chungddong/NUBI/hardware/vehicle/models/vehicle/v24_camera_mouth/README.md

# v24_camera_mouth — 앞 카메라 내림 (입)

- 날짜: 2026-10-05
- 이전 버전: [v23_upper_eyebrow](../v23_upper_eyebrow/README.md)

## 무엇을 왜 바꿨나

사용자 (2026-10-05): "입처럼 보이게 정면 뎁스 카메라를 전조등 아래로 내리자." 이유 · 검사는 [`../DECISIONS.md`](../DECISIONS.md) **D-14**.

- 앞 카메라 렌즈 중심 z **250 → 172**. 앞판 창 · 브래킷 M3 구멍도 같이 내렸다. 뒤 카메라는 250 그대로 (밑에 포트 칸).
- 얼굴: 눈썹 (와이파이 안테나) · 눈 (전조등) · 입 (뎁스 카메라).
- 시야: 바닥이 보이기 시작하는 거리 392 → **270 mm** (세로 65°). 범퍼 · 전조등 테두리는 시야 밖.
- 검사: 창 위끝 184.8 ~ 전조등 테두리 아래끝 193 (8.2), 카메라 · 브래킷 아래끝 ~ 바닥판 18.2, 카메라 · 브래킷 ↔ 앞 보드 · 바닥판 · 볼트 겹침 0.
- BOM 변화 없음 (2,183,236 원).

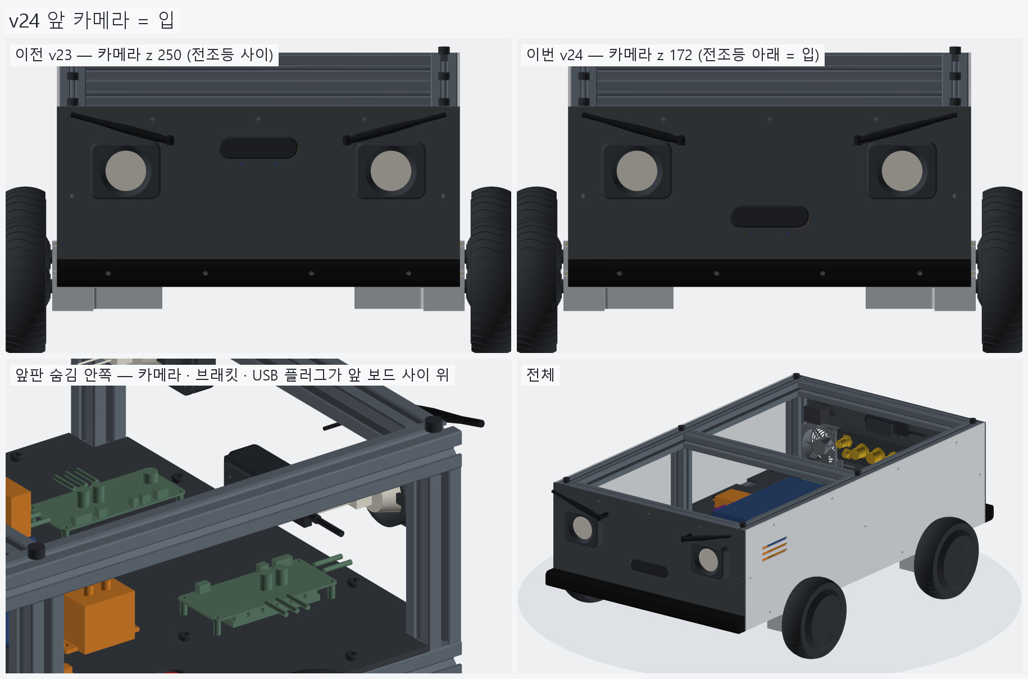
[picture p132: hardware/vehicle/models/vehicle/v24_camera_mouth/images/camera_mouth.png]
앞 카메라 = 입


## 남은 일 / 다음 버전 후보

- 앞뒤 카메라 높이가 달라졌다 — ROS TF 에 앞 172 · 뒤 250 을 따로.
- 비게 된 이마 자리 (눈썹 사이 z 약 250) — 상태 표시등 후보.
- 상부판 (라이다 · GPS · 표시등 자리).

<!-- record:begin — record.py 가 덮어쓴다. 이 사이는 손으로 고치지 않는다 -->
## 기록 (자동 · record.py · 2026-10-05 14:42)

**요약** — 앞 뎁스 카메라 z 250 → 172 (전조등 아래 = 입), 뒤는 그대로

### 전체 모습

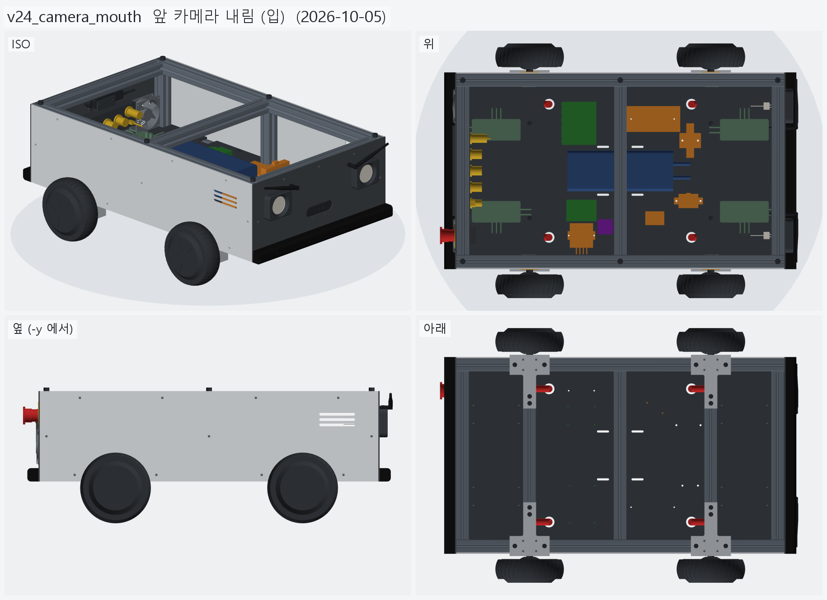
[picture p133: hardware/vehicle/models/vehicle/v24_camera_mouth/images/overall.png]
전체 모습


### 이전 버전(v23_upper_eyebrow) 대비 변화

| # | 그룹 | 변화 | 부품 |
|---|---|---|---|
| 1 | 외관_UV_PC3t_앞뒤판_불투명 | 형상 변경 1 | 앞판_PC3t 형상 변경 (외곽 · 부피 같음 — 안쪽 구멍 · 창 자리가 바뀜) |
| 2 | 외관_ASA_루버_차양_포트칸 | 이동 1 | 카메라브래킷_앞_ASA 이동 Δ(+0.0, +0.0, -78.0) |
| 3 | 뎁스카메라_Gemini336_2 | 이동 1 | 뎁스카메라_앞_Gemini336 이동 Δ(+0.0, +0.0, -78.0) |

**변화 1 — 외관_UV_PC3t_앞뒤판_불투명**

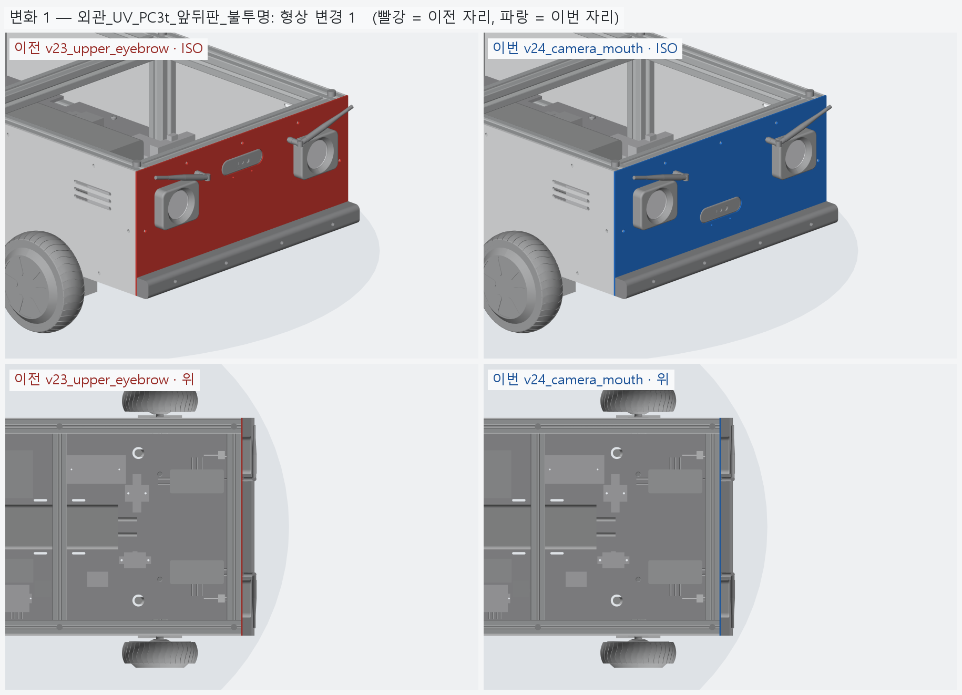
[picture p134: hardware/vehicle/models/vehicle/v24_camera_mouth/images/change_01_shell_pc.png]
변화 1


**변화 2 — 외관_ASA_루버_차양_포트칸**

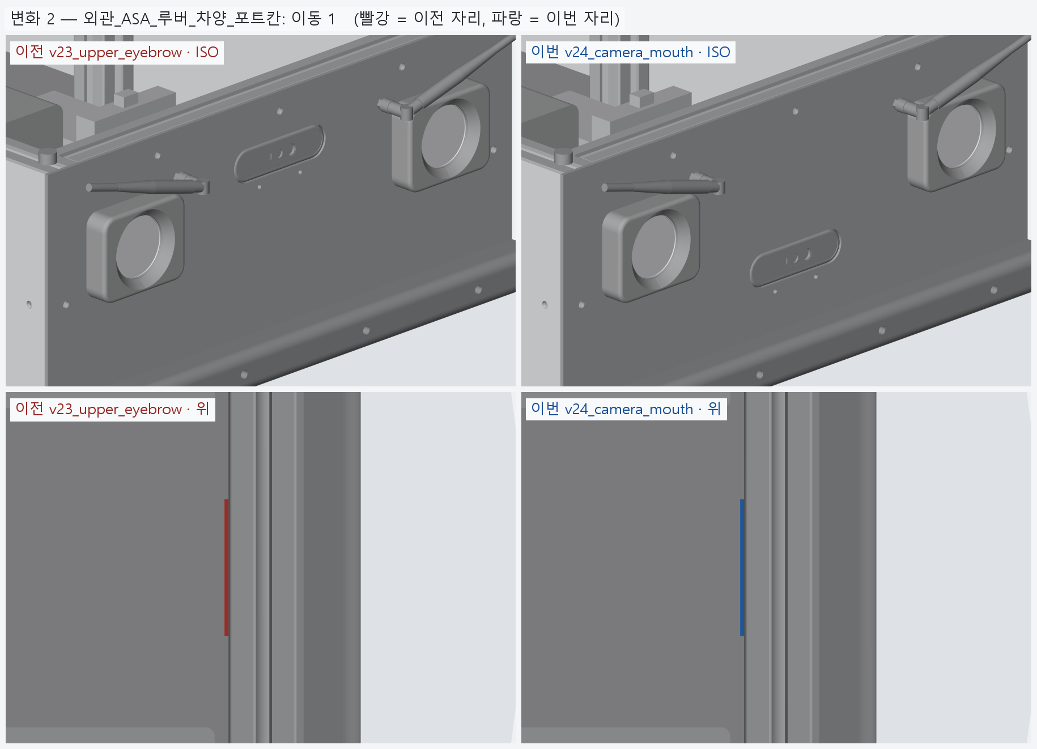
[picture p135: hardware/vehicle/models/vehicle/v24_camera_mouth/images/change_02_shell_asa.png]
변화 2


**변화 3 — 뎁스카메라_Gemini336_2**

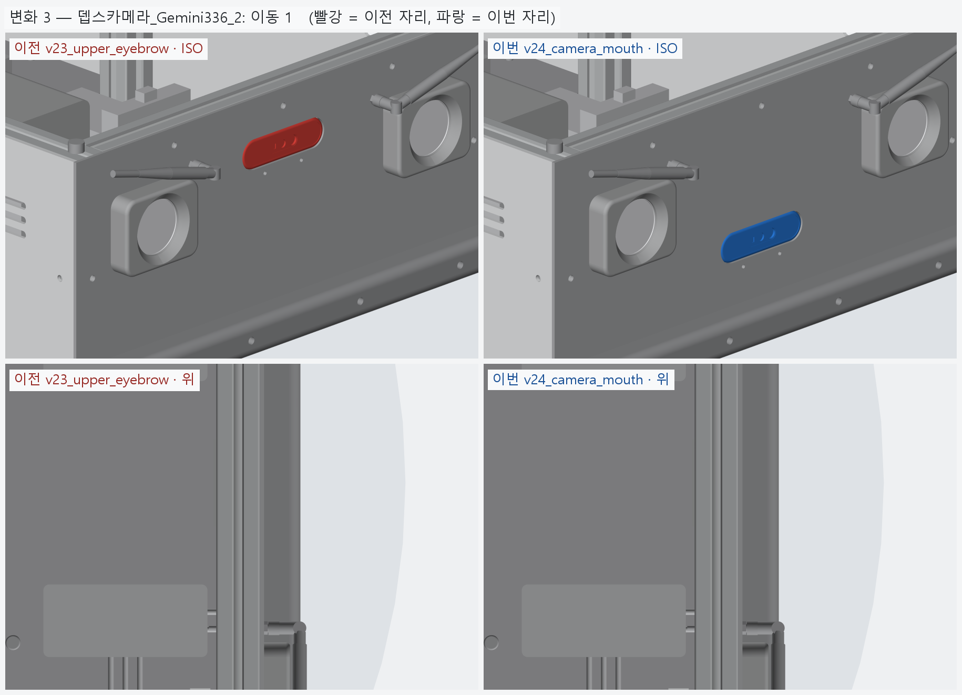
[picture p136: hardware/vehicle/models/vehicle/v24_camera_mouth/images/change_03_camera.png]
변화 3


### 수치

| 항목 | 값 |
|---|---|
| 프레임 외곽 (x × y) | 760 × 450 mm |
| 휠베이스 (앞뒤 축 간격) | 420 mm |
| 트레드 (좌우 바퀴 중심 간격) | 527.4 mm |
| 레일 윗면 높이 | 123.8 mm |
| 축크로스 x | ±210 mm |
| 기둥 | 6 본, x=-365 · +0 · +365 × y=±210, 높이 143 (윗면 z=266.9) |
| 3030 절단 | 760 × 4 + 390 × 8 + 143 × 6 |
| 3030 합계 | 실길이 7.02 m / 과금 7.60 m (72,200원) |
| 체결볼트 M6x15 | 16 개 |
| 바닥판 재료 | 폴리카보네이트 (PC) 불투명 흑색 5t — 불투명 (흑색 · 회색) — 충격에 강하고 안이 안 보인다 / 레이저는 그을린다 → CNC 재단 |
| 바닥판 크기 · 무게 | 760 × 450 × 5, 약 1.97 kg |
| 바닥판 구멍 | M6 고정 18 · 케이블 그로밋 Ø25 4 · M5 격자 0 · 기둥 노치 10 (x=-365 · -210 · +0 · +210 · +365, 기둥 6 · 10 본 겸용) |
| 판볼트 | M6x15 + 와셔 (필요 15.0 ~ 최대 15.8) |
| 받침 없는 구간 (크로스 안쪽면 사이) | 125 · 180 · 180 · 125 mm |
| 부품 | 13 개 (실측 치수 모델, 출처 parts.py) |
| 부품 무게 (알려진 것) | 3.44 kg — 무게 미상: 모터드라이버_앞왼_분리형_마스터, 모터드라이버_앞오른_분리형_슬레이브, 모터드라이버_뒤왼_분리형_마스터, 모터드라이버_뒤오른_분리형_슬레이브, ESP32_보드, DCDC_36V-12V_젯슨_RSD-60L, DCDC_36V-5V_DKP-55, MOSFET모듈_전조등_DFR0457, IMU_iAHRS_RB-SDA |
| 부품 무게중심 | x=+24.9 · y=+5.1 · z=164.9 mm (휠베이스 가운데 x=0 기준) |
| 가장 높은 부품 윗면 | z=215.3 — 기둥 윗면 z=266.9 까지 51.5 mm 남음 |
| 전체 크기 (x × y × z) | 830.1 × 590.2 × 304.9 mm |
| 최저 지상고 (바퀴 제외, 지면 z=0) | 54.9 mm |

### 부품 구성

| 그룹 | 개수 |
|---|---|
| 프레임_3030_18본 | 18 |
| T클램프_혀선반_4개 | 4 |
| 기존_상부클램프_4개 | 4 |
| 휠모터_4개 | 4 |
| 체결볼트_M6x15_16개 | 16 |
| 기둥볼트_M8_6개 | 6 |
| 바닥판_폴리카보네이트5t_불투명 | 1 |
| 판볼트_M6x15_18개 | 18 |
| 케이블_경로_참고 | 8 |
| 배터리 | 1 |
| 모터드라이버 | 4 |
| 컴퓨터_젯슨_ESP32 | 2 |
| 전원_차단기_컨택터_DCDC | 5 |
| 센서_IMU | 1 |
| 외관_ACM3t_옆판2 | 2 |
| 외관_UV_PC3t_앞뒤판_불투명 | 2 |
| 외관_ASA_루버_차양_포트칸 | 8 |
| 고무범퍼띠_앞뒤 | 2 |
| 뎁스카메라_Gemini336_2 | 2 |
| 비상정지_Autonics_SF2ER | 1 |
| 비상정지명판_노랑 | 1 |
| 비상정지본체_패널뒤 | 1 |
| 배기팬_2_가드 | 4 |
| 포트칸_부품_7 | 7 |
| 전조등_MR16_2 | 2 |
| 눈썹안테나_와이파이_2 | 4 |

### 검증

```
  간섭 프레임-T클램프: 0.00 mm3
  간섭 프레임-상부클램프: 0.00 mm3
  간섭 프레임-휠모터: 0.00 mm3
  간섭 T클램프-휠모터: 0.00 mm3
  간섭 T클램프-상부클램프: 0.00 mm3
  간섭 볼트-프레임: 0.00 mm3
  간섭 볼트-T클램프: 8.38 mm3 (두께 0.010)
  간섭 볼트-휠모터: 0.00 mm3
  대조군 클램프 +1mm 올림 → 레일 겹침 4006 mm3
  대조군 클램프 +1mm 올림 → 축크로스 겹침 6509 mm3
  대조군 기둥 -1mm 내림 → 레일 겹침 1893 mm3
  대조군 상부 레일 -1mm 내림 → 기둥 겹침 1893 mm3
  간섭 상부 레일-상부 크로스: 0.00 mm3
  간섭 상부 프레임-기둥 · 하부: 0.00 mm3
  기둥 ~ 휠모터 최소 간격 74.0 mm (메시 점 기준)
  간섭 바닥판-프레임 (기둥 포함): 0.00 mm3
  간섭 바닥판-T클램프: 0.00 mm3
  간섭 바닥판-휠모터: 0.00 mm3
  간섭 판볼트-프레임: 0.00 mm3
  간섭 판볼트-바닥판: 0.00 mm3
  간섭 케이블-프레임: 0.00 mm3
  간섭 케이블-T클램프: 0.00 mm3
  간섭 케이블-상부클램프: 0.00 mm3
  간섭 케이블-휠모터: 0.00 mm3
  간섭 케이블-바닥판: 0.00 mm3
  대조군 바닥판 -0.5mm → 프레임 겹침 31909 mm3
  10 본 겸용: 축 자리 가상 기둥 4 본 ~ 바닥판 간섭 0.00 mm3
  대조군 노치 없는 판 ~ 가상 기둥 겹침 7682 mm3
  판볼트 길이: 필요 15.0 ~ 최대 15.8 → M6x15
  간섭 부품끼리: 0.00 mm3
  간섭 부품-프레임 (기둥): 0.00 mm3
  간섭 부품-판볼트 머리: 0.00 mm3
  간섭 부품-바닥판: 0.00 mm3
  간섭 부품-케이블 구멍 위 (반경 15): 0.00 mm3
  대조군 부품 -1mm → 바닥판 겹침 35561 mm3
  부품 고정 구멍 38 — 빔 위 0 · 서로/다른 구멍과 2 mm 안 0
  대조군 x=0 구멍 → 빔 위 판정 True
  간섭 외관판-프레임: 0.00 mm3
  간섭 외관판-T클램프: 0.00 mm3
  간섭 외관판-휠모터: 0.00 mm3
  간섭 외관판-부품: 0.00 mm3
  간섭 외관판-바닥판: 0.00 mm3
  간섭 출력물-프레임: 0.00 mm3
  간섭 출력물-휠모터: 0.00 mm3
  간섭 출력물-T클램프: 0.00 mm3
  간섭 출력물-외관판: 0.00 mm3
  옆판 ~ 타이어 최소 간격 7.1 mm (메시 점 기준)
  벽 위끝 z=296.85 (상부 프레임 윗면 가정 z=296.85)
  부품 윗면 z=215.3 ~ 상부 프레임 밑면 z=266.9: 51.5 mm
  간섭 추가물-프레임: 0.00 mm3
  간섭 추가물-부품: 0.00 mm3
  간섭 추가물-외관판: 0.00 mm3
  간섭 추가물-ASA: 0.00 mm3
  간섭 추가물끼리: 0.00 mm3
  간섭 포트-팬 · 비상정지: 0.00 mm3
  간섭 비상정지-팬: 0.00 mm3
  간섭 명판-팬: 0.00 mm3
  간섭 추가물-휠모터: 0.00 mm3
  대조군 전조등 +0.5 mm 앞으로 → 테두리 겹침 295.6 mm3
  간섭 전조등-카메라: 0.00 mm3
  전조등 윗끝 z=257.0 ~ 상부 프레임 밑면 266.9
  간섭 안테나-전조등 · 카메라: 0.00 mm3
  안테나 윗끝 z=292.8 (판 위끝 296.85) · 옆 끝 |y|=212.8 (판 끝 228.0)
  간섭 앞 카메라 · 브래킷-부품 · 바닥판: 0.00 mm3
  앞 카메라 z=172: 창 위끝 184.8 ~ 전조등 테두리 아래끝 193.0 (8.2), 카메라 · 브래킷 아래끝 ~ 바닥판 18.2, 카메라 아래끝 159.5 ~ 보드 윗면 155.4
  바닥이 보이기 시작하는 거리: 앞 270 mm · 뒤 392 mm
  간섭 포트 부품끼리 (7 개): 0.00 mm3
  포트 칸 z 162.0~222.0 — 뒤 드라이버 윗면 155.4, 상부 프레임 밑면 266.9
  명판 Ø60 ~ 팬 구멍 Ø76 간격 2.0 mm
  비상정지 윗끝 z=261.99 ~ 상부 프레임 밑면 266.85: 4.86 mm
  카메라 윗면 z=262.50 ~ 상부 프레임 밑면 266.85: 4.35 mm
  카메라 렌즈면 = 판 바깥면 x=±383.0
  간섭 카메라브래킷-포트칸: 0.00 mm3
  판 M3 볼트 머리 아래끝 z=228.25 ~ 포트 칸 바깥 테두리 윗끝 227.00: 1.25 mm
  브래킷 플랜지 아래끝 z=225.00 ~ 포트 칸 윗면 222.00
verify: OK
```

### 기록 소요

불러오기 0.2s · 짓기 36.2s · 검증 22.6s · STEP 4.1s · 내보내기 5.3s · 뷰어 전송 3.5s · 메시 (73 형상 → 128 부품) 13.0s · 전체 모습 이미지 5 장 2.7s · 변화 이미지 3 장 4.4s

<!-- record:end -->
