chungddong/NUBI/hardware/vehicle/models/vehicle/v25_top_cover/README.md

# v25_top_cover — 상부 덮개

- 날짜: 2026-10-05
- 이전 버전: [v24_camera_mouth](../v24_camera_mouth/README.md)

## 무엇을 왜 바꿨나

사용자 (2026-10-05): "상부 덮개도 한번 올려 보자." 이유 · 버린 대안은 [`../DECISIONS.md`](../DECISIONS.md) **D-15**.

- **ACM 3t 상부 덮개** 766 × 456 (외관판 바깥면까지), 모서리 R6 — 상부 프레임 · 벽 윗면 위. 재단 DXF `output/shell_lid.dxf`.
- **M5 손나사 10** (상부 레일 x ±105 · ±290, 끝 크로스 y 0 — 윗슬롯 T 너트) — 공구 없이 연다.
- **기둥 볼트 머리 구멍 Ø16 ×6** — 덮개를 열어도 레일 ↔ 기둥 이음은 그대로.
- 검사: 덮개를 1 mm 내리면 프레임과 55,665 mm³ 겹친다 (= 얹혀 있다), 덮개 ↔ 나머지 전부 겹침 0. 덮개 위로 나온 것은 손나사 · 볼트 머리 (윗끝 z 305.9).
- 라이다 · GPS · 상태 표시등 구멍은 아직 — 부품을 정한 뒤 이 판에.

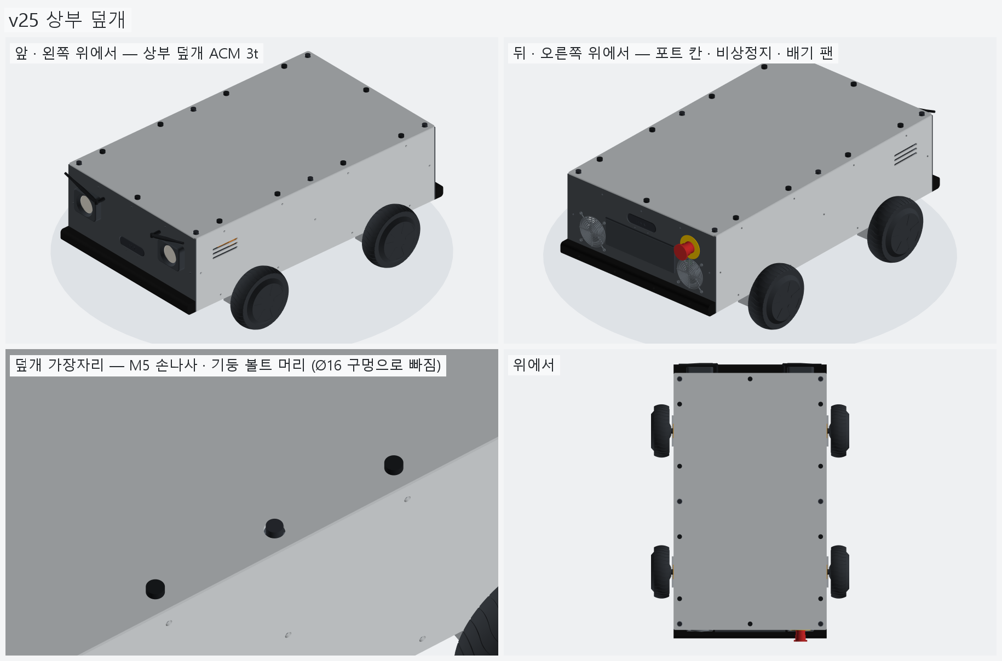
[picture p137: hardware/vehicle/models/vehicle/v25_top_cover/images/top_cover.png]
상부 덮개


## 남은 일 / 다음 버전 후보

- 덮개 위: 라이다 · GPS 안테나 · 상태 표시등 (이마 자리도 후보).
- 무선 비상정지 · 바깥 전원 스위치 · 전류 센서.
- 배선 모델.

<!-- record:begin — record.py 가 덮어쓴다. 이 사이는 손으로 고치지 않는다 -->
## 기록 (자동 · record.py · 2026-10-05 14:47)

**요약** — 상부 덮개 ACM 3t 766 × 456 R6, M5 손나사 10, 기둥 볼트 머리 구멍

### 전체 모습

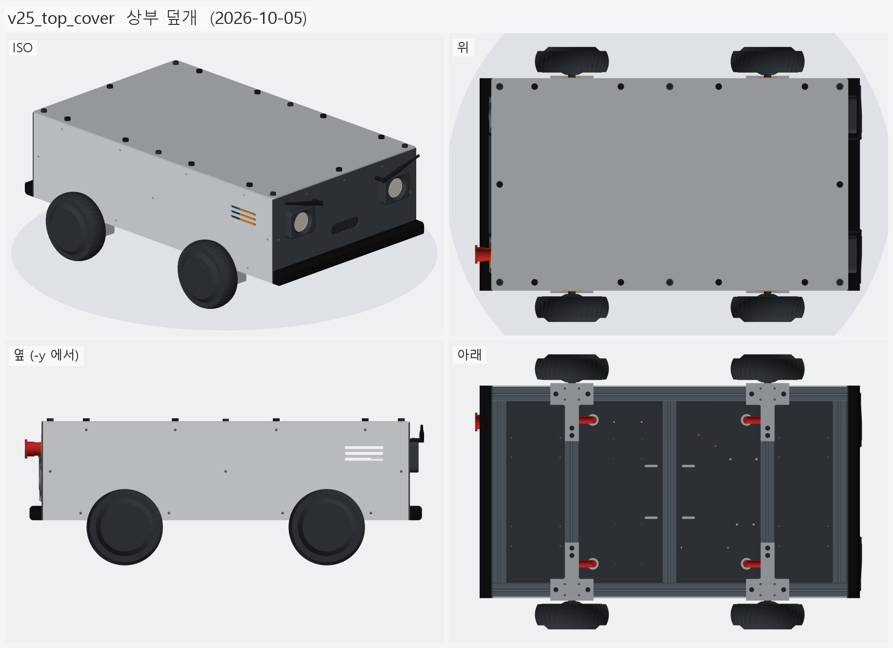
[picture p138: hardware/vehicle/models/vehicle/v25_top_cover/images/overall.png]
전체 모습


### 이전 버전(v24_camera_mouth) 대비 변화

| # | 그룹 | 변화 | 부품 |
|---|---|---|---|
| 1 | 상부덮개_ACM3t | 추가 1 | 상부덮개_ACM3t 추가 |
| 2 | 덮개손나사_M5_10 | 추가 10 | 덮개손나사_M ×10 추가 |

**변화 1 — 상부덮개_ACM3t**

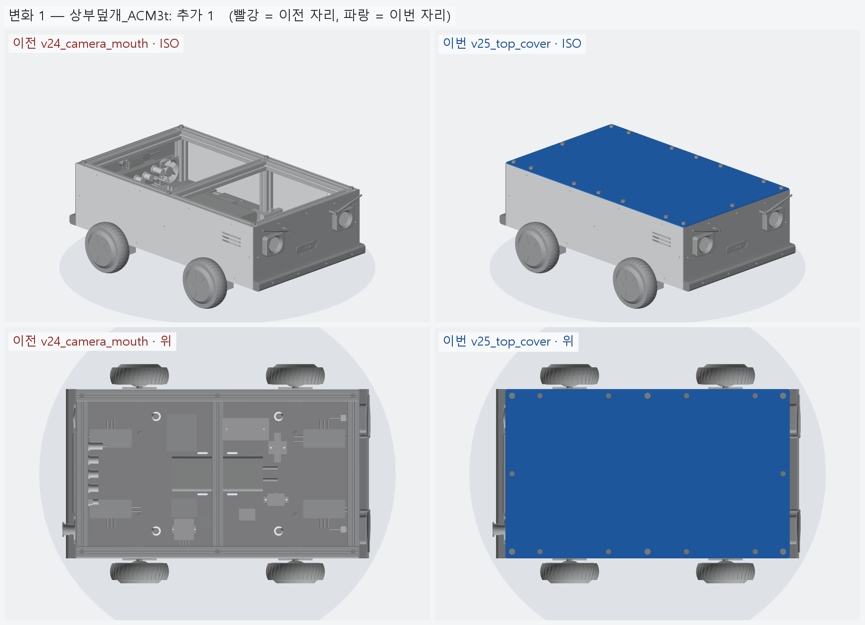
[picture p139: hardware/vehicle/models/vehicle/v25_top_cover/images/change_01_shell_lid.png]
변화 1


**변화 2 — 덮개손나사_M5_10**

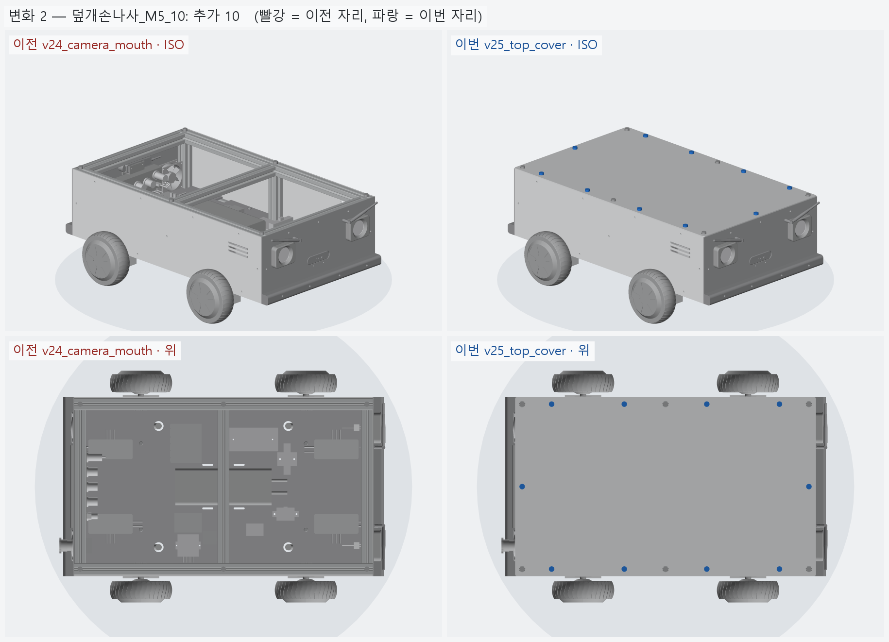
[picture p140: hardware/vehicle/models/vehicle/v25_top_cover/images/change_02_lid_knob.png]
변화 2


### 수치

| 항목 | 값 |
|---|---|
| 프레임 외곽 (x × y) | 760 × 450 mm |
| 휠베이스 (앞뒤 축 간격) | 420 mm |
| 트레드 (좌우 바퀴 중심 간격) | 527.4 mm |
| 레일 윗면 높이 | 123.8 mm |
| 축크로스 x | ±210 mm |
| 기둥 | 6 본, x=-365 · +0 · +365 × y=±210, 높이 143 (윗면 z=266.9) |
| 3030 절단 | 760 × 4 + 390 × 8 + 143 × 6 |
| 3030 합계 | 실길이 7.02 m / 과금 7.60 m (72,200원) |
| 체결볼트 M6x15 | 16 개 |
| 바닥판 재료 | 폴리카보네이트 (PC) 불투명 흑색 5t — 불투명 (흑색 · 회색) — 충격에 강하고 안이 안 보인다 / 레이저는 그을린다 → CNC 재단 |
| 바닥판 크기 · 무게 | 760 × 450 × 5, 약 1.97 kg |
| 바닥판 구멍 | M6 고정 18 · 케이블 그로밋 Ø25 4 · M5 격자 0 · 기둥 노치 10 (x=-365 · -210 · +0 · +210 · +365, 기둥 6 · 10 본 겸용) |
| 판볼트 | M6x15 + 와셔 (필요 15.0 ~ 최대 15.8) |
| 받침 없는 구간 (크로스 안쪽면 사이) | 125 · 180 · 180 · 125 mm |
| 부품 | 13 개 (실측 치수 모델, 출처 parts.py) |
| 부품 무게 (알려진 것) | 3.44 kg — 무게 미상: 모터드라이버_앞왼_분리형_마스터, 모터드라이버_앞오른_분리형_슬레이브, 모터드라이버_뒤왼_분리형_마스터, 모터드라이버_뒤오른_분리형_슬레이브, ESP32_보드, DCDC_36V-12V_젯슨_RSD-60L, DCDC_36V-5V_DKP-55, MOSFET모듈_전조등_DFR0457, IMU_iAHRS_RB-SDA |
| 부품 무게중심 | x=+24.9 · y=+5.1 · z=164.9 mm (휠베이스 가운데 x=0 기준) |
| 가장 높은 부품 윗면 | z=215.3 — 기둥 윗면 z=266.9 까지 51.5 mm 남음 |
| 전체 크기 (x × y × z) | 830.1 × 590.2 × 305.9 mm |
| 최저 지상고 (바퀴 제외, 지면 z=0) | 54.9 mm |

### 부품 구성

| 그룹 | 개수 |
|---|---|
| 프레임_3030_18본 | 18 |
| T클램프_혀선반_4개 | 4 |
| 기존_상부클램프_4개 | 4 |
| 휠모터_4개 | 4 |
| 체결볼트_M6x15_16개 | 16 |
| 기둥볼트_M8_6개 | 6 |
| 바닥판_폴리카보네이트5t_불투명 | 1 |
| 판볼트_M6x15_18개 | 18 |
| 케이블_경로_참고 | 8 |
| 배터리 | 1 |
| 모터드라이버 | 4 |
| 컴퓨터_젯슨_ESP32 | 2 |
| 전원_차단기_컨택터_DCDC | 5 |
| 센서_IMU | 1 |
| 외관_ACM3t_옆판2 | 2 |
| 외관_UV_PC3t_앞뒤판_불투명 | 2 |
| 외관_ASA_루버_차양_포트칸 | 8 |
| 고무범퍼띠_앞뒤 | 2 |
| 뎁스카메라_Gemini336_2 | 2 |
| 비상정지_Autonics_SF2ER | 1 |
| 비상정지명판_노랑 | 1 |
| 비상정지본체_패널뒤 | 1 |
| 배기팬_2_가드 | 4 |
| 포트칸_부품_7 | 7 |
| 전조등_MR16_2 | 2 |
| 눈썹안테나_와이파이_2 | 4 |
| 상부덮개_ACM3t | 1 |
| 덮개손나사_M5_10 | 10 |

### 검증

```
  간섭 프레임-T클램프: 0.00 mm3
  간섭 프레임-상부클램프: 0.00 mm3
  간섭 프레임-휠모터: 0.00 mm3
  간섭 T클램프-휠모터: 0.00 mm3
  간섭 T클램프-상부클램프: 0.00 mm3
  간섭 볼트-프레임: 0.00 mm3
  간섭 볼트-T클램프: 8.38 mm3 (두께 0.010)
  간섭 볼트-휠모터: 0.00 mm3
  대조군 클램프 +1mm 올림 → 레일 겹침 4006 mm3
  대조군 클램프 +1mm 올림 → 축크로스 겹침 6509 mm3
  대조군 기둥 -1mm 내림 → 레일 겹침 1893 mm3
  대조군 상부 레일 -1mm 내림 → 기둥 겹침 1893 mm3
  간섭 상부 레일-상부 크로스: 0.00 mm3
  간섭 상부 프레임-기둥 · 하부: 0.00 mm3
  기둥 ~ 휠모터 최소 간격 74.0 mm (메시 점 기준)
  간섭 바닥판-프레임 (기둥 포함): 0.00 mm3
  간섭 바닥판-T클램프: 0.00 mm3
  간섭 바닥판-휠모터: 0.00 mm3
  간섭 판볼트-프레임: 0.00 mm3
  간섭 판볼트-바닥판: 0.00 mm3
  간섭 케이블-프레임: 0.00 mm3
  간섭 케이블-T클램프: 0.00 mm3
  간섭 케이블-상부클램프: 0.00 mm3
  간섭 케이블-휠모터: 0.00 mm3
  간섭 케이블-바닥판: 0.00 mm3
  대조군 바닥판 -0.5mm → 프레임 겹침 31909 mm3
  10 본 겸용: 축 자리 가상 기둥 4 본 ~ 바닥판 간섭 0.00 mm3
  대조군 노치 없는 판 ~ 가상 기둥 겹침 7682 mm3
  판볼트 길이: 필요 15.0 ~ 최대 15.8 → M6x15
  간섭 부품끼리: 0.00 mm3
  간섭 부품-프레임 (기둥): 0.00 mm3
  간섭 부품-판볼트 머리: 0.00 mm3
  간섭 부품-바닥판: 0.00 mm3
  간섭 부품-케이블 구멍 위 (반경 15): 0.00 mm3
  대조군 부품 -1mm → 바닥판 겹침 35561 mm3
  부품 고정 구멍 38 — 빔 위 0 · 서로/다른 구멍과 2 mm 안 0
  대조군 x=0 구멍 → 빔 위 판정 True
  간섭 외관판-프레임: 0.00 mm3
  간섭 외관판-T클램프: 0.00 mm3
  간섭 외관판-휠모터: 0.00 mm3
  간섭 외관판-부품: 0.00 mm3
  간섭 외관판-바닥판: 0.00 mm3
  간섭 출력물-프레임: 0.00 mm3
  간섭 출력물-휠모터: 0.00 mm3
  간섭 출력물-T클램프: 0.00 mm3
  간섭 출력물-외관판: 0.00 mm3
  옆판 ~ 타이어 최소 간격 7.1 mm (메시 점 기준)
  벽 위끝 z=296.85 (상부 프레임 윗면 가정 z=296.85)
  부품 윗면 z=215.3 ~ 상부 프레임 밑면 z=266.9: 51.5 mm
  간섭 추가물-프레임: 0.00 mm3
  간섭 추가물-부품: 0.00 mm3
  간섭 추가물-외관판: 0.00 mm3
  간섭 추가물-ASA: 0.00 mm3
  간섭 추가물끼리: 0.00 mm3
  간섭 포트-팬 · 비상정지: 0.00 mm3
  간섭 비상정지-팬: 0.00 mm3
  간섭 명판-팬: 0.00 mm3
  간섭 추가물-휠모터: 0.00 mm3
  대조군 전조등 +0.5 mm 앞으로 → 테두리 겹침 295.6 mm3
  간섭 전조등-카메라: 0.00 mm3
  전조등 윗끝 z=257.0 ~ 상부 프레임 밑면 266.9
  간섭 안테나-전조등 · 카메라: 0.00 mm3
  안테나 윗끝 z=292.8 (판 위끝 296.85) · 옆 끝 |y|=212.8 (판 끝 228.0)
  간섭 앞 카메라 · 브래킷-부품 · 바닥판: 0.00 mm3
  앞 카메라 z=172: 창 위끝 184.8 ~ 전조등 테두리 아래끝 193.0 (8.2), 카메라 · 브래킷 아래끝 ~ 바닥판 18.2, 카메라 아래끝 159.5 ~ 보드 윗면 155.4
  바닥이 보이기 시작하는 거리: 앞 270 mm · 뒤 392 mm
  대조군 덮개 -1mm 내림 → 프레임 겹침 55665 mm3
  간섭 덮개-나머지 전부 (기둥 볼트 머리 포함): 0.00 mm3
  덮개 위로 나온 것: 손나사 · 기둥 볼트 머리 윗끝 z=305.9 (덮개 윗면 299.85)
  간섭 포트 부품끼리 (7 개): 0.00 mm3
  포트 칸 z 162.0~222.0 — 뒤 드라이버 윗면 155.4, 상부 프레임 밑면 266.9
  명판 Ø60 ~ 팬 구멍 Ø76 간격 2.0 mm
  비상정지 윗끝 z=261.99 ~ 상부 프레임 밑면 266.85: 4.86 mm
  카메라 윗면 z=262.50 ~ 상부 프레임 밑면 266.85: 4.35 mm
  카메라 렌즈면 = 판 바깥면 x=±383.0
  간섭 카메라브래킷-포트칸: 0.00 mm3
  판 M3 볼트 머리 아래끝 z=228.25 ~ 포트 칸 바깥 테두리 윗끝 227.00: 1.25 mm
  브래킷 플랜지 아래끝 z=225.00 ~ 포트 칸 윗면 222.00
verify: OK
```

### 기록 소요

불러오기 0.2s · 짓기 31.4s · 검증 23.3s · STEP 4.3s · 내보내기 5.1s · 뷰어 전송 3.9s · 메시 (84 형상 → 139 부품) 13.2s · 전체 모습 이미지 5 장 2.8s · 변화 이미지 2 장 3.7s

<!-- record:end -->
