chungddong/NUBI/hardware/vehicle/models/vehicle/v27_sensor_module/README.md

# v27_sensor_module — 센서 모듈 (라이다 · GPS · 표시등)

- 날짜: 2026-10-05
- 이전 버전: [v26_module_rails](../v26_module_rails/README.md)

## 무엇을 왜 바꿨나

사용자 (2026-10-05): 모듈 레일 위 첫 모듈 (라이다 · GPS · 상태 표시등) — "그래 한번 올려봐". 이유 · 버린 대안은 [`../DECISIONS.md`](../DECISIONS.md) **D-17**,
조사 원자료 [research/2026-10-05_sensor_module.md](../research/2026-10-05_sensor_module.md). 모듈 코드는 `sensor_module.py`.

- **밑판** AL5052 4t 200 × 460 — 레일 3 본에 M5 T 너트 6 (x −60~+140, 덮개 그로밋 x −100 을 피함).
- **라이다 LDROBOT STL-19P** (172,700) — 2020 기둥 2 본 (175, 간격 100) + 코너 브래킷 4 + AL 3t 윗판 위. **스캔 평면 z 526**.
- **GNSS 아센코리아 GPS630** (USB, 75,394) — 밑판 뒤 왼쪽. **상태 표시등 큐라이트 ST45ML-BZ-3-12-RAG** (65,670) — 밑판 뒤 오른쪽.
- 검사: 밑판 −1 mm → 레일 겹침 8,022 mm³ (얹혀 있다), 모듈 ↔ 나머지 겹침 0,
  **라이다 스캔 평면 위에 아무것도 없다** — 그 밖의 가장 높은 것은 표시등 꼭대기 z 509.8 (여유 16.3).
- BOM: +332,234 → 단가 확인된 합 **2,515,470 원** (모듈 레일 2020 단가도 이번에 넣음).
- 시뮬레이터 (`../sim/`, D-18) 에 이 버전을 넣으면 라이다가 같이 돈다 — 52 cm 아래 장애물은 라이다에 안 잡히고 카메라가 본다.

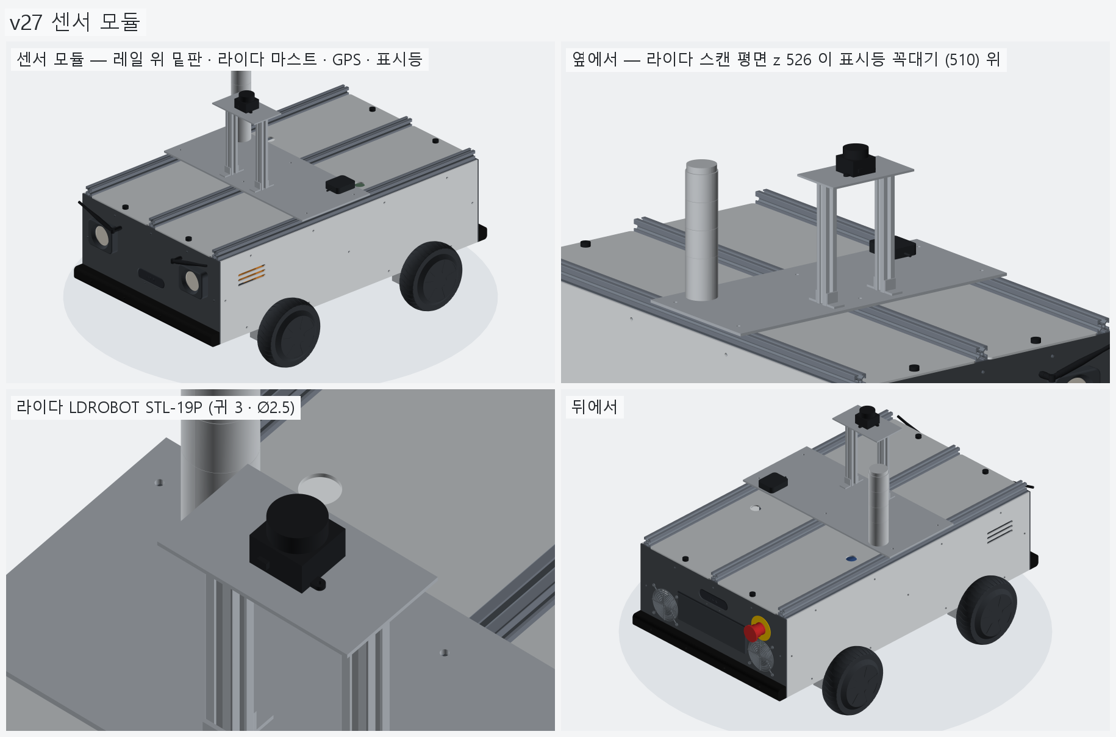
[picture p148: hardware/vehicle/models/vehicle/v27_sensor_module/images/sensor_module.png]
센서 모듈


## 남은 일 / 다음 버전 후보

- STL-19P 구멍 · 커넥터 면, 표시등 스터드 (M4 추정), 레일 슬롯 규격 (DF2020 이면 반달 너트) 실물 확인.
- 12 V 계통 (젯슨 + 컨택터 + 전조등 + 표시등) 이 5 A 에 빠듯 — 변환기 한 단계 키우기 검토.
- 무선 비상정지 · 바깥 전원 스위치 · 전류 센서, 배선.

<!-- record:begin — record.py 가 덮어쓴다. 이 사이는 손으로 고치지 않는다 -->
## 기록 (자동 · record.py · 2026-10-05 16:03)

**요약** — 센서 모듈 — 라이다 STL-19P (스캔 z 526) · GPS630 · 큐라이트 표시등 3 단, AL 밑판이 레일 3 본에 T 너트

### 전체 모습

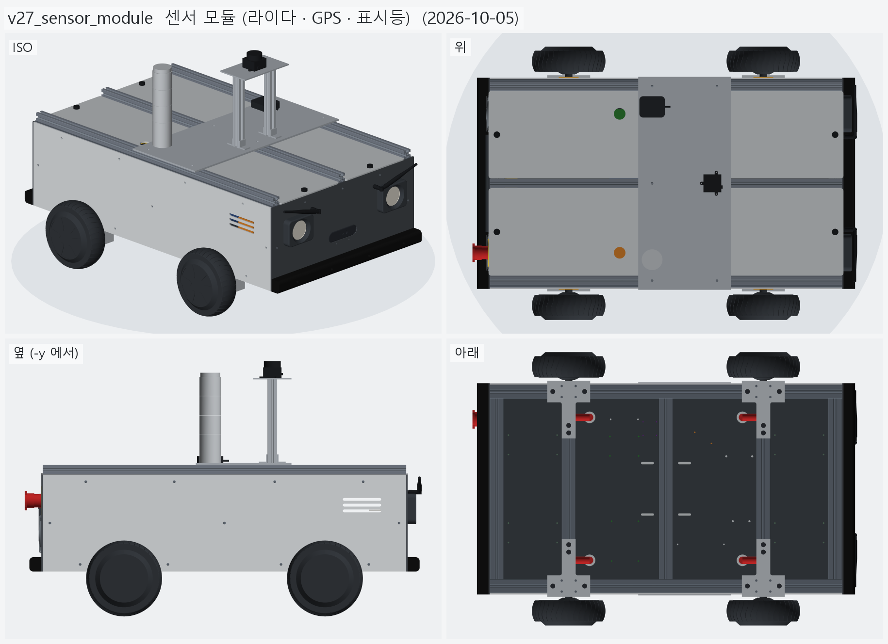
[picture p149: hardware/vehicle/models/vehicle/v27_sensor_module/images/overall.png]
전체 모습


### 이전 버전(v26_module_rails) 대비 변화

| # | 그룹 | 변화 | 부품 |
|---|---|---|---|
| 1 | 센서모듈_밑판_기둥 | 추가 8 | 센서모듈_밑판_AL4t 추가<br>센서모듈_라이다판_AL3t 추가<br>센서모듈_기둥 ×2 추가<br>센서모듈_브래킷 ×4 추가 |
| 2 | 라이다_STL-19P | 추가 1 | 라이다_LDROBOT_STL-19P 추가 |
| 3 | GNSS_GPS630 | 추가 1 | GNSS_아센코리아_GPS630 추가 |
| 4 | 상태표시등_ST45ML_3단 | 추가 5 | 상태표시등_베이스_ST45ML 추가<br>상태표시등_초록_ST45ML 추가<br>상태표시등_노랑_ST45ML 추가<br>상태표시등_빨강_ST45ML 추가<br>상태표시등_캡_ST45ML 추가 |

**변화 1 — 센서모듈_밑판_기둥**

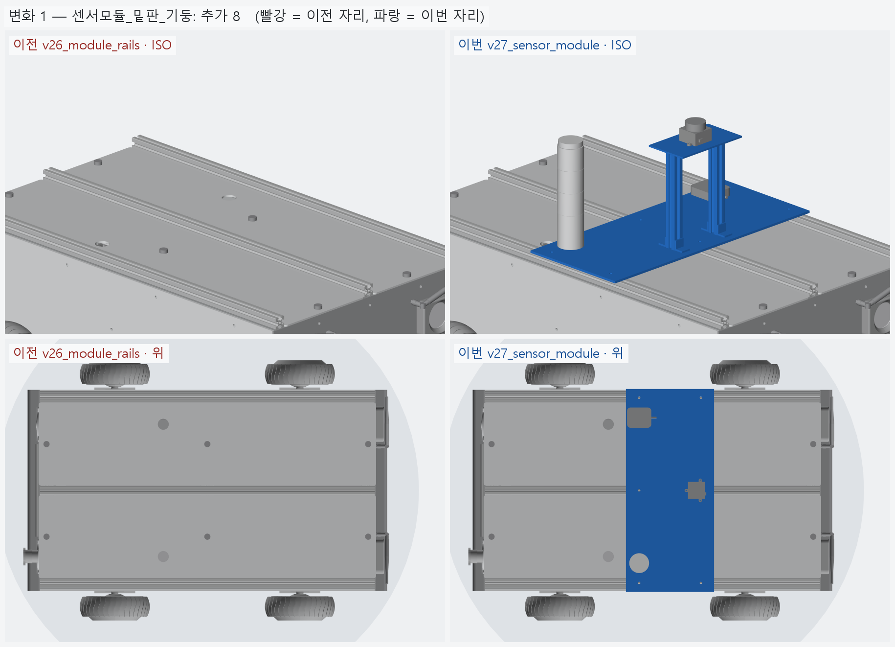
[picture p150: hardware/vehicle/models/vehicle/v27_sensor_module/images/change_01_module_plate.png]
변화 1


**변화 2 — 라이다_STL-19P**

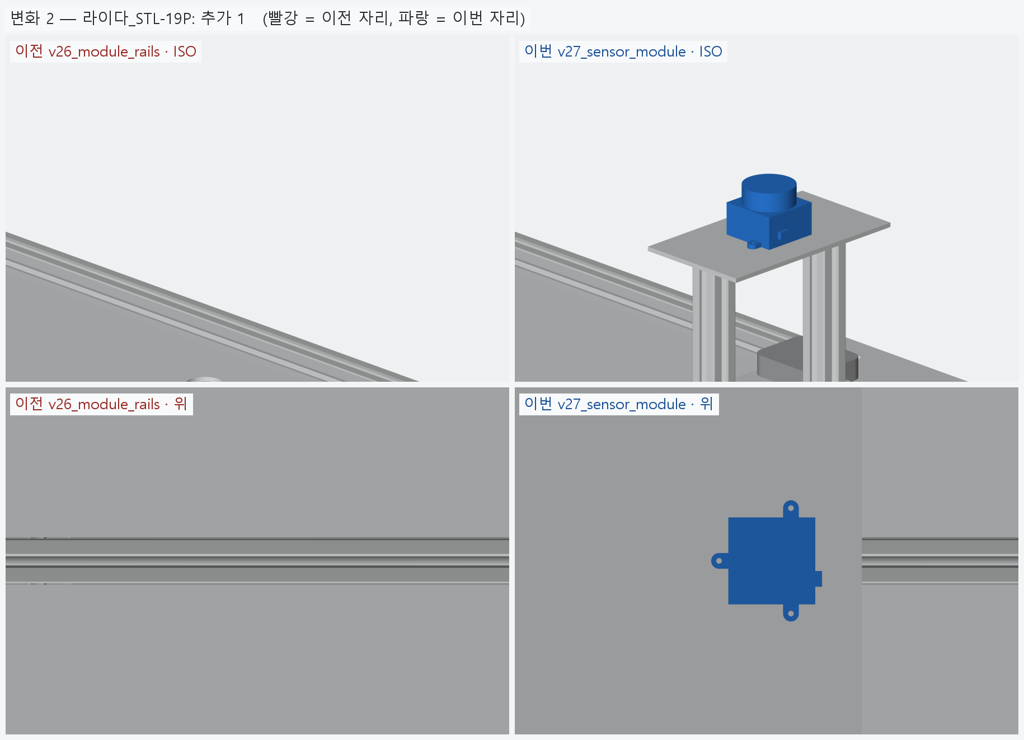
[picture p151: hardware/vehicle/models/vehicle/v27_sensor_module/images/change_02_lidar.png]
변화 2


**변화 3 — GNSS_GPS630**

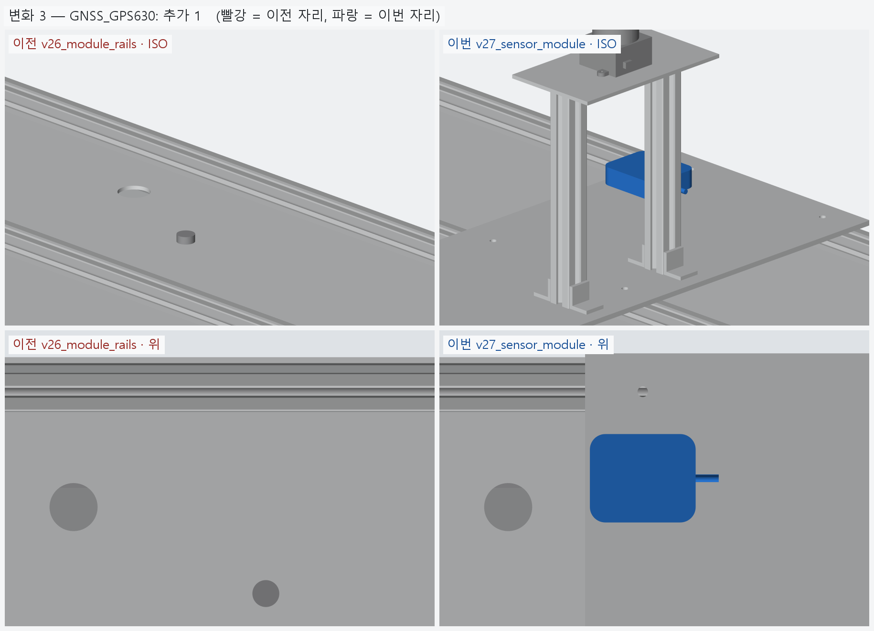
[picture p152: hardware/vehicle/models/vehicle/v27_sensor_module/images/change_03_gnss.png]
변화 3


**변화 4 — 상태표시등_ST45ML_3단**

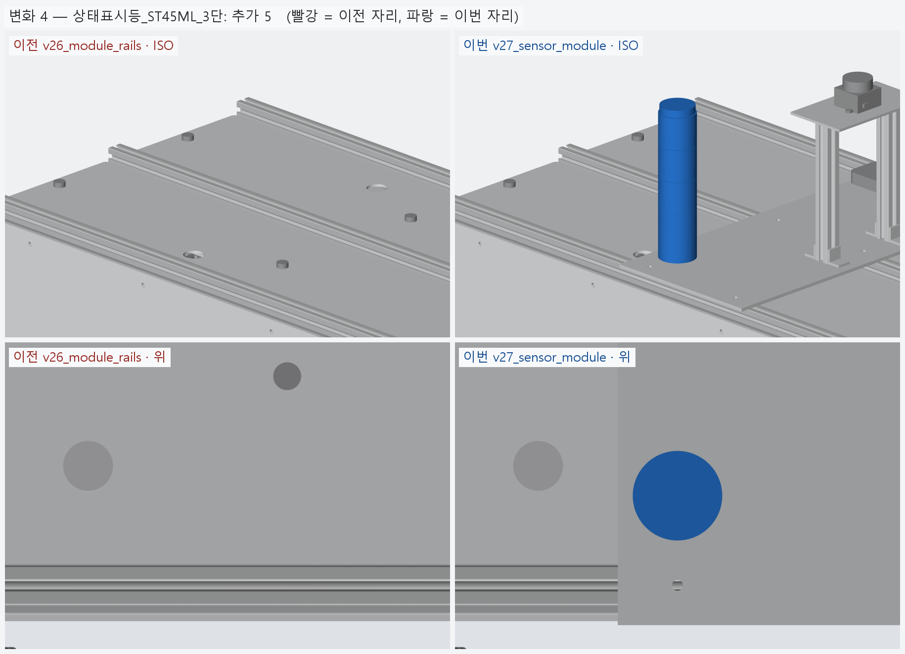
[picture p153: hardware/vehicle/models/vehicle/v27_sensor_module/images/change_04_status_light.png]
변화 4


### 수치

| 항목 | 값 |
|---|---|
| 프레임 외곽 (x × y) | 760 × 450 mm |
| 휠베이스 (앞뒤 축 간격) | 420 mm |
| 트레드 (좌우 바퀴 중심 간격) | 527.4 mm |
| 레일 윗면 높이 | 123.8 mm |
| 축크로스 x | ±210 mm |
| 기둥 | 6 본, x=-365 · +0 · +365 × y=±210, 높이 143 (윗면 z=266.9) |
| 3030 절단 | 760 × 4 + 390 × 8 + 143 × 6 |
| 3030 합계 | 실길이 7.02 m / 과금 7.60 m (72,200원) |
| 체결볼트 M6x15 | 16 개 |
| 바닥판 재료 | 폴리카보네이트 (PC) 불투명 흑색 5t — 불투명 (흑색 · 회색) — 충격에 강하고 안이 안 보인다 / 레이저는 그을린다 → CNC 재단 |
| 바닥판 크기 · 무게 | 760 × 450 × 5, 약 1.97 kg |
| 바닥판 구멍 | M6 고정 18 · 케이블 그로밋 Ø25 4 · M5 격자 0 · 기둥 노치 10 (x=-365 · -210 · +0 · +210 · +365, 기둥 6 · 10 본 겸용) |
| 판볼트 | M6x15 + 와셔 (필요 15.0 ~ 최대 15.8) |
| 받침 없는 구간 (크로스 안쪽면 사이) | 125 · 180 · 180 · 125 mm |
| 부품 | 13 개 (실측 치수 모델, 출처 parts.py) |
| 부품 무게 (알려진 것) | 3.44 kg — 무게 미상: 모터드라이버_앞왼_분리형_마스터, 모터드라이버_앞오른_분리형_슬레이브, 모터드라이버_뒤왼_분리형_마스터, 모터드라이버_뒤오른_분리형_슬레이브, ESP32_보드, DCDC_36V-12V_젯슨_RSD-60L, DCDC_36V-5V_DKP-55, MOSFET모듈_전조등_DFR0457, IMU_iAHRS_RB-SDA |
| 부품 무게중심 | x=+24.9 · y=+5.1 · z=164.9 mm (휠베이스 가운데 x=0 기준) |
| 가장 높은 부품 윗면 | z=215.3 — 기둥 윗면 z=266.9 까지 51.5 mm 남음 |
| 전체 크기 (x × y × z) | 830.1 × 590.2 × 533.9 mm |
| 최저 지상고 (바퀴 제외, 지면 z=0) | 54.9 mm |

### 부품 구성

| 그룹 | 개수 |
|---|---|
| 프레임_3030_18본 | 18 |
| T클램프_혀선반_4개 | 4 |
| 기존_상부클램프_4개 | 4 |
| 휠모터_4개 | 4 |
| 체결볼트_M6x15_16개 | 16 |
| 코너브래킷_3030_8 | 8 |
| 모듈레일_2020_3본 | 3 |
| 센서모듈_밑판_기둥 | 8 |
| 라이다_STL-19P | 1 |
| GNSS_GPS630 | 1 |
| 상태표시등_ST45ML_3단 | 5 |
| 바닥판_폴리카보네이트5t_불투명 | 1 |
| 판볼트_M6x15_18개 | 18 |
| 케이블_경로_참고 | 8 |
| 배터리 | 1 |
| 모터드라이버 | 4 |
| 컴퓨터_젯슨_ESP32 | 2 |
| 전원_차단기_컨택터_DCDC | 5 |
| 센서_IMU | 1 |
| 외관_ACM3t_옆판2 | 2 |
| 외관_UV_PC3t_앞뒤판_불투명 | 2 |
| 외관_ASA_루버_차양_포트칸 | 8 |
| 고무범퍼띠_앞뒤 | 2 |
| 뎁스카메라_Gemini336_2 | 2 |
| 비상정지_Autonics_SF2ER | 1 |
| 비상정지명판_노랑 | 1 |
| 비상정지본체_패널뒤 | 1 |
| 배기팬_2_가드 | 4 |
| 포트칸_부품_7 | 7 |
| 전조등_MR16_2 | 2 |
| 눈썹안테나_와이파이_2 | 4 |
| 상부덮개_ACM3t | 2 |
| 덮개손나사_M5_6 | 6 |

### 검증

```
  간섭 프레임-T클램프: 0.00 mm3
  간섭 프레임-상부클램프: 0.00 mm3
  간섭 프레임-휠모터: 0.00 mm3
  간섭 T클램프-휠모터: 0.00 mm3
  간섭 T클램프-상부클램프: 0.00 mm3
  간섭 볼트-프레임: 0.00 mm3
  간섭 볼트-T클램프: 8.38 mm3 (두께 0.010)
  간섭 볼트-휠모터: 0.00 mm3
  대조군 클램프 +1mm 올림 → 레일 겹침 4006 mm3
  대조군 클램프 +1mm 올림 → 축크로스 겹침 6509 mm3
  대조군 기둥 -1mm 내림 → 레일 겹침 1893 mm3
  대조군 상부 레일 -1mm 내림 → 기둥 겹침 1893 mm3
  간섭 상부 레일-상부 크로스: 0.00 mm3
  간섭 상부 프레임-기둥 · 하부: 0.00 mm3
  기둥 ~ 휠모터 최소 간격 74.0 mm (메시 점 기준)
  간섭 바닥판-프레임 (기둥 포함): 0.00 mm3
  간섭 바닥판-T클램프: 0.00 mm3
  간섭 바닥판-휠모터: 0.00 mm3
  간섭 판볼트-프레임: 0.00 mm3
  간섭 판볼트-바닥판: 0.00 mm3
  간섭 케이블-프레임: 0.00 mm3
  간섭 케이블-T클램프: 0.00 mm3
  간섭 케이블-상부클램프: 0.00 mm3
  간섭 케이블-휠모터: 0.00 mm3
  간섭 케이블-바닥판: 0.00 mm3
  대조군 바닥판 -0.5mm → 프레임 겹침 31909 mm3
  10 본 겸용: 축 자리 가상 기둥 4 본 ~ 바닥판 간섭 0.00 mm3
  대조군 노치 없는 판 ~ 가상 기둥 겹침 7682 mm3
  판볼트 길이: 필요 15.0 ~ 최대 15.8 → M6x15
  간섭 부품끼리: 0.00 mm3
  간섭 부품-프레임 (기둥): 0.00 mm3
  간섭 부품-판볼트 머리: 0.00 mm3
  간섭 부품-바닥판: 0.00 mm3
  간섭 부품-케이블 구멍 위 (반경 15): 0.00 mm3
  대조군 부품 -1mm → 바닥판 겹침 35561 mm3
  부품 고정 구멍 38 — 빔 위 0 · 서로/다른 구멍과 2 mm 안 0
  대조군 x=0 구멍 → 빔 위 판정 True
  간섭 외관판-프레임: 0.00 mm3
  간섭 외관판-T클램프: 0.00 mm3
  간섭 외관판-휠모터: 0.00 mm3
  간섭 외관판-부품: 0.00 mm3
  간섭 외관판-바닥판: 0.00 mm3
  간섭 출력물-프레임: 0.00 mm3
  간섭 출력물-휠모터: 0.00 mm3
  간섭 출력물-T클램프: 0.00 mm3
  간섭 출력물-외관판: 0.00 mm3
  옆판 ~ 타이어 최소 간격 7.1 mm (메시 점 기준)
  벽 위끝 z=296.85 (상부 프레임 윗면 가정 z=296.85)
  부품 윗면 z=215.3 ~ 상부 프레임 밑면 z=266.9: 51.5 mm
  간섭 추가물-프레임: 0.00 mm3
  간섭 추가물-부품: 0.00 mm3
  간섭 추가물-외관판: 0.00 mm3
  간섭 추가물-ASA: 0.00 mm3
  간섭 추가물끼리: 0.00 mm3
  간섭 포트-팬 · 비상정지: 0.00 mm3
  간섭 비상정지-팬: 0.00 mm3
  간섭 명판-팬: 0.00 mm3
  간섭 추가물-휠모터: 0.00 mm3
  대조군 전조등 +0.5 mm 앞으로 → 테두리 겹침 295.6 mm3
  간섭 전조등-카메라: 0.00 mm3
  전조등 윗끝 z=257.0 ~ 상부 프레임 밑면 266.9
  간섭 안테나-전조등 · 카메라: 0.00 mm3
  안테나 윗끝 z=292.8 (판 위끝 296.85) · 옆 끝 |y|=212.8 (판 끝 228.0)
  간섭 앞 카메라 · 브래킷-부품 · 바닥판: 0.00 mm3
  앞 카메라 z=172: 창 위끝 184.8 ~ 전조등 테두리 아래끝 193.0 (8.2), 카메라 · 브래킷 아래끝 ~ 바닥판 18.2, 카메라 아래끝 159.5 ~ 보드 윗면 155.4
  바닥이 보이기 시작하는 거리: 앞 270 mm · 뒤 392 mm
  대조군 덮개 -1mm 내림 → 프레임 겹침 29217 mm3
  간섭 덮개-나머지 전부 (기둥 볼트 머리 포함): 0.00 mm3
  덮개 손나사 윗끝 z=305.9 (덮개 윗면 299.85, 레일 윗면 316.85)
  대조군 모듈 레일 -1mm 내림 -> 프레임 겹침 18120 mm3
  간섭 모듈 레일-나머지 전부 (덮개 포함): 0.00 mm3
  간섭 코너 브래킷-나머지 전부: 0.00 mm3
  대조군 브래킷 +0.5mm 올림 -> 상부 레일 겹침 2211 mm3
  대조군 센서 모듈 밑판 -1mm 내림 -> 레일 겹침 8022 mm3
  간섭 센서 모듈-나머지 전부: 0.00 mm3
  라이다 스캔 평면 z=526.1 — 그 밖의 가장 높은 것 z=509.8 (표시등 꼭대기 509.8), 여유 16.3
  간섭 포트 부품끼리 (7 개): 0.00 mm3
  포트 칸 z 162.0~222.0 — 뒤 드라이버 윗면 155.4, 상부 프레임 밑면 266.9
  명판 Ø60 ~ 팬 구멍 Ø76 간격 2.0 mm
  비상정지 윗끝 z=261.99 ~ 상부 프레임 밑면 266.85: 4.86 mm
  카메라 윗면 z=262.50 ~ 상부 프레임 밑면 266.85: 4.35 mm
  카메라 렌즈면 = 판 바깥면 x=±383.0
  간섭 카메라브래킷-포트칸: 0.00 mm3
  판 M3 볼트 머리 아래끝 z=228.25 ~ 포트 칸 바깥 테두리 윗끝 227.00: 1.25 mm
  브래킷 플랜지 아래끝 z=225.00 ~ 포트 칸 윗면 222.00
verify: OK
```

### 기록 소요

불러오기 0.1s · 짓기 35.9s · 검증 34.7s · STEP 6.0s · 내보내기 5.5s · 뷰어 전송 5.1s · 메시 (98 형상 → 156 부품) 17.1s · 전체 모습 이미지 5 장 3.3s · 변화 이미지 4 장 9.1s

<!-- record:end -->
