chungddong/NUBI/docs/worklog/topics/wheel-controller-portfolio.md

# 바퀴 제어기 — 포트폴리오 포인트

> 영역: 바퀴 제어 · 기간: 2026-08 ~ 10-13 · 원본: `firmware/wheel-controller/WORKLOG.md` 부록 (2026-10-13 옮김)

- **계층 구조가 분명한 시스템**: GD32 메인보드(모터 제어) ← LOLIN D32(안전장치·믹싱·Wi-Fi) ← 상위
  컴퓨터(RDK 장애물 가드 / Jetson 초파리 뇌). 계층마다 책임과 인터페이스(시리얼 콘솔 명령, 9/22바이트
  프레임)가 문서화돼 있어서 다른 머신에서 하루 만에 붙였다(09-17 RDK, 09-18 Jetson).
- **원인을 추측하지 않고 업스트림 소스로 증명**: 룩업 테이블을 그대로 계산해 "안쪽 바퀴 최대 12 %"라는
  수치를 냈다. 그 수치가 사용자의 관측("200 미만은 안 움직임")과 Jetson 실측(1.11 → 0.24 km/h)에 맞물렸다(09-17, 09-18).
- **하드웨어 제약을 소프트웨어로 우회하는 결정**: 메인보드를 구울 수 없는 상황에서 ESP32 쪽 믹싱으로
  문제를 옮겼고, 나중에 한 줄짜리 메인보드 패치(`SLAVE_SAME_SIDE`)로 마무리하는 경로를 설계했다(09-17, 09-22).
- **안전장치를 깨지 않는 확장, 그리고 깨진 사례**: 클램프는 여전히 와이어로 나가는 값을 제한하고, 램프는
  명령 공간에 남겼고, 탱크 모드는 두 링크를 요구한다. 반면 데드밴드는 "잡음 1바이트 = 20 % 듀티"라는
  새 위험을 만들었고, 현장(09-17 RDK)에서 같은 날 드러났다. 기능 추가가 기존 가정("작은 명령은
  무해하다")을 깨는 전형적인 사례다.
- **검증의 층위**: 시뮬레이션(로직) → 실기 시리얼(설정 유지) → 브라우저(UI 호출) → 회귀 테스트 →
  독립 반박 검증을 거친 리뷰 → 다른 머신에서 현장 사용
- **물리 직관을 설명하는 능력**: "슬레이브는 거울 복사"라는 한 문장과 시계 비유로 부호 문제를 이해시켰다(09-22).
- **측정이 판단을 뒤집은 기록([링크 디버깅 기록](wheel-link-debugging.md))**: 잘못된 도구가 낸 결론 두 개가 유효한 측정을 덮었던 과정과,
  거기서 뽑은 9가지 규칙
- **기록 관리의 교훈**: 3주간 미커밋, 임시 폴더 산출물 소실(10-13). 이 일지와 ISSUES.md를 분리한 이유다.
