chungddong/NUBI/hardware/vehicle/docs/floor_plate_cut_min.md

# 베이 바닥판 재단 규격 (아크릴)

- 재질: 투명/불투명 아크릴 **5t** (PC 5t 도 가능 — 볼트 구멍 균열에 더 강하다)
- 외곽: **760 x 450**, 코너 R3
- 수량: 1
- 파일: `models/hoverboard_mount/output/dxf/floor_plate.dxf` (1:1 mm, 외곽 + 구멍 전부)

## 노치 (기둥 자리, 판 가장자리에서 파냄)

| 위치 | 크기 (x × y) | 설명 |
|---|---|---|
| x=-365, y=-210 | 32 × 32 | 모서리 기둥 3030 + 여유 1mm |
| x=-365, y=+210 | 32 × 32 | 모서리 기둥 3030 + 여유 1mm |
| x=+0, y=-210 | 32 × 32 | 긴 변 가운데 기둥 3030 + 여유 1mm |
| x=+0, y=+210 | 32 × 32 | 긴 변 가운데 기둥 3030 + 여유 1mm |
| x=+365, y=-210 | 32 × 32 | 모서리 기둥 3030 + 여유 1mm |
| x=+365, y=+210 | 32 × 32 | 모서리 기둥 3030 + 여유 1mm |

## 구멍

| 종류 | Ø | 수량 | 위치 (x, y) | 용도 |
|---|---:|---:|---|---|
| 고정 볼트 | 6.5 | 14 | (-365,-110), (-365,+110), (-265,-110), (-265,+110), (+0,-110), (+0,+110), (+265,-110), (+265,+110), (+365,-110), (+365,+110), (-210,-110), (-210,+110), (+210,-110), (+210,+110) | M6 둥근머리 + 스프링너트, 크로스 윗면 슬롯 |
| 케이블 그로밋 | 25 | 4 | (-165,-154), (-165,+154), (+165,-154), (+165,+154) | 허브모터 케이블 Ø10 — 혀 출구(x=±195, y=±154, z=79) 에서 안쪽으로 30 간 자리 |
| 장비 격자 | 5.5 | 0 | 50mm 격자 (볼트·그로밋·노치 근처 제외) | M5 장비 고정 (없어도 됨) |

## 절단 길이 (견적 근거)

- 외곽 + 노치 약 2.80 m, 구멍 18개 약 0.60 m → **합계 약 3.4 m**

## 얹히는 곳 / 검증

- 판 밑면 z=123.85 (레일 윗면). 레일 2 + 크로스 5 + H 크로스 2 윗면에 얹힌다 (0.5mm 내린 검사에서 겹침 41833 mm³).
- 프레임 빔·기둥·H 크로스·클램프와 간섭 0. 케이블 경로(출구 → 그로밋) 간섭 0.

## 주의

- 아크릴은 볼트를 세게 조이면 구멍에서 갈라진다 — **와셔 필수, 손으로 꽉 정도.**
- 레이저 커프 0.2mm 는 업체가 보정한다. 구멍 지름은 도면값 그대로 주문.
- 3t 로 하면 크로스 사이 235 스팬에 배터리(12kg) 가 올라갈 때 약 18mm 처진다. 5t 는 2.7mm.
  배터리 브라켓은 크로스(x=-265) 위에 오게 두는 게 좋다 (지금 모델은 x=-140).
