chungddong/NUBI/hardware/vehicle/models/hoverboard_mount/CLAUDE_HANDOFF.md

# 호버보드 휠 클램프·차량 프레임 인수인계

최종 갱신: 2026-08-21 (실물 출력·조립 시험 반영)

이 문서는 Claude 또는 다음 작업자가 현재 상태를 다시 탐색하지 않고 모델 생성,
뷰어 전송, 출력 파일 생성과 구조해석을 이어서 수행하기 위한 실무 인수인계다.
프로젝트 전체 규칙은 저장소 루트의 `CLAUDE.md`, 구조해석 상세 구현은 `FEA.md`를
먼저 읽는다.

## 1. 현재 채택 설계

- 설계명: **Design-D**
- 구조: 새 하부 클램프 + 기존 호버보드 상부 클램프 + 3030 프로파일
- 휠 축: 실제 호버보드 6.5인치 휠모터 STEP의 D컷 축 기준
- 하부 클램프가 축의 원형 하부를 반원 시트로 받치고, 기존 상부 클램프가 D컷
  평면을 누른다.
- 하부 클램프는 3030 프로파일의 **바닥 볼트 2개**로만 연결한다.
- 프로파일 체결 볼트는 **M6 둥근머리 렌치볼트 15 mm** [실측]. 카운터보어 깊이를
  이 길이에서 역산한다 (`LOW_BOLT_LEN`) — 숫자를 박아 두면 볼트가 바뀔 때 안 닿는다.
- 하부 형상은 불필요한 필렛을 제거한 CNC 가공용 각진 형상이다.
- 사람이 탑승하는 최종품의 예정 재료는 AL6061-T6다. PLA/PETG 출력품은 치수,
  조립과 저속 무부하 시험용으로 취급한다.

### 실물 시험으로 바뀐 것 (2026-08-21)

출력해서 실제로 달아 봤다.

| 확인한 것 | 결과 | 조치 |
|---|---|---|
| 치수·조립 | 잘 맞음 | — |
| 누르는 하중 | 문제 없음. 다리 윗면이 레일 밑면에 지압으로 받고 힘은 축 → 반원 시트 → 기존 클램프로 흐른다 | 유지 |
| **레일 옆면 플랜지** | **툭 치니 부러짐.** 얇고, 인필도 낮게 출력했다 | **제거** (`LOW_SIDE = False`) |
| **M6 볼트 길이** | 가진 게 20 이 아니라 **15 mm**. 밑에서 끼워도 스프링너트에 안 닿았다 | 카운터보어 27.3 → **32.3** 로 깊게, 볼트 길이에서 역산 |

플랜지를 빼면서 잃는 것과 얻는 것:

```
잃음  기울임 모멘트가 옆면 전단(716 N, 9%)이 아니라
      밑면 볼트 인발(1432 N)로 간다 = M6 스프링너트 보수 하한 1500 N 의 96%
얻음  부러질 얇은 부위가 없어진다. 부품 높이 63.9 → 38.9mm, 137.0 → 117.2 cm3
      볼트 6개 → 2개, 조립 시 레일을 끝에서 밀어 끼우지 않아도 된다
```

인발 96% 는 **보수 하한 기준**이다. 실제 M6 스프링너트 인발은 보통 2500~4000 N 이라
그 경우 36~57% 다. 이 값이 이 프로젝트에서 유일하게 안 잰 설계 변수이므로,
사람 탑승 전에 반드시 실측한다. 되살리려면 `parameters.LOW_SIDE = True`.

프레임을 위로 들어 올리는 경우는 밑면 볼트 2개가 바퀴+클램프 무게(약 30 N)를
인장으로 받는다 — 인발 한계의 1% 라 문제되지 않는다.

중요 파일:

```text
parameters.py                 치수 원본
low_clamp.py                  Design-D 하부 및 OEM 상부 참조 형상
motor_reference.py            실제 휠모터 STEP 배치
vehicle_integration.py        프레임+휠+클램프+프로파일 볼트만 뷰어 전송
vehicle_shell_integration.py  최종 외부 셸까지 포함한 차량
vehicle_cargo_integration.py  적재함 모듈 포함 차량
assembly_animation.py         조립 순서 애니메이션
load_analysis_viewer.py       하중 경로 설명용 장면(FEA 아님)
```

## 2. 확정 파일과 재생성

### 제작/CAD

```text
output/step/low_clamp_design_d.step
```

재생성:

```powershell
python models\hoverboard_mount\export_low_clamp_step.py
```

### 3D 프린터

```text
output/stl/design_d_lower_clamp_print.stl
output/stl/oem_upper_clamp_reference_print.stl
```

- 하부 STL 크기: 92.72 × 46.60 × **38.90** mm, 한 개의 유효 솔리드 (117.2 cm³, 316 g)
- 차량 4륜이면 하부 STL을 4개 출력한다.
- OEM 상부 클램프 실물이 4개 있으면 상부 참조 STL은 출력하지 않는다.
- 두 STL 모두 최저면이 Z=0에 오도록 저장되어 있다.

재생성 및 바이너리 STL 구조 검증:

```powershell
python models\hoverboard_mount\export_clamp_stl.py
```

`.venv\Scripts\python.exe` 는 **정상 동작한다** (2026-08-21 확인: Python 3.12.10 /
build123d 0.11.1). 아래 우회는 실제로 깨졌을 때만 쓴다 — 멀쩡한데 먼저 타지 마라.

```powershell
$env:PYTHONPATH='D:\build123d\.venv\Lib\site-packages'
& "$env:USERPROFILE\.cache\codex-runtimes\codex-primary-runtime\dependencies\python\python.exe" `
  models\hoverboard_mount\export_clamp_stl.py
```

## 3. 차량 프레임 최종 상태

- 3030 프레임 외곽: 길이 760 mm, 폭 450 mm
- 상부와 하부 프레임 폭을 모두 450 mm로 맞췄다. 높이는 낮추지 않았다.
- 상·하부 가로 프로파일 절단 길이: `450 - 30 - 30 = 390 mm`
- 휠 축 위치: X=±210 mm
- 네 휠 중심 Y: 약 ±263.7 mm

현재 프레임의 390 mm 프로파일:

| 용도 | 수량 |
|---|---:|
| 하부 크로스 | 3 |
| 상부 크로스 | 3 |
| 축 하중 보강 크로스 | 2 |
| 합계 | 8 |

기존 상부 500 mm 3개는 390 mm로 절단해 재사용할 수 있다. 새로 구매한다면 상부
변경분은 3개다. 실차에 축 보강 크로스 2개가 없다면 총 5개를 구매한다. 카메라
받침 크로스까지 설치할 때만 390 mm 한 개를 추가한다.

## 4. OCP 뷰어 실행과 전송

정상 가상환경:

```powershell
.venv\Scripts\python.exe -m ocp_vscode
```

브라우저: `http://127.0.0.1:3939/viewer`

현재 머신의 가상환경 실행 파일이 깨졌다면 위의 `PYTHONPATH`와 Codex 번들 Python
조합으로 `-m ocp_vscode`를 실행한다. 서버가 뜬 뒤 원하는 장면 스크립트를 실행한다.

```powershell
# 프레임, 휠, 상·하부 클램프, M6 프로파일 볼트만
python models\hoverboard_mount\vehicle_integration.py

# 최종 외부 셸 포함
python models\hoverboard_mount\vehicle_shell_integration.py

# 적재함 포함
python models\hoverboard_mount\vehicle_cargo_integration.py

# 조립 애니메이션
python models\hoverboard_mount\assembly_animation.py
```

`vehicle_integration.py`가 현재 발주 확인용 기준 장면이다. 그룹은 다음 다섯 개다.

```text
변경차량_3030프레임_상하폭450
DesignD_하부클램프_4개
기존_상부클램프_4개
실제_휠모터_STEP_4개
M6x15_프로파일체결볼트_8개
```

주의: 이 장면의 8개 볼트는 프로파일 연결용(바닥 2, 휠당 2)이다. 그룹 이름과
개수는 `parameters.LOW_BOLT_LEN` / `LOW_SIDE` 에서 유도되므로 손으로 고치지 않는다.
상부 클램프와 하부를 조이는 네 구멍은 형상에 있지만 체결 볼트 참조 형상은 현재
차량 장면에서 별도 그룹으로 표시하지 않는다.

## 5. 조립 순서

1. 하부 클램프를 준비한다.
2. 휠모터 축을 옆에서 하부 반원 시트에 얹는다.
3. 기존 상부 클램프를 축보다 높은 위치에서 내려 덮는다.
4. 상·하부 클램프를 먼저 체결한다.
5. 3030 프로파일을 위에서 얹는다 (옆 플랜지가 없어 끝에서 밀어 넣지 않아도 된다).
6. 슬롯에 스프링너트를 넣고 바닥 볼트 2개(M6x15)를 카운터보어로 올려 체결한다.

상부 클램프를 먼저 닫아 놓은 뒤 축을 통과시키거나, 프로파일을 먼저 장착한 상태에서
위쪽 클램프 볼트에 접근하는 조립 순서는 사용하지 않는다.

## 5.0 액슬 타이 (젖힘 보강)

바퀴가 축 그립보다 53.7mm 바깥이라 800 N 에서 **43 N·m 의 젖힘 모멘트**가 생기고,
3030 은 면당 슬롯이 1줄이라 그게 밑면 볼트 인발로 몰린다 (1432 N = 보수 한계의 95%).

**좌우 클램프는 아래쪽이 서로 반대로 벌어진다.** 둘을 이으면 그 부재는 **순수 인장**만
받는다 — 굽힘 접합이 필요 없어서 나사봉으로 충분하다.

```
M8 전산볼트 x2, Ø8 x 397.4mm  (간격 373.4 + 물림 12x2)
클램프 안쪽면 M8 탭 2개  x=±24.3, z=-18.0, 깊이 12
```

x=24.3 은 **상부클램프 탭(±15.1)과 레일볼트공(±34.4) 사이 창의 한가운데**다.
M8 이면 양쪽 벽이 3.3mm 남는다 (M10 은 2.5mm 라 아슬하다).

| | 레일 볼트 인발 | 한계 대비 |
|---|---:|---:|
| 타이 없음 | 1432 N | 95% |
| **M8 x2 (보수)** | **759 N** | **51%** |
| M8 x2 (실제 추정) | 264 N | 18% |

보수값은 FEA(볼트구멍 강체 고정)로 구한 조인트 강성 기준이다. 실제 T너트·슬롯은
더 물러서 타이가 더 많이 가져간다. `low_clamp.tie_force()` 가 계산한다.

### 검토했다가 접은 것

| 안 | 왜 |
|---|---|
| 평철 20x6 | 성능은 제일 좋다(64%). 구매가 어려워서 보류 |
| 3030 여분 390 x2 | ① 간격 373.4 보다 16.6mm 길다 ② 클램프 안쪽면에 30x30 끝면이 얹힐 자리가 없다(블록 높이 24 < 30). 쓰려면 블록을 30 으로 키워야 하고 지상고 −6mm |
| 기존 축 크로스 활용 | 좌우 **레일**을 잇는 부재라 클램프-레일 조인트의 43 N·m 는 그대로다 |
| 바퀴를 안쪽으로 | 기하학적 하한 50.8mm, 지금 53.7 → 6% 밖에 못 준다 |

## 5.1 설명 자료

왜 바퀴가 항상 바깥으로 밀리는지(젖힘 모멘트)를 설명하는 자료다. 설계 이유를
다시 설명해야 할 때 쓴다.

```text
docs/interactive/lever.html          슬라이더로 팔 길이를 바꿔 보는 페이지 (그냥 열면 된다)
docs/images/63_why_tipping_moment.png  3단 설명 그림
docs/images/64_tipping_animation.gif   젖혀지는 움직임
tools/figures/tipping_moment.py        위 두 이미지 생성기
tools/fea/structural_stress.py         특이점 뺀 구조응력 추출
```

`lever.html` 의 숫자는 손으로 박아 넣은 값이라 형상을 바꾸면 같이 고쳐야 한다.
출처는 `docs/interactive/README.md` 에 표로 있다.

## 6. 구조해석 파이프라인

OCP 뷰어의 화살표 장면은 설명용이다. 실제 FEA는 다음 흐름이다.

```text
STEP → Gmsh C3D10 2차 사면체 → CalculiX 선형 정적해석
     → ccx2paraview VTU → VTK 응력/변형 PNG
```

실행기는 저장소 루트에서 호출한다.

```powershell
powershell -ExecutionPolicy Bypass -File tools\fea\run_clamp_fea.ps1 `
  -Model design_d -Material al6061 -Load 800 -MeshSize 3 `
  -Eccentricity 55 -LoadDirection upward
```

주요 옵션:

- `Model`: `design_d`, `legacy_u`, `legacy_u_nogusset`
- `Material`: `al6061`, `petg`
- `Load`: 한 바퀴/클램프에 적용하는 힘[N]
- `MeshSize`: 빠른 확인 4 mm, 기준 결과 3 mm
- `Eccentricity 55`: 타이어 접지 하중선의 바깥쪽 편심 55 mm
- `LoadDirection upward`: 프레임을 고정했을 때 노면이 바퀴를 위로 미는 방향

출력은 `output/fea/<조건명>/`에 생성된다. 반드시 `summary.txt`, `.dat`, `.vtu`,
`stress_deformed_*.png`를 함께 확인한다.

## 7. 현재 비교 결과

**2026-08-21 재실행.** 플랜지 제거 형상(38.9 mm, 바닥 볼트 2개 고정)으로 다시 돌렸다.

조건: 한쪽 클램프 800 N 위 방향 / 하중선 편심 55 mm / 등가 굽힘모멘트 44 N·m /
볼트 구멍 벽 강체 고정. 반력 합은 세 케이스 모두 입력 800 N 과 1e-3 N 이내로 일치.

| 조건 | 최대(특이점) | **구조응력** | 최대변위 |
|---|---:|---:|---:|
| AL6061-T6, 4 mm | 132.2 MPa | 45.1 MPa | 0.0577 mm |
| **AL6061-T6, 3 mm** | 150.1 MPa | **45.3 MPa** | **0.0582 mm** |
| PETG 근사, 3 mm | 144.4 MPa | 45.6 MPa | 1.9067 mm |

**최대응력을 인용하지 마라.** 최대점은 셋 다 바닥 볼트 구멍 벽 위 모서리(z=+14.50,
구멍 축에서 반경 3.30 mm)이고, 강체 구속 모서리라 메쉬를 조일수록 계속 오른다
(4 mm 132.2 → 3 mm 150.1, +13.5%). 구멍에서 3 mm 만 벗어나면 45.1 → 45.3 으로
0.4% 수렴한다. 뽑는 법: `.venv\Scripts\python.exe tools\fea\structural_stress.py`

안전율(구조응력 45.3 기준): **AL6061-T6 6.1** / PETG 근사 **1.1**.
출력품은 800 N 에서 재료 한계이고 변위도 1.91 mm 다 — 사람을 태우지 않는다.

플랜지가 있던 형상(구멍 6개 고정)은 같은 조건에서 17.677 MPa / 0.007293 mm 였다.
플랜지를 빼면서 **변위가 8.0배** 커졌다. 그 값이 필요하면 `LOW_SIDE = True` 로
되돌려 다시 돌린다 (결과 폴더는 이번 실행으로 덮어써졌다).

### 손계산과의 차이 — FEA 를 따른다

`low_clamp.report()` 의 다리 굽힘 2.5 MPa / 블록 굽힘 4.8 MPa 는 **단면을 통짜 보로
본 값**이라 구멍 주변 국부 응력을 못 본다. 실제로는 하중이 Ø6.6 구멍 두 개로
빨려 들어가서 45 MPa 가 나온다 — 약 10배 차이다. report() 는 볼트 인발·지압처럼
**경로별 사용률을 빠르게 보는 용도**이고, 국부 응력은 FEA 값을 쓴다.

### 구형 브라켓 실물 변형 재현

- 상단 ㄷ자의 열린 면이 차량 내부를 향하는 실제 설치 방향
- 위·아래 볼트 4개 체결
- 삼각 거싯 제거
- 최대응력은 아래 볼트열 부근
- 상부는 거의 유지되고 아래로 내려갈수록 바퀴 바깥쪽 변위가 증가
- 최대 바깥방향 변위 2.819 mm

이는 사용자가 관찰한 “아래 볼트 부근부터 시작해 바퀴 쪽으로 갈수록 바깥으로
휘어짐”과 일치한다. 상세 수치는 `output/fea/legacy_failure_reproduction.md`에 있다.

### 600 N과 차량 하중 해석

- 600 N = 약 61.2 kgf이지만 **한 바퀴에 걸리는 힘**이지 차량 총질량이 아니다.
- 차량 약 40 kg + 사람 70 kg이면 총 정적 중량은 약 1,079 N이다.
- 사람이 한 축 가까이에 앉고 좌우 편중·프레임 비틀림·탑승 충격이 있으면 한쪽
  클램프에 400~650 N, 순간적으로 800 N 이상이 걸릴 수 있다.

## 8. 결과 이미지 읽는 법

- 흰색 와이어프레임: 하중 전 원래 형상
- 색칠된 메쉬: 계산된 변형 형상
- 화면의 `Deformation display: Nx`: 변형 표시 확대율
- 숫자로 표시된 최대변위만 실제 변위이며, 화면 간격은 확대되어 있다.
- 파랑 → 청록 → 초록 → 노랑 → 빨강: von Mises 응력이 증가하는 순서
- 따뜻한 색은 변위가 큰 곳이 아니라 응력이 높은 곳이다.
- `S_Mises`는 응력[MPa], `U`는 변위[mm]다. `E_Mises`를 응력으로 읽지 않는다.

## 9. FEA 검증 절차

1. 형상 변경 후 STEP을 다시 내보낸다.
2. 4 mm 메쉬로 먼저 실행해 노드 분류와 솔버 오류를 확인한다.
3. 3 mm로 다시 실행해 수렴성을 비교한다.
4. `.dat` 또는 `summary.txt`의 고정점 반력 합이 입력 하중과 일치하는지 확인한다.
5. PNG에서 고정 면, 하중 면, 휘는 방향이 실제 설치와 맞는지 확인한다.
6. 비교할 모델에는 같은 하중 방향, 편심, 재료와 메쉬 규칙을 사용한다.
7. 최대응력 한 점뿐 아니라 넓은 응력 분포와 전체 변형 형태를 함께 본다.

## 10. 현재 해석의 한계와 다음 작업

현재 모델에 없는 항목:

- 축·상부 클램프·하부 클램프 사이 접촉과 마찰
- M6 볼트 프리로드와 구멍 압궤
- T너트 및 3030 프로파일의 변형과 인발
- 제동/가속 토크, 횡하중, 노면 충격과 피로
- FDM 적층 방향, 벽 수, 인필 및 PLA/PETG 크리프
- 네 바퀴 하중 편중과 전체 차량 프레임 유연성

다음 해석 우선순위:

1. FreeCAD FEM 또는 PrePoMax에서 하부+축+상부 접촉 모델 구성
2. 볼트 connector/beam 및 프리로드 추가
3. 3030 프로파일 일부와 T너트 접촉 추가
4. 수직, 제동토크, 횡하중을 별도 load step으로 비교
5. 1.5~2.5배 충격 계수 및 한 바퀴 편중 조건 평가
6. 실물 정적 proof test와 변위 측정으로 해석 상관검증

PLA는 PETG보다 초기 강성이 높을 수 있지만 더 취성이고 적층 방향에 민감하다.
현재 솔버에는 PLA 재료 카드가 없으며 PETG 등방성 모델을 PLA의 정확한 결과로
해석하면 안 된다. PLA를 추가할 때는 실제 필라멘트 TDS, 출력 방향과 층간 강도를
반영한다.

## 11. 안전 판단 원칙

- FEA의 800 N은 시험으로 확정된 허용하중이 아니라 비교용 코너 하중이다.
- 정적 선형해석 결과만으로 사람 탑승 허용중량이나 안전 인증을 선언하지 않는다.
- 3D 출력품은 먼저 무부하 조립, 지그 고정 정적시험, 무인 저속시험 순서로 검증한다.
- 사람이 탑승하는 최종 클램프는 AL6061-T6 제작품을 기준으로 한다.
- 실제 허용하중은 클램프뿐 아니라 휠/축/베어링/프로파일/T너트/볼트/프레임과
  제동 성능 중 가장 낮은 한계가 결정한다.
