chungddong/NUBI/hardware/vehicle/models/hoverboard_mount/FEA.md

# Design-D 하부 클램프 구조해석 가이드

이 문서는 다음 작업자가 현재 구조해석을 그대로 재현하고 확장하기 위한 인수인계다.
OCP CAD Viewer에 표시되는 `load_analysis_viewer.py`는 하중 경로를 설명하는 그림이며
FEA 결과가 아니다. 실제 계산은 `run_clamp_fea.py`가 수행한다.
차량 프레임, STL/STEP, 뷰어 전송과 최종 발주 상태까지 포함한 전체 작업 인수인계는
[`CLAUDE_HANDOFF.md`](CLAUDE_HANDOFF.md)를 함께 읽는다.

## 1. 현재 해석 파이프라인

```text
output/step/low_clamp_design_d.step
  → Gmsh 4.15.2: STEP 가져오기, 2차 사면체 C3D10 메쉬
  → CalculiX 2.23: AL6061-T6 선형 정적해석
  → ccx2paraview 3.2.0: FRD를 ParaView용 VTU로 변환
  → VTK: von Mises 응력 및 변형 PNG 생성
```

도구 위치:

```text
tools/fea/gmsh_pyenv/Lib/site-packages   gmsh.py 및 DLL
tools/fea/python                         meshio, ccx2paraview, numpy
tools/fea/calculix/calculix_2.23_4win    ccx_static.exe, cgx
```

메인 파일:

- `run_clamp_fea.py`: Design-D와 구형 긴 ㄷ자 마운트의 메쉬, 경계조건, 솔버 입력,
  실행, 변환, 반력 분배, 요약, PNG 생성
- `low_clamp.py`: 해석 대상 Design-D 형상의 치수 원본
- `output/step/low_clamp_design_d.step`: 솔버가 읽는 STEP

## 2. 실행법

저장소 루트 `D:\build123d`에서 실행한다.

```powershell
powershell -ExecutionPolicy Bypass -File tools\fea\run_clamp_fea.ps1 -Model design_d -Load 800 -MeshSize 3
powershell -ExecutionPolicy Bypass -File tools\fea\run_clamp_fea.ps1 -Model legacy_u -Load 800 -MeshSize 3
```

- `Load`: 축 시트에 아래 방향으로 가하는 총하중[N]
- `MeshSize`: 목표 요소 크기[mm]. 빠른 확인은 4, 기준 비교는 3
- `Model`: `design_d`는 현재 하부 클램프, `legacy_u`는 상단 ㄷ자와 긴 기둥이 있는
  `exports/cnc/휠마운트_cnc_M6.step`
- 실행 스크립트는 `.venv`가 정상인지 먼저 확인하고, 현재 Codex 번들 Python을
  예비 경로로 사용한다.

출력 예:

```text
models/hoverboard_mount/output/fea/clamp_800N_h3mm/
├─ clamp_mesh.msh                  Gmsh 메쉬
├─ design_d_lower_clamp.inp        CalculiX 입력 덱
├─ design_d_lower_clamp.frd        CalculiX 원본 결과
├─ design_d_lower_clamp.dat        반력/변위 텍스트 결과
├─ design_d_lower_clamp.vtu        ParaView에서 여는 결과
├─ stress_deformed_800N.png        자동 응력 이미지
├─ solver_stdout.log
└─ summary.txt
```

ParaView에서는 VTU를 열고 `S_Mises`를 색상 필드로 선택한다. `U`는 변위 벡터다.
`E_Mises`는 등가변형률이므로 응력으로 읽으면 안 된다.

## 3. 현재 경계조건과 재료

- 재료: AL6061-T6, 탄성계수 68,900 MPa, 포아송비 0.33
- 참고 항복강도: 276 MPa. 실제 구매 소재의 성적서가 우선한다.
- 하중: 휠 축이 닿는 반원 시트의 표면 노드에 `-Z` 방향으로 균등 분배
- 고정: 프로파일과 연결되는 바닥 구멍 2개와 측면 구멍 4개의 원통 벽 노드를
  XYZ 모두 고정
- 해석: 작은 변형 선형 정적해석, quadratic tetrahedron(C3D10)
- 화면 변형: 케이스별 실제 변위를 알아볼 수 있도록 자동 확대한다. PNG 상단의
  `Deformation display: Nx`가 표시 배율이며 숫자로 적힌 최대변위는 확대하지 않는다.

이 고정조건은 클램프 몸체의 응력 집중 위치와 상대 강성을 빠르게 비교하기 위한
강체 지지 근사다. 실제 볼트와 프로파일보다 뻣뻣할 수 있다.

## 4. 검증된 기준 결과

**2026-08-21 갱신.** 옆 플랜지를 제거한 현재 형상(92.72 x 46.60 x 38.90 mm,
117.2 cm³)으로 다시 돌린 값이다. 고정은 **바닥 볼트 구멍 2개 벽**뿐이다
(이전 값은 플랜지 있는 63.9 mm 형상 + 구멍 6개 고정이라 그대로 비교하면 안 된다).

| 조건 | 최대(특이점) | **구조응력** | 최대변위 |
|---|---:|---:|---:|
| AL6061-T6, 4 mm, 18,581 요소 | 132.2 MPa | 45.1 MPa | 0.0577 mm |
| **AL6061-T6, 3 mm, 35,739 요소** | 150.1 MPa | **45.3 MPa** | **0.0582 mm** |
| PETG 근사, 3 mm | 144.4 MPa | 45.6 MPa | 1.9067 mm |

### 최대응력을 그대로 쓰면 안 되는 이유

최대점은 세 케이스 모두 **바닥 볼트 구멍 벽의 위쪽 모서리**(z=+14.50, 구멍 축에서
정확히 반경 3.30 mm)다. 강체로 고정한 면의 모서리는 탄성해에서 응력이 발산하는
자리라, 메쉬를 조일수록 값이 계속 올라간다.

```
             4 mm      3 mm      차이
최대응력    132.2  →  150.1    +13.5%   ← 수렴 안 함 (특이점)
구조응력     45.1  →   45.3     +0.4%   ← 수렴
최대변위   0.0577  → 0.0582     +0.9%   ← 수렴
```

`stress_deformed_800N.png` 를 보면 부품 전체가 파랑이고 볼트 구멍 두 곳만
빨갛다. 그 두 점 말고는 20 MPa 미만이다.

**구조응력**(구멍 벽에서 3 mm 밖의 최댓값)을 설계값으로 쓴다. 뽑는 법:

```powershell
.venv\Scripts\python.exe tools\fea\structural_stress.py
```

### 안전율

| 재료 | 참고 항복 | 구조응력 45.3 대비 |
|---|---:|---:|
| AL6061-T6 | 276 MPa | **6.1** |
| PETG 등방성 근사 | 약 50 MPa | **1.1** |

- 알루미늄은 여유가 있다.
- **출력품은 800 N 에서 재료 한계다.** 변위도 1.91 mm로 크다. 적층 방향·인필을
  반영하면 더 낮아지므로, 출력품에 사람을 태우지 않는다.
- 이 값도 볼트 프리로드·접촉·마찰이 없는 비교 모델이다. 실제 볼트 접촉을 넣으면
  구멍 주변 국부값은 달라진다.

### 플랜지 제거로 잃은 것

옆 플랜지가 있던 형상(구멍 6개 고정)은 같은 조건에서 17.677 MPa / 0.007293 mm
였다. 지금은 **변위가 8.0배** 크다 — 기울임을 받던 측면 구속이 사라진 값이다.
(그 결과 폴더는 이번 실행으로 덮어써졌다. 되살리려면 `parameters.LOW_SIDE = True`
로 두고 다시 돌린다.)

### 4.1 편심 0 / 하향 — 옛 형상(플랜지 있음) 기록

2026-08-18에 동일 STEP과 800 N 하중으로 실행한 결과다.

| 목표 메쉬 | C3D10 요소 | 최대 von Mises | 최대변위 |
|---:|---:|---:|---:|
| 4 mm | 24,128 | 3.613 MPa | 0.001390 mm |
| 3 mm | 46,928 | 4.036 MPa | 0.001400 mm |

- 변위 차이 약 0.7%: 전체 강성은 비교적 안정
- 최대응력 차이 약 11.7%: 구멍 근처 국부 응력은 추가 세분화 여지가 있음
- `design_d_lower_clamp.dat`의 고정점 반력 합: `Fz = +800 N`
- 편심 55 상향 조건 반력 합 (2026-08-21 재확인): `[0.000014, -0.000036, -800.000116]` — 입력 800 N 과 1.2e-4 N 오차
- 이 값은 허용 차량중량 또는 인증하중이 아니다.

### 구형 긴 ㄷ자와 동일조건 비교

`legacy_u`는 70 × 40 × 176.35 mm, 202.8 cm³ 형상이다. 현재 Design-D STEP은
92.72 × 46.6 × 63.9 mm, 137.0 cm³다. 둘 다 AL6061-T6, 800 N, 강체 볼트벽
고정으로 비교했다. 상세 보고서는
[`output/fea/comparison_800N.md`](output/fea/comparison_800N.md)에 있다.

| 형상 | 3 mm 요소 | 최대응력 | 최대변위 | 현재형 대비 |
|---|---:|---:|---:|---:|
| Design-D | 46,928 | 4.036 MPa | 0.001400 mm | 1.00× |
| 구형 긴 ㄷ자 | 58,158 | 15.816 MPa | 0.009374 mm | 응력 3.92×, 변위 6.70× |

구형은 부피가 1.48배인데도 축과 레일 사이의 긴 기둥 때문에 훨씬 유연하다. 수직
반력의 약 82%가 ㄷ자 아래팔 볼트 두 개에, 18%가 위팔 볼트 두 개에 걸렸다. 현재형은
바닥 볼트 2개가 약 53%, 측면 볼트 4개가 약 47%를 나눴다. 최대응력은 두 모델 모두
강체 고정한 볼트 구멍 가장자리이므로 실제 볼트 접촉 모델에서 절대값은 달라질 수
있지만, 변위와 넓은 영역의 응력 분포도 같은 경향을 보인다.

> 중요: 이 `legacy_u` 기준 결과는 **축 시트 중심에 직접 800 N을 넣은 축중심 하중**
> 이다. 실제 타이어 접지점은 체결 중심에서 바깥쪽으로 약 55 mm 떨어져 있으므로
> 같은 800 N에서 약 44 N·m의 바깥쪽 굽힘 모멘트가 추가된다. 사진에서 관찰된
> 캠버/벌어짐이나 과거 파손을 재현하려면 remote load 또는 등가 힘-모멘트로 이
> 편심을 반드시 포함해야 한다. 현재 구형 STEP은 파손 뒤 거싯이 추가된 형상이며,
> 위 표는 AL6061 해석이다. 거싯 없는 실제 PETG 출력품의 파손 검증 결과로 사용하지
> 않는다.

### 실제 구형 출력품 휨 재현

사용자 설명에 맞춰 파손 후 거싯을 제거하고, 상단 ㄷ자의 열린 면이 차량 내부를
향하도록 웹을 바깥쪽에 배치한 별도 STEP을 만들었다.

```powershell
powershell -ExecutionPolicy Bypass -File tools\fea\run_clamp_fea.ps1 `
  -Model legacy_u_nogusset -Material petg -Load 800 `
  -LoadDirection upward -Eccentricity 55 -MeshSize 3
```

`upward`는 프레임을 고정했을 때 노면이 바퀴에 주는 반력 방향이다. `downward`로
계산하면 선형응력 크기는 같지만 휘는 방향이 사진과 반대로 나온다.

| 메쉬 | 최대응력 | 최대 전체변위 | 최대 바깥방향 변위 |
|---:|---:|---:|---:|
| 4 mm | 45.917 MPa | 2.967 mm | 약 2.81 mm |
| 3 mm | 44.373 MPa | 2.979 mm | 2.819 mm |

3 mm 모델에서 최대응력은 아래 볼트열 부근 `z=170.3 mm`에 생긴다. 긴 다리의
바깥방향 변위 중앙값은 상단에서 거의 0이고 아래로 내려가며 다음처럼 증가했다.

| Z 구간 | 바깥방향 변위 중앙값 |
|---:|---:|
| 180~212 mm | 약 0.005 mm |
| 160~180 mm | 약 0.03 mm |
| 140~160 mm | 0.241 mm |
| 120~140 mm | 0.645 mm |
| 100~120 mm | 1.123 mm |
| 80~100 mm | 1.693 mm |
| 60~80 mm | 2.389 mm |

축 하단 최대 바깥방향 변위는 2.819 mm다. 즉 상부는 붙어 있고 아래 볼트열부터
곡률이 생겨 바퀴 쪽으로 갈수록 벌어졌다는 실물 관찰과 일치한다. PETG의 등방성
45 MPa 가정에 대해 최대응력 사용률은 약 99%다. 실제 FDM 층간강도, 인필, 온도,
볼트 구멍 압궤 및 사람이 올라설 때의 동적 하중을 고려하면 영구변형/균열이 충분히
가능하다. 상세 보고서는
[`output/fea/legacy_failure_reproduction.md`](output/fea/legacy_failure_reproduction.md)에
있다.

재실행 결과가 크게 다르면 STEP 변경, 노드 분류 범위 또는 경계조건 변경을 먼저
확인한다. 설계 비교에는 같은 하중과 같은 메쉬 규칙을 사용한다.

## 5. 코드에서 중요한 구현 사항

1. Gmsh에는 3D physical group `VOLUME_ONLY`를 만들고 `Mesh.SaveAll=0`을 유지한다.
   제거하면 Abaqus INP에 1D/2D 경계 요소도 들어가 CalculiX가 두께 0 오류로 멈춘다.
2. `setOrder(2)` 뒤 `HighOrderElastic`과 `HighOrder` 최적화를 유지한다. 처음 생성한
   곡면 2차 요소 중 음의 Jacobian이 생길 수 있기 때문이다.
3. ccx2paraview의 일반 고유값 계산은 작은 복소수 반올림 오차를 만들 수 있다.
   `convert_and_summarize()`가 대칭행렬용 `eigvalsh`를 임시 적용하는 이유다.
4. 최대 응력은 반드시 `S_Mises`에서 읽는다. `E_Mises`를 선택하면 변형률을 MPa로
   잘못 보고하게 된다.
5. `*CLOAD`는 노드 세트의 각 노드에 같은 힘을 적용한다. 그래서 코드는 총하중을
   로드 노드 수로 나눈 값을 기록한다.

## 6. 설계를 바꾼 뒤 확인할 것

1. `export.py` 또는 해당 형상 스크립트로 Design-D STEP을 다시 생성한다.
2. 4 mm로 먼저 실행하여 메쉬/노드 세트/솔버 오류를 확인한다.
3. 3 mm로 다시 실행한다.
4. 두 결과의 최대응력, 최대변위, 응력 집중 위치를 비교한다.
5. `.dat`에서 반력 합이 입력하중과 같은지 확인한다.
6. PNG를 눈으로 보고 하중 면과 고정 면이 의도한 위치인지 확인한다.
7. 기준보다 결과가 좋아졌더라도 아래 미포함 항목을 이유로 곧바로 “안전” 판정을
   내리지 않는다.

## 7. 현재 모델에 없는 것과 다음 확장 순서

현재 빠진 항목:

- 기존 상부 클램프와 휠모터 D컷 축
- M6 볼트 몸체, 나사산, 프리로드
- 접촉, 마찰, 틈새 및 클램핑 압력
- 3030 프로파일과 스프링/T너트의 변형·인발
- 제동/가속 토크, 횡하중, 노면 충격, 피로
- 네 바퀴 하중 편중과 전체 차량 프레임 유연성

권장 확장 순서:

1. 하부 클램프 + 축 + 상부 클램프 접촉 모델
2. M6 볼트를 beam/connector 또는 단순 솔리드로 추가하고 프리로드 적용
3. 3030 프로파일 일부와 T너트 접촉/인발 추가
4. 수직하중, 제동토크, 횡하중을 별도 load step으로 구성
5. 한 바퀴가 평균보다 30~50% 더 받는 편중 조건과 1.5~2.5배 충격 조건 비교
6. 최종적으로 실물 코너 하중 측정 및 정적 proof test와 상관검증

볼트 체결 조립체의 접촉/프리로드를 GUI로 작성해야 한다면 FreeCAD FEM 또는
PrePoMax를 전처리기로 쓰고 CalculiX를 계속 솔버로 사용하는 것이 편하다. 최종
결과는 ParaView VTU로 보관하면 버전 간 비교가 쉽다.

## 8. 해석 결과를 차량 허용중량으로 바꾸는 법

한 바퀴의 허용 설계하중을 `F_corner`, 동적배율을 `K_dynamic`, 최대 코너 편중을
`K_imbalance`라 하면 잠정 총중량은 다음과 같다.

```text
gross_mass_kg = 4 × F_corner /
                (9.81 × K_dynamic × K_imbalance)
```

800 N을 단지 “해석을 수행한 코너 하중”으로 넣으면 `K_dynamic=2.0`,
`K_imbalance=1.3`에서 약 125 kg이다. 하지만 800 N은 시험으로 확정한 허용하중이
아니므로 이 환산값도 잠정 설계 목표일 뿐이다. 실제 차량 적재량은 여기서 차량
자체중량을 빼고, 바퀴/베어링/프로파일/T너트/배터리/제동 성능 중 가장 낮은 한계를
적용한다.
