chungddong/NUBI/hardware/vehicle/models/vehicle/DECISIONS.md

# 차량 설계 결정 기록

무엇을 왜 골랐는지 결정 하나에 한 칸씩 남긴다. 버전 README 는 "무엇이 바뀌었나",
이 문서는 "왜 그렇게 정했나" 를 적는다. 근거 조사는 [`research/`](research/) 에 있다.

- **상태**: 확정 / 잠정 (실물 확인 전) / 폐기
- 값의 출처 표기: [판매처] [도면] [사례] [계산] [가정]

---

## D-01 방수 · 방진 등급은 기준에서 뺀다 — 확정 (v18, 2026-10-04)

- **결정**: 부품 선정 · 외관 설계에서 IP 등급 · 밀폐 (글랜드, 개스킷, 빗물막이) 를 기본으로 넣지 않는다.
- **이유**: 사용자 — "실외지만 극한 환경에서 굴릴 프로젝트가 아니다". IP 기준으로 고른 카메라 (336L) · 비상정지 (Schneider IP69K) 가 비싸고 구하기 어려웠다.
- **결과**: 비상정지 Autonics SF2ER-E2RB, 케이블 구멍은 고무 그로밋, 루버 덮개 뺌.

## D-02 뎁스 카메라 Orbbec Gemini 336 ×2 — 확정 (v19, 2026-10-04)

- **결정**: Gemini 336L → **Gemini 336** (아이씨뱅큐 462,000 ×2).
- **이유**: 햇빛 아래 깊이 성능 (IR-pass 필터, Orbbec 이 강한 실외광 대상 명시) 은 336L 과 같고 두 대 308,000 원 싸다. 깊이 계산이 카메라 안 ASIC 이라 젯슨 부담 없음. Orin Nano · ROS2 Humble 공식 지원.
- **버린 대안**: Nuwa HP60C (구조광, 공식 실내용), Gemini 2 (Semi-Outdoor), OAK-D Lite (국내 정식 유통 없음), D435i · ZED Mini (더 비쌈).
- **대가**: 기준선 50 mm → 이상 범위 0.3–3 m (336L 0.25–6 m).

## D-03 모터 드라이버 = 호버보드 원래 2 세대 분리형 보드 4 장 + RoboDurden Gen2.x 펌웨어 — 잠정 (v21, 2026-10-05 개정)

- **결정**: 호버보드 2 대에서 꺼낸 **원래 보드 4 장 (직사각형, 바퀴마다 1 장)** 을 그대로 쓴다.
  펌웨어는 **RoboDurden Hoverboard-Firmware-Hack-Gen2.x** (MM32 보드면 AILIFE 판). 제어는 **원래 짝 (마스터 + 슬레이브) 을
  앞축 · 뒤축에 하나씩** 두고, **ESP32 하드웨어 UART 2 개가 각 짝의 마스터** REMOTE 헤더 (PB6/PB7) 에 붙는다 (19200 baud).
  두 짝에 같은 (속도, 조향) 을 보내면 스키드 스티어. ZLAC8015D 는 뺀다.
- **개정 이력**: v20 에서 1 세대 일체형 보드 2 장 + EFeru FOC 로 정했으나, 사용자 보드는 **직사각형 4 장 = 2 세대 분리형**이었다
  (2026-10-05 사용자 확인). EFeru 는 2 세대를 지원하지 않는다.
- **이유**
  - 일반 호버보드 모터 (홀센서만) 가 ZLAC8015D · MD400T 에서 도는지 확인해 준 출처가 없었다 [사례]. 원래 보드는 그 모터와 짝이다.
  - 보드는 이미 있다 — 드라이버 값이 안 든다.
  - 짝을 축 단위로 두면 마스터 안의 좌우 믹싱 · 반전이 그대로 맞는다. 같은 쪽 앞/뒤로 묶으면 꼬인다 [조사].
    UART 버스에 4 장을 ID 로 다는 방식 (SINGLE + UARTBUS) 은 바퀴별 독립 제어가 되지만 보드 TX 마다 쇼트키 다이오드가 필요하다 → 나중 선택지.
- **지켜야 할 것**
  - **보드 칩 확인**: GD32F130C8 (Gen2.1.x, 가장 흔함 — TT-SD2.2) · GD32E230 · MM32SPIN05/06 · GD32F103 등은 지원. **AT32F415 는 목록에 없음**.
    기판 실크 이름 · 게이트 드라이버 칩 수를 RoboDurden 위키 식별기와 대조.
  - 굽기: ST-Link V2 (MM32 는 DAPLink). 처음 전체 지우기로 잠금 해제 — **원래 펌웨어는 영구히 사라진다**. 미리 만든 바이너리는 낡았다 → 직접 컴파일 (온라인 컴파일러 pionierland.de/hoverhack).
  - **레이아웃 핀이 틀리면 배터리 단락 → MOSFET 소손.** 첫 시험은 1~2 A 정전류 전원 (또는 42 V 1.5 A 충전기) 으로 REMOTE_DUMMY 부터.
  - **마스터-슬레이브 헤더 + 핀은 12~15 V** — ESP32 에 물리면 망가진다. PB6/PB7 은 5 V 허용, ESP32 3.3 V 직결 가능. GND 만 공통.
  - 전원: `DISABLE_BUTTON` 을 켜고 ESP32 GPIO 를 버튼 커넥터의 **저전압 쪽 핀**에 → High = 켜짐 (릴레이 불필요). 8 분 무동작 꺼짐 설정 확인.
  - 명령이 2 s 끊기면 PWM 끔 (`TIMEOUT_MS`). ESP32 도 젯슨 명령이 끊기면 정지.
  - 보드마다 배터리 직결 + 보드별 퓨즈. 전류 제한 `DC_CUR_LIMIT` 은 **보드당 7 A** 로 낮춰 4 장 합 28 A + 전자 2 A = 30 A 안 (D-04).
    DC 링크 전류 제한이라 느린 회전의 토크 (상전류) 는 거의 안 깎인다.
  - 방열: MOSFET 이 PCB **밑** 알루미늄 바에 붙는 형식 — PC 바닥판은 단열재라 **M3 스탠드오프 12 mm 로 띄워** 바람이 지나게 했다.
    바를 금속에 붙이려면 먼저 바와 GND · B+ · 상선 사이 절연을 멀티미터로 확인.
- **치수는 사진 비례 (±10~15 %)** — 실측 (PCB · 구멍 간격 · 바 · 높이 · 커넥터 방향) 을 받으면 parts.py `SB_PCB` · `SB_HOLE` 을 고친다.
- 근거: [research/2026-10-05_split_boards.md](research/2026-10-05_split_boards.md), [research/2026-10-05_similar_vehicles.md](research/2026-10-05_similar_vehicles.md)

## D-04 배터리 = 36 V 10S 20 Ah, BMS 30 A 급 + 펌웨어 속도 제한 — 잠정 (v20)

- **결정**: 알엠파워 **ZENION 삼성 21700 36V 20Ah 10S4P 직사형, XT-90** (553,000, 95 × 245 × 75, 3 kg, 최대 방전 30 A, 최대 충전 10 A, KC) [판매처].
  펌웨어에서 최고 속도를 **1.5 m/s 로 제한**해 최악 전류를 30 A 아래로 묶는다.
- **이유 — 전력 예산** [계산, 가정 포함]

  | 부하 | 최악 | 평소 |
  |---|---|---|
  | 바퀴 4 개 | 바퀴당 약 6 A × 4 = **약 24 A** (1.5 m/s 에서 최대 토크로 동시에 밀 때) | 평지 주행 1~4 A (사례 6WD 평지 약 40 W + 보드 대기 보드당 약 10 W) |
  | 젯슨 Orin Nano + 카메라 2 + iAHRS (12 V) | 약 40 W | 15~25 W |
  | 5 V 계통 (ESP32 · 팬 2 · LED [가정 10 W]) | 약 13 W | 5~10 W |
  | 컨택터 코일 (12 V) | 3.5 W | 3.5 W |
  | 전자 합 (변환 효율 88 %) | 약 64 W → **약 2 A** | 약 1 A |
  | **합** | **약 26 A** | 약 3~6 A |

  - 바퀴 전류 어림: 호버보드 모터 토크상수 약 0.52 N·m/A (ODrive 호버보드 가이드 KV 16), 상전류 15 A 기준 최대 약 7.8 N·m.
    v21: 보드 펌웨어 `DC_CUR_LIMIT` 보드당 7 A 로 **배터리 쪽 전류를 하드 상한** (4 × 7 + 2 = 30 A) 으로도 묶는다.
    1.5 m/s = 바퀴 약 18 rad/s → 기계 출력 약 140 W + 구리 손실 → 배터리 쪽 약 6 A.
    **배터리 전류는 토크 × 속도 (출력) 에 비례**하므로 속도를 묶으면 최악 전류가 묶인다. 느린 제자리 회전은 상전류는 크지만 배터리 전류는 작다.
  - 주행 시간 어림: 712 Wh × 0.8 ÷ 평균 150 W ≈ 3.8 h.
- **버린 대안**
  - 볼턴 · 바나나배터리 36V 20Ah (15 A) — 원래 호버보드 1 대분 (바퀴 2 개용) 수준. 최악 26 A 를 못 버틴다.
  - 파워크래프트 36V 18Ah **50 A BMS** — 여유는 가장 크지만 가격 · 크기 · KC 미확인 (주문제작, 반품 불가). **실측이 25 A 를 넘으면 이것으로 바꾼다** (견적 항목: 10S 20 Ah 안팎, 연속 40 A 이상, XT90, 300 × 130 × 100 안, KC, 충전 허용 전류).
  - 금강에너지솔루션 같은 팩 457,000 — 사양표가 같지만 충전기 · 배송 표기 없음.
- **확인할 것**: "최대 30 A" 가 연속인지 차단값인지 (판매처 문의), 만든 뒤 제자리 회전 · 경사 · 가속에서 배터리 전류 실측.

## D-05 비상정지 = DC 컨택터로 바퀴 쪽 전원만 끊는다 — 확정 (v20)

- **결정**: **LS일렉트릭 GPR-M040 DC12V** (40 A, 1000 VDC, 코일 12 V 3.5 W, 67 × 35.3 × 47) [판매처 · 카탈로그]. SSR 은 뺀다.
- **회로**: 배터리 → 메인 차단기 40 A →
  ① 컨택터 → 바퀴 보드 2 장 / ② (컨택터 앞단) 12 V 변환기 → 젯슨 · 컨택터 코일, 5 V 변환기 → ESP32 · 팬 · LED.
  코일 회로 = 12 V → 키 스위치 → 비상정지 (1NC) → 코일. 코일에는 제너 + 다이오드 (또는 TVS) — 일반 다이오드만 달면 접점이 늦게 떨어진다 [카탈로그].
  ESP32 는 컨택터 출력 전압을 재서 상태를 알고, 끊기면 속도 0 · 래치. 다시 켤 때는 버튼을 돌려 풀고 ESP32 가 보드 전원 핀 (DISABLE_BUTTON, D-03) 을 올린다.
- **이유**
  - 상용 플랫폼 (Husky A300 · Nova Carter) 공통 — **모터 전원만 끊고 컴퓨터는 유지** [사례].
  - SSR 은 고장 나면 붙은 채로 남을 수 있고, Fotek SSR 은 위조품 문제가 있으며 국내 정품 확인이 안 됐다 [조사].
  - 컨택터 코일 3.5 W 는 비상정지 접점 (24 VDC 10 A) 정격 안.
- **알려진 한계**: 허브모터는 전원이 끊기면 자유 회전 — **경사에서 굴러갈 수 있다** (Nova Carter 문서 경고). 공원 경사로를 다니면 "ESP32 가 먼저 속도 0 (보드가 정지 유지) → 지연 후 차단" 을 나중에 더한다.
- **주의**: 주접점 극성 있음 — + 단자를 배터리 쪽. 주문품 4~6 주 (급하면 파워크래프트 TE EV200AAANA 170,500, 크고 비쌈).

## D-06 방향 센서 = iAHRS RB-SDA-v1 — 확정 (v20)

- **결정**: ROBOR (㈜로버) **iAHRS RB-SDA-v1** — 35 × 35 × 10, Ø2 구멍 29 × 29, USB (젯슨에 직결) [도면 · 판매처]. 엘레파츠 198,000 (VAT 포함).
- **이유**: BNO085 는 국내 재고 품절 (나머지는 해외 입고). iAHRS 는 국산 · 국내 재고이고 국내 로봇 사례 2 건에서 썼다 [사례]. 커뮤니티 ROS2 드라이버가 이 모델용.
- **설정**: 지자기 보정 끔 (`mv` = 0, 기본값) — 허브모터 자석이 가깝다 (Clearpath 도 섀시 자력계 비권장) [사례].

## D-07 전원 변환 · 보호 — 확정 (v20)

- **젯슨**: MEAN WELL **RSD-60L-12** (입력 18~72 V → 12 V 5 A). Orin Nano 개발킷 DC 잭은 9~20 V [NVIDIA 포럼]. 19 V 국내품 (DKP-53) 은 입력 하한 35 V 라 배터리가 처지면 꺼질 수 있어 뺐다.
- **5 V**: 디오시스템 **DKP-55** (8~60 V → 5 V 10 A).
- **메인 차단기**: DC 차단기 1P 250 VDC 40 A (DIN 레일). MIDI · ANL 58 V 퓨즈는 국내 재고가 없었다. 패턴: 배터리 가까이 주 차단기 + 분기 퓨즈 [사례].
- **통신**: 젯슨 ↔ ESP32 USB, ESP32 ↔ 보드 UART 3.3 V. 젯슨을 드라이버에 USB 로 바로 묶었다가 접지 루프로 손상된 사례가 있다 [사례].

## D-08 부품은 국내 구매만 — 확정 (2026-10-04)

- **결정**: 해외직구 · 구매대행을 쓰지 않는다. 디바이스마트는 이 PC 에서 접속이 안 돼 다른 곳 우선.
- **근거 표**: [research/2026-10-04_domestic_sourcing.md](research/2026-10-04_domestic_sourcing.md)

## D-09 배기 팬 = EVERCOOL EC8025H05B + EFG-S80 가드 — 확정 (v21)

- **결정**: 뒤판 배기 팬 2 개 **EVERCOOL EC8025H05B 2P** (5 V 0.28 A 1.4 W, 3000 rpm, 36.48 CFM, 2 볼, 8,740) [제조사 사양표],
  바깥 **EFG-S80 핑거 가드** (380). M4×20 + 나일론 너트로 가드 · 판 · 팬을 같이 문다.
- **이유**: 국내 재고 5 V 80 mm 중 **전류가 제조사 자료로 확인**되고 공차 도면이 있다. 2 개 0.56 A — 5 V 10 A 계통에 부담 없음.
  2 볼 베어링이라 차량 진동 · 장착 방향에 강하다. 메카솔루션 FNM (1,540) 은 1800 rpm 으로 풍량이 약 60 %.
- **설치**: 라벨면 (배기면) 이 판 안쪽면에 닿게. 케이블은 차량 가운데 쪽으로 (옆 기둥에 닿지 않게 — v21 검사에서 걸렸다).
  PC 에 록타이트 금지 (응력균열). 먼지 필터 EFM-S80 은 구멍 간격 71.2 로 0.3 다르고 배기 쪽이라 효용이 작아 뺐다.
- 조용한 대안: EC8025M05CA (0.18 A, 2400 rpm, < 28 dBA, 같은 프레임).
- 근거: [research/2026-10-05_ports_fans.md](research/2026-10-05_ports_fans.md)

## D-10 포트 칸 = 국내 실물 7 개, 두 줄 배치 — 잠정 (v21, 일부 구멍 치수 실물 확인 전)

- **결정** (칸 안 195 × 55, 바깥에서 볼 때)

  | 자리 | 부품 | 구멍 |
  |---|---|---|
  | 왼 위 | 전압계 VaneAims 원형 DC 4~100 V (2 선, 6,160) | Ø22 [추정] |
  | 왼 아래 | ESP32 USB-C MAXTEK MT723 판넬 연장 30 cm (3,200) | 사각 + 귀 나사 간격 17 [컷아웃 추정] |
  | 가운데 | USB 3.0 Coms HA079 ×2 (7,000) · RJ45 Coms HA084 (6,000) 원형 벌크헤드 | Ø22 [사진 비례] |
  | 오른 위 | 키 스위치 HAS1911 19 mm (4 A 28 VDC, 6,600) | Ø19 + D 컷 16.5 |
  | 오른 아래 | 충전 GX16 3P (알엠파워, 1,500) | Ø16 + D 컷 14.6 |

- **이유**: 한 줄로는 앞면 폭 합 약 204 mm 라 195 에 안 들어간다. 사각 전압계 (48 × 28.8, 3 선) 대신 원형 (Ø29.5, 2 선 자체 전원) 으로 폭을 줄였다.
  원형 벌크헤드 3 개를 같은 계열로 맞춰 구멍 하나 크기로 통일.
- **배선 결정**: 전압계는 **컨택터 뒤**에 물린다 — 주행 중에만 켜져 세워 둘 때 배터리를 안 먹는다 (0.5 W). 키 스위치는 컨택터 코일 회로 (D-05).
  키는 ON · OFF 둘 다에서 빠진다 — 주행 중엔 키를 빼 두고 덮개를 닫는다 (꽂은 키는 칸 깊이 거의 끝까지 나온다).
- **확인할 것**: 알엠파워 충전기 '항공단자' 옵션이 **GX16 인지 GX12 인지, 충전기 쪽 성별** (이 세트는 패널 쪽이 수 핀 — 배터리 쪽에 쓰면 42 V 핀 노출).
  원형 벌크헤드 · 전압계 구멍 지름과 MT723 컷아웃은 실물을 재거나 시험 출력으로 맞춘다.
  값싼 ESP32 보드는 USB-C CC 저항이 없어 C-C 로 안 잡힐 수 있다 — A-C 케이블로.
- 근거: [research/2026-10-05_ports_fans.md](research/2026-10-05_ports_fans.md)

## D-11 전조등 = MR16 12 V 5 W LED ×2 + ASA 테두리 · 고정 링, ESP32 PWM — 잠정 (v22, 2026-10-05)

- **결정**: 앞판 카메라 양옆 아래 (y = ±150, z = 225) 에 **건식 LED MR16 12 V 5 W 집중형 주광 6500 K** ×2
  (0.41 A · 410 lm · 빔 50°, Ø50 × 49, 1,720) [판매처] + GU5.3 사기 소켓 (1,000).
  앞판 Ø51 구멍, 바깥 **ASA 테두리** (둥근 사각 80 × 64, 깊이 18 — 램프가 8 mm 들어가 전조등처럼 보인다) 의 립 (Ø46) 이 램프 앞 테두리를 잡고,
  안쪽 **ASA 고정 링**의 손가락 3 개가 램프 뒤 원뿔을 앞으로 민다. M3 ×4 (안에서, 테두리에 열압입 인서트) 로 판을 사이에 두고 조인다.
  켜고 끄기 · 밝기는 바닥판의 **DFRobot DFR0457 MOSFET 모듈** (로직 3.3 V, PWM ≤ 1 kHz, 6,270) 하나에 두 램프를 병렬로.
- **이유**
  - 후보 중 **전기 사양 (A · lm · 빔각) 이 전부 적힌** 것은 이것뿐이고, 표준 규격 (MR16 · GU5.3) 이라 교체품을 어디서든 구한다. 가장 싸다.
  - 패널 구멍 하나로 매립 — 앞판 안쪽 깊이 약 85 (리드 포함) 로 안쪽 부품 (보드 z ≤ 155) 과 높이가 갈린다.
  - 12 V 예산: 젯슨 최대 약 3.5 A + 컨택터 코일 0.29 A + 전조등 0.82 A = 약 4.6 A < RSD-60L-12 5 A (빠듯함 — 젯슨을 최대 모드로 돌리며 전조등을 켜면 여유 0.4 A).
- **버린 대안**: 전동부품몰 6 W 라이트 + 경적 (밖으로 돌출, lm 미기재), 55 mm 프로젝터 10 W (2 개 1.7 A — 12 V 예산 초과), 미니 U7 (전원 껐다 켜면 모드 전환 — PWM 불가, 깊이 90),
  3 W 파워 LED 돌출형 (작아서 전조등 느낌 약함).
- **확인할 것**: MR16 내장 드라이버라 **PWM 밝기 조절이 되는지 미확인** (켜고 끄기는 됨) — 200~1000 Hz 로 시험. 소켓 포함 실제 깊이 · 렌즈 유효 지름은 실물 측정.
  DFR0457 고정 구멍 [가정]. 12 V 가 모자라면 전조등을 5 V 계통으로 옮기는 대신 12 V 변환기를 한 단계 큰 것으로.
- 근거: [research/2026-10-05_headlight.md](research/2026-10-05_headlight.md)

## D-12 눈썹 안테나 = 젯슨 와이파이 2 개를 앞판 밖으로 — 잠정 (v23, 2026-10-05)

- **결정**: 젯슨 기본 와이파이 카드 (AW-CB375NF, **MHF4** ×2) 의 안테나 2 개를 **에즈윈 AX200 Wi-Fi 6 키트** (컴퓨존 29,000) 의
  MHF4 ↔ 벌크헤드 케이블 300 ×2 와 안테나 135 ×2 로 앞판 밖으로 뺀다. 벌크헤드는 **전조등 테두리 안쪽 위 모서리** (y ±100, z 260),
  안테나는 힌지로 꺾어 전조등 위를 지나 **바깥쪽 끝이 15° 올라가게** 눕힌다 → 눈썹.
- **이유**
  - 사용자 요청 (전조등 위 눈썹 느낌). 기능상으로도 밖이 낫다 — 옆판 ACM 은 알루미늄이라 전파를 막고, 젯슨은 차체 안 깊이 있다.
  - MHF4 피그테일 단품은 국내 재고가 없었다 — 키트가 국내 재고 · 짝 맞는 케이블 + 안테나를 한 번에 준다 (카드는 예비).
  - 자리: 벌크헤드 안쪽 너트 윗끝 z 264.6 < 상부 끝 크로스 밑면 266.85, 바깥 너트는 테두리 (z ≤ 257) 위, 안쪽은 카메라 USB 케이블 (z ≤ 252.5) 위.
    바깥쪽 끝 (|y| 약 213, z 약 293) 은 앞판 안 (|y| 228, z 296.85).
- **확인할 것**: 키트 커넥터가 SMA 인지 RP-SMA 인지 (키트끼리는 맞음), 안테나 이득 (≤ 5 dBi 권장), 벌크헤드 나사 · 판 구멍 실측.
  수평 편파라 수직으로 세운 것보다 수신이 조금 약할 수 있다 — 힌지라 실물에서 세울 수도 있다.
- 근거: [research/2026-10-05_antenna.md](research/2026-10-05_antenna.md)

## D-13 상부 프레임 = 하부와 같은 3030 사각 + 가운데 크로스 — 확정 (v23)

- **결정**: 옆 레일 760 ×2 (y ±210) + 크로스 390 ×3 (x −365 · 0 · +365), 기둥 6 위 (z 266.85~296.85 — 외관판 위끝과 같다).
  기둥 ↔ 레일: **M8 × 60 렌치볼트**를 레일 위에서 관통 (Ø8.5) 해 기둥 끝 탭 (3030 가운데 구멍 Ø6.8 → M8) 에. 크로스 ↔ 레일: M8 엔드탭.
- **이유**: 하부와 같은 단면 · 같은 크로스 자리라 외관판 위쪽 구멍 (옆 x ±105 · ±290, 앞뒤 y 0 · ±120, z 281.85) 이 그대로 레일 · 크로스 슬롯에 맞는다.
  가운데 크로스는 상부판 받침 · 가운데 기둥 고정. 코너 브래킷은 전조등 고정 링 · 카메라 브래킷 자리와 겹쳐 쓰지 않았다.
  기둥 볼트 머리 자리는 나중 상부판에 머리 구멍 (또는 같은 볼트로 상부판까지 조인다).
- 검사: 상부 레일을 1 mm 내리면 기둥과 겹친다 (= 얹혀 있다), 상부 프레임 ↔ 모든 부품 · 외관 겹침 0.

## D-14 앞 뎁스 카메라를 전조등 아래로 (입) — 확정 (v24, 2026-10-05)

- **결정**: 앞 카메라 렌즈 중심 z 250 → **172** (창 위끝 184.8 — 전조등 테두리 아래끝 193 보다 8.2 아래). 뒤 카메라는 250 그대로 (밑에 포트 칸).
- **이유**
  - 사용자 — 눈썹 (안테나) · 눈 (전조등) 아래 입처럼 보이게.
  - 기능으로도 낫다: 세로 시야 65° 라 바닥이 보이기 시작하는 거리가 392 → **270 mm** — 턱 · 연석 같은 낮은 장애물에 유리.
    위쪽도 1 m 앞에서 약 80 cm 높이까지 보여 차 높이 (약 30 cm) 위 장애물을 보기에 충분하다.
  - 범퍼 (25 돌출) · 전조등 테두리 (18 돌출) 모두 시야 밖.
- **자리 검사**: 카메라 · 브래킷 ↔ 앞 보드 · 바닥판 · 볼트 겹침 0, 브래킷 아래끝이 바닥판 위 18.2, USB 플러그는 좌우 보드 사이 (|y| < 70).
- **대가**: 앞뒤 카메라 높이가 달라 소프트웨어 TF (카메라 위치) 를 따로 넣는다. 지면에 가까워 먼지 · 물 튐을 조금 더 맞는다.
- 비게 된 이마 자리 (z 약 250, 눈썹 사이) 는 상태 표시등 후보.

## D-15 상부 덮개 = ACM 3t, 손나사 M5 10, 기둥 볼트 머리 구멍 — 잠정 (v25, 2026-10-05)

- **결정**: ACM 3t 766 × 456 (앞뒤 · 옆판 바깥면까지), 모서리 R6. 상부 프레임과 벽 윗면 위 (z 296.85~299.85).
  고정은 **M5 로렛 손나사 10** — 상부 레일 윗슬롯 (x ±105 · ±290) 8 + 끝 크로스 윗슬롯 (y 0) 2, T 너트.
  기둥 볼트 M8 머리 (Ø13) 자리는 **Ø16 구멍** — 머리가 덮개 위로 6 나온다.
- **이유**
  - 재료: 옆판과 같은 ACM — 밝은 색이라 햇볕 열을 덜 받고 (PC 흑색은 흡수), 알루미늄 겉판이라 PC 3t 보다 단단하다 (받침 없는 칸 약 335 × 390).
    전파는 막지만 와이파이는 이미 앞판 밖 (D-12), GPS 안테나는 덮개 **위**에 올린다.
  - 손나사: 안 부품 정비가 위로만 가능 — 공구 없이 연다.
  - 기둥 볼트를 덮개 고정에 같이 쓰지 않은 이유: 덮개를 열 때마다 레일 ↔ 기둥 이음이 풀린다. 구멍으로 빼서 프레임은 그대로.
- **버린 대안**: PC 3t 흑색 (햇볕 열 흡수 · 덜 단단함), 기둥 볼트로 같이 조이기 (위 이유), 경첩 (덮개 위에 라이다 · GPS 가 올라가면 케이블 때문에 결국 떼어내야 함).
- **나중에**: 라이다 · GPS · 상태 표시등 구멍은 부품을 정한 뒤 이 판에 더한다. 기둥 볼트 머리가 거슬리면 저두 볼트로.

## D-16 모듈 레일 = 2020 ×3 을 상부 프레임 위에, 덮개는 레일 사이 두 장 — 확정 (v26, 2026-10-05)

- **결정**
  - **2020 T 슬롯 3 본** (x −380~+380, **y −210 · 0 · +210**) 을 덮개가 아니라 **상부 프레임 위에 바로** 얹는다.
    양옆은 상부 사이드 레일 위 (M5 × 35 4 개씩, x ±105 · ±290), 가운데는 크로스 3 곳 (x −365 · 0 · +365). 2020 윗면에 Ø9 접근 구멍.
  - **덮개 = 레일 사이 두 장** (ACM 3t 766 × 189 R6, y ±10.5~±199.5 — 레일과 틈 0.5). 손나사 3 개씩 (크로스 위 x −365 · 0 · +365, y ±105).
    **모듈 케이블 그로밋 Ø25** 한 장에 하나 (x −100, y ±150).
  - 기둥 ↔ 상부 사이드 레일 이음: M8 기둥 볼트 (머리가 레일 윗면) → **3030 코너 브래킷 8** (기둥 x 면, 레일 밑 — 끝 기둥은 안쪽 한 면, 가운데 기둥은 양면).
    **D-13 개정** — 레일 윗면을 모듈 레일에 내줬다.
- **이유**
  - 처음 의도 ([설계 이야기](../../../../docs/worklog/topics/vehicle-build-story.md#8막-데크를-모듈식으로) 8 막, docs/payload-interface.md): "위에 적재함이든 로봇팔이든 꽂을 수 있게" — 데크 위 2020 3 본,
    T 슬롯이라 모듈을 아무 위치에나 T 너트로 문다. 덮개를 다시 뚫지 않는다.
  - 레일을 덮개에 달면 덮개를 열 때 레일 · 모듈을 다 떼야 한다 → 프레임에 달고 덮개는 사이에 끼웠다.
    양옆 레일은 3030 바로 위라 하중이 프레임으로 곧장 간다.
  - 간격 210 (처음 규격 200): 양옆 레일을 3030 중심 (y ±210) 에 맞춰 볼트가 3030 윗슬롯에 바로 물리게.
  - 코너 브래킷은 기둥 x 면만 — y 안쪽 면은 앞쪽 전조등 고정 링 (y ≤ 190) 자리와 겹친다.
- **모듈 인터페이스 (이 차)**: 레일 윗면 z **316.85**, 옆 슬롯 중심 z 306.85, 레일 끝 x ±380, 레일 중심 y −210 · 0 · +210 (간격 210),
  모듈 케이블 구멍 (x −100, y ±150) Ø25. 덮개 윗면 z 299.85 (레일 윗면보다 17 아래 — 손나사 머리 윗끝 305.9 도 그 아래).
- 검사: 레일 −1 mm → 프레임 겹침 18,120 mm³ (얹혀 있다), 브래킷 +0.5 mm → 상부 레일 겹침 2,211 mm³ (붙어 있다),
  레일 · 브래킷 · 덮개 ↔ 나머지 전부 겹침 0.

## D-17 첫 모듈 = 센서 모듈 (라이다 STL-19P · GPS630 · 큐라이트 표시등) — 잠정 (v27, 2026-10-05)

- **결정**
  - 2D 라이다 **LDROBOT STL-19P** (D500 키트, 엘레파츠 172,700) — 2020 기둥 2 본 (175) + AL 3t 윗판 위, **스캔 평면 z 526**.
  - GNSS **아센코리아 GPS630** (USB, u-blox M8, 안테나 일체, 75,394) — 처음엔 일반급. RTK 로 올리면 Holybro H-RTK ZED-F9P Rover (684,200).
  - 상태 표시등 **큐라이트 ST45ML-BZ-3-12-RAG** (Ø45 3 단 + 부저, 12 V 최대 160 mA, 65,670) — 대기 노랑 · 주행 초록 · 비상정지 빨강 깜빡 + 부저.
  - 밑판 AL5052 4t 200 × 460 이 레일 3 본에 M5 T 너트 6 (x −60~+140 — 덮개 그로밋 x −100 을 피함).
- **이유**
  - 라이다: 국내 재고 후보 중 **주변광 내성 최고 (60 klux, C1 은 40 klux)**, 흑색 8 m. 45 g · 높이 35 라 마스트가 가볍다. ROS2 는 LD19 드라이버로.
  - 스캔 평면을 표시등 꼭대기 (509.8) 보다 위로 — 아래에 두면 표시등 기둥이 라이다 시야를 약 15° 가린다.
    대가: 52 cm 보다 낮은 장애물은 라이다가 못 본다 → **낮은 것은 뎁스 카메라 몫** (시뮬레이터에서 0.5 m 울타리 · 12 cm 상자는 라이다에 안 잡힌다).
  - 마스트는 기둥 2 본 + 브래킷 — 처음 설계 때 외팔 마스트는 주행 진동으로 포인트클라우드가 흐려졌다 ([설계 이야기](../../../../docs/worklog/topics/vehicle-build-story.md) 19 막).
  - GPS 는 일반급부터 (약 2.5 m CEP) — 보도 단위 경로 추종보다 전역 기준점. RTK 는 52~61 만 원 더.
  - 표시등은 국산 (큐라이트), 12 V 최대 160 mA. **12 V 계통이 빠듯하다** (D-11 약 4.6 / 5 A + 0.16) → 젯슨 최대 모드 + 전조등 + 표시등이 겹치면 변환기를 키운다.
- **확인할 것**: STL-19P 구멍 위치 · 커넥터 면 (도면 해석 불확실), 표시등 스터드 규격 (M4 추정), 모듈 레일 슬롯 규격 (국산 DF2020 이면 반달 너트 M5).
- 근거: [research/2026-10-05_sensor_module.md](research/2026-10-05_sensor_module.md)

## D-18 차량 웹 시뮬레이터 — 확정 (2026-10-05)

- **결정**: `models/vehicle/sim/` — 버전 메시 캐시를 웹으로 옮겨 (web_export.py) three.js 로 운전 · 센서 · 전원을 본다. 포트 8748 (launch.json `vehicle-sim`).
- **이유**: 사용자 — "manuel 1.0 처럼 시뮬레이터 웹". 버전마다 메시 캐시 (scene.npz) 가 이미 있어서 다시 지을 필요가 없다.
- **보이는 것**: 스키드 스티어 주행 (바퀴 회전), 시험 코스 (상자 · 기둥 · 0.8 m 통로 · 턱 20 / 40 mm · 경사 10° / 15°), 뎁스 카메라 시야 · 깊이 점 · 앞 카메라 화면,
  라이다 스캔, 전조등 (밤), 상태 표시등, 비상정지 (경사에서 굴러감 — D-05 한계), 전원 추정 (D-04 식).
- **처음 결과 (추정)**: 직진 1.3 m/s 약 2.8 A, 제자리 회전 상전류 약 5.8 A · 배터리 약 3.9 A, 15° 오르막 약 3.8 A —
  **D-04 의 최악 26 A 는 넉넉히 잡은 값**이었다. 실측으로 확인할 것.

## D-19 시뮬레이터로 본 것 — 사각지대 · 전복 · 비상정지 방식 · 자율주행 (2026-10-05, 결정 대기)

시뮬레이터 (`sim/`, D-18) 의 추정값이다. **아직 설계를 바꾸지 않았다** — 아래 '제안' 은 사용자 결정 대기.

### ① 센서 사각지대 (coverage.js)
- **52 cm 보다 낮은 장애물은 차 양옆이 통째로 사각** — 높이 10 · 30 cm 장애물: 차 둘레 1 m 띠 안 사각 약 **4.1 m²**,
  왼 · 오른 · 대각 방향은 3 m 안에서 아예 못 본다. 앞 · 뒤는 범퍼에서 10~20 cm 부터 보인다 (카메라).
- 60 cm 이상 (어린이 · 의자 · 사람) 은 라이다가 360° 다 본다 — 1 m 안 사각 0.
- 스키드 스티어는 제자리 회전을 하니 옆 사각이 실제로 위험하다 (돌다가 옆의 낮은 것을 친다).
- **제안**: 옆 낮은 곳을 보는 센서 추가 (좌우 ToF · 초음파 2~4 개 또는 범퍼 스위치), 또는 지도 기억에 기대기 (다가오면서 본 것은 지도에 남는다 — nav.js 는 그렇게 한다).

### ② 전복 · 무게중심 (stability.js)
- 지금 (33.6 kg, 무게중심 z 152 mm): 전복각 옆 **60°** · 앞 54° · 뒤 54° — **미끄러짐 (μ 0.6 → 31°) 이 먼저**. 옆 경사 20° 에서 여유 40°.
- 추가 모듈을 올리면 앞뒤가 먼저 줄어든다 (휠베이스/2 = 210 < 윤거/2). 15 kg 을 레일 위 60 cm 에 두면 앞 전복각 **28°** — 미끄러짐보다 먼저 넘어진다.
- **모듈 규칙 (전복각 ≥ 미끄러짐 31° 유지)**: 모듈 무게중심 높이 (레일 위) — 10 kg ≤ 약 70 cm · 15 kg ≤ 약 48 cm · 20 kg ≤ 약 37 cm.

### ③ 비상정지 방식 비교 (10° 경사, 0.8 m/s 에서 누름, 4 s)

| 방식 | 오르막: 더 간 · 뒤로 굴러감 | 내리막: 4 s 동안 간 거리 |
|---|---|---|
| A. 즉시 차단 (지금 D-05) | 16 cm · **428 cm** | 360 cm |
| B. 정지 후 차단 (0.5 s) | 12 cm · **406 cm** | 359 cm |
| C. 정지 유지 (전원 유지, 보드가 0 을 잡음) | 12 cm · **0** | 12 cm |
| D. 차단 + 상선 단락 제동 | 2 cm · 34 cm (약 0.09 m/s 로 기어감) | 38 cm |

- B 는 한 번 서도 0.5 s 뒤 전원이 끊기면 다시 굴러간다 — A 와 거의 같다.
- **제안**: 버튼 → ESP32 가 보드에 '정지 유지' (C) 를 걸고, 컨택터 차단은 뒤로 (워치독 실패 · 두 번째 누름 · 보드 고장일 때), 끊을 때는 상선 단락 릴레이 (D) 로 천천히만 내려가게 — C + D 조합.
  D 의 제동 세기는 Kt 0.52 · 선간 저항 0.3 Ω 가정 (실측 필요).

### ④ 자율주행 (nav.js)
- 점유 격자 (라이다 층 + 깊이 층) → A* (0.1 m, 차 반폭 + 5 cm 부풀림) → 순수 추종 + 0.8 s 미리 보기 (간이 DWA).
- 열린 목표 (6.5, −1.2) 9.5 s · 통로 쪽 (−8.6, 0) 13.5 s 에 도착. 상자 · 기둥 · 낮은 상자 사이 좁은 목표 (3.6, 0.3) 는 못 감.
- 만들면서 잡은 것: 앞 카메라 시야 전체로 멈추면 비스듬한 옆 상자에도 선다 → '지나갈 띠' 안만 본다. 라이다가 깊이 층까지 지우면 52 cm 아래 상자가 지도에서 사라진다 → 두 겹.

### D-19 덧붙임 — 복도에서 달려 보기 (2026-10-05)
- 사용자 — "D:\Develop\ClaudeGame\hallway-3d 복도 3D 모델을 가져와서 운행". 원본 형상 코드를 그대로 써서 시뮬레이터 환경으로 (sim/import_hallway.py, hallway_env.js).
- 복도 입구 → 라운지 앞 27 m 를 자율주행으로 **60 s 에 도착** (그중 27 s 는 사람 2 명이 길을 막아 기다림). 사람과 한 번 살짝 닿음.
- 복도 폭 2.69 m 에 사람 둘이 나란히 오면 차 (바퀴 포함 폭 약 0.58 + 여유) 가 지나갈 틈이 없다 — 실제로도 '기다리기' 가 맞는 행동.

## D-20 내부 배선 — 분기 레일 · 음극 한 점 · WAGO 분배 · USB 허브 — 잠정 (v28, 2026-10-05)

사용자 — "내부 부품 배치된 거 볼 수 있게 상단 프레임 등 다시 떼 보고, 그 안에 실제 필요한 거 맞게 배선까지". 코드는 `v28_wiring/wiring.py`,
속 보기는 `v28_wiring/inside.py`. 구매처 원자료 [research/2026-10-05_wiring.md](research/2026-10-05_wiring.md).

- **36 V 경로**: 배터리 XT-90 → **XT90 암** → 메인 차단기 40 A → 컨택터 + 단자 (상시) → 컨택터 출력 (스위치) →
  **분기 레일** (앞 칸, DIN 35 · 136 mm): 바퀴 보드 4 장은 **DC 차단기 20 A ×4** (입력끼리 14 AWG 점퍼), 12 V · 5 V 변환기는
  **DC 퓨즈 홀더 10×38 + 15 A** (컨택터 + 단자에서 상시로), 충전 단자도 **15 A 퓨즈** (XT90 땜납 컵에서 — 메인 차단기 앞이라 꺼 둔 채 충전).
  - 왜 20 A · 15 A: 국내에 10 A 이하 DC 차단기 · gPV 퓨즈가 없었다 (메가에너텍 20/40/63 A, PV 퓨즈 15 A 부터). 분기 보호는 **전선 (14 AWG) 보호**가 목적이고
    보드는 펌웨어 `DC_CUR_LIMIT` 7 A 로 묶인다 (D-03). 32 V 자동차 블레이드 퓨즈는 42 V 에 정격 밖이라 안 쓴다 (D-07).
  - 1P 핀 부스바도 국내에 없어서 **점퍼선** (F4 → F3 → F1, F4 → F2, F5 → F6).
- **0 V 는 한 점**: 모든 음극 (배터리 · 보드 4 · 변환기 입력 · 충전 · 전압계 · 코일 · 12 V 기준선) 을 **음극 N 단자대** 하나에 모은다.
  절연형 RSD 의 출력 − 은 입력 − 와 WAGO 에서 묶고 기준선 1 가닥으로 N 바에. M6 버스바는 국내 재고가 없어 전기자재 N 단자대 (구매처 확인).
- **12 V · 5 V 분배**: WAGO 221-415 ×4 (12V ± 는 RSD 옆, 5V ± 는 DKP 옆). 12 V → 젯슨 DC (5.5 × 2.5) · 키 스위치 · 전조등 DFR0457 · 표시등 공통,
  5 V → ESP32 · 팬 2 · **USB 허브**.
- **비상정지 루프**: 12V+ → 키 (포트 칸) → 비상정지 1NC → 컨택터 코일 + (오른쪽 간선) → 코일 − → N 바. ESP32 는 컨택터 출력을 분압해 감지.
- **신호**: ESP32 UART ×2 + 전원 핀 (DISABLE_BUTTON) → 앞 · 뒤 마스터 (5 심), 마스터 ↔ 슬레이브는 원래 4 핀 (12~15 V — ESP32 에 안 물림),
  PWM → DFR0457 (전조등), GPIO 4 → **MOSFET 1 채널 모듈 ×4** (표시등 초록 · 노랑 · 빨강 · 부저, 로우사이드).
- **USB**: 카메라 2 는 젯슨 USB 3 에 직접 (대역), 나머지 (라이다 어댑터 · GNSS · iAHRS · ESP32 · 패널 USB-A 2) 는 **유전원 허브 PL-UH307P** (7 포트, 5 V 는 DKP).
  패널 USB-A 1 · RJ45 는 젯슨에. **패널 USB-C 는 ESP32 대신 젯슨 USB-C (복구 · 콘솔)** — ESP32 의 USB 는 젯슨 쪽 (허브) 에 물려 있어 둘 다 못 쓴다.
- **경로**: 긴 구간은 하네스 간선 2 (헬리컬 밴드) — 왼쪽 바닥 (레일 → 뒤왼 보드 · 전압계), 오른쪽 z 170 (뒤오른 보드 · DKP · 충전 · 비상정지 · 팬 · 허브 5 V,
  DKP 위를 넘어감). 신호 · USB 는 상부 프레임 밑 (z 256~258) 과 배터리 위 (z 211~230, 방향별로 높이를 나눔).
  레일 출력은 북쪽으로 가는 것 (F1 · F3) 을 북쪽에, 남쪽 것은 남쪽에 두고 높이를 차례로 — 출력선끼리 안 엇갈린다.
- **GNSS 를 180° 돌림** — 케이블이 덮개 그로밋 (−100, 150) 쪽으로.
- **검사 (v28 verify)**: 전선 · 간선 · 새 부품 ↔ 모든 부품 겹침 0 (끝 단자 부품만 봐줌), 전선끼리 0 (양 끝 20 mm 뺌), 끝점 180 / 180 이 단자 부품에 닿음,
  대조군 (배터리 위 전선 30 mm 내림 → 배터리와 겹침 · GNSS 케이블을 덮개 구멍 밖으로 → 덮개와 겹침).
  - 만들면서 잡은 함정: 겹친 원기둥 · 구 묶음 (Compound) 을 통째로 불리언에 넣으면 OCC 가 **빈 결과**를 낼 때가 있다 → 조각 하나씩 잰다 (`wiring.collide`).
- **찾은 것 · 확인할 것**
  - **안테나 동축이 짧다**: 젯슨 M.2 카드는 뒤, 안테나는 앞 — 경로 왼 약 0.5 · 오른 0.72 m. 키트의 300 mm 는 못 쓴다 → 0.8 m MHF4 ↔ RP-SMA (구매처 확인).
  - 앞 카메라 USB 경로 0.90 m — Coms IK045 1 m 로 겨우 (여유 작음).
  - **컨택터 투입 돌입 전류**: 보드 4 장 콘덴서를 한 번에 채운다 — 20 A 분기 차단기가 떨어지거나 접점이 상하면 프리차지 (100 Ω 10 W 를 컨택터 양단에 + 지연)
    를 넣는다. 다만 프리차지가 늘 붙어 있으면 비상정지 중에도 보드 로직이 살 수 있어 **릴레이로 잠깐만** 걸어야 한다 — 실측 후 결정.
  - 단자 자리 (RSD 단자 순서 · DKP 선 색 · DFR0457 단자대 · 보드 REMOTE 헤더 자리) 는 [가정] — 실물 보고 wiring.py 좌표를 고친다.
  - 표시등 공통이 +12 V (PNP 공통) 인지 실물 확인 — 아니면 하이사이드로 바꾼다.
- BOM: 배선 · 배전 줄을 형상 길이로 넣음 (전선 = 경로 + 간선, 여유 15 %) → 단가 확인된 합 **2,636,743 원** (+121,273), 미확인 38 줄.

## D-21 배선을 바닥판 위 직각 경로로 — 진행 중 (v29, 2026-10-05 ~)

사용자 — "최대한 바닥판에 잘 정리해봐 — 선 길이는 얼마든지 늘려도 되니 ㄱ · ㄴ 자로 휘어도 깔끔하게만". 코드는 `v29_floor_wiring/router.py` · `wiring.py`.

- **결정**: 연결 (D-20 의 90 가닥) 은 그대로, 경로만 바꾼다 — 단자에서 짧게 빠져 수직으로 바닥까지, 바닥에서는 x · y 로만.
  배터리 위 · 공중 · 대각선 경로는 없앤다 (상부 프레임 밑 높은 경로도 바닥으로).
- **방법**: 손으로 꺾은점을 찍는 대신 격자 라우터 (2 mm, A*). 끝점 기둥 자리를 먼저 다 잡고 (단자 앞을 나중 선이 막지 않게) 바닥 경로를 깐다.
  짧은 선부터 (긴 선은 돌아가도 된다), 꺾임 벌점, 부품 · 다른 선 옆에 붙기 (다발), 다른 선은 직각으로만 넘어감 · 나란하면 얹기.
- **바꾼 자리**: XT90 바닥, 분기 레일 90°, N 바 컨택터 남쪽, XT60 4 개 y 방향, 12 V WAGO 나란히, 표시등 MOSFET 남쪽, USB 허브 y −5 (v29 README).
- **만들면서 잡은 것**
  - A* 비용을 float32 에 담으면 꺼낼 때 '이미 더 싸게 왔다' 로 잘못 버려 경로가 하나도 안 나왔다 → float64.
  - 끝점 기둥이 막힌 주머니 (컨택터 ↔ N 바 사이 등) 에 떨어지면 못 나온다 → 가장 큰 바닥 영역에서만 고른다.
  - WAGO 입구 간격 3.6 mm 에 2 심 케이블 (Ø4.4) 을 나란히 꽂으면 서로 막는다 → 짝 · 홀 번째 길이를 엇갈리고, 2 심은 끝 자리에.
  - 팬 케이블 토막처럼 부품에 붙은 선은 바닥 지도에 장애물로 칠해진다 → 그 둘레만 지나가게 허용.
- **상태**: 경로 79 / 79. **검증 실패** — 판에 닿음 2 (팬 오른 · ESP32 → 앞왼 마스터), 전선끼리 69 (격자 어림 ↔ 실제 굵기).
  다음: 실제 지름으로 간격 · 넘어가는 높이를 다시 재고, 겹침 0 이면 v29 를 기록한다.
