chungddong/NUBI/hardware/vehicle/models/vehicle/v05_floor/floor_plate_cut.md

# 바닥판 재단 규격 (v05_floor)

- 재질: **아크릴 (PMMA) 5t** — 레이저 깔끔 · 투명 · 싸다 / 충격 · 볼트 조임에 갈라진다
- 외곽: **760 x 450**, 코너 R3 · 수량 1 · 무게 약 1.98 kg
- 파일: `output/floor_plate.dxf` (1:1 mm, 외곽 + 구멍 전부, 레이어 CUT)

## 노치 (기둥 자리, 판 가장자리에서 파냄)

| 위치 | 크기 | 설명 |
|---|---|---|
| x=-365, y=-210 | 32 × 32 | 모서리 기둥 3030 + 여유 1 |
| x=-365, y=+210 | 32 × 32 | 모서리 기둥 3030 + 여유 1 |
| x=+0, y=-210 | 32 × 32 | 긴 변 가운데 기둥 3030 + 여유 1 |
| x=+0, y=+210 | 32 × 32 | 긴 변 가운데 기둥 3030 + 여유 1 |
| x=+365, y=-210 | 32 × 32 | 모서리 기둥 3030 + 여유 1 |
| x=+365, y=+210 | 32 × 32 | 모서리 기둥 3030 + 여유 1 |

## 구멍

| 종류 | Ø | 수량 | 위치 (x, y) | 용도 |
|---|---:|---:|---|---|
| 고정 볼트 | 6.5 | 18 | (-365,-110), (-365,+110), (-210,-110), (-210,+110), (+0,-110), (+0,+110), (+210,-110), (+210,+110), (+365,-110), (+365,+110), (-105,-210), (-105,+210), (+105,-210), (+105,+210), (-290,-210), (-290,+210), (+290,-210), (+290,+210) | M6x15 둥근머리 + 와셔 + 스프링너트 (크로스 5 본 · 사이드 레일 윗면 슬롯) |
| 케이블 그로밋 | 25 | 4 | (-165,-154), (-165,+154), (+165,-154), (+165,+154) | 휠모터 케이블 — T 클램프 혀 출구에서 안쪽으로 30 간 자리 |
| 장비 격자 | 5.5 | 66 | 50 mm 격자 (볼트 · 그로밋 · 노치 근처 제외) | M5 장비 고정 |

## 절단 길이 (견적 근거)

- 외곽 + 노치 약 2.80 m, 구멍 88 개 약 1.82 m → **합계 약 4.6 m**

## 볼트

- 필요 길이 15.0 (판 5 + 와셔 1.6 + 립 2.4 + 물림 6) ~ 최대 15.8 (끝이 프로파일 중심 보스에 닿기 전) → **M6x15**

## 주의

- 아크릴 · PC 는 볼트를 세게 조이면 구멍에서 갈라진다 — **와셔 필수, 손으로 꽉 정도.**
- 사이드 레일 볼트 구멍은 판 가장자리에서 11.8 mm 다 (구멍 중심 → 가장자리 15). 아크릴이면 특히 살살 조인다.
- 레이저 커프 0.2 mm 는 업체가 보정한다. 구멍 지름은 도면값 그대로 주문.
- 받침 없는 구간 (크로스 안쪽면 사이): 125, 180, 180, 125 mm.
