chungddong/NUBI/hardware/vehicle/models/vehicle/v09_floor_pc/floor_plate_cut.md

# 바닥판 재단 규격 (v09_floor_pc)

- 재질: **폴리카보네이트 (PC) 5t** — 충격에 아크릴의 수십 배 / 레이저는 그을린다 → CNC 재단
- 외곽: **760 x 450**, 코너 R3 · 수량 1 · 무게 약 1.97 kg
- 파일: `output/floor_plate.dxf` (1:1 mm, 외곽 + 구멍 전부, 레이어 CUT)

## 노치 (기둥 자리, 판 가장자리에서 파냄)

| 위치 | 크기 | 설명 |
|---|---|---|
| x=-365, y=-210 | 32 × 32 | 모서리 기둥 3030 + 여유 1 |
| x=-365, y=+210 | 32 × 32 | 모서리 기둥 3030 + 여유 1 |
| x=-210, y=-210 | 32 × 32 | 긴 변 기둥 3030 + 여유 1 (지금은 기둥 없음 — 10 본 겸용) |
| x=-210, y=+210 | 32 × 32 | 긴 변 기둥 3030 + 여유 1 (지금은 기둥 없음 — 10 본 겸용) |
| x=+0, y=-210 | 32 × 32 | 긴 변 기둥 3030 + 여유 1 |
| x=+0, y=+210 | 32 × 32 | 긴 변 기둥 3030 + 여유 1 |
| x=+210, y=-210 | 32 × 32 | 긴 변 기둥 3030 + 여유 1 (지금은 기둥 없음 — 10 본 겸용) |
| x=+210, y=+210 | 32 × 32 | 긴 변 기둥 3030 + 여유 1 (지금은 기둥 없음 — 10 본 겸용) |
| x=+365, y=-210 | 32 × 32 | 모서리 기둥 3030 + 여유 1 |
| x=+365, y=+210 | 32 × 32 | 모서리 기둥 3030 + 여유 1 |

## 구멍

| 종류 | Ø | 수량 | 위치 (x, y) | 용도 |
|---|---:|---:|---|---|
| 고정 볼트 | 6.5 | 18 | (-365,-110), (-365,+110), (-210,-110), (-210,+110), (+0,-110), (+0,+110), (+210,-110), (+210,+110), (+365,-110), (+365,+110), (-105,-210), (-105,+210), (+105,-210), (+105,+210), (-290,-210), (-290,+210), (+290,-210), (+290,+210) | M6x15 둥근머리 + 와셔 + 스프링너트 (크로스 5 본 · 사이드 레일 윗면 슬롯) |
| 케이블 글랜드 M20 | 20.5 | 4 | (-165,-154), (-165,+154), (+165,-154), (+165,+154) | 휠모터 케이블 — T 클램프 혀 출구에서 안쪽으로 30 간 자리 |
| 장비 격자 | 5.5 | 0 | 50 mm 격자 | M5 장비 고정 (실외판은 0) |
| 부품 고정 | 4.5 | 1 | (+320.2,-70.8) | M4 — 모터드라이버_앞_ZLAC8015D |
| 부품 고정 | 4.5 | 1 | (+254.8,-70.8) | M4 — 모터드라이버_앞_ZLAC8015D |
| 부품 고정 | 4.5 | 1 | (+320.2,+70.8) | M4 — 모터드라이버_앞_ZLAC8015D |
| 부품 고정 | 4.5 | 1 | (+254.8,+70.8) | M4 — 모터드라이버_앞_ZLAC8015D |
| 부품 고정 | 4.5 | 1 | (-254.8,-70.8) | M4 — 모터드라이버_뒤_ZLAC8015D |
| 부품 고정 | 4.5 | 1 | (-320.2,-70.8) | M4 — 모터드라이버_뒤_ZLAC8015D |
| 부품 고정 | 4.5 | 1 | (-254.8,+70.8) | M4 — 모터드라이버_뒤_ZLAC8015D |
| 부품 고정 | 4.5 | 1 | (-320.2,+70.8) | M4 — 모터드라이버_뒤_ZLAC8015D |
| 부품 고정 | 3.4 | 1 | (-117.5,+156.0) | M3 스탠드오프 — 젯슨_오린나노_개발킷 |
| 부품 고정 | 3.4 | 1 | (-117.5,+70.0) | M3 스탠드오프 — 젯슨_오린나노_개발킷 |
| 부품 고정 | 3.4 | 1 | (-59.5,+156.0) | M3 스탠드오프 — 젯슨_오린나노_개발킷 |
| 부품 고정 | 3.4 | 1 | (-59.5,+70.0) | M3 스탠드오프 — 젯슨_오린나노_개발킷 |
| 부품 고정 | 3.4 | 1 | (-121.0,-113.0) | M3 스탠드오프 — ESP32_보드 |
| 부품 고정 | 3.4 | 1 | (-121.0,-71.0) | M3 스탠드오프 — ESP32_보드 |
| 부품 고정 | 3.4 | 1 | (-59.0,-113.0) | M3 스탠드오프 — ESP32_보드 |
| 부품 고정 | 3.4 | 1 | (-59.0,-71.0) | M3 스탠드오프 — ESP32_보드 |
| 부품 고정 | 5.5 | 1 | (+170.5,-32.4) | M5 — 메인퓨즈_MIDI40A_58V |
| 부품 고정 | 5.5 | 1 | (+129.5,-47.6) | M5 — 메인퓨즈_MIDI40A_58V |
| 부품 고정 | 4.5 | 1 | (+126.0,+45.0) | M4 — SSR_모터전원차단_40A |
| 부품 고정 | 4.5 | 1 | (+174.0,+45.0) | M4 — SSR_모터전원차단_40A |
| 부품 고정 | 5.5 | 1 | (+100.0,+78.0) | M5 [가정] — DCDC_36V-19V_젯슨 |
| 부품 고정 | 5.5 | 1 | (+100.0,+162.0) | M5 [가정] — DCDC_36V-19V_젯슨 |
| 부품 고정 | 3.5 | 1 | (-120.0,-150.0) | M3 [가정] — DCDC_36V-5V |
| 부품 고정 | 3.5 | 1 | (-60.0,-150.0) | M3 [가정] — DCDC_36V-5V |
| 부품 고정 | 2.7 | 1 | (-50.2,-88.9) | M2.5 스탠드오프 — IMU_BNO085 |
| 부품 고정 | 2.7 | 1 | (-29.8,-88.9) | M2.5 스탠드오프 — IMU_BNO085 |
| 부품 고정 | 2.7 | 1 | (-50.2,-71.1) | M2.5 스탠드오프 — IMU_BNO085 |
| 부품 고정 | 2.7 | 1 | (-29.8,-71.1) | M2.5 스탠드오프 — IMU_BNO085 |
| 배터리 밴드 슬롯 | 28×5 | 1 | (-40,-60) | 폭 25 밴드 |
| 배터리 밴드 슬롯 | 28×5 | 1 | (-40,+60) | 폭 25 밴드 |
| 배터리 밴드 슬롯 | 28×5 | 1 | (+40,-60) | 폭 25 밴드 |
| 배터리 밴드 슬롯 | 28×5 | 1 | (+40,+60) | 폭 25 밴드 |

## 절단 길이 (견적 근거)

- 외곽 + 노치 약 3.06 m, 구멍 22 개 약 0.63 m → **합계 약 3.7 m**

## 볼트

- 필요 길이 15.0 (판 5 + 와셔 1.6 + 립 2.4 + 물림 6) ~ 최대 15.8 (끝이 프로파일 중심 보스에 닿기 전) → **M6x15**

## 주의

- 아크릴 · PC 는 볼트를 세게 조이면 구멍에서 갈라진다 — **와셔 필수, 손으로 꽉 정도.**
- 실외: 관통 볼트마다 **고무 (EPDM) 와셔** 로 물을 막는다. 글랜드는 O 링 + 로크너트. 기둥 노치 틈은 실리콘.
- PC 는 레이저로 자르면 그을린다 — **CNC 라우터 재단**으로 주문.
- 사이드 레일 볼트 구멍은 판 가장자리에서 11.8 mm 다 (구멍 중심 → 가장자리 15). 아크릴이면 특히 살살 조인다.
- 레이저 커프 0.2 mm 는 업체가 보정한다. 구멍 지름은 도면값 그대로 주문.
- 받침 없는 구간 (크로스 안쪽면 사이): 125, 180, 180, 125 mm.
