chungddong/NUBI/hardware/vehicle/models/hoverboard_mount/output/fea/comparison_800N.md

# Design-D 대 구형 긴 ㄷ자 마운트 — 800 N 비교

비교일: 2026-08-18

## 대상

| 항목 | Design-D 현재형 | 구형 긴 ㄷ자 |
|---|---|---|
| STEP | `output/step/low_clamp_design_d.step` | `exports/cnc/휠마운트_cnc_M6.step` |
| 외형 | 92.72 × 46.6 × 63.9 mm | 70 × 40 × 176.35 mm |
| 부피 | 137.0 cm³ | 202.8 cm³ |
| 레일 체결 | 바닥 2 + 양 측면 4 | ㄷ자 아래팔 2 + 위팔 2 |
| 축-레일 하중경로 | 짧은 블록/다리 | 긴 기둥을 지나 상단 ㄷ자까지 전달 |

둘 다 AL6061-T6(E=68,900 MPa, ν=0.33), 축 시트 아래 방향 800 N, 3 mm 목표
C3D10 메쉬로 해석했다. 볼트 구멍 원통 벽을 XYZ 강체 고정한 형상 비교 모델이다.

> 범위 경고: 아래 결과는 하중 작용선을 축 시트 중심에 둔 **축중심 하중 비교**다.
> 실제 타이어 접지점은 체결 중심보다 약 55 mm 바깥에 있어 800 N에서 44 N·m의
> 추가 굽힘 모멘트를 만든다. 따라서 아래 구형 응력·변위는 사진에서 관찰된 바깥쪽
> 벌어짐을 검증하는 결과가 아니며 실제 현상을 과소평가한다. 또한 분석 STEP은 파손
> 후 거싯이 추가된 CNC 형상이고 재료도 AL6061이다. 과거 거싯 없는 PETG 출력품과
> 동일한 모델이 아니다.

## 결과

| 항목 | Design-D | 구형 긴 ㄷ자 | 구형/현재형 |
|---|---:|---:|---:|
| 요소 수 | 46,928 | 58,158 | 1.24× |
| 최대 von Mises | 4.036 MPa | 15.816 MPa | 3.92× |
| 응력 99백분위 | 2.327 MPa | 6.852 MPa | 2.94× |
| 최대변위 | 0.001400 mm | 0.009374 mm | 6.70× |
| 등가 수직강성 `800/δ` | 571.6 kN/mm | 85.3 kN/mm | 현재형이 6.70× 강함 |

4 mm에서 3 mm로 바꿨을 때 구형 최대응력은 14.546 → 15.816 MPa(+8.7%),
변위는 0.009218 → 0.009374 mm(+1.7%)였다. 전체 강성 비교는 안정적이고 볼트 구멍
국부 최대응력은 메쉬 영향을 일부 받는다.

## 고정점 반력 분배

반력 합은 두 경우 모두 `[Fx,Fy,Fz] ≈ [0,0,800] N`으로 평형을 만족했다.

### Design-D

| 위치 | 반력 벡터 [N] | 합력 |
|---|---:|---:|
| 바닥 왼쪽 | [-198.1, -0.1, 214.1] | 291.7 N |
| 바닥 오른쪽 | [198.4, 0.0, 213.2] | 291.2 N |
| 측면 4곳 | 각각 수직 92~94, 수평 38~39 | 각각 약 100~102 N |

수직하중 분배는 바닥 2개 427.3 N(53.4%), 측면 4개 372.7 N(46.6%)다.

### 구형 긴 ㄷ자

| 위치 | 반력 벡터 [N] | 합력 |
|---|---:|---:|
| 아래팔 왼쪽 | [-18.0, -21.2, 327.4] | 328.6 N |
| 아래팔 오른쪽 | [17.9, -21.4, 326.5] | 327.6 N |
| 위팔 왼쪽 | [2.3, 21.2, 73.0] | 76.1 N |
| 위팔 오른쪽 | [-2.2, 21.4, 73.1] | 76.2 N |

수직하중의 81.7%가 아래팔 볼트 2개에, 18.3%가 위팔 볼트 2개에 걸린다. 위·아래
팔의 반대 방향 Y 반력은 ㄷ자가 레일을 감싸며 만드는 커플이다.

## 해석

구형은 재료가 48% 더 많지만 높이가 2.76배이고, 축 하중이 긴 기둥을 지나 상단
ㄷ자 뿌리와 아래팔 볼트로 전달된다. 따라서 전체 굽힘 변형이 커지고 아래팔 볼트
구멍 가장자리에서 최대응력이 발생한다. Design-D는 레일과 축 사이 거리를 줄이고
바닥·양 측면의 6개 체결점으로 반력을 분산해 더 가볍고 훨씬 단단하다.

이 결과는 형상 비교에는 유효하지만 실제 허용하중 판정은 아니다. 실제 비교에는
볼트 프리로드, 볼트-구멍 접촉, 프로파일/T너트 변형, 상부 클램프와 축 접촉, 제동
토크 및 피로를 추가하고 실물 proof test로 상관검증해야 한다.
