chungddong/NUBI/hardware/vehicle/models/vehicle/research/2026-10-05_antenna.md

# 눈썹 안테나 (와이파이) 조사 (2026-10-05)

결정은 [`../DECISIONS.md`](../DECISIONS.md) D-12.

## 젯슨 기본 와이파이

- Jetson Orin Nano Developer Kit (Super 포함) 기본 모듈 **AzureWave AW-CB375NF** (RTL8822CE, 2×2 Wi-Fi 5 + BT 5.0, M.2 2230 Key E).
- 안테나 커넥터 **I-PEX MHF4 ×2** (u.FL 아님) — ANT1 Wi-Fi + BT, ANT2 Wi-Fi. 기본 안테나는 받침 안 PCB 안테나 2 (NVIDIA 단품 판매 안 함).
- NVIDIA 포럼: 모듈 인증 최대 **5 dBi** — 외장 안테나는 5 dBi 이하.
- 근거: [Hackaday 분해](https://hackaday.com/2023/03/21/hands-on-nvidia-jetson-orin-nano-developer-kit/) · [AW-CB375NF 데이터시트](https://files.waveshare.com/wiki/Wireless-AW-CB375NF/Wireless-AW-CB375NF-Datasheet.pdf) · [NVIDIA 포럼 5 dBi](https://forums.developer.nvidia.com/t/jetson-orin-nano-dev-kit-antenna-datasheet/332084)

## 국내 재고 (MHF4 피그테일 단품은 국내 재고 없음 → 키트)

| 상품 | 판매처 | 가격 | 구성 · 치수 |
|---|---|---|---|
| ★ [에즈윈 AX200 Wi-Fi 6 Kit](https://www.compuzone.co.kr/product/product_detail.htm?ProductNo=1272311) | 컴퓨존 (직접 배송) | 29,000 | 케이블 300 ×2 (벌크헤드 너트 · 톱니 와셔), 안테나 135 ×2 (검정), AX200 카드 |
| [마이크로박스 외장 3 dBi 110 mm 세트](https://www.compuzone.co.kr/product/product_detail.htm?ProductNo=1226083) | 컴퓨존 (업체 직배송) | 10,000 | 케이블 30 cm ×2 + 안테나 2 — "AX210 호환" (MHF4 추정) |
| [대흥정보기술 PM-5DI02D](https://rftown.com/product/pm-5di02d/8119/category/51/display/1/) | RF타운 | 5,500 | 2.4/5 GHz 3/2 dBi, RP-SMA, 국내 제조 (안테나만) |

- 에즈윈 안테나 모양 (135 = 739 px 비례, ±0.5~1): 로렛 너트 Ø9.9 × 7.5 · 힌지 베이스 Ø9.1 13 · 꺾임 마디 커넥터 끝에서 약 21.5 · 목 Ø8.3 9 · 굵은 몸통 Ø9.8 41 · 테이퍼 35 (Ø9.7→6) · 끝 Ø5.8 28.
- **SMA / RP-SMA 표기가 어디에도 없다** — 키트 안끼리는 짝이 맞지만, 다른 안테나로 바꿀 땐 실물 확인.
- 벌크헤드 일반값: 1/4"-36 UNS, 너트 맞변 약 8, 판 구멍 Ø6.5~6.6 (페이지 표기 없음 — 실물 확인).
