chungddong/NUBI/hardware/vehicle/docs/interactive/lever.html

호버보드 휠 마운트 · 1:1 축척 단면

# 바퀴는 왜 항상 바깥으로 밀리나

차체가 누르는 힘과 노면이 미는 힘이 같은 선 위에 없다. 어긋난 거리만큼 브라켓을 젖히는 회전력이 생긴다. 슬라이더로 그 거리를 바꿔 보면 왜 이 차량에서는 그 값을 줄일 수 없는지가 보인다.

팔 길이 — 하중선에서 지지선까지

0실제 53.790 mm

팔 길이 53.7 mm

젖히는 힘 43 N·m

볼트 1개 인발 1432 N

너트 한계 대비 95 %

## 줄일 수 없는 이유

팔 길이는 브라켓 설계로 정하는 값이 아니라 바퀴 자체의 폭이 정한다. 타이어 중심에서 바깥으로 나가려면 최소한 타이어 반폭 27.5 mm 를 지나야 하고, 거기에 클램프 반두께 23.3 mm 가 더 붙는다. 합이 50.8 mm — 지금 값 53.7 mm 는 기하학적 하한보다 2.9 mm 위에 있을 뿐이다. 클램프를 모터 하우징에 닿기 직전까지 밀어도 50.3 mm 이고, 젖히는 힘은 43 → 40 N·m 로 6% 줄어든다. 이 축으로는 더 짜낼 게 없다.

## 그래서 바꿀 수 있는 건 이것

방법 | 무엇이 달라지나 | 볼트 1개 부담
지금 — 3030 밑면 볼트 2개 | 인발로 받는다 | 1432 N
더 좋은 T너트로 교체 | 힘은 그대로, 한계가 올라간다 | 1432 N
레일 옆면까지 물기 | 인발 → 전단으로 바뀐다 | 716 N
휠 마운트 구간만 3060 | 슬롯 2줄이 지레를 만든다 | 430 N

네 경우 모두 젖히는 힘 43 N·m 자체는 그대로다. 바뀌는 건 그 힘을 어느 경로로 흘려보내느냐뿐이다. 없앨 수는 없고, 잘 받아낼 수만 있다.

## 실제로 얼마나 밀리나

형상 · 재료 | 바깥 밀림 | 구조응력 | 판정
부러진 구형 · PETG 출력 | 2.16 mm | 44.4 MPa | 파단
지금 것 · PETG 출력 | 0.67 mm | 45.6 MPa | 한계
지금 것 · AL6061-T6 | 0.02 mm | 45.3 MPa | 여유 6.1배

세 경우 모두 팔 길이가 같으니 젖히는 힘도 같고, 응력도 거의 같다. 갈리는 건 얼마나 안 휘느냐와 재료가 그 응력을 견디느냐다. 구형이 부러진 건 응력이 한계였던 것에 더해 2.16 mm 나 휘어서 조립부가 계속 벌어졌기 때문이고, 알루미늄이 답인 이유는 같은 응력을 6배 여유로 받기 때문이다.

CalculiX 선형 정적해석 · 800 N · 편심 55 mm · 3 mm C3D10 메쉬 · 반력 합 오차 1e-3 N
구조응력 = 강체 고정한 볼트 구멍 벽에서 3 mm 밖의 최댓값 (특이점 제외) · 볼트 프리로드와 접촉은 미포함
