chungddong/NUBI/hardware/vehicle/models/vehicle/v10_shell/shell_cut.md

# 외관판 재단 규격 (v10_shell)

| 판 | 재료 | 크기 (u × v) | 구멍 | 파일 |
|---|---|---|---|---|
| side_l | ACM 3t | 760 × 173.0 | Ø5.5 ×7, 루버 3 | `output/shell_side_l.dxf` |
| side_r | ACM 3t | 760 × 173.0 | Ø5.5 ×7, 루버 3 | `output/shell_side_r.dxf` |
| front | UV PC 3t | 456 × 173.0 | Ø5.5 ×5 | `output/shell_front.dxf` |
| rear | UV PC 3t | 456 × 173.0 | Ø5.5 ×5, 기타 5 | `output/shell_rear.dxf` |
| lid | ACM 3t | 766 × 456.0 | Ø5.5 ×0, 기타 9 | `output/shell_lid.dxf` |

- 고정: 프로파일 바깥 슬롯 M5 T 너트. 윗판은 기둥 중심 구멍 (Ø6.8) 에 M8 탭.
- 이음새: EPDM 개스킷 테이프. 쓰지 않는 T 슬롯은 커버로 막는다 (물길).
- PC 는 UV 코팅품, CNC 재단. ACM 은 실외용 (PE 코어면 충분).
- 펜더 4 · 범퍼 2 · 루버 덮개 2 는 ASA 출력 (PETG · PLA 는 햇볕에 변형).
