chungddong/NUBI/hardware/vehicle/models/vehicle/v11_shell_h/shell_cut.md

# 외관판 재단 규격 (v11_shell_h)

| 판 | 재료 | 크기 (u × v) | 구멍 | 파일 |
|---|---|---|---|---|
| side_l | ACM 3t | 760 × 203.0 | Ø5.5 ×11, 루버 3 | `output/shell_side_l.dxf` |
| side_r | ACM 3t | 760 × 203.0 | Ø5.5 ×11, 루버 3 | `output/shell_side_r.dxf` |
| front | UV PC 3t | 456 × 203.0 | Ø5.5 ×8 | `output/shell_front.dxf` |
| rear | UV PC 3t | 456 × 203.0 | Ø5.5 ×8, 기타 5 | `output/shell_rear.dxf` |

- 고정: 프로파일 바깥 슬롯 M5 T 너트. 위쪽 구멍 (z=281.85) 은 상부 프레임을 올린 뒤 쓴다.
- 윗판 없음 — 상부 프레임 위 상부판으로 (비상정지 · 안테나 구멍도 그쪽).
- 이음새: EPDM 개스킷 테이프. 쓰지 않는 T 슬롯은 커버로 막는다 (물길).
- PC 는 UV 코팅품, CNC 재단. ACM 은 실외용 (PE 코어면 충분).
- 펜더 4 · 범퍼 2 · 루버 덮개 2 는 ASA 출력 (PETG · PLA 는 햇볕에 변형).
