chungddong/NUBI/hardware/vehicle/models/vehicle/v25_top_cover/shell_cut.md

# 외관판 재단 규격 (v25_top_cover)

| 판 | 재료 | 크기 (u × v) | 구멍 | 파일 |
|---|---|---|---|---|
| side_l | ACM 3t | 760 × 203.0 | Ø5.5 ×11, 루버 3 | `output/shell_side_l.dxf` |
| side_r | ACM 3t | 760 × 203.0 | Ø5.5 ×11, 루버 3 | `output/shell_side_r.dxf` |
| front | UV PC 3t 불투명 | 456 × 203.0 | Ø5.5 ×5, 루버 1 | `output/shell_front.dxf` |
| rear | UV PC 3t 불투명 | 456 × 203.0 | Ø5.5 ×5, 기타 17, 루버 1, 사각 구멍 2 (카메라 창 · 포트 칸) | `output/shell_rear.dxf` |
| lid | ACM 3t (상부 덮개) | 766 × 456.0 | Ø5.5 ×10, 기타 6 | `output/shell_lid.dxf` |

- 고정: 프로파일 바깥 슬롯 M5 T 너트. 위쪽 구멍 (z=281.85) 은 상부 프레임을 올린 뒤 쓴다.
- 상부 덮개 (v25) — ACM 3t 766 × 456 R6, 손나사 M5 10 · 기둥 볼트 머리 구멍 Ø16 6. 라이다 · GPS 구멍은 부품을 정한 뒤.
- 방수 · 방진 등급은 기준에서 뺐다 (v18) — 개스킷 · 빗물막이 없음.
- PC 는 UV 코팅 **불투명** (흑색 · 회색), CNC 재단. ACM 은 실외용 (PE 코어면 충분). 반투명 · 투명은 쓰지 않는다.
- 범퍼 2 · 루버 덮개 2 는 ASA 출력 (PETG · PLA 는 햇볕에 변형). 펜더는 v12 에서 뺐다.
