chungddong/NUBI/hardware/vehicle/docs/images/67_frame_h_cross.png

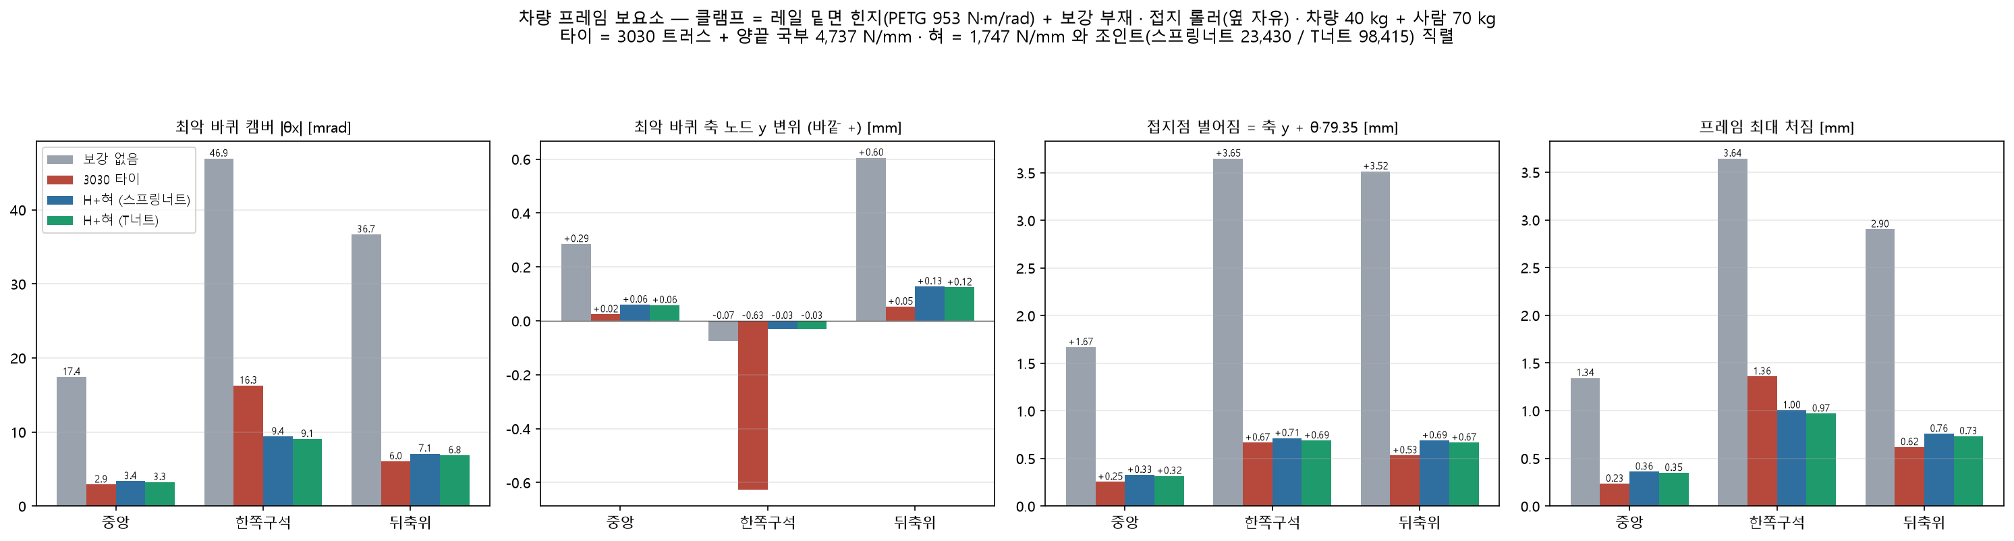
hardware/vehicle/docs/images/67_frame_h_cross.png
