chungddong/NUBI/hardware/vehicle/models/vehicle/v13_opaque/images/louver_hood.png

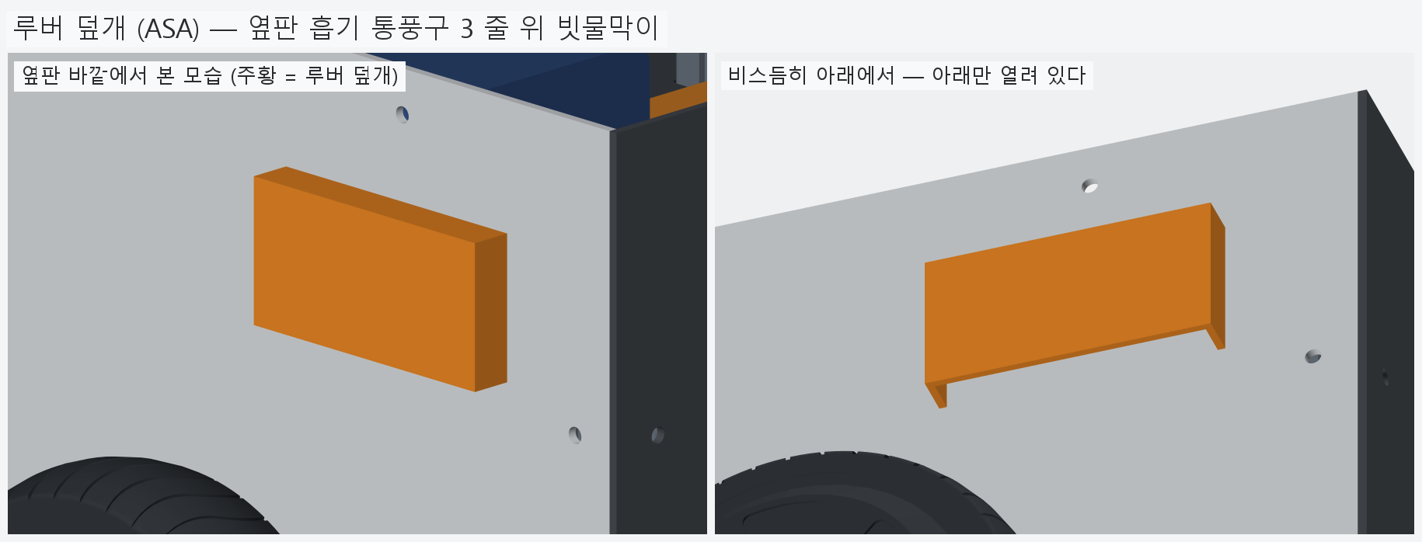
hardware/vehicle/models/vehicle/v13_opaque/images/louver_hood.png
