chungddong/NUBI/hardware/vehicle/models/vehicle/v14_rear_io/images/rear_panel.png

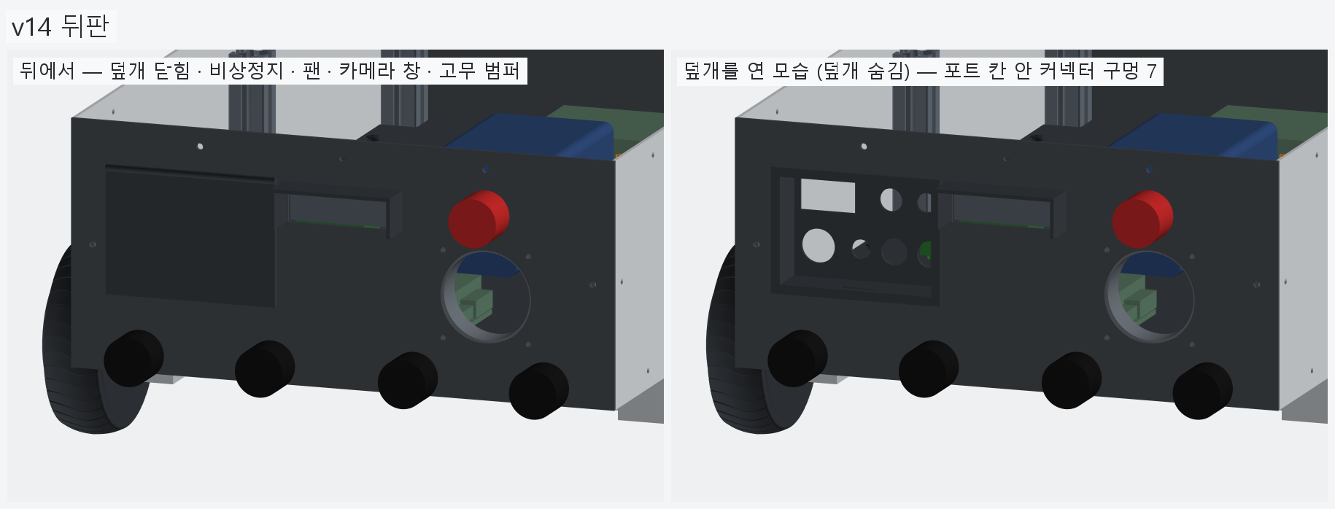
hardware/vehicle/models/vehicle/v14_rear_io/images/rear_panel.png
