chungddong/NUBI/hardware/vehicle/models/vehicle/v15_rear2/images/rear_panel.png

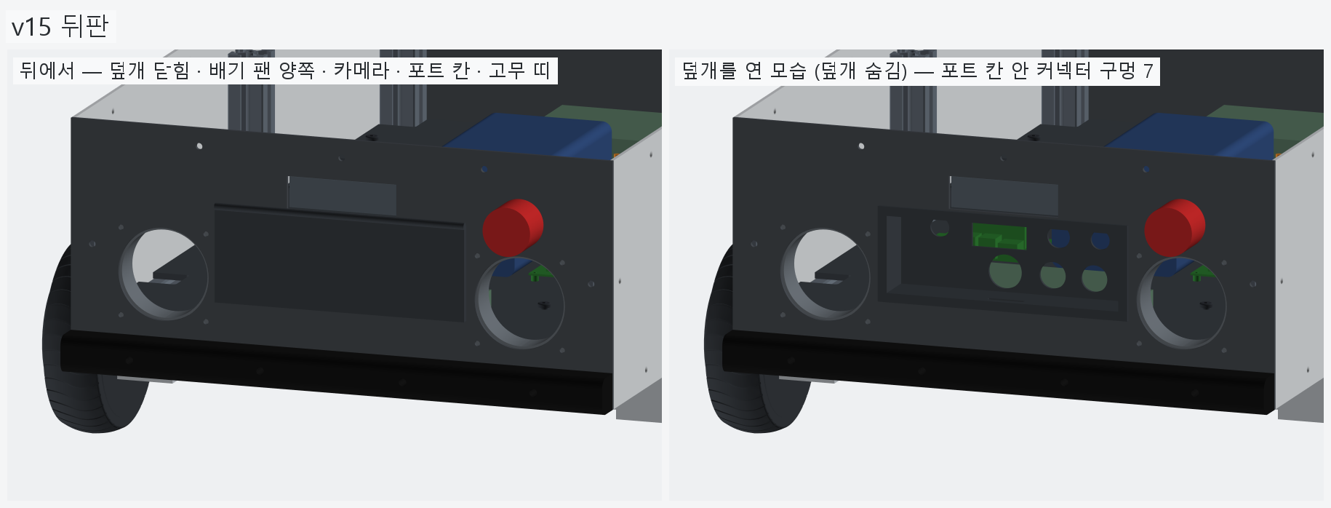
hardware/vehicle/models/vehicle/v15_rear2/images/rear_panel.png
