chungddong/NUBI/hardware/vehicle/models/vehicle/v16_camera/images/camera_mount.png

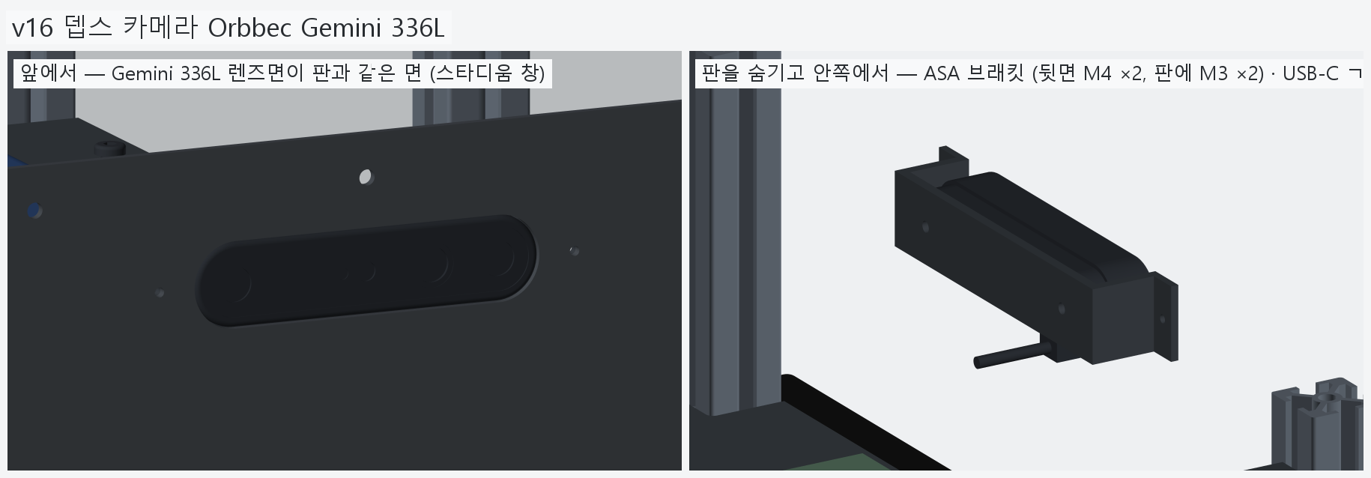
hardware/vehicle/models/vehicle/v16_camera/images/camera_mount.png
