chungddong/NUBI/hardware/vehicle/models/vehicle/v17_estop/images/estop_closeup.png

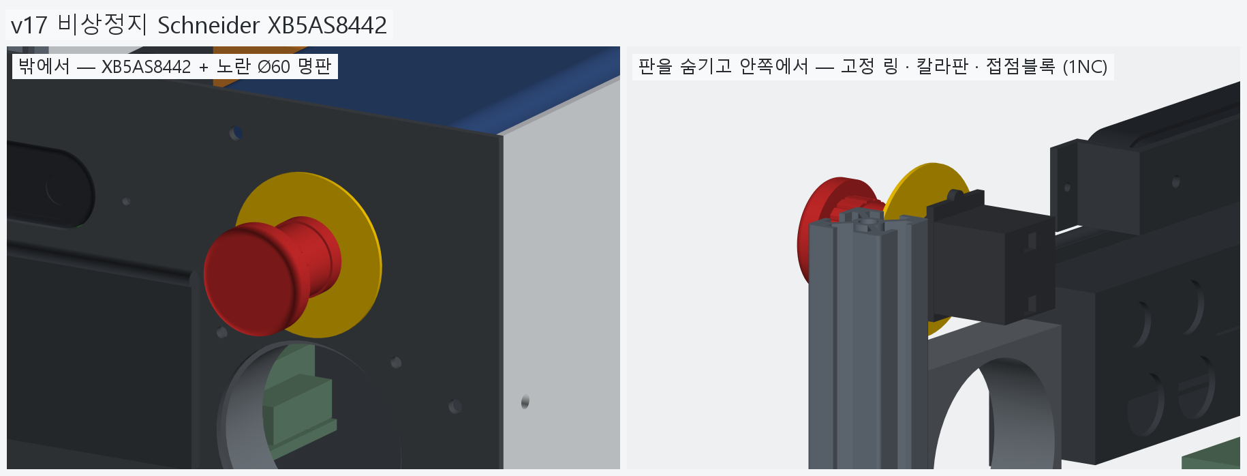
hardware/vehicle/models/vehicle/v17_estop/images/estop_closeup.png
