chungddong/NUBI/hardware/vehicle/models/vehicle/v18_simplify/images/estop_closeup.png

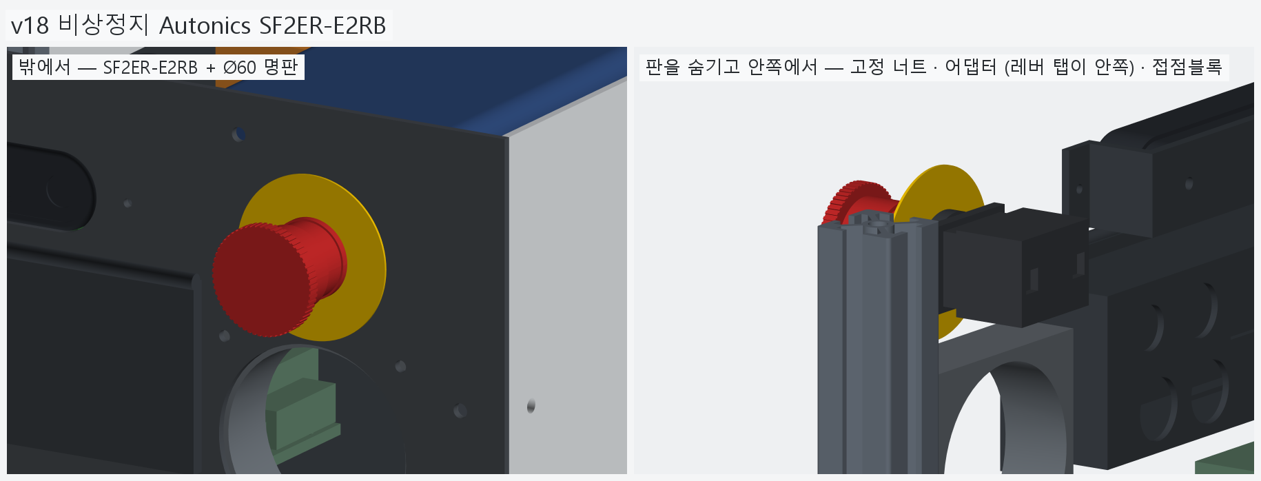
hardware/vehicle/models/vehicle/v18_simplify/images/estop_closeup.png
