chungddong/NUBI/hardware/vehicle/models/vehicle/v27_sensor_module/output/floor_plate.png

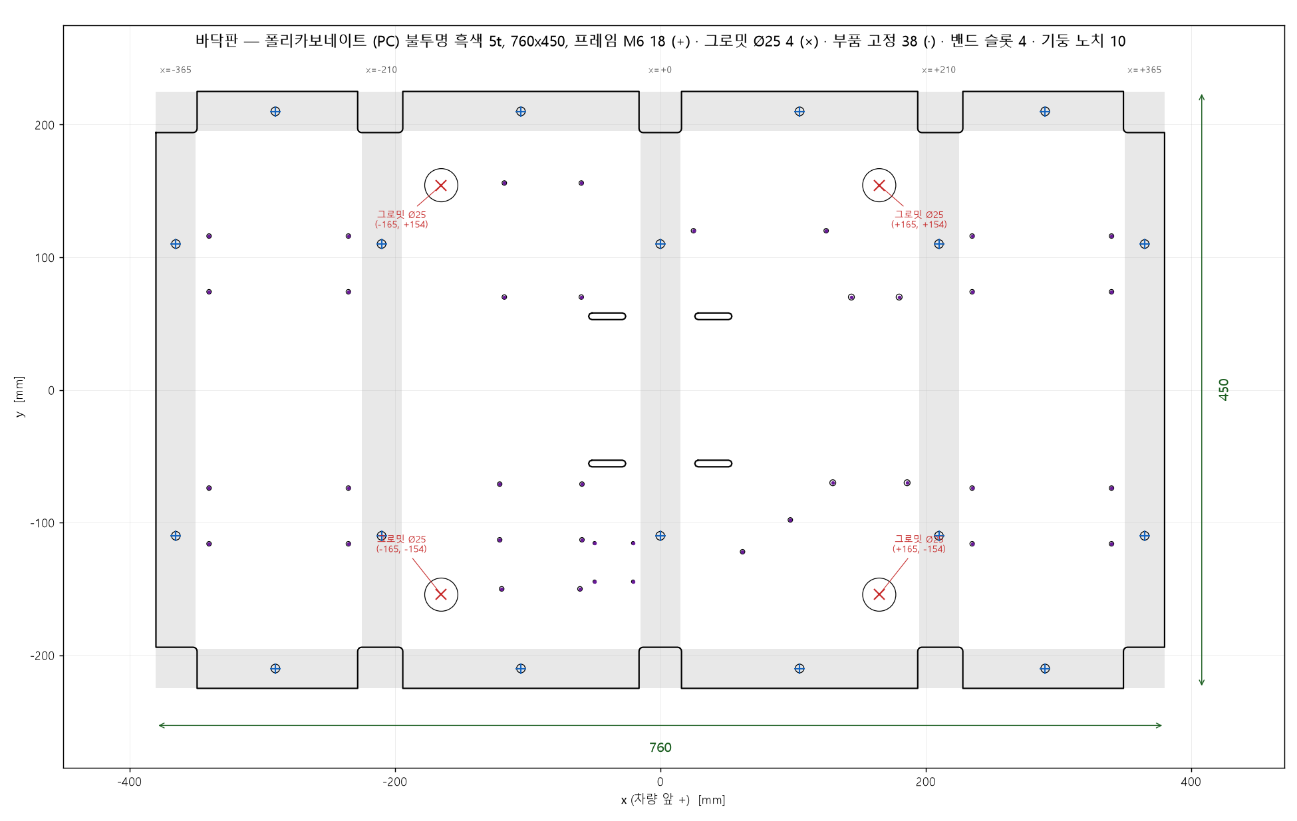
hardware/vehicle/models/vehicle/v27_sensor_module/output/floor_plate.png
