chungddong/NUBI/hardware/vehicle/docs/bom.md

# 차량 전체 버전 — BOM / 예상 견적

`tools/bom/bom.py` 가 **모델 형상에서 직접** 뽑는다. 형상을 고치고 다시 돌리면
수량·부피·질량이 따라온다. 손으로 고칠 곳은 스크립트 맨 위 `PRICE` 표뿐이다.

- 구성: `PAYLOAD=cargo` 전체 버전 (프레임 + Design-D 휠마운트 + 외장셸 + 적재함)
- 전장 873 x 전폭 612 x 전고 606 mm
- 뷰어: `.venv/Scripts/python.exe models/hoverboard_mount/vehicle_cargo_integration.py`

## 요약

| 구분 | 금액 |
|---|---:|
| 보유 | 471,840원 |
| 출력 | 563,256원 |
| 구매 | 941,382원 |
| **전부 신품으로 살 때 합계** | **1,976,478원** |
| **지금 추가로 드는 돈 (출력+구매)** | **1,504,638원** |

출력물 총 14,600 cm³ · 예상 출력 시간 약 **406 시간**
(0.4 노즐 / 0.2 층 / 유효 토출 10 mm³/s 기준). 프린터 1대로 붙어 있으면
2주가 넘는다 — **돈보다 이게 병목이다.**

출력 시간이 큰 것부터:

| 부품 | 부피 | 출력 시간 |
|---|---:|---:|
| 적재함 셸 | 5,179 cm³ | 144 h |
| 외장셸 | 2,178 cm³ | 60 h |
| 장비베이 지붕 | 2,157 cm³ | 60 h |
| 뚜껑 | 1,594 cm³ | 44 h |
| 바구니크래들 | 758 cm³ | 21 h |

| 카테고리 | 금액 |
|---|---:|
| 1. 프레임 | 99,280원 |
| 2. 판재 | 51,342원 |
| 3. 구동부 | 242,760원 |
| 4. 외장·차체 | 171,105원 |
| 5. 전자·제어 | 495,000원 |
| 6. 센서·표시 | 382,000원 |
| 7. 적재함 | 534,991원 |

## 베드에 안 들어가는 부품 — Ender-3 V3 SE (220x220x250)

돈보다 먼저 걸리는 제약이다. 이 부품들은 **쪼개서 뽑고 붙여야** 한다
(또는 판재 절곡·진공성형으로 공법을 바꾼다).

| 부품 | 치수 | 최소 분할 |
|---|---|---:|
| 외장셸 x2 | 510x404x254 | 12조각 |
| 배터리브라켓 | 266x162x94 | 2조각 |
| 범퍼 x2 | 360x38x29 | 2조각 |
| 적재함 셸 | 810x510x269 | 24조각 |
| 장비베이 지붕 | 810x510x40 | 12조각 |
| 뚜껑 | 529x349x58 | 6조각 |
| 슬라이드채널 x3 | 300x32x19 | 2조각 |
| 장비마운트 | 480x217x3 | 2조각 |
| 장비마운트 | 496x269x3 | 4조각 |
| 바구니크래들 | 432x332x48 | 4조각 |

## 대안 — 큰 셸을 판재로 바꾸면

셸 4가지가 출력 시간의 대부분을 먹고, 그러면서 베드에 하나도 안 들어간다.
같은 부피를 벽 두께로 나눠 전개 면적을 내고 3mm 판재로 환산했다.
(굽힘·용접·리벳 공수와 치공구는 안 넣었다 — 면적 값만이다.)

| 부품 | 벽 | 전개 면적 | 출력 | 판재 | 출력 시간 |
|---|---:|---:|---:|---:|---:|
| 외장셸 | 3mm | 0.73 m² | 82,963원 | 34,840원 | 60 h |
| 적재함 셸 | 5mm | 1.04 m² | 197,316원 | 49,717원 | 144 h |
| 장비베이 지붕 | 5mm | 0.43 m² | 82,199원 | 20,712원 | 60 h |
| 뚜껑 | 3mm | 0.53 m² | 60,715원 | 25,497원 | 44 h |
| **합계** | | | **423,193원** | **130,766원** | **309 h** |

판재로 가면 부품값 292,427원과 출력 309시간이
빠진다 (전체 출력 시간의 76%). 추가 지출은
1,504,638 → 1,212,211원.
**대신 굽힘·재단 공수와 이음 철물이 붙는다.** 판재 값만 비교한 수치다.

## 상세

| 카테고리 | 품목 | 규격 | 수량 | 조달 | 단가 | 금액 | 근거 |
|---|---|---|---:|:-:|---:|---:|---|
| 1. 프레임 | 알루미늄 프로파일 | 30x30 L760 | 4본 | 보유 | 7,600 | 30,400 | 32단위(100mm 올림) · 버림 160mm · 상부사이드, 하부사이드 [확인] |
| 1. 프레임 | 알루미늄 프로파일 | 30x30 L390 | 8본 | 보유 | 3,800 | 30,400 | 32단위(100mm 올림) · 버림 80mm · 상부크로스, 축크로스, 하부크로스 [확인] |
| 1. 프레임 | 알루미늄 프로파일 | 30x30 L143 | 6본 | 보유 | 1,900 | 11,400 | 12단위(100mm 올림) · 버림 342mm · 기둥 [확인] |
| 1. 프레임 | 다이캐스팅 코너브라켓 | 3025 | 28개 | 보유 | 360 | 10,080 | joints() 자동 검출 28곳 [확인] |
| 1. 프레임 | 둥근머리 렌치볼트 | M6x15 | 68개 | 보유 | 70 | 4,760 | 브라켓 56 + 셸 플랜지 12 [확인] |
| 1. 프레임 | 스프링너트 | 306 (M6) | 68개 | 보유 | 180 | 12,240 | 슬롯에 들어가는 수량 = 볼트와 1:1 [확인] |
| 2. 판재 | 판재 | PC/ABS 3t, 0.67 m² | 2장 | 구매 | 16,157 | 32,314 | 형상 2020 cm³ / 3mm = 0.67 m² [추정] |
| 2. 판재 | 적재함판재 | PC/ABS 3t, 0.40 m² | 1장 | 구매 | 19,028 | 19,028 | 형상 1189 cm³ / 3mm = 0.40 m² [추정] |
| 3. 구동부 | 호버보드 인휠 허브모터 | 6.5" Ø159 | 4개 | 보유 | 55,000 | 220,000 | 스키드 4륜 [추정] |
| 3. 구동부 | 기존 호버보드 상부 클램프 | 42.72x39.22x12.57 실측 | 4개 | 보유 | 0 | 0 | 모터에 달려 나온 것을 재사용한다 |
| 3. 구동부 | Design-D 하부 클램프 | PLA 출력 116 cm³ (100% 인필) | 4개 | 출력 | 3,604 | 14,416 | 116.3 cm³ → 144 g → 출력 3.2 h/개 [추정] |
| 3. 구동부 | 하부 클램프 레일 체결볼트 | M6x15 | 8개 | 보유 | 70 | 560 | 코너당 2개(밑면) x 4 [실측 길이] [확인] |
| 3. 구동부 | 하부 클램프 슬롯너트 | 스프링너트 306 (M6) | 8개 | 보유 | 180 | 1,440 | 볼트와 1:1 [확인] |
| 3. 구동부 | 액슬 타이 프로파일 | 3030 L360 | 2본 | 보유 | 0 | 0 | 남는 390mm 재활용 (390 → 360 절단) |
| 3. 구동부 | 타이 코너 브래킷 | PLA 출력 6.2 cm³, L자 6t | 8개 | 출력 | 193 | 1,544 | 축당 4개 x 2축 · 8 g/개 [추정] |
| 3. 구동부 | 타이 브래킷 볼트 (클램프 탭) | M6x20 | 16개 | 구매 | 90 | 1,440 | 브래킷 8 x 탭 2단 [추정] |
| 3. 구동부 | 타이 브래킷 볼트 (슬롯) | M6x15 | 8개 | 보유 | 70 | 560 | 브래킷당 1 [확인] |
| 3. 구동부 | 타이 브래킷 슬롯너트 | 드롭인 T너트 (M6) | 8개 | 구매 | 350 | 2,800 | 인발 2271 N 급 — 스프링너트(933 N)보다 여유 [추정] |
| 4. 외장·차체 | 외장셸 | PETG 출력 3t 벽 | 2개 | 출력 | 41,481 | 82,962 | 형상 2178 cm³ → 2765 g → 출력 60.5 h [추정] |
| 4. 외장·차체 | 카메라브라켓 | PETG 출력, 172 cm³ | 1개 | 출력 | 6,565 | 6,565 | 형상 172 cm³ → 219 g → 출력 4.8 h [추정] |
| 4. 외장·차체 | 배터리브라켓 | PETG 출력, 174 cm³ | 1개 | 출력 | 6,624 | 6,624 | 형상 174 cm³ → 221 g → 출력 4.8 h [추정] |
| 4. 외장·차체 | 범퍼 | TPU 출력 360x38 | 2개 | 출력 | 17,730 | 35,460 | 형상 651 cm³ → 788 g → 출력 18.1 h [추정] |
| 4. 외장·차체 | 핸들 | PETG 출력 (베이스판 + 팔) | 2개 | 출력 | 5,347 | 10,694 | 형상 281 cm³ → 356 g → 출력 7.8 h [추정] |
| 4. 외장·차체 | 핸들 그립봉 | Ø18 알루미늄 봉 | 2개 | 구매 | 6,000 | 12,000 | 봉만 사서 낀다 [추정] |
| 4. 외장·차체 | 데크 모듈 레일 | 20x20 L785 | 3본 | 구매 | 5,600 | 16,800 | 24단위(100mm 올림) · 버림 45mm · 데크레일 [추정] |
| 5. 전자·제어 | 라즈베리파이 5 | 8GB | 1개 | 구매 | 130,000 | 130,000 | 메인 컴퓨터 [추정] |
| 5. 전자·제어 | 인휠 BLDC 드라이버 | 홀센서 2채널 | 2개 | 구매 | 45,000 | 90,000 | 모터 4개를 2ch x 2 로 [추정] |
| 5. 전자·제어 | 배터리 | 36V 200x150x90 리튬팩 | 1개 | 보유 | 150,000 | 150,000 | 호버보드 팩 재사용 [추정] |
| 5. 전자·제어 | 주회로 차단기 | DC 63A | 1개 | 구매 | 18,000 | 18,000 | power_box() [추정] |
| 5. 전자·제어 | 퓨즈 · 프리차지 보드 | - | 1개 | 구매 | 35,000 | 35,000 | power_box() [추정] |
| 5. 전자·제어 | 비상정지 스위치 | Ø22 푸시록 | 1개 | 구매 | 12,000 | 12,000 | 뒷면 z=246 [추정] |
| 5. 전자·제어 | 배선 · 커넥터 일체 | 전원 + 모터 + 신호 | 1식 | 구매 | 60,000 | 60,000 | 포트베이 커넥터 7종 포함 [추정] |
| 6. 센서·표시 | RGBD 카메라 | Xtion 급 180x42 | 1개 | 구매 | 180,000 | 180,000 | 전면 z=231 [추정] |
| 6. 센서·표시 | 소형 카메라 | USB 광각 | 6개 | 구매 | 15,000 | 90,000 | 후방1, 후방2, 전방1, 전방2, 좌측, 우측 [추정] |
| 6. 센서·표시 | 전면 LED바 | 384mm | 1개 | 구매 | 25,000 | 25,000 | 주행등 [추정] |
| 6. 센서·표시 | 후미등 | 100x14 | 2개 | 구매 | 12,000 | 24,000 | 뒷면 z=276 [추정] |
| 6. 센서·표시 | 범퍼 리미트 스위치 | - | 4개 | 구매 | 3,000 | 12,000 | 앞뒤 각 2 [추정] |
| 6. 센서·표시 | 배기팬 | 60mm DC | 2개 | 구매 | 8,000 | 16,000 | cooling_cuts() [추정] |
| 6. 센서·표시 | 부저 | Ø30 | 1개 | 구매 | 5,000 | 5,000 | 후진음 [추정] |
| 6. 센서·표시 | 안테나 | WiFi/LTE 휩 | 2개 | 구매 | 15,000 | 30,000 | 뒷면 상부 코너 [추정] |
| 7. 적재함 | 적재함 셸 | PETG 출력 5t 벽 | 1개 | 출력 | 197,316 | 197,316 | 형상 5179 cm³ → 6577 g → 출력 143.9 h [추정] |
| 7. 적재함 | 장비베이 지붕 | PETG 출력, 2157 cm³ | 1개 | 출력 | 82,199 | 82,199 | 형상 2157 cm³ → 2740 g → 출력 59.9 h [추정] |
| 7. 적재함 | 뚜껑 | PETG 출력, 1594 cm³ | 1개 | 출력 | 60,715 | 60,715 | 형상 1594 cm³ → 2024 g → 출력 44.3 h [추정] |
| 7. 적재함 | 슬라이드채널 | PETG 출력, 195 cm³ | 3개 | 출력 | 2,476 | 7,428 | 형상 195 cm³ → 248 g → 출력 5.4 h [추정] |
| 7. 적재함 | 장비마운트 | PETG 출력, 708 cm³ | 2개 | 출력 | 13,495 | 26,990 | 형상 708 cm³ → 900 g → 출력 19.7 h [추정] |
| 7. 적재함 | 바구니크래들 | PETG 출력, 758 cm³ | 1개 | 출력 | 28,867 | 28,867 | 형상 758 cm³ → 962 g → 출력 21.0 h [추정] |
| 7. 적재함 | 리테이너 | PETG 출력, 23 cm³ | 3개 | 출력 | 292 | 876 | 형상 23 cm³ → 29 g → 출력 0.6 h [추정] |
| 7. 적재함 | 잠금 스트라이커 | PETG 출력 15.7 cm³ | 2개 | 출력 | 300 | 600 | 20 g [추정] |
| 7. 적재함 | 가스 스트럿 | 뚜껑 지지 | 2개 | 구매 | 18,000 | 36,000 | 뚜껑 자중 보상 [추정] |
| 7. 적재함 | 솔레노이드 잠금 | 12V | 2개 | 구매 | 22,000 | 44,000 | 원격 개폐 [추정] |
| 7. 적재함 | 힌지 | 내부 힌지 | 2개 | 구매 | 8,000 | 16,000 | 뚜껑 [추정] |
| 7. 적재함 | 타이다운 D링 | Ø30 | 4개 | 구매 | 4,000 | 16,000 | 바구니 결박 [추정] |
| 7. 적재함 | 유로 컨테이너 | KLT 400x300x220 (26 L) | 1개 | 구매 | 18,000 | 18,000 | 규격품 [추정] |

## 가정 — 여기가 틀리면 견적이 틀린다

1. **단가는 `확인` 태그만 실주문 값이다.** 3030 프로파일 950원/100mm,
   다이캐스팅 브라켓 3025 360원, M6x15 70원, 스프링너트 306 180원.
   나머지는 전부 시장가 눈대중이라 실제 견적과 배는 차이날 수 있다.
2. **보유 판정**은 지금까지의 실물 상태를 따랐다 — 프레임 프로파일·철물,
   허브모터 4개, 기존 상부 클램프 4개, M6x15 볼트, 스프링너트, 남는 390mm
   3030 프로파일, 배터리팩. 새로 만드는 거면 '전부 신품' 합계를 봐라.
3. **출력 부품 값은 필라멘트 값뿐이다.** 실패분·서포트·전기·프린터 감가는
   안 넣었다. 실무로는 여기에 30~50% 를 더 얹는다.
4. **판재 두께·재질은 가정이다** (PC/ABS 3mm). 면적은 형상에서 나왔지만
   실제로는 1220x2440 장으로 사서 자르니 남는 값을 더 내게 된다.
5. **외장셸·적재함을 출력으로 잡았다.** 합쳐 11 L 가 넘어서 여기가 전체
   출력 시간의 대부분이다. 진공성형이나 ABS 판재 절곡으로 가면 시간이
   급감하는 대신 금형·치공구가 붙는다.
6. **범퍼를 TPU 로 잡았다.** 고무 범퍼 스트립을 사서 붙이는 게 더 쌀 수 있다.
7. **베드 초과 부품은 분할 비용을 안 넣었다.** 조각을 붙일 다월·접착·보강판이
   추가로 들고, 이음선이 곧 약한 면이 된다.
8. **인건비·배송비·부가세 없음.** 부품값만이다.

## 다시 만드는 법

```
.venv/Scripts/python.exe tools/bom/bom.py
```
