chungddong/NUBI/hardware/vehicle/models/vehicle/v18_simplify/bom.md

# BOM — v18_simplify

수량 · 길이 · 판 크기 · 볼트 개수는 이 버전 형상에서 뽑았다. 가격은 조사로 확인한 것만 적었다.

- 확인된 금액 합: **1,786,103 원** (단가가 있는 줄만)
- 단가 미확인 31 줄 — 견적 · 확인 필요

| 구분 | 품목 | 규격 | 수량 | 단가 | 금액 | 구매처 | 비고 |
|---|---|---|---:|---:|---:|---|---|
| 프레임 | 알루미늄 프로파일 3030 | L760 | 2 | 7,600 | 15,200 |  | 100 mm 단위 올림 과금 (800) · 하부사이드 |
| 프레임 | 알루미늄 프로파일 3030 | L390 | 5 | 3,800 | 19,000 |  | 100 mm 단위 올림 과금 (400) · 축크로스, 하부크로스 |
| 프레임 | 알루미늄 프로파일 3030 | L143 | 6 | 1,900 | 11,400 |  | 100 mm 단위 올림 과금 (200) · 기둥 |
| 판재 | 바닥판 폴리카보네이트 (PC) 불투명 흑색 | 760 × 450 × 5t | 1 | 확인 필요 |  | [링크](https://www.acrylmall.com/src/products/products_list.php?product_category_id=5512) | CNC 재단 · 구멍 — output/floor_plate.dxf |
| 판재 | 외관판 side_l | ACM 3t 760 × 203 | 1 | 확인 필요 |  |  | output/shell_side_l.dxf |
| 판재 | 외관판 side_r | ACM 3t 760 × 203 | 1 | 확인 필요 |  |  | output/shell_side_r.dxf |
| 판재 | 외관판 front | UV PC 3t 불투명 456 × 203 | 1 | 확인 필요 |  |  | output/shell_front.dxf |
| 판재 | 외관판 rear | UV PC 3t 불투명 456 × 203 | 1 | 확인 필요 |  |  | output/shell_rear.dxf |
| 출력 | 포트칸_트레이_ASA | ASA 73 cm³ · 78 g · 약 2.0 h | 1 | 2,337 | 2,337 |  | 부피 꽉 채움 기준 상한 — 실제 인필이면 더 적다 |
| 출력 | 포트칸_덮개_ASA | ASA 48 cm³ · 52 g · 약 1.3 h | 1 | 1,548 | 1,548 |  | 부피 꽉 채움 기준 상한 — 실제 인필이면 더 적다 |
| 출력 | 카메라브래킷_뒤_ASA | ASA 24 cm³ · 25 g · 약 0.7 h | 1 | 759 | 759 |  | 부피 꽉 채움 기준 상한 — 실제 인필이면 더 적다 |
| 출력 | 카메라브래킷_앞_ASA | ASA 24 cm³ · 25 g · 약 0.7 h | 1 | 759 | 759 |  | 부피 꽉 채움 기준 상한 — 실제 인필이면 더 적다 |
| 체결 | 둥근머리 렌치볼트 | M6x15 | 16 | 확인 필요 |  |  | T 클램프 → 레일 · 축크로스 (스프링너트) |
| 체결 | 둥근머리 렌치볼트 + 와셔 | M6x15 | 18 | 확인 필요 |  |  | 바닥판 → 프레임 (스프링너트) |
| 체결 | 스프링너트 3030 | M6 | 42 | 확인 필요 |  |  |  |
| 체결 | 외관판 볼트 + T 너트 | M5 | 32 | 확인 필요 |  |  | 옆 · 앞 · 뒤판 → 프로파일 바깥 슬롯 (위쪽은 상부 프레임 뒤) |
| 체결 | 고무 범퍼 볼트 | M6 (길이는 고무 두께 + 판 + 슬롯) | 8 | 확인 필요 |  |  |  |
| 체결 | 부품 고정 볼트 · 너트 (+ 스탠드오프) | M2.5 | 4 | 확인 필요 |  |  | 바닥판 부품 고정 구멍에서 셈 |
| 체결 | 부품 고정 볼트 · 너트 (+ 스탠드오프) | M3 | 10 | 확인 필요 |  |  | 바닥판 부품 고정 구멍에서 셈 |
| 체결 | 부품 고정 볼트 · 너트 (+ 스탠드오프) | M4 | 10 | 확인 필요 |  |  | 바닥판 부품 고정 구멍에서 셈 |
| 체결 | 부품 고정 볼트 · 너트 (+ 스탠드오프) | M5 | 4 | 확인 필요 |  |  | 바닥판 부품 고정 구멍에서 셈 |
| 전원 | 배터리 | 볼트온 36V 20Ah (LG 셀, BMS, KC) | 1 | 480,000 | 480,000 | [링크](https://www.voltonbattery.com/pedelec_36v/?idx=88) | 가격은 검색 시점 판매가 — 주문 전 확인 |
| 전원 | 충전기 | 42V 2A 10S 리튬이온 | 1 | 확인 필요 |  | [링크](https://www.aliexpress.us/item/3256806176154920.html) | 배터리 판매처 전용 충전기 권장 |
| 구동 | 모터 드라이버 | ZLTECH ZLAC8015D (2 채널, 24–48V, RS485/CAN) | 2 | 확인 필요 |  | [링크](https://smotion.co.kr/product/zltech-zlac8015d-canopenrs-485-%EC%A0%9C%EC%96%B4%EC%9A%A9-2%EC%B6%95-wheel-in-motor%EC%9D%B8%ED%9C%A0%EB%AA%A8%ED%84%B0%EC%9A%A9-%EB%9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) | 국내 에스모션 (가격 문의). 해외 Alibaba 1–49 개 USD 95–115 |
| 전원 | 메인 퓨즈 + 홀더 | Victron MIDI 40A/58V + MIDI 홀더 CIP000050001 | 1 | 확인 필요 |  | [링크](https://www.amazon.com/Victron-Energy-MIDI-Fuse-Products/dp/B0DK7S19CX) | 58V 정격 — 자동차용 32V 퓨즈는 안 된다 |
| 전원 | 모터 전원 차단 SSR | Fotek SSR-40DD (출력 5–60VDC 40A) | 1 | 확인 필요 |  | [링크](https://www.fotek.com.tw/en-gb/product-category/144) | 비상정지 · 키 스위치가 끊는 자리 |
| 전원 | DC-DC 19V | 30–60V → 19V 5A 이상 (Fidida 등) | 1 | 확인 필요 |  | [링크](https://www.amazon.com/Fidida-Converter-30V-60V-Step-Down-Waterproof/dp/B0CDH538MG) | 입력 상한 42V 이상 확인 |
| 전원 | DC-DC 5V | 11–90V → 5V 6A (DROK 200656) | 1 | 확인 필요 |  | [링크](https://www.droking.com/) | 입력 60V 이상 |
| 제어 | 메인 컴퓨터 | NVIDIA Jetson Orin Nano (Super) 개발킷 | 1 | 확인 필요 |  | [링크](https://developer.nvidia.com/embedded/learn/get-started-jetson-orin-nano-devkit) | 가격 확인 필요 |
| 제어 | MCU | ESP32-DevKitC V4 + 만능기판 받침 | 1 | 확인 필요 |  | [링크](https://docs.espressif.com/projects/esp-dev-kits/en/latest/esp32/esp32-devkitc/user_guide.html) |  |
| 센서 | IMU | Adafruit BNO085 #4754 | 1 | 확인 필요 |  | [링크](https://www.adafruit.com/product/4754) | 국내 디바이스마트에도 있음 (접속 불가 상태) |
| 안전 | 비상정지 버튼 | Autonics SF2ER-E2RB (D40 짧은 헤드, 1NC, 누르면 잠김 · 시계방향 회전 해제) | 1 | 23,100 | 23,100 | [링크](https://www.eleparts.co.kr/goods/view?no=13038016) | 엘레파츠 VAT 포함 (VAT 별도 21,000), 국내 정품 · 재고 시 2~3 일 |
| 안전 | 비상정지 명판 | Autonics SF2ER-B3 (Ø60, 두께 1, STOP) | 1 | 확인 필요 |  |  | 가격 확인 필요 |
| 배선 | 고무 그로밋 | 구멍 Ø25 · 판 5 t · 케이블 Ø10 | 4 | 확인 필요 |  |  | 바닥판 케이블 구멍 |
| 배선 | 충전 · 전원 커넥터 | Amass XT60H 암수 | 2 | 확인 필요 |  | [링크](https://www.devicemart.co.kr/goods/view?no=1078005) |  |
| 외관 | 고무 범퍼 띠 | D 형 고무 범퍼 / 고무 몰딩, 높이 30 × 두께 25 | 0.91 | 확인 필요 |  |  | 앞 · 뒤 판 폭대로 잘라 쓴다 |
| 외관 | 배기 팬 | 80 mm DC 팬 (필터 · 빗물막이 포함 권장) | 2 | 확인 필요 |  |  |  |
| 센서 | 뎁스 카메라 | Orbbec Gemini 336L (IP65, USB-C, 기준선 95, 0.25–6 m 최적) | 2 | 616,000 | 1,232,000 | [링크](https://www.icbanq.com/P016230045) | 아이씨뱅큐 VAT 포함 (VAT 별도 560,000). 335L 은 605,000 — https://www.icbanq.com/P016230042 |
| 센서 | USB-C 케이블 ㄱ자 (M2 나사 잠금 권장) | USB 3 Type-C ↔ Type-A, 1 m 안팎 | 2 | 확인 필요 |  |  | 카메라 바닥 USB-C — ㄱ자로 안쪽으로 꺾어 포트 칸 위를 지난다. 젯슨 USB 3 포트 묶음을 나눠 꽂는다 |
| 체결 | 카메라 고정 볼트 | M4 × 8 (뒷면 최대 삽입 4, 0.4 N·m) | 4 | 확인 필요 |  |  | 브래킷 4 t 통과 |
| 체결 | 브래킷 → 판 볼트 + 열압입 인서트 | M3 | 4 | 확인 필요 |  |  | 판 M3 구멍 Ø3.4 |
