chungddong/NUBI/hardware/vehicle/models/vehicle/v20_power/bom.md

# BOM — v20_power

수량 · 길이 · 판 크기 · 볼트 개수는 이 버전 형상에서 뽑았다. 가격은 조사로 확인한 것만 적었다.

- 확인된 금액 합: **2,070,401 원** (단가가 있는 줄만)
- 단가 미확인 27 줄 — 견적 · 확인 필요

| 구분 | 품목 | 규격 | 수량 | 단가 | 금액 | 구매처 | 비고 |
|---|---|---|---:|---:|---:|---|---|
| 프레임 | 알루미늄 프로파일 3030 | L760 | 2 | 7,600 | 15,200 |  | 100 mm 단위 올림 과금 (800) · 하부사이드 |
| 프레임 | 알루미늄 프로파일 3030 | L390 | 5 | 3,800 | 19,000 |  | 100 mm 단위 올림 과금 (400) · 축크로스, 하부크로스 |
| 프레임 | 알루미늄 프로파일 3030 | L143 | 6 | 1,900 | 11,400 |  | 100 mm 단위 올림 과금 (200) · 기둥 |
| 판재 | 바닥판 폴리카보네이트 (PC) 불투명 흑색 | 760 × 450 × 5t | 1 | 확인 필요 |  | [링크](https://www.acrylmall.com/src/products/products_list.php?product_category_id=5512) | CNC 재단 · 구멍 — output/floor_plate.dxf |
| 판재 | 외관판 side_l | ACM 3t 760 × 203 | 1 | 확인 필요 |  |  | output/shell_side_l.dxf |
| 판재 | 외관판 side_r | ACM 3t 760 × 203 | 1 | 확인 필요 |  |  | output/shell_side_r.dxf |
| 판재 | 외관판 front | UV PC 3t 불투명 456 × 203 | 1 | 확인 필요 |  |  | output/shell_front.dxf |
| 판재 | 외관판 rear | UV PC 3t 불투명 456 × 203 | 1 | 확인 필요 |  |  | output/shell_rear.dxf |
| 출력 | 포트칸_트레이_ASA | ASA 73 cm³ · 78 g · 약 2.0 h | 1 | 2,337 | 2,337 |  | 부피 꽉 채움 기준 상한 — 실제 인필이면 더 적다 |
| 출력 | 포트칸_덮개_ASA | ASA 48 cm³ · 52 g · 약 1.3 h | 1 | 1,548 | 1,548 |  | 부피 꽉 채움 기준 상한 — 실제 인필이면 더 적다 |
| 출력 | 카메라브래킷_뒤_ASA | ASA 14 cm³ · 15 g · 약 0.4 h | 1 | 457 | 457 |  | 부피 꽉 채움 기준 상한 — 실제 인필이면 더 적다 |
| 출력 | 카메라브래킷_앞_ASA | ASA 14 cm³ · 15 g · 약 0.4 h | 1 | 457 | 457 |  | 부피 꽉 채움 기준 상한 — 실제 인필이면 더 적다 |
| 체결 | 둥근머리 렌치볼트 | M6x15 | 16 | 확인 필요 |  |  | T 클램프 → 레일 · 축크로스 (스프링너트) |
| 체결 | 둥근머리 렌치볼트 + 와셔 | M6x15 | 18 | 확인 필요 |  |  | 바닥판 → 프레임 (스프링너트) |
| 체결 | 스프링너트 3030 | M6 | 42 | 확인 필요 |  |  |  |
| 체결 | 외관판 볼트 + T 너트 | M5 | 32 | 확인 필요 |  |  | 옆 · 앞 · 뒤판 → 프로파일 바깥 슬롯 (위쪽은 상부 프레임 뒤) |
| 체결 | 고무 범퍼 볼트 | M6 (길이는 고무 두께 + 판 + 슬롯) | 8 | 확인 필요 |  |  |  |
| 체결 | 부품 고정 볼트 · 너트 (+ 스탠드오프) | M2 | 4 | 확인 필요 |  |  | 바닥판 부품 고정 구멍에서 셈 |
| 체결 | 부품 고정 볼트 · 너트 (+ 스탠드오프) | M3 | 12 | 확인 필요 |  |  | 바닥판 부품 고정 구멍에서 셈 |
| 체결 | 부품 고정 볼트 · 너트 (+ 스탠드오프) | M4 | 4 | 확인 필요 |  |  | 바닥판 부품 고정 구멍에서 셈 |
| 체결 | 부품 고정 볼트 · 너트 (+ 스탠드오프) | M5 | 8 | 확인 필요 |  |  | 바닥판 부품 고정 구멍에서 셈 |
| 구동 | 호버보드 (6.5" 허브모터 2 + 1 세대 메인보드 1) | 바퀴 모터 4 · 모터 드라이버 2 로 쓴다 | 2 | 보유 |  |  | 보유품. 메인보드 칩이 STM32F103RCT6 / GD32F103RCT6 인지 확인 (EFeru 펌웨어) |
| 구동 | 보드 방열판 | 알루미늄 3t 175 × 100, 네 귀 M5 · 보드 탭 M4 탭 | 2 | 확인 필요 |  |  | PC 바닥판은 단열재 — 보드 판이 B+ · B- · 상선과 절연인지 멀티미터로 확인 후 고정 |
| 구동 | 보드 전원 버튼 릴레이 (또는 포토커플러) | 3.3 V 구동 소형 릴레이 모듈 | 2 | 확인 필요 |  |  | ESP32 가 보드 전원 버튼을 누른다 (두 보드 켜기 · 끄기 동기) |
| 구동 | ST-Link V2 (펌웨어 굽기) | STM32 SWD 프로그래머 | 1 | 확인 필요 |  |  | EFeru 펌웨어 굽기 1 회 |
| 전원 | 배터리 | 알엠파워 ZENION 삼성 21700 36V 20Ah 10S4P 직사형 + XT-90 (최대 방전 30 A, 최대 충전 10 A, KC) | 1 | 553,000 | 553,000 | [링크](https://rmpower.co.kr/shop_view/?idx=514) | 548,000 + XT-90 옵션 5,000. 95 × 245 × 75, 3 kg. '최대 30 A' 가 연속인지 판매처 확인 (D-04) |
| 전원 | 충전기 | 알엠파워 10S 42V 2A (XT60 단자) | 1 | 46,000 | 46,000 | [링크](https://rmpower.co.kr/1102/?idx=104) | DC 단자형 36,000. 포트 칸 GX16 충전 단자로 배선 |
| 전원 | 메인 차단기 | DC 차단기 1P 250VDC 40A (BA49-63 DC, C40) + DIN 레일 100 | 1 | 7,350 | 7,350 | [링크](https://mega-tec.co.kr/product/detail.html?product_no=504&cate_no=169&display_group=1) | 7,000 + 레일 350. 극성 확인 (DC MCB 는 극성 지정형이 많다) |
| 전원 | 비상정지 컨택터 | LS일렉트릭 GPR-M040 DC12V (40 A · 1000 VDC, 코일 12 V 3.5 W) | 1 | 41,870 | 41,870 | [링크](https://e-punglim.co.kr/product/detail.html?product_no=16656) | 주문품 4~6 주. 주접점 극성 — + 단자를 배터리 쪽. 급하면 TE EV200AAANA 170,500 (파워크래프트) |
| 전원 | 컨택터 코일 커넥터 | GPR-40ST (Tyco 1379658-1 하우징) | 10 | 2,510 | 25,100 | [링크](https://e-punglim.co.kr/product/detail.html?product_no=20822) | 최소 10 개 단위 |
| 전원 | 코일 서지 보호 | TVS 또는 제너 + 다이오드 (12 V 코일) | 1 | 확인 필요 |  |  | 일반 다이오드만 달면 접점이 늦게 떨어진다 (LS 카탈로그) |
| 전원 | DC-DC 12V (젯슨 · 코일) | MEAN WELL RSD-60L-12 (입력 18~72 V → 12 V 5 A) | 1 | 74,800 | 74,800 | [링크](https://meanwell.co.kr/product/detail.html?product_no=799&cate_no=52&display_group=1) | 싸인라이트. 민웰몰 65,990. 젯슨 DC 잭 9~20 V (D-07) |
| 전원 | DC-DC 5V | 디오시스템 DKP-55 (입력 8~60 V → 5 V 10 A) | 1 | 82,000 | 82,000 | [링크](https://smpskorea.com/product/detail.html?product_no=741&cate_no=126&display_group=1) |  |
| 전원 | 분기 퓨즈 + 홀더 | DC 58 V 이상 정격 5 A (12 V · 5 V 변환기 입력) | 2 | 확인 필요 |  |  | 자동차용 32 V 블레이드 퓨즈는 안 된다 — 구매처 확인 필요 |
| 제어 | 메인 컴퓨터 | NVIDIA Jetson Orin Nano (Super) 개발킷 | 1 | 확인 필요 |  | [링크](https://developer.nvidia.com/embedded/learn/get-started-jetson-orin-nano-devkit) | 가격 확인 필요 |
| 제어 | MCU | ESP32-DevKitC V4 + 만능기판 받침 | 1 | 확인 필요 |  | [링크](https://docs.espressif.com/projects/esp-dev-kits/en/latest/esp32/esp32-devkitc/user_guide.html) | 하드웨어 UART 2 개로 두 보드 제어 (3.3 V) |
| 센서 | IMU | ROBOR iAHRS RB-SDA-v1 (35 × 35 × 10, USB) | 1 | 198,000 | 198,000 | [링크](https://www.eleparts.co.kr/goods/view?no=9907195) | 엘레파츠 VAT 포함 (VAT 별도 180,000). 지자기 보정 끔 (mv=0) |
| 안전 | 비상정지 버튼 | Autonics SF2ER-E2RB (D40 짧은 헤드, 1NC, 누르면 잠김 · 시계방향 회전 해제) | 1 | 23,100 | 23,100 | [링크](https://www.eleparts.co.kr/goods/view?no=13038016) | 엘레파츠 VAT 포함 (VAT 별도 21,000), 국내 정품 · 재고 시 2~3 일 |
| 안전 | 비상정지 명판 | Autonics SF2ER-B3 (Ø60, 두께 1, STOP) | 1 | 5,150 | 5,150 | [링크](https://e-punglim.co.kr/product/detail.html?product_no=37361) | 풍림오토테크 (VAT 표기 없음) |
| 배선 | 고무 그로밋 | 구멍 Ø25 · 판 5 t · 케이블 Ø10 | 4 | 확인 필요 |  |  | 바닥판 케이블 구멍 |
| 배선 | 보드 전원 커넥터 | AMASS XT60H 수 + 암 | 4 | 638 | 2,552 | [링크](https://www.eleparts.co.kr/goods/view?no=13428798) | 수 2 · 암 2 (엘레파츠 VAT 포함). 암 https://www.eleparts.co.kr/goods/view?no=13428797 |
| 배선 | 배터리 커넥터 | XT90 암 (배터리 XT-90 옵션과 짝) | 1 | 확인 필요 |  |  |  |
| 외관 | 고무 범퍼 띠 | D 형 고무 범퍼 / 고무 몰딩, 높이 30 × 두께 25 | 0.91 | 확인 필요 |  |  | 앞 · 뒤 판 폭대로 잘라 쓴다 |
| 외관 | 배기 팬 | EVERCOOL EC8025H05B (5 V, 80 × 80 × 25) | 2 | 8,740 | 17,480 | [링크](https://www.compuzone.co.kr/product/product_detail.htm?ProductNo=1047506) | 컴퓨존. 대안 메카솔루션 FNM-S-8025 5V 1,540 |
| 센서 | 뎁스 카메라 | Orbbec Gemini 336 (스테레오 + IR-pass 필터, 기준선 50, 0.3–3 m 최적 · 0.1–20 m 작동) | 2 | 462,000 | 924,000 | [링크](https://www.icbanq.com/P016230044) | 아이씨뱅큐 VAT 포함, 출고 1주 이내. 차점 Gemini 335 506,000 (당일출고, 같은 몸통 · 구멍) https://www.icbanq.com/P016230029 |
| 센서 | USB-C 케이블 일자 (양쪽 나사 잠금) | Coms IK045 USB 3.0 A ↔ C 1 m | 2 | 9,800 | 19,600 | [링크](https://www.eleparts.co.kr/goods/view?no=18547167) | 엘레파츠 VAT 포함. 카메라 포트 나사 규격 (M2 · 1 개/2 개) 실물 확인 — 단일 나사형 IK046 도 있음 |
| 체결 | 카메라 뒷면 볼트 | M3 × 6 (최대 삽입 3, 0.4 N·m) | 4 | 확인 필요 |  |  | 브래킷 4 t 통과 |
| 체결 | 카메라 바닥 볼트 | 1/4-20 UNC × 5/16" (최대 삽입 5, 4 N·m) | 2 | 확인 필요 |  |  | 브래킷 선반 4 t 통과 |
| 체결 | 브래킷 → 판 볼트 + 열압입 인서트 | M3 | 4 | 확인 필요 |  |  | 판 M3 구멍 Ø3.4 |
