chungddong/NUBI/hardware/vehicle/models/vehicle/v29_floor_wiring/bom.md

# BOM — v29_floor_wiring

수량 · 길이 · 판 크기 · 볼트 개수는 이 버전 형상에서 뽑았다. 가격은 조사로 확인한 것만 적었다.

- 확인된 금액 합: **2,644,480 원** (단가가 있는 줄만)
- 단가 미확인 39 줄 — 견적 · 확인 필요

| 구분 | 품목 | 규격 | 수량 | 단가 | 금액 | 구매처 | 비고 |
|---|---|---|---:|---:|---:|---|---|
| 프레임 | 알루미늄 프로파일 3030 | L760 | 4 | 7,600 | 30,400 |  | 100 mm 단위 올림 과금 (800) · 상부사이드, 하부사이드 |
| 프레임 | 알루미늄 프로파일 3030 | L390 | 8 | 3,800 | 30,400 |  | 100 mm 단위 올림 과금 (400) · 상부크로스, 축크로스, 하부크로스 |
| 프레임 | 알루미늄 프로파일 3030 | L143 | 6 | 1,900 | 11,400 |  | 100 mm 단위 올림 과금 (200) · 기둥 |
| 프레임 | 알루미늄 프로파일 2020 (모듈 레일) | L760 | 3 | 4,630 | 13,890 | [링크](http://www.profileok.com/shop/list.php?ca_id=10) | 100 mm 단위 올림 과금 (800) · 동진 DF2020 1 m 값 4,630 (VAT · 절단 포함) 으로 잡은 상한 — 760 mm 실제 값은 이보다 적다 · 상부 프레임 위 y -210 · 0 · +210 |
| 판재 | 바닥판 폴리카보네이트 (PC) 불투명 흑색 | 760 × 450 × 5t | 1 | 확인 필요 |  | [링크](https://www.acrylmall.com/src/products/products_list.php?product_category_id=5512) | CNC 재단 · 구멍 — output/floor_plate.dxf |
| 판재 | 외관판 side_l | ACM 3t 760 × 203 | 1 | 확인 필요 |  |  | output/shell_side_l.dxf |
| 판재 | 외관판 side_r | ACM 3t 760 × 203 | 1 | 확인 필요 |  |  | output/shell_side_r.dxf |
| 판재 | 외관판 front | UV PC 3t 불투명 456 × 203 | 1 | 확인 필요 |  |  | output/shell_front.dxf |
| 판재 | 외관판 rear | UV PC 3t 불투명 456 × 203 | 1 | 확인 필요 |  |  | output/shell_rear.dxf |
| 판재 | 외관판 lid_l | ACM 3t 덮개 왼 R6 766 × 189 | 1 | 확인 필요 |  |  | output/shell_lid_l.dxf |
| 판재 | 외관판 lid_r | ACM 3t 덮개 오른 R6 766 × 189 | 1 | 확인 필요 |  |  | output/shell_lid_r.dxf |
| 출력 | 포트칸_트레이_ASA | ASA 76 cm³ · 81 g · 약 2.1 h | 1 | 2,430 | 2,430 |  | 부피 꽉 채움 기준 상한 — 실제 인필이면 더 적다 |
| 출력 | 포트칸_덮개_ASA | ASA 48 cm³ · 52 g · 약 1.3 h | 1 | 1,548 | 1,548 |  | 부피 꽉 채움 기준 상한 — 실제 인필이면 더 적다 |
| 출력 | 카메라브래킷_뒤_ASA | ASA 14 cm³ · 15 g · 약 0.4 h | 1 | 457 | 457 |  | 부피 꽉 채움 기준 상한 — 실제 인필이면 더 적다 |
| 출력 | 카메라브래킷_앞_ASA | ASA 14 cm³ · 15 g · 약 0.4 h | 1 | 457 | 457 |  | 부피 꽉 채움 기준 상한 — 실제 인필이면 더 적다 |
| 출력 | 전조등테두리_왼_ASA | ASA 54 cm³ · 57 g · 약 1.5 h | 1 | 1,722 | 1,722 |  | 부피 꽉 채움 기준 상한 — 실제 인필이면 더 적다 |
| 출력 | 전조등고정링_왼_ASA | ASA 19 cm³ · 20 g · 약 0.5 h | 1 | 608 | 608 |  | 부피 꽉 채움 기준 상한 — 실제 인필이면 더 적다 |
| 출력 | 전조등테두리_오른_ASA | ASA 54 cm³ · 57 g · 약 1.5 h | 1 | 1,722 | 1,722 |  | 부피 꽉 채움 기준 상한 — 실제 인필이면 더 적다 |
| 출력 | 전조등고정링_오른_ASA | ASA 19 cm³ · 20 g · 약 0.5 h | 1 | 608 | 608 |  | 부피 꽉 채움 기준 상한 — 실제 인필이면 더 적다 |
| 체결 | 둥근머리 렌치볼트 | M6x15 | 16 | 확인 필요 |  |  | T 클램프 → 레일 · 축크로스 (스프링너트) |
| 체결 | 둥근머리 렌치볼트 + 와셔 | M6x15 | 18 | 확인 필요 |  |  | 바닥판 → 프레임 (스프링너트) |
| 체결 | 스프링너트 3030 | M6 | 44 | 확인 필요 |  |  |  |
| 체결 | 외관판 볼트 + T 너트 | M5 | 32 | 확인 필요 |  |  | 옆 · 앞 · 뒤판 → 프로파일 바깥 슬롯 (위쪽은 상부 프레임) |
| 체결 | 코너 브래킷 3030 + M6 T 볼트 2 | 다이캐스트 28 × 28 × 28 | 8 | 확인 필요 |  |  | 기둥 ↔ 상부 사이드 레일 (v26 — 기둥 볼트 대신, 레일 윗면은 모듈 레일 자리) |
| 체결 | 모듈 레일 고정 볼트 + T 너트 | M5 × 35 + 3030 M5 T 너트 (2020 윗면에 Ø9 접근 구멍) | 11 | 확인 필요 |  |  | 양옆 레일 4 씩 (x ±105 · ±290), 가운데 3 (크로스 위) |
| 배선 | 모듈 케이블 그로밋 | 구멍 Ø25 · 판 3 t | 2 | 확인 필요 |  |  | 덮개 (x -100, y ±150) — 모듈 전원 · 통신 |
| 체결 | 덮개 손나사 + T 너트 | M5 × 12 로렛 손나사 (머리 Ø14 안팎) + 3030 M5 T 너트 | 6 | 확인 필요 |  |  | 공구 없이 덮개를 연다 (v25) |
| 체결 | 상부 크로스 엔드탭 | M8 × 25 + 크로스 끝 M8 탭 + 레일 접근 구멍 Ø8 | 6 | 확인 필요 |  |  | 상부 크로스 3 × 양끝 (v23) |
| 체결 | 고무 범퍼 볼트 | M6 (길이는 고무 두께 + 판 + 슬롯) | 10 | 확인 필요 |  |  |  |
| 체결 | 부품 고정 볼트 · 너트 (+ 스탠드오프) | M2 | 4 | 확인 필요 |  |  | 바닥판 부품 고정 구멍에서 셈 |
| 체결 | 부품 고정 볼트 · 너트 (+ 스탠드오프) | M3 | 30 | 확인 필요 |  |  | 바닥판 부품 고정 구멍에서 셈 |
| 체결 | 부품 고정 볼트 · 너트 (+ 스탠드오프) | M4 | 4 | 확인 필요 |  |  | 바닥판 부품 고정 구멍에서 셈 |
| 구동 | 호버보드 2 세대 (6.5" 허브모터 2 + 분리형 보드 2) | 바퀴 모터 4 · 모터 드라이버 4 로 쓴다 | 2 | 보유 |  |  | 보유품. 보드 칩 (GD32F130 / MM32SPIN / GD32E230 …) 과 기판 실크 이름 확인 → 펌웨어 (DECISIONS D-03) |
| 구동 | ST-Link V2 (GD32) 또는 DAPLink (MM32) | SWD 프로그래머 | 1 | 확인 필요 |  |  | RoboDurden Gen2.x 펌웨어 굽기 (원래 펌웨어는 지워진다) |
| 전원 | 배터리 | 알엠파워 ZENION 삼성 21700 36V 20Ah 10S4P 직사형 + XT-90 (최대 방전 30 A, 최대 충전 10 A, KC) | 1 | 553,000 | 553,000 | [링크](https://rmpower.co.kr/shop_view/?idx=514) | 548,000 + XT-90 옵션 5,000. 95 × 245 × 75, 3 kg. '최대 30 A' 가 연속인지 판매처 확인 (D-04) |
| 전원 | 충전기 | 알엠파워 10S 42V 2A (XT60 단자) | 1 | 46,000 | 46,000 | [링크](https://rmpower.co.kr/1102/?idx=104) | DC 단자형 36,000. 포트 칸 GX16 충전 단자로 배선 |
| 전원 | 메인 차단기 | DC 차단기 1P 250VDC 40A (BA49-63 DC, C40) + DIN 레일 100 | 1 | 7,350 | 7,350 | [링크](https://mega-tec.co.kr/product/detail.html?product_no=504&cate_no=169&display_group=1) | 7,000 + 레일 350. 극성 확인 (DC MCB 는 극성 지정형이 많다) |
| 전원 | 비상정지 컨택터 | LS일렉트릭 GPR-M040 DC12V (40 A · 1000 VDC, 코일 12 V 3.5 W) | 1 | 41,870 | 41,870 | [링크](https://e-punglim.co.kr/product/detail.html?product_no=16656) | 주문품 4~6 주. 주접점 극성 — + 단자를 배터리 쪽. 급하면 TE EV200AAANA 170,500 (파워크래프트) |
| 전원 | 컨택터 코일 커넥터 | GPR-40ST (Tyco 1379658-1 하우징) | 10 | 2,510 | 25,100 | [링크](https://e-punglim.co.kr/product/detail.html?product_no=20822) | 최소 10 개 단위 |
| 전원 | 코일 서지 보호 | TVS 또는 제너 + 다이오드 (12 V 코일) | 1 | 확인 필요 |  |  | 일반 다이오드만 달면 접점이 늦게 떨어진다 (LS 카탈로그) |
| 전원 | DC-DC 12V (젯슨 · 코일) | MEAN WELL RSD-60L-12 (입력 18~72 V → 12 V 5 A) | 1 | 74,800 | 74,800 | [링크](https://meanwell.co.kr/product/detail.html?product_no=799&cate_no=52&display_group=1) | 싸인라이트. 민웰몰 65,990. 젯슨 DC 잭 9~20 V (D-07) |
| 전원 | DC-DC 5V | 디오시스템 DKP-55 (입력 8~60 V → 5 V 10 A) | 1 | 82,000 | 82,000 | [링크](https://smpskorea.com/product/detail.html?product_no=741&cate_no=126&display_group=1) |  |
| 제어 | 메인 컴퓨터 | NVIDIA Jetson Orin Nano (Super) 개발킷 | 1 | 확인 필요 |  | [링크](https://developer.nvidia.com/embedded/learn/get-started-jetson-orin-nano-devkit) | 가격 확인 필요 |
| 제어 | MCU | ESP32-DevKitC V4 + 만능기판 받침 | 1 | 확인 필요 |  | [링크](https://docs.espressif.com/projects/esp-dev-kits/en/latest/esp32/esp32-devkitc/user_guide.html) | 하드웨어 UART 2 개로 두 보드 제어 (3.3 V) |
| 센서 | IMU | ROBOR iAHRS RB-SDA-v1 (35 × 35 × 10, USB) | 1 | 198,000 | 198,000 | [링크](https://www.eleparts.co.kr/goods/view?no=9907195) | 엘레파츠 VAT 포함 (VAT 별도 180,000). 지자기 보정 끔 (mv=0) |
| 안전 | 비상정지 버튼 | Autonics SF2ER-E2RB (D40 짧은 헤드, 1NC, 누르면 잠김 · 시계방향 회전 해제) | 1 | 23,100 | 23,100 | [링크](https://www.eleparts.co.kr/goods/view?no=13038016) | 엘레파츠 VAT 포함 (VAT 별도 21,000), 국내 정품 · 재고 시 2~3 일 |
| 안전 | 비상정지 명판 | Autonics SF2ER-B3 (Ø60, 두께 1, STOP) | 1 | 5,150 | 5,150 | [링크](https://e-punglim.co.kr/product/detail.html?product_no=37361) | 풍림오토테크 (VAT 표기 없음) |
| 배선 | 고무 그로밋 | 구멍 Ø25 · 판 5 t · 케이블 Ø10 | 4 | 확인 필요 |  |  | 바닥판 케이블 구멍 |
| 배선 | 보드 전원 커넥터 | AMASS XT60H 수 + 암 | 8 | 638 | 5,104 | [링크](https://www.eleparts.co.kr/goods/view?no=13428798) | 수 4 · 암 4 — 보드 4 장 (엘레파츠 VAT 포함). 암 https://www.eleparts.co.kr/goods/view?no=13428797 |
| 포트 | 충전 단자 | GX16 3P set (패널 소켓 + 케이블 플러그) | 1 | 1,500 | 1,500 | [링크](https://rmpower.co.kr/shop_view/?idx=63) | 알엠파워. 충전기 '항공단자' 옵션이 GX16 인지 · 성별 확인 (패널 쪽 수 핀에 42 V 노출 주의) |
| 포트 | 키 스위치 | HAS1911 2 단 2 핀 메탈 키스위치 19 mm (4 A 28 VDC) | 1 | 6,600 | 6,600 | [링크](https://www.jenomall.com/goods/goods_view.php?goodsNo=1000009235) | 제노몰. 컨택터 코일 회로 |
| 포트 | 전압계 | VaneAims 원형 LED DC 4~100 V (2 선, Ø22) | 1 | 6,160 | 6,160 | [링크](https://www.eleparts.co.kr/goods/view?no=12829953) | 엘레파츠 VAT 포함. 컨택터 뒤에 물림 (주행 중에만 켜짐) |
| 포트 | 젯슨 USB-C 연장 (v28: ESP32 → 젯슨) | MAXTEK MT723 USB-C 수↔암 판넬용 30 cm | 1 | 3,200 | 3,200 | [링크](https://www.compuzone.co.kr/product/product_detail.htm?ProductNo=1373361) | 컴퓨존 |
| 포트 | USB 3.0 벌크헤드 | Coms HA079 원형 (암-암) | 2 | 7,000 | 14,000 | [링크](https://www.comsmart.co.kr/cmart/shop/item.php?it_id=1763692829) | 컴스마트. 안쪽 USB 3.0 A 수-수 케이블 별도 |
| 포트 | RJ45 벌크헤드 | Coms HA084 원형 CAT6 (암-암) | 1 | 6,000 | 6,000 | [링크](https://www.comsmart.co.kr/cmart/shop/item.php?it_id=1763689525) | 컴스마트. 안쪽 랜 패치 케이블 |
| 전조등 | LED 램프 | 건식 LED MR16 12 V 5 W 집중형 주광 6500 K (0.41 A, 410 lm, 빔 50°, Ø50 × 49) | 2 | 1,720 | 3,440 | [링크](https://www.11st.co.kr/products/3733952699) | 11번가 오렌지라이팅 (우리조명). 대안 엘레파츠 우리조명 MR16 5W 2,810 |
| 전조등 | 램프 소켓 | GU5.3 사기 소켓 (리드 300) | 2 | 1,000 | 2,000 | [링크](https://www.11st.co.kr/products/7292435290) | 11번가 짱램프 |
| 전조등 | MOSFET 모듈 | DFRobot Gravity MOSFET Power Controller DFR0457 (로직 3.3 V, PWM ≤ 1 kHz) | 1 | 6,270 | 6,270 | [링크](https://www.mechasolution.com/goods/goods_view.php?goodsNo=539634) | 메카솔루션 VAT 포함. 램프 2 개 병렬, ESP32 PWM |
| 체결 | 전조등 볼트 + 열압입 인서트 | M3 × 10 + M3 인서트 (테두리) | 8 | 확인 필요 |  |  | 안에서 고정 링 · 판 · 테두리를 같이 조인다 |
| 통신 | 와이파이 안테나 키트 | 에즈윈 AX200 Wi-Fi 6 Kit — MHF4 ↔ 벌크헤드 케이블 300 ×2 + 안테나 135 ×2 (+ 예비 AX200 카드) | 1 | 29,000 | 29,000 | [링크](https://www.compuzone.co.kr/product/product_detail.htm?ProductNo=1272311) | 컴퓨존 직접 배송. 케이블 · 안테나만 젯슨 AW-CB375NF (MHF4) 에 쓴다. 싼 대안 마이크로박스 3 dBi 110 mm 세트 10,000 |
| 센서 | 2D 라이다 | LDROBOT STL-19P (D500 키트 — CP2102 USB 어댑터 포함, 60 klux · 12 m) | 1 | 172,700 | 172,700 | [링크](https://www.eleparts.co.kr/goods/view?no=13532871) | 엘레파츠 VAT 포함. 대안 RPLIDAR C1 (에듀이노 112,500, 40 klux) |
| 센서 | GNSS | 아센코리아 GPS630 (USB, u-blox M8, 안테나 일체 · 자석) | 1 | 75,394 | 75,394 | [링크](https://www.eleparts.co.kr/goods/view?no=17686184) | 엘레파츠 VAT 포함. RTK 로 올리면 Holybro H-RTK ZED-F9P Rover 684,200 (드론위) |
| 안전 | 상태 표시등 | 큐라이트 ST45ML-BZ-3-12-RAG (Ø45, 적 · 황 · 녹 + 부저, DC 12 V 최대 160 mA) | 1 | 65,670 | 65,670 | [링크](https://alphaeplus.com/product/%ED%81%90%EB%9D%BC%EC%9D%B4%ED%8A%B8-st45ml-bz-3-12-%EC%8B%9C%EA%B7%B8%EB%84%90-%ED%83%80%EC%9B%8C%EB%9E%A8%ED%94%84-%EB%B6%80%EC%A0%8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) | 알파전기 VAT 포함. 공통선 +12 V, 색 · 부저마다 로우사이드 MOSFET (ESP32) |
| 모듈 | 센서 모듈 밑판 | AL5052 4t 200 × 460 (구멍 직접 가공) | 1 | 확인 필요 |  | [링크](http://www.profileok.com/shop/list.php?ca_id=90) | 동진프로파일 판재 재단 (5t 300 × 260 19,590 참고) |
| 모듈 | 라이다 판 | AL 3t 80 × 140 | 1 | 확인 필요 |  |  |  |
| 모듈 | 2020 프로파일 (라이다 기둥) | DF2020 L175 | 2 | 800 | 1,600 | [링크](http://www.profileok.com/shop/list.php?ca_id=10) | 동진프로파일 100 mm 단위 (200 mm 1,260 참고) — 200 mm 값 |
| 모듈 | 2020 코너 브래킷 | 동진 DCB2025 (ZN) + M5 볼트 · 사각너트 세트 | 4 | 520 | 2,080 | [링크](http://www.profileok.com/shop/list.php?ca_id=10) | 340 + 세트 180 |
| 모듈 | M5 T 너트 (2020 슬롯) | 동진 반달 인서트 DBIN20*M5 (홈 중간에 넣음) | 6 | 150 | 900 | [링크](http://www.profileok.com/shop/list.php?ca_id=10) | 밑판 → 모듈 레일. 레일이 유럽형 슬롯 6 이면 미스미 HNTAJ5-5 |
| 외관 | 고무 범퍼 띠 | D 형 고무 범퍼 / 고무 몰딩, 높이 30 × 두께 25 | 0.91 | 확인 필요 |  |  | 앞 · 뒤 판 폭대로 잘라 쓴다 |
| 외관 | 배기 팬 | EVERCOOL EC8025H05B 2P (5 V 0.28 A, 3000 rpm, 36.48 CFM, 2 볼) | 2 | 8,740 | 17,480 | [링크](https://www.compuzone.co.kr/product/product_detail.htm?ProductNo=1047506) | 컴퓨존 (에버쿨 직영몰 8,500). 라벨면 (배기) 을 판 쪽으로. 조용한 대안 EC8025M05CA 0.18 A 6,200 |
| 외관 | 팬 핑거 가드 | EVERCOOL EFG-S80 실버 와이어 (Ø76.5, 와이어 1.8, 높이 5.5) | 2 | 380 | 760 | [링크](https://www.compuzone.co.kr/product/product_detail.htm?ProductNo=351400) | 판 바깥쪽 |
| 체결 | 팬 볼트 | M4×20 + 나일론 너트 + 평와셔 2 | 8 | 확인 필요 |  |  | 가드 1.8 + PC 3 + 팬 플랜지 4 를 같이 문다. 록타이트 금지 (PC 응력균열) |
| 센서 | 뎁스 카메라 | Orbbec Gemini 336 (스테레오 + IR-pass 필터, 기준선 50, 0.3–3 m 최적 · 0.1–20 m 작동) | 2 | 462,000 | 924,000 | [링크](https://www.icbanq.com/P016230044) | 아이씨뱅큐 VAT 포함, 출고 1주 이내. 차점 Gemini 335 506,000 (당일출고, 같은 몸통 · 구멍) https://www.icbanq.com/P016230029 |
| 센서 | USB-C 케이블 일자 (양쪽 나사 잠금) | Coms IK045 USB 3.0 A ↔ C 1 m | 2 | 9,800 | 19,600 | [링크](https://www.eleparts.co.kr/goods/view?no=18547167) | 엘레파츠 VAT 포함. 카메라 포트 나사 규격 (M2 · 1 개/2 개) 실물 확인 — 단일 나사형 IK046 도 있음 |
| 체결 | 카메라 뒷면 볼트 | M3 × 6 (최대 삽입 3, 0.4 N·m) | 4 | 확인 필요 |  |  | 브래킷 4 t 통과 |
| 체결 | 카메라 바닥 볼트 | 1/4-20 UNC × 5/16" (최대 삽입 5, 4 N·m) | 2 | 확인 필요 |  |  | 브래킷 선반 4 t 통과 |
| 체결 | 브래킷 → 판 볼트 + 열압입 인서트 | M3 | 4 | 확인 필요 |  |  | 판 M3 구멍 Ø3.4 |
| 배선 | 실리콘선 10 AWG (적 · 흑) | 0.94 m + 여유 15 % — 주전원 · 컨택터 · 레일 공급 | 2 | 1,860 | 3,720 | [링크](https://www.11st.co.kr/products/3306373594) | 11번가 우리파파 1 m 단위 (배송비 3,000 별도). 적 · 흑 색상 옵션 확인 |
| 배선 | 실리콘선 14 AWG (적 · 흑) | 12.73 m + 여유 15 % — 바퀴 보드 · 변환기 · 충전 · 점퍼 | 15 | 770 | 11,550 | [링크](https://www.11st.co.kr/products/3306373594) | 11번가 우리파파 1 m 단위 (배송비 3,000 별도). 적 · 흑 색상 옵션 확인 |
| 배선 | 실리콘선 18 AWG (적 · 흑) | 9.86 m + 여유 15 % — 12 V · 코일 · 젯슨 DC · 전조등 (2 심은 2 가닥으로 셈) | 12 | 420 | 5,040 | [링크](https://www.11st.co.kr/products/3306373594) | 11번가 우리파파 1 m 단위 (배송비 3,000 별도). 적 · 흑 색상 옵션 확인 |
| 배선 | 실리콘선 22 AWG (적 · 흑) | 16.64 m + 여유 15 % — 신호 · 전압계 · 감지 · 팬 연장 (다심은 심 수로 셈) | 20 | 320 | 6,400 | [링크](https://www.11st.co.kr/products/3306373594) | 11번가 우리파파 1 m 단위 (배송비 3,000 별도). 적 · 흑 색상 옵션 확인 |
| 전원 | 분기 차단기 (바퀴 보드 4) | DC 차단기 1P 250 VDC **20 A** (BA49-63 DC) — 메인과 같은 계열 | 4 | 7,000 | 28,000 | [링크](https://mega-tec.co.kr/product/detail.html?product_no=504) | 국내 소용량 (10 A 이하) DC 차단기는 못 찾았다 — 20 A 는 14 AWG 전선 보호 (보드는 펌웨어 7 A 제한) |
| 전원 | DC 퓨즈 홀더 (변환기 2 · 충전 1) | 1P 1000 VDC 32 A, 10×38, DIN | 3 | 3,200 | 9,600 | [링크](https://mega-tec.co.kr/product/detail.html?product_no=507) | 메가에너텍. 치수는 [가정] 18 × 81 × 58 |
| 전원 | PV 퓨즈 10×38 | 15 A (gPV, 1000 VDC) — 3 + 예비 3 | 6 | 1,600 | 9,600 | [링크](https://mega-tec.co.kr/product/detail.html?product_no=508) | 국내는 15 A 부터 — 14 AWG 보호. 변환기는 내부 보호 |
| 전원 | DIN 레일 | 35 mm 레일 160 mm (분기 레일 136 으로 자름) | 1 | 450 | 450 | [링크](https://mega-tec.co.kr/product/detail.html?product_no=505) |  |
| 전원 | DIN 엔드 스토퍼 | 35 mm 레일용 | 2 | 300 | 600 | [링크](https://mega-tec.co.kr/product/detail.html?product_no=506) |  |
| 전원 | 음극 단자대 (N 바) | 황동 바 12 구멍 (구멍당 16 mm² 이상, 절연 받침) | 1 | 확인 필요 |  |  | 모든 0 V 를 한 점에 — 국내 M6 버스바는 구매대행뿐이라 전기자재 N 단자대로 (구매처 확인) |
| 배선 | 배터리 커넥터 | AMASS XT90H-F (암, 배터리 XT-90 수와 짝) | 1 | 1,045 | 1,045 | [링크](https://www.eleparts.co.kr/goods/view?no=12773228) | 엘레파츠 VAT 포함. 충전선 14 AWG 를 같은 땜납 컵에 |
| 배선 | 레버 커넥터 | WAGO 221-415 (5 구) — 12 V ± · 5 V ± | 4 | 847 | 3,388 | [링크](https://www.eleparts.co.kr/goods/view?no=7275762) | 엘레파츠 VAT 포함. 바닥은 양면테이프 |
| 배선 | 링 단자 세트 | Coms IT-300 (링 · Y · 총알 300 개) | 1 | 11,900 | 11,900 | [링크](https://www.eleparts.co.kr/goods/view?no=4063230) | M4 (컨택터) 구성 확인 |
| 배선 | 페룰 세트 | Coms HA067 | 1 | 4,680 | 4,680 | [링크](https://www.eleparts.co.kr/goods/view?no=18976115) | 차단기 · 퓨즈 홀더 · WAGO · N 바에 넣는 선 끝 |
| 배선 | 젯슨 DC 플러그 | STech 납땜형 DC (수) 5.5 / 2.5 | 1 | 688 | 688 | [링크](https://www.eleparts.co.kr/goods/view?no=6783563) | 18 AWG 2 심 연결 |
| 배선 | 케이블 타이 | 100 × 2.5 (1,000 개) | 1 | 3,069 | 3,069 | [링크](https://www.navimro.com/g/1062007/) | 바닥 다발을 타이 마운트에 묶는다 (꺾이는 곳마다) |
| 배선 | 부착식 타이 마운트 | 동아베스텍 DAMB-10 (구멍 4.3) — 바닥판 M5 격자 구멍에 볼트로도 가능 | 40 | 확인 필요 |  | [링크](https://www.navimro.com/g/374730/) | 1,000 개 19,990 (VAT 별도) 뿐 — 소량 구매처 확인 |
| 제어 | USB 허브 (유전원 7 포트) | POWERLAN PL-UH307P USB 3.0 — 130 × 46 × 22, 5 V 2 A | 1 | 23,100 | 23,100 | [링크](https://www.eleparts.co.kr/goods/view?no=12485398) | 5 V 는 DKP-55 에서 — DC 잭 규격 실물 확인 |
| 안전 | 표시등 MOSFET 1 채널 (색 3 + 부저) | 15 A MOSFET 트리거 모듈 (로직 3.3~20 V, 부하 5~36 V, 로우사이드) | 4 | 700 | 2,800 | [링크](https://mechasolution.com/goods/goods_view.php?goodsNo=605618) | 메카솔루션 — '구매 불가' 표시, 재고 확인. 치수 [가정] 34 × 17 |
| 포트 | USB 3.0 A 수-수 케이블 | NEXT-1672U3-AA 0.5 m (패널 USB-A 2 → 젯슨 · 허브) | 2 | 1,690 | 3,380 | [링크](https://www.eleparts.co.kr/goods/view?no=17672924) | 경로가 길면 1 m |
| 포트 | LAN 패치 | CAT6 UTP — 경로 0.42 m | 1 | 확인 필요 |  | [링크](https://www.eleparts.co.kr/goods/view?no=2922243) | Coms C3898 30 cm 1,450 — 바닥으로 돌면 길어진다, 길이 맞춰 구매 |
| 제어 | ESP32 USB 케이블 | 마이크로 5 핀 ↔ A (경로 길이에 맞춤) | 1 | 확인 필요 |  | [링크](https://www.eleparts.co.kr/goods/view?no=2933871) | NEXI NX15 0.3 m 603 (VAT 별도) — 바닥으로 돌면 0.5 m 이상 |
| 통신 | 안테나 동축 피그테일 | MHF4 ↔ RP-SMA 벌크헤드 — 경로 왼 0.71 · 오른 1.05 m | 2 | 확인 필요 |  |  | 키트의 300 mm 는 짧다 (젯슨 M.2 카드는 뒤, 안테나는 앞) — 길이 맞는 국내 구매처 확인 |
| 센서 | 카메라 USB 길이 | 경로 앞 1.19 · 뒤 0.48 m — 카메라 줄 IK045 1 m ×2 로 모자람 | 0 | 확인 필요 |  |  | 모자라면 Coms IK045 1.5 m · 2 m 확인 |
