chungddong/NUBI/hardware/vehicle/docs/bom.csv

카테고리 | 품목 | 규격 | 수량 | 단위 | 조달 | 단가(원) | 금액(원) | 근거
1. 프레임 | 알루미늄 프로파일 | 30x30 L760 | 4 | 본 | 보유 | 7600 | 30400 | 32단위(100mm 올림) · 버림 160mm · 상부사이드, 하부사이드 [확인]
1. 프레임 | 알루미늄 프로파일 | 30x30 L390 | 8 | 본 | 보유 | 3800 | 30400 | 32단위(100mm 올림) · 버림 80mm · 상부크로스, 축크로스, 하부크로스 [확인]
1. 프레임 | 알루미늄 프로파일 | 30x30 L143 | 6 | 본 | 보유 | 1900 | 11400 | 12단위(100mm 올림) · 버림 342mm · 기둥 [확인]
1. 프레임 | 다이캐스팅 코너브라켓 | 3025 | 28 | 개 | 보유 | 360 | 10080 | joints() 자동 검출 28곳 [확인]
1. 프레임 | 둥근머리 렌치볼트 | M6x15 | 68 | 개 | 보유 | 70 | 4760 | 브라켓 56 + 셸 플랜지 12 [확인]
1. 프레임 | 스프링너트 | 306 (M6) | 68 | 개 | 보유 | 180 | 12240 | 슬롯에 들어가는 수량 = 볼트와 1:1 [확인]
2. 판재 | 판재 | PC/ABS 3t, 0.67 m² | 2 | 장 | 구매 | 16157 | 32314 | 형상 2020 cm³ / 3mm = 0.67 m² [추정]
2. 판재 | 적재함판재 | PC/ABS 3t, 0.40 m² | 1 | 장 | 구매 | 19028 | 19028 | 형상 1189 cm³ / 3mm = 0.40 m² [추정]
3. 구동부 | 호버보드 인휠 허브모터 | 6.5" Ø159 | 4 | 개 | 보유 | 55000 | 220000 | 스키드 4륜 [추정]
3. 구동부 | 기존 호버보드 상부 클램프 | 42.72x39.22x12.57 실측 | 4 | 개 | 보유 | 0 | 0 | 모터에 달려 나온 것을 재사용한다
3. 구동부 | Design-D 하부 클램프 | PLA 출력 116 cm³ (100% 인필) | 4 | 개 | 출력 | 3604 | 14416 | 116.3 cm³ → 144 g → 출력 3.2 h/개 [추정]
3. 구동부 | 하부 클램프 레일 체결볼트 | M6x15 | 8 | 개 | 보유 | 70 | 560 | 코너당 2개(밑면) x 4 [실측 길이] [확인]
3. 구동부 | 하부 클램프 슬롯너트 | 스프링너트 306 (M6) | 8 | 개 | 보유 | 180 | 1440 | 볼트와 1:1 [확인]
3. 구동부 | 액슬 타이 프로파일 | 3030 L360 | 2 | 본 | 보유 | 0 | 0 | 남는 390mm 재활용 (390 → 360 절단)
3. 구동부 | 타이 코너 브래킷 | PLA 출력 6.2 cm³, L자 6t | 8 | 개 | 출력 | 193 | 1544 | 축당 4개 x 2축 · 8 g/개 [추정]
3. 구동부 | 타이 브래킷 볼트 (클램프 탭) | M6x20 | 16 | 개 | 구매 | 90 | 1440 | 브래킷 8 x 탭 2단 [추정]
3. 구동부 | 타이 브래킷 볼트 (슬롯) | M6x15 | 8 | 개 | 보유 | 70 | 560 | 브래킷당 1 [확인]
3. 구동부 | 타이 브래킷 슬롯너트 | 드롭인 T너트 (M6) | 8 | 개 | 구매 | 350 | 2800 | 인발 2271 N 급 — 스프링너트(933 N)보다 여유 [추정]
4. 외장·차체 | 외장셸 | PETG 출력 3t 벽 | 2 | 개 | 출력 | 41481 | 82962 | 형상 2178 cm³ → 2765 g → 출력 60.5 h [추정]
4. 외장·차체 | 카메라브라켓 | PETG 출력, 172 cm³ | 1 | 개 | 출력 | 6565 | 6565 | 형상 172 cm³ → 219 g → 출력 4.8 h [추정]
4. 외장·차체 | 배터리브라켓 | PETG 출력, 174 cm³ | 1 | 개 | 출력 | 6624 | 6624 | 형상 174 cm³ → 221 g → 출력 4.8 h [추정]
4. 외장·차체 | 범퍼 | TPU 출력 360x38 | 2 | 개 | 출력 | 17730 | 35460 | 형상 651 cm³ → 788 g → 출력 18.1 h [추정]
4. 외장·차체 | 핸들 | PETG 출력 (베이스판 + 팔) | 2 | 개 | 출력 | 5347 | 10694 | 형상 281 cm³ → 356 g → 출력 7.8 h [추정]
4. 외장·차체 | 핸들 그립봉 | Ø18 알루미늄 봉 | 2 | 개 | 구매 | 6000 | 12000 | 봉만 사서 낀다 [추정]
4. 외장·차체 | 데크 모듈 레일 | 20x20 L785 | 3 | 본 | 구매 | 5600 | 16800 | 24단위(100mm 올림) · 버림 45mm · 데크레일 [추정]
5. 전자·제어 | 라즈베리파이 5 | 8GB | 1 | 개 | 구매 | 130000 | 130000 | 메인 컴퓨터 [추정]
5. 전자·제어 | 인휠 BLDC 드라이버 | 홀센서 2채널 | 2 | 개 | 구매 | 45000 | 90000 | 모터 4개를 2ch x 2 로 [추정]
5. 전자·제어 | 배터리 | 36V 200x150x90 리튬팩 | 1 | 개 | 보유 | 150000 | 150000 | 호버보드 팩 재사용 [추정]
5. 전자·제어 | 주회로 차단기 | DC 63A | 1 | 개 | 구매 | 18000 | 18000 | power_box() [추정]
5. 전자·제어 | 퓨즈 · 프리차지 보드 | - | 1 | 개 | 구매 | 35000 | 35000 | power_box() [추정]
5. 전자·제어 | 비상정지 스위치 | Ø22 푸시록 | 1 | 개 | 구매 | 12000 | 12000 | 뒷면 z=246 [추정]
5. 전자·제어 | 배선 · 커넥터 일체 | 전원 + 모터 + 신호 | 1 | 식 | 구매 | 60000 | 60000 | 포트베이 커넥터 7종 포함 [추정]
6. 센서·표시 | RGBD 카메라 | Xtion 급 180x42 | 1 | 개 | 구매 | 180000 | 180000 | 전면 z=231 [추정]
6. 센서·표시 | 소형 카메라 | USB 광각 | 6 | 개 | 구매 | 15000 | 90000 | 후방1, 후방2, 전방1, 전방2, 좌측, 우측 [추정]
6. 센서·표시 | 전면 LED바 | 384mm | 1 | 개 | 구매 | 25000 | 25000 | 주행등 [추정]
6. 센서·표시 | 후미등 | 100x14 | 2 | 개 | 구매 | 12000 | 24000 | 뒷면 z=276 [추정]
6. 센서·표시 | 범퍼 리미트 스위치 | - | 4 | 개 | 구매 | 3000 | 12000 | 앞뒤 각 2 [추정]
6. 센서·표시 | 배기팬 | 60mm DC | 2 | 개 | 구매 | 8000 | 16000 | cooling_cuts() [추정]
6. 센서·표시 | 부저 | Ø30 | 1 | 개 | 구매 | 5000 | 5000 | 후진음 [추정]
6. 센서·표시 | 안테나 | WiFi/LTE 휩 | 2 | 개 | 구매 | 15000 | 30000 | 뒷면 상부 코너 [추정]
7. 적재함 | 적재함 셸 | PETG 출력 5t 벽 | 1 | 개 | 출력 | 197316 | 197316 | 형상 5179 cm³ → 6577 g → 출력 143.9 h [추정]
7. 적재함 | 장비베이 지붕 | PETG 출력, 2157 cm³ | 1 | 개 | 출력 | 82199 | 82199 | 형상 2157 cm³ → 2740 g → 출력 59.9 h [추정]
7. 적재함 | 뚜껑 | PETG 출력, 1594 cm³ | 1 | 개 | 출력 | 60715 | 60715 | 형상 1594 cm³ → 2024 g → 출력 44.3 h [추정]
7. 적재함 | 슬라이드채널 | PETG 출력, 195 cm³ | 3 | 개 | 출력 | 2476 | 7428 | 형상 195 cm³ → 248 g → 출력 5.4 h [추정]
7. 적재함 | 장비마운트 | PETG 출력, 708 cm³ | 2 | 개 | 출력 | 13495 | 26990 | 형상 708 cm³ → 900 g → 출력 19.7 h [추정]
7. 적재함 | 바구니크래들 | PETG 출력, 758 cm³ | 1 | 개 | 출력 | 28867 | 28867 | 형상 758 cm³ → 962 g → 출력 21.0 h [추정]
7. 적재함 | 리테이너 | PETG 출력, 23 cm³ | 3 | 개 | 출력 | 292 | 876 | 형상 23 cm³ → 29 g → 출력 0.6 h [추정]
7. 적재함 | 잠금 스트라이커 | PETG 출력 15.7 cm³ | 2 | 개 | 출력 | 300 | 600 | 20 g [추정]
7. 적재함 | 가스 스트럿 | 뚜껑 지지 | 2 | 개 | 구매 | 18000 | 36000 | 뚜껑 자중 보상 [추정]
7. 적재함 | 솔레노이드 잠금 | 12V | 2 | 개 | 구매 | 22000 | 44000 | 원격 개폐 [추정]
7. 적재함 | 힌지 | 내부 힌지 | 2 | 개 | 구매 | 8000 | 16000 | 뚜껑 [추정]
7. 적재함 | 타이다운 D링 | Ø30 | 4 | 개 | 구매 | 4000 | 16000 | 바구니 결박 [추정]
7. 적재함 | 유로 컨테이너 | KLT 400x300x220 (26 L) | 1 | 개 | 구매 | 18000 | 18000 | 규격품 [추정]
 | 합계 (전부 신품 기준) |  |  |  |  |  | 1976478
 | 지금 추가로 드는 돈 (구매+출력) |  |  |  |  |  | 1504638
