chungddong/NUBI/hardware/vehicle/models/hoverboard_mount/output/step/assembly_B.step

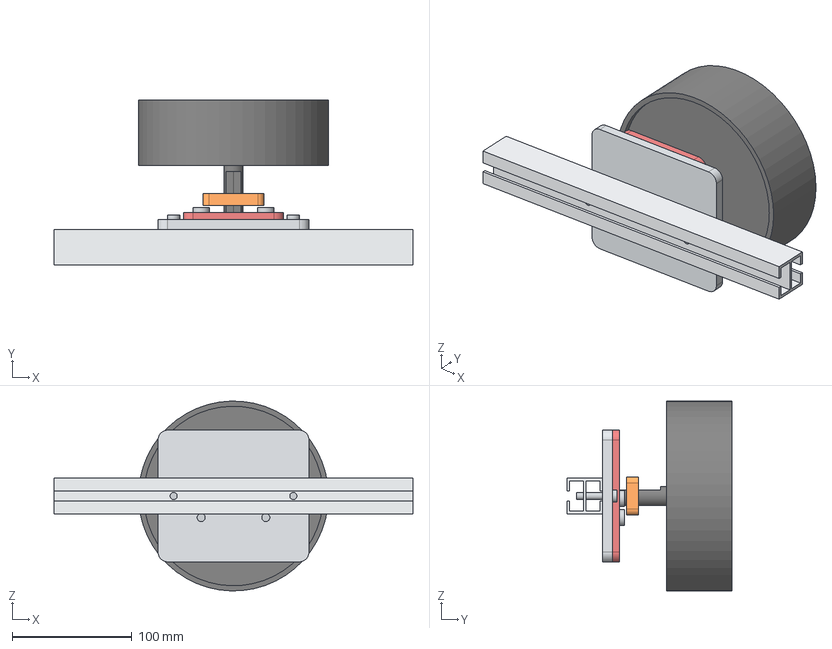
[picture p175: CAD file, 2026-10-13]
hardware/vehicle/models/hoverboard_mount/output/step/assembly_B.step
300.0 x 138.2 x 158.6 mm
hoverboard_motor_reference
adapter_plate
4080_extrusion_reference
torque_plate
axle_retainer
clamp_bolt1
clamp_bolt2
clamp_bolt3
clamp_bolt4
tnut_bolt1
tnut_bolt2
tnut_bolt3
tnut_bolt4
