chungddong/NUBI/hardware/vehicle/models/hoverboard_mount/output/step/h_assembly_hcross.step

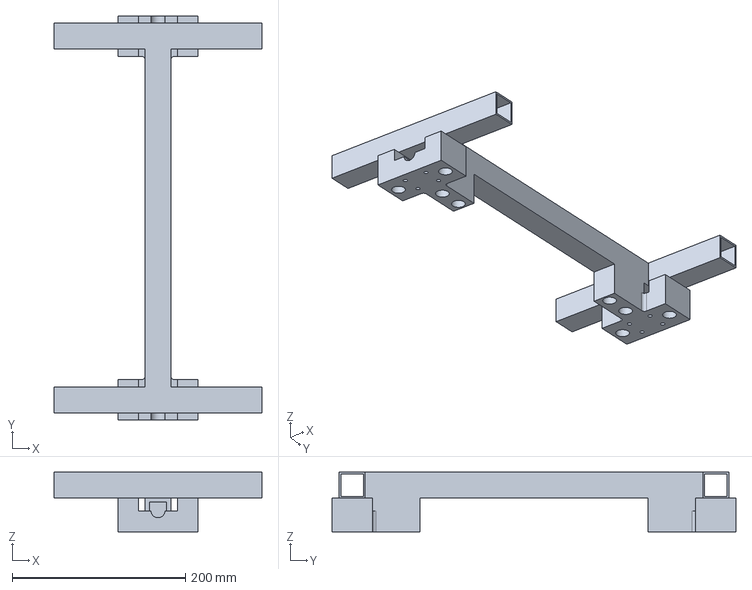
[picture p176: CAD file, 2026-10-13]
hardware/vehicle/models/hoverboard_mount/output/step/h_assembly_hcross.step
240.0 x 466.6 x 68.9 mm
