chungddong/NUBI/hardware/vehicle/models/hoverboard_mount/output/dxf/low_clamp_top.dxf

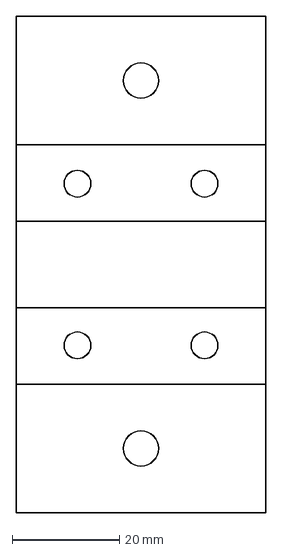
[picture p177: CAD file, 2026-10-13]
hardware/vehicle/models/hoverboard_mount/output/dxf/low_clamp_top.dxf
46.6 x 92.7 mm
