chungddong/NUBI/hardware/vehicle/models/hoverboard_mount/output/step/low_clamp_design_d_tongue.step

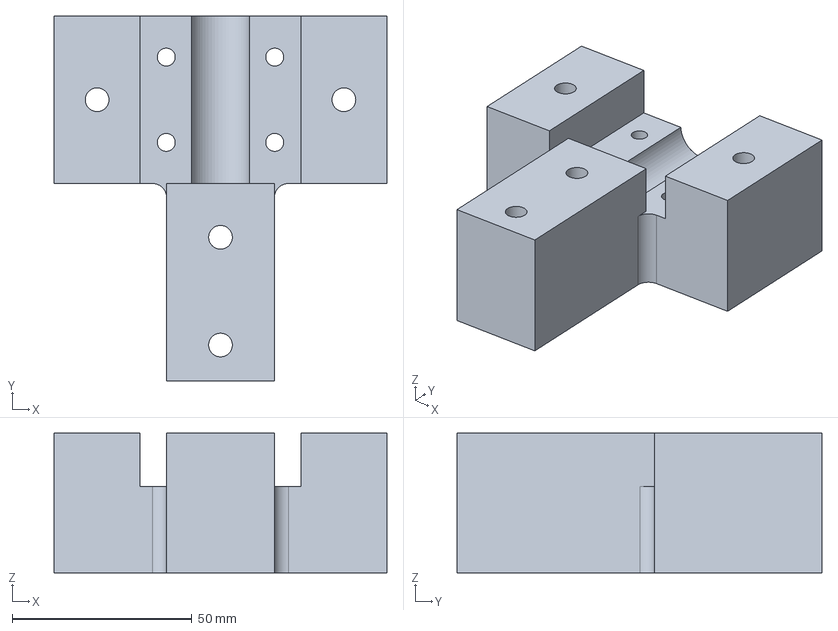
[picture p178: CAD file, 2026-10-13]
hardware/vehicle/models/hoverboard_mount/output/step/low_clamp_design_d_tongue.step
92.7 x 101.6 x 38.9 mm
