chungddong/NUBI/hardware/vehicle/models/hoverboard_mount/output/stl/oem_upper_clamp_reference_print.stl

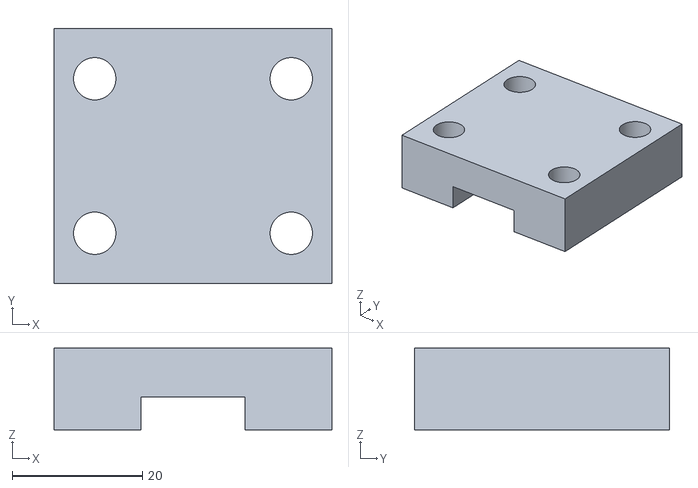
[picture p179: CAD file, 2026-10-13]
hardware/vehicle/models/hoverboard_mount/output/stl/oem_upper_clamp_reference_print.stl
42.7 x 39.2 x 12.6
