chungddong/NUBI/hardware/vehicle/models/vehicle/v06_floor10/output/floor_plate.dxf

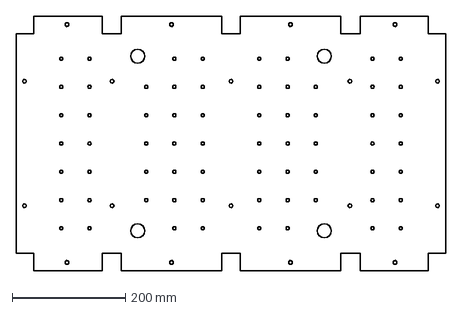
[picture p181: CAD file, 2026-10-13]
hardware/vehicle/models/vehicle/v06_floor10/output/floor_plate.dxf
760.0 x 450.0 mm
