chungddong/NUBI/hardware/vehicle/models/vehicle/v09_floor_pc/output/floor_plate.dxf

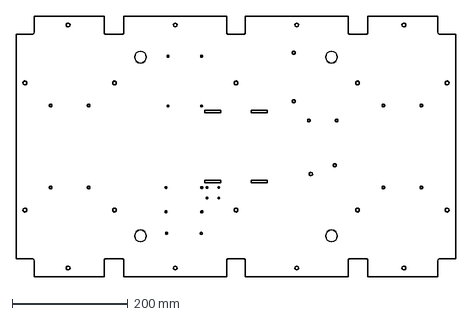
[picture p184: CAD file, 2026-10-13]
hardware/vehicle/models/vehicle/v09_floor_pc/output/floor_plate.dxf
760.0 x 450.0 mm
