chungddong/NUBI/hardware/vehicle/models/vehicle/v10_shell/output/shell_rear.dxf

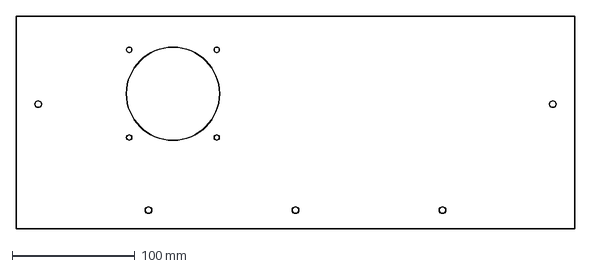
[picture p185: CAD file, 2026-10-13]
hardware/vehicle/models/vehicle/v10_shell/output/shell_rear.dxf
456.0 x 173.0 mm
