chungddong/NUBI/hardware/vehicle/models/vehicle/v20_power/output/shell_rear.dxf

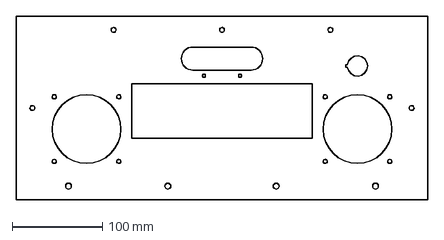
[picture p195: CAD file, 2026-10-13]
hardware/vehicle/models/vehicle/v20_power/output/shell_rear.dxf
456.0 x 203.0 mm
