chungddong/NUBI/hardware/vehicle/models/vehicle/v25_top_cover/output/shell_front.dxf

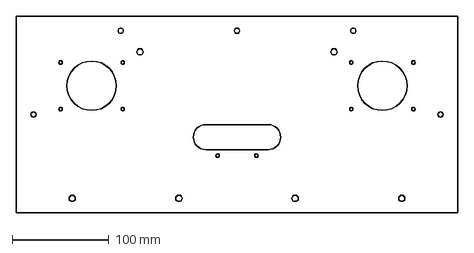
[picture p200: CAD file, 2026-10-13]
hardware/vehicle/models/vehicle/v25_top_cover/output/shell_front.dxf
456.0 x 203.0 mm
