chungddong/NUBI/hardware/vehicle/models/vehicle/v29_floor_wiring/output/shell_rear.dxf

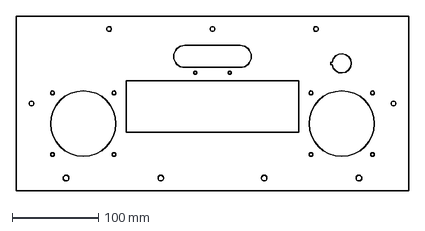
[picture p204: CAD file, 2026-10-13]
hardware/vehicle/models/vehicle/v29_floor_wiring/output/shell_rear.dxf
456.0 x 203.0 mm
