chungddong/NUBI/hardware/vehicle/models/hoverboard_mount/output/dxf/low_clamp_front.dxf

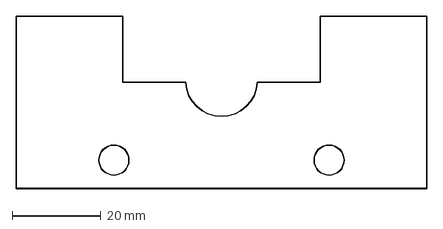
[picture p205: CAD file, 2026-10-13]
hardware/vehicle/models/hoverboard_mount/output/dxf/low_clamp_front.dxf
92.7 x 39.0 mm
