chungddong/NUBI/hardware/vehicle/models/vehicle/v10_shell/output/shell_side_r.dxf

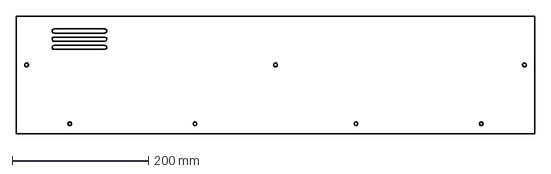
[picture p206: CAD file, 2026-10-13]
hardware/vehicle/models/vehicle/v10_shell/output/shell_side_r.dxf
760.0 x 173.0 mm
