chungddong/NUBI/hardware/vehicle/models/vehicle/v15_rear2/output/shell_rear.dxf

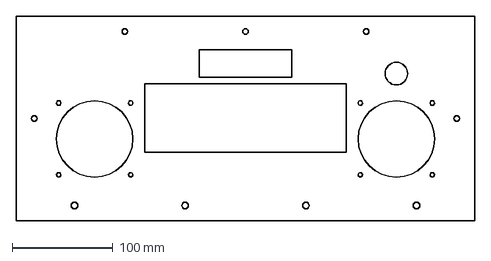
[picture p211: CAD file, 2026-10-13]
hardware/vehicle/models/vehicle/v15_rear2/output/shell_rear.dxf
456.0 x 203.0 mm
