chungddong/NUBI/hardware/vehicle/models/vehicle/v17_estop/output/shell_front.dxf

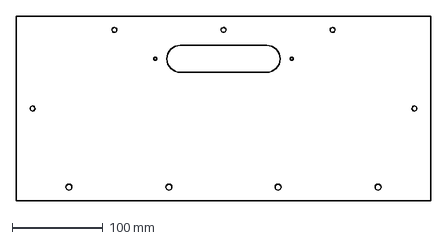
[picture p213: CAD file, 2026-10-13]
hardware/vehicle/models/vehicle/v17_estop/output/shell_front.dxf
456.0 x 203.0 mm
