chungddong/NUBI/hardware/vehicle/models/vehicle/v24_camera_mouth/output/shell_rear.dxf

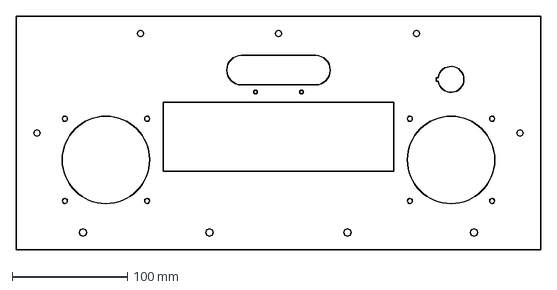
[picture p220: CAD file, 2026-10-13]
hardware/vehicle/models/vehicle/v24_camera_mouth/output/shell_rear.dxf
456.0 x 203.0 mm
