chungddong/NUBI/hardware/vehicle/models/vehicle/v29_floor_wiring/output/shell_lid_r.dxf

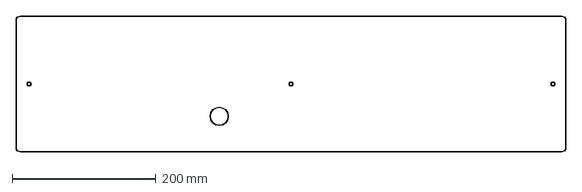
[picture p225: CAD file, 2026-10-13]
hardware/vehicle/models/vehicle/v29_floor_wiring/output/shell_lid_r.dxf
766.0 x 189.0 mm
