chungddong/NUBI/hardware/vehicle/models/hoverboard_mount/output/dxf/3030_profile.dxf

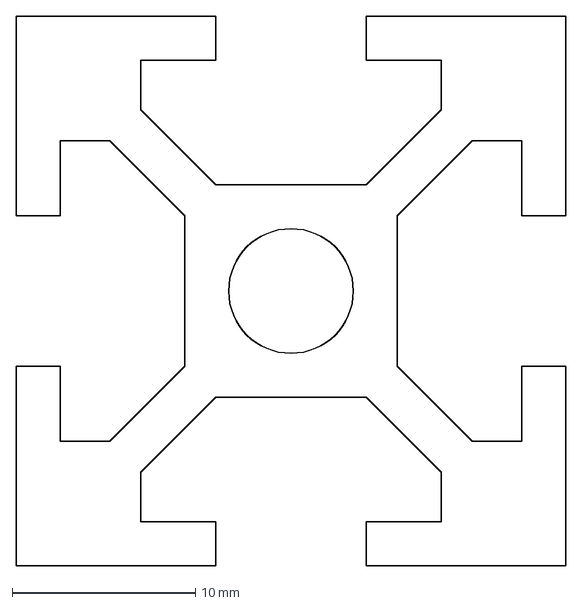
[picture p226: CAD file, 2026-10-13]
hardware/vehicle/models/hoverboard_mount/output/dxf/3030_profile.dxf
30.0 x 30.0 mm
