chungddong/NUBI/hardware/vehicle/models/vehicle/v10_shell/output/shell_front.dxf

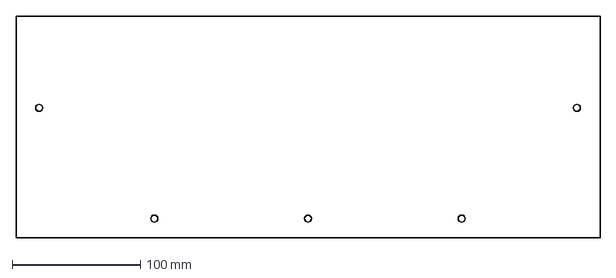
[picture p228: CAD file, 2026-10-13]
hardware/vehicle/models/vehicle/v10_shell/output/shell_front.dxf
456.0 x 173.0 mm
