chungddong/NUBI/hardware/vehicle/models/vehicle/v14_rear_io/output/shell_side_l.dxf

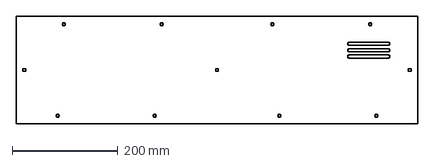
[picture p232: CAD file, 2026-10-13]
hardware/vehicle/models/vehicle/v14_rear_io/output/shell_side_l.dxf
760.0 x 203.0 mm
