chungddong/NUBI/hardware/vehicle/models/vehicle/v19_gemini336/output/shell_side_r.dxf

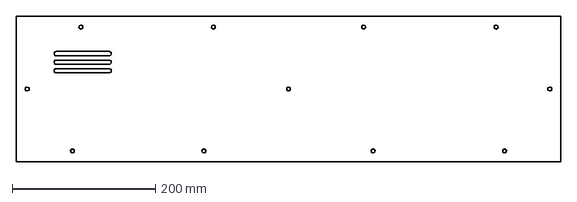
[picture p237: CAD file, 2026-10-13]
hardware/vehicle/models/vehicle/v19_gemini336/output/shell_side_r.dxf
760.0 x 203.0 mm
