chungddong/NUBI/hardware/vehicle/models/vehicle/v24_camera_mouth/output/shell_side_r.dxf

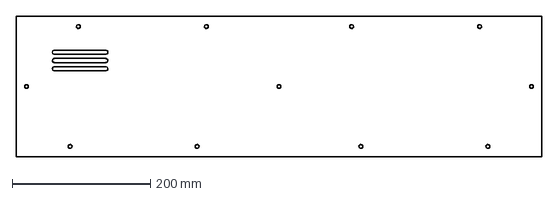
[picture p242: CAD file, 2026-10-13]
hardware/vehicle/models/vehicle/v24_camera_mouth/output/shell_side_r.dxf
760.0 x 203.0 mm
