chungddong/NUBI/hardware/vehicle/models/vehicle/v25_top_cover/output/shell_lid.dxf

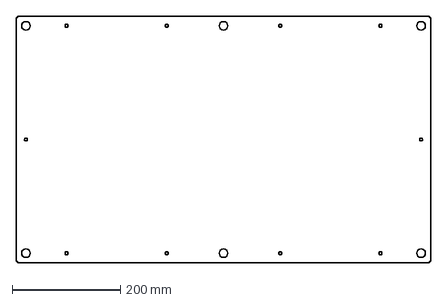
[picture p243: CAD file, 2026-10-13]
hardware/vehicle/models/vehicle/v25_top_cover/output/shell_lid.dxf
766.0 x 456.0 mm
