chungddong/NUBI/hardware/vehicle/models/hoverboard_mount/output/dxf/low_clamp_right.dxf

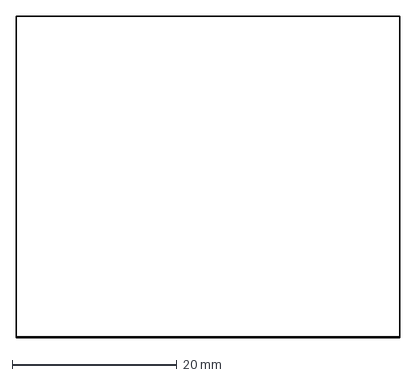
[picture p248: CAD file, 2026-10-13]
hardware/vehicle/models/hoverboard_mount/output/dxf/low_clamp_right.dxf
46.6 x 39.1 mm
