chungddong/NUBI/hardware/vehicle/models/hoverboard_mount/output/step/low_clamp_design_d_side_shelf.step

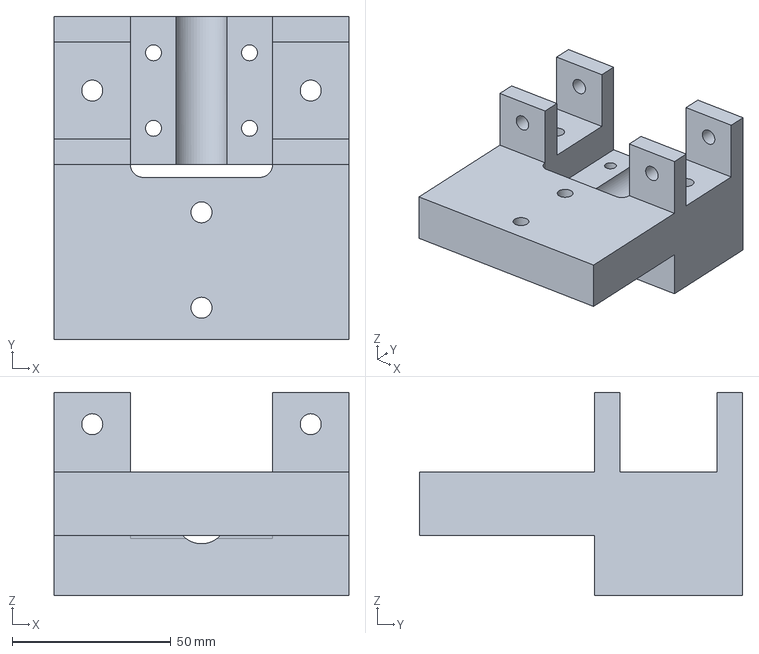
[picture p249: CAD file, 2026-10-13]
hardware/vehicle/models/hoverboard_mount/output/step/low_clamp_design_d_side_shelf.step
92.7 x 101.6 x 63.9 mm
