chungddong/NUBI/hardware/vehicle/models/hoverboard_mount/output/stl/design_d_lower_clamp_print_tongue_cableL.stl

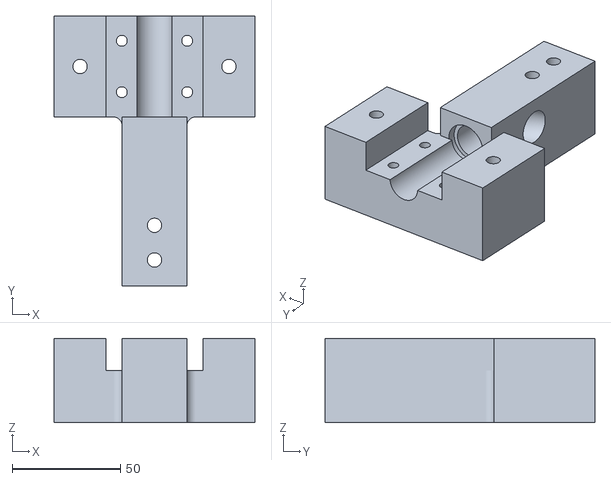
[picture p250: CAD file, 2026-10-13]
hardware/vehicle/models/hoverboard_mount/output/stl/design_d_lower_clamp_print_tongue_cableL.stl
92.7 x 124.6 x 38.9
