chungddong/NUBI/hardware/vehicle/models/vehicle/v11_shell_h/output/shell_side_r.dxf

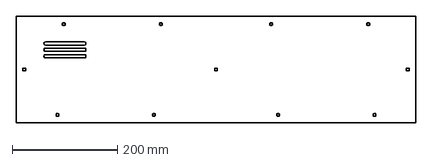
[picture p252: CAD file, 2026-10-13]
hardware/vehicle/models/vehicle/v11_shell_h/output/shell_side_r.dxf
760.0 x 203.0 mm
