chungddong/NUBI/hardware/vehicle/models/vehicle/v13_opaque/output/floor_plate.dxf

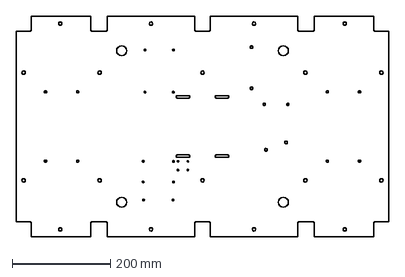
[picture p254: CAD file, 2026-10-13]
hardware/vehicle/models/vehicle/v13_opaque/output/floor_plate.dxf
760.0 x 450.0 mm
