chungddong/NUBI/hardware/vehicle/models/vehicle/v16_camera/output/shell_rear.dxf

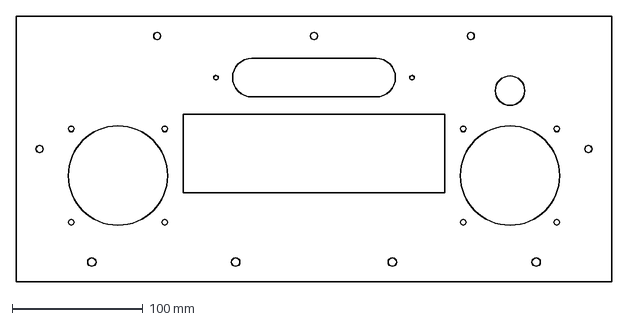
[picture p257: CAD file, 2026-10-13]
hardware/vehicle/models/vehicle/v16_camera/output/shell_rear.dxf
456.0 x 203.0 mm
