chungddong/NUBI/hardware/vehicle/models/vehicle/v21_split_ports/output/shell_side_l.dxf

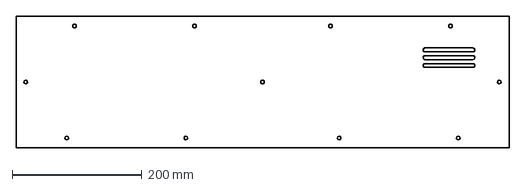
[picture p262: CAD file, 2026-10-13]
hardware/vehicle/models/vehicle/v21_split_ports/output/shell_side_l.dxf
760.0 x 203.0 mm
