chungddong/NUBI/hardware/vehicle/models/vehicle/v22_headlight/output/shell_rear.dxf

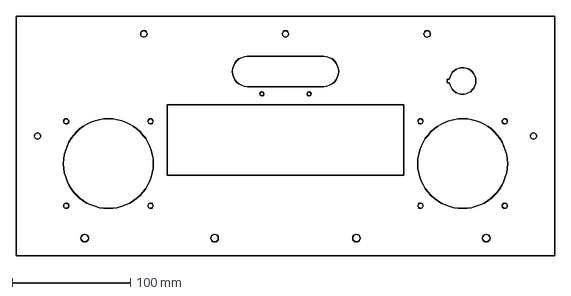
[picture p263: CAD file, 2026-10-13]
hardware/vehicle/models/vehicle/v22_headlight/output/shell_rear.dxf
456.0 x 203.0 mm
