chungddong/NUBI/hardware/vehicle/models/vehicle/v27_sensor_module/output/shell_lid_l.dxf

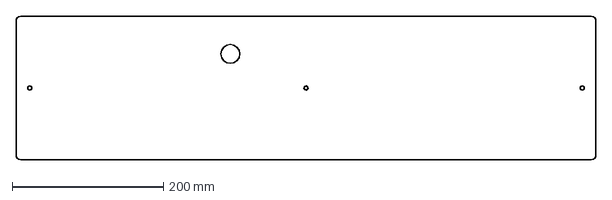
[picture p267: CAD file, 2026-10-13]
hardware/vehicle/models/vehicle/v27_sensor_module/output/shell_lid_l.dxf
766.0 x 189.0 mm
