chungddong/NUBI/hardware/vehicle/models/vehicle/v28_wiring/output/shell_lid_l.dxf

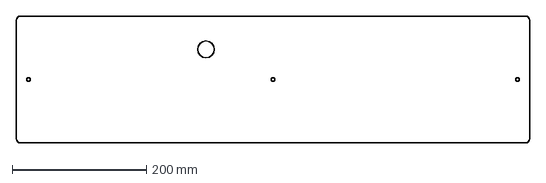
[picture p268: CAD file, 2026-10-13]
hardware/vehicle/models/vehicle/v28_wiring/output/shell_lid_l.dxf
766.0 x 189.0 mm
