chungddong/NUBI/hardware/vehicle/models/hoverboard_mount/output/dxf/low_clamp_views.dxf

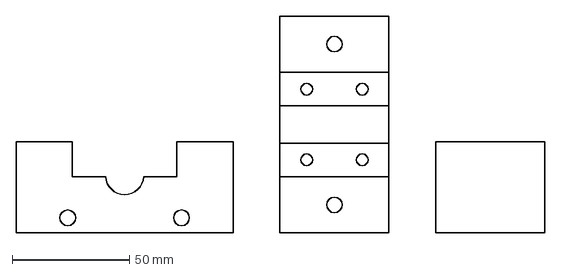
[picture p270: CAD file, 2026-10-13]
hardware/vehicle/models/hoverboard_mount/output/dxf/low_clamp_views.dxf
225.9 x 92.7 mm
