chungddong/NUBI/hardware/vehicle/models/hoverboard_mount/output/stl/prototype_axle_clamp_lower.stl

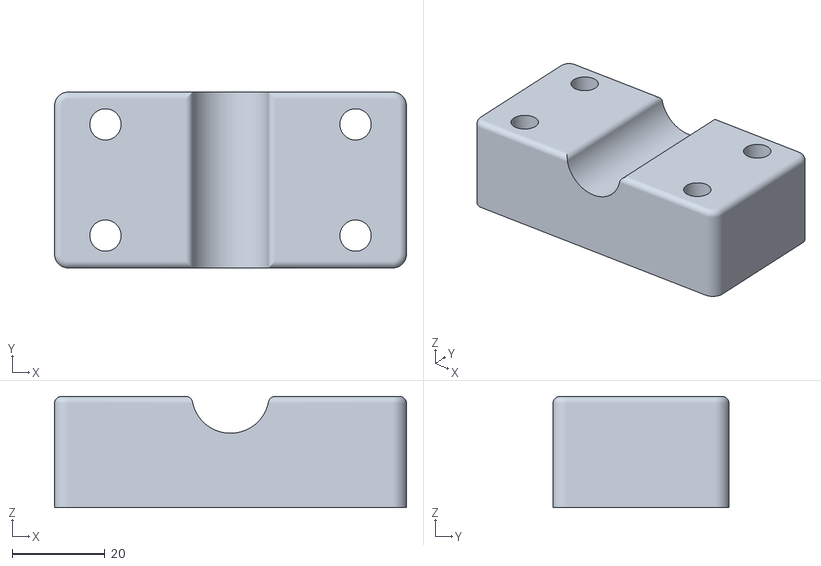
[picture p271: CAD file, 2026-10-13]
hardware/vehicle/models/hoverboard_mount/output/stl/prototype_axle_clamp_lower.stl
76.0 x 38.0 x 24.0
