chungddong/NUBI/hardware/vehicle/models/vehicle/v10_shell/output/shell_lid.dxf

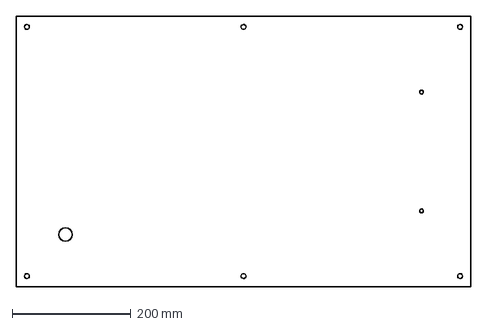
[picture p272: CAD file, 2026-10-13]
hardware/vehicle/models/vehicle/v10_shell/output/shell_lid.dxf
766.0 x 456.0 mm
