chungddong/NUBI/hardware/vehicle/models/vehicle/v12_nofender/output/shell_side_r.dxf

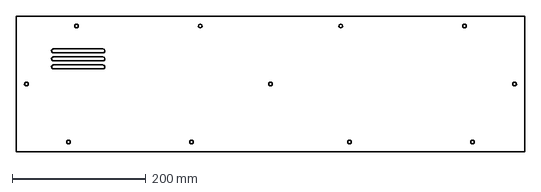
[picture p274: CAD file, 2026-10-13]
hardware/vehicle/models/vehicle/v12_nofender/output/shell_side_r.dxf
760.0 x 203.0 mm
