chungddong/NUBI/hardware/vehicle/models/vehicle/v14_rear_io/output/shell_side_r.dxf

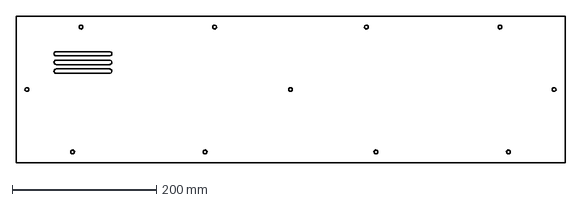
[picture p276: CAD file, 2026-10-13]
hardware/vehicle/models/vehicle/v14_rear_io/output/shell_side_r.dxf
760.0 x 203.0 mm
