chungddong/NUBI/hardware/vehicle/models/vehicle/v15_rear2/output/shell_side_r.dxf

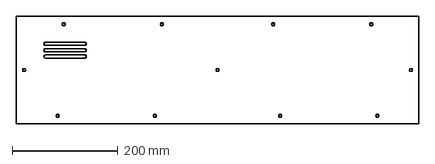
[picture p277: CAD file, 2026-10-13]
hardware/vehicle/models/vehicle/v15_rear2/output/shell_side_r.dxf
760.0 x 203.0 mm
