chungddong/NUBI/hardware/vehicle/models/vehicle/v24_camera_mouth/output/floor_plate.dxf

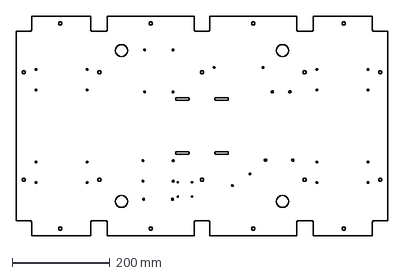
[picture p286: CAD file, 2026-10-13]
hardware/vehicle/models/vehicle/v24_camera_mouth/output/floor_plate.dxf
760.0 x 450.0 mm
