chungddong/NUBI/hardware/vehicle/models/hoverboard_mount/output/step/adapter_plate.step

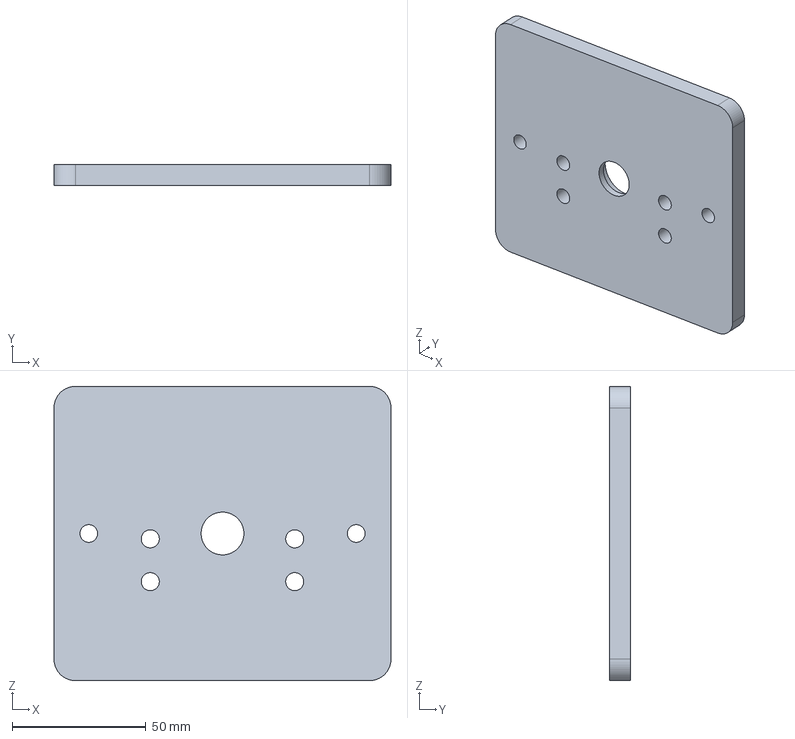
[picture p292: CAD file, 2026-10-13]
hardware/vehicle/models/hoverboard_mount/output/step/adapter_plate.step
126.0 x 8.00 x 110.0 mm
