chungddong/NUBI/hardware/vehicle/models/hoverboard_mount/output/stl/prototype_axle_clamp_upper.stl

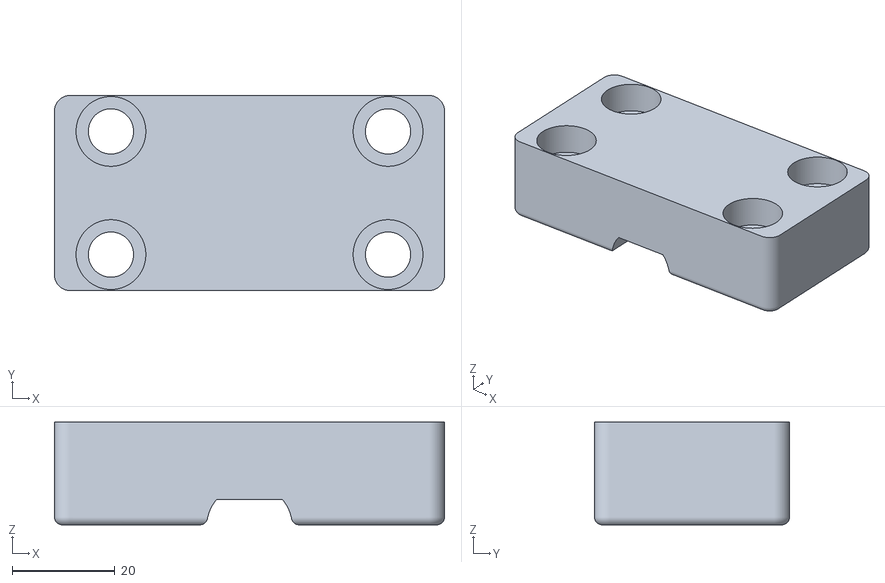
[picture p293: CAD file, 2026-10-13]
hardware/vehicle/models/hoverboard_mount/output/stl/prototype_axle_clamp_upper.stl
76.0 x 38.0 x 20.0
