chungddong/NUBI/hardware/vehicle/models/vehicle/v10_shell/output/shell_side_l.dxf

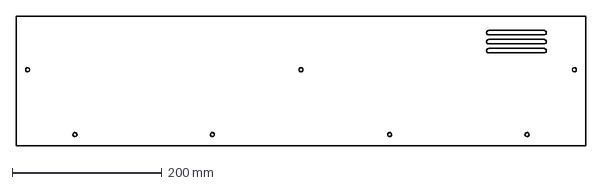
[picture p294: CAD file, 2026-10-13]
hardware/vehicle/models/vehicle/v10_shell/output/shell_side_l.dxf
760.0 x 173.0 mm
