chungddong/NUBI/hardware/vehicle/models/vehicle/v26_module_rails/output/shell_lid_l.dxf

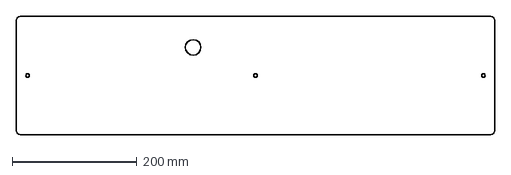
[picture p296: CAD file, 2026-10-13]
hardware/vehicle/models/vehicle/v26_module_rails/output/shell_lid_l.dxf
766.0 x 189.0 mm
