chungddong/NUBI/hardware/vehicle/models/vehicle/v27_sensor_module/output/shell_side_l.dxf

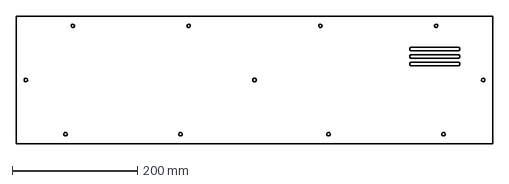
[picture p297: CAD file, 2026-10-13]
hardware/vehicle/models/vehicle/v27_sensor_module/output/shell_side_l.dxf
760.0 x 203.0 mm
