chungddong/NUBI/hardware/vehicle/models/hoverboard_mount/output/step/hoverboard_motor_reference.step

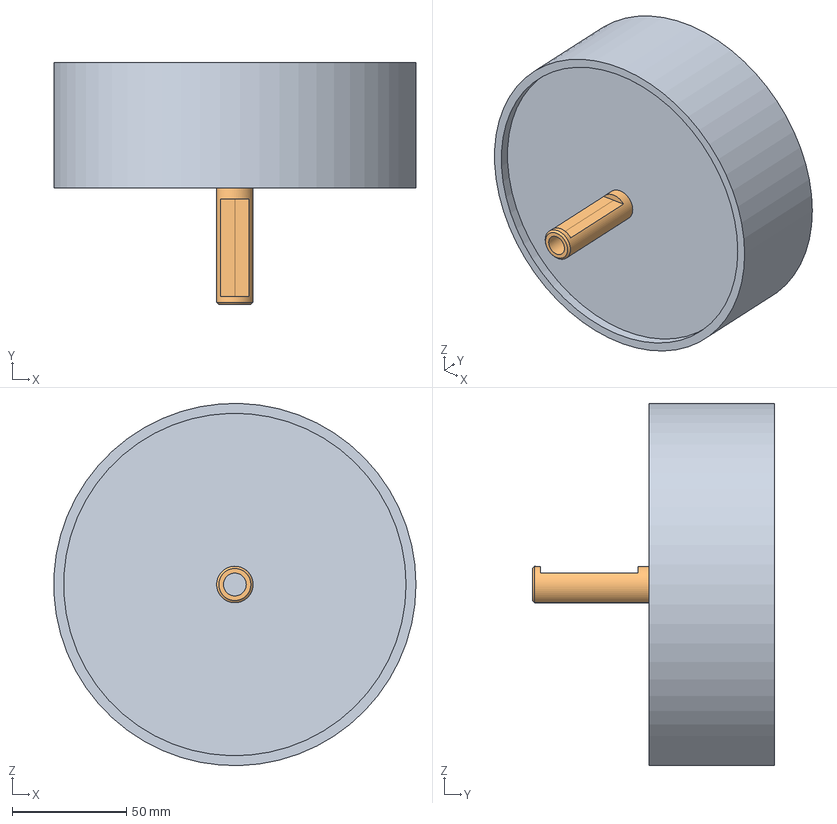
[picture p306: CAD file, 2026-10-13]
hardware/vehicle/models/hoverboard_mount/output/step/hoverboard_motor_reference.step
158.6 x 106.1 x 158.6 mm
