chungddong/NUBI/hardware/vehicle/models/hoverboard_mount/output/step/low_clamp_design_d.step

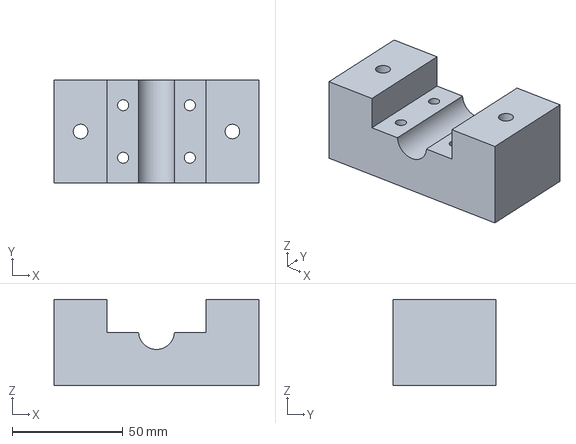
[picture p307: CAD file, 2026-10-13]
hardware/vehicle/models/hoverboard_mount/output/step/low_clamp_design_d.step
92.7 x 46.6 x 38.9 mm
