chungddong/NUBI/hardware/vehicle/models/hoverboard_mount/output/step/3030_extrusion_reference.step

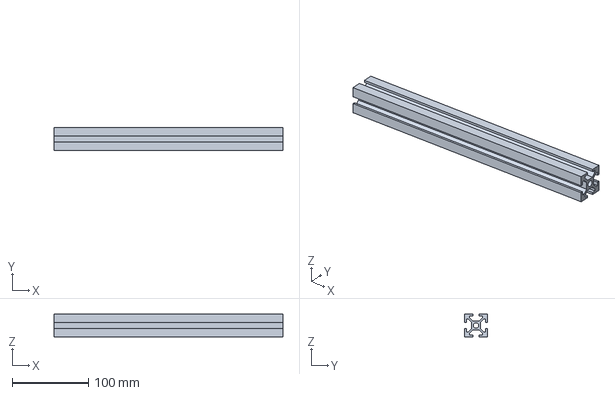
[picture p308: CAD file, 2026-10-13]
hardware/vehicle/models/hoverboard_mount/output/step/3030_extrusion_reference.step
300.0 x 30.0 x 30.0 mm
