chungddong/NUBI/hardware/vehicle/models/hoverboard_mount/output/step/axle_retainer.step

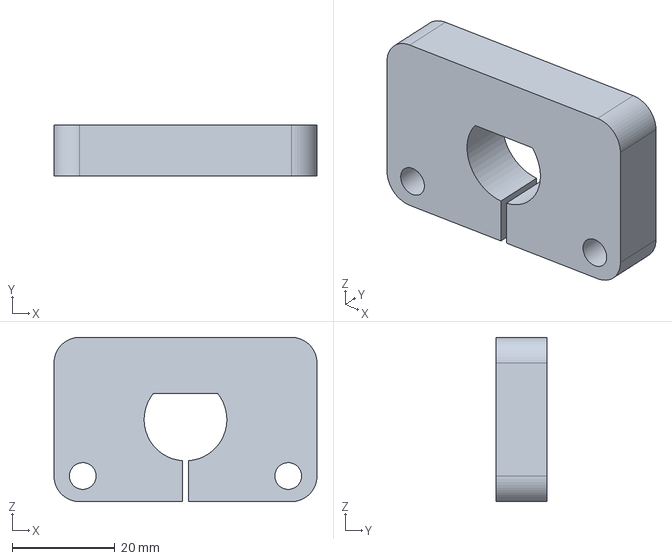
[picture p310: CAD file, 2026-10-13]
hardware/vehicle/models/hoverboard_mount/output/step/axle_retainer.step
51.2 x 10.0 x 32.0 mm
