chungddong/NUBI/hardware/vehicle/models/hoverboard_mount/output/step/saddle_bracket.step

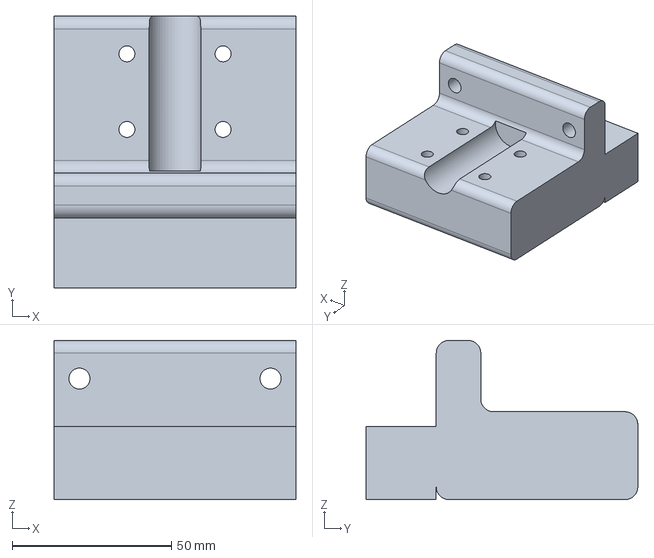
[picture p311: CAD file, 2026-10-13]
hardware/vehicle/models/hoverboard_mount/output/step/saddle_bracket.step
76.0 x 85.3 x 50.0 mm
