chungddong/NUBI/hardware/vehicle/models/hoverboard_mount/output/step/torque_plate.step

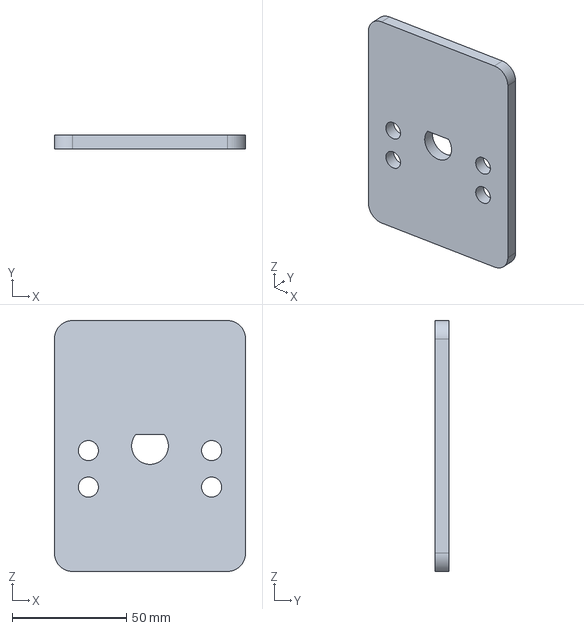
[picture p312: CAD file, 2026-10-13]
hardware/vehicle/models/hoverboard_mount/output/step/torque_plate.step
83.8 x 6.00 x 110.0 mm
