chungddong/NUBI/hardware/vehicle/models/hoverboard_mount/output/step/floor_plate.step

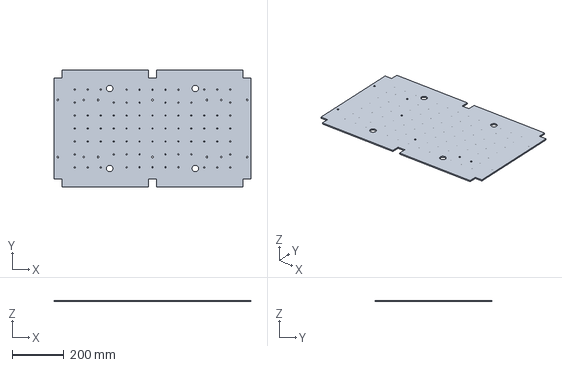
[picture p314: CAD file, 2026-10-13]
hardware/vehicle/models/hoverboard_mount/output/step/floor_plate.step
760.0 x 450.0 x 5.00 mm
