chungddong/NUBI/(list of files, cad)

Other CAD files:
hardware/vehicle/models/hoverboard_mount/output/stl/design_d_lower_clamp_print_tongue.stl
hardware/vehicle/models/hoverboard_mount/output/stl/design_d_lower_clamp_print.stl
hardware/vehicle/models/vehicle/v25_top_cover/output/shell_rear.dxf
hardware/vehicle/models/hoverboard_mount/output/step/axle_clamp_upper.step
hardware/vehicle/models/hoverboard_mount/output/stl/design_d_lower_clamp_print_tongue_cableR.stl
hardware/vehicle/models/hoverboard_mount/output/step/low_clamp_design_d_tongue_cable.step
hardware/vehicle/models/hoverboard_mount/output/step/axle_clamp_lower.step
hardware/vehicle/models/hoverboard_mount/output/dxf/floor_plate.dxf
hardware/vehicle/models/hoverboard_mount/output/dxf/floor_plate_min.dxf
hardware/vehicle/models/hoverboard_mount/output/step/legacy_u_bracket_no_gussets.step
hardware/vehicle/models/hoverboard_mount/output/step/legacy_u_bracket_no_gussets_open_inboard.step
hardware/vehicle/models/hoverboard_mount/output/step/low_clamp.step
hardware/vehicle/models/hoverboard_mount/output/step/low_clamp_design_d_tieprof.step
hardware/vehicle/models/hoverboard_mount/output/stl/adapter_plate.stl
hardware/vehicle/models/hoverboard_mount/output/stl/axle_clamp_lower.stl
hardware/vehicle/models/hoverboard_mount/output/stl/axle_clamp_upper.stl
hardware/vehicle/models/hoverboard_mount/output/stl/axle_retainer.stl
hardware/vehicle/models/hoverboard_mount/output/stl/low_clamp.stl
hardware/vehicle/models/hoverboard_mount/output/stl/saddle_bracket.stl
hardware/vehicle/models/hoverboard_mount/output/stl/torque_plate.stl
