chungddong/NUBI/hardware/vehicle/models/vehicle/research/2026-10-05_wiring.md

# 배선 부품 국내 구매처 조사 (2026-10-05)

v28 내부 배선 (DECISIONS D-20) 에 쓸 부품을 **국내 판매처**만 찾았다 (해외직구 · 구매대행 제외, 디바이스마트는 접속 안 됨).
쿠팡 · G마켓 · 네이버쇼핑은 봇 차단으로 열리지 않았다. 다나와 · 11번가의 DC 차단기 · 버스바 · PV 퓨즈는 대부분 '해외' 표시 구매대행이라 뺐다.
엘레파츠는 VAT 별도 표기 → 괄호에 VAT 포함 계산값. 메가에너텍은 VAT 표기 없음.

## 보호 (분기 차단기 · 퓨즈)

| 품목 | 판매처 | 모델 · 규격 | 단가 | 링크 | 비고 |
|---|---|---|---|---|---|
| DC 차단기 1P | 메가에너텍 | 250 VDC, **20 / 40 / 63 A 만** | 7,000 | [504](https://mega-tec.co.kr/product/detail.html?product_no=504) · [547](https://mega-tec.co.kr/product/detail.html?product_no=547) | 10 · 6 · 4 · 3 A 없음 |
| DIN 레일 | 메가에너텍 | 100 / 160 mm | 350 / 450 | [505](https://mega-tec.co.kr/product/detail.html?product_no=505) | TS35 추정 |
| DIN 스토퍼 | 메가에너텍 | 엔드 스톱 | 300 | [506](https://mega-tec.co.kr/product/detail.html?product_no=506) | |
| DC 퓨즈 홀더 | 메가에너텍 | 1P 1000 VDC 32 A, 10×38 | 3,200 | [507](https://mega-tec.co.kr/product/detail.html?product_no=507) | 치수 미확인 |
| PV 퓨즈 10×38 | 메가에너텍 | 15 / 20 / 30 A | 1,600 / 2,500 / 3,200 | [508](https://mega-tec.co.kr/product/detail.html?product_no=508) | 4 · 6 · 10 A 없음 |

- 소용량 DC MCB 국내 미확인. 나비엠알오 카콘 KMCB-D 10 A (2,190, VAT 별도) · 대륙 DCP30SS 는 **AC 정격만** 표기.
- 1P 핀 부스바 (18 mm 피치) 국내 미확인 — 슈나이더 콤 부스바 2P 12 모듈 (43,989) 만. → 차단기 입력은 **점퍼선**으로 잇는다.
- 4 · 6 · 10 A gPV 퓨즈 국내 미확인 (지멘스 3NW 10×38 은 약 10 만 원).
- M6 음극 버스바 (150 A, 커버) 국내 재고 미확인 — 전부 구매대행. → **전기자재 N 단자대**로 대체 (구매처 확인 필요).

## 커넥터 · 단자 · 전선

| 품목 | 판매처 | 모델 · 규격 | 단가 | 링크 | 비고 |
|---|---|---|---|---|---|
| XT90 암 | 엘레파츠 | AMASS XT90H-F | 950 (1,045) | [12773228](https://www.eleparts.co.kr/goods/view?no=12773228) | 10 AWG 10 cm 피그테일형 2,850 |
| XT90 암 | 나비엠알오 | Amass XT90H-F 29.7 × 20.8 | 1,390 / 1,529 | [2455366](https://www.navimro.com/g/2455366/) | |
| XT90S 세트 | 엘레파츠 | 씨랩 암 · 수 | 3,800 (4,180) | [9655116](https://www.eleparts.co.kr/goods/view?no=9655116) | 재고 '게시판 문의' |
| 실리콘선 | 11번가 우리파파 | 10 / 14 / 18 / 22 AWG 1 m | 1,860 / 770 / 420 / 320 | [3306373594](https://www.11st.co.kr/products/3306373594) | 배송비 3,000, 국내 발송. 적 · 흑 옵션 미확인 |
| 실리콘선 롤 | 엘레파츠 | CBAZY 18 AWG 15 m | 색당 16,500 (VAT 별도) | | 대안 |
| 링단자 세트 | 엘레파츠 | Coms IT-300 (300 개) | 10,818 (11,900) | [4063230](https://www.eleparts.co.kr/goods/view?no=4063230) | M4/M5/M6 구성 미확인 |
| 페룰 세트 | 엘레파츠 | Coms HA067 | 4,255 (4,680) | [18976115](https://www.eleparts.co.kr/goods/view?no=18976115) | |
| WAGO 221-415 | 엘레파츠 | 5 구 레버 | 770 (847) | [7275762](https://www.eleparts.co.kr/goods/view?no=7275762) | 나비엠알오 5 개 4,719 |
| DC 플러그 | 엘레파츠 | STech 납땜형 5.5 / 2.5 | 625 (VAT 별도) | [6783563](https://www.eleparts.co.kr/goods/view?no=6783563) | 18 AWG 직접 연결 |

- WAGO 221-500 캐리어는 엘레파츠 '해외' 품목뿐 → 양면테이프 · 타이 마운트로.

## USB · 케이블

| 품목 | 판매처 | 모델 | 단가 | 링크 | 비고 |
|---|---|---|---|---|---|
| 유전원 USB 허브 | 엘레파츠 / 나비엠알오 | POWERLAN PL-UH307P USB 3.0 7 포트, **130 × 46 × 22**, 5 V 2 A | 21,000 (23,100) | [12485398](https://www.eleparts.co.kr/goods/view?no=12485398) · [K58600994](https://www.navimro.com/p/K58600994/) | 잭 규격 미확인 |
| 유전원 USB 허브 | 다나와 | ipTIME UH308 8 포트 179 × 44 × 23 | 27,900 | [다나와](https://prod.danawa.com/info/?pcode=2223672) | 대안 |
| USB-C ↔ A 3.0 50 cm | 엘레파츠 | Coms HB081 | 4,109 (VAT 별도) | [12185318](https://www.eleparts.co.kr/goods/view?no=12185318) | |
| 마이크로 5 핀 ↔ A 0.3 m | 엘레파츠 | NEXI NX15 | 603 (VAT 별도) | [2933871](https://www.eleparts.co.kr/goods/view?no=2933871) | ESP32 |
| CAT6 30 cm | 엘레파츠 | Coms C3898 | 1,318 (VAT 별도) | [2922243](https://www.eleparts.co.kr/goods/view?no=2922243) | |
| USB 3.0 A ↔ A 0.5 m | 엘레파츠 | NEXT-1672U3-AA | 1,536 (VAT 별도) | [17672924](https://www.eleparts.co.kr/goods/view?no=17672924) | |

## 표시등 스위치 · 정리 · 기타

| 품목 | 판매처 | 모델 | 단가 | 링크 | 비고 |
|---|---|---|---|---|---|
| MOSFET 1 채널 | 메카솔루션 | 15 A MOSFET 트리거, 로직 3.3~20 V, 부하 5~36 V, 로우사이드 | 700 | [605618](https://mechasolution.com/goods/goods_view.php?goodsNo=605618) | '구매 불가' 표시 — 재고 확인, 치수 미확인 |
| MOSFET 4 채널 | 메카솔루션 | IRF540N | 22,000 | [71687](https://mechasolution.com/goods/goods_view.php?goodsNo=71687) | 로직 레벨 아님 — 3.3 V 구동 부적합할 수 있음 |
| 헬리컬 밴드 | 나비엠알오 | NV-SWB-12 (외경 12, 4 m) · -14 | 800 · 600 (VAT 별도) | [2038375](https://www.navimro.com/g/2038375/) | |
| 접착 타이 마운트 | 나비엠알오 | 동아베스텍 DAMB-10 (1,000 개) | 19,990 (VAT 별도) | [374730](https://www.navimro.com/g/374730/) | 소량 구매처 미확인 |
| 케이블 타이 | 나비엠알오 | 100 × 2.5 (1,000 개) / 140 × 3.6 | 2,790 / 6,390 (VAT 별도) | [1062007](https://www.navimro.com/g/1062007/) | |
| 프리차지 저항 | 나비엠알오 | 바로전자 WCR 시멘트 100 Ω 20 W / 10 W (10 개) | 11,990 / 7,690 (VAT 별도) | [2418854](https://www.navimro.com/g/2418854/) | 필요할 때만 (D-20) |

## 국내에서 못 구한 것

소용량 (10 A 이하) DC MCB · 1P 핀 부스바 · 4/6/10 A gPV 퓨즈 · M6 음극 버스바 · WAGO 221-500 — D-20 에서 대체품으로 정했다.
