chungddong/NUBI/hardware/vehicle/models/vehicle/v29_floor_wiring/images/change_01_part_battery.png

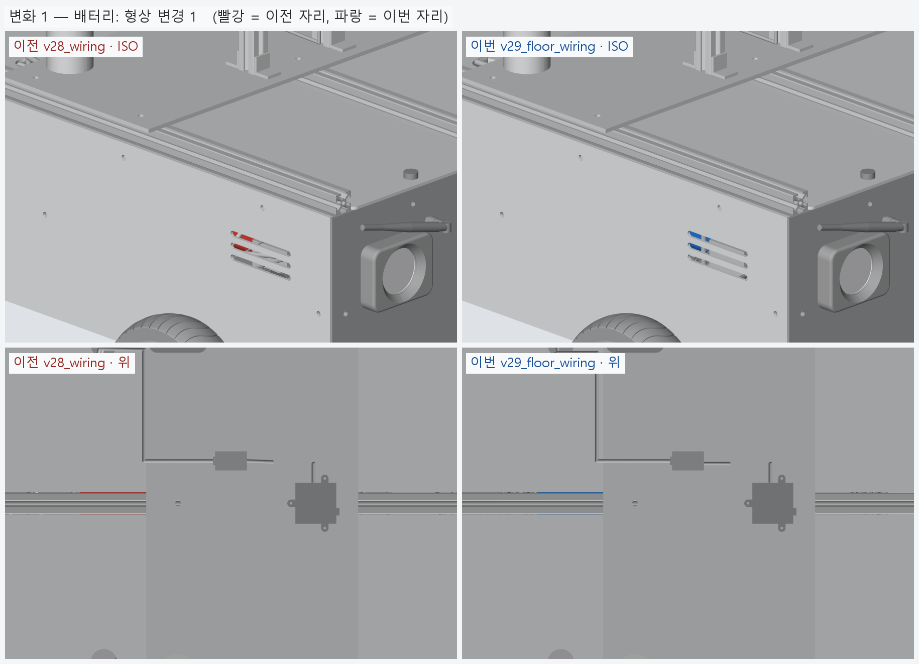
hardware/vehicle/models/vehicle/v29_floor_wiring/images/change_01_part_battery.png
