chungddong/NUBI/hardware/vehicle/models/vehicle/v29_floor_wiring/images/change_03_dist_nbar.png

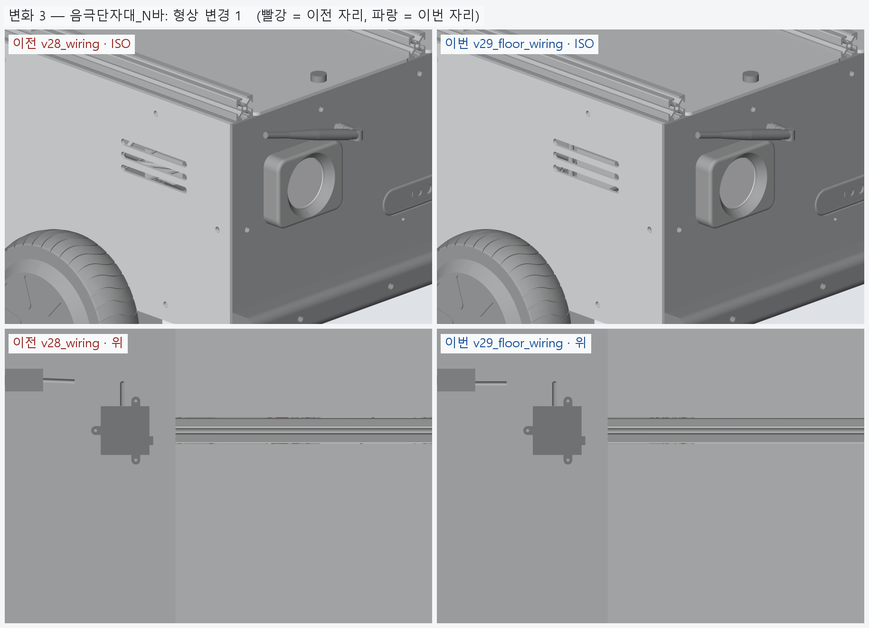
hardware/vehicle/models/vehicle/v29_floor_wiring/images/change_03_dist_nbar.png
