chungddong/NUBI/experiments/2026-10-13_sfm-relocalization/README.md

# 2026-10-13 · SfM 지도로 카메라 위치 다시 찾기 (정확도 재기)

> 상태: **진행 중** — 2026-10-14 Jetson 으로 옮겨 (numpy + OpenCV) 같은 영상 안의 leave-out 측정을 마쳤다 (아래 결과).
> 다음은 차 높이 Xtion 사진으로 재기. 10-13 PC 첫 실행은 PC 가 멈춰 중단 (아래 '주의').

## 1. 목적

차가 카메라 사진만으로 복도 지도 위 자기 위치를 얼마나 정확히 찾는지 잰다. 시뮬레이터 '지도 + 오도메트리 + 시각 위치
인식' 모드는 지금 "걸음마다 80 % 확률로 ± 0.15 m" 를 [가정] 하고 있다 — 이 값을 실측으로 바꾸는 것이 목표.
실제로 돌릴 곳은 차의 Jetson 이므로 Jetson 에서 잰다.

## 2. 구성

- 자료 (읽기만): 복도 영상 263 프레임의 SIFT 특징점 DB (`sfm/database.db`), COLMAP 복원 (`sfm/model/1`, 3D 점 51,220 ·
  관측 389,085), 지도 좌표 변환 (`align.json`), 프레임 사진 (`frames/`, 1920×1080). 원본은 `F:\Develop\hallway-3d\tools\work\`
  (출처 `F:\hallway-3d-data` 압축, 설명은 그 안 `README_DATA.md`). 사진에 사람이 찍혀 있어 **저장소에 넣지 않는다**.
  Jetson 에는 `WITH_SFM=1 bash experiments/2026-10-13_vlm-drive/to_jetson.sh` 로 `~/NUBI/data/hallway-sfm` 에 복사 (278 MB).
- 코드
  - `colmap_lite.py` — COLMAP 바이너리 지도 · DB 읽기 (numpy), OpenCV SIFT 를 COLMAP 꼴로 뽑기, PnP (OpenCV).
    Jetson (aarch64) 에는 pycolmap 휠이 없어서 새로 짰다.
  - `localizer.py` — 사진 한 장 → 지도 위 카메라 자세 (실차 `vision_fix.py` · 다시 돌려 보기 `replay.py` 가 쓴다). 오도메트리 위치
    근처 (반경 6 m · 비슷한 방향) 지도 사진의 관측만 맞춰 Jetson 1.0 s, 지도 전체 6.4 s. 카메라 높이가 범위 밖인 답은 버림.
  - `locate_run.py` — 녹화 (vlm-drive/record.py) 사진을 차례로 지도에 (2026-10-14 첫 주행: 웹캠 · Xtion 비교).
  - `relocalize.py` — leave-out 평가. 질의 프레임과 앞뒤 ± K 프레임의 관측을 지도에서 빼고, 질의 특징점을 남은 3D 점
    기술자와 맞춰 (전수 최근접 + 비율 시험, 가장 가까운 *다른* 3D 점과 비교) PnP RANSAC 으로 자세를 구한 뒤, 복원에 있는
    그 프레임 자세와 비교한다. 오차는 지도 좌표 m.
    - 질의 특징점 `--features db` (지도를 만든 그 특징점) · `--features opencv` (프레임 사진에서 OpenCV 로 다시 뽑음 —
      실제 카메라와 같은 길)
    - 변형 `full` (지도 전체), `low` (높이 0.8 m 밑 점만 — 낮은 로봇 카메라를 거칠게 흉내), `full_sfm` (비교용)
    - K = 0, 15, 40 프레임 (5 fps — ± 0 · 3 · 8 초)
- 파이썬: numpy · OpenCV (· matplotlib, 없으면 그림만 빠짐). PC 는 `experiments/2026-10-13_vlm-drive/.venv`, Jetson 은 시스템
  python3 (numpy 1.21 · OpenCV 4.5.4 · OpenBLAS).

```bash
# Jetson (~/NUBI/experiments/2026-10-13_sfm-relocalization)
python3 relocalize.py --step 6 --ks 0,15,40 --tag _jetson_db
python3 relocalize.py --features opencv --step 6 --ks 0,15,40 --tag _jetson_cv
```

### 옮기면서 확인한 것 (2026-10-14)

| 확인 | 결과 |
| --- | --- |
| `colmap_lite.read_model` vs pycolmap 4.2.1 (PC) | 사진 263 · 점 51,220 같음. 회전 차 최대 4e-16, 위치 · 특징점 · 3D 점 · 트랙 차 0, 왜곡 풀기 차 1e-13 |
| OpenCV SIFT ↔ DB SIFT (같은 프레임 3 장) | 같은 자리 특징점의 기술자 거리 중앙 59 ~ 66 (아무 짝 430 ~ 460). 비율 시험을 통과한 짝의 97 ~ 98 % 가 같은 자리 (2 px 안) — 그대로 맞춰 쓸 수 있다 |
| Jetson 행렬곱 (numpy, OpenBLAS) | 94 GFLOPS (1000×128 · 128×250k, 0.68 s) |

매칭은 원래 torch 로 상위 32 개를 골랐는데, numpy 로 옮기면서 '가장 가까운 점 → 그 3D 점의 관측을 모두 가리고 다시 최솟값'
두 번으로 바꿨다 (가장 가까운 *다른* 3D 점을 정확히 찾고, 상위 k 정렬보다 빠르다). PnP 는 pycolmap LO-RANSAC 대신
OpenCV `solvePnPRansac` (AP3P) → `solvePnPRefineLM` 두 번.

## 주의 — 그래픽카드로 돌리지 말 것

2026-10-13 첫 실행은 PC 그래픽카드 (RTX 3070, CUDA) 로 특징점 거리 행렬 (블록당 약 1 ~ 2 GB) 을 계산했고, 같은 때 앱
브라우저의 시뮬레이터 (WebGL) 도 돌고 있었다. 20:43 ~ 20:49 사이 화면이 꺼지고 시스템이 멈췄다 (Windows 기록:
Kernel-Power 41, 블루스크린 기록 없음). 원인이 직접 기록되지는 않았지만 그래픽카드 과부하가 가장 유력하다.
지금 코드는 torch 를 쓰지 않고 CPU (numpy) 로만 계산한다.

## 3. 결과 (2026-10-14, Jetson, 질의 44 장 = 6 프레임마다)

자세한 표: [results_jetson_db.md](results_jetson_db.md) (DB 특징점) · [results_jetson_cv.md](results_jetson_cv.md) (OpenCV 로
다시 뽑음), 질의마다 `per_query_jetson_*.csv`, 누적 분포 `error_cdf_jetson_*.png`. 프레임 사이 이동 중앙 0.21 m 이라
K = 15 는 질의 앞뒤 약 ± 3.2 m, K = 40 은 약 ± 8.4 m 의 지도 사진을 뺀 것이다.

| 질의 특징점 | 변형 | K | 성공률 | 수평 오차 중앙 / 90 % | 회전 오차 중앙 | 인라이어 중앙 | 질의 1 장 (K = 0) |
| --- | --- | ---: | ---: | ---: | ---: | ---: | ---: |
| DB | 전체 지도 | 15 | 97.7 % | 1.0 / 2.5 cm | 0.06° | 161 | 16.4 s |
| DB | 낮은 점만 | 15 | 97.7 % | 3.0 / 8.6 cm | 0.21° | 71 | |
| DB | 전체 지도 | 40 | 38.6 % | 5.0 / 15.4 cm | 0.48° | 28 | |
| DB | 낮은 점만 | 40 | 2.3 % | – | – | 10 | |
| OpenCV | 전체 지도 | 15 | 97.7 % | 1.1 / 2.8 cm | 0.07° | 138 | 13.0 s |
| OpenCV | 낮은 점만 | 15 | 97.7 % | 2.9 / 7.7 cm | 0.26° | 64 | |
| OpenCV | 전체 지도 | 40 | 27.3 % | 5.6 / 137 cm | 0.58° | 26 | |
| OpenCV | 낮은 점만 | 40 | 0 % | – | – | 8 | |
| *시뮬레이터 가정* | | | 80 % | 17.7 / 32.2 cm | 2.0° | | |

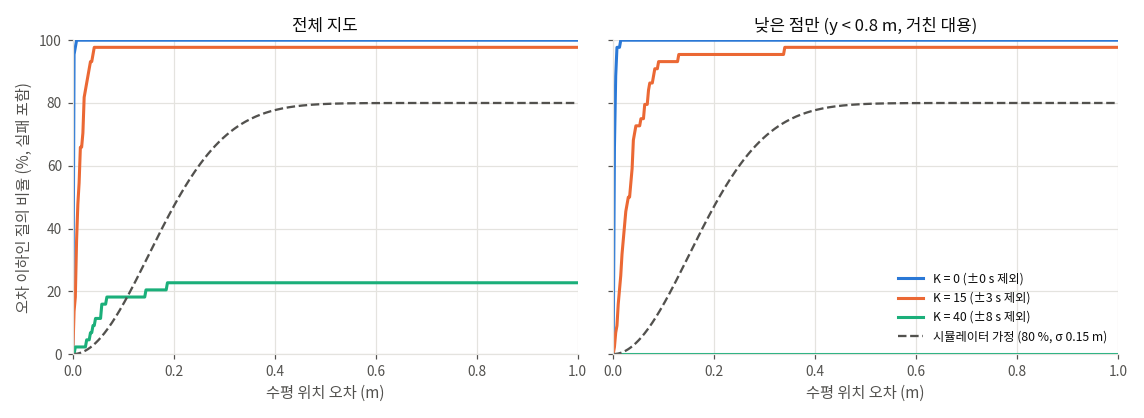
[picture p340: experiments/2026-10-13_sfm-relocalization/error_cdf_jetson_cv.png]
수평 오차 누적 분포 (OpenCV 특징점)


- **OpenCV 로 다시 뽑아도 DB 특징점과 거의 같다** (K = 15 에서 1.1 vs 1.0 cm). 실제 카메라에서 쓸 길 (사진 → OpenCV SIFT →
  지도 매칭 → PnP) 이 이 지도와 맞는다.
- **지도 사진이 ± 3 m 안에 있으면 거의 다 찾고 (43 / 44), ± 8 m 를 빼면 크게 떨어진다.** K = 40 실패는 복도 뒤쪽 (가장
  가까운 지도 사진 8 ~ 9 m) 과 **라운지에서 돌아오는 길**에 몰렸다. 돌아오는 길은 가장 가까운 지도 사진이 1 ~ 2 m 인데도
  실패했다 — 그 사진들은 반대 방향을 보고 찍은 것이다. 지도는 차가 다닐 **두 방향 모두**로 찍어야 한다.
- **인라이어 30 은 오답을 다 거르지 못한다.** OpenCV K = 40 의 1 m 넘는 오답 2 개 (1.5 · 1.9 m) 는 인라이어 33 · 38 이었고,
  인라이어 40 이상은 모두 0.2 m 안이었다. 실차에서는 인라이어 기준을 올리고 (≥ 50) 오도메트리 위치와 크게 다르면 버린다.
- **시간**: 지도 전체 (관측 39 만) 와 전수 비교라 질의 1 장에 13 ~ 16 s (거의 매칭). 실차에서는 오도메트리 위치 근처
  지도 사진의 관측만 쓰면 줄어들 것 — 아직 재지 않았다.

## 4. 결론

- 계산 방법과 Jetson 구현은 쓸 수 있다. 같은 영상 안의 시험이라 숫자는 **낙관적인 위쪽 한계**다: 질의 사진이 지도와 같은
  휴대폰 · 같은 1.37 m 높이 · 같은 날 조명이다. '낮은 점만' 도 지도 쪽만 낮은 점으로 줄였을 뿐 질의는 1.37 m 사진이다.
- 실차에서 의미 있는지는 **차 높이의 Xtion 사진**으로 다시 재야 정해진다 (다음 시험: 복도를 지나며 Xtion 으로 찍고, 문
  앞 몇 곳을 정답으로 표시. 같은 길을 Xtion 을 1.4 m 로 들고 한 번 더 찍어 높이 효과와 카메라 효과를 나눈다).
- 시뮬레이터 `VIS_P` · `VIS_M` · `VIS_DEG` 는 그 실차 결과가 나온 뒤 바꾼다 (지금 값을 이 결과로 바꾸면 너무 낙관적이다).
