chungddong/NUBI/experiments/2026-10-13_vlm-drive/README.md

# 2026-10-13 · GPT · Claude 실차 운전 (Jetson + ESP32 + Xtion)

시뮬레이터 ⑤ "GPT · Claude 운전" 과 같은 방식을 실차로 옮긴 것입니다. Xtion 사진에 깊이로 잰 갈 수 있는 방향을 번호
화살표로 그리고, 위에서 본 복도 지도와 오도메트리 추정 위치를 같이 모델에 보내 한 걸음씩 몹니다. 모델 호출 코드와
프롬프트는 시뮬레이터 것([agent.py](../../hardware/vehicle/models/vehicle/sim/agent.py) ·
[agent_claude.py](../../hardware/vehicle/models/vehicle/sim/agent_claude.py))을 그대로 부릅니다.

## 1. 목적

- 시뮬레이터에서 된 "사진 + 깊이 화살표 + 지도 + 추정 위치 → 모델이 한 걸음 결정 → 차가 닫힌 루프로 실행" 이 실차에서도
  되는지 확인한다.
- 그 전에 실차 쪽 기본기 — ESP32 링크 · 오도메트리 · 돌기 / 가기 · Xtion 깊이 · 사각 정지 — 를 하나씩 확인한다.

## 2. 구성

```
Xtion Pro Live ──USB 2.0 (OpenNI2)──►  Jetson Orin Nano "dongki"  ──USB 시리얼 115200 (CH340)──► LOLIN D32 (ESP32) ──UART──► 호버보드 보드 4장
                                       drive.py                                                    w 1 + h 하트비트, s · t · x
                                         └─ HTTPS ─► OpenAI / Anthropic API (agent.py · agent_claude.py)
```

| 파일 | 하는 일 |
| --- | --- |
| `drive.py` | 본체. 걸음마다 사진 · 깊이 → 화살표 → 지도 · 위치 → 모델 → (Enter 확인) → 실행 → 기록 |
| `wheel_link.py` | ESP32 시리얼. 보고 줄 (200 ms) 해석, 명령, **하트비트 임대** — 제어 루프가 멈추면 1 s 뒤 ESP32 가 선다 |
| `xtion.py` | Xtion (OpenNI2 + `openni` 바인딩, 없으면 `primesense`). 깊이를 컬러 시점에 맞춤 (시작 전), 백그라운드로 읽기, 거울상이면 소프트웨어로 뒤집기 |
| `xtion_no_audio.sh` | Xtion 마이크 (USB 오디오) 를 막는 udev 규칙 — **Jetson 에서 Xtion 을 쓰려면 꼭 필요** (아래 '결과') |
| `hp60c.py` | Nuwa-HP60C 깊이 카메라 — 제조사 SDK 없이 UVC 복합 프레임 (640x642 MJPG) 을 풀어 컬러 + 컬러 시점 깊이. `flip180` |
| `to_jetson.sh` | PC → Jetson `~/NUBI` 로 필요한 것만 복사 (`WITH_KEY=1` 이면 API 키도) |
| `bench.py` · `bench_ctl.sh` | **바퀴 점검 웹 패널** — Jetson 에서 띄우고 PC 브라우저로 `http://192.168.127.2:8090` (유선 직결 주소에만 연다). 네 바퀴 속도 (앞으로 = +) · 앞축 스텝 · 전압 · 링크, 짧은 시험 (최대 3 s) · STOP · '바퀴를 띄웠다' 체크 · 페이지 끊김 정지. `bash bench_ctl.sh start / stop / status`, PC 연습은 `--fake` (`.claude/launch.json` 의 `wheel-bench-fake`) |
| `pad.py` · `pad_ctl.sh` · `pad.json` | **무선 게임패드로 직접 몰기** — 수신기를 Jetson USB 에 꽂고 `python3 pad.py drive`. 버튼 배치는 `pad.py learn` 이 `pad.json` 에 저장, `show` 는 이벤트 그대로. 아래 '게임패드로 직접 몰기' |
| `depth_view.py` | 바닥면 맞추기 (카메라 높이 · 숙임 자동), 방향별 빈 거리, **0.5 m 안쪽 사각** 판정, 화살표 그리기 |
| `odometry.py` | 앞축 홀 스텝 → 지도 위 위치 (추측 항법) |
| `motion.py` | 제자리 돌기 · 곧게 가기 (오도메트리 닫힌 루프, 방향 틀어짐 보정, 깊이 · 시간 · 걸림으로 정지) |
| `hallway_map.py` | 복도 `scene.json` → 지도 그림 · 글 (시뮬레이터 `agent.js` 와 같은 내용, 가구 회색은 빠짐) |
| `calibrate.py` | 연결 확인 · 카메라 바닥면 · 직진 / 회전으로 `m_per_step` · `odo_sign` · `track_eff_m` 재기 |
| `robot.json` | 차마다 값 — 명령 크기, 정지 거리, 오도메트리 보정값 ([가정] 값은 실측으로 바꾼다) |
| `fake.py` · `selftest.py` | 가짜 ESP32 (펌웨어 흉내) · 가짜 Xtion (복도 벽에 광선) 과 자체 시험 |
| `images/` | 결과 사진 (`camera_compare.jpg` — Xtion · HP60C 비교) |
| `record.py` · `record_ctl.sh` · `review.py` · `check_run.py` | **녹화** — Xtion 컬러 · 깊이 · 웹캠 · ESP32 보고 줄을 같은 시계로 5 Hz (`data/logs/hallway-run/<시각>/`, git 밖), 웹 화면 `:8093` 실시간 보기 · 녹화 버튼 (패드로 몰 때는 `pad.py` A 버튼). `review.py` 나란히 미리보기 동영상, `check_run.py` 빠진 사진 · 끊김 · 거리 · 정지 점검 |
| `pose_fusion.py` · `vision_fix.py` | 오도메트리 + 웹캠 위치 인식 (SfM 지도, `../2026-10-13_sfm-relocalization/localizer.py`) — `drive.py --pose vis`. 늦은 답은 찍은 때 기준, 게이트 · 높이 거르기 · 길 잃으면 두 번 맞아야 다시 잡음 |
| `replay.py` · `replay_sim.py` | **녹화 다시 돌려 보기** — 바퀴 보고 줄 + 사진으로 실차와 같은 길, 결과를 시뮬레이터 차로 움직이며 실제 웹캠 \| 3D 지도 렌더 동영상 |
| `sim_bridge.py` | `drive.py --sim` — 바퀴는 가상 ESP32, Xtion 은 시뮬레이터 3D 지도가 그 자리에서 그린 것, 페이지 `?env=hallway&cam=xtion&bridge=1` 의 차가 따라 움직임. 웹캠 위치 인식은 실측 성능으로 흉내 |
| `pad_confirm.py` · `drive_ctl.sh` | 실차 걸음마다 게임패드로 승인 (`drive.py --confirm pad`: START 실행 · 십자 아래 건너뜀 · SELECT 그만, 움직이는 동안 L1) · 이더넷 없이 뒤로 띄우기 |

### 시뮬레이터와 다른 점 (Xtion)

- 화각 약 58° × 45° (Gemini 336 은 90° × 65°) → 화살표는 ±24°, ±16°, ±8°, 0° 의 7 개.
- 약 0.5 m 안쪽은 깊이가 0 이다 (2026-09-17 RDK 가드에서 확인). 바닥이 0.65 ~ 2 m 에 보여야 할 줄이 비어 있으면
  그 방향을 '사각 → 막힘 0.3 m' 로 친다. 정면이 사각이면 가던 것도 선다.
- 카메라 장착 높이 · 숙임은 시작할 때 바닥면으로 잰다. 바닥이 안 보이면 `robot.json` 의 `camera_height_m` 를 쓴다.

## 3. Jetson 준비 (한 번)

1. PC (Git Bash) 에서 필요한 것만 Jetson `~/NUBI` 아래 같은 자리로 보낸다 — 이 폴더 (`.venv` 빼고), 시뮬레이터
   `agent.py` · `agent_claude.py`, 복도 지도 `scene.json` (git 밖), API 키 `agent.local.json` (있으면, git 밖).
   유선 직결 주소는 [일지 'Jetson 유선 직결'](../../docs/worklog/2026-10.md) (`dongki@192.168.127.2`).
   ```bash
   bash experiments/2026-10-13_vlm-drive/to_jetson.sh
   ```
2. 키를 Jetson 에 파일로 두기 싫으면 `agent.local.json` 을 지우고 환경변수 (`OPENAI_API_KEY` · `ANTHROPIC_API_KEY`) 로.
3. 지도 경로를 바꾸려면 `HALLWAY_SCENE=경로` 또는 `--scene`.
4. 패키지 (2026-10-14 "mokpo": `libopenni2-0` · OpenCV 4.5 · numpy · Pillow 는 이미 있었다. `python3-venv` 가 없어
   가상환경 대신 사용자 영역에 설치했다):
   ```bash
   python3 -m pip install --user pyserial==3.5 openni==2.3.0
   ```
   Claude 를 쓸 때만 `anthropic` 도. OpenNI2 배포본은 `~/Study/flysim/data/openni2` (초파리 주행 때 것) 를 먼저 쓴다.
5. Xtion 마이크 막기 (sudo, 한 번):
   ```bash
   sudo bash /home/dongki/NUBI/experiments/2026-10-13_vlm-drive/xtion_no_audio.sh
   ```
6. 시리얼: CH340 드라이버 (`ch341.ko`) 와 `brltty` 제거는 2026-09-18 에 이미 했다 ([일지](../../docs/worklog/2026-09.md)).
   사용자가 `dialout` 그룹에 있어야 한다.

## 4. 처음 시험 순서

| 단계 | 명령 | 볼 것 |
| --- | --- | --- |
| 0. PC 자체 시험 | `.venv\Scripts\python.exe selftest.py` | 모두 통과 |
| 1. 연결 | `python3 calibrate.py report` | 전압, `rx` · `rx2` 가 늘어남, `odo` |
| 2. 카메라 | `python3 calibrate.py camera` | 바닥면 높이 · 숙임이 실제 장착과 맞나, 화살표 사진 (`data/logs/vlm-drive/calib_camera.jpg`) |
| 3. 방향 (바퀴 띄움) | `bench.py` 점검판 (2026-10-14 끝남) | 앞으로 / 왼쪽으로 도는지, 홀 스텝 부호 |
| 4. 보정 (바닥) | `python3 calibrate.py straight --runs 3 --write` 다음 `spin --runs 2 --write` | 아래 '바닥 보정' 대로 재서 넣으면 `robot.json` 갱신 |
| 5. 걸음마다 확인하며 운전 | `python3 drive.py --goal 310앞 --model gpt-6-luna` | 걸음마다 모델 결정을 보고 Enter (s = 건너뜀, q = 그만) |
| 6. 자동 | `--auto` | 5 단계가 몇 번 성공한 뒤에만 |

출발은 복도 입구 (지도 x = 1.4, y = 0) 에서 안쪽을 보고 선다 (`--start x,y,방향°` 로 바꿀 수 있다).

### 바닥 보정 — 무엇을 어디서 재나

오도메트리는 **앞축 두 바퀴의 홀 스텝**만 센다. 그래서 거리는 앞바퀴에서, 방향은 한쪽 앞 · 뒤 바퀴 두 점으로 잰다.
차의 위치 (지도 위 점) 는 네 바퀴 접지점 한가운데 (REP-103 `base_link`, 바닥 z = 0) 로 본다.

| 치수 (차체 설계 v29) | 값 |
| --- | --- |
| 휠베이스 (앞뒤 축 사이) | 420 mm |
| 트레드 (좌우 바퀴 중심 사이) | 527.4 mm |
| 바퀴 바깥 지름 | 158.7 mm (실측) → 한 바퀴 498.6 mm. 허브 모터 한 바퀴 90 스텝이면 5.54 mm / 스텝 (지금 `robot.json` 5.76 은 [가정]) |

**표시 붙이는 법 (공통)** — 기준점은 바퀴 **축 중심 바로 아래 바닥**이다. 바퀴 바깥 면 (허브 덮개) 한가운데에 작은
십자를 붙이고, 직각자 (또는 수평계를 댄 자) 를 그 십자에 세워 바닥에 마스킹테이프 + 연필로 점을 찍는다. 바퀴가 굴러도
축 중심은 그대로이니 출발 전 · 멈춘 뒤 같은 방법으로 찍으면 된다. 바닥은 **실제로 다닐 복도 바닥**에서 잰다 (돌 때
미끄러지는 정도가 바닥마다 달라 `track_eff_m` 이 바뀐다). 배터리는 충분히 (40 V 근처).

**직진 → `m_per_step`** (`calibrate.py straight --runs 3 --write`)

1. 앞 2.5 m 를 비우고 바퀴를 똑바로 둔다. 앞 왼쪽 · 앞 오른쪽 바퀴 축 아래에 출발 점을 찍는다.
2. `y` → 2 s 동안 `fwd_cmd` (180) 로 간다 (약 0.6 ~ 1 m).
3. 멈춘 뒤 같은 두 바퀴 아래에 도착 점을 찍고, 바퀴마다 출발 점 → 도착 점 거리를 줄자로 잰다 (mm). 왼쪽 · 오른쪽을 따로 넣는다.
4. 세 번 하면 평균을 적는다. 두 값이 2 cm 넘게 다르면 가는 동안 틀어진 것 — 화면에 몇 도 틀어졌는지 나온다.

**한 바퀴 회전 → `track_eff_m`** (`calibrate.py spin --runs 2 --write` — 왼쪽 · 오른쪽 번갈아 돈다)

1. 둘레 1 m 를 비운다. 앞 왼쪽 · 뒤 왼쪽 바퀴 축 아래에 점을 찍고, 두 점을 지나는 **긴 직선** (마스킹테이프, 앞뒤로 50 cm
   씩 더 길게) 을 바닥에 붙인다.
2. `y` → 지금 `robot.json` 값으로 오도메트리가 한 바퀴 (360°) 가 될 때까지 돈다. 값이 틀린 만큼 실제로는 조금 더 / 덜 돈다.
3. 멈춘 뒤 같은 두 바퀴 축 아래에 점을 찍고, 각 점이 처음 직선에서 **수직으로** 떨어진 거리를 잰다 (mm, 직선 바깥 쪽 = +,
   차 밑 쪽 = −). 앞 · 뒤 두 값을 넣으면 실제 각도 = 360° ± asin((앞 − 뒤) / 420) 로 계산한다. 차가 옆으로 밀려나도
   두 점이 같이 밀리니 각도에는 영향이 없다.
4. 왼쪽 · 오른쪽 값이 따로도 나온다. 둘이 5 % 넘게 다르면 바퀴 공기압 · 무게 쏠림을 보고 `--runs 4` 로 다시 잰다.

### 안전

- 사람이 비상정지 버튼을 들고 따라간다. 처음에는 `robot.json` 의 `max_cmd` 300 · `fwd_cmd` 180 그대로 (느림).
- 모델은 장애물 정지에 끼지 않는다. 가는 중 깊이로 범퍼 앞 0.30 m (`stop_gap_m`) 안이 막히거나 정면이 사각이면 선다.
- 하트비트 임대: 모델 응답을 기다리는 동안 (수 초) 에는 하트비트를 보내지 않는다 → ESP32 가 "host watchdog" 으로 멈춘
  상태로 기다린다. 프로그램이 죽어도 1 s 안에 선다. 끝날 때 `w 0` 으로 워치독을 끄고 나간다 (ISSUES N2).
- 실물 사진에는 사람이 찍힌다. 기록 (`data/logs/vlm-drive/`) 은 git 에 올라가지 않고, 사진은 모델 회사로 간다 —
  학교 쪽 확인이 필요할 수 있다.

### 게임패드로 직접 몰기 (`pad.py`)

ESP32 핫스팟 웹 조종 (폰) 은 자주 끊기고 터치 버튼이라 조작이 거칠었다. 웹 경로에는 늦게 도착한 명령이 바퀴를 다시
돌리는 문제 등이 열려 있다 (펌웨어 ISSUES R1 · R2 · R4 · R5 · U3). 패드는 무선 구간이 패드 ↔ 전용 수신기뿐이고, 그 뒤는
Jetson → USB 시리얼 선 + 하트비트 워치독이다.

```
패드 ──2.4 GHz──► 수신기 (USB, Jetson) ──evdev──► pad.py ──USB 시리얼 (s · t · x · h)──► ESP32 ──► 보드 4 장
```

| 조작 | 하는 일 |
| --- | --- |
| START | 잡기 — `x` · `m 300` · `w 1`. 프로그램을 켜도 START 전에는 아무것도 보내지 않는다 |
| L1 누르는 동안 | 운전 허용 (데드맨). 떼면 바로 `x` (램프 없이) |
| 왼쪽 스틱 위아래 | 속도. 조금만 밀어도 움직이게 펌웨어가 0 으로 치는 50 부터 단계까지 |
| 오른쪽 스틱 좌우 | 조향 (+ = 오른쪽). 서 있으면 제자리 회전. 가면서는 바깥 바퀴를 왼쪽 스틱 세기 그대로 두고 안쪽 바퀴만 줄인다 — 반이면 안쪽 바퀴 0, 끝까지면 거꾸로 (제자리). 두 스틱을 다 놓으면 바로 `x` |
| 십자 위 / 아래 | 속도 단계 100 · 150 (처음) · 200 · 250 · 300 (`max_cmd` 가 상한) |
| R1 누르는 동안 | 한 단계 빠르게 |
| 십자 왼쪽 / 오른쪽 | L1 을 누른 채 (스틱은 놓고) 오도메트리로 제자리 90° 돌기 — `motion.turn_by` 와 같은 규칙 (`turn_cmd` · `turn_tol_deg` · `turn_min_dps`) 을 한 틱씩. L1 을 떼거나 스틱을 건드리면 멈춘다 |
| A | 주행 기록 시작 / 끝 — `record.py` 의 녹화기를 이 프로세스에서 같은 바퀴 링크로 (처음 누를 때 Xtion · 웹캠을 연다, 결과는 `data/logs/hallway-run/<시각>/`, 20 분 뒤 스스로 끝). 사진 5 Hz · 바퀴 보고 줄에 더해 웹캠 동영상 `webcam.mkv` (~30 fps) · 패드 입력 `commands.csv`, 끝나면 `preview.mp4` (세 카메라 나란히, 2 배속) 를 뒤에서 만든다 |
| B | 비상정지 — `x` 하고 놓는다 (잡지 않았어도 `x`). 다시 몰려면 START |
| SELECT | 놓기 — `x` · `w 0`. 폰 웹 조종으로 돌아갈 수 있다 (ISSUES N2) |

```bash
python3 pad.py show                 # 패드가 잡히나, 버튼 · 축 번호
python3 pad.py learn                # 안내대로 눌러 pad.json 저장 (패드를 바꾸면 다시)
python3 pad.py drive --fake         # 가짜 ESP32 로 패드만 시험 — s · t 값이 찍힌다
bash pad_ctl.sh start               # 실물, 뒤로. stop · status · log [줄 수]
bash pad_ctl.sh install             # 부팅하면 스스로 start (사용자 crontab @reboot, sudo 없이). uninstall 로 지움
```

- 안전: 잡은 동안 제어 루프가 돌 때만 하트비트 임대 → 프로그램이 멈추면 1 s 뒤 ESP32 가 선다. 수신기가 빠지면 세우고 놓는다.
  보고 줄이 0.6 s 끊기면 선다. 잡을 때 · 수신기가 다시 붙을 때 L1 이 이미 눌려 있으면 한 번 떼야 움직인다.
- 폰 웹 조종과 같이 쓰지 않는다 — 웹 버튼을 누르는 동안은 시리얼 `x` 가 덮인다 (ISSUES R7).
- 시리얼은 한 프로그램만 연다 (`open_serial` 이 리눅스에서 잠금). `bench.py` 가 돌고 있으면 먼저 끈다. 녹화도
  `record.py` 를 따로 띄우지 않고 A 버튼으로 한다 — 두 프로그램이 한 포트를 나눠 읽으면 보고 줄이 깨진다.
- 기록은 `data/logs/pad/pad.log` (재부팅해도 남는다 — `/tmp` 에 두었다가 재부팅 때 밖에서 몬 기록을 잃었다).
- Jetson 은 시계 배터리가 없다. 네트워크 없이 켜면 시각이 마지막 저장 시각부터 가므로 녹화 폴더 이름 · 로그 시각이 실제와
  다를 수 있다 — 녹화 `meta.json` 의 `clock_synced`, 로그의 '고리 시작' 줄에 동기화 여부를 남긴다.
- 수신기는 USB 3.0 포트 바로 옆 (2.4 GHz 잡음) 과 금속 차체 안쪽을 피한다. 거리가 모자라면 USB 연장선으로 위에 올린다.
- 권한: 바탕화면에 로그인한 사용자는 udev uaccess 로 `/dev/input/eventN` 을 읽는다. "mokpo" 는 gdm 자동 로그인 (`dongki`) 이라
  부팅 뒤 권한이 생기고, 그 전에는 `pad.py` 가 1 s 마다 다시 연다. 자동 로그인을 끄면 `sudo usermod -aG input dongki`.
- `start` 는 `pad.py` 가 끝나면 3 s 뒤 다시 띄우는 고리로 돈다 (부팅 직후 ESP32 가 늦게 잡혀도). 다시 떠도 놓은 상태라 바퀴는
  START 전까지 움직이지 않는다. 2026-10-14 부터 "mokpo" 에 `install` 해 두었다 — 이더넷 없이 전원만 켜면 패드 대기.

## 5. 결과

### 2026-10-13 PC 자체 시험 (가짜 장치)

가짜 ESP32 는 홀 스텝 축척을 2 %, 유효 윤거를 4 % 일부러 다르게 했다.

| 시험 | 결과 |
| --- | --- |
| 보고 줄 해석 | 펌웨어 printf 모양 그대로 통과 |
| 바닥면 맞추기 (높이 0.30 m, 3° 숙임) | 0.300 m, +3.02° |
| 복도 입구 화살표 | 정면 4.0 m (깊이 끝), ±24° 는 벽 2.7 ~ 2.9 m |
| 0.35 m 앞 원기둥 (깊이 0) | 정면 사각 → 막힘 0.3 m, 범퍼 앞 0 → 선다 |
| 1.2 m 앞 원기둥 | 정면 1.0 m (원기둥 겉면) |
| 왼쪽 90° 돌기 | 오도메트리 +91.9°, 진짜 +90.9° |
| 1 m 가기 | 오도메트리 1.025 m, 진짜 1.050 m |
| 1.0 m 앞 장애물에 2 m 가라 | 0.44 m 가고 깊이로 정지 |
| 하트비트 임대가 끊김 | 1 s 뒤 "host watchdog" STOP |
| 끝까지 (모의 모델 4 걸음) | 오도메트리 7.56 m / 진짜 7.69 m |

### 2026-10-14 Jetson "mokpo" (움직이지 않는 점검)

| 항목 | 결과 |
| --- | --- |
| 가짜 장치 자체 시험 (Python 3.10, numpy 1.21, OpenCV 4.5) | 13 항목 모두 통과 |
| ESP32 (`/dev/ttyUSB0`) | 바퀴 모드, 마스터 = 오른쪽, 데드밴드 100, 상한 400. 보드 전원을 켜자 앞 · 뒤축 텔레메트리, 40.5 V |
| Xtion 열기 | 처음에는 끝없이 멈췄다 — OpenNI 로그 'Getting hardware versions...' 에서 대답 없음, 커널에 `usb_set_interface failed (-110)` 5 s 마다. 로그인 화면 (gdm) 오디오 서버가 Xtion 마이크를 열다 실패하며 제어 통로를 막았다. `xtion_no_audio.sh` (오디오 인터페이스 authorized=0) + USB 다시 꽂기로 해결 |
| Xtion 영상 | 640×480, 화각 58.6° × 45.6°, 29 fps. 장치가 거울상 (미러링 켜짐) 으로 내보내 코드가 뒤집는다 — 좌우가 맞는 것을 사용자가 실물로 확인 |
| 바닥면 | 이날은 카메라가 차에 달려 있지 않고 방을 가로질러 봐서 바닥이 안 보였다 (찾지 못함이 맞음) |

### 2026-10-14 HP60C 와 비교 (같은 방, 차례로 찍음)

| | Xtion Pro Live | Nuwa-HP60C |
| --- | --- | --- |
| 연결 | USB 2.0, OpenNI2 | USB 2.0 (Type-C), 표준 UVC — `hp60c.py` 로 직접 해독 |
| 컬러 | 640×480, 58.6° | 640×480, 56.8° (fx 591.8) |
| 깊이 화각 | 58.6° × 45.6° | 71.3° (자기 시점, fx 446.0) — 컬러 시점으로 옮기면 컬러 화각만큼 |
| 가까운 사각 | 약 0.5 m | 0.2 m (제품 설명) |
| 프레임 | 29 fps | 22.6 fps (문서: 6 주기에 5 장) |
| 이 장면 깊이 값 있음 | 72 % | 30 % (컬러 시점으로 옮긴 뒤 · 창문 햇빛) |

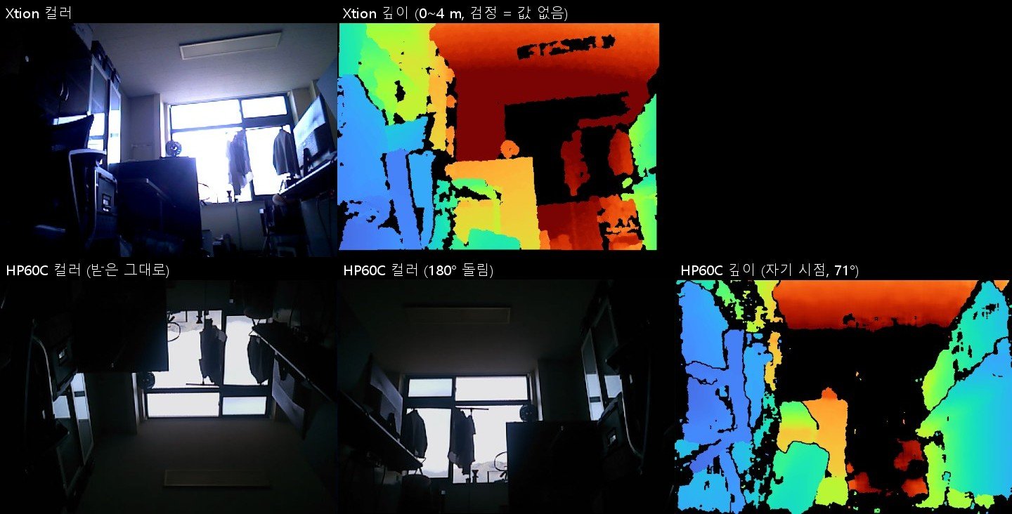
[picture p341: experiments/2026-10-13_vlm-drive/images/camera_compare.jpg]
같은 방을 Xtion 과 HP60C 로 차례로 찍은 비교. 위: Xtion 컬러와 깊이. 아래: HP60C 컬러 받은 그대로 (위아래 뒤집힘), 180° 돌린 컬러, 깊이 (자기 시점, 71°). 깊이는 0 ~ 4 m 색, 검정은 값 없음


HP60C 보정 (이 장치): 깊이 → 컬러 R 의 z 회전 0.8°, 기선 12.2 mm. **고정핀대로 바로 세워 둔 채로** 컬러 · 깊이가 함께
위아래가 뒤집혀 나왔다 (장치 고유 방향) → `HP60CCamera` 는 기본으로 180° 돌린다 (`flip180=True`). 아직 `drive.py` 에서
카메라를 고를 수는 없다.

### 2026-10-14 바퀴 방향 (바퀴를 띄우고 점검판으로, 세기 180 · 2 s)

| 시험 | 앞 왼쪽 | 앞 오른쪽 | 뒤 왼쪽 | 뒤 오른쪽 | 앞축 스텝 (오른쪽 마스터 / 왼쪽 슬레이브) |
| --- | --- | --- | --- | --- | --- |
| 앞으로 (두 번) | −1.84 | +1.81 | −1.86 | +1.82 km/h | −257 / +259 |
| 뒤로 | +1.80 | −1.80 | +1.85 | −1.77 | +242 / −243 |
| 왼쪽 제자리 | +2.00 | +1.99 | +1.97 | +1.91 | −276 / −277 |
| 오른쪽 제자리 | −1.92 | −1.90 | −1.93 | −1.77 | +276 / +278 |

(보드 원시 부호.) 네 시험 모두 실제로 맞는 방향으로 돌았다 (사용자가 눈으로 확인). 보드는 **왼쪽 바퀴 속도를 거꾸로**,
**앞축 스텝은 오른쪽 (마스터) 을 거꾸로** 센다 → `robot.json` 의 `odo_sign` 을 처음 넣은 [1, −1] (가정) 에서 **[−1, +1]** 로 고쳤다.
점검판은 속도를 '앞으로 = +' 로 바꿔 보이고 원시 값은 괄호에 둔다. 가짜 ESP32 (`fake.py`) 도 이 부호로 맞췄다.
메인보드는 몇 분 명령이 없으면 스스로 꺼진다 — 시험 직전에 보드 전원을 다시 켠다.

### 2026-10-14 게임패드 (바퀴를 띄우고, 실물 ESP32)

패드는 DragonRise `0079:181c` "Controller" (2.4 GHz 수신기, 안드로이드 배치) — `event6` 에 버튼 15 개가 이름대로 (L1 = TL 310 ·
SELECT 314 · START 315), 스틱 X · Y · Z · RZ 0 ~ 255, L2 · R2 는 버튼 + 아날로그 (BRAKE · GAS), 십자는 HAT. `learn` 은 안내와
다른 입력이 섞여 `show` 로 확인하고 `pad.json` 을 직접 썼다.

| 시험 | 결과 |
| --- | --- |
| START | `w 1` 들어감. 첫 `x` 는 포트를 열 때 붙은 잡음으로 "? unknown" (N1 대로 무시) |
| L1 + 왼쪽 스틱 (단계 150) | 앞 +150 · 뒤 −150, 살짝 밀어 +50 ~ +70. 스틱 · L1 을 놓을 때마다 STOP (user), 40.4 V |
| L1 + 오른쪽 스틱 | 서서 · 가면서 t ±400 (단계 150 의 최대) 이 나감 |
| R1 · B · 십자 좌우 90° · A 녹화 | 실물에서 모두 동작 (사용자 확인) |
| 패드 전원 끄기 (L1 · 스틱을 민 채) | 아직 |

### 2026-10-14 게임패드로 밖에서 (바닥, 녹화 `2026-10-14_162330`, 6 분)

모든 버튼이 동작했고, **가면서 조향이 거의 안 먹었다** (사용자). 녹화의 바퀴 보고 줄 (앞으로 = +) 로 보면 안쪽 바퀴가
차체에 끌려간다.

| 바퀴 듀티 (왼, 오른) | 실제 속도 왼 / 오른 (km/h, 앞 · 뒤축 평균) | 시간 |
| --- | --- | --- |
| 직진 (113, 113) · (200, 200) | 0.92 / 1.03 · 2.62 / 2.66 | 11 s · 51 s |
| 가며 조향 (280, 120) — 예전 방식의 오른쪽 끝 | **3.85 / 2.84** | 25 s |
| 가며 조향 (240, 160) | 3.19 / 3.06 | 9 s |
| 제자리 (180, −180) | +1.90 / −1.81 | 21 s |

안쪽 바퀴는 듀티 120 (혼자면 1 km/h 쯤) 인데 2.84 km/h 로 돌았다 — 바퀴 네 개 스키드 스티어는 옆으로 미끄러지는 저항이
커서, 안쪽 바퀴를 '약하게 앞으로' 주면 차체가 끌고 가 버리고 차이가 1 km/h 밖에 안 난다. 제자리 (서로 반대) 는 잘 돈다.
→ 가면서는 바깥 바퀴를 그대로 두고 안쪽 바퀴를 줄여 0 · 거꾸로까지 가게 바꿨다 (위 조작 표). 새 방식의 바닥 시험은 아직.

실차 주행 결과는 아직 없다.

## 6. 결론

진행 중. 실차 1 ~ 5 단계를 해 본 뒤 적는다. 자리를 잡으면 ROS 2 패키지 (`software/ros2_ws/src/nubi_base` — cmd_vel ·
오도메트리, `nubi_perception` — 깊이) 로 옮긴다.

### 알려진 한계

- 위치는 오도메트리뿐이다 (스키드 스티어는 돌 때 미끄러져 방향 오차가 쌓인다). IMU (iAHRS) 와 SfM 시각 위치 인식은
  아직 붙이지 않았다 — 위치 인식 정확도는 [2026-10-13_sfm-relocalization](../2026-10-13_sfm-relocalization/) 에서 잰다.
- 지도에 가구 (회색) 가 없다. 지도는 벽 선과 문만.
- 반짝이는 검은 바닥 · 유리는 깊이가 비어 '사각' 으로 보일 수 있다 (보수적으로 선다).
