chungddong/NUBI/experiments/2026-10-14_fiducial-markers/README.md

# 2026-10-14 · 복도에 마커 (AprilTag) 를 붙여 위치 바로잡기

> 상태: **진행 중** — 2026-10-14 바닥에 깐 마커로 첫 시험 (아래 결과). 다음은 벽에 세워 붙이기.

## 1. 목적

카메라 사진만으로 위치를 찾는 SfM 지도 ([../2026-10-13_sfm-relocalization](../2026-10-13_sfm-relocalization/README.md)) 는
첫 주행 (2026-10-14) 에서 지도 영상과 같은 방향일 때만 잘 됐다 (웹캠 갈 때 80 ~ 90 %, 돌아올 때 0 %). 지도가 없는 방향 ·
어두운 곳 · 로비 입구처럼 비슷한 곳에서 틀린 답이 나는 곳을 마커로 메울 수 있는지 본다.

- 마커 하나를 사진 한 장에서 찾으면 카메라 자세 (위치 · 방향) 가 바로 나온다 — 어느 방향에서 보든, 지도 영상과 상관없이.
- 찾기가 빠르다 (SfM 매칭 1 s 에 비해 수십 ms) · 틀린 답이 거의 없다 (36h11 은 ID 사이 거리가 멀다).
- 대신 복도에 붙여 두어야 하고 (학교 허락 · 떨어지거나 떼일 수 있다), 붙인 자리를 지도 좌표로 알아야 한다.

## 2. 구성

- 마커: AprilTag 36h11, ID 0 ~ 11, 검은 사각 바깥 한 변 **160 mm** (A4 한 장에 하나, 둘레 흰 여백 25 mm ≥ 마커 한 칸 20 mm).
  `python markers.py sheet` → `print/apriltag36h11_160mm.pdf` (git 밖 — 언제든 다시 만든다). 100 % 로 인쇄해 50 mm 막대로 확인.
- 카메라: 차의 웹캠 (1280 × 720, 가로 화각 약 70° — 첫 주행에서 SfM 으로 추정) · Xtion 컬러 (640 × 480, 58.6°).
  160 mm 마커가 한 변 30 px 로 보이는 거리: 웹캠 약 4.9 m, Xtion 약 3.0 m.
- 코드: `markers.py` — 인쇄 · 사진에서 찾기 (`detect`), 마커 자세 (`tag_pose`, OpenCV `SOLVEPNP_IPPE_SQUARE`).
  OpenCV aruco 는 PC (5.0) · Jetson (4.5.4) 둘 다 있다 (옛 함수 / 새 클래스를 가려 쓴다).

### 붙일 자리 (첫 안)

마커 가운데를 바닥에서 50 cm (차 카메라 30 ~ 35 cm 보다 조금 위 — 사람 다리 · 가구에 덜 가린다), 무광 · 평평하게.
복도를 따라 보는 카메라에 정면으로 보이는 면 (복도 끝 · 방화문) 과, 목표 문 옆 벽을 섞는다.

| ID | 자리 | 왜 |
| --- | --- | --- |
| 0 | 복도 입구 방화문 (x ≈ 0.2 m), 복도 쪽 면 | 돌아올 때 정면 — 지도가 없는 방향 |
| 1 | 복도 끝 방화문 (x ≈ 27.7 m), 입구 쪽 면 | 갈 때 멀리서 정면 |
| 2 | 복도 끝 방화문, 로비 쪽 면 | 로비에서 돌아 나올 때 |
| 3 | 310 앞문 옆 (왼쪽 벽, x ≈ 10.8 m) | 목표 문 — 서는 자리 |
| 4 | 305 옆 (오른쪽 벽, x ≈ 14.7 m) | 복도 가운데 |
| 5 | 310 뒷문 옆 (왼쪽 벽, x ≈ 20.4 m) | 목표 문 |
| 6 | 308 옆 (왼쪽 벽, x ≈ 5.0 m) | 입구 가까이 |
| 7 | 로비 끝 출입문 옆 (x ≈ 44.5 m) | 로비 고리의 끝 |
| 8 ~ 11 | 남겨 둠 | 시험에서 안 보이는 곳이 나오면 |

붙인 뒤 마커마다 적는다: 어느 벽 · 가까운 문 (모서리) 에서 몇 cm · 가운데 높이. 문 위치는 3D 지도 (scene.json) 에
있으니 그것으로 지도 좌표를 낸다. 녹화에서 SfM 으로 위치를 찾은 사진이 있으면 그 사진의 마커로 자리를 다시 맞춘다.

## 3. 결과

### 2026-10-14 17:04 녹화 — 바닥에 깐 마커 (사용자가 패드로 몰며, 59 s · 28 m)

ID 0 ~ 4 는 복도 가운데 바닥에 눕혀 깔고, ID 6 은 벽 아래에 기대 세웠다 (사진으로 확인). `scan_run.py --video` 로
5 Hz 사진 (웹캠 · Xtion) 과 30 fps 웹캠 동영상 (`webcam.mkv`) 을 모두 훑었다. 마커가 없던 두 녹화 (웹캠 사진 1,700 장)
에서는 하나도 잘못 잡지 않았다.

| ID | 놓은 꼴 | 30 fps 에서 잡힌 프레임 (보이는 동안 프레임) | 거리 | 비스듬한 각 | 한 변 |
| --- | --- | --- | --- | --- | --- |
| 0 | 바닥 | 2 (13) | 1.03 ~ 1.32 m | 69 ~ 73° | 75 ~ 104 px |
| 1 | 바닥 | 5 (15) | 1.05 ~ 1.37 m | 69 ~ 73° | 72 ~ 103 px |
| 2 | 바닥 | 7 (24) | 0.98 ~ 1.56 m | 67 ~ 73° | 63 ~ 116 px |
| 3 | 바닥 | 6 (16) | 1.01 ~ 1.37 m | 68 ~ 74° | 72 ~ 110 px |
| 4 | 바닥 | 4 (6) | 0.93 ~ 1.01 m | 67 ~ 69° | 105 ~ 120 px |
| 6 | 벽에 기대 세움 | 13 (109, 그중 멈춰 바라본 1 s 포함) | 0.98 ~ 2.15 m | 37 ~ 61° | 58 ~ 156 px |

- 5 Hz 사진으로는 웹캠 297 장 중 7 장 (ID 0 은 놓침), Xtion 7 장. 찾는 데 웹캠 30 ms · Xtion 12 ms (Jetson, 사진 한 장).
- **바닥 마커는 차 앞 약 0.9 ~ 1.5 m 띠에서만 잡힌다.** 카메라가 0.35 m 높이에서 수평으로 보니 바닥은 0.9 m 앞부터 화면에
  들어오고, 1.5 m 를 넘으면 마커가 74° 넘게 비스듬해져 못 찾는다. 0.6 m/s 로 지나가면 0.5 s 남짓 — 그동안도 15 ~ 35 %
  프레임에서만 잡혔다 (비스듬 · 흔들림).
- 연속 프레임의 거리는 차가 간 만큼 고르게 줄었다 (ID 3: 0.5 s 동안 1.37 → 1.01 m, 그때 속도 0.67 m/s) — 잡히기만 하면 자세는
  쓸 만하다.

## 4. 결론

- 지금 카메라 (낮고 수평) 에는 **바닥보다 세워 붙이는 것** 이 맞다. 바닥 마커를 쓰려면 카메라를 아래로 15 ~ 20° 숙인 것을 하나
  더 달거나, 마커를 크게 (A3) 하고 지나갈 때 천천히.
- 다음: 벽 · 방화문에 세워 붙이고 (위 '붙일 자리'), 같은 식으로 훑어 몇 m · 몇 도까지 잡히는지 잰다.

순서: (1) 한두 장으로 웹캠 · Xtion 에서 보이는 거리 · 비스듬한 각을 잰다 → (2) 붙이고 양방향 녹화 (pad.py A 버튼)
→ (3) 녹화로 마커 자리 맞추기 · 마커만 / 마커 + SfM 다시 돌려 보기 (vlm-drive/replay.py 에 마커 답을 더함) → (4) 실차.
