chungddong/NUBI/hardware/vehicle/tools/fea/h_assembly_results.md

# 결합 조립 FEA — 레일 토막 + 좌우 클램프 (+타이 / +H 크로스·혀)

`tools/fea/h_assembly_fea.py` · PETG 클램프(E 2100, ν 0.38) + 알루미늄 등가 각관(E 69000, 30×30 벽 2.15, I≈3.1e4) · 800 N 상향 × 좌우 · 편심 55 mm 바깥 · 4 mm C3D10 (min 1.2) · 레일 토막(240) 양 끝면 전 노드 고정 · **전부 결합(bonded)**.

| 케이스 | 요소 | 캠버 L mrad | 캠버 R mrad | 배율 | 최대변위 mm | 배율 | 클램프 구조응력 MPa | 항복 대비 | 프로파일 최대 MPa | 고정단 Fz N |
|---|---:|---:|---:|---:|---:|---:|---:|---:|---:|---:|
| 보강 없음 | 92582 | +10.751 | +10.748 | 1.0× | 0.3986 | 1.0× | 17.0 | 38% | 50.6 | -1600.0 |
| 3030 타이 (아래, 결합) | 128329 | +6.622 | +6.628 | 1.6× | 0.2411 | 1.7× | 16.4 | 36% | 36.3 | -1600.0 |
| H 크로스 + 혀 (결합) | 135676 | +6.257 | +6.246 | 1.7× | 0.2534 | 1.6× | 29.4 | 65% | 30.4 | -1600.0 |

배율 = 보강 없음 대비 감소 배수 (캠버는 좌우 평균). 캠버 = 시트 노드 Uz 를 바깥 방향 y 로 회귀한 기울기 (좌우 모두 **바깥이 위로 들리면 양수**; left = −y 쪽, right = +y 쪽). 클램프 구조응력 = 클램프 영역 노드 중 결합면에서 2 mm 밖의 최대 von Mises (결합 모서리는 특이점이라 뺀다). 고정단 Fz 는 레일 끝 고정 노드 반력 합 — 입력 −1600 N 과 맞아야 한다.

## 단품 결과(구멍 벽 강체 고정, 3 mm, comparison_reinforcement.md)와 나란히

| 형태 | 단품 캠버 mrad | 단품 최대변위 | 단품 구조응력 | 조립 캠버(평균) | 조립 최대변위 | 조립 클램프 구조응력 |
|---|---:|---:|---:|---:|---:|---:|
| 보강 없음 → 보강 없음 | +46.16 | 1.9067 | 45.6 | +10.75 | 0.3986 | 17.0 |
| 3030 타이 (아래, 접지 스프링) → 3030 타이 (아래, 결합) | +7.58 | 0.2627 | 17.8 | +6.62 | 0.2411 | 16.4 |
| H 크로스 + wide 선반 v2 (선반 볼트 강체 고정) → H 크로스 + 혀 (결합) | +11.70 | 0.4477 | 58.5 | +6.25 | 0.2534 | 29.4 |

## 경로 진단 — 캠버가 어디서 오나 (right 쪽, x≈0 단면)

| 케이스 | 레일 토막 비틀림 mrad | 레일 밑면 평균 상승 mm | 다리 윗면 기울기 mrad | 시트 캠버 mrad | 클램프 몸체 몫 (캠버−다리윗면) mrad | 크로스 밑면 Uz @혀 끝 mm | 크로스 윗면 중앙 Uz mm |
|---|---:|---:|---:|---:|---:|---:|---:|
| 보강 없음 | +3.322 | +0.0289 | +4.593 | +10.748 | +6.155 | — | — |
| 3030 타이 (아래, 결합) | +1.368 | +0.0290 | +1.830 | +6.628 | +4.798 | — | — |
| H 크로스 + 혀 (결합) | +1.705 | +0.0228 | +2.077 | +6.246 | +4.169 | -0.0665 | -0.1117 |

레일 토막 비틀림 = 레일 밑면 안쪽 모서리(|y|=195)와 바깥 모서리(225)의 Uz 차 / 30. 다리 윗면 기울기 = 다리 윗면(z=93.85, 레일에 결합) Uz 의 y 회귀. 둘의 차이가 결합면 밖 레일 밑면의 국부 휨이고, 캠버에서 다리 윗면 기울기를 뺀 것이 클램프 몸체(다리+시트) 자체의 변형 몫이다.

## 메쉬 민감도

| 케이스 | 격자 mm | 요소 | 캠버 R mrad | 최대변위 mm | 클램프 구조응력 MPa | 프로파일 최대 MPa |
|---|---:|---:|---:|---:|---:|---:|
| 보강 없음 | 4 | 92582 | +10.748 | 0.3986 | 17.0 | 50.6 |
| 보강 없음 | 3 | 136612 | +10.822 | 0.4029 | 16.8 | 55.7 |
| ↳ 3 mm 이 4 mm 대비 | | | +0.7% | +1.1% | -1.1% | |
| 3030 타이 (아래, 결합) | 4 | 128329 | +6.628 | 0.2411 | 16.4 | 36.3 |
| 3030 타이 (아래, 결합) | 3 | 188854 | +6.633 | 0.2407 | 16.6 | 38.9 |
| ↳ 3 mm 이 4 mm 대비 | | | +0.1% | -0.1% | +1.1% | |
| H 크로스 + 혀 (결합) | 4 | 135676 | +6.246 | 0.2534 | 29.4 | 30.4 |
| H 크로스 + 혀 (결합) | 3 | 205544 | +6.250 | 0.2540 | 31.2 | 32.6 |
| ↳ 3 mm 이 4 mm 대비 | | | +0.1% | +0.3% | +6.0% | |

## 해석 (2026-09-16 실행, 4 mm 기준)

- **결합 조립의 절대값은 단품 표와 비교하면 안 된다.** 보강 없음이 단품 46.16 → 결합 10.75 mrad 로 4.3× 작아졌는데, 이는 다리 윗면 24×30 이 레일 밑면에 통째로 용접된 셈이라 볼트 구멍 벽만 잡은 단품보다 조인트가 훨씬 뻣뻣하기 때문이다. 같은 결합 조건 안에서의 **상대 순위**만 읽는다.
- **3030 타이(아래)**: 캠버 6.62 mrad (1.6×), 최대변위 0.241, 클램프 구조응력 16.4 MPa. 단품의 접지 스프링 모델(7.58 / 0.263 / 17.8)과 거의 같다 — 타이는 좌우 클램프를 직접 이어 벌어짐을 잡는 경로라 프레임 쪽 경계조건에 둔감하다. 다만 결합이라 타이 끝이 모멘트도 받아 살짝 휜다(타이 최대 19.8 MPa, 끝단 근처). 실제 코너브래킷은 그 모멘트를 못 받으니 실물은 이보다 조금 무르다.
- **H 크로스 + 혀**: 캠버 6.25 mrad (1.7×), 최대변위 0.253, 클램프 구조응력 29.4 MPa (PETG 항복의 65%). 크로스 양 끝을 레일에 **용접한 상한**에서조차 타이와 같은 수준이다. 이유는 진단표에 있다 — 좌우 혀가 크로스 양 끝을 동시에 아래로 당기면서 모멘트를 걸어 **크로스 자체가 굽는다** (혀 끝 아래 −0.067 mm, 크로스 윗면 중앙 −0.112 mm). 즉 H 경로는 혀 → 크로스 굽힘 → 레일 비틀림의 직렬이고, 여기에 실물의 코너브래킷·스프링너트 조인트(볼트당 23,000~130,000 N/mm 추정)가 더 직렬로 들어가면 결합값보다 확실히 무르다. 타이 경로에는 그 프레임 조인트가 없다.
- 혀의 **응력 29.4 MPa 은 혀 뿌리 포켓 모서리**(x=±10, 클램프 안쪽면, z=몸체 윗면)에 몰린다 — 날카로운 오목 모서리라 3 mm 격자에서 31.2 (+6%) 로 오르는 메쉬 민감 값이다. 채택하려면 그 모서리에 R 을 줘야 한다. 타이 케이스의 16.4 MPa 은 시트 바깥 모서리(하중 부여 모서리)로 두 격자에서 ±1% 다.
- 캠버 자체는 두 격자에서 0.1~0.7% 차이로 수렴했다 (메쉬 민감도 표). 고정단 반력 Fz 는 세 케이스 모두 −1600.0 N 으로 입력과 일치.
- 프로파일 응력(30~56 MPa)은 레일 토막 결합 모서리·고정단 값이고 6063-T5 항복 145 이하다. 등가 각관이라 T슬롯 립 국부 응력은 없다.

## 모델 한계

- **결합(bonded)** 이라 브라켓·T너트·스프링너트·볼트 예압·접촉이 전부 없다. 크로스 양 끝의 코너브라켓 조인트와 혀 볼트가 강체 용접처럼 들어가므로 H 크로스 경로의 강성은 **상한**이다 (T슬롯 조인트 축강성 추정 23,000~130,000 N/mm 가 직렬로 빠져 있다). 타이도 브래킷 없이 클램프 안쪽면에 직접 붙였다 (373.4 mm).
- 단품 모델과 달리 레일 볼트가 없다 — 다리 윗면 전체가 레일 밑면(레일 발자국 30 mm)에 결합돼 있다. 레일 볼트 인발·다리 윗면 지압 분리를 못 본다.
- 3030 은 등가 각관(굽힘 I 만 맞춤, 단면적 240 < 실물 406, T슬롯 개단면 비틀림 저하 없음)이고 벽 2.15 에 C3D10 한 층이다 (4 mm 격자에서 두 층을 만들려면 ≈1 mm 가 필요해 요소가 수백만이 된다). 프로파일은 PETG 보다 33× 뻣뻣해 이 오차가 결과를 좌우하지 않는다.
- 레일 토막 240 양 끝 완전 고정 = 실제 760 프레임보다 뻣뻣하다. 좌우 대칭 하중만 봤다 (양 바퀴 동시 상향).
- 선형 정적·등방성 PETG 근사. 출력 방향/층간 접착/피로 없음.

실행: `.venv/Scripts/python.exe tools/fea/h_assembly_fea.py --case all --mesh-size 4 --mesh-min 1.2 --load 800 --eccentricity 55 --load-direction upward`
결과 폴더: `models/hoverboard_mount/output/fea/h_assembly_<case>/` (summary.txt, metrics.json, h_assembly.inp/.frd/.vtu, stress_deformed_800N.png 등각, stress_deformed_800N_front.png 정면). 다른 격자는 `h_assembly_<case>_h<size>mm/`. 조립 STEP: `models/hoverboard_mount/output/step/h_assembly_<case>.step`.
