chungddong/NUBI/experiments/2026-10-13_sfm-relocalization/results_jetson_db.md

# 결과 — SfM 지도에 카메라 사진 위치 찾기 (leave-out)

> 이 파일은 `relocalize.py`가 만든다 (2026-10-14 11:59). 해석과 주의점은 [README.md](README.md)에 있다.

## 조건

- 지도: 프레임 263장, 3D 점 51,220개, 관측 389,085개. 낮은 점 (지도 높이 y < 0.8 m) 17,181개.
- 질의: 프레임 44장 (매 6번째). 질의 프레임과 앞뒤 ±K 프레임의 관측을 지도에서 뺀다. 빼는 범위: K = 0 → ±0 초 (약 ±0.0 m), K = 15 → ±3 초 (약 ±3.2 m), K = 40 → ±8 초 (약 ±8.4 m) (프레임 사이 이동 중앙 0.21 m).
- 질의 특징점: DB에 있는 그 프레임의 SIFT (지도를 만든 특징점 그대로).
- 매칭: 정확한 최근접 (L2, 지도 전체와 전수 비교), 비율 검사 0.8 (가장 가까운 *다른* 3D 점과 비교), 3D 점 하나에 질의 특징점 하나.
- 3D 점: '전체 지도' · '낮은 점만'은 매칭된 3D 점을 남은 프레임 (질의 ±K 밖)의 관측만으로 다시 삼각측량해서 쓴다 (SfM 카메라 자세는 고정, 2장 이상 · 삼각 각도 ≥ 1.5° · 재투영 ≤ 4 px). 'SfM 점 그대로'는 복원 모델의 점 위치를 그대로 쓴다. 그 점들은 질의 프레임까지 넣어 다듬은 것이라 오차가 거의 0으로 나온다 (비교용).
- 낮은 점만: 지도 높이 y < 0.8 m 인 3D 점의 관측만 지도에 남기고 그것과만 매칭한다 (낮은 카메라의 거친 대용, README 참고).
- 자세: OpenCV `solvePnPRansac` (AP3P) → 인라이어로 `solvePnPRefineLM` 두 번, 재투영 허용 12 px, 카메라는 알려진 값 (SIMPLE_RADIAL 1920x1080 943.7 960 540 -0.003484). 성공 = 자세가 나오고 인라이어 ≥ 30.
- 기준: 같은 프레임의 SfM 복원 자세. 오차는 align.json으로 바꾼 지도 좌표 (m)에서 잰다. 위치 = 카메라 중심 사이 거리, 수평 = x · z만, 회전 = 두 자세 사이 회전 각.
- 계산: CPU numpy (aarch64, 6 cores). 질의당 시간 = 특징점 뽑기 + 매칭 + PnP (지도 불러오기 2 s와 재삼각측량은 이 실험 방식 때문에 생긴 것이라 뺀다).
- 실행: `relocalize.py --step 6 --ks 0,15,40 --tag _jetson_db`, 전체 1863 s.

## 1. 한눈에 (전체 질의)

| 변형 | K | 질의 | 성공률 | 위치 오차 중앙 / 90 % (m) | 수평 오차 중앙 / 90 % (m) | 회전 오차 중앙 / 90 % (°) | 인라이어 중앙 | 매칭 중앙 | 1 m 넘는 오답 | 질의당 시간 중앙 (ms) |
|---|---:|---:|---:|---:|---:|---:|---:|---:|---:|---:|
| 전체 지도 | 0 | 44 | 100.0 % | 0.001 / 0.001 | 0.000 / 0.001 | 0.01 / 0.02 | 945 | 1024 | 0 | 10168 |
| 전체 지도 | 15 | 44 | 97.7 % | 0.012 / 0.032 | 0.010 / 0.025 | 0.06 / 0.21 | 161 | 328 | 0 | 9010 |
| 전체 지도 | 40 | 44 | 38.6 % | 0.066 / 0.165 | 0.050 / 0.154 | 0.48 / 1.01 | 28 | 123 | 1 | 6761 |
| 낮은 점만 | 0 | 44 | 100.0 % | 0.002 / 0.006 | 0.002 / 0.005 | 0.02 / 0.06 | 345 | 426 | 0 | 3502 |
| 낮은 점만 | 15 | 44 | 97.7 % | 0.037 / 0.098 | 0.030 / 0.086 | 0.21 / 0.71 | 71 | 172 | 0 | 3111 |
| 낮은 점만 | 40 | 44 | 2.3 % | 0.030 / 0.030 | 0.024 / 0.024 | 0.28 / 0.28 | 10 | 99 | 0 | 2644 |
| 전체 지도 · SfM 점 그대로 | 0 | 44 | 100.0 % | 0.000 / 0.001 | 0.000 / 0.001 | 0.01 / 0.01 | 960 | 1024 | 0 | 10166 |
| 전체 지도 · SfM 점 그대로 | 15 | 44 | 97.7 % | 0.004 / 0.013 | 0.002 / 0.009 | 0.03 / 0.08 | 194 | 328 | 0 | 9009 |
| 전체 지도 · SfM 점 그대로 | 40 | 44 | 65.9 % | 0.023 / 0.285 | 0.015 / 0.281 | 0.18 / 1.14 | 34 | 123 | 2 | 6736 |
| *시뮬레이터 가정* | – | – | 80 % | – | 0.177 / 0.322 | 2.0 / 4.9 (yaw만) | – | – | – | – |

오차의 중앙 · 90 %는 성공한 질의만으로 낸다. 시뮬레이터 가정은 `sim/web/agent.js`의 `VIS_P = 0.8`, `VIS_M = 0.15` (x · y 각각 표준편차), `VIS_DEG = 3`에서 계산한 값이다.

## 2. 정해진 오차 안에 든 비율 (모든 질의 기준, 실패는 밖으로 셈)

| 변형 | K | 수평 ≤ 0.15 m | ≤ 0.30 m | ≤ 0.50 m | ≤ 1.0 m | ≤ 0.15 m 이고 회전 ≤ 3° |
|---|---:|---:|---:|---:|---:|---:|
| 전체 지도 | 0 | 100.0 % | 100.0 % | 100.0 % | 100.0 % | 100.0 % |
| 전체 지도 | 15 | 97.7 % | 97.7 % | 97.7 % | 97.7 % | 97.7 % |
| 전체 지도 | 40 | 34.1 % | 36.4 % | 36.4 % | 36.4 % | 34.1 % |
| 낮은 점만 | 0 | 100.0 % | 100.0 % | 100.0 % | 100.0 % | 100.0 % |
| 낮은 점만 | 15 | 93.2 % | 97.7 % | 97.7 % | 97.7 % | 93.2 % |
| 낮은 점만 | 40 | 2.3 % | 2.3 % | 2.3 % | 2.3 % | 2.3 % |
| 전체 지도 · SfM 점 그대로 | 0 | 100.0 % | 100.0 % | 100.0 % | 100.0 % | 100.0 % |
| 전체 지도 · SfM 점 그대로 | 15 | 97.7 % | 97.7 % | 97.7 % | 97.7 % | 97.7 % |
| 전체 지도 · SfM 점 그대로 | 40 | 56.8 % | 59.1 % | 61.4 % | 61.4 % | 56.8 % |
| *시뮬레이터 가정* | – | 31.5 % | 69.2 % | 79.7 % | 80.0 % | 21.5 % |

## 3. 복도와 라운지 따로

| 변형 | K | 구간 | 질의 | 성공률 | 수평 오차 중앙 / 90 % (m) | 회전 오차 중앙 (°) | 인라이어 중앙 | 1 m 넘는 오답 |
|---|---:|---|---:|---:|---:|---:|---:|---:|
| 전체 지도 | 0 | 복도 (0–118) | 20 | 100.0 % | 0.000 / 0.001 | 0.01 | 778 | 0 |
| 전체 지도 | 0 | 라운지 (119–262) | 24 | 100.0 % | 0.000 / 0.002 | 0.01 | 1960 | 0 |
| 전체 지도 | 15 | 복도 (0–118) | 20 | 100.0 % | 0.011 / 0.029 | 0.05 | 148 | 0 |
| 전체 지도 | 15 | 라운지 (119–262) | 24 | 95.8 % | 0.010 / 0.023 | 0.09 | 312 | 0 |
| 전체 지도 | 40 | 복도 (0–118) | 20 | 50.0 % | 0.066 / 0.390 | 0.30 | 30 | 1 |
| 전체 지도 | 40 | 라운지 (119–262) | 24 | 29.2 % | 0.036 / 0.077 | 0.75 | 20 | 0 |
| 낮은 점만 | 0 | 복도 (0–118) | 20 | 100.0 % | 0.001 / 0.004 | 0.02 | 238 | 0 |
| 낮은 점만 | 0 | 라운지 (119–262) | 24 | 100.0 % | 0.002 / 0.005 | 0.03 | 702 | 0 |
| 낮은 점만 | 15 | 복도 (0–118) | 20 | 100.0 % | 0.042 / 0.098 | 0.20 | 68 | 0 |
| 낮은 점만 | 15 | 라운지 (119–262) | 24 | 95.8 % | 0.028 / 0.065 | 0.23 | 94 | 0 |
| 낮은 점만 | 40 | 복도 (0–118) | 20 | 0.0 % | – / – | – | 16 | 0 |
| 낮은 점만 | 40 | 라운지 (119–262) | 24 | 4.2 % | 0.024 / 0.024 | 0.28 | 7 | 0 |
| 전체 지도 · SfM 점 그대로 | 0 | 복도 (0–118) | 20 | 100.0 % | 0.000 / 0.001 | 0.01 | 790 | 0 |
| 전체 지도 · SfM 점 그대로 | 0 | 라운지 (119–262) | 24 | 100.0 % | 0.000 / 0.002 | 0.01 | 2000 | 0 |
| 전체 지도 · SfM 점 그대로 | 15 | 복도 (0–118) | 20 | 100.0 % | 0.004 / 0.010 | 0.04 | 176 | 0 |
| 전체 지도 · SfM 점 그대로 | 15 | 라운지 (119–262) | 24 | 95.8 % | 0.002 / 0.008 | 0.03 | 410 | 0 |
| 전체 지도 · SfM 점 그대로 | 40 | 복도 (0–118) | 20 | 80.0 % | 0.023 / 1.032 | 0.19 | 42 | 2 |
| 전체 지도 · SfM 점 그대로 | 40 | 라운지 (119–262) | 24 | 54.2 % | 0.009 / 0.108 | 0.15 | 30 | 0 |

## 4. 지도와 매칭 규모

| 변형 | K | 가장 가까운 남은 지도 카메라까지 중앙 (최소) (m) | 질의마다 남은 3D 점 (중앙) | 질의 사진의 SfM 대응 중 낮은 점 (중앙) | 매칭 (중앙) | 인라이어 (중앙) | SfM 대응과 같은 매칭 비율 (중앙) | 특징점 / 매칭 / PnP 시간 중앙 (ms) |
|---|---:|---:|---:|---:|---:|---:|---:|---:|
| 전체 지도 | 0 | 0.21 (0.09) | 51,220 | 371 | 1024 | 945 | 89 % | 0 / 10160 / 8 |
| 전체 지도 | 15 | 3.20 (0.86) | 47,666 | 371 | 328 | 161 | 65 % | 0 / 9003 / 4 |
| 전체 지도 | 40 | 8.15 (0.86) | 39,564 | 371 | 123 | 28 | 29 % | 0 / 6714 / 80 |
| 낮은 점만 | 0 | 0.21 (0.09) | 17,181 | 371 | 426 | 345 | 78 % | 0 / 3499 / 3 |
| 낮은 점만 | 15 | 3.20 (0.86) | 16,248 | 371 | 172 | 71 | 47 % | 0 / 3083 / 10 |
| 낮은 점만 | 40 | 8.15 (0.86) | 13,382 | 371 | 99 | 10 | 12 % | 0 / 2350 / 308 |
| 전체 지도 · SfM 점 그대로 | 0 | 0.21 (0.09) | 51,220 | 371 | 1024 | 960 | 89 % | 0 / 10160 / 6 |
| 전체 지도 · SfM 점 그대로 | 15 | 3.20 (0.86) | 47,666 | 371 | 328 | 194 | 65 % | 0 / 9003 / 4 |
| 전체 지도 · SfM 점 그대로 | 40 | 8.15 (0.86) | 39,564 | 371 | 123 | 34 | 29 % | 0 / 6714 / 35 |

'SfM 대응과 같은 매칭 비율'은 매칭된 3D 점이 복원 모델이 그 특징점에 붙인 3D 점과 같은 비율이다 (복원 모델이 3D 점을 붙이지 않은 특징점의 매칭은 틀린 것으로 센다).

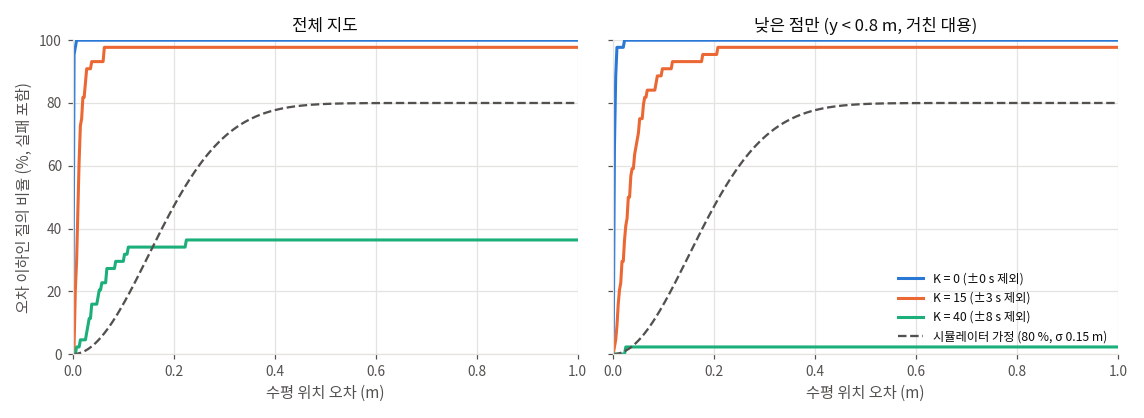
[picture p342: experiments/2026-10-13_sfm-relocalization/error_cdf_jetson_db.png]
수평 오차 누적 분포


질의마다의 수치는 `per_query_jetson_db.csv`에 있다.
