chungddong/NUBI/hardware/vehicle/tools/frame/frame_h_cross_results.md

# H 크로스 + 혀 — 차량 전체 보요소 평가

`tools/frame/frame_fea.py` (12-DOF 3D 빔, numpy). 실행: `.venv/Scripts/python.exe tools/frame/frame_fea.py`

하중: 차량 40 kg 상부 분산 + 사람 70 kg (중앙 / 한쪽구석 x=+365,y=+210 / 뒤축위 x=+365 양쪽). 클램프 = 레일 밑면 힌지(x축 회전 스프링), 보강은 부재/스프링. 그림: `docs/images/67_frame_h_cross.png`

## 보정값 (단품 FEA PETG, 800 N 상향, 편심 55, 3 mm)

| 항목 | 값 | 근거 |
|---|---:|---|
| 힌지 위치 | y=±210, z=93.85 (레일 밑면) | 보강 없음 시트 Uy/θ = 0.6699/0.046160 = 14.51 mm, Uz 회귀 영점 y=-55.2 (`..._petg_e55mm_up`) |
| 클램프 몸체 kθ | 953 N·m/rad | 44.0 N·m / 46.160 mrad |
| 혀 볼트 중간 | y=±156.7 (힌지에서 53.3 mm) | 볼트 로컬 y -92/-122 (클램프 안쪽면 -77 에서 15/45). 과제의 ±165 는 레일 안쪽면 기준이라 8.3 mm 어긋난다 |
| 혀 강성 k_t | 1,746 N/mm | 구멍 벽이 강체 고정이라 700/Uz(구멍 노드) 는 0 으로 나눔 → 대신 힌지+z스프링(조인트 강체)이 단품 캠버 7.439 mrad (`..._up_tongue`) 를 재현하도록 (44,000/0.007439 − 953,206)/53.3² . 이때 혀 힘 = 692 N (단품 볼트 반력 655.8 N) |
| 조인트 | 스프링너트 23,430 / T너트 98,415 N/mm | 브라켓 1개 = 볼트 1개, 혀와 직렬 → 1,625 / 1,716 N/mm |
| 타이 국부 스프링 k_loc | 4,736 N/mm (양 끝) | 단품 타이(접지 스프링 155,633 N/mm)가 7.576 mrad (`..._up_tieprof`) → (44,000/0.007576 − 953,206)/32.5² = 4,596 의 직렬 보정. 이걸 빼고 순수 트러스만 두면 캠버가 0.3 mrad 로 단품과 25배 어긋난다 |

## 검증

- 힌지 요소: kθ 목표 953206 N·mm/rad, 측정 953206 (θx=46.160 mrad @44 N·m, 다른 5 자유도 최대 0.0e+00)
- 레일 고정 + 44 N·m: 몸체만 46.160 mrad (단품 46.160) · 혀(조인트 강체) 7.439 (단품 7.439) · 혀+스프링너트 7.899 · 혀+T너트 7.550 · 3030 타이+국부 7.573 (단품 7.576) · 타이 국부 없음 0.266
- 기존 경로 (k_clamp=None) · tie=True · 접지 old · 한쪽구석: 최대처짐 0.379 mm, 바퀴하중 22~865 N (기존 0.379 / 22~865)
- 새 힌지 경로 kθ=∞ · tie=True · 접지 old · 한쪽구석: 최대처짐 0.380 mm, 바퀴하중 22~865 N (기존 0.379 / 22~865)
- 새 힌지 경로 kθ=∞ · 접지 pin(회전 자유): 최대처짐 0.389 mm, 바퀴하중 6~876 N

## 결과 — 접지 롤러 (x,z 구속, y 자유: 바퀴가 옆으로 벌어질 수 있다) — **주 결과**

캠버 = 축 노드 θx, 접지가 바깥으로 벌어지는 방향 +. 네 바퀴 순서 (+x,+y) / (+x,−y) / (−x,+y) / (−x,−y). '최악' = |캠버| 최대 바퀴. 축 y = 축 노드 y 변위 (바깥 +). 접지 벌어짐 = 축 y + 캠버·79.35 (접지점 옆이동). 최대처짐 = 전체 노드 |Uz| 최대. 힘 = 혀 스프링 z 힘 / 타이 축력 최대.

| 구성 | 하중 | 최악 캠버 mrad | 네 바퀴 캠버 mrad | 최악 축 y mm | 네 바퀴 축 y mm | 접지 벌어짐 mm | 최대처짐 mm | 혀/타이 힘 N | 바퀴하중 N |
|---|---|---:|---|---:|---|---:|---:|---:|---|
| 보강 없음 | 중앙 | +17.44 | +17.44 / +17.44 / +17.44 / +17.44 | +0.285 | +0.285 / +0.285 / +0.285 / +0.285 | +1.67 | 1.343 | 0 | 270~270 |
| 보강 없음 | 한쪽구석 | +46.93 | +46.93 / +26.43 / +1.68 / -5.28 | -0.074 | -0.074 / +1.284 / -0.437 / +0.384 | +3.65 | 3.643 | 0 | 41~772 |
| 보강 없음 | 뒤축위 | +36.68 | +36.68 / +36.68 / -1.80 / -1.80 | +0.605 | +0.605 / +0.605 / -0.027 / -0.027 | +3.52 | 2.901 | 0 | 29~568 |
| 3030 타이 | 중앙 | +2.90 | +2.90 / +2.90 / +2.90 / +2.90 | +0.024 | +0.024 / +0.024 / +0.024 / +0.024 | +0.25 | 0.234 | 350 | 270~270 |
| 3030 타이 | 한쪽구석 | +16.28 | +16.28 / -4.21 / +3.04 / -3.90 | -0.626 | -0.626 / +0.731 / -0.409 / +0.410 | +0.67 | 1.358 | 740 | 41~772 |
| 3030 타이 | 뒤축위 | +6.04 | +6.04 / +6.04 / -0.43 / -0.43 | +0.053 | +0.053 / +0.053 / +0.000 / +0.000 | +0.53 | 0.617 | 740 | 29~568 |
| H+혀 (스프링너트) | 중앙 | +3.37 | +3.37 / +3.37 / +3.37 / +3.37 | +0.060 | +0.060 / +0.060 / +0.060 / +0.060 | +0.33 | 0.360 | 225 | 270~270 |
| H+혀 (스프링너트) | 한쪽구석 | +9.38 | +9.38 / +4.78 / -0.37 / -0.33 | -0.031 | -0.031 / +0.287 / -0.028 / +0.016 | +0.71 | 1.004 | 706 | 26~844 |
| H+혀 (스프링너트) | 뒤축위 | +7.08 | +7.08 / +7.08 / -0.35 / -0.35 | +0.128 | +0.128 / +0.128 / -0.006 / -0.006 | +0.69 | 0.758 | 475 | 29~568 |
| H+혀 (T너트) | 중앙 | +3.25 | +3.25 / +3.25 / +3.25 / +3.25 | +0.059 | +0.059 / +0.059 / +0.059 / +0.059 | +0.32 | 0.348 | 227 | 270~270 |
| H+혀 (T너트) | 한쪽구석 | +9.06 | +9.06 / +4.62 / -0.37 / -0.30 | -0.030 | -0.030 / +0.279 / -0.024 / +0.013 | +0.69 | 0.969 | 714 | 24~846 |
| H+혀 (T너트) | 뒤축위 | +6.84 | +6.84 / +6.84 / -0.34 / -0.34 | +0.124 | +0.124 / +0.124 / -0.006 / -0.006 | +0.67 | 0.732 | 479 | 29~568 |

## 결과 — 접지 핀 (x,y,z 구속: 타이어 옆미끄럼 없음)

접지 y 를 잡으면 타이어 마찰이 바퀴를 못 벌어지게 잡는다 — 캠버 대신 접지 옆힘(마찰 요구)이 생긴다. 이 경계조건에서 타이는 거의 아무것도 안 한다(접지가 이미 옆을 잡는다).

| 구성 | 하중 | 최악 캠버 mrad | 네 바퀴 캠버 mrad | 최대처짐 mm | 접지 옆힘 최대 N | 바퀴하중 N |
|---|---|---:|---|---:|---:|---|
| 보강 없음 | 중앙 | +0.12 | +0.12 / +0.12 / +0.12 / +0.12 | 0.082 | 150 | 270~270 |
| 보강 없음 | 한쪽구석 | +9.47 | +9.47 / -9.08 / +4.41 / -4.50 | 0.873 | 382 | 0~870 |
| 보강 없음 | 뒤축위 | +0.19 | +0.19 / +0.19 / -0.05 / -0.05 | 0.182 | 317 | 29~568 |
| 3030 타이 | 중앙 | +0.10 | +0.10 / +0.10 / +0.10 / +0.10 | 0.081 | 161 | 270~270 |
| 3030 타이 | 한쪽구석 | +9.44 | +9.44 / -9.09 / +4.40 / -4.48 | 0.870 | 400 | 0~870 |
| 3030 타이 | 뒤축위 | +0.17 | +0.17 / +0.17 / -0.04 / -0.04 | 0.181 | 334 | 29~568 |
| H+혀 (스프링너트) | 중앙 | +0.03 | +0.03 / +0.03 / +0.03 / +0.03 | 0.075 | 148 | 270~270 |
| H+혀 (스프링너트) | 한쪽구석 | +2.25 | +2.25 / -2.15 / +0.07 / -0.08 | 0.433 | 328 | 7~863 |
| H+혀 (스프링너트) | 뒤축위 | +0.05 | +0.05 / +0.05 / -0.01 / -0.01 | 0.171 | 311 | 29~568 |
| H+혀 (T너트) | 중앙 | +0.03 | +0.03 / +0.03 / +0.03 / +0.03 | 0.075 | 147 | 270~270 |
| H+혀 (T너트) | 한쪽구석 | +2.18 | +2.18 / -2.08 / +0.04 / -0.06 | 0.428 | 326 | 7~863 |
| H+혀 (T너트) | 뒤축위 | +0.05 | +0.05 / +0.05 / -0.01 / -0.01 | 0.171 | 311 | 29~568 |

## 감도 (접지 롤러)

| 구성 | 하중 | 최악 캠버 mrad | 접지 벌어짐 mm | 최대처짐 mm | 힘 N |
|---|---|---:|---:|---:|---:|
| H 크로스만 (혀 없음) | 중앙 | +16.05 | +1.52 | 1.236 | 0 |
| H 크로스만 (혀 없음) | 한쪽구석 | +43.09 | +3.33 | 3.362 | 0 |
| H 크로스만 (혀 없음) | 뒤축위 | +33.80 | +3.20 | 2.686 | 0 |
| H+혀, 조인트 강체 | 중앙 | +3.21 | +0.31 | 0.344 | 228 |
| H+혀, 조인트 강체 | 한쪽구석 | +8.95 | +0.68 | 0.958 | 716 |
| H+혀, 조인트 강체 | 뒤축위 | +6.76 | +0.66 | 0.724 | 480 |
| 3030 타이, 국부 스프링 없음(순수 트러스) | 중앙 | +0.85 | +0.06 | 0.125 | 400 |
| 3030 타이, 국부 스프링 없음(순수 트러스) | 한쪽구석 | +11.96 | +0.25 | 1.036 | 844 |
| 3030 타이, 국부 스프링 없음(순수 트러스) | 뒤축위 | +1.72 | +0.11 | 0.295 | 844 |
| M8 전산볼트 타이 x2 + 국부 | 중앙 | +2.95 | +0.26 | 0.237 | 349 |
| M8 전산볼트 타이 x2 + 국부 | 한쪽구석 | +16.35 | +0.68 | 1.364 | 738 |
| M8 전산볼트 타이 x2 + 국부 | 뒤축위 | +6.14 | +0.54 | 0.625 | 738 |
| 타이 + H+혀 (스프링너트) 같이 | 중앙 | +1.48 | +0.14 | 0.158 | 111 |
| 타이 + H+혀 (스프링너트) 같이 | 한쪽구석 | +5.40 | +0.32 | 0.663 | 464 |
| 타이 + H+혀 (스프링너트) 같이 | 뒤축위 | +3.10 | +0.29 | 0.399 | 233 |
| 클램프 강체 (기존 모델) + 타이 | 중앙 | +0.28 | +0.02 | 0.092 | 266 |
| 클램프 강체 (기존 모델) + 타이 | 한쪽구석 | +2.10 | +0.05 | 0.425 | 570 |
| 클램프 강체 (기존 모델) + 타이 | 뒤축위 | +0.53 | +0.04 | 0.206 | 570 |
| AL6061 클램프 · 보강 없음 | 중앙 | +2.73 | +0.29 | 0.220 | 0 |
| AL6061 클램프 · 보강 없음 | 한쪽구석 | +7.64 | +0.63 | 0.835 | 0 |
| AL6061 클램프 · 보강 없음 | 뒤축위 | +5.70 | +0.61 | 0.592 | 0 |
| AL6061 클램프 · 3030 타이 | 중앙 | +0.36 | +0.03 | 0.096 | 280 |
| AL6061 클램프 · 3030 타이 | 한쪽구석 | +2.62 | +0.07 | 0.460 | 598 |
| AL6061 클램프 · 3030 타이 | 뒤축위 | +0.68 | +0.05 | 0.218 | 598 |
| AL6061 클램프 · H+혀 (스프링너트) | 중앙 | +0.96 | +0.10 | 0.125 | 177 |
| AL6061 클램프 · H+혀 (스프링너트) | 한쪽구석 | +2.41 | +0.19 | 0.462 | 584 |
| AL6061 클램프 · H+혀 (스프링너트) | 뒤축위 | +2.02 | +0.22 | 0.318 | 373 |
| AL6061 클램프 · H+혀 (T너트) | 중앙 | +0.88 | +0.09 | 0.120 | 218 |
| AL6061 클램프 · H+혀 (T너트) | 한쪽구석 | +2.14 | +0.16 | 0.443 | 721 |
| AL6061 클램프 · H+혀 (T너트) | 뒤축위 | +1.84 | +0.20 | 0.305 | 459 |

## 해석

1. **대칭 하중(중앙·뒤축위)에서는 타이와 H+혀가 비슷하다.** 중앙 2.9 vs 3.4 mrad, 뒤축위 6.0 vs 7.1 mrad (보강 없음 17.4 / 36.7). 단품에서 둘 다 ≈7.5 mrad 였던 것과 같은 그림이다.
2. **한쪽 구석 하중에서는 H+혀가 타이보다 낫다.** 9.4 vs 16.3 mrad (보강 없음 46.9). 타이는 반대쪽 클램프를 끌어당겨야 하는데 그쪽 바퀴는 거의 떠 있어(하중 수십 N) 자기 힌지(953)와 프레임 코너 수직강성으로만 버틴다 — 그래서 반대쪽 바퀴가 안쪽으로 4.2 mrad 기운다. 혀는 같은 자리 레일에 바로 반력을 넣으니 반대쪽 상태와 무관하다.
3. **PETG 에서는 브라켓 조인트 종류가 거의 안 보인다.** 스프링너트 vs T너트 차이 3.6% (한쪽구석). 혀 경로 강성 1,746 N/mm 이 조인트 23,430 보다 13배 무르니 직렬합 1,625 / 1,716 이 거의 혀 값이다. '혀 ⊕ 조인트 직렬' 이라는 요점은 맞지만 PETG 몸체가 병목이라 조인트는 7%/2% 만 먹는다. AL6061 클램프면 혀 경로가 57,301 N/mm 로 올라 조인트가 병목이 된다 — 감도 표에서 스프링너트 vs T너트 2.41 vs 2.14 mrad.
4. **혀 힘.** 한쪽구석에서 혀 스프링 힘 706 N (볼트 2개 합, 바퀴하중 844 N). 볼트당 ≈353 N = 경제형 스프링너트 보수 인발 한계 1500 N 의 24%. 이 힘은 크로스 양 끝 브라켓 조인트에 그대로 걸린다.
5. **H 크로스 막대 자체의 몫은 작다.** 혀 없이 크로스만 걸면 (감도 'H 크로스만') 한쪽구석 43.1 mrad (보강 없음 46.9) — 레일 비틀림을 조금 잡을 뿐이고, 캠버 개선은 거의 전부 혀에서 온다. 접지 핀에서도 크로스만은 9.47 → 8.37, 혀를 더해야 2.25.
6. **접지를 핀으로 잡으면(미끄럼 없는 바닥)** 캠버는 마찰이 막고 대신 접지 옆힘 382 N (바퀴하중의 0.44배)이 필요하다. 그 경우 타이는 효과가 없고(9.47 → 9.44 mrad), H+혀는 2.25 mrad / 처짐 0.873 → 0.433 mm 로 줄인다. 실물에서 '벌어짐'이 보였으니 롤러 쪽이 현실에 가깝다.
7. **한계.** 클램프는 힌지 하나(x축 회전)로 축약했다 — 힌지 위치·강성은 단품 FEA 한 케이스(800 N 상향, 편심 55)에서 읽은 값이고 선형이다. 혀·타이 스프링은 같은 단품 FEA 를 재현하도록 맞췄으므로 단품과 다른 하중 방향/크기에서는 보정이 흔들린다. 브라켓 조인트는 z 축강성만, 슬립·예압·마찰 없음. 3030 비틀림 J 는 절반 근사.
