chungddong/NUBI/docs/worklog/README.md

# worklog — 작업 일지와 기록

누비의 작업 일지와 시간순 기록을 모두 여기에 둡니다. 2026-07-27 첫 설계부터의 기록이 같은 양식으로 들어 있습니다.
새 일지도 여기에만 씁니다.

| 파일 | 항목 | 내용 |
| --- | --- | --- |
| [2026-07](2026-07.md) | 9 | 차체 설계 시작 — 프로파일 프레임, 구동계 검토, 스워브, 외장 · 적재함 · 모듈 |
| [2026-08](2026-08.md) | 15 | 스키드 · 고정 브라켓 전환, 휠 마운트 · 클램프, FEA / 바퀴 제어기 첫 커밋 |
| [2026-09](2026-09.md) | 7 | 차량 뷰어 · BOM / 탱크 모드 · 데드밴드, RDK 장애물 가드, Jetson 초파리 뇌 주행 |
| [2026-10](2026-10.md) | 17 | 차체 재설계 v00 ~ v29, 저장소 분리 · 누비 통합, ESP32 바퀴 모드 · 네 바퀴 시험, MIT 공개 준비, 시뮬레이터 복도 · GPT · Claude 운전, 실차 운전 준비, Jetson 유선 직결, Jetson 실기 점검 · 바퀴 방향, 무선 게임패드 조종, 카메라 위치 찾기 · 마커 |
| [topics/](topics/) | 9 | 주제별 기록 — 여러 날에 걸친 한 주제를 정리한 것 |

## 양식

### 월별 파일

한 달에 파일 하나(`YYYY-MM.md`)입니다. 맨 위에 그 달의 목차 표가 있고, 그 아래로 오래된 항목부터 차례로 씁니다.
항목 하나는 한 세션(또는 하루)입니다. 항목 사이는 `---`로 나눕니다.

```markdown
## 2026-10-20 (화) · 바퀴 제어: 콘솔 입력 강건화

> 시간: 14:00 ~ 17:30 · 장소: PC · 날짜 근거: 세션 · 커밋: `abc1234` · 관련 이슈: N1

무엇을 하려 했고 어떻게 끝났는지 한두 문장.

### 한 일

#### 14:00 — 잡음 바이트 재현

...

### 확인한 것

### 남은 일
```

**제목**은 `날짜 (요일) · 영역: 제목`입니다. 날짜를 모르면 `YYYY-MM-DD 이전 (날짜 미상)`으로 씁니다.

**인용 줄**에는 있는 것만 ` · `로 이어 씁니다.

| 칸 | 무엇 |
| --- | --- |
| 시간 | `HH:MM ~ HH:MM`. 날을 넘기면 `HH:MM ~ MM-DD (요일) HH:MM` |
| 장소 | PC, Jetson "dongki", RDK "sunrise", 시제품 등. 작업 폴더가 중요하면 경로까지 |
| 날짜 근거 | 세션 기록 / 커밋 / 파일 시각 / 타 머신 — 나중에 쓴 기록이면 무엇으로 날짜를 정했는지 |
| 커밋 | 그날 커밋 해시 |
| 관련 이슈 | `firmware/wheel-controller/ISSUES.md` 번호 등 |
| 원본 | 다른 곳에서 옮겨 온 항목이면 원래 위치 |

**영역**은 아래 중 하나입니다. 새 갈래가 생기면(예: 자율주행 소프트웨어) 여기에 더합니다.

| 영역 | 무엇 |
| --- | --- |
| 차체 | `hardware/vehicle/` — 차체 설계, 부품 선정, 구조해석, 웹 시뮬레이터 |
| 바퀴 제어 | `firmware/` — ESP32 바퀴 제어기, 호버보드 메인보드 |
| 상위 제어 | Jetson · RDK에서 돈 것 — 장애물 가드, 초파리 뇌 주행, 나중에 ROS 2 |
| 저장소 | 저장소 구조, 문서, 도구 |

**본문 칸**은 이 순서로 쓰고, 해당 없는 칸은 뺍니다. 칸 안의 세부 갈래는 `####`로 나눕니다(시각이 있으면 `#### HH:MM — 제목`).

| 칸 | 무엇 |
| --- | --- |
| (요약) | 제목 없이 첫 단락. 무엇을 하려 했고 어떻게 끝났는지 |
| 배경 | 시작할 때의 상태 |
| 한 일 | 한 것. 사용자 질문은 `>` 인용으로 그대로 남기면 나중에 맥락이 보입니다 |
| 결정 | 무엇을 왜 골랐는지. 오래 남을 결정은 DECISIONS.md(D-NN)나 `docs/decisions/`에 쓰고 링크 |
| 확인한 것 | 수치와 측정 조건 |
| 발견한 문제 | 새로 드러난 문제. 이슈 번호를 붙였으면 번호로 |
| 남은 일 | 다음에 할 것 |
| 교훈 | 다음에 같은 실수를 안 하려고 남기는 것 |
| 이후 달라진 것 | 나중에 다시 읽으며 달라진 점을 덧붙일 때 (차체 일지는 2026-09-15 기준) |
| 참고 | 기록 공백, 확실하지 않은 것 등 |

### 주제별 기록 (topics/)

여러 날에 걸친 한 주제를 정리한 기록입니다. 파일 이름은 `<영역>-<주제>.md`(소문자 kebab-case), 맨 위에 제목과
인용 줄(영역 · 기간 · 원본)을 둡니다. 긴 디버깅 과정도 여기에 쓰고 일지에서는 링크만 겁니다.

## 전체 연표

| 날짜 | 영역 | 제목 |
| --- | --- | --- |
| 2026-07-27 (월) | 차체 | [프로파일 단면에서 측면 커버까지](2026-07.md#2026-07-27-월--차체-프로파일-단면에서-측면-커버까지) |
| 2026-07-27 (월) | 차체 | [커버 기능 요소: 후면 패널·얼굴·환기·배선·배터리 브라켓](2026-07.md#2026-07-27-월--차체-커버-기능-요소-후면-패널얼굴환기배선배터리-브라켓) |
| 2026-07-27 (월) | 차체 | [허브모터 배제와 구동계 재검토](2026-07.md#2026-07-27-월--차체-허브모터-배제와-구동계-재검토) |
| 2026-07-27 (월) | 차체 | [모터 후보 검토와 호버보드 허브모터 전환](2026-07.md#2026-07-27-월--차체-모터-후보-검토와-호버보드-허브모터-전환) |
| 2026-07-28 (화) | 차체 | [스워브 전환: 킹핀·벨트·서스펜션](2026-07.md#2026-07-28-화--차체-스워브-전환-킹핀벨트서스펜션) |
| 2026-07-28 (화) | 차체 | [외장 --\\\_\_/--, 실물 Xtion, 그리고 움직이지 않던 서스펜션](2026-07.md#2026-07-28-화--차체-외장---__---실물-xtion-그리고-움직이지-않던-서스펜션) |
| 2026-07-29 (수) | 차체 | [배선 길을 뚫고, 적재함을 세 번 고치고, 무게를 처음 셌다](2026-07.md#2026-07-29-수--차체-배선-길을-뚫고-적재함을-세-번-고치고-무게를-처음-셌다) |
| 2026-07-30 (목) | 차체 | [모듈 3종을 더 얹고, 검사기를 의심하고, 도면을 다시 뽑다](2026-07.md#2026-07-30-목--차체-모듈-3종을-더-얹고-검사기를-의심하고-도면을-다시-뽑다) |
| 2026-07-31 (금) | 차체 | [아웃리거·확장레일을 얹었다 걷어내고, 실물 6.5인치 바퀴로 다시 앉혔다](2026-07.md#2026-07-31-금--차체-아웃리거확장레일을-얹었다-걷어내고-실물-65인치-바퀴로-다시-앉혔다) |
| 2026-08-01 (토) | 차체 | [스워브를 접고 고정 브라켓·단륜 지그로](2026-08.md#2026-08-01-토--차체-스워브를-접고-고정-브라켓단륜-지그로) |
| 2026-08-01 (토) | 차체 | [시험 지그 축소와 허브모터 축 언더컷](2026-08.md#2026-08-01-토--차체-시험-지그-축소와-허브모터-축-언더컷) |
| 2026-08-01 (토) | 차체 | [축 나사부 부재 확인과 휠브라켓의 3030 프로파일 전환](2026-08.md#2026-08-01-토--차체-축-나사부-부재-확인과-휠브라켓의-3030-프로파일-전환) |
| 2026-08-07 (금) | 차체 | [ㄷ자 휠마운트를 세우고 제작법을 고르다](2026-08.md#2026-08-07-금--차체-ㄷ자-휠마운트를-세우고-제작법을-고르다) |
| 2026-08-07 (금) | 차체 | [프린트판 분리, 프레임 이식, 도면 스크립트 복원](2026-08.md#2026-08-07-금--차체-프린트판-분리-프레임-이식-도면-스크립트-복원) |
| 2026-08-08 이전 (날짜 미상) | 바퀴 제어 | [호버보드 링크 디버깅](2026-08.md#2026-08-08-이전-날짜-미상--바퀴-제어-호버보드-링크-디버깅) |
| 2026-08-09 (일) | 바퀴 제어 | [첫 커밋과 디버깅 기록](2026-08.md#2026-08-09-일--바퀴-제어-첫-커밋과-디버깅-기록) |
| 2026-08-10 (월) | 차체 | [기록 공백을 채우고, 적재함을 기성 바구니 기준으로 다시 짰다](2026-08.md#2026-08-10-월--차체-기록-공백을-채우고-적재함을-기성-바구니-기준으로-다시-짰다) |
| 2026-08-12 (수) | 차체 | [휠 브라켓 파손 원인 분석과 하단 클램프 대안](2026-08.md#2026-08-12-수--차체-휠-브라켓-파손-원인-분석과-하단-클램프-대안) |
| 2026-08-12 (수) | 바퀴 제어 | [조향 부호 실측](2026-08.md#2026-08-12-수--바퀴-제어-조향-부호-실측) |
| 2026-08-14 (금) | 차체 | [브라켓을 네 번 다시 그렸다: A/B → C → D → 통짜 D](2026-08.md#2026-08-14-금--차체-브라켓을-네-번-다시-그렸다-ab--c--d--통짜-d) |
| 2026-08-15 (토) | 차체 | [세션 밖(GPT/Codex): 프레임 폭 450 통일·FEA 파이프라인·구형 브라켓 파손 재현](2026-08.md#2026-08-15-토--차체-세션-밖gptcodex-프레임-폭-450-통일fea-파이프라인구형-브라켓-파손-재현) |
| 2026-08-21 (금) | 차체 | [인수인계 검증, 실물 파손 반영, 플랜지 없는 FEA, 젖힘 모멘트 시각화](2026-08.md#2026-08-21-금--차체-인수인계-검증-실물-파손-반영-플랜지-없는-fea-젖힘-모멘트-시각화) |
| 2026-08-21 (금) | 차체 | [액슬 타이 보강과 휘어짐 기준 순위 정정](2026-08.md#2026-08-21-금--차체-액슬-타이-보강과-휘어짐-기준-순위-정정) |
| 2026-08-21 (금) | 차체 | [봉 길이 400 고정, git 초기 커밋, 재료 검토, T텅, 여분 3030 을 타이로](2026-08.md#2026-08-21-금--차체-봉-길이-400-고정-git-초기-커밋-재료-검토-t텅-여분-3030-을-타이로) |
| 2026-09-03 (목) | 바퀴 제어 | [D32 환경 준비 시도](2026-09.md#2026-09-03-목--바퀴-제어-d32-환경-준비-시도) |
| 2026-09-10 (목) | 차체 | [전체 차량 뷰어 탑재와 형상 기반 BOM 산출 (+ 09-15 일지화 착수)](2026-09.md#2026-09-10-목--차체-전체-차량-뷰어-탑재와-형상-기반-bom-산출--09-15-일지화-착수) |
| 2026-09-17 (목) | 바퀴 제어 | [백업 커밋 (링크 B, Wi-Fi 조종 페이지)](2026-09.md#2026-09-17-목--바퀴-제어-백업-커밋-링크-b-wi-fi-조종-페이지) |
| 2026-09-17 (목) | 바퀴 제어 | [탱크 구동, 데드밴드, NVS 설정 / 업스트림 분석 / 코드 리뷰](2026-09.md#2026-09-17-목--바퀴-제어-탱크-구동-데드밴드-nvs-설정--업스트림-분석--코드-리뷰) |
| 2026-09-17 (목) | 상위 제어 | [전방 장애물 가드](2026-09.md#2026-09-17-목--상위-제어-전방-장애물-가드) |
| 2026-09-18 (금) | 상위 제어 | [초파리 전뇌 폐루프 주행](2026-09.md#2026-09-18-금--상위-제어-초파리-전뇌-폐루프-주행) |
| 2026-09-22 (화) | 바퀴 제어 | [기본 모드 변경, 하드웨어 구성 정리, 메인보드 커스텀 빌드](2026-09.md#2026-09-22-화--바퀴-제어-기본-모드-변경-하드웨어-구성-정리-메인보드-커스텀-빌드) |
| 2026-10-04 (일) | 차체 | [차체 재설계 v00 \~ v19 — 기본 베이스부터 뎁스 카메라 선정까지](2026-10.md#2026-10-04-일--차체-차체-재설계-v00--v19--기본-베이스부터-뎁스-카메라-선정까지) |
| 2026-10-05 (월) | 차체 | [차체 재설계 v20 \~ v29 — 전원 · 구동 계통부터 내부 배선까지](2026-10.md#2026-10-05-월--차체-차체-재설계-v20--v29--전원--구동-계통부터-내부-배선까지) |
| 2026-10-13 (화) | 바퀴 제어 | [미커밋 변경 정리, 빌드물 소실 확인, 일지 재정리](2026-10.md#2026-10-13-화--바퀴-제어-미커밋-변경-정리-빌드물-소실-확인-일지-재정리) |
| 2026-10-13 (화) | 차체 | [HoverboardVehicle 차량 전용 저장소로 분리](2026-10.md#2026-10-13-화--차체-hoverboardvehicle-차량-전용-저장소로-분리) |
| 2026-10-13 (화) | 저장소 | [누비 통합 저장소 — 바퀴 제어기 · 차체 설계 통합, 일지 한 곳으로](2026-10.md#2026-10-13-화--저장소-누비-통합-저장소--바퀴-제어기--차체-설계-통합-일지-한-곳으로) |
| 2026-10-13 (화) | 바퀴 제어 | [ESP32 바퀴 모드 — 보드 · 탱크 모드를 없애고 믹싱을 ESP32로, N1 수정](2026-10.md#2026-10-13-화--바퀴-제어-esp32-바퀴-모드--보드--탱크-모드를-없애고-믹싱을-esp32로-n1-수정) |
| 2026-10-13 (화) | 바퀴 제어 | [ESP32 바퀴 모드 올리기 — 네 바퀴 시험 통과](2026-10.md#2026-10-13-화--바퀴-제어-esp32-바퀴-모드-올리기--네-바퀴-시험-통과) |
| 2026-10-13 (화) | 저장소 | [MIT 공개 준비 — 프레임 코드 직접 작성, 이력 정리](2026-10.md#2026-10-13-화--저장소-mit-공개-준비--프레임-코드-직접-작성-이력-정리) |
| 2026-10-13 (화) | 차체 | [시뮬레이터 다시 띄우기 — v28 메시, 복도 맵을 새 경로에서](2026-10.md#2026-10-13-화--차체-시뮬레이터-다시-띄우기--v28-메시-복도-맵을-새-경로에서) |
| 2026-10-13 (화) | 차체 | [시뮬레이터 GPT 운전 — 카메라 사진 + 깊이 화살표 (VLMnav 방식)](2026-10.md#2026-10-13-화--차체-시뮬레이터-gpt-운전--카메라-사진--깊이-화살표-vlmnav-방식) |
| 2026-10-13 (화) | 차체 | [시뮬레이터 Claude 운전 — SDK 연결, 대화 속 Claude가 직접 몰아 310호 앞 0.22 m](2026-10.md#2026-10-13-화--차체-시뮬레이터-claude-운전--sdk-연결-대화-속-claude가-직접-몰아-310호-앞-022-m) |
| 2026-10-13 (화) | 차체 | [시뮬레이터 운전에 지도 · 추정 위치 주기, 사람 끄기 고침](2026-10.md#2026-10-13-화--차체-시뮬레이터-운전에-지도--추정-위치-주기-사람-끄기-고침) |
| 2026-10-13 (화) | 상위 제어 | [실차 GPT 운전 준비 — Jetson · ESP32 · Xtion, PC 멈춤](2026-10.md#2026-10-13-화--상위-제어-실차-gpt-운전-준비--jetson--esp32--xtion-pc-멈춤) |
| 2026-10-13 (화) | 상위 제어 | [Jetson 유선 직결 — USB로 들어가 이더넷 고정 IP](2026-10.md#2026-10-13-화--상위-제어-jetson-유선-직결--usb로-들어가-이더넷-고정-ip) |
| 2026-10-14 (수) | 상위 제어 | [Jetson 실기 점검 — ESP32 · Xtion · HP60C, 바퀴 방향 점검판](2026-10.md#2026-10-14-수--상위-제어-jetson-실기-점검--esp32--xtion--hp60c-바퀴-방향-점검판) |
| 2026-10-14 (수) | 상위 제어 | [무선 게임패드로 실차 조종 — Jetson 수신기, L1 데드맨](2026-10.md#2026-10-14-수--상위-제어-무선-게임패드로-실차-조종--jetson-수신기-l1-데드맨) |
| 2026-10-14 (수) | 상위 제어 | [카메라로 위치 찾기 — SfM 을 Jetson 으로, 첫 주행 다시 돌려 보기, 시뮬레이터 연결, 마커 첫 시험](2026-10.md#2026-10-14-수--상위-제어-카메라로-위치-찾기--sfm-을-jetson-으로-첫-주행-다시-돌려-보기-시뮬레이터-연결-마커-첫-시험) |

## 주제별 기록

| 파일 | 영역 | 내용 |
| --- | --- | --- |
| [vehicle-2026-09-15-timeline.md](topics/vehicle-2026-09-15-timeline.md) | 차체 | 2026-07 ~ 09 흐름 정리 |
| [vehicle-2026-09-15-decisions.md](topics/vehicle-2026-09-15-decisions.md) | 차체 | 2026-07 ~ 09 결정 정리 — 무엇을 왜 골랐나 (D-NN 이전) |
| [vehicle-2026-09-15-lessons.md](topics/vehicle-2026-09-15-lessons.md) | 차체 | 삽질과 교훈 |
| [vehicle-2026-09-15-numbers.md](topics/vehicle-2026-09-15-numbers.md) | 차체 | 핵심 숫자 (09-15 기준) |
| [vehicle-2026-09-15-files.md](topics/vehicle-2026-09-15-files.md) | 차체 | 파일 지도 (09-15, `D:\build123d` 기준) |
| [vehicle-2026-09-15-next.md](topics/vehicle-2026-09-15-next.md) | 차체 | 남은 일과 다음 단계 (09-15 기준) |
| [vehicle-build-story.md](topics/vehicle-build-story.md) | 차체 | 설계 이야기 — 막힌 것과 틀린 것 위주 (2026-07-27 ~ 08-07 무렵) |
| [wheel-link-debugging.md](topics/wheel-link-debugging.md) | 바퀴 제어 | 호버보드 링크 디버깅 실패 기록과 규칙 (2026-08-08 이전, 영어) |
| [wheel-controller-portfolio.md](topics/wheel-controller-portfolio.md) | 바퀴 제어 | 포트폴리오 포인트 |

## 다른 곳에 있는 기록

아래 기록은 일지가 아니라 작업 도구와 묶여 있어서 제자리에 둡니다.

| 기록 | 위치 | 제자리에 두는 이유 |
| --- | --- | --- |
| 차체 버전 기록 v00 ~ v29 | [hardware/vehicle/models/vehicle/](../../hardware/vehicle/models/vehicle/README.md) 버전 폴더의 README | `record.py`가 자동 구역을 써 넣고, 기록을 마친 버전은 고치지 않음 |
| 차체 설계 결정 D-01 ~ | [DECISIONS.md](../../hardware/vehicle/models/vehicle/DECISIONS.md) | 버전 작업 흐름과 묶여 있음 |
| 여러 계층에 걸친 결정 | [docs/decisions/](../decisions/README.md) | — |
| 바퀴 제어기 열린 문제 | [ISSUES.md](../../firmware/wheel-controller/ISSUES.md) | 상태 칸을 계속 고치는 목록 |
| 부품 조사 원자료 | [research/](../../hardware/vehicle/models/vehicle/research/) | DECISIONS.md가 근거로 링크 |
| 구조해석 결과 | `hardware/vehicle/models/hoverboard_mount/output/fea/*.md`, `hardware/vehicle/tools/fea/*.md`, `hardware/vehicle/tools/frame/*.md` | 해석 산출물 옆 |
| FEA 작업 규칙과 인수인계 | [FEA.md](../../hardware/vehicle/models/hoverboard_mount/FEA.md), [CLAUDE_HANDOFF.md](../../hardware/vehicle/models/hoverboard_mount/CLAUDE_HANDOFF.md) | FEA 작업 전에 읽는 문서 |
| 일지 그림 | [hardware/vehicle/docs/images/](../../hardware/vehicle/docs/images/) | `tools/figures/tipping_moment.py`가 이 폴더에 그림을 씀 |
