chungddong/NUBI/docs/worklog/2026-10.md

# 작업 일지 — 2026년 10월

양식과 전체 연표는 [README](README.md)에 있습니다.

| 날짜 | 영역 | 제목 |
| --- | --- | --- |
| 2026-10-04 (일) | 차체 | [차체 재설계 v00 \~ v19 — 기본 베이스부터 뎁스 카메라 선정까지](#2026-10-04-일--차체-차체-재설계-v00--v19--기본-베이스부터-뎁스-카메라-선정까지) |
| 2026-10-05 (월) | 차체 | [차체 재설계 v20 \~ v29 — 전원 · 구동 계통부터 내부 배선까지](#2026-10-05-월--차체-차체-재설계-v20--v29--전원--구동-계통부터-내부-배선까지) |
| 2026-10-13 (화) | 바퀴 제어 | [미커밋 변경 정리, 빌드물 소실 확인, 일지 재정리](#2026-10-13-화--바퀴-제어-미커밋-변경-정리-빌드물-소실-확인-일지-재정리) |
| 2026-10-13 (화) | 차체 | [HoverboardVehicle 차량 전용 저장소로 분리](#2026-10-13-화--차체-hoverboardvehicle-차량-전용-저장소로-분리) |
| 2026-10-13 (화) | 저장소 | [누비 통합 저장소 — 바퀴 제어기 · 차체 설계 통합, 일지 한 곳으로](#2026-10-13-화--저장소-누비-통합-저장소--바퀴-제어기--차체-설계-통합-일지-한-곳으로) |
| 2026-10-13 (화) | 바퀴 제어 | [ESP32 바퀴 모드 — 보드 · 탱크 모드를 없애고 믹싱을 ESP32로, N1 수정](#2026-10-13-화--바퀴-제어-esp32-바퀴-모드--보드--탱크-모드를-없애고-믹싱을-esp32로-n1-수정) |
| 2026-10-13 (화) | 바퀴 제어 | [ESP32 바퀴 모드 올리기 — 네 바퀴 시험 통과](#2026-10-13-화--바퀴-제어-esp32-바퀴-모드-올리기--네-바퀴-시험-통과) |
| 2026-10-13 (화) | 저장소 | [MIT 공개 준비 — 프레임 코드 직접 작성, 이력 정리](#2026-10-13-화--저장소-mit-공개-준비--프레임-코드-직접-작성-이력-정리) |
| 2026-10-13 (화) | 차체 | [시뮬레이터 다시 띄우기 — v28 메시, 복도 맵을 새 경로에서](#2026-10-13-화--차체-시뮬레이터-다시-띄우기--v28-메시-복도-맵을-새-경로에서) |
| 2026-10-13 (화) | 차체 | [시뮬레이터 GPT 운전 — 카메라 사진 + 깊이 화살표 (VLMnav 방식)](#2026-10-13-화--차체-시뮬레이터-gpt-운전--카메라-사진--깊이-화살표-vlmnav-방식) |
| 2026-10-13 (화) | 차체 | [시뮬레이터 Claude 운전 — SDK 연결, 대화 속 Claude가 직접 몰아 310호 앞 0.22 m](#2026-10-13-화--차체-시뮬레이터-claude-운전--sdk-연결-대화-속-claude가-직접-몰아-310호-앞-022-m) |
| 2026-10-13 (화) | 차체 | [시뮬레이터 운전에 지도 · 추정 위치 주기, 사람 끄기 고침](#2026-10-13-화--차체-시뮬레이터-운전에-지도--추정-위치-주기-사람-끄기-고침) |
| 2026-10-13 (화) | 상위 제어 | [실차 GPT 운전 준비 — Jetson · ESP32 · Xtion, PC 멈춤](#2026-10-13-화--상위-제어-실차-gpt-운전-준비--jetson--esp32--xtion-pc-멈춤) |
| 2026-10-13 (화) | 상위 제어 | [Jetson 유선 직결 — USB로 들어가 이더넷 고정 IP](#2026-10-13-화--상위-제어-jetson-유선-직결--usb로-들어가-이더넷-고정-ip) |
| 2026-10-14 (수) | 상위 제어 | [Jetson 실기 점검 — ESP32 · Xtion · HP60C, 바퀴 방향 점검판](#2026-10-14-수--상위-제어-jetson-실기-점검--esp32--xtion--hp60c-바퀴-방향-점검판) |
| 2026-10-14 (수) | 상위 제어 | [무선 게임패드로 실차 조종 — Jetson 수신기, L1 데드맨](#2026-10-14-수--상위-제어-무선-게임패드로-실차-조종--jetson-수신기-l1-데드맨) |
| 2026-10-14 (수) | 상위 제어 | [카메라로 위치 찾기 — SfM 을 Jetson 으로, 첫 주행 다시 돌려 보기, 시뮬레이터 연결, 마커 첫 시험](#2026-10-14-수--상위-제어-카메라로-위치-찾기--sfm-을-jetson-으로-첫-주행-다시-돌려-보기-시뮬레이터-연결-마커-첫-시험) |

---

## 2026-10-04 (일) · 차체: 차체 재설계 v00 \~ v19 — 기본 베이스부터 뎁스 카메라 선정까지

> 장소: PC (`D:\build123d`) · 날짜 근거: 버전 기록 날짜 · 원본: 차체 버전 README와 DECISIONS.md (2026-10-13 통합 때 버전 표에서 엮음)

09-15 이후 멈춰 있던 차체를 처음부터 버전별로 다시 설계하기 시작했다. 재설계 직전 상태(09-17)를 `v00_ref`로 남겨 비교 기준으로 두고, `v01_base`부터 버전 = 폴더 규칙과 `record.py` 기록 도구로 하루에 20개 버전을 기록했다. 실외용 외관과 실물 부품 모델이 들어갔고, 방수 등급을 기준에서 빼고(D-01), 부품은 국내 구매만 하기로(D-08) 정했다. 버전마다 무엇을 왜 바꿨는지는 각 버전 README에 있다.

### 한 일

| 버전 | 기록 날짜 | 제목 | 요약 |
| --- | --- | --- | --- |
| [v00_ref](../../hardware/vehicle/models/vehicle/v00_ref/README.md) | 2026-09-17 | 재설계 직전 참조 | 09-17 마지막 설계 — H 크로스 + 혀 선반 + 상부 프레임 (비교 기준) |
| [v01_base](../../hardware/vehicle/models/vehicle/v01_base/README.md) | 2026-10-04 | 기본 베이스 | 하부 프레임 + 바퀴 + T 클램프만 남기고, 축크로스를 ±265 → ±210 (혀 위) 로 옮겼다 |
| [v02_posts](../../hardware/vehicle/models/vehicle/v02_posts/README.md) | 2026-10-04 | 기둥 배치 | 축크로스 자리(x=±210) 레일 위에 상부 프레임용 기둥 4 본 (3030 x 143) |
| [v03_posts](../../hardware/vehicle/models/vehicle/v03_posts/README.md) | 2026-10-04 | 기둥 10 본 | 옛 기둥 자리 6 본 (x=0 · ±365) 을 더해 크로스 자리마다 기둥 — 좌우 10 본 (상부 프레임은 아직 없음) |
| [v04_posts6](../../hardware/vehicle/models/vehicle/v04_posts6/README.md) | 2026-10-04 | 기둥 6 본 (옛 자리) | 기둥을 옛 자리 6 본 (x=0 · ±365) 만 남기고 축크로스 자리 (±210) 4 본은 뺐다 |
| [v05_floor](../../hardware/vehicle/models/vehicle/v05_floor/README.md) | 2026-10-04 | 바닥판 | 하부 프레임 위 바닥판 — 기둥 노치 6 · M6 고정 18 · 케이블 그로밋 4 · M5 격자 (아크릴 5t 기준) |
| [v06_floor10](../../hardware/vehicle/models/vehicle/v06_floor10/README.md) | 2026-10-04 | 바닥판 기둥 6·10 겸용 | 바닥판 노치를 크로스 5 곳 전부 (10 개) 로 — 기둥 6 본 · 10 본 어느 쪽이든 같은 판 |
| [v07_parts](../../hardware/vehicle/models/vehicle/v07_parts/README.md) | 2026-10-04 | 노치 R3 + 부품 가배치 | 노치 모서리 R3, 판 위에 부품 가형태 9 개 (배터리 · 드라이버 2 · 젯슨 · ESP32 · 전원 3 · IMU) |
| [v08_realparts](../../hardware/vehicle/models/vehicle/v08_realparts/README.md) | 2026-10-04 | 부품 실측 모델 | 부품을 실측 치수 모델로 (볼트온 20Ah · ZLAC8015D · 젯슨 · Victron MIDI · Fotek SSR · DC-DC · BNO085) |
| [v09_floor_pc](../../hardware/vehicle/models/vehicle/v09_floor_pc/README.md) | 2026-10-04 | 실외 바닥판 (PC · 부품 고정 구멍) | 실외 바닥판 — PC 5t, 글랜드 M20, 격자 없앰, 부품 고정 구멍 · 배터리 밴드 슬롯 |
| [v10_shell](../../hardware/vehicle/models/vehicle/v10_shell/README.md) | 2026-10-04 | 외관판 (ACM · PC · ASA 펜더) | 실외 외관 — ACM 옆판 · 윗판, UV PC 앞뒤판, ASA 펜더 4 · 범퍼 2 · 루버 덮개 2 |
| [v11_shell_h](../../hardware/vehicle/models/vehicle/v11_shell_h/README.md) | 2026-10-04 | 외관 벽 상부 프레임 높이까지 (윗판 뺌) | 윗판 뺌, 벽을 상부 프레임 윗면 (z=296.85, 3030 가정) 까지 — 상부 슬롯 M5 미리 |
| [v12_nofender](../../hardware/vehicle/models/vehicle/v12_nofender/README.md) | 2026-10-04 | 펜더 뺌 | 바퀴 펜더 4 개를 뺐다 (옆판 고정 구멍은 그대로) |
| [v13_opaque](../../hardware/vehicle/models/vehicle/v13_opaque/README.md) | 2026-10-04 | 소재 불투명으로 | 투명 · 반투명 없이 불투명으로 — 바닥판 불투명 PC 5t, 앞뒤판 불투명 UV PC 3t |
| [v14_rear_io](../../hardware/vehicle/models/vehicle/v14_rear_io/README.md) | 2026-10-04 | 뒤판 포트칸 · 카메라 · 고무범퍼 | 뒤판 오목 포트 칸 (덮개) · 비상정지 · 팬, 앞뒤 뎁스 카메라 창 · 차양, ASA 범퍼 → 고무 범퍼 4+4 |
| [v15_rear2](../../hardware/vehicle/models/vehicle/v15_rear2/README.md) | 2026-10-04 | 고무 띠 범퍼 · 배기 양쪽 · 포트칸 카메라 아래 | 고무 범퍼 → 이어진 고무 띠, 뒤판 배기 팬 양쪽 · 포트 칸 카메라 아래, 카메라 차양 뺌 |
| [v16_camera](../../hardware/vehicle/models/vehicle/v16_camera/README.md) | 2026-10-04 | 뎁스 카메라 실물 · BOM | 뎁스 카메라 Orbbec Gemini 336L 실물 모델 (스타디움 창 · 브래킷), 포트 칸 60, BOM 시작 |
| [v17_estop](../../hardware/vehicle/models/vehicle/v17_estop/README.md) | 2026-10-04 | 비상정지 실물 · 카메라 검토 | 비상정지 Schneider XB5AS8442 실물 모델 (+ 노란 Ø60 명판, 회전방지 홈), 팬 · 비상정지 높이 조정 |
| [v18_simplify](../../hardware/vehicle/models/vehicle/v18_simplify/README.md) | 2026-10-04 | IP 기준 뺌 — 비상정지 Autonics · 그로밋 · 덮개 정리 | 방수 기준 뺌 — 비상정지 Autonics SF2ER-E2RB 실물, 그로밋 Ø25, 루버 덮개 뺌, BOM 정리 |
| [v19_gemini336](../../hardware/vehicle/models/vehicle/v19_gemini336/README.md) | 2026-10-04 | 뎁스카메라 Gemini 336 (저가 · 햇빛 대응) | 카메라 Gemini 336L → Gemini 336 (308,000 절감), 끝면 USB-C, 선반형 브래킷 |

### 결정

- [D-01](../../hardware/vehicle/models/vehicle/DECISIONS.md#d-01-방수--방진-등급은-기준에서-뺀다--확정-v18-2026-10-04) 방수 · 방진 등급은 기준에서 뺀다 — 확정 (v18, 2026-10-04)
- [D-02](../../hardware/vehicle/models/vehicle/DECISIONS.md#d-02-뎁스-카메라-orbbec-gemini-336-2--확정-v19-2026-10-04) 뎁스 카메라 Orbbec Gemini 336 ×2 — 확정 (v19, 2026-10-04)
- [D-08](../../hardware/vehicle/models/vehicle/DECISIONS.md#d-08-부품은-국내-구매만--확정-2026-10-04) 부품은 국내 구매만 — 확정 (2026-10-04)

---

## 2026-10-05 (월) · 차체: 차체 재설계 v20 \~ v29 — 전원 · 구동 계통부터 내부 배선까지

> 장소: PC (`D:\build123d`) · 날짜 근거: 버전 기록 날짜 · 원본: 차체 버전 README와 DECISIONS.md (2026-10-13 통합 때 버전 표에서 엮음)

전원 · 구동 계통을 실제 부품으로 정하고(호버보드 원래 보드 4장, 36 V 배터리, 컨택터 비상정지, iAHRS), 전조등 · 안테나 · 상부 프레임 · 모듈 레일 · 센서 모듈을 얹은 뒤 내부 배선 90가닥까지 넣었다. 웹 시뮬레이터를 만들어 사각지대 · 전복 · 비상정지 방식 · 자율주행을 추정했다(D-18, D-19). v29(배선을 바닥판 위 직각 경로로)는 검증을 통과하지 못해 진행 중으로 남았다(D-21).

### 한 일

| 버전 | 기록 날짜 | 제목 | 요약 |
| --- | --- | --- | --- |
| [v20_power](../../hardware/vehicle/models/vehicle/v20_power/README.md) | 2026-10-05 | 전원 · 구동 계통 확정 (호버보드 원래 보드 · 30A 배터리 · 컨택터 · iAHRS) | 호버보드 원래 보드 ×2 · ZENION 20Ah 30 A · DC 차단기 + 컨택터 · 12V/5V 국내품 · iAHRS, BOM 국내 구매처 |
| [v21_split_ports](../../hardware/vehicle/models/vehicle/v21_split_ports/README.md) | 2026-10-05 | 분리형 보드 4장 · 포트칸 실물 · 배기팬 실물 | 모터 드라이버 = 2 세대 분리형 보드 4 장, 포트 칸 실물 7 개, 배기 팬 EC8025H05B + 가드 |
| [v22_headlight](../../hardware/vehicle/models/vehicle/v22_headlight/README.md) | 2026-10-05 | 전조등 | 전조등 MR16 12V 5W ×2 + ASA 테두리 · 고정 링, MOSFET 모듈 (ESP32 PWM) |
| [v23_upper_eyebrow](../../hardware/vehicle/models/vehicle/v23_upper_eyebrow/README.md) | 2026-10-05 | 상부 프레임 + 눈썹 안테나 | 상부 프레임 3030 (레일 2 · 크로스 3, 기둥 볼트 M8) + 전조등 위 눈썹 안테나 2 |
| [v24_camera_mouth](../../hardware/vehicle/models/vehicle/v24_camera_mouth/README.md) | 2026-10-05 | 앞 카메라 내림 (입) | 앞 뎁스 카메라 z 250 → 172 (전조등 아래 = 입), 뒤는 그대로 |
| [v25_top_cover](../../hardware/vehicle/models/vehicle/v25_top_cover/README.md) | 2026-10-05 | 상부 덮개 | 상부 덮개 ACM 3t 766 × 456 R6, M5 손나사 10, 기둥 볼트 머리 구멍 |
| [v26_module_rails](../../hardware/vehicle/models/vehicle/v26_module_rails/README.md) | 2026-10-05 | 모듈 레일 2020 · 덮개 두 장 | 모듈 레일 2020 ×3 (상부 프레임 위), 덮개 레일 사이 두 장 · 그로밋 2, 기둥 이음 -> 코너 브래킷 |
| [v27_sensor_module](../../hardware/vehicle/models/vehicle/v27_sensor_module/README.md) | 2026-10-05 | 센서 모듈 (라이다 · GPS · 표시등) | 센서 모듈 — 라이다 STL-19P (스캔 z 526) · GPS630 · 큐라이트 표시등 3 단, AL 밑판이 레일 3 본에 T 너트 |
| [v28_wiring](../../hardware/vehicle/models/vehicle/v28_wiring/README.md) | 2026-10-05 | 내부 배선 | 내부 배선 — 분기 레일 (차단기 20 A ×4 · 퓨즈 15 A ×3) · 음극 N 바 · WAGO · USB 허브 + 전선 90 가닥 · 간선 2 (겹침 0) |
| [v29_floor_wiring](../../hardware/vehicle/models/vehicle/v29_floor_wiring/README.md) | 2026-10-05 | 배선 바닥 정리 (진행 중) | 전선을 바닥판 위 직각 경로로 (router A*), XT90 · 분기 레일 · N 바 자리 옮김 — **검증 실패 남음** (판 2 · 선끼리 69) |

### 결정

- [D-03](../../hardware/vehicle/models/vehicle/DECISIONS.md#d-03-모터-드라이버--호버보드-원래-2-세대-분리형-보드-4-장--robodurden-gen2x-펌웨어--잠정-v21-2026-10-05-개정) 모터 드라이버 = 호버보드 원래 2 세대 분리형 보드 4 장 + RoboDurden Gen2.x 펌웨어 — 잠정 (v21, 2026-10-05 개정)
- [D-04](../../hardware/vehicle/models/vehicle/DECISIONS.md#d-04-배터리--36-v-10s-20-ah-bms-30-a-급--펌웨어-속도-제한--잠정-v20) 배터리 = 36 V 10S 20 Ah, BMS 30 A 급 + 펌웨어 속도 제한 — 잠정 (v20)
- [D-05](../../hardware/vehicle/models/vehicle/DECISIONS.md#d-05-비상정지--dc-컨택터로-바퀴-쪽-전원만-끊는다--확정-v20) 비상정지 = DC 컨택터로 바퀴 쪽 전원만 끊는다 — 확정 (v20)
- [D-06](../../hardware/vehicle/models/vehicle/DECISIONS.md#d-06-방향-센서--iahrs-rb-sda-v1--확정-v20) 방향 센서 = iAHRS RB-SDA-v1 — 확정 (v20)
- [D-07](../../hardware/vehicle/models/vehicle/DECISIONS.md#d-07-전원-변환--보호--확정-v20) 전원 변환 · 보호 — 확정 (v20)
- [D-09](../../hardware/vehicle/models/vehicle/DECISIONS.md#d-09-배기-팬--evercool-ec8025h05b--efg-s80-가드--확정-v21) 배기 팬 = EVERCOOL EC8025H05B + EFG-S80 가드 — 확정 (v21)
- [D-10](../../hardware/vehicle/models/vehicle/DECISIONS.md#d-10-포트-칸--국내-실물-7-개-두-줄-배치--잠정-v21-일부-구멍-치수-실물-확인-전) 포트 칸 = 국내 실물 7 개, 두 줄 배치 — 잠정 (v21, 일부 구멍 치수 실물 확인 전)
- [D-11](../../hardware/vehicle/models/vehicle/DECISIONS.md#d-11-전조등--mr16-12-v-5-w-led-2--asa-테두리--고정-링-esp32-pwm--잠정-v22-2026-10-05) 전조등 = MR16 12 V 5 W LED ×2 + ASA 테두리 · 고정 링, ESP32 PWM — 잠정 (v22, 2026-10-05)
- [D-12](../../hardware/vehicle/models/vehicle/DECISIONS.md#d-12-눈썹-안테나--젯슨-와이파이-2-개를-앞판-밖으로--잠정-v23-2026-10-05) 눈썹 안테나 = 젯슨 와이파이 2 개를 앞판 밖으로 — 잠정 (v23, 2026-10-05)
- [D-13](../../hardware/vehicle/models/vehicle/DECISIONS.md#d-13-상부-프레임--하부와-같은-3030-사각--가운데-크로스--확정-v23) 상부 프레임 = 하부와 같은 3030 사각 + 가운데 크로스 — 확정 (v23)
- [D-14](../../hardware/vehicle/models/vehicle/DECISIONS.md#d-14-앞-뎁스-카메라를-전조등-아래로-입--확정-v24-2026-10-05) 앞 뎁스 카메라를 전조등 아래로 (입) — 확정 (v24, 2026-10-05)
- [D-15](../../hardware/vehicle/models/vehicle/DECISIONS.md#d-15-상부-덮개--acm-3t-손나사-m5-10-기둥-볼트-머리-구멍--잠정-v25-2026-10-05) 상부 덮개 = ACM 3t, 손나사 M5 10, 기둥 볼트 머리 구멍 — 잠정 (v25, 2026-10-05)
- [D-16](../../hardware/vehicle/models/vehicle/DECISIONS.md#d-16-모듈-레일--2020-3-을-상부-프레임-위에-덮개는-레일-사이-두-장--확정-v26-2026-10-05) 모듈 레일 = 2020 ×3 을 상부 프레임 위에, 덮개는 레일 사이 두 장 — 확정 (v26, 2026-10-05)
- [D-17](../../hardware/vehicle/models/vehicle/DECISIONS.md#d-17-첫-모듈--센서-모듈-라이다-stl-19p--gps630--큐라이트-표시등--잠정-v27-2026-10-05) 첫 모듈 = 센서 모듈 (라이다 STL-19P · GPS630 · 큐라이트 표시등) — 잠정 (v27, 2026-10-05)
- [D-18](../../hardware/vehicle/models/vehicle/DECISIONS.md#d-18-차량-웹-시뮬레이터--확정-2026-10-05) 차량 웹 시뮬레이터 — 확정 (2026-10-05)
- [D-19](../../hardware/vehicle/models/vehicle/DECISIONS.md#d-19-시뮬레이터로-본-것--사각지대--전복--비상정지-방식--자율주행-2026-10-05-결정-대기) 시뮬레이터로 본 것 — 사각지대 · 전복 · 비상정지 방식 · 자율주행 (2026-10-05, 결정 대기)
- [D-20](../../hardware/vehicle/models/vehicle/DECISIONS.md#d-20-내부-배선--분기-레일--음극-한-점--wago-분배--usb-허브--잠정-v28-2026-10-05) 내부 배선 — 분기 레일 · 음극 한 점 · WAGO 분배 · USB 허브 — 잠정 (v28, 2026-10-05)
- [D-21](../../hardware/vehicle/models/vehicle/DECISIONS.md#d-21-배선을-바닥판-위-직각-경로로--진행-중-v29-2026-10-05-) 배선을 바닥판 위 직각 경로로 — 진행 중 (v29, 2026-10-05 ~)

### 남은 일

- D-19 결정 대기: 옆 낮은 장애물 센서, 비상정지 방식
- D-21: 판 닿음 2, 전선끼리 겹침 69 해결 후 v29 기록

---

## 2026-10-13 (화) · 바퀴 제어: 미커밋 변경 정리, 빌드물 소실 확인, 일지 재정리

> 장소: PC · 날짜 근거: 세션, 커밋 · 커밋: `453ab93`, 그리고 이 일지와 ISSUES.md를 담은 문서 커밋 · 관련 이슈: H1 · 원본: 바퀴 제어기 작업 일지 `firmware/wheel-controller/WORKLOG.md`

### 한 일

- **원격과 비교**: `git fetch` 결과, 로컬 `main`과 `origin/main`은 둘 다 `946fe69`로 같았다. 하지만
  09-17~09-22 작업(`main.cpp` +193/−25, `README.md` +100/−34, 새 `WORKLOG.md`)이 **3주 넘게 커밋되지 않은
  채** 남아 있었다. 보드에 올라간 펌웨어가 저장소 어디에도 없는 상태였다.
- **빌드 확인**: 미커밋 코드를 그대로 빌드했더니 RAM 14.0 %, Flash 61.6 %(**806,889 B**)였다. 09-17 기록과
  바이트 단위까지 같아서, 보드에 플래시된 버전과 같은 코드로 본다.
- **git 작성자 설정**: 이 PC에는 git 사용자 정보가 없어서 커밋이 막혔다. 기존 커밋과 같은
  `chungddong`으로 저장소 한정(`git config`, `--global` 아님) 설정을 했다.
- **커밋** `453ab93 feat: 탱크 구동 모드, 데드밴드, NVS 설정 추가`: `main.cpp`와 `README.md`
- **일지 재정리**: 주제별 번호 구조를 날짜별 항목으로 바꿨다. 날짜마다 근거(커밋, 파일 시각, 세션,
  타 머신)를 달고, 날짜 색인 표를 만들었다. 리뷰 결과와 할 일은 [ISSUES.md](../../firmware/wheel-controller/ISSUES.md)로 분리하고 N4,
  H1~H3을 새로 번호 매겼다. README의 문서 안내도 바꿨다.

### 확인한 것

#### 재확인

- R9(`hoverctl.cmd`가 `pythonw.exe`), R10(README `COM20` 3곳), R12(`.pyc` 추적, "Four guards")가 그대로다.

### 발견한 문제

- **메인보드 커스텀 bin 소실(H1)**: 09-22에 빌드한 `mainboard-out/` 폴더가 비어 있고, 업스트림 클론
  폴더(`gd32/`)에도 git pack 파일만 남았다. 폴더 시각이 `gd32/` 09-28 10:58, `mainboard-out/`
  09-29 11:15이라 그 무렵 Windows 임시 파일 정리에 지워진 것으로 추정한다. 업스트림 커밋 해시,
  패치, 설정 변경이 09-22 항목에 있어서 다시 빌드할 수는 있다.
- 09-22에 채팅에 첨부했던 사본이 남아 있으면 그걸 쓰면 되고, 없으면 다시 빌드한다.
- 교훈: **임시 폴더에 둔 산출물은 일주일 만에 사라졌다.** 다시 빌드하면 저장소 안(`mainboard/`)에 둘지 정해야 한다.

### 남은 일

- N1(콘솔 강건화 + `|명령| < 50 → 0`)이 최우선이다. 전체 순서는 [ISSUES.md](../../firmware/wheel-controller/ISSUES.md)에 있다.

---

## 2026-10-13 (화) · 차체: HoverboardVehicle 차량 전용 저장소로 분리

> 장소: PC · 날짜 근거: 커밋 · 커밋: `30c45f1` ~ `483dbf0` · 원본: HoverboardVehicle 커밋 기록과 README (2026-10-13 통합 때 엮음)

`D:\build123d` 작업 저장소에 다른 프로젝트와 섞여 있던 차량 부분만 커밋 기록째 떼어 `HoverboardVehicle` 저장소로 옮겼다. 같은 날 누비 통합 저장소의 `hardware/vehicle/`로 다시 들어왔다.

### 한 일

- `30c45f1` 저장소 정리 — README · .gitignore · requirements, 로그 추적 해제
- `ea6d067` 호버보드 마운트 · 구조해석 갱신 — Design D 클램프 변형, H 조립 · 프레임 해석
- `0eb1d0d` 차량 재설계 v00 ~ v29 — 버전 기록 · 결정 기록 · 부품 조사
- `ec021eb` 차량 웹 시뮬레이터 — 주행 · 센서 · 전원 · 사각지대 · 전복 · 비상정지 · 자율주행 · 복도
- `7d09508` 작업일지 · 보조 도구 — 모빌리티 베이스 일지 (2026-07 ~ 09), BOM 집계
- `483dbf0` 차량 전용 저장소로 분리 — README · CLAUDE.md · SETUP · .gitignore · 실행 설정

처음 커밋 `6a28e93`(2026-08-21, 호버보드 휠 마운트 + 모빌리티 베이스)부터의 기록이 함께 옮겨졌다.

### 결정

- 버전 산출물 중 `scene.npz`(메시 캐시)와 버전별 STEP은 git에 넣지 않는다(합치면 600 MB). 마지막 검증 버전 STEP(`v28_wiring.step`, 20 MB) 하나만 공유용으로 담는다.

---

## 2026-10-13 (화) · 저장소: 누비 통합 저장소 — 바퀴 제어기 · 차체 설계 통합, 일지 한 곳으로

> 시간: 13:57 ~ · 장소: PC (`F:\Develop\NUBI`) · 날짜 근거: 세션, 커밋 · 커밋: `acd426c` ~ · 원본: 이 저장소에서 처음 쓴 일지

흩어져 있던 누비 작업을 한 저장소로 모은 날이다. 폴더 구조를 잡고, 바퀴 제어기(`lolind32-wheel`)와 차체 설계
(`HoverboardVehicle`) 저장소를 커밋 이력째 들여왔고, 두 곳에 따로 있던 일지와 기록을 이 폴더 한 곳에 같은 양식의
Markdown으로 모았다.

### 한 일

#### 저장소 구조

- 폴더 구조(docs, hardware, firmware, software, sim, tools, data, experiments)와 폴더별 README 작성, git 초기화(`acd426c`)
- 바퀴 제어기 기록에서 계층 구성과 인터페이스를 뽑아 [system-overview.md](../architecture/system-overview.md) 작성

#### 바퀴 제어기 통합

- `lolind32-wheel`(main `a357092`, 커밋 5개)을 `git subtree add`로 `firmware/wheel-controller/`에 통합(`d13c5a1`)
- 통합 정리: 추적되던 `tools/__pycache__/*.pyc` 제거(ISSUES R12 일부), `requirements.txt` 추가와 README에 venv 생성 절차
  기록(ISSUES U10 일부)

#### 차체 설계 통합

- `HoverboardVehicle`(master `483dbf0`, 커밋 7개, 파일 1,245개, 팩 75 MB)을 `git subtree add`로 `hardware/vehicle/`에 통합(`a31c62c`)
- 줄바꿈 처리 두 가지: DXF 117개는 CRLF로 저장돼 있어 `*.dxf -text`, `tools/figures/tipping_moment.py`는 CR CR LF가 섞여
  있어(파이썬은 CR 하나도 줄바꿈으로 읽음) 그 파일만 `-text`로 바이트를 그대로 둠
- 차체 설계 결정(D-01 ~ D-21)을 system-overview에 반영: 컴퓨터 · 센서 · 전원 · 비상정지 구성, 차체 설계가 ESP32에
  요구하지만 펌웨어에 없는 기능 6가지

#### 개발 환경 복구

- `firmware/wheel-controller/.venv`: platformio 6.2.0, pyserial 3.5 설치 후 빌드 성공
- `hardware/vehicle/.venv`: `requirements.txt`(build123d 0.11.1, ocp_vscode 4.0.0, numpy, scipy, matplotlib, pillow, vtk, ezdxf)
  설치 후 SETUP.md의 확인 명령 통과

#### 일지와 기록을 한 곳으로

- 차체 설계 일지(HTML 22편 + 정리 6편), 바퀴 제어기 `WORKLOG.md`(10개 항목), 이 저장소의 10월 일지를 이 폴더로 모았다.
  월별 파일 4개에 36개 항목, 주제별 기록 9개
- 양식 통일: 제목 `날짜 (요일) · 영역: 제목`, 인용 줄에 시간 · 장소 · 날짜 근거 · 커밋 · 관련 이슈 · 원본, 본문은 정해진
  칸(배경 / 한 일 / 결정 / 확인한 것 / 발견한 문제 / 남은 일 / 교훈 / 이후 달라진 것 / 참고)
- HTML 일지는 스크립트로 Markdown으로 바꿨다. 본문 문장은 그대로 두고 틀만 바꿨다. 사용자 질문(인용), 표, 이미지,
  일지끼리의 링크까지 옮겼다
- 일지가 없던 10-04 · 10-05 차체 재설계는 버전 표와 DECISIONS.md에서 엮어 항목을 만들었다
- `build-log.md`, `DEBUGGING.md`, WORKLOG 부록(포트폴리오 포인트)은 [topics/](topics/)로 옮겼다

#### 공개 준비

- 공개 저장소로 올리기 전에 루트 README를 다시 썼다: 대표 이미지(v28), 특징, 시작하기(차체 · 시뮬레이터 · 펌웨어),
  문서 안내, 출처와 라이선스. 로컬 경로가 들어간 통합 계획 표는 빼고 이 일지로 넘겼다
- 비공개였던 원래 저장소 두 곳으로 가는 링크(공개 후 404)를 이름만 남기고 뺐다
- 전체 이력에서 비밀값 패턴(API 키, 토큰 등)을 찾았다. 없었다
- 바퀴 제어기 Wi-Fi 이름 · 비밀번호를 `src/main.cpp`에서 git에 올리지 않는 `include/wifi_config.h`로 뺐다.
  예시 파일(`wifi_config.example.h`)만 커밋하고, 파일이 없으면 빌드가 이유를 말하며 멈추고(`#error`), 8자 미만이면
  `static_assert`로 막는다. 이 PC에는 새 무작위 비밀번호로 만들어 두었다(다음 플래시부터 적용). 빌드 확인
- 로컬 사용자 경로(`C:\Users\…`)를 `Path.home()` · `$env:USERPROFILE`로 바꿨다(`wheel_mount.py`,
  `run_clamp_fea.ps1`, `CLAUDE_HANDOFF.md`, 파일 지도). 같은 PC에서는 같은 경로를 가리킨다
- 시뮬레이터 복도 설명의 학교 이름을 "실제 건물"로 바꿨다
- 재배포 조건을 모르는 외부 자료를 git에서 뺐다(파일은 이 PC에 남기고 `.gitignore`): 휠 모터 STEP,
  그 형상이 들어간 `v28_wiring.step`(휠모터 4개 포함), SPG 카탈로그 토크 표 그림 2장. 휠 모터 STEP을 어디에
  둬야 하는지는 `hardware/vehicle/refmodel/README.md`에 적었다
- 이력 정리(외부 STEP · 그림, 사용자 경로, 학교 이름을 이력 전체에서 지우기)를 임시 복제본에서 시험했다. 지울 대상
  0건, 최신 트리 동일, 바퀴 제어기 쪽 해시 유지, 바뀐 커밋 12개. 공개는 나중이라 원래 저장소에는 적용하지 않고 절차를
  [공개 전 체크리스트](../guides/before-publishing.md)에 남겼다

#### 저녁 — 다른 세션 작업 정리, 메인보드 펌웨어를 저장소 밖으로

- 다른 세션이 커밋하지 않고 남긴 작업(ESP32 바퀴 모드 · N1 수정 · `wheelbench`, ADR 0001, 일지 세 편, 메인보드 펌웨어
  복원 · 굽기)을 확인했다. ESP32 빌드는 기록과 같은 805,909 B로 다시 나왔다
- 저장소를 MIT로 공개하기로 하면서, GPL-3.0 업스트림을 고친 메인보드 펌웨어와 그 기록을 모두 저장소 밖으로 뺐다.
  `firmware/hoverboard-mainboard/` 폴더 통째로 git에서 제외(루트 `.gitignore`)하고, 공개 일지 · ISSUES에 있던 메인보드
  빌드 · 굽기 내용(09-22 커스텀 빌드 절, 10-13 펌웨어 복원 항목, 굽기 절차, ISSUES H1 · H2 · H4 원문)은 그 폴더의
  `WORKLOG.md`로 원문 그대로 옮겼다. 공개 문서에는 바퀴 제어기가 기대하는 보드 쪽 동작(프레임 `iSpeed` = 마스터 바퀴,
  `iSteer` = 슬레이브 바퀴)과 결정(ADR 0001)만 남겼다
- 이 폴더는 처음부터 git에 올린 적이 없어(빈 `.gitkeep`만 있었음) 이력 정리는 필요 없다. 09-22 절에 있던 업스트림 `main.c` 패치
  일곱 줄은 예전 커밋(바퀴 제어기 WORKLOG, 9월 일지)에 남아 있다

### 결정

- `freecadAI/projects/av-platform` CAD 작업은 쓰지 않는다. 기구 설계는 HoverboardVehicle을 이어 간다
- 두 저장소 모두 커밋 이력째 통합한다. 커밋 수가 적어 비용이 거의 없고, 원래 해시가 문서 근거로 인용되고 있다
- HoverboardVehicle은 쪼개지 않고 `hardware/vehicle/` 한 폴더로 둔다. 모든 스크립트가 `Path(__file__).parents[N]`로
  경로를 잡고, 기록을 마친 버전 폴더는 고치지 않는 규칙이라 안쪽 구조를 바꾸면 다시 지을 수 없게 된다
- 일지와 시간순 기록은 `docs/worklog/` 한 곳에만 쓴다. 결정은 범위로 나눈다: 차체는 `DECISIONS.md`(D-NN), 여러 계층에
  걸친 것은 `docs/decisions/`
- 저장소는 MIT로 공개한다. 메인보드 펌웨어(GPL-3.0 업스트림을 고친 것)와 그 빌드 · 굽기 기록은 저장소에 넣지 않고 이
  PC에서만 관리한다(`firmware/hoverboard-mainboard/`, git 제외). 메인보드는 나중에 다른 모터 드라이버로 바뀔 수 있다
  (처음에는 bin을 저장소에 두기로 했다가 저녁에 바꿈)
- 차체 이미지(`hardware/vehicle/docs/images/`)는 옮기지 않는다. `tools/figures/tipping_moment.py`가 그 폴더에 그림을
  쓰기 때문이다. 일지는 그 자리를 링크한다

### 확인한 것

- 원래 커밋 해시 12개(바퀴 제어기 5, 차체 7) 모두 이 저장소에서 조회되고 `git blame`도 원래 커밋까지 따라간다. 원본
  폴더와 내용 비교: 줄바꿈 차이만 있다
- 펌웨어 빌드: RAM 14.0 %, Flash 61.6 %(806,889 B). 09-17 · 10-13 기록과 바이트까지 같다
- 변환한 일지의 굵은 글씨(`**`)가 모두 GFM 규칙대로 열리고 닫힌다(한글 바로 옆 괄호 때문에 깨지는 경우를 스크립트로 검사)

### 발견한 문제

- 차체 설계 D-03(10-05)은 보드를 앞축 · 뒤축 단위로 짝짓고 같은 (속도, 조향)을 보내는 보드 모드인데, 바퀴 제어기
  실측(09-17 ~ 22)으로는 보드 모드에서 제자리 회전이 안 되고 회전이 약하다. 제어기 쪽 다음 단계(ISSUES H2)는 같은 쪽
  앞뒤 짝 + `SLAVE_SAME_SIDE` 탱크 4륜이다. 지상 주행 시험 후 D-03을 고쳐야 한다
- 메인보드 커스텀 빌드 산출물이 사라졌다. 원래 있던 스크래치패드 `mainboard-out/` 폴더가 비어 있다(ISSUES H1)
- 시뮬레이터 복도 환경용 원본 `hallway-3d`가 이 PC에 없다(`F:\Develop\ClaudeGame`에는 `3d-gen-benchmark`, `toon-room`만 있음)
- 기록을 마친 버전 `v26_module_rails/README.md`에 옛 경로 `docs/build-log.md`가 글자로 남아 있다. 버전 폴더는 고치지
  않는 규칙이라 그대로 둔다(새 위치는 [topics/vehicle-build-story.md](topics/vehicle-build-story.md))
- `include/hoverserial.h` · `util.h`는 GPL-3.0 프로젝트(RoboDurden Gen2.x-GD32)에서 그대로 복사한 것이라 라이선스
  선택에 영향을 준다
- 공개 준비 때 지우거나 뺀 것(옛 Wi-Fi 비밀번호, 사용자 경로, 학교 이름, 외부 STEP · 그림)은 지금 파일에서만 없어졌고
  git 이력에는 남아 있다. 커밋 이메일은 그대로 두기로 했다

### 남은 일

- RDK `~/Develop/autocar`, Jetson `~/Study/flysim`을 `experiments/`로 가져오기
- `hallway-3d`를 가져오면 `import_hallway.py <경로>`로 지정
- 원래 `F:\Develop\lolind32-wheel`, `F:\Develop\HoverboardVehicle` 폴더와 GitHub 저장소 정리 방침 정하기
- MIT로 공개: 바퀴 제어기의 `hoverserial.h` · `util.h`를 직접 다시 작성한 뒤 `LICENSE` 추가
  ([공개 전 체크리스트](../guides/before-publishing.md))
- GitHub `nubi` 저장소 만들고 연결 (공개 직전에 이력 정리)

---

## 2026-10-13 (화) · 바퀴 제어: ESP32 바퀴 모드 — 보드 · 탱크 모드를 없애고 믹싱을 ESP32로, N1 수정

> 시간: 16:10 ~ 16:30 · 장소: PC (`F:\Develop\NUBI`) · 날짜 근거: 세션 · 관련 이슈: N1, H2, H3, N4 · 결정: [ADR 0001](../decisions/0001-wheel-board-pairing.md)

모터 보드 마스터를 믹싱 없이 바퀴별 값을 그대로 구동하는 빌드(passthrough)로 바꾸기로 하고([ADR 0001](../decisions/0001-wheel-board-pairing.md),
메인보드 펌웨어 자체는 저장소 밖에서 관리), 그에 맞춰 ESP32 펌웨어를 바꿨다. 프레임 `iSteer`의 의미가 바뀌므로 메인보드보다 먼저 해야 하는
단계다. 빌드와 오프라인 검증까지 했고, 보드에는 올리지 않았다.

### 한 일

#### `src/main.cpp`: 바퀴 모드 하나로

- 보드 모드(`v 0`), 탱크 모드(`v 1`), `v` 명령, 링크 B 반전(`invb`), `STEER_SIGN`을 없앴다. 남은 것은 한 가지다.
  `left = speed + turn`, `right = speed − turn`(`turn = steer × max / 1000`)을 계산해서, 두 링크에 같은
  (`iSpeed` = 왼쪽 = 마스터 바퀴, `iSteer` = 오른쪽 = 슬레이브 바퀴)를 보낸다.
- `i <0|1>`를 "좌우 바꿈"으로 바꿨다(NVS 키 `swap`). 마스터가 실제로 오른쪽 바퀴면 `i 1`로 명령과 텔레메트리를 같이
  맞춘다(H3). 옛 NVS 키 `mode` · `invb`는 지우지 않고 읽지도 않는다. `Preferences::remove()`는 키가 없으면 부팅마다
  오류 로그를 남기기 때문이다.
- 데드맨: 링크 A(앞축)는 필수, 링크 B(뒤축)는 첫 프레임 뒤에 합류하게 했다(옛 보드 모드와 같다). 축 하나에 좌우가 다
  있어서 앞축만으로도 직진하므로, 앞 마스터만 먼저 굽는 시험 순서와 맞는다. 탱크 모드처럼 "둘 다 필수"일 이유가 없다.
- 리포트 끝 `out A B` → `out L R`, `/api/status`의 `outA/outB/mode/invb` → `outL/outR/swap`.

#### N1: 콘솔 입력

- 출력할 수 없는 바이트(0x20 미만, 0x7E 초과)는 줄에 넣지 않고 호스트 워치독도 갱신하지 않는다. 넘친 줄은 잘라서
  실행하지 않고 통째로 버린다. 숫자만 보내는 속도 단축 명령(`atoi`)은 없앴다.
- `Still()`: 시리얼과 웹 모두 `|s|` · `|t|` < 50이면 0으로 처리한다(메인보드 `STAND_STILL_THRESHOLD`와 같은 규칙).
  조향도 넣은 이유: 바퀴 모드에서 `t 20`이 데드밴드를 거치면 ±20 %로 제자리 회전한다.
- 저장소 도구(hoverctl · speedsweep · test_stop · ledtest)와 RDK · Jetson 래퍼는 모두 글자로 시작하는 명령만 쓴다
  (일지 09-17 · 09-18 확인). 단축 명령을 없애도 영향이 없다.

#### 웹 페이지

- 구동 선택 · B 반전 · 조향 반전 칸을 빼고 "좌우 바꿈"(펌웨어 NVS)을 넣었다. 속도 반전은 브라우저 설정으로 남겼다.
- 텔레메트리를 ①좌/①우/②좌/②우 → 앞좌/앞우/뒤좌/뒤우로 바꿨다. 좌우 바꿈을 켜면 L/R이 바뀌어 보인다.

#### 문서

- wheel-controller README(Drive modes → Wheel mixing, 명령 표, Safety, Split boards), `system-overview.md`(계층 표,
  명령 표, 프레임 표, "구동 방식", 알려진 문제, 정해야 할 것), `firmware/README.md`, ISSUES(N1, 다음 할 일)
- 여러 계층에 걸친 결정이라 [ADR 0001](../decisions/0001-wheel-board-pairing.md)로 남겼다. "결정을 기다리는 것"에서
  보드 짝짓기를 뺐다.

### 확인한 것

- 빌드: RAM 14.0 %, Flash 61.5 %(805,909 B). 경고 없음.
- 파이썬 모델(ESP32의 `Still` · `Ramp` · `Deadband` · 믹싱 → passthrough `Pilot()` → `SendSlave(-pwmSlave)`)로 확인했다.
  - 클램프 200/400/700/1000 × 데드밴드 0/200 × 명령 격자(50 간격): 실패 0. 어느 모터 입력도 클램프를 넘지 않고,
    바퀴 진행 방향과 크기가 의도한 좌우 값과 같다.
  - max 400, 데드밴드 200 기준:

    | 명령 | 왼쪽 | 오른쪽 |
    | --- | --- | --- |
    | `s 300` | +350 | +350 |
    | `t 1000` | +400 | −400 |
    | `s 300` + `t 500` | +400 | +250 |
    | `i 1`일 때 `t 1000` | +400 | −400 (프레임만 뒤바뀜) |
  - 정지에서 출발: 첫 틱 210, 이후 틱마다 +10. 데드밴드 점프가 그대로다.
  - N1: `\x00\xff1⏎` · `s 1` · `s 49` → 0, `\x00\x80s 120⏎` → 120(잡음을 걸러 내도 명령은 산다).
  - `(x, x)`는 옛 보드 모드의 "속도 x, 조향 0"과 모터 입력이 같다(마스터 −x, 슬레이브 +x).
- 웹 페이지 스크립트를 node에서 DOM 대역으로 돌렸다. 전진 50 % → `s=200&t=0`, 우 75 % → `s=0&t=750`, 좌우 바꿈 →
  `/api/cfg?swap=1`, 바꾼 뒤 텔레메트리 좌우가 뒤바뀌어 표시된다. 옛 `mode=` · `invb=` 요청은 나가지 않는다. PASS.
  브라우저 창은 로컬 파일 스크립트를 못 돌려서 화면 렌더링은 확인하지 못했다.
- `tools/test_stop.py` PASS.

### 남은 일

- **새 ESP32 빌드를 미리 올리지 않는다.** 지금 마스터(프리빌드)와는 프레임 의미가 달라 제대로 달리지 못한다. ST-Link가
  준비된 날 ESP32 → 앞 마스터 → 확인 → 뒤 마스터 순서로 한 번에 올린다(ISSUES 다음 할 일 1번).
- `hoverctl.py`의 조향 슬라이더 범위가 속도 클램프(±max)를 따라간다(R12). 바퀴 모드에서 조향은 클램프 기준 ±1000이라,
  GUI로는 max 400일 때 클램프의 40 %까지만 돈다. 슬라이더를 ±1000으로 고정하는 게 맞다.
- 실기에서 확정할 것: 전진 부호(웹 속도 반전), 마스터 쪽 좌우(`i`), 데드밴드 `b`.

---

## 2026-10-13 (화) · 바퀴 제어: ESP32 바퀴 모드 올리기 — 네 바퀴 시험 통과

> 시간: 16:45 ~ 18:40 · 장소: PC (`F:\Develop\NUBI`) + 시제품(바퀴 띄움) · 날짜 근거: 세션 · 관련 이슈: H3, N1, H5 · 결정: [ADR 0001](../decisions/0001-wheel-board-pairing.md)

ESP32에 바퀴 모드를 올리고, 모터 보드 4장도 바퀴별 값을 그대로 받는 펌웨어로 바꿨다(메인보드 펌웨어와 굽기 기록은
저장소 밖에서 관리). 바퀴를 띄운 상태에서 네 바퀴 모두 전진과 제자리 회전이 맞게 돌았다. 마스터는 앞뒤 모두
**오른쪽 바퀴**였다(H3 해결).

### 한 일

#### 17:30 — ESP32 플래시와 앞축 첫 시험

- ESP32(COM10)에 바퀴 모드 빌드를 올렸다(805,909 B, 해시 검증). 부팅 로그 `wheel mode (A=front axle, B=rear)`, 저장돼 있던
  데드밴드 100, 새 Wi-Fi 비밀번호(`include/wifi_config.h`).
- 배터리를 연결해도 텔레메트리가 0이었다. 펌웨어(업스트림 `RemoteUpdate`가 100 ms마다 먼저 송신, 19200 baud,
  PB6/PB7)에는 문제가 없었고, **ESP32 쪽 GPIO16/17 선이 빠져** 있었다. 다시 꽂자 5초에 43프레임, 40.53 V.
- `s 150` 2초 · 4초: 출력 212(데드밴드 100 적용). 마스터 바퀴 2.94 km/h, 슬레이브 속도 · 전류 0. 사용자 관찰: **앞오른
  바퀴(마스터)가 전진**, 앞왼(슬레이브)은 안 돎 → 마스터는 오른쪽, 양수가 전진.
- 시험용 GUI `tools/wheelbench.py`(+ `wheelbench.cmd`)를 만들었다. 바퀴 4개 속도 · 전류, 앞뒤 링크 초당 프레임, 누르는
  동안만 구동, 3초 시험(전진 · 후진 · 제자리 좌/우), STOP(스페이스 · Esc), 좌우 바꿈 · 데드밴드 · max. 포트를 DTR/RTS
  없이 열어 ESP32를 리셋하지 않고(U1 회피), 칸에 포커스가 있으면 방향키를 무시한다(U2 회피). 호스트 워치독 `w 1` +
  250 ms 하트비트. `--selftest 5`: 앞 링크 12.5/s, 설정 읽기 성공, 40.48 V.

#### 18:10 — 네 바퀴

- 네 바퀴 시험(링크 B 연결): 사용자 확인 "모두 잘 된다". 좌우 바꿈(`i 1`) 하나로 앞뒤 모두 맞는다.
- 보드당 전류 제한(D-03은 7 A)은 바퀴를 띄운 오늘 시험과는 무관하다. 7 A면 언덕 · 출발에서 끊길 수 있어 바닥 주행
  데이터를 보고 정하기로 했다.

#### 18:30 — 밖에서 폰으로 시험하기 전 점검

- PC Wi-Fi 새 검색(연결은 바꾸지 않음)에서 25개 네트워크 중 `hoverwheel`이 없었다. ESP32를 재시작하자 보였다(WPA2,
  1번 채널, 2.4 GHz, 신호 100 %). 부팅 로그에 설정이 유지됨(마스터 오른쪽, 데드밴드 100). 원인은 모른다(H5).
- 사용자에게 안내했다. ESP32는 따로 USB 5V 전원이 필요하고, 버튼을 떼면 즉시 서지 않고 감속한다(R5, 급정지는 STOP).
  조종 페이지는 폰 한 대에서만 연다(R1). 출발이 굼뜨면 데드밴드를 200으로 올린다.

### 확인한 것

- ESP32: 바퀴 모드 빌드(805,909 B)를 올리고 해시를 검증했다. 모터 보드 4장도 쓰고 다시 읽어 확인했다(세부는 로컬 기록).
- 바퀴 띄움, max 400, 데드밴드 100, `i 1`: 3초 전진은 네 바퀴 전진, 3초 제자리 우는 왼쪽 두 바퀴 전진 · 오른쪽 두 바퀴
  후진(사용자 관찰). 앞 링크 약 10 Hz, 배터리 40.5 V.

### 남은 일

- 바닥 주행 시험(사용자가 이어서 진행): 전진, 제자리 회전, 데드밴드. 결과로 D-03 · ADR 0001 갱신, 전류 제한 결정
- R5 · R1을 리뷰 수정 중 먼저

---

## 2026-10-13 (화) · 저장소: MIT 공개 준비 — 프레임 코드 직접 작성, 이력 정리

> 장소: PC (`F:\Develop\NUBI`) · 날짜 근거: 세션 · 커밋: `6b8dd6f` 외 · 관련 이슈: H6

저장소를 MIT로 공개하려고, 남아 있던 GPL-3.0 코드를 직접 작성한 코드로 바꾸고 외부 자료 · 개인 정보 · 관계없는 그림을
git 이력 전체에서 지웠다. 공개(푸시)는 아직 하지 않았다.

### 한 일

#### 프레임 코드 직접 작성

- 바퀴 제어기가 GPL-3.0 업스트림 예제에서 복사해 쓰던 `hoverserial.h` · `util.h` 대신
  [`include/hover_protocol.h`](../../firmware/wheel-controller/include/hover_protocol.h)를 새로 썼다. README의 프레임 표
  (명령 9 B, 텔레메트리 22 B, 리틀 엔디언, CRC16-XMODEM)만 보고 작성했다.
- `main.cpp`가 그 헤더에서 쓰던 것은 설정 · 보내기 · 받기 함수, 구조체 2개, `CLAMP` 매크로뿐이었다. 이름을 `HoverBegin` ·
  `HoverSend` · `HoverReceive` · `HoverCommand` · `HoverFeedback`으로 바꿨고, 보내기 함수의 인자 순서(조향 칸 먼저)는
  그대로 두었다.
- 받기는 버퍼에 한 프레임(22 B) 이상 있을 때만 읽고, 시작 바이트(0xCD 0xAB)를 찾아 CRC가 맞는 프레임만 넘긴다. CRC가
  틀린 프레임 뒤에도 같은 호출 안에서 계속 찾는 점이 예전과 다르다.
- GPL 원본 두 개는 저장소에서 빼고 로컬(`firmware/hoverboard-mainboard/local/upstream-examples/`)에 두었다.

#### MIT 라이선스

- [`LICENSE`](../../LICENSE)(MIT), 루트 README의 "라이선스와 출처" 절, AGENTS 규칙(GPL 코드나 출처 불명 파일은 커밋하지
  않음)

#### 관계없는 그림

- `hardware/vehicle/docs/images/`의 ball_robot · gring · ib · sphex 그림 32장은 누비 것이 아니어서 지웠다.

#### 이력 정리

- 원래 저장소에서 바로 `git filter-repo`를 돌렸다. 먼저 전체 이력을 bundle로 백업했다(`.git/backup/`).
- 지운 경로: 휠 모터 STEP, `v28_wiring.step`, SPG 카탈로그 그림, GPL 헤더 두 개, 관계없는 그림 32장
- 바꾼 문자열: 로컬 사용자 경로, 학교 이름, 옛 Wi-Fi 비밀번호, 일지 속 메인보드 `main.c` 패치 일곱 줄
- 문서에 적힌 커밋 해시 32곳을 새 해시로 고쳤다(커밋 메시지 속 해시는 도구가 고침).
- [공개 전 체크리스트](../guides/before-publishing.md)를 "끝낸 것 / 올리기 전에 할 것"으로 다시 썼다.

### 결정

- 바퀴 제어기 커밋 해시를 지키는 것보다, 이력까지 깨끗한 MIT를 택했다. 공개 전이라 지금이 바꾸기 가장 쉬운 때다.
- LICENSE의 저작권자는 git 작성자 이름(chungddong)으로 했다.

### 확인한 것

- 빌드: RAM 14.0 %, Flash 61.5 %(805,697 B, 예전 헤더 때보다 212 B 작음). 프레임 크기 9 / 22 B, 필드 위치, CRC 검사값
  0x31C3(파이썬 `binascii.crc_hqx`로 같은 값 확인)을 `static_assert`로 컴파일 때 확인했다.
- GPL 헤더를 `include/`에서 치운 상태로 빌드된다. 다른 코드가 그 헤더에 기대지 않는다.
- 이력: 지운 경로가 24개 커밋의 어느 트리에도 없고, 바꾼 문자열도 0건이다. 최신 트리 해시가 정리 전과 같다.
  로컬 전용 파일(메인보드 폴더, Wi-Fi 설정, 휠 모터 STEP 등)은 그대로다. 저장소 65.5 MB.
- 외부 라이브러리 파일이나 라이선스 문구는 없다. 시뮬레이터의 three.js · three-mesh-bvh(MIT)는 실행할 때 CDN에서만
  불러온다.

### 발견한 문제

- 새 프레임 코드는 실기 통신을 아직 확인하지 않았다(ISSUES H6).
- 이 저장소의 커밋 해시가 이제 원래 개인 저장소(`lolind32-wheel`, `HoverboardVehicle`)의 해시와 다르다.

### 남은 일

- ESP32에 새 빌드를 올려 통신 확인(H6)
- GitHub `nubi` 저장소를 만들고 푸시 ([공개 전 체크리스트](../guides/before-publishing.md))

---

## 2026-10-13 (화) · 차체: 시뮬레이터 다시 띄우기 — v28 메시, 복도 맵을 새 경로에서

> 시간: 18:05 ~ 19:35 · 장소: PC · 날짜 근거: 세션

저장소 통합 뒤 처음으로 차체 웹 시뮬레이터를 띄웠다. 메시 캐시와 웹 데이터가 git 밖이라 비어 있어서 v28을 다시
떴고, 복도 맵 원본이 `F:\Develop\hallway-3d`로 옮겨진 것을 찾아 복도 환경까지 돌렸다. 차 카메라에 천장이 보이게
고쳤고, 사용자가 준 복도 SfM 자료를 받아 맵 좌표와 맞는지 확인했다.

### 한 일

> 여기 있는 차량 시뮬레이터와 차량 데이터? 그 차량 3d 모델링까지 해서 한번 켜볼래?

- `record.py v28_wiring --mesh-only --local`로 메시 캐시를 떴다(56 s: 불러오기 4 · 짓기 25 · 메시 26).
  `refmodel/`에 휠 모터 STEP이 있어 지을 수 있었다. `web_export.py v28_wiring` → 부품 289, 삼각형 1,208,644,
  43.5 MB, 질량 어림 35.2 kg, 무게중심 (8, −2, 152) mm.
- 메시를 뜨면 기록된 `v28_wiring/output/scene.json`이 덮어써진다. 부품 경로 · 크기가 기록과 같은 것을 확인하고
  원래 파일로 되돌렸다(바뀐 것은 code · meshed · timing뿐).
- `import_hallway.py`를 고쳤다. 기본 원본 경로를 `F:\Develop\hallway-3d`로, 원본에 `public/textures/`가 없으면
  건너뛰게. 원본이 2026-09부터 텍스처를 코드로 그려 그 폴더가 없어 복사가 실패하는 상태였다. 시뮬레이터 README,
  차체 README, `hallway_env.js` 주석의 옛 경로도 고쳤다.

> 복도 맵 데이터를 가져와서 특정 지점에서 출발해서 원하는 강의실 앞에서 멈추는 식으로 … 실 주행시에는 카메라밖에
> 없을거야

- 가능성 검토: 복도 맵의 문(`type: door`) 16개 중 13개에 호수(`label`)가 붙어 있어 목표점 목록은 이미 있다.
  실제 위치 인식은 3D 맵이 아니라 카메라 특징점 지도(원본의 SfM 결과: 프레임 263, 3D 점 약 5.1만, 맵 좌표로 바꾸는
  align)를 쓰는 쪽으로 이야기했다. SfM 자료는 사용자가 따로 압축해 주기로 했다.
- LLM(GPT · Gemini · Claude 등)을 붙이는 경우: LLM은 `go_to_room` 같은 도구만 부르고, 위치 인식 · 경로 따라가기 ·
  장애물 정지는 로봇 안에서 돈다는 구조로 정리했다.

> 근데 왜 천장이 뻥 뚫려있지? 내가 보는 시뮬레이터 화면에서는 안보이게 해도 되지만 차량이 보는 시야에서는 있어야
> 하지 않나?

- `hallway_env.js`가 천장을 `visible = false`로 숨기고 광선 투사에서도 빼고 있었다. 천장 판과 천장에 단 오브젝트
  (`mount: ceiling` 46개)를 three.js 레이어 1로 옮기고, 앞 카메라 화면(`sensors.js` pipCam)만 레이어 1을 보게 했다.
  천장은 광선 투사 대상에도 넣었다. 패널에 '천장 보기'(내 화면만)를 더했다.
- 깊이 점 중 차 높이 + 15 cm(0.68 m)보다 높은 것은 장애물도 바닥도 아니게 했다. 천장을 넣으면 천장에 단 조명 ·
  표지의 옆면이 수평 법선이라 장애물로 잡힐 수 있어서다(차는 그 밑으로 지나간다).
- 사용자가 `F:\hallway-3d-data`에 준 지도 자료 zip을 원래 자리 `F:\Develop\hallway-3d\tools\work\`에 풀었다
  (`tools/work/`만, 288개 파일, SHA256 전부 일치). GPS · 음성이 든 원본 영상 zip은 풀지 않았다. 이 자료는 NUBI
  저장소에 넣지 않는다.

### 확인한 것

- 시험 코스: 1 m/s · 0.3 rad/s로 3 s → (2.15, 1.20) m, 방향 51°. 15° 경사에서 피치 15.0°, 전복 여유 40°.
  목표 (4, −2) 자율주행 약 12 s에 도착. 콘솔 오류 없음.
- 복도(`?env=hallway`): 원본은 three.js 0.186용, 시뮬레이터는 0.160인데 그대로 불러와진다(경고
  `toNonIndexed` 뿐). 입구에서 310호 앞문 앞(10.84, 0.75)을 목표로 자율주행 → (10.70, 0.73)에 도착, 오가는 사람에 한
  번 막혀 기다렸다.
- 천장: 광선을 바로 위로 쏘면 복도 세 곳 모두 z = 2.68 m에서 맞는다. 앞 카메라 화면에 천장과 LED 조명이 보이고,
  내 화면(위에서 · 뒤따라가기)에는 천장이 없다. 앞 깊이 점 1,151 → 1,228(천장에 맞은 점). 고친 뒤 310호 앞문 자율주행
  (10.70, 0.73) 도착, 시험 코스 목표 (4, −2) 도착, 콘솔 오류 없음.
- SfM 자료(pycolmap 4.2.1): 프레임 263장 전부 등록, 3D 점 51,220, 재투영 오차 0.63 px, 카메라 SIMPLE_RADIAL
  1920×1080 f = 943.69 px. 장마다 특징점 중앙값 3,536, 그중 3D 점과 이어진 것 1,066(최소 84).
  `align.json`으로 옮긴 카메라 위치가 `scene.json` 촬영 경로와 263장 모두 0.0 cm 차이 — 맵과 SfM 좌표가 같다.
  촬영 카메라 높이 중앙값 1.37 m. 3D 점 높이: 0 ~ 0.6 m 26 %, 0.6 ~ 1.8 m 50 %, 1.8 m 이상 24 %.

### 발견한 문제

- 기록된 모든 버전이 "코드가 바뀜"으로 판정된다. 기록 당시(옛 저장소) 코드는 CRLF, 지금은 LF라 `code_hash`가
  다르다. 형상은 같지만 `web_export` · `record.py`가 처음 한 번은 메시를 새로 뜬다(버전당 약 1분).
- 시뮬레이터 자율주행은 진짜 위치를 경로 계획에 넘긴다(`app.js` `nav.command(st, …)`). 카메라 위치 인식의 오차는
  아직 시험되지 않는다.

### 남은 일

- SfM 자료로 위치 인식 실험: 프레임 일부를 낮은 시점처럼 잘라 질의로 쓰고 PnP 위치 오차 재기
- 시뮬레이터에 '카메라만' 모드: 진짜 위치 대신 오도메트리 오차 + 가끔 오는 시각 보정
- 복도 문 → 문 앞 목표점 자동 생성, LLM 도구 서버(시뮬레이터와 실물에 같은 도구)

---

## 2026-10-13 (화) · 차체: 시뮬레이터 GPT 운전 — 카메라 사진 + 깊이 화살표 (VLMnav 방식)

> 시간: 19:35 ~ 19:55 · 장소: PC · 날짜 근거: 세션

시뮬레이터 복도에서 GPT가 앞 카메라 사진만 보고 강의실 문 앞까지 가는 기능을 만들었다. 사진 · 화살표 · 서버 · 실행 ·
채점까지 모의 모드로 끝까지 돌았고, 실제 GPT 호출은 API 키가 없어 아직 못 했다.

### 한 일

> 지금 주어진 정보들 가지고 차량에 gpt 연결해서 시뮬레이터 상에서 주행 시키는게 가능할까? 시각정보만 가지고 말이야
> 여러 최신 레퍼런스 등도 참고해봐

- 참고한 것: VLMnav(Goetting 외, CoRL 2024 — 깊이로 갈 수 있는 방향을 화살표로 그려 VLM이 고르게, 따로 학습 없이),
  Mobility VLA(Google DeepMind, CoRL 2024 — 둘러보기 영상 + 위상 그래프, VLM은 목표 프레임만 찾음),
  GPT-6-Astra VLN-CE 평가(arXiv 2609.29861, 2026-09 — 단안 RGB만으로 R2R-CE-100 성공률 81.3 %, 실행 · 목표 확인
  실패가 남는다고 함). 사용자가 말한 "GPT 아스트라"는 OpenAI `gpt-6-astra`였다(앞서 구글 프로젝트라고 한 것은 틀림).
- `web/agent.js`(새 파일, 패널 ⑤): 앞 카메라를 1280 × 815로 찍고(`sensors.snapFront`, float 렌더 타깃 → sRGB),
  깊이로 잰 방향 7개(±40 · ±27 · ±13 · 0°)를 번호 화살표로 그린다. 화살표 빈 거리는 앞 카메라 세로줄 44개의 가장
  가까운 장애물을 그 방향 띠(반폭 0.32 m)에 비춰 잰다(`sensors.frontCols`). 받은 행동은 돌기(각도 닫힌 루프) →
  가기(깊이로 범퍼 앞 0.25 m 막히면 섬)로 실행한다. GPT가 멈추면 목표 문 앞까지 거리로 채점(1 m 안 = 성공).
- `agent.py`(새 파일, 서버 쪽): 프롬프트, OpenAI Responses API(이미지 입력, `json_schema` strict, `reasoning.effort`)를
  표준 라이브러리로 부른다. 키는 `OPENAI_API_KEY` 또는 `sim/agent.local.json`(git 제외). 기록 `agent_logs/`(git 제외).
  `web/serve.py`에 `POST /api/agent/step`을 더했다.
- `hallway_env.js`에 문 목록(호수 · 이름 · 벽 쪽 · 문 앞 점)을 더했다. 목표 고르기, 층 안내(왼쪽 · 오른쪽 벽의 방
  순서, 좌표 없음), 채점이 쓴다.

### 결정

- GPT에는 위치 좌표와 라이다를 주지 않는다. 진짜 위치는 행동 실행(실물에서는 바퀴 오도메트리 · IMU 몫)과 채점에만.
- 장애물 정지는 GPT가 아니라 차 쪽(깊이)에서 한다. GPT는 걸음마다 한 번 부르고, 걸음 사이 움직임은 차가 닫힌 루프로.
- API 키와 프롬프트는 서버에만 둔다. 외부 패키지(openai)를 더하지 않는다.

### 확인한 것

- 모의 모드(API 없이, 가장 트인 화살표로 1.5 m): 입구에서 걸음 4번에 (5.7, −0.3) m까지, 걸음마다 사진 → 화살표 →
  서버 → 실행이 돈다. 걸음 3에서 사람이 범퍼 앞에 오자 깊이로 섰다.
- 보낸 사진: 색이 화면과 같고(선형 → sRGB 변환), 화살표 7개가 바닥 위에 그려진다. JPEG 약 85 KB.
- 서버 요청 모양은 가짜 응답으로 오프라인 시험: 모델 · `reasoning.effort` · `json_schema` strict · 이미지 detail high,
  응답의 `output_text` 해석, 비용 계산(입력 2,500 · 출력 800 토큰, gpt-6.1-sol → $0.013). 진짜 위치는 프롬프트에 없다.
- 키가 없으면 패널에 "OpenAI API 키가 없다"가 뜨고 외부로 아무것도 보내지 않는다.
- 17 cm 렌즈로 본 것: 복도 입구에서 1280 픽셀 사진을 1.6배로 키워도 돌출 표지판 글자는 안 읽힌다. 문 위 번호판은
  문 앞에서 시야 밖(위로 32.5°까지만 봄). GPT는 문 개수 · 생김새와 층 안내로 추론해야 한다.

### 발견한 문제

- 실물에서도 같은 문제가 생긴다: 앞 카메라가 17 cm 높이면 호실 번호판과 표지판 글자를 거의 못 읽는다. 카메라를 위로
  기울이거나, 높은 곳에 카메라를 하나 더 두거나, SfM 지도 위치 인식에 기대야 한다.
- 시뮬레이터 복도는 텍스처를 코드로 그려 실제 사진과 다르다. 이 시험은 'GPT가 카메라만으로 길을 찾나'를 보는 것이지
  실제 화면 인식 정확도가 아니다.

### 남은 일

- 사용자가 `sim/agent.local.json`에 키를 넣으면 310호(앞문)로 모델별(luna · sol · astra) 몇 번씩 돌려 성공률 · 걸음 수 ·
  비용 비교
- 층 안내 없이, 사람 없이 등 조건별 비교
- SfM 자료로 위치 인식 실험(실제 사진 영역), 낮은 시점 사진 확보

---

## 2026-10-13 (화) · 차체: 시뮬레이터 Claude 운전 — SDK 연결, 대화 속 Claude가 직접 몰아 310호 앞 0.22 m

> 시간: 19:55 ~ 20:05 · 장소: PC · 날짜 근거: 세션

GPT 운전과 같은 조건으로 Claude도 고를 수 있게 했고(Anthropic Python SDK), API 키가 없어 이 대화의 Claude가 같은
사진 · 화살표 · 실행 · 채점으로 직접 몰아 봤다. 310호(앞문) 앞 0.22 m에 8걸음으로 멈춰 성공했다.

### 한 일

> 일단 너도 해볼래? claude sdk 등 이용해서 말이야

- `agent_claude.py`(새 파일): `agent.py`와 같은 프롬프트(`SYSTEM`) · 출력 형식(`SCHEMA`) · 기록(`log_step`)으로 Claude를
  부른다. 이미지(base64 JPEG) + 글, `thinking: adaptive`, `output_config.effort` + `json_schema`, 안전 분류기 거절 시
  서버 쪽 대체(`fallbacks: "default"`, Haiku 5.5는 없음). 모델 `claude-opus-5-5`(기본) · `claude-sonnet-5-5` ·
  `claude-haiku-5-5`. `anthropic==1.13.0`을 `.venv`에 설치하고 `requirements.txt`에 적었다.
- `serve.py`가 모델 이름이 `claude-`로 시작하면 `agent_claude.py`로 보낸다. `agent.py`는 기록 부분만 `log_step`으로 뺐다.
- `agent.js`를 `observe()`(사진 · 화살표, 위치는 안 돌려줌)와 `act(결정)`(실행 · 기록 · 채점)으로 나눴다. 서버 없이도
  다른 운전자가 같은 조건으로 몰 수 있다.
- 이 대화의 Claude가 직접 운전: 걸음마다 `observe()` 사진을 화면 전체로 덮어 띄우고(HUD의 좌표가 안 보이게) 보고
  결정한 뒤 `act()`. 층 안내는 줌.

### 확인한 것

- 직접 운전 8걸음: 정면 2 m × 4(문 세기: 왼쪽 308 → 309 키패드 문 → 사물함 → 문) → 사람을 피해 왼쪽 13°(사람이
  앞을 막아 깊이로 0.13 m에서 섬) → 왼쪽 45° 돌아 문 확인(손잡이 · 들어간 문턱, 오른쪽 사물함) → 오른쪽 27°로 1.38 m →
  멈춤. 채점: 목표 문 앞 점까지 **0.22 m, 성공**. 차 (10.66, 0.73), 310호 앞문 x = 10.84.
- 공정하지 않은 점: 이 Claude는 앞서 이 대화에서 문 좌표(310호 앞문 ≈ 10.8 m)를 맵 데이터로 봤다. 결정은 사진의 문
  세기와 바닥선 거리 어림으로 했지만, 눈가림 시험은 아니다. 공정한 비교는 API 모델(같은 프롬프트)로 해야 한다.
- `agent_claude.py` 오프라인 시험(가짜 클라이언트): 이미지 → 글 순서, `thinking` · `effort` · `json_schema`, Opus는
  `server-side-fallback-2026-07-01` + `fallbacks: "default"`, Haiku는 대체 없음, 응답 해석 · 비용(입력 1,900 · 출력
  700 → $0.022). 진짜 위치는 프롬프트에 없다.
- 키가 없으면 SDK가 요청을 보내기 전에 `TypeError`를 낸다(외부로 안 나감). 그래서 호출 전에 `api_key` · `auth_token` ·
  `credentials`를 확인해 패널에 "Anthropic 키가 없다"를 띄운다.

### 발견한 문제

- 직접 운전에서도 문 번호판과 표지판 글자는 끝까지 읽지 못했다. 문 개수 · 사물함 같은 생김새와 층 안내로만 맞췄다.
  문 개수를 한 번 잘못 세면 틀린 문에 선다 — 실물에서는 번호판을 볼 수 있는 높이의 카메라나 SfM 지도 위치가 필요하다.
- 걸음이 큰(2 m) 동안 사람이 끼어들면 깊이로 서고, 그다음 화면에서 목표 문이 시야 밖으로 나가 다시 찾느라 한 걸음을 썼다.

### 남은 일

- 키를 넣고 GPT(luna · sol · astra)와 Claude(haiku · sonnet · opus)를 같은 목표 · 조건으로 여러 번 돌려 성공률 · 걸음 ·
  비용 비교. 층 안내 없음 · 사람 없음 조건도

---

## 2026-10-13 (화) · 차체: 시뮬레이터 운전에 지도 · 추정 위치 주기, 사람 끄기 고침

> 시간: 20:05 ~ 20:20 · 장소: PC · 날짜 근거: 세션

GPT · Claude 운전에 위에서 본 지도와 **추정** 위치를 줄 수 있게 했다. 실물도 지도는 갖고 가지만 위치는 오도메트리 ·
시각 위치 인식으로 추정할 뿐이라, 오차를 흉내 내는 모드로 만들었다. '움직이는 사람'을 꺼도 깊이 · 충돌에 남던 버그를
고쳤다.

### 한 일

> 근데 지도 데이터는 줘야 하지 않을까? 실제로도 주긴 할건데 말이야 / 어차피 차량 시점이 낮아서 표지를 직접 확인해서
> 멈추는 건 힘들거라서 말이야

- 패널에 '지도 · 위치' 선택을 더했다: 안 줌(사진만) · 지도만 · 지도 + 오도메트리 · 지도 + 오도메트리 + 시각 위치
  인식(기본) · 지도 + 정답(비교용 상한).
- 지도 그림(1280 × 472): 벽 선, 고정 가구, 문과 호수(같은 호수의 앞문 · 뒷문은 '310앞' · '310뒤'), 목표 문과 문 앞 1 m
  원, 추정 위치 삼각형과 오차 원. 글로는 지도 좌표 정의, 목표 문 앞 점, 복도 문 좌표, 추정 위치 · 방향 · 오차 · 출처를,
  화살표마다 지도 방향을 준다. 두 번째 사진으로 GPT(`input_image`) · Claude(`image` 블록) 모두에 보낸다.
- 위치 추정 흉내[가정]: 출발점은 안다. 걸음마다 진짜 이동에 바퀴 축척 오차(주행마다 ±3 %) · 걸음 잡음 2 % · IMU 방향
  잡음 0.5°를 얹어 쌓고, 시각 위치 인식 모드는 걸음마다 80 % 확률로 진짜 ± 0.15 m · ± 3°로 바로잡는다. 패널 기록에
  걸음마다 추정 위치 오차를 보인다(모델에는 안 줌).
- 프롬프트: 지도와 추정 위치가 있으면 갈 길과 멈출 곳은 지도로 정하고, 사진은 장애물 · 문 모양 확인과 위치가 맞는지
  보는 데 쓰라고 바꿨다. 낮은 카메라라 표지판 글자는 거의 안 읽힌다는 것도 적었다.

> 그리고 움직이는 사람을 껏는데도 카메라 상으로는 게속 인식되는거 같은데?

- 원인: 복도 환경의 끄기는 사람 메시를 안 보이게만 했다. three.js `Raycaster`는 `visible`을 보지 않고 레이어만 보므로
  깊이 · 라이다 광선이 그 자리의 '안 보이는 사람'에 계속 맞았고, 충돌 원도 남아 있었다. 시험 코스는 끄면 멈춰 선 채로
  남았다.
- 고침: 끄면 메시를 레이어 31로 옮기고(화면 · 광선 투사 모두에서 빠짐) 충돌 원에 `off` 표시를 해 건너뛴다. 두 환경 같게.

### 확인한 것

- 사람 끄기: 사람 2 m 앞에서 쏜 광선이 사람을 지나 25 ~ 30 m 뒤 벽에 맞는다. 사람 자리 충돌은 끄면 없음, 켜면 '사람'.
- 지도 · 위치(모의 운전): 오도메트리 3걸음 뒤 추정 (6.00, −0.04) / 진짜 (5.86, 0.00) — 0.14 m. 시각 보정 모드는 걸음마다
  0.00 ~ 0.30 m. 지도 그림에 이름표 · 목표 원 · 추정 삼각형이 겹치지 않게 보인다. 콘솔 오류 없음.
- 서버(가짜 응답): GPT는 글 → 카메라 사진 → 지도 사진, Claude는 카메라 사진 → 지도 사진 → 글 순서로 들어가고 화살표에
  '지도 방향'이 붙는다.

### 남은 일

- 실제 GPT로 '사진만' · '지도 + 오도메트리' · '지도 + 시각 위치 인식' · '정답'을 같은 목표로 견주어, 위치 인식 정확도가
  멈춤 정확도에 얼마나 드는지 보기
- 시각 위치 인식 흉내의 오차 값을 SfM 자료로 잰 실제 값으로 바꾸기

---

## 2026-10-13 (화) · 상위 제어: 실차 GPT 운전 준비 — Jetson · ESP32 · Xtion, PC 멈춤

> 시간: 20:20 ~ 21:00 · 장소: PC · 날짜 근거: 세션

시뮬레이터 ⑤ 운전 방식을 실차 (Jetson Orin Nano + ESP32 바퀴 제어기 + Xtion Pro Live) 로 옮기는 프로그램을
[experiments/2026-10-13_vlm-drive](../../experiments/2026-10-13_vlm-drive/README.md) 에 만들고, 가짜 장치로 PC 에서
끝까지 시험했다 (13 항목 통과). 실차에서는 아직 돌리지 않았다. SfM 위치 인식 정확도 실험은 돌리던 중 PC 가 멈춰 미완이다.

### 한 일

> 필요한 작업을 바로 해두자, 실제 기기에서는 esp32 와 젯슨까지 연결해서 돌릴거야

> (중간에) gemini336 이 아니라 xtion pro live 카메라가 연결될거야

- 펌웨어 확인: 시리얼 115200 한 줄 명령 (`s` · `t` + = 오른쪽 · `x` · `m` · `w 1` · `h`, 1 s 워치독), 200 ms 보고 줄의
  `odo` = 앞축 (마스터 = 오른쪽, 슬레이브 = 왼쪽) 홀 스텝. 보고 줄 정규식은 `tools/wheelbench.py` 와 같게.
- `wheel_link.py`: 하트비트 **임대** — 제어 루프가 `lease()` 를 불러야만 `h` 를 보낸다. 루프가 멈추거나 모델 응답을
  기다리는 동안에는 하트비트가 끊겨 1 s 뒤 ESP32 가 스스로 선다. 끝낼 때 `w 0` (ISSUES N2).
- `xtion.py`: OpenNI2 + `openni` 바인딩 (원본 소스에서 API 확인 — `Device.open_any` · `configure_mode` ·
  `set_image_registration_mode(DEPTH_TO_COLOR)` · `set_mirroring_enabled(False)` · `get_horizontal_fov`).
- `depth_view.py`: 바닥면 RANSAC 으로 카메라 높이 · 숙임 자동 측정 (실물 장착 위치를 몰라도 됨), 방향별 빈 거리,
  **0.5 m 안쪽 사각** (바닥이 0.65 ~ 2 m 에 보여야 할 픽셀이 비면 막힘 0.3 m, 정면이면 정지), 화살표 ± 24° 7 개.
- `odometry.py` · `motion.py`: 홀 스텝 추측 항법, 제자리 돌기 · 곧게 가기 (오도메트리 닫힌 루프, 방향 틀어짐 보정,
  깊이 · 시간 · 걸림 · 보고 줄 끊김으로 정지).
- `hallway_map.py`: `scene.json` → 지도 그림 · 글 (시뮬레이터와 같은 내용, 가구 빠짐). `drive.py`: 걸음마다 사진 ·
  깊이 → 화살표 → 지도 · 위치 → 모델 (시뮬레이터 `agent.py` · `agent_claude.py` 그대로) → Enter 확인 → 실행 → 기록
  (`data/logs/vlm-drive/`, git 제외). `calibrate.py`: 연결 · 카메라 · 직진 / 회전 보정. `fake.py` · `selftest.py`: 펌웨어를
  흉내 낸 가짜 ESP32 와 복도 벽에 광선을 쏘는 가짜 Xtion.
- 시뮬레이터: 카메라 선택 (`?cam=xtion` — 58° × 45°, 앞 하나, 0.5 m 사각) 을 넣고, 화살표 · 사진 폭을 화각에 맞췄다.
  프롬프트에 박혀 있던 카메라 사양 (90°, 17 cm) 을 요청의 `camera` 글로 넘기게 바꿨다. 화살표에 '(사각)' 표시.
- SfM 위치 인식 정확도 실험을 하위 에이전트에 맡겼다 → [experiments/2026-10-13_sfm-relocalization](../../experiments/2026-10-13_sfm-relocalization/README.md)
  (코드만, 결과 없음).

### 결정

- 실차 첫 코드는 ROS 2 가 아니라 실험 폴더의 파이썬 스크립트로 (PC 에서 가짜 장치로 끝까지 시험할 수 있게). 자리를 잡으면
  `nubi_base` · `nubi_perception` 으로 옮긴다.
- 모델은 장애물 정지에 끼지 않는다. 기본은 걸음마다 사람이 Enter 로 확인 (`--auto` 는 몇 번 성공한 뒤).

### 확인한 것

- PC 자체 시험 (가짜 ESP32 는 스텝 축척 2 % · 유효 윤거 4 % 를 일부러 다르게): 바닥면 0.300 m · +3.02° (참값 0.30 ·
  3°), 왼쪽 90° → 진짜 +90.9°, 1 m → 진짜 1.050 m, 0.35 m 앞 원기둥 → 사각으로 정지, 1.0 m 앞 장애물 → 0.44 ~ 0.51 m
  가고 정지, 임대가 끊기면 1 s 뒤 "host watchdog", 모의 모델 4 걸음 끝까지. 재시작 뒤 다시 돌려도 모두 통과.
- 보정 도구 (가짜): `m_per_step` 0.005924 (참 0.005875), `track_eff_m` 0.801 (참 0.82 — 직진 보정을 먼저 적고 회전을
  재야 더 맞는다).

### 발견한 문제

- **PC 멈춤**: 20:43 ~ 20:49 화면이 꺼지고 시스템이 멈췄다 (Kernel-Power 41, 블루스크린 기록 없음). 그때 하위 에이전트의
  SfM 실험이 그래픽카드 (RTX 3070, torch CUDA — 특징점 거리 행렬 블록당 약 1 ~ 2 GB) 를 쓰고, 앱 브라우저의 시뮬레이터
  (WebGL) 도 돌고 있었다. 원인이 직접 기록되지는 않았지만 그래픽카드 과부하가 가장 유력하다.
- 시뮬레이터 Xtion 설정은 PC 가 멈춰 브라우저로 아직 확인하지 못했다.
- Jetson 에 OpenNI2 (`libopenni2-0`) · `openni` 가 깔려 있는지, Xtion 이 USB 로 잡히는지 모른다.

### 남은 일 (내일 학교에서)

1. 시뮬레이터 `?env=hallway&cam=xtion` 를 띄워 Xtion 화살표 · 사각이 보이는지 확인 (모의 모델로 몇 걸음)
2. SfM 실험을 **CPU 로, 시뮬레이터를 닫고, 작게** 먼저 (명령은 그 폴더 README). 코드 검토 후 결과로 `VIS_*` 가정 바꾸기
3. Jetson 준비 (유선 직결 `ssh dongki@192.168.127.2` — 아래 'Jetson 유선 직결' 항목): 저장소 · `scene.json` ·
   `agent.local.json` 복사, `libopenni2-0` · `openni` · `pyserial` 설치
4. 실차: `calibrate.py report` → `camera` → 바퀴 띄우고 `straight` · `spin` 방향 → 바닥에서 `--write` 보정
5. `drive.py --goal 310앞 --model gpt-6-luna` 걸음마다 확인하며 (비상정지 들고)

### 교훈

- 하위 에이전트에 계산을 맡길 때 장치 (CPU / GPU) 와 자원 한도를 지시에 넣는다. 이 PC 에서 무거운 CUDA 작업은
  시뮬레이터와 같이 돌리지 않고, 돌리기 전에 알린다.

---

## 2026-10-13 (화) · 상위 제어: Jetson 유선 직결 — USB로 들어가 이더넷 고정 IP

> 시간: 20:30 ~ 20:55 · 장소: PC, Jetson "mokpo" (계정 `dongki`) · 날짜 근거: 세션

PC와 Jetson을 랜선으로 직결했는데 서로 보이지 않았다. 직결에는 DHCP 서버가 없어 Jetson 유선이 주소를 못 받고
기다리고 있었다. USB-C 장치 모드(`192.168.55.1`)로 들어가 Jetson 유선에 고정 IP `192.168.127.2/24`를 넣고 PC를
`192.168.127.1/24`로 되돌려, 이더넷으로 핑 · SSH가 된다.

### 한 일

> 이 컴퓨터에 젯슨 장치를 이더넷 통해서 연결했거든? 확인해볼래?

- PC `이더넷`(Realtek GbE)은 1 Gbps 링크, 주소는 고정 `192.168.127.1/24`. `192.168.127.2 ~ 254` 핑에 ARP 응답이 하나도
  없었다. Jetson 쪽에서는 링크가 바뀔 때 브로드캐스트 24 · 멀티캐스트 8개가 들어오고 그 뒤 조용했다. UDP 67 대기,
  mDNS 질의(IPv4 · IPv6)에도 응답 없음.

> 음 지금 이더넷 설정이 자동으로 받기가 아니라서 그럴지도?

- PC를 자동으로 바꾸자 PC는 `169.254.117.169`(APIPA)를 받았지만 Jetson은 그대로 안 보였다. 우분투 NetworkManager는
  DHCP가 안 되면 IPv4 링크 로컬로 넘어가지 않고 주소 없이 기다린다.
- Jetson USB-C(장치 모드)를 PC에 꽂자 `UsbNcm` · `RNDIS` 어댑터가 생기고 PC가 `192.168.55.100`을 받아 `192.168.55.1`이
  응답했다.
- PC에 `~/.ssh/id_ed25519`(암호 없음)를 만들고, 사용자가 비밀번호를 쳐서 Jetson `authorized_keys`에 올렸다.
- Jetson 유선 `enP8p1s0`("Wired connection 1")은 `connecting (getting IP configuration)`에 멈춰 있었다. 연결 설정을
  바꾸려면 sudo 비밀번호가 필요해서 사용자가 직접 실행했다.

  ```bash
  sudo nmcli con mod 'Wired connection 1' ipv4.method manual ipv4.addresses 192.168.127.2/24 ipv4.never-default yes
  sudo nmcli con up 'Wired connection 1'
  ```

- PC 이더넷은 다시 고정 `192.168.127.1/24`(게이트웨이 · DNS 없음).

### 결정

- 직결 유선은 양쪽 고정 IP — PC `192.168.127.1`, Jetson `192.168.127.2`, /24, 게이트웨이 없음. Jetson 인터넷은 지금처럼
  Wi-Fi로 나간다(`never-default`). 직결에는 DHCP 서버가 없어서 자동에 맡기면 Jetson이 주소 없이 남는다.

### 확인한 것

| 항목 | 값 |
| --- | --- |
| Jetson | 호스트 `mokpo`, 계정 `dongki`, L4T R36.4.7 (JetPack 6.2) |
| 유선 | `enP8p1s0` 1000 Mb/s, `192.168.127.2/24`, connected |
| PC → Jetson | 핑 0 ~ 1 ms, `ssh dongki@192.168.127.2` 키로 접속 |
| USB 장치 모드 | Jetson `192.168.55.1` (`l4tbr0`), PC `192.168.55.100` (DHCP) |
| Jetson Wi-Fi | `wlP1p1s0` → `CE312`, `192.168.1.82`, 기본 경로 |

### 남은 일

- 문서는 Jetson을 "dongki"로 부르는데 실제 호스트 이름은 `mokpo`이고 `dongki`는 계정이다(`software/README.md`,
  `system-overview.md`, 일지 README의 장소 칸). 맞출지 정하기
- 기계별 주소(PC · Jetson · RDK)를 어디에 적어 둘지 정하기

### 참고

- 시작 시각은 어림이다(Jetson은 20:26 무렵 부팅).

---

## 2026-10-14 (수) · 상위 제어: Jetson 실기 점검 — ESP32 · Xtion · HP60C, 바퀴 방향 점검판

> 시간: 09:20 ~ 10:30 · 장소: PC, Jetson "mokpo" (계정 `dongki`, 유선 직결 `192.168.127.2`) · 날짜 근거: 세션

어제 PC 가짜 장치로만 시험한 실차 운전 프로그램 ([experiments/2026-10-13_vlm-drive](../../experiments/2026-10-13_vlm-drive/README.md))
을 Jetson 에 올려 실물을 움직이지 않고 점검했다. ESP32 · 호버보드 보드 4 장 · Xtion 이 붙고, 새로 연결한 Nuwa-HP60C 깊이
카메라도 제조사 SDK 없이 읽었다. 웹 점검판을 만들어 바퀴를 띄우고 네 방향 시험을 했고, 모두 맞게 돌았다.

### 한 일

> jetsn 장치 연결했으니까 바로 할 수 있는거부터 해볼까?

- Jetson 확인: JetPack 6.2, Python 3.10, ROS 2 Humble, 계정이 `dialout`. ESP32 (CH340 → `/dev/ttyUSB0`) · Xtion (`1d27:0601`) 이
  USB 에 잡힘. `libopenni2-0` · OpenCV 4.5 · numpy · Pillow 는 있었다. `python3-venv` 가 없어 `pyserial` · `openni` 를 사용자
  영역 (`pip --user`) 에 넣었다. `to_jetson.sh` 로 `~/NUBI` 에 필요한 것만 복사 (API 키는 안 보냄).
- Xtion 이 열리지 않았다 (장치 열기에서 끝없이 멈춤). OpenNI 로그를 켜 보니 'Getting hardware versions...' 에서 대답이 없었고,
  커널에 `usb 1-2.1: usb_set_interface failed (-110)` 이 5 s 마다 찍혔다. 로그인 화면 (gdm) 의 오디오 서버가 Xtion 마이크
  (ALSA 카드 'PrimeSense Device') 를 열다 시간 초과를 내며 장치 제어를 막고 있었다. 남은 잠금 (System V 세마포어) 은 아니었다.
  `xtion_no_audio.sh` (오디오 인터페이스만 `authorized=0` 하는 udev 규칙, sudo — 사용자가 실행) + USB 다시 꽂기로 풀렸다.
- `xtion.py` 를 초파리 주행 (2026-09-18) 순서로 바꿨다: 정합은 시작 전, 장치 설정 (미러링 · 동기화) 은 건드리지 않고 거울상이면
  소프트웨어로 뒤집기, 백그라운드로 읽기, 열기 8 s · 첫 프레임 5 s 제한. 강제 종료 (SIGTERM) 도 바퀴를 세우고 카메라를 닫게.

> 혹시나 비교를 위해서 다른 카메라 … 그 카메라도 연결해두었거든? 비교사진도 보여주고 / 'Nuwa-HP60C' 라는 뎊스카메라일거야

- HP60C (`3482:6723` 'ASJ ZNX_NVT') 는 표준 UVC 로 잡히지만 한 버퍼에 [보정 2560 B + 컬러 JPEG + 깊이] 를 묶어 보낸다.
  jcfurey/hp60c_driver 의 형식 문서 (Apache-2.0) 를 보고 `hp60c.py` 를 새로 짰다 (코드는 안 가져옴) — 640x642 MJPG 모드,
  깊이 1/16 mm · 90° 돌아 있음, 보정으로 깊이를 컬러 시점에 맞춤. 고정핀대로 바로 세웠는데 컬러 · 깊이가 함께 위아래가 뒤집혀
  나와 기본으로 180° 돌린다. 제조사 부록 (Google Drive) 에는 가상머신 이미지만 있었다.
- 두 카메라를 차례로 찍어 [비교 사진](../../experiments/2026-10-13_vlm-drive/images/camera_compare.jpg)을 만들었다 (같은 USB 2.0
  허브라 동시에 켜지 않음).

> 바퀴 방향 시험은 바로 해볼까? 근데 gui 로 확인할 수 있게 gui 구성해줄수 있나

- `bench.py`: Jetson 에서 띄우는 바퀴 점검 웹 패널 (`http://192.168.127.2:8090`, 유선 직결 주소에만 연다). 네 바퀴 속도 · 앞축 스텝
  · 전압 · 링크, 짧은 시험 (앞 · 뒤 · 왼쪽 / 오른쪽 제자리, 최대 3 s, 상한 300), STOP (스페이스), '바퀴를 띄웠다' 체크해야 켜짐,
  페이지가 1 s 끊기면 정지, 시험 중에만 하트비트 임대. PC 에서 가짜 ESP32 로 먼저 눌러 본 뒤 (`.claude/launch.json` 의
  `wheel-bench-fake`) 실물에 띄웠다. `bench_ctl.sh start / stop / status`.

### 확인한 것

| 항목 | 값 |
| --- | --- |
| ESP32 | 바퀴 모드, 마스터 = 오른쪽, 데드밴드 100, 부팅 상한 400. 보드 켜면 앞 · 뒤축 텔레메트리, 40.5 V |
| Xtion | 640×480, 화각 58.6° × 45.6°, 29 fps, 미러링 켜짐 (코드가 뒤집음 — 좌우가 맞는 것을 사용자가 확인) |
| HP60C | 컬러 640×480 · 56.8°, 깊이 71.3° (자기 시점), 22.6 fps, 보정 R z 회전 0.8° · 기선 12.2 mm, 해독 실패 0 |
| 같은 방 깊이 값 비율 | Xtion 72 % · HP60C 30 % (창문 햇빛, HP60C 는 컬러 시점으로 옮긴 뒤) |
| 바퀴 방향 (띄움, 180 · 2 s) | 앞으로 · 뒤로 · 왼쪽 · 오른쪽 제자리 모두 맞음. 앞으로: 속도 (원시) 앞왼 −1.84 · 앞오 +1.81 · 뒤왼 −1.86 · 뒤오 +1.82 km/h, 앞축 스텝 오른쪽 −257 · 왼쪽 +259 |
| Jetson 자체 시험 (가짜 장치) | 13 항목 통과 |

### 결정

- `odo_sign` 을 실측으로 [−1, +1] 로 바꿨다 (처음 넣은 [1, −1] 은 가정이었고 반대였다 — 그대로면 앞으로 간 것을 뒤로 센다).
- HP60C 는 이 장치 방향 그대로 180° 돌려 쓴다. 어느 카메라로 갈지는 아직 (HP60C 는 가까운 사각 0.2 m · 깊이 71° 가 장점).

### 발견한 문제

- 메인보드는 몇 분 명령이 없으면 스스로 꺼진다 (09-18 에도 봤다). 시험 직전에 전원을 다시 켜야 한다.
- 뒤로 띄운 프로세스는 SIGINT 를 무시해 `pkill -INT` 로 안 꺼졌다 → `bench_ctl.sh` 는 SIGTERM. 처음 `pkill -f bench.py` 는
  그 명령을 실행하던 SSH 셸까지 끝냈다.
- ESP32 가 부팅할 때 Wi-Fi AP 비밀번호를 시리얼에 찍는다 — 점검 출력 · 기록에서는 `***` 로 가렸다.

### 남은 일

- 바닥에서 보정: 카메라를 차에 단 자리에서 바닥면 (높이 · 숙임), 직진 거리 · 제자리 각도로 `m_per_step` · `track_eff_m`
  (`calibrate.py straight --write` → `spin --write`)
- 카메라 정하기 (Xtion / HP60C) → `drive.py` · `calibrate.py` 에서 고를 수 있게
- SfM 위치 인식 실험 (CPU 로, 시뮬레이터 닫고)

---

## 2026-10-14 (수) · 상위 제어: 무선 게임패드로 실차 조종 — Jetson 수신기, L1 데드맨

> 시간: 15:25 ~ 16:55 · 장소: PC, Jetson "mokpo" (계정 `dongki`, 유선 직결 `192.168.127.2`) · 날짜 근거: 세션 · 관련 이슈: N1 · N2 · R5 · R7

ESP32 핫스팟 웹 조종 (폰) 이 자주 끊기고 조작도 불편해서, PS3 모양 2.4 GHz 무선 패드의 수신기를 Jetson 에 꽂아 패드로 바로
모는 `pad.py` 를 만들었다 ([experiments/2026-10-13_vlm-drive](../../experiments/2026-10-13_vlm-drive/README.md)).
바퀴를 띄우고 실물 ESP32 로 앞 · 뒤 · 느린 속도 · 조향, 손을 떼면 바로 서는 것까지 됐다. 이어서 남는 버튼에 비상정지 (B) ·
한 단계 빠르게 (R1) · 제자리 90° (십자 좌우) · 주행 기록 (A) 을 붙였다. 패드 전원이 꺼질 때의 동작은 아직 보지 않았다.

### 한 일

> 혹시 지금 연결된 jetson 장치에 무선 컨트롤러를 연결해서 이걸 통해서 차량을 조작할 수 있게 만들 수 있을까?

> 지금eps32 핫스팟을 통한 웹 컨트롤러 방식을 쓰니까 끊기기도 잘 끊기고 조작도 불편하기도 하고 그래서 말이야 이걸 쓰면 개선이 되려나?

- 웹 경로와 비교: 지금은 폰 Wi-Fi ↔ ESP32 AP 가 무선 구간이고, 웹 쪽에는 늦게 도착한 명령이 바퀴를 다시 돌리는 문제
  (R1 · R2 · U3), 정지를 다시 보내지 않는 문제 (R4), 손 떼면 램프로 감속하는 문제 (R5) 가 열려 있다. 패드는 무선 구간이 패드 ↔
  전용 수신기뿐이고 그 뒤는 USB 시리얼 선 + 하트비트 워치독이라 이 문제들을 비켜 간다. 대신 수신기 거리 (싸구려는 5 ~ 10 m)
  와 Jetson 이 켜져 있어야 한다는 조건이 붙는다.
- 패드: DragonRise `0079:181c` "Controller" (안드로이드 배치). 게임패드 장치 `event6` 하나에 버튼 15 개가 이름대로 나온다
  (L1 = TL 310 · R1 = TR 311 · SELECT 314 · START 315). 스틱은 X · Y (왼쪽) · Z · RZ (오른쪽) 0 ~ 255, L2 · R2 는 버튼과
  아날로그 (BRAKE · GAS) 가 같이 나오고, 십자는 HAT0X · HAT0Y. 미디어 키용 장치 2 개 (System · Consumer Control) 가 따로
  생긴다. 바탕화면에 `dongki` 가 로그인돼 있어 udev uaccess 로 `event6` 을 sudo 없이 읽는다 (`input` 그룹은 아님).
- `pad.py`: evdev 를 표준 라이브러리 (ioctl · struct) 로 직접 읽는다. `show` (이벤트 그대로) · `learn` (안내대로 눌러 `pad.json`)
  · `drive`. `pad_ctl.sh` 로 뒤로 띄운다. 자체 시험에 가짜 패드 항목 12 개를 넣어 PC 에서 통과 (잡기 전 · L1 한 번 떼기 · 단계 ·
  손 떼면 `x` · 루프가 멈추면 host watchdog · SELECT · 수신기 빠짐).
- `learn` 을 앱 터미널로 돌렸는데 안내 순서와 다른 입력이 섞였다 (L1 자리에 R2, START 자리에 오른쪽 스틱). `show` 로 하나씩
  눌러 보며 배치를 확인해 `pad.json` 을 직접 썼다. `learn` 은 버튼 단계에서 스틱 축을 받지 않게 고쳤다.

> 근데 어차피 바퀴는 공중에 띄어나서 그냥 바로 해도 되는데 말이야

- 가짜 ESP32 단계를 건너뛰고 실물로 `pad.py drive` (바퀴 띄움). 메인보드가 꺼져 있어 (0.0 V) 켜자 "telemetry back".
  START → 워치독 켬, L1 + 왼쪽 스틱으로 앞 +150 · 뒤 −150, 살짝 밀어 +50 ~ +70 으로 천천히. 오른쪽 스틱으로 서서 · 가면서
  t ±400. 스틱이나 L1 을 놓을 때마다 `STOP (user)`.

> 안쓰는 버튼들은 뭐가 있지?

- R1 · L2 · R2 (아날로그 값도) · A · B · X · Y · 십자 좌우 · 왼쪽 스틱 좌우 · 오른쪽 스틱 위아래 · L3 · R3. MODE 는 기록에 안
  나왔다 (패드 안에서 아날로그 전환에 쓰는 듯).

> B: 비상정지 / R1 누르는 동안: 한 단계 빠르게 / 십자 좌우: 오도메트리로 제자리 90° 돌기 / A: 주행 기록 시작 / 끝 — 이건 다해주라

- B: 잡았으면 `x` 하고 놓기 (`w 0`), 잡지 않았어도 `x`. 다시 몰려면 START, 그 뒤 L1 을 한 번 떼야 움직인다.
- R1: 누르는 동안 속도 단계 하나 위 (150 → 200).
- 십자 좌우: L1 을 누른 채 스틱을 놓고 누르면 오도메트리로 제자리 90°. `motion.turn_by` 는 끝날 때까지 붙잡고 있어 패드를
  못 읽으므로, 같은 규칙 (`turn_cmd` 500 → 20° 안쪽 `turn_cmd_slow` 300, 허용 4°, 시간 2 s + 90° / `turn_min_dps`) 을 틱마다
  한 번씩 하는 상태로 짰다. 도는 중에 L1 을 떼거나 스틱을 건드리면 멈춘다.
- A: `record.py` 는 포트를 스스로 열어서 패드 프로그램과 따로 띄우면 한 포트를 둘이 나눠 읽게 된다 (보고 줄이 깨진다).
  `Recorder` 에 `link` 인자를 더해 패드 프로그램 안에서 같은 링크로 돌리게 했다. 처음 누를 때 Xtion · 웹캠을 뒤에서 열고
  (몇 초), 결과는 `data/logs/hallway-run/<시각>/`, 20 분 뒤 스스로 끝. 프로그램을 끝낼 때 녹화 파일을 닫고 `os._exit`
  (OpenNI 정리 중 멈춤을 피하는 `record.py` 와 같은 방식).
- 자체 시험에 9 항목을 더해 (R1 · B 두 개 · 왼쪽 90° · 오른쪽 시작 · L1 로 끊기 · 스틱으로 넘겨받기 · A) PC · Jetson 모두 통과.
  가짜 ESP32 를 데드밴드 100 으로 만들면 제자리 회전이 초당 11° 라 90° 가 시간 초과로 75° 에서 멈춰, 항목 5 와 같은 200 으로 맞췄다.

> 그래 이더넷 뽑고 지금 전원선도 잠깐 뽑았다 연결할거라서 켜지면 바로 저거 컨트롤러 대기 하고 있게 해야해

- 실물에서 R1 (`단계 200 (R1)`) · B 비상정지 · A 녹화가 동작했다 (녹화 51 s, Xtion · 깊이 · 웹캠 257 장씩 + 바퀴 기록).
- 부팅 자동 실행: "mokpo" 는 gdm 자동 로그인 (`dongki`) 이고 cron 이 돌아 sudo 없이 사용자 crontab `@reboot` 로 걸었다
  (`pad_ctl.sh install`). `start` 는 `pad.py` 가 끝나면 3 s 뒤 다시 띄우는 고리로 바꿨다 — 부팅 직후 ESP32 가 늦게 잡혀도.
  `pad.py` 를 죽여 6 s 만에 다시 패드를 잡는 것을 확인했다. 실제 재부팅 뒤 동작은 아직.
- 등록하다 SSH 명령 안의 `pkill -f "python3 -u pad.py"` 가 그 SSH 셸 자신과 맞아 셸이 같이 꺼졌다 (같은 날 아침 bench.py 와
  같은 실수). 끄기 · 켜기는 `pad_ctl.sh` 로만 부른다.

> 잘 되는 거 확인했어 모든 기능이 말이야 / 근데 직진중 회전 넣으면 거의 의미없을 정도야

> 그리고 a 를 눌러 기록을 시작하면 시뮬레이터 쪽에서 작업했던 것처럼 영상녹화까지 자동으로 이루어지나?

- 밖에서 6 분 녹화 (`2026-10-14_162330`) 의 바퀴 보고 줄을 명령 듀티별로 묶었다. 예전 방식의 오른쪽 끝 (280, 120) 에서
  바퀴가 왼 3.85 · 오른 2.84 km/h — 안쪽 바퀴가 듀티 120 (혼자면 1 km/h 쯤) 인데 차체에 끌려 거의 같이 돌았다. 제자리
  (180, −180) 는 +1.90 / −1.81 로 잘 돌았다.
- 조향을 바꿨다: 가면서는 바깥 바퀴를 왼쪽 스틱 세기 그대로 두고 안쪽 바퀴만 줄여, 오른쪽 스틱 반이면 안쪽 0 · 끝까지면
  거꾸로 (제자리). 서 있을 때는 예전대로.
- 패드 로그가 3 줄뿐이었다. Jetson 은 시계 배터리가 없어 전원을 뽑았다 켜면 시각이 마지막 저장 시각 (16:22:59) 부터 가고,
  들어와서 한 번 더 켤 때 `/tmp` 가 비워져 밖에서 쓴 로그가 지워졌다 (녹화는 `data/logs` 라 남았다). 로그를
  `data/logs/pad/pad.log` 로 옮기고, 고리를 시작할 때 부팅 시각 · 시계 동기화 여부를 적게 했다.
- A 녹화에 더한 것: 웹캠 동영상 `webcam.mkv` (받는 대로 ~30 fps, x264 — Orin Nano 는 하드웨어 인코더가 없다. 전원을 그냥
  뽑아도 열리게 mp4 대신 mkv) 와 프레임 시각 `webcam_video.csv`, 패드 입력 · 보낸 명령 `commands.csv`, 녹화가 끝나면
  `review.py` 로 `preview.mp4` 를 뒤에서 (nice 10). `meta.json` 에 `clock_synced`. 시뮬레이터 쪽에는 녹화 기능이 없었다
  (가장 가까운 것은 `replay_sim.py`).
- 15 s 시험 녹화: 동영상 447 프레임 (29.8 fps) · 7.5 MB (20 분이면 약 600 MB), 녹화 프로세스 CPU 약 2 코어. 미리보기는 15 s
  분량을 3.7 s 에.

### 결정

- 조작: START 잡기 (`x` · `m 300` · `w 1`) · L1 누르는 동안만 움직임 · 왼쪽 스틱 속도 · 오른쪽 스틱 조향 · 십자 위 / 아래 속도
  단계 (100 ~ 300, 처음 150) · SELECT 놓기 (`w 0` — 폰 웹 조종으로 돌아갈 수 있게, N2).
- 스틱을 놓거나 L1 을 떼면 램프 없이 `x` (R5 에서 웹에 바라던 동작). 가속은 펌웨어 램프 그대로.
- 가면서 조향은 안쪽 바퀴를 0 · 거꾸로까지 줄인다 — 안쪽 바퀴를 앞으로 약하게 주는 것으로는 네 바퀴 스키드 스티어가
  돌지 않는다 (위 실측).
- 스틱을 살짝 밀면 펌웨어가 0 으로 치는 50 부터 시작한다 — 그대로 비례시키면 단계 150 에서 스틱 1/3 까지 안 움직인다.
- `open_serial` 이 리눅스에서 포트를 잠근다 (pyserial `exclusive`) — `bench.py` · `pad.py` · `drive.py` 가 한 포트에 같이 쓰지 않게.
- 폰 웹 조종과 같이 쓰지 않는다 (웹 버튼을 누르는 동안은 시리얼 `x` 가 덮인다, R7).

### 확인한 것

| 항목 | 값 |
| --- | --- |
| 패드 | DragonRise `0079:181c`, `/dev/input/event6`, 축 0 ~ 255 (가운데 128). 왼쪽 스틱 위 = Y 감소, 오른쪽 스틱 오른쪽 = Z 증가, 십자 위 = HAT0Y −1 |
| 실물 (바퀴 띄움, 단계 150) | 앞 +150 · 뒤 −150 · 느리게 +50 ~ +70 · 조향 t ±400, 놓을 때마다 STOP (user), 40.4 V |
| 자체 시험 (PC · Jetson) | 게임패드 21 항목 통과. 가짜 장치에서 왼쪽 90° 돌기는 오도메트리 +91.2° (PC) · +87.1° (Jetson) 에서 섬 |

### 발견한 문제

- 잡을 때 첫 줄 (`x`) 이 "? unknown" 으로 버려졌다 — 포트를 열 때 생긴 출력 가능한 잡음이 앞에 붙은 것 (N1 대로 무시만 됨).
  `arm()` 이 `x` 를 먼저 보내므로 뒤의 `m` · `w 1` 은 들어간다.
- 자체 시험 5 (왼쪽 90° 돌기) 가 실패한다 — 작업 트리의 `robot.json` 보정값 (`track_eff_m` 0.79 → 0.92, 커밋 전) 과 가짜
  ESP32 의 '진짜' 윤거가 어긋나서다. 패드 작업과는 관계없다.

### 남은 일

- 새 조향 방식을 바닥에서 — 스틱 반 · 끝에서 실제로 도는지, 너무 급하지 않은지
- 실물로 십자 좌우 90° 확인. 90° 는 바닥에서 실제 각도를 재 봐야 한다 (스키드 스티어는 돌 때 미끄러져
  오도메트리보다 덜 돈다 — `track_eff_m` 보정)
- 조향이 실제로 맞는 쪽으로 도는지 (눈으로), 그리고 패드 전원을 끄거나 범위를 벗어날 때 L1 '뗌' 이 오는지 — 안 오면 마지막 상태가 남으므로
  대책이 필요하다
- 바닥에서 몰기, 수신기 거리 (금속 차체 안쪽 · USB 3.0 포트 옆 피하기)
- 로그인 없이 쓰려면 `input` 그룹. 부팅 때 자동 실행 (systemd) 할지 정하기

---

## 2026-10-14 (수) · 상위 제어: 카메라로 위치 찾기 — SfM 을 Jetson 으로, 첫 주행 다시 돌려 보기, 시뮬레이터 연결, 마커 첫 시험

> 시간: 11:15 ~ 17:40 · 장소: PC, Jetson "mokpo" (유선 직결 `192.168.127.2`), 복도 (사용자 주행) · 날짜 근거: 세션

카메라만으로 복도 지도 위 위치를 찾는 SfM 실험 ([experiments/2026-10-13_sfm-relocalization](../../experiments/2026-10-13_sfm-relocalization/README.md))
을 Jetson 에서 돌게 옮기고 (pycolmap · torch 없이 numpy + OpenCV), 차 높이 카메라로 처음 녹화한 주행에 붙여 봤다. 지도 영상과
같은 방향으로 갈 때는 웹캠으로 복도 가운데를 ± 0.4 m 안에서 따라갔고, 반대 방향은 지도가 없어 못 찾았다. 실차 코드
(`drive.py`) 에 웹캠 위치 인식 (`--pose vis`) 과 시뮬레이터 연결 (`--sim`), 게임패드 승인 (`--confirm pad`) 을 넣었다. 마커는
바닥에 깔아 본 첫 시험에서 0.9 ~ 1.5 m 앞 좁은 띠에서만 잡혔다. 실차 시험은 내일.

### 한 일

> 카메라 사진 만으로 위치를 잡는 실험이 필요하다고 했잖아 그걸 어차피 pc 가 아닌 jetson 에서 해야할 거니까 jetson 에 세팅해두고 해보면 안되나?

- Jetson 에는 pycolmap 휠이 없어서 `colmap_lite.py` (COLMAP 지도 · DB 읽기, OpenCV SIFT 를 COLMAP 꼴로, OpenCV PnP) 를 새로
  짜고 `relocalize.py` 를 numpy + OpenCV 로 옮겼다 (pycolmap 과 값이 같음을 PC 에서 확인). 지도 자료 278 MB 는 git 밖
  (`to_jetson.sh WITH_SFM=1`). 같은 영상 안의 leave-out 결과와 '같은 방향일 때만' 결론은 실험 README.

> 그럼 차 실제 수동주행하면서 영상 찍어볼게. 카메라도 웹캠 하나 더 달거야 / 확인할수 있게 gui 로 해서 각각 실시간 영상 보여줘봐

- 녹화기 `record.py` (Xtion 컬러 · 깊이 · 웹캠 · ESP32 보고 줄을 같은 시계로 5 Hz, 웹 화면 `:8093` 에서 실시간 보기 · 녹화 버튼)
  · `review.py` (나란히 미리보기 동영상). 첫 주행 녹화 (13:54, 8 분) — 사진 · 동영상은 `data/logs/hallway-run/` (git 밖, 사람이
  찍힘). 이후 녹화는 패드 프로그램 (`pad.py`, 다른 세션) 의 A 버튼으로.
- `locate_run.py` · `localizer.py`: 녹화 사진마다 지도 위 자세. 오도메트리 위치 근처 (반경 6 m · 비슷한 방향) 지도 사진의
  관측만 맞춰 Jetson 한 장 1.0 s (지도 전체 6.4 s).

> 그거하면서 그것도 될지 봐볼까? 3d 로 구성된 지도맵이랑 거기서도 차량이 보는 시야로도 영상을 볼 수 있잖아

- 시뮬레이터에 `sensors.renderView` (아무 자세에서 컬러 · 깊이) 를 넣어 실제 사진과 같은 자세로 그려 비교했다 — 3D 지도는 문 ·
  사물함 · 소화기 자리까지 실제와 같았고 SfM 좌표와도 맞았다. 그러나 무늬가 프로그램으로 그린 것이라 사진 ↔ 렌더 SIFT 짝은
  4 ~ 6 개 (안 됨). 깊이 (Xtion ↔ 렌더) 는 바닥 (높이 0.30 m · 숙임) 이 98 % 맞고 앞뒤 위치에도 봉우리가 섰다 — 보조로 쓸 만함.

> 시뮬레이터상에서 움직이는 거에 따라 실제 바퀴조작까지 가상으로 시켜도 되잖아, 오늘 녹화로 다시 돌려보기도 한번해보고 말이야

- `pose_fusion.py` (오도메트리 + 카메라 답, 늦게 온 답도 찍은 때 기준으로, 게이트 · 길 잃음 · 두 번 맞아야 다시 잡기) ·
  `replay.py` (녹화 다시 돌려 보기) · `replay_sim.py` (섞은 위치로 시뮬레이터 차를 움직이며 실제 웹캠 | 렌더 동영상).
- `drive.py --sim` + `sim_bridge.py`: 실차 코드 그대로, 바퀴는 가상 ESP32, Xtion 은 시뮬레이터 3D 지도가 그 자리에서 그린 것,
  페이지 (`?bridge=1`) 의 차가 따라 움직이며 바퀴 명령 · 추정 / 진짜 위치를 보인다 (`serve.py` 의 `/api/bridge/*`).
  `--pose vis` (실차: `vision_fix.py` 웹캠 + 지도, 시뮬레이터: 실측 성능으로 흉내). 가짜 모델 12 걸음에서 추정과 진짜 차 4 cm.
  사용자가 GPT 로도 몰아 확인.

> HDR 실험 종료시키자, 실차 실험은 바로 해볼 수 있나?

- HDR 은 이미 꺼져 있었다. 게임패드 승인 (`--confirm pad`, `pad_confirm.py`: START 실행 · 십자 아래 건너뜀 · SELECT 그만, 움직이는
  동안 L1 을 누르고 있어야 하고 떼면 `Motion.guard` 가 바로 세움) · `drive_ctl.sh` (이더넷을 뽑고 따라가게 뒤로 띄우기).
  Jetson 에서 OpenAI 닿음 · 패드 · 위치 인식 속도까지 확인. 실차 시험은 사용자가 미룸.

> 일반적이 자율주행 등 보면 마커 이미지를 통해서 보정하거나 위치 인식하거나 하잖아 … 마커 이미지를 몇군데 붙여서 하는 실험부터

- 새 실험 [experiments/2026-10-14_fiducial-markers](../../experiments/2026-10-14_fiducial-markers/README.md): AprilTag 36h11 ·
  160 mm 인쇄 (`markers.py sheet`, git 밖) · 사진에서 찾기 · 녹화 훑기 (`scan_run.py`).

> 맨 마지막 주행에서는 바닥에 저 마커도 5-6개 정도 깔아두고 우선 인식이 잘 되나부터 보려고 주행시켜봤거든? 모든 데이터 확인 잘 해봐

- 녹화 5 개 점검 (`check_run.py`): 빠진 사진 없음, 끊김 최대 1.0 s, 보고 줄 5 Hz, 40 V, 앞 · 뒤축 링크 끝까지. 16:14 는 바퀴를
  띄운 시험 (화면 · 깊이가 그대로). 미리보기 · 웹캠 동영상은 PC `data/logs/hallway-run/<시각>/` 로 복사.

### 확인한 것

| 항목 | 값 |
| --- | --- |
| 첫 주행 (13:54) 다시 돌려 보기, 웹캠 1 초에 한 장 | 250 장 중 101 장 찾음 · 96 장 씀. 갈 때 (복도 → 로비) 복도 가운데 ± 0.4 m, 돌아올 때 0 장 |
| 녹화로 잰 보정값 (`robot.json`) | 스텝 5.76 → 5.90 mm (28 m), `track_eff_m` 0.79 → 0.92 (로비 168° 회전), 오른쪽 바퀴 1.01, 웹캠 방향 +5.5° · 높이 0.35 m |
| 그 보정값으로 오도메트리만 | 31 m 동안 옆으로 0.8 m 안 (전에는 3.3 m) |
| 웹캠 vs Xtion (SfM, 관측 전부) | 웹캠 50 장 중 17 · 갈 때 10 장 중 9, Xtion 4 (어둡고 특징점 적음) |
| 새 녹화 4 개 (16:23 제외) | 대부분 돌아오는 방향 · 방 안이라 찾은 장 적음 (11 / 29 · 11 / 80 · 11 / 183) — 양방향 지도 재료 |
| 바닥 마커 (17:04, 30 fps) | 6 개 ID 다 한 번 이상, 차 앞 0.9 ~ 1.5 m · 67 ~ 74° 비스듬할 때만, 보이는 동안 프레임의 15 ~ 35 %. 벽에 기대 세운 것은 2.2 m 에서도 |

### 결정

- 위치 찾기는 웹캠, 장애물 · 바닥은 Xtion 깊이. 3D 지도는 깊이 비교로 오도메트리를 돕는 데 (겉모습 비교는 안 됨).
- 마커는 바닥보다 세워 붙인다 (낮고 수평인 카메라).

### 발견한 문제

- 로비 입구에서 SfM 이 인라이어 100 넘게 틀린 답을 연달아 냈다 (카메라 높이 −1.7 m 같은 답) — 높이 거르기 (0 ~ 0.8 m) ·
  두 번 맞아야 다시 잡기로 막음.
- 좌우 제자리 회전을 번갈아 할 때 바퀴가 미끄러져 오도메트리 방향이 수십 도 틀어진다 (첫 주행 335 s).
- `pkill -f <패턴>` 이 그 명령을 실행하는 SSH 셸까지 죽인다 — `[.]` 처럼 자기 글자와 안 맞는 패턴을 쓴다.
- 자체 시험 5 (다른 세션 일지) — 가짜 ESP32 의 '진짜' 값을 새 보정값 근처로 옮겼다 (`fake.py`).

### 남은 일

- 양방향 지도: 오늘 녹화 (특히 돌아오는 방향) 로 차 높이 SfM 지도를 새로 만들고, 기존 지도에서 찾은 사진으로 좌표를 맞춘다 (PC CPU, 시뮬레이터 끄고)
- 마커를 벽 · 방화문에 세워 붙이고 다시 훑기 → 마커 자리를 지도 좌표로 → 다시 돌려 보기에 마커 답 더하기
- 실차 시험: 입구 → 310 앞 (`drive_ctl.sh start`, 게임패드 승인). 웹캠이 차 중심에서 앞으로 몇 cm 인지 재기 (지금 35 cm 가정)
- 16:23 녹화 다시 돌려 보기는 Jetson 에서 도중에 꺼짐 (사용자 퇴근) — 다시
