chungddong/NUBI/docs/worklog/2026-09.md

# 작업 일지 — 2026년 9월

양식과 전체 연표는 [README](README.md)에 있습니다.

| 날짜 | 영역 | 제목 |
| --- | --- | --- |
| 2026-09-03 (목) | 바퀴 제어 | [D32 환경 준비 시도](#2026-09-03-목--바퀴-제어-d32-환경-준비-시도) |
| 2026-09-10 (목) | 차체 | [전체 차량 뷰어 탑재와 형상 기반 BOM 산출 (+ 09-15 일지화 착수)](#2026-09-10-목--차체-전체-차량-뷰어-탑재와-형상-기반-bom-산출--09-15-일지화-착수) |
| 2026-09-17 (목) | 바퀴 제어 | [백업 커밋 (링크 B, Wi-Fi 조종 페이지)](#2026-09-17-목--바퀴-제어-백업-커밋-링크-b-wi-fi-조종-페이지) |
| 2026-09-17 (목) | 바퀴 제어 | [탱크 구동, 데드밴드, NVS 설정 / 업스트림 분석 / 코드 리뷰](#2026-09-17-목--바퀴-제어-탱크-구동-데드밴드-nvs-설정--업스트림-분석--코드-리뷰) |
| 2026-09-17 (목) | 상위 제어 | [전방 장애물 가드](#2026-09-17-목--상위-제어-전방-장애물-가드) |
| 2026-09-18 (금) | 상위 제어 | [초파리 전뇌 폐루프 주행](#2026-09-18-금--상위-제어-초파리-전뇌-폐루프-주행) |
| 2026-09-22 (화) | 바퀴 제어 | [기본 모드 변경, 하드웨어 구성 정리, 메인보드 커스텀 빌드](#2026-09-22-화--바퀴-제어-기본-모드-변경-하드웨어-구성-정리-메인보드-커스텀-빌드) |

---

## 2026-09-03 (목) · 바퀴 제어: D32 환경 준비 시도

> 장소: PC (`F:\Develop\lolind32test`) · 날짜 근거: 세션 · 원본: 바퀴 제어기 작업 일지 `firmware/wheel-controller/WORKLOG.md`

### 한 일

- "아두이노 IDE 없이 LOLIN D32 테스트 환경을 만들어 달라"는 요청으로 시작했지만 "다시 시도"를 여러
  번 반복한 끝에 중단했다. 이 저장소가 이 PC의 `F:\Develop\lolind32-wheel`로 오기 전의 준비 시도다.
  그 프로젝트의 메모리 폴더에는 이 일과 무관한 Blender 작업 메모가 들어 있다.

---

## 2026-09-10 (목) · 차체: 전체 차량 뷰어 탑재와 형상 기반 BOM 산출 (+ 09-15 일지화 착수)

> 시간: 10:43 ~ 09-15 (화) 19:08 · 장소: PC (`D:\build123d`) · 날짜 근거: 세션 기록 · 원본: 차체 설계 일지 `entry_16.html`

이날은 설계를 더 고치는 날이 아니었다. 지금까지 만든 것 전부 — 3030 프레임, Design-D 휠마운트 4세트, 액슬 타이, 외장셸, 적재함, 센서·전자 — 를 한 화면에 올리고, 그 형상에서 부품 수량·부피·질량을 그대로 읽어 예상 견적(BOM)을 내는 것이 목표였다. 닷새 뒤 09-15 저녁에는 이 세션 전체를 Trilium 에 일지로 남기자는 요구가 나와 Claude 가 접근 경로를 조사했다.

> 우리 차량 했던 것 전체 버전 뷰어에 보여주고 그거 기반으로 부품 예상 견적 내보자 BOM 해서 말이야

### 한 일

#### 10:43 — "전체 버전" 스크립트 확인

차량 통합 스크립트가 네 개(`vehicle_integration.py`, `vehicle_shell_integration.py`, `vehicle_cargo_integration.py`, `vehicle_flat_abs_integration.py`)였고, 셸·적재함까지 다 붙는 것은 `VEHICLE_PAYLOAD=cargo` 를 걸고 `vehicle_shell_integration.main()` 을 부르는 11줄짜리 cargo 판이었다. 본체 `models/swerve_base.py` 는 2,961줄(09-15 현재도 같다)로, 프레임·브라켓·판재·셸·적재함을 `GROUPS` 로 묶어 두고 있었다. 가격 관련 상수는 `models/tslot.py` 에 이미 있었다 — `UNIT_PRICE = 950` 원/100 mm(2026-08 실주문 확인), `CUT_UNIT = 100` 으로 100 mm 단위 올림 과금.

막힌 것 → 원인 → 해결:

- 저장소 전체 `grep -rn "BOM\|bom"` 이 120초 안에 끝나지 않아 백그라운드로 넘어갔다 → 원인은 기록에 없다(`.venv`·output 까지 뒤진 탓으로 보이나 확실하지 않다) → 작업을 중단(`TaskStop`)하고 필요한 파일만 직접 열었다.
- 탐색 스크립트를 `$TMPDIR/probe.py` 에 쓰려다 `/probe.py: Permission denied` → Git Bash 에서 `TMPDIR` 이 비어 루트에 쓰려 한 것 → 스크래치패드 절대경로를 박아 해결.
- `cd models && grep …` 가 `cd: models: No such file or directory` → 서브에이전트 셸은 호출마다 cwd 가 초기화된다(바로 앞 `cd models && sed …` 는 우연히 통했다) → 다음 명령부터 `cd /d/build123d &&` 또는 저장소 루트 기준 경로를 썼다.

#### 10:50 — 통합 스크립트 갱신 (볼트 길이·액슬 타이)

`vehicle_shell_integration.py` 는 볼트 길이를 `side_button_head_bolts_reference(20.0)` / `bottom_…(20.0)` 으로 박아 두고 있었고(실측은 M6x15), 액슬 타이가 아예 없었다. Claude 가 고친 내용(09-15 현재 `git diff` 로 확인):

- `import parameters as P` 를 추가하고, 볼트 참조를 인자 없이 불러 `P.LOW_BOLT_LEN`(15 mm)을 따르게 했다. 라벨도 `M6x20_…` / `M6x20_프로파일체결볼트_24개` 고정 문자열에서 `f"M{P.TNUT_BOLT:.0f}x{P.LOW_BOLT_LEN:.0f}_…"` 와 실제 개수로 바꿨다.
- `axle_ties()` 를 새로 넣어 앞뒤 축(`±V.AXLE_X`)마다 `LC.tie_rods + LC.tie_profile`(TIE_KIND 에 따라 한쪽은 빈 목록) 과 `LC.tie_brackets` 를 배치했다. 그룹 이름은 `TIE_KIND` 에 따라 `액슬타이_3030x{TIE_PROF_LEN}_…` 또는 봉 규격(`액슬타이_M8x400봉_…`)으로 붙는다.
- 그룹 라벨 `DesignD_원래_하부클램프_4개` → `DesignD_하부클램프_4개`. 색 목록도 고정 4색에서 `g.color` 로 바꿨다.

실행 결과(`MOUNT=low`, cargo): 전장 873 × 전폭 612 × 전고 606 mm, 축간 420 / 윤거 520 / 바퀴 Ø158.7, 레일 중심 z=108.92 / 차체 바닥 z=93.92 / 지상고 55.35, 바퀴가 레일 윗면보다 34.8 mm 솟아 휠아치가 필요하다는 기존 경고가 그대로 찍혔다. 스키드 T/L 1.24, 베이 700×390×140(바닥 z=127), 데크 810×510 @ z=303, 셸 고정 M6 12개. 뷰어(3939)에는 38그룹이 올라갔다(`groups=38 wheel_y=±263.70 rail_z=108.92`).

이 구간의 렌더는 `docs/images` 에 없다 — 전폭 612 / 전고 606 전체 버전은 브라우저로 뷰어 스크린샷만 봤고 파일로 남기지 않았다.

#### 10:52 — 형상에서 부피·수량 추출

BOM 을 손으로 적지 않고 `swerve_base` 를 `NOSHOW=1 NOEXPORT=1` 로 임포트해 `GROUPS` 를 순회하며 부품 수·부피·bbox 를 뽑았다. 주요 값:

| 그룹 | 개수 | 부피 (cm³) | bbox (mm) |
| --- | --- | --- | --- |
| 프레임 | 18 | 2,695.6 | 760×450×203 |
| 조인트브라켓 | 28 | 149.1 | 700×445×198 |
| 바퀴 | 4 | 4,355.1 | 579×583×159 |
| 휠마운트 | 4 | 363.7 | 504×453×39 |
| 휠클램프 | 4 | 60.4 | 463×452×13 |
| 판재 (베이바닥판 / 데크) | 2 | 796.1 / 1,223.5 | — |
| 외장셸 (앞 / 뒤) | 2 | 1,047.7 / 1,129.8 | — |
| 범퍼 | 2 | 325.6 ×2 | — |
| 소형카메라 | 6 | 15.4 ×6 | — |

바퀴·휠마운트·휠클램프는 `swerve_base` 의 옛 그룹이고, 통합 스크립트가 이 셋을 빼고 Design-D 클램프·실제 모터 STEP 으로 바꿔 끼운다.

#### 10:57 — tools/bom/bom.py

새 도구는 세 가지를 줄 단위로 구분한다: 수량·부피·질량은 형상에서(정확), 프로파일 절단은 `tslot.cut_list` 와 같은 100 mm 올림 규칙(정확), 단가는 스크립트 맨 위 `PRICE` 표(`확인` 태그 4개만 실주문 값, 나머지는 `추정`). 조달은 보유 / 출력 / 구매 셋으로 나눠 "전부 신품" 과 "지금 추가로 드는 돈" 두 합계를 낸다. 환경변수는 `vehicle_shell_integration` 과 같게 맞춰(DRIVE=skid, MOUNT=low, PAYLOAD=cargo, TOP_RAIL_Y=210, SHELL_Y=255, SHELL_WHEEL_Y=263.7) 뷰어에 보이는 것과 견적이 갈리지 않게 했다. 결과는 `docs/bom.md` 와 `docs/bom.csv` 로 저장된다.

첫 실행 출력 끝에 철물 집계가 찍혔다 — 다이캐스팅 브라켓 3025 28개 10,080원(조인트 28곳 자동 검출), M6x15 84개 5,880원(브라켓 56 + 휠마운트 16 + 셸 12 + 축캡 0), 스프링너트 306 84개 15,120원, 철물 합계 31,080원. 단, 이 네 줄은 `bom.py` 가 아니라 임포트된 `swerve_base.py` 자체의 print 블록이고, "휠마운트 16" 은 옛 휠마운트 기준이다. `bom.md` 표에서는 M6x15 68개 4,760원(브라켓 56 + 셸 12) + 스프링너트 68개 12,240원으로 잡고, Design-D 하부 클램프 볼트 8개와 타이 브래킷 볼트 8개를 따로 행으로 냈다. 절단 목록은 760 mm 4본(32단위, 버림 160 mm), 390 mm 8본(32단위, 버림 80 mm), 143 mm 6본(12단위, 버림 342 mm), 프레임 총 7.02 m / 7.28 kg.

이어서 패치 세 번: `PRINT_JOBS` 를 넣어 출력 총량·시간을 집계했고(0.4 노즐 / 0.2 층 / 유효 토출 10 mm³/s 기준, `FLOW = 10.0`), 다음으로 Ender-3 V3 SE 베드(220×220×250) 초과 검사를, 마지막으로 판재 대안 표를 붙였다. 53줄 BOM 의 요약(09-15 현재 `docs/bom.md` 와 같다):

| 구분 | 금액 |
| --- | --- |
| 보유 (프레임·모터·기존 클램프·철물·배터리) | 471,840원 |
| 출력 (필라멘트만) | 563,256원 |
| 구매 | 941,382원 |
| **전부 신품 기준** | **1,976,478원** |
| **지금 추가로 드는 돈 (출력+구매)** | **1,504,638원** |

| 카테고리 | 금액 |
| --- | --- |
| 1. 프레임 | 99,280원 |
| 2. 판재 | 51,342원 |
| 3. 구동부 | 242,760원 |
| 4. 외장·차체 | 171,105원 |
| 5. 전자·제어 | 495,000원 |
| 6. 센서·표시 | 382,000원 |
| 7. 적재함 | 534,991원 |

대조: `docs/build-log.md` 32절에는 08월에 낸 예상 제작비(베이스만 482,000 \~ 992,000원, 출력·판재는 학교 장비 0원 가정, 철물 84/84개도 같은 수)가 이미 있었다. 이번 BOM 은 필라멘트 값을 넣고 적재함까지 포함하므로 기준이 다르다. 이 턴의 기록에는 32절을 참조한 흔적이 없다.

#### 11:01 — 출력 406시간, 베드 초과 14건

출력물 합계가 14,600 cm³ / 약 406시간이었다. 프린터 한 대로 붙어 있으면 17일이다(406 h ÷ 24). 그리고 베드에 안 들어가는 부품이 14건 나왔다 — 적재함 셸 810×510×269(24조각), 외장셸 ×2 510×404×254(각 12조각), 장비베이 지붕 810×510×40(12조각), 뚜껑 529×349×58(6조각), 배터리브라켓·범퍼 ×2·슬라이드채널 ×3·장비마운트 2종·바구니크래들까지. Claude 는 24조각을 붙이는 것은 설계가 아니라고 판단해, 셸 4가지를 같은 부피의 벽 두께로 전개해 3 mm 판재로 환산한 대안 표를 넣었다(굽힘·이음 공수는 미포함, 면적 값만).

이 구간의 렌더는 docs/images 에 없다.

| 부품 | 벽 | 전개 면적 | 출력 | 판재 | 출력 시간 |
| --- | --- | --- | --- | --- | --- |
| 외장셸 | 3 mm | 0.73 m² | 82,963원 | 34,840원 | 60 h |
| 적재함 셸 | 5 mm | 1.04 m² | 197,316원 | 49,717원 | 144 h |
| 장비베이 지붕 | 5 mm | 0.43 m² | 82,199원 | 20,712원 | 60 h |
| 뚜껑 | 3 mm | 0.53 m² | 60,715원 | 25,497원 | 44 h |
| **합계** |  |  | **423,193원** | **130,766원** | **309 h** |

판재로 가면 292,427원과 309시간(전체 출력 시간의 76%)이 빠져 추가 지출은 1,504,638 → 1,212,211원이 된다. 대신 재단·굽힘 공수와 이음 철물이 붙는다는 단서를 같이 적었다.

#### 11:03 — 당장 구매분 산정

타이만 붙이려면 구매분이 M6x20 16개 1,440원(브래킷 8 × 탭 2단, 단가 90원 추정) + 드롭인 T너트 M6 8개 2,800원(단가 350원 추정) = 4,240원이고, 타이 프로파일 2본은 남는 390 mm 3030 을 재활용해 0원이다. 클램프 4개 + 브래킷 8개 출력분은 필라멘트 약 16,000원, 13시간으로 Claude 가 답했다 — 상세 행으로 다시 셈하면 클램프 14,416원(3.2 h/개 × 4 = 12.8 h) + 브래킷 1,544원(6.2 cm³ × 8 ≈ 1.4 h) = 15,960원 / 약 14 h 다. 답변에서는 이를 "휘어짐 28배 개선이 2만원과 하루" 라고 정리했는데, 28배라는 값은 이 구간에서 계산되지 않았고 `CLAUDE_HANDOFF.md`·`FEA.md` 에도 없다. 이전 구간의 타이 해석 값으로 보이나 확실하지 않다.

이 턴에서 만진 `vehicle_shell_integration.py`, `tools/bom/`, `docs/bom.*` 는 커밋하지 않았다 — `parameters.py`/`low_clamp.py` 에 남아 있는 타이 길이 360 vs 390 미결정분과 섞이면 안 되기 때문이다. 09-15 현재도 여섯 파일 모두 미커밋(M / ??) 상태이고, `parameters.py` 는 `TIE_PROF_LEN = 360.0` ("여분 390 에서 30 잘라낸다") 이다.

#### 09-15 19:06 — 세션 일지화, Trilium 경로 조사

> 우리 이 세션 대화 기록 토대로 했던것들 이런저런것들 정리해서 일지화해서 trilium note 에 root 에 트리 하나 파서 문서화해볼래?

Trilium 에 쓰는 도구가 없었다. Claude 의 조사 결과: 지연 툴 검색 "trilium" 은 0건, 이 세션의 커넥터는 Adobe·Notion·visualize·scheduled-tasks 뿐이었다. 예전 세션 기록 두 개(freecadAi, Pill-Box)에 trilium 언급이 있었고, freecadAi 쪽 기록에서 `claudeAiMcpEverConnected` 에 "claude.ai Trilium" 이 잡혔다 — 한때 claude.ai 커넥터로 연결했던 흔적이다. `claude mcp list` 는 서버 없음, `~/.claude.json` 에는 `D:/fusion3dclaude` 의 fusion 만 있었다. 로컬 포트 8080 / 37840 / 37841 / 8081 을 찔러 보니 37840 만 응답했고(`/api/app-info` 403), `/etapi/app-info` 는 401 NOT_AUTHENTICATED 를 돌려줬다 — 서버는 있는데 ETAPI 토큰이 없다. `%APPDATA%/trilium-data/config.ini` 에는 토큰이 없고(`[Security]` 에 backendScriptingEnabled=false 뿐) `document.db` 는 99,287,040 바이트(≈ 99 MB)였다.

이어서 원본 대화 기록을 색인했다: `ec66e9a8….jsonl` 83,989,075 바이트 / 10,775줄, type 집계로 assistant 4,079 · user 2,418(도구 결과도 user 타입으로 잡히므로 사람이 친 발언 수는 이보다 적다). 사용자 발언 색인에는 07-27 19:03 KST "바퀴 꼭대기보다 데크를 높이고…" 같은 초기 요구가 줄 번호(220)와 함께 잡혔다. 이 구간은 색인 결과를 읽는 데서 끝난다 — 실제 Trilium 에 노트를 만드는 과정과 이 일지 자체는 다음 구간의 일이다.

### 결정

- BOM 은 손으로 적지 않고 형상에서 뽑는다. 수량·부피·질량·절단은 코드가 내고, 사람은 `PRICE` 표만 만진다. `확인` 태그(프로파일 950/100 mm, 브라켓 360, M6x15 70, 스프링너트 180)만 실주문 값이고 나머지는 눈대중이라 배로 틀릴 수 있다고 명시했다.
- 조달을 보유/출력/구매로 갈라 "전부 신품" 과 "추가 지출" 을 따로 낸다.
- 큰 셸 4종은 출력이 아니라 판재로 가는 쪽을 대안으로 문서에 남겼다. 확정은 아니다.
- 통합 뷰어 스크립트는 볼트 길이·타이를 `parameters` 에서 읽는다. 상수를 박아 두면 실측(15 mm)과 어긋난 채 남는다는 것을 이날 또 확인했다.

### 남은 일

- 타이 프로파일 길이 360 vs 390 확정 후 `parameters.py`·`low_clamp.py`·BOM 을 함께 커밋한다(BOM 상세 표에는 "390 → 360 절단" 으로, `parameters.py` 에는 360.0 으로 잡혀 있다).
- 셸·적재함 판재 전환을 실제로 할지 결정하고, 하면 재단·굽힘 공수와 이음 철물을 BOM 에 넣는다.
- 전자·제어 495,000원, 센서·표시 382,000원처럼 `추정` 단가가 대부분인 항목을 실제 견적으로 바꾼다.
- Trilium ETAPI 토큰을 사용자가 발급해야 노트를 쓸 수 있다. 이 일지 작성 자체가 그 후속 작업이다.
- 이날 뷰어의 전체 차량 화면은 파일로 남기지 않았다 — `iso_render` 로 한 장 굽는 편이 좋다.

1순위(타이 길이)의 판단 근거: 09-10 10:47 에 이어 붙은 이전 대화 요약(컨텍스트 압축본)에는 마지막 방향이 "남는 390 mm 3030 프로파일을 쓰고, 부품 표준화를 위해 길이도 360 이 아니라 390 으로 유지한다" 로 적혀 있었다. 그런데 같은 요약이 옮겨 적은 `parameters.py` 스냅샷도, 09-15 현재 저장소의 `parameters.py` 도 `TIE_PROF_LEN = 360.0`("여분 390 에서 30 잘라낸다") 그대로이고, 이날 만든 `docs/bom.md` 타이 행도 "390 → 360 절단" 으로 360 을 따른다. 즉 대화에서 정한 방향(390 유지)이 코드와 BOM(360)에 반영되지 않은 채 남아 있고, 이 구간의 Claude 는 이를 "미결정분" 으로만 적어 두고 어느 쪽이 맞는지 판정하지 않았다. 확정은 사용자 몫이다 — 390 으로 가면 `parameters.py` 의 값·주석과 BOM 타이 행("390 → 360 절단")이 함께 바뀌어야 하고, 360 으로 가면 대화 요약의 "390 유지" 가 폐기된 결정임을 어딘가에 적어야 한다.

### 교훈

- 견적을 내 보니 병목은 돈이 아니라 출력 시간(406 h)과 베드 크기였다. 부피를 먼저 집계하지 않았으면 "24조각" 문제가 보이지 않았을 것이다.
- 통합 스크립트는 개별 모델보다 늦게 썩는다. `M6x20` 고정값처럼, 파라미터를 참조하지 않는 라벨·치수는 실물이 바뀌어도 그대로 남는다.
- 서브에이전트 Bash 는 cwd 와 `TMPDIR` 을 믿을 수 없다 — 절대경로만 쓴다.
- 외부 도구(Trilium)는 먼저 있는지, 인증이 되는지부터 확인하고 계획을 세운다. 이번엔 서버(37840)는 있었지만 토큰이 없었다.

### 이후 달라진 것 (2026-09-15 기준)

- 이 구간에서 만진 `vehicle_shell_integration.py`(M), `tools/bom/`(??), `docs/bom.md`·`docs/bom.csv`(??) 는 09-15 현재 그대로 미커밋이다. `docs/bom.md` 내용은 이날 마지막 실행 결과와 같다.
- `models/swerve_base.py` 는 2,961줄로 변함이 없다.
- `parameters.py` 는 `TIE_PROF_LEN = 360.0` 이고, `docs/bom.md` 타이 행도 "3030 L360 · 남는 390 mm 재활용 (390 → 360 절단)" 으로 360 기준이다.

---

## 2026-09-17 (목) · 바퀴 제어: 백업 커밋 (링크 B, Wi-Fi 조종 페이지)

> 시간: 12:25 · 장소: PC · 날짜 근거: 커밋 `946fe69` 12:25. 담긴 작업은 08-09 ~ 09-17 사이에 한 것이고, 날짜별 내역은 없다. · 원본: 바퀴 제어기 작업 일지 `firmware/wheel-controller/WORKLOG.md`

### 한 일

- 두 번째 마스터용 **링크 B**(UART1, GPIO26/27)를 추가했다. 링크 B는 핫조인 데드맨으로, 첫 프레임을
  받은 뒤부터 참여한다.
- **Wi-Fi 핫스팟 + 캡티브 포털 조종 페이지**(`hoverwheel`, 192.168.4.1)를 만들었다. 게임패드형 홀드
  버튼, 250 ms 하트비트 기반 웹 워치독(항상 무장), 속도/조향 강도·반전(브라우저에 저장), max 필드,
  링크 품질 표시가 있다.
- 조향 램프를 100/100 ms로, `MAX_STEER`를 1000(클램프 밖)으로 두었고, `STEER_SIGN -1`(08-12 실측)을 넣었다.
- 슬레이브 보드를 플래시(`2.1.8 slave.bin`)해서 `iSpeedR`가 살아났다. README에 4륜 프레임 구성 문단을 추가했다.
- 업로드 포트를 COM20에서 COM10으로 바꿨다(`platformio.ini`만 바꾸고 README는 그대로라 R10이 생김).

---

## 2026-09-17 (목) · 바퀴 제어: 탱크 구동, 데드밴드, NVS 설정 / 업스트림 분석 / 코드 리뷰

> 장소: PC · 날짜 근거: 세션(12:34 시작). 업스트림 저장소 클론 폴더 시각이 17:39라 저녁까지 이어졌다. · 커밋: 작업은 이날, 커밋은 2026-10-13 `453ab93` · 관련 이슈: R1~R12, U1~U11(리뷰), N1(나중에 드러남) · 원본: 바퀴 제어기 작업 일지 `firmware/wheel-controller/WORKLOG.md`

### 배경

| 항목 | 상태 |
| --- | --- |
| 저장소 | `946fe69 백업`. 새로 클론해서 `.venv/`가 없음 |
| 하드웨어 | 6.5" 허브모터 4개, 메인보드 4장(layout 2.1.8, GD32F130). **앞 축 = 마스터+슬레이브, 뒤 축 = 마스터+슬레이브**. 마스터는 둘 다 왼쪽 바퀴 |
| 메인보드 펌웨어 | RoboDurden Gen2.x 프리빌드 `2.1.8 master Uart.bin` / `2.1.8 slave.bin` |
| ESP32 배선 | 앞 마스터만 링크 A(GPIO16/17)에 연결. 뒤 마스터는 미연결 |
| 증상 | 전진/후진은 됨. **조향이 약하고 제자리 회전이 안 됨**. 후진할 때 부저가 울림. 명령 ~200 미만은 무게와 저항 때문에 안 움직임 |
| 제약 | 당장은 ST-Link로 메인보드를 재플래시할 수 없음(H2) |

### 한 일

#### 환경 복구와 첫 플래시

- `.venv`를 다시 만들고 `pip install platformio`(6.2.0)를 설치했다. `~/.platformio` 패키지 캐시가 남아 있어서
  빌드는 37 s 걸렸다.
- 빌드 결과는 RAM 14.0 %, Flash 61.1 %(800,853 B)였다.
- 보드 포트는 처음에 COM4(CH340)였다가 다른 USB 소켓에 꽂으면서 COM10이 됐다. `platformio.ini`의 `COM10`과 일치한다.
- 부팅 로그로 링크 A/B UART 초기화, AP `hoverwheel` 기동, `rx 0` → 데드맨
  `STOP (no telemetry -- board powered on?)`이 정상 동작하는 것을 확인했다.
- 배선도(마스터 1·2, 슬레이브, 3.3 V 금지)를 그림으로 그려 전달했다.

#### "왜 조향이 안 되는가": 업스트림 소스 분석

`Hoverboard-Firmware-Hack-Gen2.x-GD32/HoverBoardGigaDevice/Src/main.c`를 직접 읽고 pwm 모드
(`DRIVING_MODE 0`)의 믹싱을 수식으로 정리했다.

```
expo       = 1 − |speed| / 2000                  // 속도가 오를수록 조향을 절반까지 축소
steer'     = steer × expo
angle      = 90° − steer' × 0.09
x          = lookUpTableAngle[angle]              // 0°→ −1, 45°→ 0.3, 90°→ 1.0, x(90+k) = 1 / x(90−k)
outer      = speed
inner      = x × speed                            // 곱셈이라 speed = 0이면 조향도 0
STAND_STILL_THRESHOLD = 50                        // |명령| < 50은 0으로 처리
```

풀 조향(1000)일 때 안쪽 바퀴 듀티(업스트림 룩업 테이블로 계산):

| speed | 바깥 | 안쪽 |
| --- | --- | --- |
| 200 | 200 | −109 |
| 300 | 300 | **−120 (최대)** |
| 400 | 400 | −99 |
| 600 | 600 | −17 |
| 1000 | 1000 | +300 |

결론은 네 가지다.

1. 곱셈식이라서 제자리 회전 명령이 존재하지 않는다.
2. 안쪽 바퀴의 역회전 듀티는 최대 12 %인데 이 모터는 ~20 % 아래에서는 움직이지 못한다. 그래서
   안쪽 바퀴는 서서 끌리고, 바깥 바퀴는 200~300으로 기어가는 수준이 된다.
3. expo 때문에 고속에서는 조향 폭 자체가 줄어든다. 사람이 타는 호버보드에 맞춘 튜닝이다.
4. 부저는 `config.h`의 `#define BEEP_BACKWARDS` + `FlagStatus beepsBackwards = SET`으로 컴파일 때 정해진다.
   9바이트 명령 프레임에는 관련 필드가 없어서 ESP32에서 끌 수 없다. `speed < -50`인 쪽이 항상 울리므로
   장착 방향을 바꾸는 트릭도 통하지 않는다.

다음 날(09-18) Jetson 실측이 이 분석과 맞았다. `s +150`, `t +500`에서 마스터 바퀴는 1.11 → 0.24 km/h로
감속만 했다.

#### ESP32 펌웨어 변경 ([src/main.cpp](../../firmware/wheel-controller/src/main.cpp))

| 항목 | 구현 |
| --- | --- |
| 구동 모드 | `MODE_BOARD`(메인보드 믹싱) / `MODE_TANK`. 명령 `v <0\|1>`, 웹 셀렉터 |
| 탱크 믹싱 | `turn = steer × max / 1000`, `left/right = clamp(speed ± turn, ±max)`, 프레임의 steer 필드는 0. 양쪽 다 클램프를 넘지 않음 |
| 링크 B 반전 | `i <0\|1>`, 기본은 반전. 좌우 허브모터가 마주 보고 달려서 같은 듀티면 반대로 돈다. 호버보드 마스터가 슬레이브에 `-pwm`을 보내는 것과 같은 이유 |
| 데드밴드 | `b <n>`, 기본 200. `Deadband()`는 0이 아닌 명령을 `[deadband, max]`로 재매핑하고, 결과는 `max`를 넘지 않으며, `max ≤ deadband`면 자동으로 꺼진다 |
| 설정 저장 | `Preferences`(NVS) 네임스페이스 `wheel`에 `mode`, `invb`, `dead`를 저장. 부팅 때 `Help()`가 출력 |
| 데드맨 | 탱크 모드는 **두 링크가 모두** 살아 있어야 구동한다(한 바퀴만 돌면 제자리에서 돈다). 보드 모드는 기존대로 링크 B 핫조인 |
| 웹 페이지 | `/api/cfg?mode=&invb=&dead=` 추가, 설정 UI 3종, 모드별 안내 문구, CUT 때 이유(`why`) 표시, `/api/status`에 `outA/outB/mode/invb/dead/why` 추가 |
| 리포트 | 시리얼 리포트 끝에 `\| out A B`(실제 전송값)를 붙임. hoverctl.py 정규식은 끝 앵커가 없어서 호환된다 |

#### 코드 리뷰

- 6개 차원(안전 로직 / 프로토콜 / 웹 / 파이썬 도구 / 문서-코드 일치 / 빌드 견고성)을 병렬로 탐색하고,
  발견마다 검증자 3명이 반박을 시도했다.
- 탐색 6개를 마쳤고, 검증 48건을 끝낸 뒤 세션이 끝나 중단됐다.
- 결과: **확정 R1~R12**, **미검증 U1~U11**. 전부 수정 전이다. 목록은 [ISSUES.md](../../firmware/wheel-controller/ISSUES.md)에 있다.
- 가장 무거운 것은 R1(텔레메트리 페이지가 조종자 명령을 살려 둠)과 R2(STOP 뒤 늦게 온 명령이 다시 출발)다.

### 결정

| 선택지 | 내용 | 판단 |
| --- | --- | --- |
| 보드 믹싱 유지 | 지금 그대로 | 조향을 개선할 수 없음 |
| **ESP32 탱크 믹싱** | 링크 A = 왼쪽, 링크 B = 오른쪽, ESP32가 `left = s + t`, `right = s − t` | **채택**: ESP32만 고치면 됨 |
| 메인보드 재빌드 | 믹싱과 부저 수정 | 툴체인과 재플래시가 필요해서 나중으로 미룸(→ 09-22) |
| UARTBUS | 메인보드 4장에 독립 주소 지정 | 4장 재플래시 + 새 프로토콜이라 장기 과제 |

함께 정한 것: 명령 200 미만에서 안 움직이는 구간은 **데드밴드 재매핑**으로 건너뛴다. 램프는 명령
공간에서 그대로 돌리고, 0에서 나오는 첫 틱만 움직일 수 있는 듀티로 점프한다.

### 확인한 것

- 오프라인 시뮬레이션(파이썬으로 C 로직 재현): `max 400, dead 200`일 때 `(20,0)→210/−210`,
  `(0,1000)→400/400`, `(400,1000)→400/0`. 클램프를 낮춘 직후 `600→400`. `max ≤ dead`면 원래 값이 그대로 통과.
- 실기 시리얼: `v 0`/`b 250`/`i 0` → 리셋 후에도 `mode board | link B normal | deadband 250` 유지 확인 → 기본값 복원
- 웹 페이지: 임베디드 HTML을 추출해 stub API로 브라우저에서 렌더링했다. 조향 버튼만 누르면
  `/api/cmd?s=0&t=750`, 떼면 `t=0`, 설정 3종은 `/api/cfg?...`를 호출했다. 콘솔 오류는 없었다.
- `tools/test_stop.py` PASS(양방향 단언 유지)
- 빌드: Flash 61.6 %(806,889 B). COM10에 플래시했다.

---

## 2026-09-17 (목) · 상위 제어: 전방 장애물 가드

> 시간: 15:47 ~ 16:38 · 장소: RDK 보드 "sunrise" · 날짜 근거: 타 머신 · 관련 이슈: N1, N3, U1, R7 · 원본: 바퀴 제어기 작업 일지 `firmware/wheel-controller/WORKLOG.md`

이 펌웨어는 "호버보드 부품으로 만든 4륜 자율주행 차량"의 바퀴 제어 계층이다. 위 계층은 다른 머신에서
작업했고, 그쪽에서 이 펌웨어에 대해 찾아낸 것을 여기 옮긴다.

```
Xtion ──depth 30fps──► guard.py (ObstacleDetector → Debouncer) ──USB serial 115200──► LOLIN D32 ──UART──► 호버보드
```

### 한 일

- `obstacle.py`: ROI 그리드 깊이 판정(CLEAR/SLOW/STOP/BLIND), 바닥 제거
- `hoverlink.py`: 포트 자동 탐색, 텔레메트리 파싱, `w 1` + 250 ms마다 `h`
- `guard.py`: STOP → `x x` + `m 0`, SLOW → `m 150`, CLEAR → `m 400`. 1 s마다 재전송, 링크가 끊기면 재접속
- ESP32를 `/dev/ttyUSB0`에 물려 끝에서 끝까지 동작을 확인했다(호버보드 전원은 끈 상태).

### 결정

- 인터록에 `m 0`을 쓰는 이유: 펌웨어는 마지막에 쓴 쪽이 이기므로(last-writer-wins) `x`만 보내면 폰
  페이지가 다시 출발시킨다(R7). 대신 STOP 중에는 후진도 막히므로 전진만 막는 인터록 `o <n>`이
  필요하다는 요구가 나왔다(N3).
- Xtion은 ~50 cm 이내에서는 깊이가 0이다. 유효 픽셀이 10 % 미만이면 BLIND로 보고 STOP으로 처리한다.

### 발견한 문제

#### 이 펌웨어에 대해

1. 포트를 `dtr=False`로 열면 ESP32가 리셋된다(Linux에서 확인). hoverctl.py의 열기 순서와 같은 문제다(U1).
2. **CH340이 포트를 열 때 흘리는 잡음 바이트가 라인 버퍼에 남아 `1x` → `atoi` → `speed 1`이 되고,
   데드밴드 재매핑 때문에 바퀴가 실제로 20 % 듀티로 움직인다(N1).** 그쪽은 `stop()`이 `x\nx\n`을
   한 번에 보내도록 우회했다. 근본 해결은 펌웨어에서 해야 한다.
3. 다음 단계로 합의한 것: 콘솔 강건화(비출력 문자 무시, 개행 없이 오래 남은 부분 라인 폐기, 맨 숫자 =
   속도 단축 제거), `o <n>` 전진 전용 인터록(가드 하트비트가 끊기면 해제), RDK에 PlatformIO를 설치해
   거기서 플래시

---

## 2026-09-18 (금) · 상위 제어: 초파리 전뇌 폐루프 주행

> 시간: 14:12 ~ 17:24 · 장소: Jetson Orin Nano "dongki" · 날짜 근거: 타 머신 · 관련 이슈: N2, N4, H3 · 원본: 바퀴 제어기 작업 일지 `firmware/wheel-controller/WORKLOG.md`

### 한 일

- 저장소를 Jetson(`~/Study/lolind32-wheel`)에 복사했다. L4T 36.4.7 커널에 `ch341.ko`가 없어서 소스에서
  빌드해 설치했고, `brltty`가 CH340을 점자 장치로 가로채서 제거했다.
- `fly/hover_link.py` `HoverLink`: 시리얼 콘솔 명령을 감싼 `drive(v, ω)`(+v 전진, +ω 좌회전, ROS 규약).
  텔레메트리 파서는 실제 printf 포맷으로 단위 점검했다. `scripts/hover_test.py`로 바퀴를 띄우고 시험했다.
- 웹 UI(FastAPI MJPEG + WebSocket + three.js 3D 뇌, 주행 시작 버튼, 비상정지, UI가 2 s 끊기면 자동 정지)를 만들었다.
- 마칠 때 모든 프로세스를 종료하고 워치독이 꺼졌는지 확인했다.

### 확인한 것

#### 보드 모드

- `s +150` → 마스터 바퀴 +1.11 km/h, 와이어에는 듀티 212가 나갔다(데드밴드 동작).
- `t +500` → 0.24 km/h로 감속(+조향은 마스터 쪽이 안쪽 바퀴). `t −500` → 속도 유지. 09-17 분석과 맞는다.
- 슬레이브 텔레메트리가 0이어서 배선 문제를 찾아 고쳤고, 그 뒤 **네 바퀴가 모두 도는 것을 확인했다.**
- **마일스톤: 초파리 전뇌 시뮬레이션 폐루프 주행**(바퀴는 띄운 상태). Xtion RGB-D → 시엽 계산모델 →
  FlyWire LIF 전뇌(CuPy, Eon 백엔드 대비 r = 0.99, 52배 빠름) → 하행뉴런 좌/우 발화율 → ω(v = 0.3 고정)
  → `drive(v, ω)` → D32. 다가오는 물체에는 회피 회전, 새 광원에는 접근 회전하는 것이 바퀴 속도로
  확인됐다. ω +0.9일 때 좌 0~−0.3 km/h, 우 +0.95 km/h. **반응 지연 ~0.5 s = 펌웨어 조향 램프 + 5 Hz 루프.**

### 발견한 문제

#### 이 펌웨어에 대해

1. Jetson 프로세스를 TERM/KILL로 죽이면 D32의 호스트 워치독이 켜진 채로 남아 **폰 조작이 막힌다**.
   `w 0`을 따로 보내야 했다(N2, U11).
2. 조향 응답이 ~0.5 s다. `STEER_RAMP_PER_TICK`(풀 조향까지 1 s)이 상위 제어 루프에 그대로 지연으로 보인다(N4).
3. 메인보드가 몇 분 유휴하면 스스로 꺼져서 세션이 끊긴다. 알려진 특성이다(`INACTIVITY_TIMEOUT 8`).
4. 그쪽 메모에는 "텔레메트리 L = 우측 바퀴"라고 적혀 있다. README의 "마스터 = 왼쪽 바퀴"와 맞지 않으므로
   재플래시 때 실측으로 정리해야 한다(H3).

---

## 2026-09-22 (화) · 바퀴 제어: 기본 모드 변경, 하드웨어 구성 정리, 메인보드 커스텀 빌드

> 장소: PC · 날짜 근거: 파일 시각(`main.cpp` 10:04, `README.md` 10:06, 이 일지 첫 버전 10:25), 세션 · 커밋: 2026-10-13 `453ab93` · 관련 이슈: H1, H2, H3 · 원본: 바퀴 제어기 작업 일지 `firmware/wheel-controller/WORKLOG.md`

### 한 일

#### 기본 구동 모드를 보드로 변경

- 처음엔 기본값을 탱크로 두었다가, 하드웨어가 축 단위(앞 쌍 / 뒤 쌍)로 묶여 있음을 확인하고 **보드
  모드로 바꿔 플래시했다**. 재배선 전에는 탱크 모드가 구동을 거부하므로, 기본값이 탱크면 함정이 된다.

#### 하드웨어 구성 논의, 핵심 통찰

**슬레이브는 마스터와 반대 부호를 받는다**(`SendSlave(-pwmSlave)`). 호버보드는 두 바퀴가 마주
보게(거울상) 달려 있어서, 반대 부호가 곧 "같은 진행 방향"이다. 모터는 "전진"을 모르고 자기 기준의
회전 방향만 안다는 점을 시계에 비유해 설명했다.

| 슬레이브 위치 | 결과 |
| --- | --- |
| 마스터 건너편 (축 쌍) | 같이 전진 ✅ (현재 구성) |
| 마스터와 같은 편 (좌/우 라인) | 슬레이브가 후진 ❌ |

그래서 케이블만 바꿔서 좌/우 라인으로 묶는 것은 **불가능**하다. 정리한 선택지:

| | 작업 | 비고 |
| --- | --- | --- |
| A. 2륜 탱크 | 슬레이브 케이블 분리, 뒤 축 모터 케이블 맞바꿈(뒤왼 마스터가 뒤오른 모터를 구동), 링크 B 배선, `v 1` | 케이블만 바꾸면 됨. 대각선 2륜(앞왼 + 뒤오른) |
| B. 4륜 탱크 (모터 개조) | A + 라인마다 슬레이브 모터 하나를 상선 2개 + 같은 색 홀선 2개를 맞바꿔 역회전 | 홀 커넥터가 몰딩이라 핀만 바꿀 수 없음 → 선을 자르고 교차하거나 연장 케이블이 필요. 절단은 부담스러워서 보류 |
| C. 메인보드 펌웨어 | 마스터에서 부호 반전 제거 | **채택 예정** (한 일 3) |
| D. UARTBUS | 메인보드 4장 독립 | 장기 과제 |

임시 운용: 보드 모드(`v 0`)로 두고 **뒤 마스터를 링크 B(GPIO26/27/GND)에 연결**하면 4륜 구동은
되지만 조향은 지금 수준 그대로다. 그나마 잘 도는 조건은 속도 500~600 + 풀 조향(안쪽 바퀴 ≈ 0,
바깥 60 %)이다.

#### 메인보드 펌웨어 커스텀 빌드

업스트림(`-GD32` 저장소)을 이 PC에서 빌드해, 마스터가 슬레이브에 부호를 뒤집어 보내지 않게 하는 커스텀 빌드를
만들었다. 같은 쪽 앞 · 뒤 바퀴를 한 짝으로 묶어 탱크 4륜으로 쓰려는 계획이었다(이 계획은 2026-10-13에
[ADR 0001](../decisions/0001-wheel-board-pairing.md)로 바뀌었다). 산출물은 세션 임시 폴더에만 두었다가 나중에 사라졌다(H1).

메인보드 펌웨어는 GPL-3.0 업스트림을 고친 것이라, 2026-10-13부터 빌드 설정 · 패치 · 기록을 저장소 밖(로컬)에서
관리한다. 이 절의 원래 내용(설정 표, 패치, 재배선 계획)도 그리로 옮겼다.

#### 이 일지의 첫 버전 작성

- 주제별 번호(§1~§9, A~C) 구조로 썼다. 2026-10-13에 날짜별 일지로 다시 짰다.

### 참고

#### 기록 공백

- 세션 기록은 14:42까지 갱신됐지만, 이 일지는 10:25에 마지막으로 수정됐다. 10:25 이후에 한 작업은
  여기에 남아 있지 않다.
