chungddong/NUBI/firmware/wheel-controller/ISSUES.md

# 이슈 목록 (ISSUES)

아직 열려 있는 문제와 할 일을 모아 둔다. 각 문제가 언제, 어떻게 드러났는지는
[작업 일지](../../docs/worklog/README.md)의 해당 날짜 항목에 있다.

- 번호 체계: **N** = 현장에서 드러난 것, **H** = 하드웨어·빌드물, **R** = 코드 리뷰에서 확정된 것,
  **U** = 코드 리뷰에서 나왔지만 아직 검증하지 않은 것
- 고치면 상태 칸을 `수정 (YYYY-MM-DD, 커밋)`으로 바꾸고, 그날 일지에도 한 줄 남긴다.
- **마지막 점검: 2026-10-13** — 아래는 R12·U10 일부(누비 통합 때 정리), N1, H1~H3을 빼면 전부 미수정이다.
  2026-10-13에 `src/main.cpp`를 바퀴 모드로 바꾸고([ADR 0001](../../docs/decisions/0001-wheel-board-pairing.md))
  ESP32와 메인보드 4장을 모두 올렸다. 바퀴를 띄운 시험은 통과, 바닥 주행은 전이다.

## 다음에 할 일 (우선순위)

0. **H6**: 프레임 코드를 직접 작성한 빌드(`include/hover_protocol.h`, 2026-10-13)를 ESP32에 올리고, 텔레메트리
   프레임 수가 늘어나는지(`wheelbench --selftest 5`)와 바퀴가 명령대로 도는지 확인한다.
1. **바닥 주행 시험**: 전진, 제자리 회전, 데드밴드 `b` 튜닝(바닥에서 잰 값은 약 200, 지금 저장값 100). 결과로
   D-03과 ADR 0001을 갱신하고, 보드당 전류 제한(D-03은 7 A)을 정한다. 메인보드 쪽 반영은 저장소 밖(로컬)에서 한다.
2. **R5**(버튼을 떼면 램프로 감속)과 **R1**(텔레메트리만 보는 두 번째 페이지가 조종자 워치독을 살려 둠)은 바닥 주행에서
   바로 체감되므로 리뷰 수정 중 먼저 한다.
3. 리뷰 수정 순서: R1·R2·U3(웹 정지 무결성: 조종자 식별 + 시퀀스 번호 + 0도 재전송) → R5(손 떼면
   즉시 정지) → N2(워치독 해제 경로) → R6(진단 후 시각 스탬프) → R3·U1(도구 워치독·포트 열기)
   → 문서(R10·R11·R12)
4. 상위 프로젝트의 요청: **N3**(전진 전용 인터록 `o <n>`), **N4**(ESP32 믹싱의 조향 램프 재검토)

## 현장에서 드러난 문제 (N)

| # | 심각도 | 발견 | 위치 | 내용 | 상태 |
| --- | --- | --- | --- | --- | --- |
| N1 | **HIGH** | 2026-09-17 RDK | `main.cpp` `HandleLine` + `Deadband` | 포트를 열 때 들어오는 잡음 바이트가 맨 숫자 단축(`atoi`)을 거쳐 `speed 1`이 되고, **데드밴드가 그 값을 20 % 듀티로 키운다**. 2026-09-17에 넣은 데드밴드가 잠재 버그를 실제 움직임으로 바꿨다. 대책: 비출력 문자 무시, 부분 라인 폐기, 맨 숫자 단축 제거. 그리고/또는 `\|명령\| < 50`을 0으로 처리(메인보드의 `STAND_STILL_THRESHOLD`와 같은 규칙) | 코드 수정 (2026-10-13, 커밋 전 · ESP32에 올리기 전). 비출력 바이트 무시(워치독도 안 먹임), 넘친 줄은 통째로 버림, 맨 숫자 단축 제거, 시리얼 · 웹 모두 `\|s\|` · `\|t\|` < 50 → 0. 출력 가능한 잡음이 첫 명령 앞에 붙으면 그 명령이 "unknown"으로 무시될 뿐 바퀴는 움직이지 않는다. 2026-10-13 ESP32에 올림(커밋 전) |
| N2 | MED | 2026-09-18 Jetson | `main.cpp` 호스트 워치독 | 호스트가 비정상 종료(TERM/KILL)하면 워치독이 켜진 채 남아 웹 명령이 조용히 무시된다. 그날은 `w 0`을 따로 보내서 풀었다. 웹 명령을 새 조종자로 보고 `w 0`처럼 처리하거나 `/api/status`에 `hostLost`를 노출해야 한다 | 열림 |
| N3 | LOW | 2026-09-17 RDK | 설계 | 전진 전용 인터록 `o <n>`이 필요하다. 가드가 정지시킨 뒤에도 후진으로는 빠져나올 수 있어야 하고, 가드 하트비트가 끊기면 해제돼야 한다 | 열림 |
| N4 | LOW | 2026-09-18 Jetson | `STEER_RAMP_PER_TICK` | 조향 램프(풀 조향까지 1 s)가 상위 제어 루프에 ~0.5 s 지연으로 나타난다. ESP32가 믹싱하는 바퀴 모드(2026-10-13~)에서는 램프를 다시 볼 여지가 있다 | 열림 |

## 하드웨어·빌드물 (H)

| # | 심각도 | 발견 | 내용 | 상태 |
| --- | --- | --- | --- | --- |
| H1 | — | 2026-10-13 | 메인보드 커스텀 빌드물 소실 | 메인보드 쪽으로 옮김 — 메인보드 펌웨어는 2026-10-13부터 저장소 밖(로컬)에서 관리한다. 같은 날 다시 빌드해 네 장에 올렸다 |
| H2 | — | 2026-09-17 | 메인보드 재플래시 대기 | 수정 (2026-10-13). 네 장 모두 올림. 굽기 절차와 원래 펌웨어 백업은 로컬 기록 |
| H3 | LOW | 2026-09-18 | 텔레메트리 L/R이 실제 어느 바퀴인지 불확실하다. Jetson 쪽 메모에는 "L = 우측 바퀴", README에는 "마스터 = 왼쪽 바퀴"라고 되어 있다. 재플래시 때 실측으로 정리한다 | 해결 (2026-10-13). L = 마스터 바퀴이고, 마스터는 앞뒤 모두 **오른쪽** 바퀴다(Jetson 메모가 맞았음). ESP32 NVS에 `i 1`(좌우 바꿈) 저장 |
| H4 | — | 2026-10-13 | 메인보드 굽기 때 SWD 접촉 불안정 | 메인보드 쪽으로 옮김 — 메인보드 펌웨어는 2026-10-13부터 저장소 밖(로컬)에서 관리한다 |
| H6 | MED | 2026-10-13 | GPL-3.0 예제 헤더(`hoverserial.h` · `util.h`)를 직접 작성한 `include/hover_protocol.h`로 바꿨다. 프레임 크기 · 필드 위치 · CRC 검사값은 컴파일 때 확인했지만 실기 통신은 아직 확인하지 않았다. 받는 쪽은 CRC가 틀린 프레임 뒤에도 계속 읽도록 조금 달라졌다 | 열림 (빌드 통과, 실기 확인 전) |
| H5 | LOW | 2026-10-13 | ESP32 AP `hoverwheel`이 PC Wi-Fi 검색에 한 번 안 보였다가 ESP32 재시작 뒤 보였다(WPA2, 1번 채널, 신호 100 %). 검색 타이밍인지 AP가 실제로 꺼졌는지 모른다. 다시 보이면 `WiFi.softAPgetStationNum()`과 AP 상태를 리포트에 넣어 확인한다 | 열림 |

## 코드 리뷰 2026-09-17: 확정 (R)

6개 차원(안전 로직, 프로토콜, 웹, 파이썬 도구, 문서-코드 일치, 빌드 견고성)을 병렬로 탐색하고,
발견마다 검증자 3명이 반박을 시도했다. 아래는 3명 모두 통과한 것이다. 자세한 경위는
[2026-09-17 일지](../../docs/worklog/2026-09.md#2026-09-17-목--바퀴-제어-탱크-구동-데드밴드-nvs-설정--업스트림-분석--코드-리뷰)에 있다.

| # | 심각도 | 위치 | 내용 | 상태 |
| --- | --- | --- | --- | --- |
| R1 | **HIGH** | `main.cpp` 웹 워치독 | `iLastWebAt`가 클라이언트를 구분하지 않는 전역 변수라서 **텔레메트리만 보는 두 번째 페이지가 조종자의 명령을 살려 둔다**. 조종 폰이 범위를 벗어나도 `web client lost`가 뜨지 않는다 | 열림 |
| R2 | **HIGH** | `main.cpp` `/api/cmd` | 시퀀스 번호도 정지 래치도 없다. `/api/stop` 뒤에 **늦게 도착한 `/api/cmd?s=200`이 바퀴를 다시 돌린다**(fetch마다 새 TCP 연결이라 SYN 재전송 순서가 보장되지 않음) | 열림 |
| R3 | HIGH | `speedsweep.py` | 100 % 듀티까지 올리면서 **호스트 워치독(`w 1`)을 켜지 않는다**. 창이 닫히거나 케이블이 빠지면 마지막 명령이 그대로 유지된다 | 열림 |
| R4 | MED(→HIGH 의견) | 웹 STOP | `/api/stop`은 한 번만 보내고 재시도하지 않는다. 0 명령은 리피터가 재전송하지 않는데 ping은 워치독을 계속 먹인다 | 열림 |
| R5 | MED(→HIGH 의견) | 웹 버튼 해제 | 스로틀 버튼을 떼면 `/api/cmd?s=0`이 가서 **램프로 감속**한다(클램프 1000이면 5 s). GUI는 즉시 0으로 떨어지는데 웹은 그렇지 않다 | 열림 |
| R6 | MED | `main.cpp` 진단 `d`/`y`/`r` | 블로킹 진단 뒤 `iLastRxAt = millis()`로 시각을 찍는다. 같은 `loop()`의 오래된 `iNow`와 unsigned 뺄셈을 하면서 값이 랩되어 **진단이 끝날 때마다 가짜 STOP이 3번 연달아 나고** 웹 워치독도 풀린다. README가 금지한 바로 그 패턴이다 | 열림 |
| R7 | MED | 시리얼 `x` vs 웹 리피터 | 웹 버튼을 누르고 있는 동안에는 시리얼 `x`가 300 ms 안에 리피터에 덮여서 바퀴가 다시 돈다. 2026-09-17 RDK 가드가 `m 0`을 같이 보내는 이유가 이것이다 | 열림 |
| R8 | LOW(→MED) | `main.cpp` millis 랩 | `iNow > QUIET_MS`를 절대값으로 비교해서 49.7일 뒤에 명령이 2 s 끊기고 데드맨이 평가되지 않는다. `iNextSend`가 랩되기 직전에는 루프마다 전송한다 | 열림 |
| R9 | LOW | `hoverctl.cmd` | `pythonw.exe`로 실행해서 **오류 메시지와 `--selftest` 결과가 전부 사라진다**. [링크 디버깅 기록](../../docs/worklog/topics/wheel-link-debugging.md)이 고쳤다고 한 "cryptic failure"가 다시 생긴다 | 열림 (10-13 재확인) |
| R10 | LOW | 문서 | README에는 `COM20`, `platformio.ini`에는 `COM10`이다. 복구 명령은 존재하지 않는 `.venv\Scripts\esptool.exe`를 가리킨다 | 열림 (10-13 재확인: README 35·170·448행) |
| R11 | MED | 문서 | README는 웹 페이지에 "슬라이더 레이트리미터, pending drop, stopped 래치"가 있다고 쓰지만, 페이지는 버튼식이라 그런 코드가 없다 | 열림 |
| R12 | LOW | 문서/저장소 | `tools/__pycache__/*.pyc`가 git에 추적되고 있다(테스트를 돌릴 때마다 바뀜). README는 "Four guards"인데 실제로는 5개다. 도구표의 speedsweep 기본 `--max`는 600이다. GUI 조향 슬라이더가 속도 클램프에 묶여 있어 README와 맞지 않는다. "Going to four motors" 절이 낡았다 | 일부 수정 (2026-10-13 누비 통합 때 pyc 추적 해제). 나머지 열림 |

## 코드 리뷰 2026-09-17: 미검증 (U)

탐색만 마쳤고, 반박 검증 전에 세션이 끝났다.

| # | 심각도 | 위치 | 내용 | 상태 |
| --- | --- | --- | --- | --- |
| U1 | HIGH | `hoverctl.py` 포트 열기 | `open()` 다음에 `dtr=False` → `rts=False` 순서로 설정하면 **ESP32가 리셋되고**, 부팅 중에 보낸 `w 1`이 버려진다. 그런데 GUI는 무조건 "watchdog armed"라고 표시한다. **2026-09-17 RDK(Linux)에서 리셋 현상을 실기로 확인했다** | 열림 |
| U2 | HIGH | `hoverctl.py` 키 바인딩 | max 스핀박스에 포커스가 있어도 루트 바인딩이 살아 있어서 ↑↓가 속도까지 바꾸고, `0`을 입력하면 STOP이 된다 | 열림 |
| U3 | HIGH | 웹 리피터 | 버튼 해제(0)는 한 번만 보낸다. 순서가 뒤바뀐 늦은 `s=200`이 손을 뗀 뒤에 다시 적용된다(R2와 같은 뿌리) | 열림 |
| U4 | MED | `hoverctl.py` `flush_throttled` | 이미 보낸 값을 하트비트마다 다시 보내서, 펌웨어 쪽 STOP(데드맨 등)을 250 ms 안에 되돌린다 | 열림 |
| U5 | MED | `speedsweep.py` | 보드가 중간에 꺼지면 멈춘 텔레메트리를 측정값으로 기록해서 가짜 Kv가 나온다 | 열림 |
| U6 | MED | `test_stop.py` | `App.stop()`을 거치지 않고 Link만 시험한다. 래치와 하트비트 가드는 검증되지 않는다 | 열림 |
| U7 | MED | `main.cpp` 진단 `d` 1단계 | UART2 TX를 GPIO16(보드 TX가 구동 중)에 연결해서 1.5 s 동안 **푸시풀 출력끼리 충돌한다** | 열림 |
| U8 | MED | `main.cpp` `send_P` | 6.8 KB 페이지 전송이 `loop()`를 최대 몇 초 막는다. 그동안 명령 틱과 워치독이 멈춘다 | 열림 |
| U9 | MED | 웹 키보드 | `blur`/`visibilitychange` 때 키를 해제하지 않아서, 키를 누른 채 포커스를 잃으면 계속 주행한다 | 열림 |
| U10 | MED | 빌드 | `platformio.ini`에 기기마다 다른 COM 포트가 커밋돼 있다. `.venv` 부트스트랩과 requirements 파일이 없고, 플랫폼 버전도 고정되지 않았다 | 일부 수정 (2026-10-13 누비 통합 때 `requirements.txt`와 README의 venv 생성 절차 추가). COM 포트, 플랫폼 버전 고정은 열림 |
| U11 | LOW | 기타 | rx 카운터가 리셋되면 링크 미터가 멈춤. 지터 때문에 가짜 DROPOUTS가 뜸. `ledtest.py`가 포트 사용 중 오류를 처리하지 않음. STOP이 `click`(손 뗄 때)에 반응하고 `touch-action`이 없음. fetch 타임아웃이 없어 링크 표시가 1분간 멈춤. `localStorage` 예외를 처리하지 않음. 호스트 워치독이 트립되면 웹 명령이 조용히 무시됨(**2026-09-18 Jetson에서 실제로 겪음**, N2). 진단 뒤 루프가 멈추면 가짜 컷이 남 | 열림 |
