chungddong/NUBI/docs/worklog/topics/vehicle-2026-09-15-decisions.md

# 차체 설계 결정 정리 — 무엇을 왜 골랐나 (2026-07 ~ 09)

> 영역: 차체 · 작성: 2026-09-15 · 원본: 차체 설계 일지 `synth_decisions.html` (2026-10-13 Markdown으로 옮김)

2026-07-27 저녁부터 09-10 까지, 알루미늄 3030 프로파일 모빌리티 테스트 베이스(호버보드 인휠 허브모터 4륜 스키드, 외장셸, 적재함, 휠 클램프 Design D, FEA, 액슬 타이, BOM)를 만들며 내린 설계 결정을 시간순으로 모았다. 출처는 세션 대화록을 21개 구간으로 나눠 쓴 일지(entry_01a \~ entry_16)이고, 같은 결정이 여러 구간에 걸쳐 되풀이된 것은 한 줄로 합쳤다. 08-15 \~ 08-20 은 Claude 세션 밖(GPT/Codex)이라 대화록이 없고, 인수인계 문서와 파일 mtime 으로만 확인했다(5장). 시각은 전부 한국시간(KST, UTC+9)이다. 표의 마지막 열 "나중에 뒤집혔나"는 이 문서를 쓰는 2026-09-15 시점의 저장소(`models/swerve_base.py`, `models/hoverboard_mount/parameters.py`, `docs/bom.md` 등)와 대조한 결과이며, 뒤집힌 경우 이유를 한 줄로 적었다.

이 표의 분류로 세면 결정 54건 가운데 통째로 뒤집힌 것이 15건, 일부만 바뀐 것이 8건, 아직 확정되지 않은 것이 1건, 그대로 유지된 것이 30건이다. 뒤집은 쪽은 대체로 셋 중 하나였다 — 실물(STEP 실측, 출력품 파손, 가진 볼트 길이), 사용자의 한 줄 제안, 그리고 근거 없이 넣어 두었던 상수의 정정. 분류는 판단이 섞인 것이라 경계에 있는 항목이 있다.

## 뒤집힌 결정의 사슬

표를 읽기 전에, 여러 번 뒤집힌 항목을 사슬로 먼저 적는다. 화살표 하나가 결정 한 번이다.

1. **구동·조향**: 4륜 스키드 + 8인치 허브모터 목업(07-27 18:27) → 허브모터 배제, PVC 통바퀴 + 데드 액슬 + 벨트(07-27 21:25) → 호버보드 인휠 허브모터(07-28 01:03) → 스워브 독립 조향(07-28 17:25) → 4륜 고정 스키드 복귀(08-01 01:44). 결국 처음 자리로 돌아왔고, 모터만 호버보드 6.5인치로 바뀌었다.
2. **휠 마운트**: 8t 판 2장 + 축 너트 예압(08-01) → 나사가 없어 U판 + 축캡 + 브리지 블록(08-02) → 3030 휠포스트 69.3 mm + 기존 클램프(08-05) → ㄷ자 휠마운트(08-07) → 실물 파손(08-12) → 거싯 6장 / 하단 클램프·3면 대안(08-12\~13) → Design A/B → C → D → 통짜 D(08-14\~15) → 옆 플랜지 제거(08-21).
3. **액슬 타이**: 없음 → 평철 20×6(08-21 01:43) → M8 전산볼트 ×2(01:55) → 길이 400 고정(07:57) → 여분 3030 을 360 으로 잘라 코너 브래킷(08-27 01:56) → 390 그대로 쓰려면 클램프 깊이 30 + X 오프셋 25(02:42, 미결).
4. **적재함**: 2020 프레임 + 판재(07-29 18:20) → 810×610 R60 프린트 셸 높이 450(20:23) → 360, 어깨 R55, 라이너(07-30 00:39) → 280, 유로 컨테이너 600×400(08-10 01:52) → 400×300 을 뒤로, 앞은 장비 베이(20:38) → 뚜껑 522×350(08-11 01:30) → 판재 전환 대안(09-10, 미확정).
5. **서스펜션**: 로커 접음(07-27) → 트레일링 암 + 코일오버(07-28 23:07) → 없음(08-01) → 우레탄 패드 아니면 트레일링 암, 미룸(08-21 01:04).
6. **축간거리**: 500 → 400(07-27 22:57) → 520(07-28 18:52) → 420(08-01 01:44). 윤거 520 은 한 번도 안 바뀌었다.
7. **냉각**: 측면 슬롯(07-27 20:58 1차) → 앞면 LED 아래(같은 날) → 옆→뒤(07-29 11:03).

63_why_tipping_moment

## 1. 07-27 \~ 07-28 새벽 — 초기 구성 (models/mobility_base.py)

> 실외 실내 테스트용 모빌리티 베이스를 만들어보려 하거든? 적당히 커야하는데 그 바퀴를 달 하부 프레임을 짜려고 해

| 날짜 | 결정 | 이유 | 버린 대안 | 나중에 뒤집혔나 |
| --- | --- | --- | --- | --- |
| 07-27 18:11 | 프로파일은 3030(연습 프레임만 2020). 단면은 T홈을 "빼기"가 아니라 튜브 + 코너 기둥 4 + 중심 보스 + 45° 리브 4 를 "쌓기"로 그린다. | 슬롯 4개를 파내면 코너 기둥이 섬으로 남아 빔 하나가 솔리드 5개(33.79 mm² ×4 + 56.71 mm²)로 갈라졌다. 쌓기로 바꾸자 2020/3030/4040 모두 솔리드 1개, 단면 187.59 / 384.10 / 821.34 mm². | 사각형에서 T홈 4개 빼기 | 아니다. 08-14 4080/3060 전제로 짠 `hoverboard_mount` 패키지도 "우리 프로파일은 3030인데"(08-14 17:27)로 3030 으로 돌아왔다. 그 패키지의 3030 참조 단면이 ±Z 면에 슬롯이 없어 검증을 통과시키던 오류는 08-15 12:51 에 잡았다. |
| 07-27 18:27 / 22:39 / 07-28 00:11 | 구동 구성은 4륜 스키드 스티어. 제자리 회전 가능, 바닥 긁힘 감수(사용자 결정). | 다목적 테스트베드(실내·실외·적재함·로봇팔)라 복도 U턴이 필요하고 캐스터는 문턱·자갈에 걸린다. 4륜구동은 회전 시 바깥 바퀴가 추진 + 차동(3.61 N·m)을 받아 바퀴당 토크는 2륜 + 캐스터(2.06)보다 크지만 구성이 단순하다. | 차동 2륜 + 캐스터(문턱·자갈), 메카넘(비포장 불가), 로커 서스펜션(복잡·중량), 2륜 구동 + 고정 2륜(회전 7.22 N·m), 아커만 앞조향(07-28 00:00 — U턴 폭 1.8\~2.3 m, 조향 공간 49 mm 부족) | 한 번 뒤집혔다가 돌아왔다. 07-28 17:25 스워브(독립 조향)로 틀었고, 08-01 01:44 "일단 스프링없고 스워브 드라이브도 아닌 버전부터"로 4륜 스키드 복귀. 현재 `DRIVE=skid` 기본. |
| 07-27 19:03 / 19:45 | 차체는 2층 — 1층 사다리 프레임, 그 위 전장 베이(높이 140, 배터리 260×170×90 이 정함), 데크. 상부 프레임은 하부와 같은 700×500. 커버는 데크 아랫면까지 닫고 그림자 틈 5 mm 는 수식(`DECK_L = 2·SKIRT_X + 2·DECK_LIP`)으로 고정. 라운드 커버가 사각 프레임 코너를 파고드는 것은 `FRAME_CLR` 컷 + assert. | 바퀴 꼭대기(200)가 데크(155)보다 45 mm 높았다. 상부 프레임 690×580 은 밖에서 보여 거슬렸다(사용자). 줄이자 커버 윗단 30 mm 개방 문제가 같이 사라졌다. 코너 간섭 835.4 mm³ 는 직선부가 아니라 라운드 구간에서만 났다. | 상부 프레임 690×580 유지(커버가 프레임을 가로지름), 데크 폭 710 유지(105 mm 캔틸레버) | 형태는 유지됐다. 07-28 18:52 `swerve_base.py` 로 옮기며 프레임 760×450, 셸 810×610 R60 이 됐고 코너 규칙은 "셸은 프레임보다 0.293R 크게" assert 로 일반화됐다(현재 파일 485\~487행). |
| 07-27 20:04 | 측면 커버 분할을 좌/우 → 앞/뒤. 후면 비상정지(Ø22.3, z=272)는 포트 도어 밖, 커넥터 6종은 별도 판 없이 2 mm 커버판에 직접. | 좌/우 분할이면 분할선이 후면 한가운데를 지나 중앙 배치가 안 된다. 비상정지는 항상 눌러야 하니 도어 밖. z=272 는 몸체 뒤끝이 상부 크로스멤버(z=298)에 닿지 않는 최대치. | 좌/우 분할 유지, 커넥터용 별도 판 | 분할은 유지(07-29 11:03 "앞뒤 2분할은 출력 크기가 아니라 조립 때문"으로 재확인). 커넥터는 07-29 01:35 사용자 요구("내부로 조금 들어가있느 형태")로 20 mm 들어간 포트 베이 220×95 의 뒷벽에 무는 방식으로 바뀌었다. 비상정지 Ø22 는 그대로. |
| 07-27 20:58 | 흡기는 앞면 LED 아래 슬롯 60×6 ×5, 배기는 후면 80 mm 팬 2개. | 처음 잡은 측면 슬롯이 앞바퀴 바로 옆이라 흙탕물을 정통으로 맞는 자리였다 — 숫자 검사는 통과했고 렌더로만 보였다. 앞면 입 아래 그릴이면 얼굴도 안 깨진다. | 측면 흡기 슬롯 70×6 ×6 | 뒤집혔다. 07-29 11:03 베이를 채우다 앞면 그릴 z=266 이 바닥판 z=281 보다 낮아 모듈실만 식히고 있었다는 것을 알았다. 냉각은 옆→뒤(측면 루버 6/면 + 후면 60 mm 팬 2, y=±160)로 바뀌었고 앞면 그릴은 모듈실용으로 남겼다. |
| 07-27 21:25 \~ 23:11 | 허브모터 배제(비용). PVC 통바퀴 Ø210×58 + Ø20 데드 액슬 + 6204 베어링, 체인/벨트 구동. 요구 토크는 μ=0.5(PVC)·안전율 2·동작점별로 다시 계산해 "모터 30 W 면 충분, 100 W 는 3배 과함". | 사용자 지정("모터 하나당 5만원 이하"). 처음 μ=0.8(고무 값)과 최대 토크 × 최고 속도로 출력을 부풀렸던 것을 "진짜 저정도 사양이 필요 한거야?"로 정정했다(제자리회전 4.13 → 2.58 N·m). | IG-52GM(26만원), JGB37(토크 부족), MY1016Z(공간 불가), DDSM315/210/400(다이렉트 드라이브라 토크 1/8\~1/33), PG45-775(30 W 면 0.5 m/s 상한) | 뒤집혔다. 07-28 01:03 "전동휠 제품에 들어가는 것도 이런 인휠모터 아닌가?"로 호버보드 허브모터로 갔다 — 국내 정품 허브모터의 29% 값에 벨트·풀리·액슬·감속기·별도 컨트롤러가 전부 사라졌다. 요구 5.48 N·m 대비 허브모터 21\~29 N·m 라 토크 계산 자체가 무의미해졌다. |
| 07-27 22:57 → 07-28 18:52 → 08-01 01:44 | 축간거리 500 → 400(회전 토크 −20%). 윤거는 프레임 폭 450 에서 나오는 520 을 유지. | 스키드 제자리회전 토크는 축간에 정비례라 공짜 레버다. 적재를 20 → 10 kg 줄여도 17% 뿐. 사용자 "축간거리 줄여도 상관없어 바닥 긁힘도 상관없어". | 적재 감량, 프레임 폭 축소(윤거가 줄면 회전 토크가 +9\~21% 로 반대 방향) | 두 번 바뀌었다. 07-28 18:52 스워브는 문지름이 없어 520 으로 늘렸고(400 이면 바퀴 사이 스커트 162 mm, 앞뒤 여유 1 mm 로 앞뒤 패널을 못 세움), 08-01 01:44 스키드 복귀 때 420(T/L 1.24, 피치 전복각 32°; 340 은 27° 로 기각). 08-01 20:41 "바퀴 지름은 윤거·축간을 정하는 변수가 아니다" — 확정은 무게중심 실측 뒤인데 실측은 지금까지 안 됐다. |
| 07-27 23:33 | 전장·전폭을 비율 그대로 0.90 축소 — 프레임 630×450, `AXLE_GAP` 25 → 20. 결과 700×632×335. | 사용자 "전폭은 조금 줄일 수 있을까?". 전장은 오버행만 줄어 공짜, 전폭은 윤거가 줄어 회전 토크 +9%. AXLE_GAP 10 mm 는 벨트 풀리를 안 넣으면 공짜였다. | 0.95(+3%), 0.85(+15%), 0.80(+19%) | 절반만 남았다. 폭 450 은 현재 `swerve_base.py` 까지 그대로지만 길이는 07-28 스워브 때 760 으로 늘었고 스키드 복귀 후에도 `BASE_L=760` 이다(축간 420 인데 프레임은 안 줄였다). `mobility_base.py` 는 630×450 그대로 남아 있다. |
| 07-28 01:03 | 구동계는 호버보드 8인치 허브모터 4개 + 순정 보드 2장(EFeru FOC 펌웨어, UART). 액슬마운트 판은 8t 알루미늄 유지·구멍만 D컷, 나머지 판재는 학교 3D 프린터(필라멘트 0원). | 총액 D) 98.8만 / B) 해외직구 110.8만 / A) 국내정품 173만. 250 W 면 요구 5.48 N·m 의 4\~5배. 액슬마운트는 차량 하중과 구동 반력을 받는 유일한 부품이라 프린트 불가. | SPG S9D90 + 감속기(101.8만, 지상고 45 mm·+14 kg·좌우 모터 충돌), 국내 정품 허브모터, 해외 직구(85,000원 가정, 끝내 미확인) | 방향은 유지, 규격은 빗나갔다. 실제 확보한 것은 6.5인치(Ø158.7×55, 축 Ø16 단면 D컷·한쪽만 — 07-31 19:59 STEP 실측)이고 당시 예상(Ø215, Ø12 양면 D컷)은 전부 틀렸다. 액슬마운트 판은 08-01 이후 별도 설계(→ Design D)로 바뀌었다. |
| 07-28 01:45 | 하부 커버는 `LOWER_COVER="skirt"\|"fender"` 한 줄로 택일하는 탈착식(커버 하단 플랜지 볼트 공유). 데크에는 100 mm 격자 직결 대신 2020 레일 3본(y=−200/0/+200) + 엔드 스톱으로 모듈 인터페이스. 2D 라이다 목업 제거. | 효용이 없다고 판명나도 손해가 볼트 값뿐이고, 실내 펜더 / 실외 험지 스커트로 교체 가능. 사용자 "탈착식으로 해서 어떤 느낌인지 살짝 보자". | 고정식 스커트, 데크 격자 직결 | 데크 레일은 07-30 02:29 표준 페이로드 인터페이스(`docs/payload-interface.md`)로 이어져 지금도 3본이다. 스커트/펜더 택일은 `mobility_base.py` 에만 남았고(현재 "fender"), `swerve_base.py` 는 셸에 스커트를 통합한 `--\__/--` 형태(07-28 23:35 요구, 07-29 구현)로 갔다. |
| 07-28 01:25 | 설계 기록은 `docs/build-log.md`, 렌더는 `docs/images/NN_설명.png` 로 번호순 저장. | 스크래치패드 렌더는 세션이 끝나면 사라진다. 사용자 "자꾸 이런저런 시도해보고 고민하고 막혔던 것들 그리고 방법을 찾은 것들 정리해서 문서로 작성해둘래?" | 없음 | 유지·강화됐다. 08-07 12:09 낡은 표는 몰래 고치지 않고 "갱신 대기" 인용구만 박았고, 08-10 00:00 "기존 20막까지는 한 글자도 손대지 않는다 — 뒤에 붙인다"가 원칙이 됐다. 다만 08-12 이후(파손·Design D·타이)는 build-log 에 없다(30절이 08-09 분). 도면 스크립트는 같은 원칙을 안 지켜 사라졌다(08-07 12:09 도면 행). |

19_v7_iso

24_cover_fender

## 2. 07-28 오후 \~ 07-31 — 스워브 시기 (models/swerve_base.py)

> 일단 지금 버전들 다 냅두고 … 바퀴가 독립적으로 조향이 되는 구조로 말이야

| 날짜 | 결정 | 이유 | 버린 대안 | 나중에 뒤집혔나 |
| --- | --- | --- | --- | --- |
| 07-28 17:25 / 21:28 / 07-29 16:26 | 독립 조향(스워브)으로 틀고 차체를 바퀴 위(z≥230)로 올리는 층 분리. 조향 모터는 킹핀 옆 벨트 2:1(24T→48T, 센터거리 70), 마운트는 상부 프레임이 아니라 킹핀 브라켓 위 라이저. 킹핀은 중공 Ø13 + 하드스톱 ±99° + 원점 홀센서, 슬립링 안 씀. | 스윕 반경 109 mm 때문에 층 분리는 선택이 아니라 강제였다(20° 조향에 차체 y≤211 필요, 스키드 차체는 245). 직결하면 모터 길이 90 이 전고에 얹힌다. 다른 부재에 달면 조립 오차로 센터거리 70 이 흔들린다. 8선이 지나갈 구멍이 없었고 슬립링은 3상 20\~30 A 라 크고 비싸다. | 스키드 프레임 유지 + 커버만 잘라내기(불가), 모터 직결, 상부 프레임 마운트, 슬립링/무한회전 | 뒤집혔다. 08-01 01:44 스워브·서스펜션 없는 고정식부터(사용자). 계기는 13 N/mm 스프링이 근거 없는 자리표시자로 정지 처짐이 트래블의 92%(08-01 01:35), 조향 모터·쇼크 국내 조달 어려움, +40\~60만원·공수 2\~3배. 조향 모터 기종(MG996R 1:1 / NEMA17 + 5:1 + AS5600 / 대형 서보 직결)은 끝내 미확정. 코드는 `DRIVE=swerve` 옵션으로 남아 있고 그 모드에서만 위 값들이 살아난다. |
| 07-28 23:07 / 07-29 00:36 | 서스펜션은 공압 대신 모듈 안 트레일링 암 + 코일오버(B안). 쇼크는 바퀴축 가까이(모션비 0.85, 13 N/mm). 트래블 25 mm 를 지키고 전고 442 → 460 을 받아들이며, 모듈 높이는 상수가 아니라 트래블 역산식(`YOKE_ARM_Z`). | 통고무 직결은 20 mm 턱을 1 m/s 로 넘을 때 충격 1,879 N(정하중 12.8배). 사용자 "공압은 안 쓸거야". B 는 조향계를 안 건드리고 비스프렁 질량도 안 늘린다. `MODULE_TOP = WHEEL_D + 20` 눈대중 탓에 설계값 25 mm 트래블이 실제로는 3\~6 mm 였다(스윕 검사로 발견). | 10인치 공압 휠(1순위 권고, 사용자 배제), A 킹핀 축방향 스프링(벨트 평면이 같이 움직임), C 모듈 전체 스윙(비스프렁 6 kg+), D 고무 부시(2\~3 mm), 트래블을 줄여 442 로 되돌리기 | 뒤집혔다. 08-01 서스펜션 없이. 07-30 12:09 팔 모듈에서 코너당 처짐 4.9 mm → 툴 19 mm 로 정밀 작업과 상충하는 것도 드러났다. 08-21 01:04 사용자의 "긴 볼트 + 스프링" 안은 안내 길이 6.6 mm(L/D 1.0)라 서스펜션이 못 되고, 잔진동은 우레탄 패드 3\~5 mm, 제대로 하려면 트레일링 암 자리라고 정리해 미뤘다. |
| 07-29 00:22 | 외장셸은 상단을 안으로 접은 플랜지 45×6 을 M6 12개(옆 x=±100, ±300 / 앞뒤 y=±150)로 상부 레일·크로스 슬롯에 물린다. 데크판을 6 mm 올려 볼트를 덮는다. | 셸이 어디에도 안 붙어 있었다(사용자 지적, build-log 12막 "고정 파츠가 안 보여서"). | 없음(고정 구조 부재) | 유지 — `FLANGE_T, FLANGE_W = 6, 45` 와 볼트 위치가 현재 파라미터와 같다. 09-10 BOM 도 셸 고정 M6 12개. |
| 07-29 01:16 / 11:03, 08-01 12:42 | 실물 STEP 취급 규칙: 치수는 상수로 옮겨 적지 않고 STEP bbox 를 런타임에 읽는다(Xtion). 외형만 필요한 라즈베리파이(솔리드 516개)는 박스로 두고 `PI_DETAIL` 뒤에. 렌더는 `HUB_MOCK=1` 목업, 검증·내보내기는 실물. 목업이면 `NOSHOW` 로 뷰어 전송 자동 차단. | (180, 41, 36) 반올림이 0.3 mm / 406 mm³ 간섭이 됐다. 파이 실물은 간섭 검사가 10분을 넘겼다. 허브모터 STEP 테셀레이션은 뷰당 10분, 그리고 목업 렌더 스크립트가 뷰어의 실물 모델을 덮어써 "왜 바퀴는 원래대로 돌아온거지?"가 됐다. | 상수 전사, 실물 STEP 통째 포함 | 유지. 08-07 12:09 도면만 예외로 실물 바퀴 기본(6면 111초). 08-01 3 mm 간격 축 스캔이 두 번(D컷 구간 1.5 mm, "Ø14 나사부") 틀리게 읽혀 0.1 mm 스캔으로 정정됐다 — 규칙은 "남의 STEP 은 측정 대상"으로 굳었다. |
| 07-29 20:23 / 23:27 | 적재함은 2020 프레임 + 판재가 아니라 본체 셸과 같은 810×610 R60 단면의 프린트 셸. 앞에서 뒤로 밀어 끼우고 슬라이드 노치는 뒷면에만, 스커트는 레일 구간 20 mm 만 덮음. 앞방향 고정은 레일 끝 M5 노치 리테이너 3개(`CARGO_RET`). | 사용자 "아래 디자인과 일치하게 … 슬라이드 구멍은 앞에서 안보이고 뒤에서만". 라운드 스커트를 데크까지 내리면 코너 때문에 45 mm 밖에 못 들어간다. "타이다운이 왜 필요한거지?"에서 채널 스토퍼가 앞으로는 무방비라는 것을 찾았다(제동 시 216 L 가 미끄러져 나옴). | 2020 프레임 12본 + 3 mm 판재(179 L, 전고 930, 판재 14.3 kg), 뒤 → 앞 삽입(두 번 반대로 구현했던 것) | 셸 방식·슬라이드·리테이너는 유지(`RAIL_X1=380`, `CARGO_RET=(44,30,4)` 현재 동일). 다만 09-10 BOM 에서 적재함 셸이 베드 초과 24조각·144 h 로 나와 3 mm 판재 전환을 대안으로 문서에 남겼다 — 확정은 아니다. |
| 07-30 00:39 | 적재함 높이 450 → 360, 어깨 R55(뚜껑에 포함), 벽 5 mm·리브 없음, 격벽 x=230(화물칸 628 + 장비베이 168), 탈착 라이너 트레이. | 사용자 "적재함이 조금 높아 낮춰도 돼 … 귀엽고 친근하게". 세로 리브 8개는 닦이지 않는다. 프린트 총량 13.9 L / PLA 17.2 kg 이라 높이를 줄여야 했다(표면적 2.2 m² 라 두께로는 답이 안 나온다). | 높이 450(17 kg), 평면부 PC 판재화(8\~9 kg), 벽 4 mm(14 kg) | 뒤집혔다. 08-10 01:39 리서치에서 배달로봇 적재함이 27\~50 L 로 수렴하는데 이 설계의 170 L 는 4배였다. 바구니는 설계하지 않고 유로 컨테이너 규격을 쓰기로 해 높이 280·어깨 R30·격벽 유도값·라이너 폐기(08-10 01:39 행). |
| 07-30 01:44 / 07-31 20:39 | 리프팅 손잡이는 셸이 아니라 하부 사이드 레일 직결 관통형 — 봉 Ø18 → 팔 Ø20×2 가 셸 Ø24 구멍을 지나 3030 에 M6×2. 전폭 712 는 수용. 07-31 4개 → 2개(양쪽 1개씩), 봉 170. | 사용자 "핸들 자체가 … 쉘에 붙어있는거 같은데 이러면 약해서 부서지지 않을까" — 3 mm 프린트 셸에 50 kg 을 매다는 구조였다. 매립 개구형은 두 번째 오해("작은 구멍을 통해 핸들 봉이 튀어나와서"). 봉 220 은 요크 수평팔과 7 mm³ 접촉. | 셸 부착, 매립 개구 130×40, 4개 유지, 봉 220 | 구조는 유지(`HANDLE_XS=(0,)`, 봉 Ø18, standoff 42). 08-11 00:33 핸들이 전폭 102 mm 를 먹어(712 중 610 이 셸) 탈착식을 권했으나 보류 — 현재도 고정식 미반영. |
| 07-30 02:29 / 14:42 | 상판 모듈은 `PAYLOAD` 플래그(cargo \| flat \| sensor \| arm \| inst \| none)로 교체하고 규격(레일 3본 위치, 채널 안폭 22·턱 2.5×4, 그로밋 Ø25 ×2, 36 V + 보조전원, 한계 60 kg / CG 700 이하)은 `docs/payload-interface.md` 에 고정. `PAYLOAD` 는 환경변수로 덮어쓴다. 간섭 검증은 모듈 관련 쌍만 본다. | 89 kg / CG 357 / 전복각 33\~36° 이 전부 계산값이라 플랫폼 자체를 시험할 표준 인터페이스가 먼저 필요했다. 5종 전체 검증은 10분 타임아웃(exit 143). | 모듈별 전용 인터페이스 | 유지 — 문서 307줄, 모듈 5종 + 아웃리거 절. 기본값은 당시 cargo, 현재 none. sensor 의 결합부 8건(191/129 mm³)은 결함이 아니므로 남긴다. |
| 07-30 07:42 \~ 14:13 | 모듈 3종(센서 타워·로봇 팔 마운트·계측)을 추가하되 팔 기종은 미정 그대로 xArm6 급(도달 700, 자중 12 kg, 가반 3 kg)으로 파라미터화하고 PCD100·M6×4·자중에 [가정] 딱지. 계측 모듈은 페이로드 하중만 잰다는 전제(바퀴별 하중은 스트로크 역산). | 데크-모듈 사이 로드셀은 그 위의 페이로드만 본다. 기종을 정하지 않고도 마운트·간섭은 확인할 수 있다. | 팔 기종 확정 후 설계, 서스펜션 계장(베이스 개조) | 유지 — `TOWER_*`/`ARM_*`/`INST_*` 상수가 지금도 같고 [가정] 표기 그대로. 서스펜션이 빠져 "스트로크 역산" 전제는 현재 구성에서 쓸 자리가 없는 것으로 보이나 확실하지 않다. |
| 07-30 12:09 / 07-31 11:20 | 서스펜션 vs 정밀 매니퓰레이션(툴 처짐 19 mm) 상충은 문서에 그대로 남기고 해결은 아웃리거로. 아웃리거는 모듈이 아니라 베이스(상부 사이드 레일 z=436) 피벗, 잭은 수직 스크류, x=±360(전복각 앞뒤 45° / 좌우 54°). | 모듈에 달면 로봇 전체 무게가 2.5 mm 물린 슬라이드 턱을 통과한다. z\<248 은 조향 스윕이 다 쓴다. 상부 레일이 ±380 까지라 ±360 이 거의 한계. | 서스펜션 락아웃, IMU 역보상, 모듈 부착 아웃리거, 잭을 암과 같이 45°(발이 z=64 에서 멈춤) | 접혔다. 07-31 11:42 측면 확장 레일(y=330, z=310)과 접힌 아웃리거(y=320)가 부딪혀 `OUTRIGGER=False`, `SIDE_RAIL=False`. 08-01 서스펜션 자체가 빠지면서 상충도 사라졌다. |
| 07-31 09:35 / 08-07 12:09 / 08-12 23:20 | 도면은 코드가 만든다 — 제목·치수는 모델 `bounding_box()` 와 `PAYLOAD` 에서 자동, 판재 그룹은 숨기지 않는다, `models/drawings.py`(HLR 6면 투영), 도면만은 실물 바퀴 기본, `SUBJECT=vehicle\|wheelmount`. | 07-31 사용자 "상단 커버가 안 나와있는데 의도한거야?" — HIDDEN 에 판재가 들어 있었다. 08-07 도면 41\~47 은 이미지만 있고 코드가 없어 모델이 스키드로 바뀐 뒤에도 스워브 시절(전고 595 / 축간 520)로 굳어 있었다. 하루 만에 문서 숫자 9개가 어긋났다. | 손으로 제목 수정, 구성별 숨김 목록, 스크래치패드 스크립트 | 유지. `41_skid_*` 와 `41_wheelmount_*` 는 이 스크립트 산출물이다(41_wheelmount 는 08-12 76×40×20 시점 형상이라 채택된 Design D 와 다르다). |
| 07-31 19:54 / 19:59 / 20:39 | 바퀴는 실물 STEP 기준 Ø158.7×55, 축 Ø16 D컷 13, 스윙암 구멍도 실측 D컷. 서스펜션 좌표는 절대값이 아니라 `AXLE_Z`·`MODULE_TOP` 상대값(모션비 0.854 유지). 스커트 깊이 84 → 45(지상고 112.7 → 151.7). | `WHEEL_D=210` 은 PVC 바퀴 스펙이 "호버보드" 주석 아래 살아남은 것이었다. Ø165×70 으로 바꾸자 절대 z 로 박힌 쇼크 상단이 모듈 밖으로 나갔다. 6.5인치는 지상고가 문제(등판 턱 26\~40 mm). | Ø165×70 추정값, 8.5인치 교체(전고 +56, STEP 없음), 스커트 제거(지상고 196.7) | 치수는 유지(`parameters.py` [실측] 태그). 스커트 지상고는 스키드 복귀로 125.7 이 됐고 Design D(`MOUNT=low`)에서는 49\~55 mm 로 내려가 휠아치·스커트 재조정이 남았다(08-01 01:44 행). |

27_swerve_iso

33_swerve_module_suspension

## 3. 08-01 \~ 08-07 — 스키드 복귀와 휠 브라켓

> 일단 스프링없고 스워브 드라이브도 아닌 버전부터 재설계 들어가볼까? 프레임에다가 해서 그냥 고정식으로 하는 걸로 말이야

| 날짜 | 결정 | 이유 | 버린 대안 | 나중에 뒤집혔나 |
| --- | --- | --- | --- | --- |
| 08-01 01:44 | 차체 바닥 196.7 → 170.7(바퀴 158.7 + 여유 12), 전고 518. 축크로스 2본을 축 위에 추가(사이드 레일 단일 스팬 방지). 코너당 부품 12종 → 브라켓 1. | 고정식이면 킹핀·6005 베어링·하드스톱·조향모터·풀리·벨트·스윙암·쇼크가 사라진다. | "약 175" 로 대충 잡기; 레일을 z=125 로 내려 다리 31 mm·CG −46 mm(셸 휠아치 필요라 보류) | 뒤집혔다. 08-12 22:40 사용자 제안(기존 클램프 짝을 만들어 프레임에 바로 고정) → Design D 로 프레임이 77 mm 내려와 차체 바닥 93.9, 지상고 55.35, 전고 606(적재함 포함). 바퀴가 레일 윗면보다 34.8 mm 솟아 셸 휠아치 4곳이 아직 남은 일이다. |
| 08-01 01:49 \~ 08-02 20:18 | 판재 휠 브라켓: 8t 클램프 판 2장이 레일 밑면·바깥면 두 평면에 M6 4개, 축 스페이서 슬리브, 다리 단차 제거. 처음엔 너트 예압 스택 5+8+24+8=45. 08-02 나사가 없다는 것이 드러나 아래로 열린 U 판 + 하부 축캡으로. 캡 볼트는 8t 판이 아니라 브리지 블록(20t, 3.3×D 탭)에 M6×2, 캡 24t, 핀치 갭 1.0 mm. | 축은 한쪽으로만 나오는 외팔보라 45 mm 안에서 판 두 장을 벌려 모멘트를 커플로 받는다. 0.1 mm 스캔: 축 끝은 나사가 아니라 1 mm 모따기 — 사용자 "애초에 보드 축은 너트를 끼울수 있게 되어있는 형태는 아닌데". 8t 판에 M6 탭은 살이 1.5 mm. 캡이 판에 먼저 닿아(0.15 mm 틈) 클램프인데 클램프가 안 되고 있었다. | 축 너트 M14, 축 언더컷 줄 작업(08-01 17:39 사용자 선택 → 08-02 폐기), 캡 볼트 M6×4, 캡 30t(응력 4.8배 과함) | 뒤집혔다. 08-05 15:46 사용자 "휠 브라켓을 그냥 프로파일로 대체할까?" — 판재 6종 가공 4\~20만원이 부담. 이 설계는 `wheel_bracket()`/`axle_cap()` 으로 코드에 보존돼 CNC 견적 비교용으로만 남았다. |
| 08-01 12:46 \~ 16:42 | 단륜 시험 지그(`models/wheel_jig.py`): 로봇 장착 인터페이스(3030, y=+210)를 그대로 복제, 전용 어댑터 없음. 공중 시험 전용(잭·로드셀 없음). 3030 390 mm × 7본 ㄴ자, 거싯 없음, M8 앵커 4개, 가공(홀·탭·각도) 없음. | "지그에서는 됐는데 로봇에서는 안 되는" 차이의 출처를 알 수 없게 된다. 사용자 "바퀴는 땅에 닿지않고 공중에 띄운채로 테스트할건데". 전복 반력은 앵커가 받으니 박스 상단 4본·뒤 기둥 2본은 하는 일이 없다. 390 이면 본체 재단표와 같아 6본을 재활용한다. 거싯은 코너 0.8 N·m 에 브라켓 2개로 20배 여유라 과설계. | 로봇 하부 프레임 통째 복제(400×800×514, 6.00 m), 3점 지지 + 추 데크 28 kg, 직각삼각형, 3D 프린트 지그(장착 레일이 30° 넘게 감김), 거싯판 200×200×6t | 유지 — 현재 `wheel_jig.py` 가 이 구성이다. 재활용 구상은 08-27 "남는 390 을 액슬 타이로"로 형태를 바꿔 살아남았다. |
| 08-01 14:58 / 16:29 | 3030 은 100 mm 단위 올림 과금이므로 절단 길이를 먼저 100 배수로 잡고 프레임 치수를 역산한다(`tslot.cut_list` 에 과금·버림 계산). 본체 프로파일 치수는 그대로(83단위 74,700원). | 사용자 캡처: 770 주문 = 800 값. 지그 5종 50단위 45,000원·버림 13% → 2종 36,000원·버림 1%. 본체는 `BAY_H` 를 키워도 같은 83단위지만 전고 +57 로 피치 전복각 32 → 29°. | 본체 760 → 800(돈이 안 줌), 기둥 100·사이드 700(9,000원 절감에 베이 −43), 하부크로스 300(휠브라켓 재설계 필요) | 유지 — 08-05 실제 장바구니로 단가 950원/100 mm 확인(`UNIT_PRICE`), 현재 프레임 760×4 / 390×8 / 143×6. |
| 08-01 16:42 / 08-04 23:10 / 08-05 10:26 | 철물은 한 종류씩 — 다이캐스팅 코너 브라켓 3025(360원), 둥근머리 렌지볼트 M6×15(70원), 스프링너트 306(180원). 사각너트 안 씀. 카메라크로스(Xtion 크래들 받침뿐)는 첫 제작에서 제외(`CAM_RAIL` 옵션). | "아연은 조이다 깨진다"며 스틸을 권했다가 사용자가 되물어 계산하니 브라켓당 43\~49 N 에 정격 약 490 N 으로 10배 여유. 사각너트는 8,000원 싸지만 슬롯 끝에서만 들어가 조립 순서에 묶인다. M6×12 → 15 는 장바구니에 맞춤. | 스틸 브라켓(450원), 사각너트(50원), 이너 브라켓 306(770원 — 21건 간섭을 돈으로 덮는 것) | 유지 — `docs/bom.md` 프레임 항목이 3025 28개 / M6×15 68 / 스프링너트 68. 08-21 02:40 이후 클램프 밑면·타이 브래킷에는 드롭인 T너트(물림 16, 추정 2,271 N)가 별도로 추가됐다. |
| 08-04 23:10 | 조인트 브라켓은 손 목록이 아니라 `BEAMS` 에서 자동 탐색(빔 끝면이 다른 축 빔에 맞대는 곳). 면은 네 방향을 다 놓아 보고 장애물 겹침이 가장 작은 면, 동점이면 아래·안쪽 우선. 축크로스는 55 mm 비킴. | 사용자 "굳이 필요 없는 곳에 되어있거나 되야할곳에 안된곳이 있고". 제3축 + 고정은 21건, 안쪽 고정은 12건, 동점 "무조건 −"는 뒤 기둥이 셸·범퍼와 12건 → "안쪽 우선"으로 0건. | 이너 브라켓으로 교체(+12,300원) | 유지 — 현재 `BEAMS` 의 축크로스 x=±265, 조인트 28곳 자동 검출이 09-10 BOM 으로 이어졌다. |
| 08-05 15:46 | 휠브라켓을 3030 휠포스트 69.3 mm × 4 + 호버보드 기존 클램프 재사용으로 교체(사용자 제안). 포스트 끝단 M8 탭 4곳. 클램프 50×40×44 는 가정값. | 브라켓의 본질은 "축을 무는 것"이 아니라 레일 밑면에서 축까지 91.35 mm 를 내려주는 것 — 샤프트 서포트(축 높이 31)는 오답이었다("샤프트 서포트 가 왜 나와?"). 판재 6종 가공 4\~20만원 → 프로파일 4단위 3,800원. | SHF16/SK16 샤프트 서포트(분할 클램프 16 N·m \< 스톨 29 N·m), 판재 톱 + 드릴 자작(4\~6만원) | 뒤집혔다. 08-07 01:38 ㄷ자 휠마운트로. 이유: 프로파일 한 토막은 레일 밑면에만 물려 횡력 모멘트 18.6 N·m 를 볼트 프라잉으로 받고, 클램프 치수가 가정값이었다. 현재 `swerve_base.py` 에는 "휠포스트(3030 x4)는 없앴다" 주석만 남았다. |
| 08-07 01:38 \~ 03:23 | ㄷ자 휠마운트(`models/wheel_mount.py`): 레일을 안쪽에서 감싸 밑면 M6×2 + 윗면 M6×2. 치수는 전폭 70 / 깊이 40 / 벽 10 셋에서 유도(70×40×151.4, 190 cm³). 레일 볼트 x=±15 + 공구 여유 `HEX_R=6` assert. 슬롯 여유 0.4 는 아래팔 쪽에만. | 사용자 "ㄷ 자 형태로 해서 … 위에서도 고정하고 아래서도". 레일 높이 30 을 팔로 쓰는 순수 커플이면 볼트당 310 N 이고 풀려도 벗겨지지 않는다. 슬롯 30.000 은 압출 공차 ±0.3 에서 안 끼워진다. 위팔 밑면은 볼트가 미끄러졌을 때 수직 하중을 받는 자리라 레일 윗면에 딱. | 밑면만 물리는 곧은 기둥(클램프 자리 7,220 mm³ 침범), 두 팔 방식, 볼트 x=±25(렌치가 기둥에 막힘), 여유를 위팔·폭에도 | 뒤집혔다. 실물 PETG 출력품이 08-12 20:32 "브라켓 하나가 박살" — 한쪽 코너 탑승 800 N·편심 55 mm 에서 팔(무보강 판 외팔보) 53.5 MPa = PETG 의 119%, 레일 볼트 M6×15 물림 0.6 mm. 08-12 22:30 거싯 6장(팔 119% → 18%)으로 보강했으나 08-15 Design D 가 91 mm 캔틸레버 자체를 없애 ㄷ자는 FEA 의 `legacy_u` 케이스로만 남았다. |
| 08-07 02:40 \~ 14:25 | 제작법·소재(ㄷ자 시점): 진공주형·SLA·SLM·판금 탈락. JLC 는 CNC(\$228/4개)가 MJF(\$285)보다 싸다 — 그러나 학교 프린트 → 필요하면 학교 CNC(70×40 각봉 152 톱질 + 밀링 1회·드릴 2회). 프린트 자세는 웹면을 바닥에 눕힌다. 본품은 PETG(실내)/ASA(옥외), PLA 는 실내 전용 또는 치수 확인용 1개. 쿠폰 없이 가도 본품 1개 먼저. | 진공주형은 4개에 몰드값·PU 크리프·HDT 60\~80 °C. 세워 뽑으면 층간 인장 25 MPa, 눕히면 소재 45\~50 MPa(처음 "세우라"고 한 것을 정정). 허브모터 축이 고정자라 코일 열이 블록으로 직접 들어와 PLA Tg 60 °C 는 여유가 없다. 슬롯 30.8 의 실제 축소량은 프린터마다 달라 계산으로 못 맞힌다. | 진공주형, MJF PA12(부피 과금, 1.28 kg 가벼움), 세워 출력, PLA 본품 | 재료 방침이 바뀌었다. 08-21 03:00 "CNC 는 당분간 작업 못할거고 계속 PLA 출력으로 대체" → 08-22 시험 단계 PLA 꽉 채움 + 타이(08-22 11:55 행). 이 시점 강도 계산(횡력 여유 7배)은 수직 편심 하중을 안 본 값이었고 실물은 거기서 부러졌다. |
| 08-07 03:45 \~ 04:04 | CNC 와 프린트를 `PRINT=1` 로 갈라(슬롯 30.4/30.8, 레일 볼트공 6.6/7.2, 탭 하공 5.0/5.3) 다른 파일명(`_cnc_M6` / `_print_M6`)·다른 폴더(`exports/cnc`, `exports/print`)로 낸다. 프린트판은 `bed()` 로 눕혀 z=0, DXF 는 안 낸다. 휠마운트 원본은 `wheel_mount.py` 한 곳, `swerve_base.py` 는 import + 접합면 어서트 3개. 베이 바닥판 노치는 마운트 bbox 에서 자동. | FDM 내부 치수는 0.1\~0.3 작다. `PRINT=1` 실행이 CNC 파일을 조용히 덮어썼다. 두 벌로 그리면 반드시 어긋난다. ㄷ자 위팔이 바닥판을 코너마다 2,100 mm³ 관통하고 있었다. | 출력 후 드릴 후가공(32구멍), 파일 하나로 덮어쓰기, 노치 수동 | 유지(`wheel_mount.py` 기준). 채택된 Design D 는 별도 패키지 `models/hoverboard_mount` 로 갔고 차량 통합은 `vehicle_*_integration.py` 가 맡는다. |
| 08-07 03:52 | 기존 클램프 고정 볼트는 M8 이 아니라 M6 + 와셔. `CLAMP_BOLT=8` 은 실물 장공 폭을 재서 `CL_SLOT_W` 를 고친 뒤에만 통과(어서트). | 장공 8.128×16.25 의 8.128 은 0.3200" 라운드 인치값(코너 R 0.1000", 필렛 0.0100" 도 마찬가지)이라 실측이 아니다. M8 통과 여유 0.13 mm, M6 는 2.13 mm 이고 볼트당 480 N 에 23배. | M8(Ø8.13 을 실측으로 믿음) | 유지 — Design D 도 기존 클램프 M6×4(`TNUT_BOLT` 6). GrabCAD 원본은 403 이라 실물 구멍이 8.0 인지 8.3 인지는 확인 못 했다. |

60_hub_motor_real

41_skid_drawing_sheet

## 4. 08-10 \~ 08-15 — 적재함 재설계, 실물 파손, Design D

> 내가 올라타는 등 하중은 버티긴 했는데 하중구조가 분산이 잘 안된건지 바퀴가 점점 바깥쪽으로 밀리드라 … 옆에 살짝 부딛혔는데 그게 트리거가 되서 브라켓 하나가 박살이 나버렸어

| 날짜 | 결정 | 이유 | 버린 대안 | 나중에 뒤집혔나 |
| --- | --- | --- | --- | --- |
| 08-10 01:39 \~ 08-11 02:05 | 바구니는 설계하지 않고 유로 컨테이너(KLT / EPP 서모박스 공용 발자국) 400×300×220 한 개. 적재함 높이 360 → 280, 어깨 R30. 바구니는 뒤(바구니칸 522×350), 앞 272 mm 는 닫힌 장비 베이, 좌우 120 은 닫힌 수납. 뚜껑은 바구니칸만(529×349). 격벽·힌지·잠금·손잡이 홈·타이다운은 전부 바구니 규격에서 역산. | 리서치: Starship 43.5 L, Cartken 27 L — 음식 배달은 27\~50 L. 600×400 은 앞에 78 mm 밖에 안 남고, 뚜껑을 열면 58% 가 빈 바닥이었다("뚜껑 열리면 바구니만 보여야지"). 옆벽 하나 세우자 절대값으로 박힌 부품 5개가 연쇄로 틀어졌다. | 600×400(53 L), 높이 147.5(컵이 안 선다) / 280, 측면 레일 삽입(BellaBot식, 옥외 밀폐 어려움), 적재함 자체를 좁히기(셸 실루엣 끊김) | 유지 — `CARGO_BIN=(400,300,220)`, `CARGO_H=280`, BAY_X 522 / BAY_Y 350 이 현재 코드. `payload-interface.md` 와 build-log C절은 아직 360 / 전고 840 이다. |
| 08-12 20:40 / 21:19 | 하중 경로 검사기 `report_loads()` / `report_loads_low()` / `stress_view()` 를 모델에 내장 — 응력은 손으로 집지 않고 여기서 본다. FEA 파이프라인(gmsh + CalculiX)은 셋업 하루 + 경계조건 오류 시 ±10배라 뒤로 미루고 거싯부터. | 이전 계산은 접지점 횡력 한 케이스뿐이었다. 팔을 보 단면(Zx 18,454)으로 재 판 외팔보(947)와 19배 차이, 55 mm 오프셋 모멘트(800 N 에서 44 N·m)와 탑승 케이스 누락. 사용자 "그래 바로 계속 진행해". | 즉시 FEA(PrePoMax GUI / B안 파이프라인), 알루미늄 발주 | 뒤집혔다. 08-21 이전에 B안 파이프라인(STEP → Gmsh C3D10 → CalculiX → VTU)이 구축됐다(경위는 대화록 밖 — 5장). 08-21 00:42 손계산(다리 2.5 / 블록 4.8 MPa)이 FEA 구조응력 45 MPa 와 10배 차이 — Ø6.6 구멍 두 개로 하중이 빨려 드는 것을 통짜 보 계산은 못 본다. report 는 경로별 사용률 확인용, 국부 응력은 FEA 로 역할이 갈렸다. |
| 08-12 22:40 \~ 08-13 01:06 | 하단 클램프(`mount_low`, 84×40×24, 91 cm³)와 3면 마운트(`mount_wrap`, 165 cm³)를 대안으로 모델에 두고 `MOUNT=low` 로 차량 전체를 오간다. 관통볼트 전제는 철회. 블록 높이 20 → 24, 카운터보어 Ø11 → Ø16, 전폭 76 → 84, 다리 위치는 `LOW_W/2 − LOW_POST_W/2` 유도값. 볼트 길이는 부품 두께에서 역산(ㄷ자는 M6×25). 3면은 바깥 옆면 대신 밑·안쪽 옆·윗면. | 사용자 "기존 클램프 정도의 크기와 높이를 가진 부품을 하나 더 만들고 짝을 맞춘다음에 프레임에 고정". 밑면 볼트 2개면 인발 1,074 N(스프링너트 1,500 의 72%)로 ㄷ자(49%)보다 불리 — 관통볼트를 Claude 가 임의로 끼워 넣어 20% 로 보였던 것("아니야 우리 관통볼트 아니야"). "훨씬 튼튼"은 과장(3개만 집어 카운터보어 면압 39% 를 놓침). 레일 바깥면 → 모터 몸통 12 mm 라 바깥 옆면 볼트는 물리적으로 불가. 1 mm 턱은 눈대중 좌표 탓. | 관통볼트, 블록 깊이 60(D컷 42.8 초과), 양옆 + 하단 6볼트 원안, 셋 중 즉시 선택(셸 휠아치를 봐야 끝난다) | 방향은 채택됐다. 08-15 Design D 가 하단 클램프 발상(다리 24·카운터보어 Ø16·블록 24)을 이어받았고, 3면 발상(옆 플랜지)은 Design D 에 들어갔다가 08-21 실물에서 부러져 제거됐다(08-21 00:30 행). ㄷ자용 M6×25 는 ㄷ자가 빠지며 BOM 에 없다. |
| 08-14 11:18 \~ 08-15 08:56 | `models/hoverboard_mount` 패키지: Design A/B(2피스 스플릿 클램프 + 어댑터, 4080/3060 전제) → C(3060 세로 새들, 217 cm³) → D(3030 기준, 기존 클램프 + 새 하부 클램프를 M6×4 로 물리고 다리 2개가 레일 밑면에 매달림). 프레임은 3030 유지. 데이텀은 타이어 중심면, 패키지 z=0 은 축 중심. 하부 클램프는 92.7×46.6 각기둥 하나에서 통로 44.7·레일 홈 30.6·축 시트 Ø16.2 셋만 파낸다(다리 24). | "근데 우리 프로파일은 4040사이즈가 아니라 3030인데"(08-14 17:27), "3030프로파일 기준으로 해야하고 기존브라켓과 새로만든 브라켓을 결합해서 하단부에"(08-15 02:05), "cnc 로 깍을때 움직임 덜 할 수 있게 … 하나의 큰 통짜 부품으로"(08:56). A/B 는 탭 8곳이고 3030 에서 볼트 두 줄이 겹친다(1,175 mm³). 하우징 폭 45 [TODO] 로 잡은 클램프 위치가 실측과 4.5 mm 어긋났다. 기존 클램프 채널 5.07 = D컷 평면 높이라 회전 방지가 공짜. | 4080/3060 으로 프로파일 교체(3060 볼트 716 N), Design A/B/C, 다리 18 + 지느러미(단차 3.3 mm) | 유지 — 현재 채택 형상. 다만 "CNC 알루미늄 통짜"는 08-21 "CNC 는 당분간 작업 못할거고"로 제작이 PLA 출력이고 알루미늄은 예정(`bom.md` 는 PLA 116 cm³ × 4). |
| 08-15 02:05 | T너트 인발 한계는 상수가 아니라 볼트 굵기에서 유도 — M6 1,500 / M8 4,000 N 보수 하한. | `TNUT_PULLOUT` 이 M8 값 4,000 으로 고정돼 밑면 볼트 인발을 35.8% 로 잘못 보고했다. 고치니 1,432 / 1,500 = 95.5% — 실물이 부러진 것과 같은 경로. | 상수 4,000 | 유지(`parameters.py` 동일). 이 값은 설계 전체에서 유일하게 안 잰 변수이고 09-15 현재도 실측 기록이 없다. `docs/bom.md` 는 스프링너트 933 / 드롭인 2,271 N [추정] 이라는 다른 수치를 쓴다. |

41_wheelmount_drawing_sheet

51_cargo_interior

## 5. 08-15 \~ 08-20 — 세션 밖(GPT/Codex): 프레임 폭 450, 조립 순서, FEA 파이프라인, 파손 재현

이 구간은 Claude 세션 밖이다. 08-15 13:42 에 구독 접근 비활성화(403)로 세션이 끊긴 뒤 사용자가 GPT/Codex 로 작업을 이어갔고, 그 사이 대화록은 어디에도 없다. 아래 결정은 08-21 00:17 에 넘겨받은 인수인계 문서(`CLAUDE_HANDOFF.md`·`FEA.md`·`CLAUDE.md`)와 그 사이 생긴 파일(`tools/fea/` 툴체인, `output/fea/` 결과 폴더 11개, 보고서 2개, 새 스크립트 십여 개)로만 확인한 것이다. 표의 시각은 대화 시각이 아니라 **파일 mtime** 이고, 08-21 세션에서 이 머신의 시계가 왔다갔다 한다고 적었으니 순서는 믿되 절대 시각은 참고만 한다. 인수인계 두 문서는 08-21 에 Claude 가 고쳐 써서 GPT 시점 원문은 없다. 이 구간의 렌더는 docs/images 에 없다.

| 날짜(mtime) | 결정 | 이유 | 버린 대안 | 나중에 뒤집혔나 |
| --- | --- | --- | --- | --- |
| 08-15 23:48 \~ 08-16 00:31 | 조립 순서 6단계 확정(`assembly_animation.py`, 오프라인판 `render_assembly_gif.py`): 하부 클램프 배치 → 휠모터 축을 하부 시트에 수직 하강으로 안착(옆에서 관통시키지 않는다) → 상부 클램프 장착(휠 상단보다 위에서 대기) → 3030 프로파일을 끝에서 X 방향으로 밀어 넣기 → 측면 M6×20 ×4 → 바닥 M6×20 ×2(카운터보어 아래에서 위로). | 플랜지가 있는 63.9 mm 형상이라 레일을 옆 플랜지 사이로 끝에서 밀어 넣어야 했다. 원칙은 "상부 클램프를 먼저 닫아 놓은 뒤 축을 통과시키거나, 프로파일을 먼저 장착한 상태에서 위쪽 클램프 볼트에 접근하는 순서는 쓰지 않는다". | 상부 클램프 먼저 닫기, 프로파일 장착 후 위쪽 클램프 볼트 접근 | 일부 바뀌었다. 08-21 플랜지 제거로 인수인계 §5 는 상·하부 클램프를 먼저 체결한 뒤 프로파일을 위에서 얹고 바닥 볼트 2개(M6×15)만 조이는 판으로 고쳐졌다 — 끝에서 밀어 넣는 단계와 측면 볼트 4개가 사라졌고 원칙은 두 판이 같다. `assembly_animation.py`(이름 10개 고정)·`render_assembly_gif.py` 는 옆 볼트 4개를 전제한 채 남아 있다. |
| 08-16 21:31 \~ 08-17 03:00 | 상·하부 프레임 폭을 450 으로 통일. 상부 크로스 500 → 390(`TOP_RAIL_Y` 265 → 210, 2×265−30 → 450−30−30). 390 mm 크로스는 하부 3 + 상부 3 + 축 하중 보강(x=±265) 2 = 8본. 길이 760 과 높이는 그대로. 휠 축 X=±210, 휠 중심 Y≈±263.7(레일 중심 210 + 클램프 오프셋 53.7). `vehicle_integration.py` 가 발주 확인용 기준 장면(그룹 5개). | 인수인계 §3. 기존 상부 500 ×3 은 390 으로 잘라 재사용할 수 있고, 새로 산다면 상부 변경분 3개, 실차에 축 보강 크로스 2개가 없으면 총 5개, 카메라 받침 크로스까지 달면 390 한 개 추가. 같은 시각의 `vehicle_flat_abs_integration.py`(3 mm ABS 평판 셸 비교 장면)와 08-16 17:03 `bent_lower_clamp.py`(6 mm SS400 절곡 3부품 안)는 검토안인지 채택안인지 문서에 없다. | 상부 폭 500 유지(스워브 시절 `TOP_RAIL_Y=265`), 절곡 강판 하부 클램프, ABS 평판 셸(둘 다 채택 여부 불명) | 유지 — 인수인계 §3 과 `vehicle_shell_integration.py`(`TOP_RAIL_Y=210`, `SHELL_Y=255`) 가 지금도 같다. 다만 `swerve_base.py` 자체 기본값은 `TOP_RAIL_Y=265` 라 단독 실행하면 상부 크로스가 500 으로 그려진다. 프로파일 체결 볼트 그룹은 이 구간 M6×20 24개에서 08-21 이후 M6×15 8개로 바뀌었다. |
| 08-18 00:29 \~ 02:03 | 구조해석은 뷰어 화살표 장면(`load_analysis_viewer.py`, "색상은 FEA 응력값 아님")과 별개로 실제 FEA 파이프라인을 둔다: STEP → Gmsh 4.15.2 C3D10 2차 사면체 → CalculiX 2.23 선형 정적 → ccx2paraview VTU → VTK 응력/변형 PNG(`tools/fea/run_clamp_fea.ps1`). 재료 카드는 AL6061-T6 와 PETG 등방 근사 둘. 고정은 레일 체결 구멍 벽 노드 강체 고정, 하중은 축 시트 표면 노드 균등 분배. 첫 기준: 플랜지 있는 63.9 mm 형상·구멍 6개 고정·편심 0·하향 800 N 에서 3 mm 4.036 MPa / 0.001400 mm(4 mm 3.613 / 0.001390, 반력 합 +800 N). | 08-12 에 "셋업 하루 + 경계조건 오류 시 ±10배" 라 미뤘던 B안을 이 구간에 구축했다. 01:46\~02:03 에 구형 긴 ㄷ자(`exports/cnc/휠마운트_cnc_M6.step`, 거싯 있음, AL)를 같은 조건으로 돌려 15.816 MPa / 0.009374 mm — 응력 3.92배, 변위 6.70배, 등가 수직강성 571.6 vs 85.3 kN/mm(`comparison_800N.md`). 보고서 스스로 "축중심 하중이라 편심 55 의 44 N·m 가 빠졌다" 는 범위 경고를 달았다. | PrePoMax GUI, 뷰어 색상으로 응력 대신하기 | 파이프라인은 유지(`CLAUDE.md`·인수인계 §6). "기준" 은 바뀌었다 — 4.036 MPa 는 편심 0 축중심 하중이라 08-21 00:42 에 편심 55·상향 45.3 MPa / 0.0582 mm 로 교체됐고(6장 08-21 00:42 행) 최대 von Mises 인용 금지 규칙이 붙었다. ps1 기본값이 `Eccentricity 0 · downward` 라 옵션을 빼면 편심 0 케이스가 도는 함정, `.venv` 가 깨졌다고 보고 Codex 번들 파이썬으로 떨어지는 분기는 지금도 그대로다. |
| 08-18 02:13 \~ 02:27 | 구형 브라켓 파손 원인을 FEA 로 재현해 확정: `legacy_u_nogusset`(거싯 없음, ㄷ자 열린 면이 차량 내부 방향, `wheel_mount.py` 의 `NO_GUSSET`·`U_OPEN_INBOARD` 환경변수 + `export_legacy_ungusseted.py`), PETG, 800 N, 편심 55 mm(44 N·m), 위·아래 볼트 4개 고정, 상향. 3 mm 44.373 MPa / 2.979 mm, 바깥방향 2.819 mm(4 mm 45.917 / 2.967). 최대응력은 아래 볼트열 부근, PETG 항복 45 대비 사용률 약 99%. | 축중심 비교는 형상 순위에는 쓰여도 파손 재현이 안 됐다. 긴 다리의 바깥방향 변위가 z 180\~212 에서 약 0.005 mm → 60\~80 에서 2.389 mm 로 아래로 갈수록 커져, 사용자가 본 "아래 볼트 부근부터 바퀴 쪽으로 갈수록 바깥으로 휘어짐" 과 맞는다. 하향(02:16/02:18, 62.329 MPa / 2.955 mm)은 응력 크기는 비슷해도 휘는 방향이 사진과 반대라 상향으로 다시 돌렸다. 같은 조건의 Design-D AL(구멍 6개 고정)은 17.677 MPa / 0.007293 mm 로 구형 대비 응력 2.51배 낮다(`legacy_failure_reproduction.md`). | 하향 하중, 거싯 있는 CNC STEP 으로 파손 검증 | 유지 — `CLAUDE.md` 의 "실제 파손 재현" 조건과 수치가 그대로이고 `output/fea/legacy_u_nogusset_*` 폴더도 08-18 자 그대로다. 17.677 MPa 는 플랜지 있던 형상 값이라 08-21 이후 기준에서 빠졌다(플랜지 제거로 변위 8.0배). |

## 6. 08-21 \~ 09-10 — 실물 반영, FEA, 액슬 타이, 재료, BOM

> 양 옆 기둥같은 것은 툭하니까 부러지더라고 … 해놓고 보니까 솔직히 불필요하겠더라고 … 우리가 가진 m6 나사가 20mm 가 아니라 15mm 이더라고

| 날짜 | 결정 | 이유 | 버린 대안 | 나중에 뒤집혔나 |
| --- | --- | --- | --- | --- |
| 08-21 00:30 | 하부 클램프 옆 플랜지 제거(`LOW_SIDE=False`, 볼트 6 → 2). 볼트 M6×15 [실측]. 카운터보어 깊이(Ø16×32.3)는 볼트 길이에서 역산(`assert rail_bolt_len() <= LOW_BOLT_LEN`). 부품 63.9 → 38.9 mm, 117 cm³. | 누르는 힘은 다리↔레일 지압(0.8 MPa, 1.3%)이 받고 볼트를 거치지 않는다. 옆 플랜지 24×8 캔틸레버 15 mm 의 굽힘 42 MPa 는 PETG 한계의 93%(AL 15%)라 툭 치니 부러진 것은 우연이 아니었다. 카운터보어 27.3 은 20 mm 볼트 전제였는데 가진 볼트가 15 였다. | 플랜지 유지 + M6×20 구매, 카운터보어 27.3 고정 | 유지(환경변수 `LOW_SIDE=1` 로만 복원). 08-21 02:47 플랜지 복원 FEA 가 변위 36배 개선으로 나왔으나 02:55 볼트 유격(통과공 0.6 mm)을 세니 오히려 7배 악화 — 다월핀(H7/h6)까지 가야 의미 있고 PLA 에는 못 쓴다. 대가: 같은 조건 변위 0.0073 → 0.0582 mm(8.0배). |
| 08-21 00:42 / 02:28 | FEA 기준값을 "800 N · 편심 55 · 상향 · 3 mm 메쉬에서 구조응력 45.3 MPa / 변위 0.0582 mm(AL6061-T6, 안전율 6.1)"로 통일. 최대 von Mises(150.1)는 인용 금지. 타이는 강체가 아니라 CalculiX `SPRING1` 접지 스프링으로. | 문서 3개가 서로 다른 조건(4.036 MPa 하향·편심 0 / 17.677 상향·편심 55)을 "기준"이라 불렀다. 최대응력은 강체 고정 구멍 벽 모서리(반경 3.30) 특이점이라 4 → 3 mm 에서 13.5% 오르고, 구멍 3 mm 밖은 +0.4% 로 수렴. 타이를 강체로 묶으면 실제보다 좋게 나온다. | 최대응력 인용, 폴더별 값 인용, 강체 타이 | 유지(`CLAUDE.md`·`FEA.md`·인수인계 §7). 다만 결과 폴더는 조건이 바뀌면 같은 이름으로 덮여 45.3 / 0.0582 는 지금 어느 `summary.txt` 에도 없고 문서에만 있다. |
| 08-21 01:19 \~ 01:55 | 보강은 좌우 클램프를 잇는 액슬 타이가 1순위. 평철 20×6(분담 64%) → M8 전산볼트 ×2(x=±24.3, z=−18.0, 클램프 안쪽면 탭). 바퀴 안쪽 이동은 접음. | 좌우 클램프가 서로 반대로 젖히므로 이으면 빔 안에서 상쇄되고 부재는 순수 인장(706 N). 레일볼트 인발 1,432 → 759 N(당시 계산; E 정정 후 385 N). 평철은 구매가 어렵고, 여분 390 프로파일은 16.6 mm 길고 축 끝과 겹치며 블록 24 \< 30. 바퀴 안쪽 이동은 하한 50.8 mm 라 2.9 mm(5%) 뿐. | 삼각 브레이스(바퀴 옆 공간), 레일 옆면 물기(716 N, AL 전용), 3060 구간 교체(프레임 변경), 바퀴 안쪽 이동, M10(벽 2.5 mm), 평철 | 부재가 뒤집혔다. 08-27 01:56 "저 봉을 사지 말고 남는 390MM 짜리 3030프로파일을 활용" → `TIE_KIND=profile`(08-27 01:56 행). 타이 자체는 유지. |
| 08-21 03:00 | 휘어짐 기준·PLA 전제에서의 순서: ① M8 타이(7.2배, 약 1만원) → ② 인필 꽉 채워 재출력(2배 더) → ③ 알루미늄 갈 때 T너트·플랜지 + 다월핀. 플랜지는 PLA 금지. T너트는 PLA 에서 병목이 아니니 지금 사지 않는다. | 사용자 "이전 클램프도 … 잘 버티고 다녔단 말이야 휘어짐이 문제였지"로 목적함수를 강도 → 휘어짐으로. 한 밤에 세 번 정정: 조인트 무름 미반영(타이만 236 kgf > T너트만 129), 볼트 유격 미반영(플랜지 7배 악화), 알루미늄 기준 계산(전산볼트 E 68,900 을 강철 206,000 으로). 손계산 113배는 FEA 7.2배 앞에서 틀렸다. | 강도 기준 순위(T너트 교체 4천원이 1위), 플랜지 복원 | 유지. 실물 검증(다이얼 게이지로 바깥 밀림 0.73 → 0.03 mm 예측)은 저장소에 기록이 없다. |
| 08-21 03:14 | 차량 프레임은 솔리드가 아니라 12자유도 보요소(`tools/frame/frame_fea.py`)로 푼다. 설계하중 800 N/바퀴 유지. | 3030 프레임을 3 mm 솔리드로 메싱하면 수백만 요소. 70 kg 이 한쪽 구석에 서면 그 바퀴에 865 N(대각 22 N) — 800 N 가정이 검증됐다. 프레임 응력 37 MPa(항복 22%)는 문제가 아니고, 타이 없으면 클램프가 전체 변형의 84%. | 솔리드 전체 FEA | 유지(`DESIGN_W=800`, `frame_fea.py` 재실행 값 0.078 / 0.379 / 0.161 mm 동일). T슬롯 코너 조인트 강성(강체 가정)·비틀림 J·충격계수는 없다. |
| 08-21 07:57 | 전산볼트 타이 길이는 유도값 397.4 가 아니라 400 mm 고정, 탭 15 mm 로 절단 공차 흡수(물림 13.3, 어서트 8 ≤ 물림 ≤ 탭−1). | "397.4mm 는 애매한것 같은데? … 가공 요청하기에 애매한 수치야". 1 m 봉에서 2개, 자투리 200×2. 같이 잡은 버그: 강철을 알루미늄 E 로, 자유길이를 봉 전체로 — 분담 47 → 73%, 레일볼트 830 → 385 N(26%). | 380(물림 3.3), 390 / 395, 410(탭을 더 깊게) | 유지(rod 모드). 그러나 `CLAUDE_HANDOFF.md` §5.0 은 지금도 397.4 / 물림 12×2 라 문서가 코드보다 낡았고, 08-27 01:16 통합 뷰어 레이블도 M8x403 으로 찍혀 고쳤다. |
| 08-21 08:08 | git 은 소스·문서·발주 확정 산출물(STEP/STL/DXF/도면/FEA summary·PNG)만. `exports/`·`refmodel/`·외부 바이너리·FEA 중간파일(\*.inp / \*.frd / \*.vtu) 제외. `.gitattributes` 로 LF 통일, 형상·이미지는 `-text`. | `git add -A` 가 617.5 MB / 501 파일(robot_vacuum.step 131 MB, output/ 724 MB). CRLF 가 섞여 `low_clamp.py` 에 `\r\r\n` 이 생겨 두 번 깨졌다. | 전부 커밋, git LFS(검토 안 함) | 유지 — 28.5 MB / 커밋 `14fb653` / 추적 256 파일. 09-10 BOM·통합 스크립트 수정분은 타이 360 vs 390 미결과 섞이면 안 돼 미커밋. |
| 08-22 11:55 / 14:01 | 클램프 재료 방침: 시험 단계는 PLA 꽉 채움 + 타이. 여름 야외는 PET-CF17(9만원/kg). PPS-CF10(18만원/kg) 살 예산이면 알루미늄 CNC. 알루미늄 3D 프린트(DMLS/SLM)는 안 쓴다. | 타이를 달면 PLA 꽉 채움만으로 바깥 밀림 −0.014 mm 라 강성은 더 살 이유가 없다. 재료를 바꿀 진짜 이유는 PLA Tg 60 °C(여름 차 안, 타이 인장 483 N 이 탭을 눌러앉힘). PPS-CF10 은 XY E 5,447 MPa(PLA 1.56배)·HDT 252 °C 로 강성이 아니라 열로 사는 재료. DMLS 는 4개 90\~350만원 vs CNC 25\~30만원인데 이 형상엔 DMLS 가 값하는 내부 유로·격자가 없다. | PPS-CF10, PLA-CF, PA6-CF20, DMLS AlSi10Mg | 유지. PPS-CF10 물성은 검색에 걸린 TDS 값이고 원문을 직접 연 기록은 없다. 프린터 노즐 최고 온도 확인(PET-CF17 가능 여부)은 남은 일. |
| 08-24 01:14 / 01:42 | 일체형 T텅(클램프 몸체가 슬롯 립을 직접 무는 안, 다리 40·텅 10 mm × 4)은 `TONGUE=1` 옵션으로 두되 기본 꺼짐 — 알루미늄 CNC 로 갈 때 같이 넣는다. 충전재(에폭시 그래나이트·강철 봉)는 실물 측정 뒤. | PLA 에서는 조인트 0.016 → 0.001 로 8% 개선인데 전폭 92.7 → 124.7(+35%)·체적 +54%. 알루미늄이면 2.7배. 텅 머리 밑면 4.1 mm 가 90° 오버행이라 FDM 하중면이 처진다. 마른 모래는 굽힘 강성 \~0. | 드롭인 T너트로 대체, 텅 45° 챔퍼(쐐기가 되어 립을 벌림), 지금 적용 | 유지(기본 0). 레일 참조모델과 461.6 mm³ 간섭은 대각 웹 단순화로 봤으나 실물 슬롯을 재봐야 확정. |
| 08-27 01:56 \~ 02:42 | 타이 부재를 `TIE_KIND=profile` 로 — 여분 390 3030 을 360 으로 잘라 클램프 안쪽면 M6 탭(x=±22, z=−6/−19)에 L자 코너 브래킷(6 mm, 이음부당 2)으로 문다. `rod` 로 되돌릴 수 있게 남김. 390 을 그대로 쓰려면 클램프 깊이 46.6 → 30 + 타이 X 오프셋 25 — 미결. | 사용자 "저 봉을 사지 말고 남는 390MM 짜리 3030프로파일을 활용하는 방법은 없을까?". 축 끝이 클램프 안쪽면보다 1.6 mm 안쪽(y=±185.1)이라 390(끝 ±195)은 축과 부딪힌다. 회전강성 8.89e7 vs 봉 7.96e7(+12%)이지만 FEA 변위는 0.2627 vs 0.2659 mm 로 1.2% 차이 — 병목이 클램프 몸체로 넘어가 무승부. "공중에 떠 있는 것처럼 보인다"는 브래킷 누락(6.7 mm 간극)이 맞았다. | M8 봉 구매, 368 mm(절단 치수 애매), 깊이 30 안("390 사이즈라니까 왜 360이야?" 에 대한 답, 미적용) | 현재 기본값이지만 확정은 아니다. `parameters.py` 는 profile / 360, `docs/bom.md` 는 "3030 L360 ×2 + PLA 브래킷 8 + 드롭인 T너트 8", `CLAUDE_HANDOFF.md` §5.0 은 아직 M8×397.4 — 셋이 일치하지 않는다. 브래킷 슬롯 볼트가 1,268 N 을 미끄러지지 않고 받는지(볼트 수 근거)는 확실하지 않다. |
| 09-10 10:52 \~ 11:03 | BOM 은 손으로 적지 않고 형상에서 뽑는다(`tools/bom/bom.py` → `docs/bom.md`·csv): 수량·부피·질량·절단은 코드, 사람은 `PRICE` 표만. 확인 태그 4개(프로파일 950/100 mm, 브라켓 360, M6×15 70, 스프링너트 180)만 실주문 값. 조달은 보유/출력/구매로 갈라 "전부 신품" 1,976,478원과 "추가 지출" 1,504,638원을 따로 낸다. 큰 셸 4종은 판재 대안(−292,427원, −309 h)을 문서에 남긴다. 통합 뷰어 스크립트는 볼트 길이·타이를 `parameters` 에서 읽는다. | `vehicle_shell_integration.py` 가 볼트 20 mm 고정·타이 없음으로 낡아 있었다. 출력 총량 14,600 cm³ / 406 h, 베드(220×220) 초과 14건 — 적재함 셸 24조각은 설계가 아니다. | 손 BOM, 셸 전부 출력 | 유지, 판재 전환은 미확정. 전자·제어 495,000 / 센서·표시 382,000원은 대부분 추정 단가라 배로 틀릴 수 있다. |

65_frame_load_cases

47_skid_view_iso

## 무엇이 결정을 뒤집었나

뒤집힌 15건과 일부 바뀐 8건의 계기를 세어 보면 겹치는 것을 포함해 다음과 같다.

- **실물·실측**(9건 안팎): 6.5인치 STEP 실측(Ø158.7, 축 Ø16 단면 D컷)이 8인치·Ø12 양면 전제를 지웠고, 0.1 mm 스캔이 축 너트·줄 작업을 지웠고, PETG 출력품 파손 두 번(08-12 ㄷ자 팔, 08-21 옆 플랜지)이 ㄷ자와 3면 마운트를 지웠고, 가진 볼트가 15 mm 라는 사실이 카운터보어 27.3 을 지웠고, 장공 8.128 이 인치 라운드값이라는 사실이 M8 을 지웠다.
- **사용자의 한 줄**: "전동휠 제품에 들어가는 것도 이런 인휠모터 아닌가?"(구동계), "휠 브라켓을 그냥 프로파일로 대체할까?"(휠포스트), "기존 클램프 정도의 크기와 높이를 가진 부품을 하나 더"(하단 클램프), "아니야 우리 관통볼트 아니야"(비교표 전체), "휘어짐이 문제였지"(목적함수), "남는 390MM 짜리 3030프로파일을 활용"(타이 부재). 방향을 바꾼 제안의 대부분이 사용자에게서 나왔다.
- **근거 없던 상수의 정정**: μ=0.8 → 0.5, 볼트 320세트 → 162\~218, 스프링 13 N/mm(정지 처짐 92%), `MODULE_TOP = WHEEL_D + 20`(트래블 3\~6 mm), `TNUT_PULLOUT` 4,000 고정(36% → 96%), 전산볼트 E 68,900(분담 47% → 73%), 관통볼트 전제(20% ↔ 72%).
- **비용·조달**: 허브모터 배제(5만원 이하), 판재 6종 가공 4\~20만원, 조향 모터·쇼크 국내 조달, 평철 구매 어려움, CNC 당분간 불가.
- **리서치**: 적재함 170 L 가 업계 27\~50 L 의 4배.

## 확실하지 않은 것

- 액슬 타이의 최종 부재. 코드 기본값은 3030×360 + 브래킷, BOM 도 같지만, 인수인계 §5.0 은 M8×397.4 이고 "390 그대로(클램프 깊이 30)" 안은 답을 못 받은 채 끝났다. 어느 쪽이 실물에 달렸는지 저장소만으로는 알 수 없다.
- M6 스프링너트 인발력 실측 여부. 1,500 N 보수 하한이 차량 허용하중의 병목인데 실측 기록이 없다.
- 타이 장착 후 바퀴 바깥 밀림(예측 0.03 mm 근처)을 다이얼 게이지로 쟀는지.
- Design D 하부 클램프가 알루미늄 CNC 로 갔는지 — 08-21 시점 "당분간 PLA" 이고 BOM 도 PLA 다.
- 무게중심 실측 — 축간 420 은 이것이 나와야 확정이라고 두 번(07-27, 08-01) 적었지만 실측이 없다.
- 핸들 탈착식·셸 휠아치 4곳·스커트 지상고 재조정은 권고·남긴 일로만 있고 코드에 반영되지 않았다.
- 08-12 이후의 결정(파손·Design D·타이·재료)은 `docs/build-log.md` 에 없다. 이 문서의 5·6장 분량은 일지와 코드·인수인계 문서에서만 나온다.

## 교훈

- 문서상 완벽했던 결정이 실물 한 번에 무너졌다. 20 mm 볼트 전제의 카운터보어 27.3, "여유 7배"의 ㄷ자, "1 mm 나사부"의 축 너트가 그랬다. 실측·출력·조립 한 번이 계산·문서 검증보다 값어치가 컸다.
- 근거 없는 자리표시자가 결정을 조용히 왜곡했다. 13 N/mm, 4,000 N, E 68,900, μ 0.8 은 계산해 보기 전까지 표 전체를 틀리게 만들었다. 상수는 유도값으로 바꾸고 어서트를 둔다.
- 순위는 목적함수(강도 / 휘어짐)와 재료(AL / PLA)와 전제(관통볼트 / 스프링너트)에 따라 뒤집힌다. 08-21 한 밤에 세 번 정정된 것이 그 증거다. 비교표에는 전제를 반드시 붙인다.
- 결정을 코드에서 지우지 않고 옵션으로 남긴 것(`DRIVE`, `MOUNT`, `LOWER_COVER`, `PAYLOAD`, `LOW_SIDE`, `TIE_KIND`, `TONGUE`, `PRINT`, `CLAMP_BOLT`)이 되돌리기와 A/B 비교를 가능하게 했다. 대신 문서(인수인계 §5.0 의 397.4, build-log 의 360/840, bom 의 933 N)는 코드보다 늦게 썩는다 — 결정을 바꾸면 세 곳을 같이 본다.
- "안 된다"는 결론은 조건을 바꿔 다시 본다. 390 프로파일은 그대로는 안 됐지만 클램프 깊이를 바꾸면 되는 문제였고, 하단 클램프는 관통볼트 전제를 빼자 답이 달라졌다.
- 같은 실수가 세 번 반복된 항목이 있다 — 라운드 셸이 사각 프레임 코너를 파고드는 것(0.293R), 눈대중 좌표가 턱을 만드는 것(ㄷ자 벽 9/블록 22, 하단 클램프 1 mm), `Plane.XZ` 법선 부호. 세 번째에 규칙·헬퍼·assert 로 봉인됐다.
- 결정의 절반은 사용자의 질문에서 나왔다. "왜 필요하냐", "떠 있는 거 아니냐", "굳이 그 형태여야 하냐" 같은 질문이 빠진 부품과 잘못된 전제를 찾았다.
