chungddong/NUBI/docs/worklog/topics/vehicle-2026-09-15-lessons.md

# 차체 설계 삽질과 교훈 (2026-07 ~ 09)

> 영역: 차체 · 작성: 2026-09-15 · 원본: 차체 설계 일지 `synth_lessons.html` (2026-10-13 Markdown으로 옮김)

2026-07-27 18:11 KST 에 T슬롯 단면 하나를 그리는 데서 시작해 09-10 BOM 까지, 일지 21편(07-27 \~ 09-15)에 흩어져 있던 "막힌 것"과 "교훈"을 모아 주제별로 다시 묶은 문서다. 원본은 각 구간 일지이며, `docs/build-log.md` 29절(Claude 가 틀렸던 것들, 29행)·30절(방법론)과 겹치는 07-27 \~ 08-09 구간은 짧게 줄이고, 그 뒤에 새로 생긴 것 — 08-12 실물 파손, 08-21 이후의 FEA·액슬 타이·체결 — 을 충실히 적었다. 항목마다 **막힌 것 → 원인 → 해결** 순서로 쓰고 끝에 일반화한 교훈을 둔다. 시각은 전부 KST 다. 횟수는 일지 본문에서 확인되는 것만 셌고, 일지 자체가 "확실하지 않다"고 적은 곳은 그대로 옮겼다.

## 0. 같은 함정에 여러 번 빠진 것 — 횟수표

먼저 반복된 것부터 센다. 한 번 걸린 함정은 운이 나빴다고 할 수 있지만, 아래는 최소 4회 이상 같은 모양으로 되풀이된 것들이다.

| 함정 | 확인된 횟수 | 언제 | 결국 어떻게 봉인했나 |
| --- | --- | --- | --- |
| 부재(不在)를 결합으로 착각 — "떠 있음" | **9회** (그중 사용자 지적 6회) | 07-27 중앙 빔 15 mm / 07-28 킹핀 5.5 mm · 베어링·벨트 없음 · 조향모터 / 07-29 셸 z 50\~126 띠 · 셸 고정 없음 / 07-30 핸들이 3 mm 셸에 매달림 / 08-10 크래들 두 조각 · 뚜껑·지붕 0.5 mm 틈 / 08-27 타이 브래킷 누락 6.7 mm | 연결성 검사(합집합 솔리드 수 = 1), 하중 경로를 부품 단위로 짚기. 간섭 검사는 겹침만 보지 부재는 못 본다 |
| 절대값·눈대중 상수가 다른 치수 변경에 딸려 깨짐 | **10회 이상** | 07-29 `MODULE_TOP = WHEEL_D + 20` / 07-31 `SUS_PIVOT`·`SHOCK_TOP` 절대 z / 08-01 지그 포락선 어서트 절대 z / 08-07 ㄷ자 치수 제각각(턱) / 08-10 타이다운·손잡이 홈·힌지·잠금·스트라이커·절단면 / 08-12 하단 클램프 다리 1 mm 턱 / 08-21 카운터보어 27.3 손박음 / 08-27 `M8x403` 라벨 / 09-10 `M6x20` 라벨 | 기준 부재에서 역산하는 관계식 + assert. "값을 직접 쓰지 말고 역산하게 만든다" |
| 문자열 치환·히어독으로 파이썬 소스를 고치다 깨짐 | **13회 이상** | 07-27 일괄 치환 AssertionError / 07-28 f-string 따옴표 SyntaxError · 슬라이스로 함수 중복 정의 / 07-29 `def …():def …():` / 07-30 앵커 `D = 20000` vs 30000 조용히 실패 / 07-31 sed → SyntaxError / 08-05 큰 치환 미적용 / 08-12 히어독 `\n` 이 실제 개행 · 앵커 2회 오타 / 08-21 SyntaxError 3회(`\`+개행, CRLF `\r\r\n`) · 히어독 3회 · frame_view 패치 3회 | Edit/Write 로만 고치고, 치환 뒤 grep·`ast.parse` 로 확인. 세 번 어긋나면 통째로 다시 쓴다 |
| ocp_vscode 뷰어 "안 보인다" | **12회 이상** | 07-27 ×2, 07-28, 07-31, 08-04, 08-07, 08-10 ×2, 08-12, 08-14, 08-27 ×2 (아래 4장) | 브라우저 먼저 → 스크립트 나중. 생사는 `show()` 성공 여부로 판정 |
| `Compound(children=...)` 재부모화로 부품이 사라짐 | **4회 확인** (build-log 는 3회 시점 기록) | 07-29 도면 HLR 1,500 → 22선 / 07-30 뚜껑 렌더 / 08-01 렌더 `AssertionError` / 08-01 스탠드 export | 뷰마다 새 사본을 만든다 |
| `Plane.XZ` 법선이 −Y | **4회** | 07-29 스커트가 모델 밖으로 / 08-14 축 두 조각 · 모터 위치 · 포켓 위치 | `plane_at_y(y) = Plane.XZ.offset(-y)` 헬퍼로 봉인 |
| 라운드 셸이 사각 프레임 코너를 파고듦 (0.293R) | **4회** | 07-27 v4 커버 835 mm³ / 07-28 스워브 셸 8,677 mm³ → 6조각 / 07-28 모터판 1,241 mm³ ×2 / 07-30 라이너·장비바닥 20,908 mm³(유사) | `assert SHELL_X − SHELL_T ≥ BASE_L/2 + 0.293·(SHELL_R − SHELL_T)` |
| 하중 경로 일부만 보고 "안전" 판정 | **3회** (08-12 자백) **+ 08-21 한 밤 정정 3회** | 08-07 횡력만 → 실물 파손 / 08-12 커플 힘을 볼트 전단으로 · 개수 미분할 / 08-12 하단 클램프 3개만 집음 / 08-21 조인트 무름 · 볼트 유격 · 재료 E | `report_loads()` 로 경로 전체 자동 훑기, 국부 응력은 FEA, 표에 전제(재료·목적함수) 명기 |
| 검사기·렌더 코드 자체가 틀림 | **14회 이상** | 2장에 정리 | 결과가 너무 규칙적이거나 전부 참이면 모델보다 검사기부터 의심 |

## 1. 기하·CAD 함정

대부분 build-log 1\~3막·20막·29절에 이미 있다. 여기서는 한 줄씩만 남기고, 그 뒤에 새로 겪은 것을 붙인다.

- **T슬롯 단면이 5조각(07-27 18:11).** 사각형에서 T홈 4개를 빼니 코너 기둥 4개(33.79 mm²)가 중심 보스(56.71 mm²)와 끊겼다 → "빼기"가 아니라 튜브+기둥+보스+리브를 "쌓기"로 그리자 3시리즈 모두 솔리드 1개. 지금 `tslot.py` 도 187.59 / 384.10 / 821.34 mm² 그대로다.
- **중앙 빔이 15 mm 떠 있었다(07-27 19:03).** 간섭은 전부 OK 였는데 연결성 검사가 솔리드 2개를 뱉었다. `WHEELBASE − 2·S` → `WHEELBASE − S`. "안 부딪힌다"와 "붙어 있다"는 다른 검사다.
- **관통 부품(그로밋)은 판과 겹치는 게 당연(07-27 20:58).** 처음부터 판을 무는 형태로 모델링해야 간섭 검사가 의미를 가진다. 대신 플랜지가 판 위로 솟아 전고가 331 → 335 로 바뀐다.
- **같은 그룹 안의 쌍은 검사에서 빠진다(07-28 01:45).** 데크 레일과 엔드 스톱의 겹침이 그렇게 숨어 있었다. 08-10 적재함에서도 연결성 검사를 안 돌리고 있다가 크래들 두 조각과 뚜껑·지붕 0.5 mm 틈(원래부터 있던 버그)을 렌더로만 발견했다.
- **실물 STEP 을 통째로 넣지 않는다(07-28\~29).** 라즈베리파이 STEP 은 솔리드 516개라 검증이 10분을 넘겼다. 외형 박스 + `PI_DETAIL` 플래그. 허브모터 STEP 도 테셀레이션이 뷰당 10분이라 `HUB_MOCK=1` 로 갈랐다 — 그러자 목업에 축이 없어 브라켓이 허공에 뜰 뻔했고 목업에도 D컷 축을 넣었다.
- **움직이는 설계는 각도를 스윕해야 한다(07-29 00:36).** 트래블 25 mm 라고 적혀 있었는데 실제 3\~6 mm 였다. 07-28 의 스트로크 검사가 왜 OK 로 나왔는지는 일지만으로는 확실하지 않다. 정지 간섭 0 이어도 스톱이 작동 범위 끝에서 닿으면(±91.5° 설계, +90° 에서 80 mm³) 방해물이다 → ±99°.
- **동시에 걸 수 없는 애니메이션 트랙(07-28).** three.js 오일러 순서 때문에 조향(rz)·구름(ry)을 같이 걸면 90° 에서 엉뚱한 축으로 구른다. 트랙을 맞추지 말고 회전부를 킹핀 원점 Compound 로 묶어 구조로 못 박았다. `Animation()` 은 `show()` 뒤에, 경로 루트는 `/Group`.

01_tslot_section_2020

**08-12 이후 새로 걸린 기하 함정.**

- **ㄷ자 팔이 베이 바닥판을 2,100 mm³ 씩 뚫었다(08-07 04:04).** 위팔이 레일 윗면 위로 10 mm 올라오는데 판이 정확히 z=200.7 에 깔려 있었다 → 마운트 bbox 에서 자동으로 따내는 노치(`_NOTCH_FIT = 2.0`). 08-12 거싯을 넣자 이번엔 거싯 윗단이 판 위로 32 mm 올라왔다.
- **"조립 가능한가"는 간섭과 다른 검사다(08-01 17:39, 08-07 01:50, 08-14 23:31).** 축 끝 원형 구간 1.5\~3.5 mm 와 반대쪽 숄더 때문에 닫힌 D컷 보어는 아예 못 끼운다(호버보드 프레임이 전부 열린 슬롯인 이유). 아래팔 볼트는 구멍 간섭이 없어도 렌치가 기둥에 막혔다 → `HEX_R = 6` 을 공구 여유로 assert. Design C 에서는 아래 슬롯줄(z 74.3)이 블록 살 속에 묻혀 볼트를 넣으려면 알루미늄 47 mm 를 뚫어야 했다. 낙하 경로(위에서 떨구기)도 따로 확인했다.
- **ㄷ자 슬롯 30.000 은 안 끼워진다(08-07 03:23).** 압출 공차 ±0.2\~0.3 이라 30.2 짜리 레일이 안 들어간다. `RAIL_FIT = 0.4` 를 **아래팔에만** 줬다 — 위팔 밑면은 볼트가 미끄러졌을 때 수직 하중을 받는 자리라 딱 맞춰야 한다. 검증에서 두 번 헛짚었다: 레일 상자를 중심 기준으로 키워 위팔에 닿았고(414.6 mm³), 높이·폭을 같이 키워 웹 쪽에 가짜 간섭(211.4 mm³). ㄷ자는 Z 로만 감싸고 +Y 가 열려 있어 폭은 애초에 못 물린다. **물릴 수 있는 축을 먼저 정하고 그 축만 흔든다.**
- **FDM 은 CNC 치수가 아니다(08-07 03:45).** 내부 치수 0.1\~0.3 축소, 수평 구멍 처짐, 플라스틱 탭 하공 → `PRINT=1` 로 슬롯 30.4 → 30.8, 레일 볼트공 Ø6.6 → 7.2, 탭 하공 Ø5.0 → 5.3. 프린트 파일은 `bed()` 로 눕혀 바닥 z=0 에 앉혀 내보낸다(접촉 64 cm², 서포트 0). 프린트판 DXF 는 눕힌 부품을 로봇 좌표로 잘라 43 → 7 cm² 로 깨져서 아예 뺐다.
- **3030 참조 단면이 틀려 검증이 틀린 것을 통과시켰다(08-15 12:51).** 외형은 30.00×30.00 이었지만 ±Z 면에 슬롯이 없고 보어·언더컷도 없었다(286 mm²). Design D 의 밑면 볼트 2개가 **슬롯 없는 면으로 들어가는데도 간섭 0**. 4면 T슬롯 + 45° 웹 + Ø6.8 보어로 다시 만들었다(406 mm²). 참조가 틀리면 검증이 거짓 안심을 준다.
- **새 부품 치수를 "30 이면 되겠지"로 찍으면 턱이 생긴다 — 두 번(08-07 01:43, 08-12 22:56).** ㄷ자는 블록 깊이 39.22 / 팔 34 / 전폭 65 / 벽 9 가 제각각이었고, 하단 클램프는 다리를 x=±30·폭 14 로 박아 1 mm 턱이 남았다. 둘 다 세 상수(`MNT_W, MNT_D, WALL` / `LOW_W, LOW_POST_W`)에서 유도하도록 바꿨다.
- **어서트는 대상과 부등호를 의심해야 한다(08-07 01:43, 08-14 23:31, 08-15 08:56).** "블록이 D컷 평면 안에" 는 대상이 틀렸고(평면 안에 있어야 하는 건 기존 클램프), "팔 > 레일 바깥면" 은 flush 인 정답을 오류로 잡았으며, 핀치갭 어서트는 부등호가 반대였다(채널 5.07 > 평면 5.0 이므로 갭 > 0.07 이어야 클램프가 축에 앉는다). 어서트 메시지에는 "무엇을 하면 되는지"를 넣는다 — `CLAMP_BOLT=8` 이 죽을 때 "못 지난다"만 찍히던 것을 "실물을 재서 `CL_SLOT_W` 를 고치면 통과한다"로 바꿨다.

## 2. 검사기·렌더 코드 자체의 오류

build-log 20막·30절이 "검사기를 먼저 의심하라"로 정리한 것이다. 그 뒤로도 같은 종류가 계속 나왔다. 확인된 것만 모으면 14건이 넘는다.

| 날짜 | 틀린 검사기·렌더 | 증상 | 원인 → 해결 |
| --- | --- | --- | --- |
| 07-28 18:06 | 킹핀 부유 진단 | "−103.2 mm" 라는 엉뚱한 값 | bbox 로 계산. 하우징 반경 29.5 로 다시 재니 5.5 mm |
| 07-28 21:28 | 모터 위치 진단 | "모터가 떠 있다" 오보 | 그룹의 첫 솔리드(풀리)만 읽음. 몸체는 z 306\~396 에 제대로 있었다 |
| 07-29 23:47 | 간섭 검사 리프 스캔 | 킹핀축 4개가 전부 같은 부재와 같은 부피로 겹침 | 조상 Location 미누적 → `walk()` 로 월드 좌표 누적. "너무 규칙적"이 신호 |
| 07-29, 07-30 | HLR 곡선 샘플링 폴백 | 화면을 가로지르는 가짜 선 | 실패 엣지는 버리고 300/1000 mm 넘는 선 제외, 평면도에서 안테나 제외 |
| 07-31 09:35 | 도면 `HIDDEN` 집합 | 상단 데크판이 도면에서 사라짐 | HLR 죽었을 때 넣은 "판재" 숨김이 재부모화 원인이 밝혀진 뒤에도 남아 있었다. 숨김 자체를 없앰 |
| 08-07 02:27 | STL 되읽기 | `Mesher.mesh_shapes()` 없음 | `Mesher.read()` 반환값 직접 사용 |
| 08-07 03:39, 14:25 | 단면 성질 계산 | Iyy 6,667 (정답 726,667) | 평행축 정리 누락. 손계산 2×10×40³/12 = 106,667 과 대조해 잡음 |
| 08-07 03:52 | 인치 환산 판정식 | 7개 치수 전부 "인치로 딱 떨어진다" | 임계값이 어떤 수든 참. 고치니 R·구멍 3개만 떨어짐 → 8.128 은 타이핑값 |
| 08-07 03:23 | 끼워맞춤 검증 상자 | 30.2 레일이 "안 들어간다" | 폭·중심까지 같이 키움 → 높이만 흔든다 |
| 08-07 04:04 | 코너 확대 렌더 반경 필터 | 사이드레일 누락 | 레일 중심 x=0 이라 필터에 안 걸림 → 레일을 잘라 넣음 |
| 08-15 08:56 | `iso_render` 접지면 원판 | 렌더가 두 번 "두 조각"으로 보임 | 원판을 z=0 에 고정했는데 이 패키지는 z=0 이 축 중심 → min(0, 모델 밑면) |
| 08-15 02:05 | `TNUT_PULLOUT` | 밑면 볼트 인발 35.8 % | M8 값 4,000 고정 → 볼트 굵기에서 유도하니 1,432 / 1,500 = **95.5 %** |
| 08-21 00:38 | FEA 측면 구멍 노드 선택 | 플랜지 없는 형상인데 옛 경계조건인 척 돌 뻔함 | 무조건 선택 → `P.LOW_SIDE` 로 감싸고 최소 고정노드 18 → 6 |
| 08-21 01:19 | 젖힘 모멘트 그림 | 회전 방향이 반대 | 레일 고정·바퀴가 바깥으로 나가야 하는데 축 중심으로 돌림. 세 번째 판에서 수정 |
| 08-21 01:55 | 타이 렌더 `Pos(0,±210,0)` | 봉 끝이 클램프를 19.1 mm 넘는 것처럼 보임 | 클램프 로컬 중심이 y=−53.7 → ±263.7. **모델은 맞고 그림만 틀린 경우** |
| 08-21 02:47 | FEA 타이 노드 선택 | 1,080개 잡힘(정상 10개) | 총강성은 같아 결과는 유효. 고쳐졌는지는 확인하지 못했다 |
| 08-21 02:28, 03:00 | `tie_force()` | 타이 분담 47 % | 강철 전산볼트를 알루미늄 E(68,900)로 계산 → 206,000. 자유길이도 봉 전체로 잡고 있었다 → 73 % |

같은 종류의 잔 오류도 여럿이다: `'ShapeList' object has no attribute 'volume'`(07-27), `'ShapeList' … 'bounding_box'`(07-31, `intersect` 가 Shape/ShapeList 를 섞어 반환 → `hasattr` 분기), `NoneType.volume`(08-01 스윕, 08-07 빈 교집합 → `_ivol()`), 필렛 `ValueError`(08-10 → try). 검증 코드도 코드다. **결과가 이상하면 모델보다 검사기·렌더를 먼저 열어 본다.**

## 3. 실물과 모델의 차이

build-log 22·24막·29절의 결론은 "가정을 실측으로 착각하는 것"이었다. 이 항목이 프로젝트에서 가장 비싼 오류를 냈다 — 실물이 두 번 부러졌다.

**3.1 치수 가정이 파생값 전체를 끌고 간 것 (요약).**

- 바퀴 Ø210×58 은 PVC 통바퀴 스펙이었는데 호버보드로 바꿀 때 주석만 바꿨다(07-31 19:46). 여기 AXLE_Z 105 → SWEEP_R 109 → MODULE_TOP 248 → DECK_Z 451 이 줄줄이 매달려 있었다. 실물 STEP 실측은 **Ø158.7×55**(6.5인치 공칭 165 도 아님), 축 Ø16·D컷 1면(예상 Ø12 양면). "주문 전 실측"이라 써 둔 항목은 전부 예상과 달랐다.
- 3 mm 간격 스캔은 "−48\~−3 D컷", "Ø14 나사부 3 mm" 라고 답했다(08-01 01:49). 0.1 mm 스캔은 평면이 **−46.5\~−3.7**(42.8 mm) 이고 나사부는 없으며 1 mm 모따기라고 답했다(08-02 02:27). 1.5 mm 차이가 34 mm³ 간섭이었고, 존재하지 않는 부품(축 너트)과 축 스택 5+8+24+8 = 45 설계 전체가 그 위에 서 있었다. 사용자의 "애초에 너트 끼울 형태가 아닌데"가 결정타.
- 기존 클램프 STEP 은 격자 단면까지 찍어야 채널이 보였다(08-07 01:24). 채널 깊이 5.07 = D컷 평면 높이 — 이 사실 하나가 회전 방지 설계를 통째로 없앴다. 구멍 Ø8.128 은 정확히 0.3200" 라 실측이 아니라 타이핑값이었고, 그래서 볼트가 M8 → M6 로 바뀌었다(08-07 03:52).
- Xtion 치수를 (180, 41, 36) 으로 반올림해 옮겨 적은 탓에 0.3 mm 가 406 mm³ 간섭이 됐다(07-29 01:16) → STEP bbox 를 런타임에 읽는다.
- 3030 은 100 mm 단위 올림 과금이었다(08-01 14:58). 절단 길이를 먼저 100 배수로 잡고 프레임을 역산하도록 뒤집자 지그 버림 640 mm(13 %) → 40 mm(1 %). 단가도 900 이 아니라 **950원**이었다(08-05 장바구니 사진). 버림을 줄여도 단위 경계를 안 넘으면 돈은 안 준다.
- "기둥 사이에 끼우는 부재"와 "기둥 위에 얹는 부재"는 길이 규칙이 반대다(08-01 14:12). 같은 식을 써서 상단 가로대가 30 mm 짧았다.

60_hub_motor_real

**3.2 실물 파손 1 — ㄷ자 마운트(PETG) 팔 파손 (08-12 20:32).**

> 내가 올라타는 등 하중은 버티긴 했는데 하중구조가 분산이 잘 안된건지 바퀴가 점점 바깥쪽으로 밀리드라 브라켓 상단 고정부분도 금이 가기도 했고 … 옆에 살짝 부딛혔는데 그게 트리거가 되서 브라켓 하나가 박살이 나버렸어

**막힌 것**: 08-07 계산은 "횡력 파단 1,519 N vs 마찰 최대 218 N, 여유 7배" 였다. **원인**은 형상이 아니라 하중 경로 가정 세 가지였다. ① 하중 케이스가 89 kg 로봇 자중뿐이고 사람이 올라타는 경우가 없었다. ② 파괴 위치인 ㄷ자 팔을 보 단면(Zx 18,454 mm³)으로 쟀는데 실제로는 웹에서 뻗은 **외팔보 판**이라 볼트공을 뺀 순단면 Zx 는 947 mm³ — **19배** 차이. ③ 수직하중이 접지점(y=0)에 걸리는데 그립 중심은 y=−55 라 800 N 에서 44 N·m 의 오프셋 모멘트가 있는데 넣지 않았다. 다시 계산하니 218 N 에서 팔 14.6 MPa(32 %), 탑승 균등 414 N 27.7 MPa(61 %), 한쪽 600 N 40.1 MPa(89 %), 한 바퀴 800 N **53.5 MPa(119 %)** — "자중은 멀쩡 → 탑승하면 점점 밀림(크리프) → 상단에 금 → 살짝 부딪히자 박살"이 표의 순서와 맞았다. **해결**: 경로의 모든 단면을 자동으로 훑는 `report_loads()` 를 모델에 넣었고, 삼각 거싯 6장으로 팔 Zx 1,167 → 6,205(119 % → 18 %). 그러면서 볼트 모델 오류 두 개를 더 잡았다 — 커플 힘 약 2,200 N 을 볼트 전단 지압으로 놨는데 실제는 팔이 레일 면을 누르는 접촉압이고, 팔당 볼트 2개인데 1개에 다 걸고 있었다(레일 볼트 인장 1,467 → 733 N). 그대로 뒀으면 "인발의 98 %"라고 잘못 경고할 뻔했다.

거기서 끝이 아니었다. 사용자의 "볼트 높이가 머리까지 20 mm 될까말까"(08-13 00:18)에 계산하니 팔 10 + 와셔 1.6 + 레일 여유 0.4 + 슬롯 립 2.4 = 14.4 mm 까지는 나사산에 닿지도 않아 M6×15 는 **물림 0.6 mm** 였다. 프레임 코너 브라켓(4t)은 같은 볼트로 물림 8.6 이 나오니 휠 마운트에 같은 볼트를 쓴 것이 문제였다. "점점 밀림"의 세 후보(팔 크리프 / 볼트머리 파고듦 / 애초에 안 물림) 중 셋째가 제일 그럴듯했다. `rail_bolt_len()` 어서트, `RAIL_BOLT_L = 25`. 웹 검색으로 모은 사례에서도 자주 보고되는 고장은 파손보다 **볼트 풀림**이었다.

사용자가 "ㄷ자를 바깥에서 끼운 게(웹이 바깥) 원인 아니냐"고 사진과 함께 물었을 때(08-13 01:06)는 가설과 반대 결과가 나왔다 — 실물은 웹이 바깥에 있어 바깥 방향 지압이 있었는데도 밀렸다. 답은 "있지만 작다": 물림 0.6 mm 와 팔 119 % 가 10배 규모의 문제라 방향은 세 번째다.

**3.3 실물 파손 2 — Design D 옆 플랜지 파손 (08-21 00:30).**

> 양 옆 기둥같은 것은 툭하니까 부러지더라고 … 해놓고 보니까 솔직히 불필요하겠더라고 … 우리가 가진 m6 나사가 20mm 가 아니라 15mm 이더라고

**막힌 것**: 08-15 에 "3면 감싸기"로 넣은 레일 옆면 플랜지(24×8, 캔틸레버 15 mm)가 PETG 출력품에서 부러졌고, 가진 볼트는 20 이 아니라 15 mm 였다. **원인**: 플랜지 굽힘 42 MPa 는 PETG 한계(45)의 93 %, AL6061(276)의 15 % — 우연이 아니라 재료가 바뀌면 판단이 뒤집히는 항목이었다(08-21 02:28 에 계산). 볼트는 카운터보어 Ø16×27.3 이 오로지 20 mm 볼트를 쓰려고 판 것인데(그립 11.60 + 립 2.4 + 물림 6 = 정확히 20.00, 여유 0) 어서트 7개 중 볼트 길이를 지키는 것이 없었다. 인수인계 문서 대조(00:17)에서는 이 사실을 "문서에 없다"고만 찾았고, 실물이 그 30분 뒤 답을 줬다. **해결**: `LOW_SIDE = False`(볼트 6 → 2), `LOW_BOLT_LEN = 15.0` [실측], 카운터보어 깊이를 볼트 길이에서 역산(Ø16×32.3), `assert rail_bolt_len() <= LOW_BOLT_LEN`. 부품 63.9 → 38.9 mm, 137.0 → 117.2 cm³. 사용자의 하중 경로 관찰("누르는 힘은 다리 윗면 지압이 받고 볼트를 거치지 않는다")이 맞았고, "프레임을 들어올리면 볼트 2개가 바퀴 무게를 다 받는다"는 걱정은 15 N / 1,500 = 1 % 로 문제가 아니었다. 남은 것은 레일 밑면 볼트 인발 1,432 / 1,500 = 95.5 % 하나 — 이것이 4장의 타이로 이어진다.

**3.4 아직도 안 잰 것.** M6 스프링너트 인발력은 2026-09-15 현재도 실측되지 않았다. `parameters.TNUT_PULLOUT = 1500`(보수 하한)이고 `docs/bom.md` 에는 933 N(경제형) / 2,271 N(드롭인) 이라는 립 굽힘 모델 추정치가 따로 적혀 있어 문서 간에 일치하지 않는다. 08-21 00:58 계산에서 알루미늄 클램프는 6.1배 강해지지만 그 순간 병목이 이 너트로 옮겨가 1.05\~2.8배로 깎인다 — **유일하게 안 잰 값이 하필 병목이다.** 클램프 가정값 (50, 40, 44)(08-05)은 실물 STEP 으로 대체됐고, 레일 실제 높이·축 실제 지름 캘리퍼 실측은 08-21 출력·조립 시험에서 "치수는 맞았다"로 대신 확인됐다.

## 4. 액슬 타이 — 세 번의 정정 (08-21 \~ 08-27)

63_why_tipping_moment

타이어 접지점이 축 그립 중심보다 53.7 mm 바깥이라 800 N 에서 43 N·m 의 젖힘 모멘트는 어떤 브라켓이든 생긴다. 좌우 클램프의 아랫부분은 서로 반대 방향으로 벌어지므로 둘을 이으면 그 부재는 순수 인장만 받는다 — 이것이 출발점이었다. 형상은 평철 20×6 → M8 전산볼트 ×2 → 여분 3030 프로파일로 세 번 바뀌었고, 판단은 그보다 더 자주 뒤집혔다. 08-21 한 밤에만 결론이 세 번 정정됐다.

- **타이 체결볼트가 바 끝 밖에 있었다(08-21 01:43).** `TIE_LAP=30` 이 원인. 검증은 통과했고 렌더에서만 보였다 → 겹침을 클램프 깊이 전체로, 어서트 추가. 바 433 → 466.6 mm.
- **여분 390 mm 3030 은 그대로는 못 쓴다(01:55).** 클램프 안쪽면 사이 373.4 mm 라 16.6 길고, 축 끝이 안쪽면보다 1.6 mm 튀어나오며, 블록 높이 24 \< 30 이라 끝면이 얹힐 자리가 없다. 순수 인장 706 N 에 3030 은 100배 과잉, 평철은 구하기 어렵다 → M8 전산볼트 ×2(x=±24.3, z=−18.0). 이때 "1m 봉 1개면 4개 다 나온다"고 적었다가 02:30 에 정정했다 — 397.4×4 = 1,589.6 이라 2개.
- **정정 1 — 조인트 무름을 안 셌다(02:42).** FEA 는 볼트 구멍을 강체로 고정해 너트+슬롯 립의 무름을 아예 안 세고 있었다. 립 강성과 너트 굽힘을 직렬 합성하면 경제형 스프링너트 23,430 / 드롭인 T너트 98,415 N/mm — 박판 너트는 자기가 먼저 휘어 립 강성의 1/3 밖에 못 쓴다. 그래서 "T너트 교체(4천원)가 제일 싸고 효과 크다"던 첫 결론이 **타이만 236 kgf > T너트만 129 kgf** 로 뒤집혔다.
- **정정 2 — 볼트 유격을 안 셌다(02:55).** 플랜지 복원 FEA 는 축 시트 밀림 +0.0007 mm 로 "36배 압도적"이었다. 그런데 플랜지는 전단 접합이고 T슬롯 너트의 예압(경제형 560 / 드롭인 1,363 N)으로는 어느 너트로도 미끄러진다. 미끄러지면 구멍 유격이 그대로 휨이 된다 — 일반 통과공 Ø6.6 이면 0.60 mm 로 **지금보다 7배 악화**, H7 끼워맞춤 1.7배, 다월핀이라야 10.8배. 인장 경로(타이)는 예압으로 항상 접촉이라 유격이 없다. 사용자가 겪은 "점점 헐거워지며 밀린다"가 유격 있는 전단 접합의 반복하중 거동과 맞았다. 플랜지는 다월핀까지 갈 때만 의미 있고 **중간은 없다.**
- **정정 3 — 표가 전부 알루미늄 기준이었고, 손계산 113배는 FEA 7.2배 앞에서 틀렸다(03:00).** 사용자는 "CNC 는 당분간 못 하고 PLA 로 간다". `tie_force()` 가 강철 봉을 E=68,900 으로 계산하고 있었다(3배 차이). PLA 손계산은 타이 하나로 113배가 나왔는데 FEA(PETG E=2,100 근사)는 **7.2배** — 모멘트 분담을 선형으로 나누는 근사는 클램프가 축에서 타이까지 힘을 전달하느라 여전히 변형하는 것을 못 본다. FEA 값을 채택했다: PETG 800 N 에서 축 시트 바깥 밀림 +0.672 → −0.024 mm, 응력 45.6(101 %) → 27.3 MPa(61 %).
- **397.4 는 절단 지시로 못 쓴다(08-21 07:57).** 봉 길이를 클램프 간격에서 유도한 탓이다. 400 으로 고정하고 탭을 물림보다 깊게(15) 파서 절단 공차 ±2 mm 를 흡수한다(물림 11\~15). 그런데 `vehicle_integration.py` 라벨은 옛 유도식을 써서 뷰어에 **M8x403** 이 찍혔고(08-27 01:16), `CLAUDE_HANDOFF.md` §5.0 은 지금도 397.4 다. 같은 상수를 참조하지 않는 라벨과 문서는 반드시 어긋난다.
- **"390 사이즈라니까 왜 360이야?"(08-27 02:42).** 3030 타이를 360 으로 자르는 안(`TIE_KIND=profile`)을 만든 뒤 사용자가 부품 표준화를 지적했다. 앞서 "안 된다"고 한 이유는 390 을 그대로 쓰려 해서였고, 간격 = 420 − 클램프 깊이이므로 **깊이 46.6 → 30 이면 간격이 390** 이 되어 자르지 않고 쓴다. 대신 축이 타이와 같은 x=0 선상이라 타이를 X 로 25 mm 비껴야 한다. 이 안은 09-15 현재 미적용(`LOW_D` 여전히 46.6, `TIE_PROF_LEN = 360`). "안 된다"는 결론은 조건을 바꿔 다시 본다.
- **"공중에 떠 있는 것처럼 보인다"(08-27 02:25).** 프로파일 끝 ±180 과 클램프 면 ±186.7 사이 6.7 mm 가 실제로 떠 있었다 — 브래킷을 모델에 안 넣은 누락. `tie_brackets()` 추가. 사용자가 "떠 있다"고 하면 모델이 정말 떠 있는 것이다(횟수표의 9번째).
- **병목이 옮겨간 뒤에는 그 부재를 키워도 소용없다(08-27 02:30).** 3030 타이는 M8 봉보다 회전강성 12 % 높고 FEA 반력은 2.3배(557 → 1,268 N)인데 변위는 0.2659 vs 0.2627 mm 로 1.2 % 차이. 봉을 단 시점에 이미 병목이 클램프 몸체로 넘어갔다. 3030 을 고를 이유는 성능이 아니라 슬롯에 전장품을 매달 수 있다는 점뿐이다. 다만 반력 1,268 N 이 브래킷 슬롯 볼트를 미끄럼 방향으로 지나가므로 드롭인 T너트가 필요하다는 계산의 "볼트 8개" 근거는 일지에서도 불확실하다고 적혀 있다.

차량 전체는 3030 프레임을 솔리드로 메싱하면 수백만 요소라 `tools/frame/frame_fea.py` 에 12자유도 보요소 솔버를 새로 짰다(08-21 03:14). 70 kg 이 한쪽 구석에 올라서면 그 바퀴에 **865 N**, 대각 바퀴는 22 N 으로 거의 뜬다 — 가정으로 써 온 설계하중 800 N 이 여기서 검증됐다. 프레임 자체는 항복의 22 %(안전율 4.6)로 문제가 아니고, 타이 없으면 클램프가 전체 변형의 84 % 다.

65_frame_load_cases

## 5. FEA 파이프라인에서 걸린 것 (08-21 이후)

- **최대 von Mises 는 인용하지 않는다.** 4 → 3 mm 메쉬에서 최대응력이 132.2 → 150.1 MPa 로 13.5 % 올랐다. VTU 에서 최대점을 찍으니 세 케이스 모두 z=+14.50, 볼트 구멍 축에서 정확히 반경 3.30 mm — 강체 고정한 구멍 벽 위쪽 모서리의 특이점이라 메쉬를 조일수록 계속 오른다. 구멍에서 3 mm 만 벗어나면 45.1 → 45.3 MPa(+0.4 %)로 수렴한다 → `tools/fea/structural_stress.py`. 기준값은 "800 N · 편심 55 · 상향 · 3 mm 에서 구조응력 45.3 MPa / 변위 0.0582 mm"(AL6061-T6 안전율 6.1, PETG 1.1).
- **형상을 바꾸면 해석기의 경계조건 코드도 같이 본다.** `output/fea/` 결과가 전부 플랜지 있던 63.9 mm 형상·구멍 6개 고정이었고, 측면 노드 선택이 무조건이라 그대로 두면 바닥 구멍만 잡히면서 옛 경계조건인 척 돌 뻔했다(08-21 00:38).
- **문서 3개가 서로 다른 조건을 "기준 결과"로 부르고 있었다.** FEA.md 는 4.036 MPa(하향·편심 0), 인수인계는 17.677 MPa(상향·편심 55) — 4.4배 차이인데 둘 다 기준. 08-21 에 조건 대조표를 넣어 통일했다. `CLAUDE.md` 의 "편심·방향을 반드시 준다 — 빼면 편심 0 케이스가 돌아간다"가 이 흔적이다.
- **결과 폴더는 조건이 바뀌면 같은 이름으로 덮인다.** 폴더 이름이 LOW_SIDE/TIE 를 담지 않아 `clamp_800N_h3mm_e55mm_up/summary.txt` 는 플랜지 복원+타이 실행(18.0 MPa)으로, PETG 폴더는 3030 타이 실행(26.5 MPa)으로 덮여 있다. 08-21 새벽의 132.2 / 150.1 / 45.3 은 지금 어느 폴더에도 없고 문서에만 남았다. 인용할 값은 폴더가 아니라 문서에 조건과 함께 적어 둔다.
- **강체 고정은 조인트 무름을 못 본다.** 4장 정정 1 의 원인. 타이는 강체로 묶으면 실제보다 좋게 나오므로 CalculiX `SPRING1` 접지 스프링으로 넣었고, 이때 말한 축강성 12,690 N/mm 는 E=68,900 기준 값이다(강철이면 약 37,900). 당시 FEA 코드가 어느 E 를 썼는지는 일지에서 확인되지 않는다.
- **손계산 `report()` 와 FEA 는 10배 다르다.** 다리 굽힘 2.5 / 블록 굽힘 4.8 MPa 대 FEA 45 MPa — 통짜 보로 봐서 하중이 Ø6.6 구멍 두 개로 빨려 들어가는 것을 못 본다. report 는 경로별 사용률 확인용, 국부 응력은 FEA 라고 출력에 명시했다.
- **프린트품은 등방·균질 가정이 안 맞아 FEA 값어치가 절반**(08-12 21:19)이라는 점, 볼트 프리로드·접촉·T너트/프로파일 변형·피로가 없다는 점은 그대로다. 설계 변경 후에는 최소 두 메쉬 크기로 수렴성(0.7 % 이내)을 보고 반력 합이 입력 하중과 맞는지(0.0012 N 이내) 확인한다.

## 6. 계산 실수

**6.1 build-log 29절에 있는 것 (한 줄씩).** μ=0.8 은 고무 값, PVC 는 0.5(요구 4.13 → 2.58 N·m) · 최대 토크 × 최대 속도로 출력 3배 과대 · 공차 32.3 → 38\~43 → 89 kg(등급을 나눠 말한다: 형상 계산 / 집계 누락 / 추정 / 미집계) · 볼트 320 세트는 근거 없음(162\~218) · 스키드 공식은 궤도차량 근사 · 스프링 13 N/mm 는 자리표시자(정지 처짐 92 %) · 전복 5.8배는 89 kg 반영 전(19.9배) · 팔은 전복이 아니라 서스펜션 처짐 19 mm 가 문제.

**6.2 새로 나온 것.**

- **사용자 제안에 Claude 의 전제를 끼워 넣으면 비교표 전체가 틀린다(08-13 00:25).** 하단 클램프를 계산하며 "레일을 관통해 볼트를 박으면 20 %"라는 전제를 스스로 넣었다. 우리 관통볼트 아니야 사용자의 이 지적으로 철회하니 ㄷ자 733 N(49 %) vs 하단 **1,074 N(72 %)** 로 결과가 뒤집혔다. 관통볼트면 탭 구멍이냐는 질문에는 3030 슬롯 중심선 재료가 2.2+2.2 = 4.4 mm 뿐이라 탭 불가라고 답했다.
- **검사기를 만든 뒤에도 새 설계에는 손으로 3개만 집었다(08-13 00:01).** "모두 20 % 밑"이라 했는데 `load_paths_low()` 로 훑으니 카운터보어 바닥 면압 39 %. ㄷ자 42 % 와 거의 같아 "훨씬 튼튼"은 과장이었다. 도구는 만드는 것과 쓰는 것이 다른 일이다.
- **얇은 판 모서리에 세로 탭은 살이 안 남는다(08-02 19:52).** 8t 판에 M6 하공 Ø5.0 이면 옆 살 1.5 mm. 탭은 살이 있는 브리지 블록(20t, 3.3×D)에.
- **클램프인데 클램프가 안 됐다(08-02 20:18).** 캡 윗면 z=79.3 / 판 밑면 79.35 로 딱 맞닿아 볼트를 조이면 축을 물기 전에 판에 먼저 닿는다 → 핀치 갭 1.0 mm. 사용자의 "캡 너무 두껍지 않나"에 두께를 재다 찾았다 — 계산으로는 안 나오는 결함.
- **프린트 자세를 반대로 알려줬다(08-07 02:40).** "세우라"고 했는데 눕히면 바닥 접촉 26.5 → 64.2 cm², 서포트 39.6 → 0 cm², 응력이 층간 인장(25 MPa)이 아니라 층 방향(45\~50)이 된다. 숫자로 뽑기 전에 단정한 것이 잘못.
- **강도 계산은 어디까지가 모델값이고 어디부터가 가정·인용인지 갈라 말한다(08-07 14:25).** 단면 성질은 확실(형상에서 나왔고 손계산과 일치), 굽힘 공식은 표준(10\~20 %), 89 kg/μ=1.0 은 가정, 재료값은 인용(±30 %), 충격력은 계산하지 않았는데 PLA 탈락 판단이 그 위에 서 있었다. 이 다섯 줄이 30절의 신뢰도 구분이 됐다.
- **재료 상수 하나가 표 전체에 깔린다.** E=68,900 vs 206,000(08-21, 두 번), `TNUT_PULLOUT` 4,000 고정(08-15, 36 % vs 96 %). 표를 낼 때 어떤 E·어떤 너트 한계를 썼는지 같이 적는다.
- **말로 요약한 숫자는 다시 더해 본다.** 부가 비용 "12만원"(항목 합 20만, 07-27) · "총 20본"(19본, 08-01) · 간섭 분류 합 22(실제 21건, 08-04) · "1m 봉 1개"(2개) · 3030 타이 회전강성 "1 % 차이"(8.21e7 vs 8.89e7 은 7.6 %, 08-27) · PPS-CF10 "약 15만원"(630 g × 18만/kg = 11.3만, 근거 계산 없음, 08-22). 같은 세션 안에서도 중간 출력과 최종 답이 다른 숫자가 있었다.

## 7. 뷰어·도구·환경 함정

**7.1 ocp_vscode 뷰어.** 장애는 두 종류로 갈라야 했다 — 화면만 이상(클라이언트) / 연결 자체가 안 됨(서버).

- **접속한 클라이언트에만 push 한다.** 브라우저를 먼저 열고 스크립트를 다시 돌려야 보인다(07-27 19:37, 08-10 01:08, 08-27 01:16 …). 탭이 닫히면 또 쏴야 한다.
- **UI 가 깨져 보이면 브라우저 캐시다(07-27 20:32).** 사용자의 "시크릿창에서는 제대로 보인다" 한 줄이 답이었다. Claude 는 포트·프로세스를 뒤져 "유령 프로세스가 다른 버전을 서빙"이라는 틀린 진단을 냈다 — venv 의 python.exe 는 Python312 를 자식으로 띄우는 런처라 부모/자식 쌍이 나오는 것이 정상이다. 확신 없는 진단은 그렇게 표시하고, 틀리면 정정을 남긴다.
- **안 보이는데 전송 실패가 아닌 경우(07-28 17:38).** `CameraKeepWarning` 이 이미 답을 말하고 있었다 — 카메라가 옛 모델 자리에 남아 105 mm 높아진 새 모델이 화면 밖. `reset_camera=Camera.RESET`.
- **서버가 죽는 경우(07-31 10:10).** 브라우저 탭이 닫히며 웹소켓이 끊기자 `ConnectionResetError 10054` 로 프로세스째 종료(원인은 추정). 재기동에 8\~15초 걸려 8초 뒤 확인은 "실패"로 나온다.
- **"켜져 있다"고 답했는데 틀렸다(08-04 22:54).** `WinError 10061` 이 있었는데 grep 이 `CommsWarning` 줄까지 잘라내고 있었다. 반대로 08-14 16:51 에는 `curl` 이 000 을 돌려줘 재시작했는데 실제로는 살아 있었다. **생사의 진짜 판정은 `show()` 가 성공하는가**다. `python -m ocp_vscode` 가 "Port 3939 already in use" 로 죽는 것은 이미 떠 있다는 뜻이라 정상(08-07, 08-10).
- **`show()` 의 포트 자동탐색이 파이프 환경에서 죽는다(07-29 11:50).** "No Windows console found" → `set_port(3939)`, `progress=None`.
- **나열형 `show(a, b, c, names=[…])` 는 트리에 안 붙었다(08-12 22:51).** Compound 하나로 묶으니 바로 올라왔다. 원인은 추정이다.
- **보조 스크립트가 모델을 import 하면 부작용도 같이 온다(08-01 12:42).** `HUB_MOCK=1` 렌더 스크립트가 `show()` 까지 실행해 뷰어의 실물 모델을 목업으로 덮어썼다 — 사용자에게는 "바퀴가 원래대로 돌아온" 것으로 보였다. `NOSHOW=1`, 목업이면 자동 차단.
- 그 밖에: 드래그 회전이 면 선택으로 먹힘(툴바 프리셋 사용, 08-10), `--no-browser` 옵션 없음(08-14), `Animation` 경로 "/Group/모듈/모듈1 does not exist"(07-29), 백그라운드 뷰어 exit code 4(07-28, 원인 미확인).

**7.2 소스 편집과 셸.**

- **히어독·치환으로 파이썬을 고치지 않는다.** 횟수표의 13회. 증상은 네 가지로 반복됐다 — 앵커 불일치가 조용히 실패(07-30 `D = 20000` vs 30000, `_TITLE` NameError 만 반복) / `\`+개행이 리터럴로 박힘 / CRLF 파일을 `\n` 으로 다시 써 `\r\r\n` / 함수 중복 정의로 "고쳐도 안 바뀌는" 상태(07-28 옛 `kingpin_mount` 가 새 것을 덮음). 08-21 에는 `chr(92)` 플레이스홀더로 우회하고, `\r` 제거 → `ast.parse` → 바이너리 쓰기, 그래도 세 번 어긋나자 Write 로 통째 다시 썼다. 그날 초기 커밋에 `.gitattributes`(`* text=auto eol=lf`)를 건 이유다.
- **파이썬 문자열에 윈도 백슬래시 경로를 넣지 않는다(08-21 01:37).** `"\50_why…"` 의 `\50` 은 8진 이스케이프 = "(" 라 `docs/images(_why_tipping_moment.png` 가 생겼고, `"tools\figures"` 의 `\f` 는 폼피드라 주석이 쪼개져 SyntaxError. 문법 경고도 없다 → `pathlib`.
- **`from build123d import *` 뒤에 `M` 을 모듈 별칭으로 쓰면 미터 상수에 덮인다(08-11).** 별칭을 `SB` 로.
- **파라미터 정의 순서 NameError**가 반복됐다 — assert 가 상수 정의 전에 실행(07-29 `ESTOP_Z`, `CAM_WIN`), `MODULE_ONLY` 정의 130줄 / 사용 59줄(07-31), `BOLT_X_PITCH`·프리셋 블록(08-14 두 번), `CAM_X`(07-29), `NameError: g`(08-10 지붕 통합하며 지움).
- **서브에이전트 Bash 는 cwd 와 `TMPDIR` 을 믿을 수 없다(09-10).** 호출마다 cwd 가 초기화돼 `cd models &&` 가 실패했고, `$TMPDIR` 이 비어 루트에 쓰려다 Permission denied. 절대경로만 쓴다. 저장소 전체 `grep -rn` 은 120초를 넘겼다(`.venv`·output 탓으로 보이나 확실하지 않다). `python3` 은 MS Store alias 라 "Python was not found"(07-30).
- **백그라운드 검증은 조용히 죽는다.** 검증 한 번이 4\~10분이라 600초 타임아웃(exit 143)으로 여러 번 백그라운드로 넘어갔고, grep 파이프 버퍼링 때문에 진행이 안 보였으며(07-30, 52분), 결과 파일이 0바이트인 적도 있었다(07-31). 결과 파일 크기부터 본다.

**7.3 외부 자료.** 판매 페이지 WebFetch 는 403 이 잦다(SuperDroid·roboticsdna·MISUMI·GrabCAD·Chief Delphi·Polymaker). SPG 카탈로그 PDF 는 폰트가 +31 시프트돼 텍스트 추출이 안 됐고 디코더를 짜도 숫자는 `¤` 로 깨졌다 → PyMuPDF 로 페이지를 170 dpi 이미지로 렌더링해 눈으로 읽는 게 빨랐다(07-27 23:46). arXiv PDF 는 로컬 파일을 `fitz` 로 풀었다. AskUserQuestion 이 JSON 파싱 오류를 낸 적이 있는데 원인은 확실하지 않다(07-27). 08-15 13:10 에는 인증 오류로 세션이 끊겨 방금 쓴 `drawing.py` 를 실행하지 못했고, 그 결과 08-21 03:26 까지 DXF 는 없고 도면은 옛 형상(63.9 mm)이었다. Trilium 은 서버(37840)는 있었지만 ETAPI 토큰이 없었다(09-15).

## 8. 파일 훼손과 산출물 관리

- **산출물이 아니라 산출하는 코드를 남긴다(build-log 28막).** 07-29\~31 의 도면·검증 스크립트 20여 개(sheet/modsheet/verify2/verify3/stroke/mass …)는 전부 스크래치패드에 있었고 지금은 없다. 도면 41\~47 은 이미지만 남아 모델이 스키드로 바뀐 뒤에도 스워브 시절(전고 595 / 축간 520)로 굳어 있었고, 08-07 12:09 에 `models/drawings.py` 로 다시 짰다. 08-10 에 세어 보니 `docs/build-log.md` 는 20막에서 끊겨 클램프·D컷·CNC·JLC·휠마운트·지그가 **0회** 등장했다 — 판단 밀도가 제일 높은 구간이 통째로 빠져 있었고, 도면 분실이 그 손해였다. 09-15 현재도 build-log 는 28막 + 29\~32절(08-09 까지의 기록)이고 08-12 이후의 파손·FEA·타이는 없다.
- **같은 파일명으로 조용히 덮어쓴다.** CNC 판과 프린트판이 둘 다 `휠마운트.step` 으로 나가 `PRINT=1` 실행이 CNC 파일을 덮었다(08-07 04:00) → `_cnc_M6` / `_print_M6` + 폴더 분리. 59번 렌더는 61번으로 덮여 사라졌다(07-31). 이미지 번호가 기존 50/51 과 겹쳐 63/64 로 옮겼다(08-21). FEA 결과 폴더도 같다(5장).
- **문서에 손으로 적은 숫자는 반드시 낡는다.** 07-31 하루 만에 build-log 와 payload-interface 의 값 9개가 모델과 어긋났다(외곽 843×628×460 vs 873×712×595 등). 제목·치수는 `bounding_box()` 에서 자동 생성. 통합 스크립트는 개별 모델보다 늦게 썩는다 — 09-10 에 `vehicle_shell_integration.py` 는 볼트 길이 20 고정에 액슬 타이가 아예 없었다. 문서 간 불일치는 지금도 남아 있다: 397.4 vs 400, 스프링너트 933 vs 1,500, 타이 360 vs 390, 적재함 높이 280(코드) vs 360(payload-interface).
- **git 이 없었다.** 08-10 에 `git rev-parse` 가 "not a git repository" — 12k줄 코드와 42k자 기록이 버전관리 밖이었다. 08-21 08:08 `git add -A` 를 그대로 하니 617.5 MB / 501 파일(`robot_vacuum.step` 131 MB, FEA 중간파일 724 MB …) → "소스·문서·발주 확정 산출물만"으로 28.5 MB / 256 파일, 커밋 `14fb653`. 원격은 지금도 없고 `.git` 에 느슨한 객체 192 MB 가 남아 있다.
- **스크립트를 쓰고 실행을 안 하면 산출물이 옛 형상으로 박제된다(08-21 03:26).** 도면 전고를 `FLANGE_TOP − LOW_BOT` 파생값 대신 bbox 로 재게 고쳤다.

## 9. 사용자 요구를 오해한 것, 사용자가 잡은 것

형상 요구를 반대로 구현한 뒤 그 위에서 맞추려 들면 돌아간다.

- 적재함 슬라이드를 뒤→앞으로 만들고 개구 좌표까지 옆면 한가운데(중심 −212.5)에 뚫었다(07-29 22:06). 뒤에서 앞으로 밀어넣는게 아니라 앞에서 뒤로 밀어넣는거라니까? … 그냥 방향만 앞뒤로 바꾸면 되는거였는데 왜이렇게 돌아가 앞→뒤로 밀면 노치는 뒷면에만, 앞면은 통으로 막힌다 — 요구가 그냥 맞아떨어지는 구조였다.
- 손잡이를 매립 개구(130×40)로 만들었는데 요구는 "작은 구멍으로 봉이 튀어나오는" 관통형이었다(07-30 02:15). 같은 날 두 번째 오해.
- 휠브라켓 기성품을 묻자 샤프트 서포트(SHF16/SK16)를 답으로 냈다(08-05 15:46). 샤프트 서포트 가 왜 나와? 내가 지금 너랑 같은 휠 브라켓을 보고 있는 거 맞나? 렌더를 다시 보니 브라켓의 본질은 "축을 무는 것"이 아니라 "레일 밑면에서 축까지 91.35 mm 를 내려주는 것"이었다. 부품이 하는 일을 먼저 물어야 했다.
- 지그가 왜 이렇게 크냐(08-01 13:29) — 로봇 하부 프레임을 통째로 베꼈기 때문. 시험 대상은 +Y 레일 한 본에만 물린다. bbox 에서 역산하니 164 → 40 L.

반대로 사용자 질문이 결함을 직접 잡은 횟수가 많다. "공중에 떠 있는 거 아니야?" 계열 6회(1장), "진짜 그 사양이 필요하냐"(100 W → 30 W), "어떻게 측정한 거냐"(32.3 → 40 kg), "진짜야?"(볼트 320), "타이다운이 왜 필요하지"(앞방향 리테이너 부재 발견), "상단 커버가 안 나와 있는데 의도한 거야?"(도면 판재 숨김), "ㄴ자로 깎일 필요가 있나"(단차 + 스페이서 부재), "굳이 저 판이 있어야 하나"(거싯 과설계, 스틸 브라켓 근거 없음), "너트 끼울 형태가 아닌데"(나사부 없음), "나사 크기 적절한가"(8t 에 M6 탭), "캡 너무 두껍지 않나"(핀치 갭 0), "볼트 20 mm 될까말까"(물림 0.6 mm), "관통볼트 아니야"(전제 철회), "1 mm 깎은 이유 있나"(턱), "3030 이 아닌 느낌인데"(참조 단면 오류), "390 인데 왜 360 이야"(표준화). 근거 없이 튼튼한 쪽을 고르는 버릇(거싯판, 스틸 브라켓)은 사용자가 되물을 때마다 계산하면 무너졌다.

53_handle_detail

## 10. 검증 방법 (30절 요약 + 08-12 이후 추가분)

| 검사 | 잡은 것 | 못 잡는 것 |
| --- | --- | --- |
| 부품군 전 조합 간섭(월드 좌표) | 플랜지 관통, 요크×바퀴, 그로밋×목업, 브래킷 21건 … | 부재, 같은 그룹 내부, 참조 형상이 틀린 경우 |
| 연결성(합집합 솔리드 수 = 1) | 떠 있는 빔 15 mm, 셸 띠 z 50\~126, 뚜껑·지붕 0.5 mm 틈 | 붙어 있지만 하중을 못 받는 것(3 mm 셸에 매달린 핸들) |
| 움직임 스윕(각도별 교집합) | 트래블 3\~6 mm, 스톱 ±90° 접촉, 지그 가로대 ±380, 핸들 봉 220 의 7 mm³ | — |
| 그림(HLR 선도·ISO 렌더) | 5조각 단면, 작은 눈, 앞바퀴 옆 흡기, 사라진 스커트, V자 브레이스, 브라켓 단차, 크래들 두 조각, 타이 볼트 바 밖 | 그림 자체가 틀린 경우(접지면 원판, Pos ±210) |
| 실물 STEP 0.1 mm 스캔 · 인치 환산 · 격자 단면 | 나사부 없음, D컷 −46.5\~−3.7, 채널 5.07, 장공 8.128 은 타이핑값 | 실물과 STEP 이 다른 것(축 끝 배선 8선) |
| 물림 검사(판 구간 축 부피) | 100 % 물림 증명, 너트 스택 7.2 mm 유격 | — |
| 하중 경로 자동 훑기 `report_loads()` | 팔 119 %, 카운터보어 면압 39 %, 볼트 물림 0.6 mm, 인발 95.5 % | 국부 응력(구멍 주변 10배), 강성 |
| 솔리드 FEA(구조응력·변위·반력 합·메쉬 수렴) | 45.3 MPa / 0.058 mm, 플랜지 제거 시 변위 8배, 타이 효과 7.2배(손계산 113배 기각), 축 시트 바깥 밀림 | 조인트 무름, 볼트 유격, 프린트 이방성, 충격 |
| 보요소 프레임 해석 | 구석 탑승 865 N(설계하중 800 검증), 대각 바퀴 22 N, 프레임 안전율 4.6 | T슬롯 조인트 강성, 비틀림 J, 충격계수 |
| 조립 가능성(낙하 경로·공구 여유·볼트 접근) | 닫힌 보어 조립 불가, 렌치 막힘, 47 mm 살 속 볼트 | — |
| 실물 시험 | ㄷ자 팔 파손, 옆 플랜지 파손, 볼트 15 mm, 치수 맞음 | — |

assert 는 "치수를 바꿨을 때 깨지는 곳을 자동으로 아는 것"이 진짜 이점이다. 다만 `MODULE_TOP = WHEEL_D + 20` 처럼 근거 없는 상수는 assert 로도 못 잡는다 — 애초에 역산식으로 쓴다. 08-12 이후 추가된 assert 종류: 공구 여유(`HEX_R`), 볼트 길이 역산(`rail_bolt_len()`), 타이 물림 범위(8 ≤ 물림 ≤ 탭깊이−1), 접합면 좌표계 일치(`wheel_mount` ↔ `swerve_base`), 탭이 블록 밑면·축 시트를 뚫는지, 벽 2 mm 이상.

**10.1 FEA 결과를 읽는 규칙과 안전 판단 원칙.** 위 표의 솔리드 FEA 행을 실제로 쓸 때 지켜야 할 규칙은 `models/hoverboard_mount/CLAUDE_HANDOFF.md` §8·§9·§11(2026-08-21 갱신)에 있다. 5장의 "최대 von Mises 는 인용하지 않는다"와 3.4 의 "안 잰 스프링너트 인발"이 왜 문제인지가 이 규칙에서 나온다. 원문 용어와 순서 그대로 옮긴다.

**결과 이미지 읽는 법 (§8).**

- 흰색 와이어프레임은 하중 전 원래 형상, 색칠된 메쉬는 계산된 변형 형상이다.
- 화면의 `Deformation display: Nx` 는 변형 표시 확대율이다. 숫자로 표시된 최대변위만 실제 변위이며, 화면 간격은 확대되어 있다.
- 파랑 → 청록 → 초록 → 노랑 → 빨강은 von Mises 응력이 증가하는 순서다. 따뜻한 색은 변위가 큰 곳이 아니라 응력이 높은 곳이다.
- `S_Mises` 는 응력[MPa], `U` 는 변위[mm]다. `E_Mises` 를 응력으로 읽지 않는다.

**FEA 검증 절차 7단계 (§9).**

1. 형상 변경 후 STEP 을 다시 내보낸다.
2. 4 mm 메쉬로 먼저 실행해 노드 분류와 솔버 오류를 확인한다.
3. 3 mm 로 다시 실행해 수렴성을 비교한다.
4. `.dat` 또는 `summary.txt` 의 고정점 반력 합이 입력 하중과 일치하는지 확인한다.
5. PNG 에서 고정 면, 하중 면, 휘는 방향이 실제 설치와 맞는지 확인한다.
6. 비교할 모델에는 같은 하중 방향, 편심, 재료와 메쉬 규칙을 사용한다.
7. 최대응력 한 점뿐 아니라 넓은 응력 분포와 전체 변형 형태를 함께 본다.

**안전 판단 원칙 (§11).**

- FEA 의 800 N 은 시험으로 확정된 허용하중이 아니라 비교용 코너 하중이다.
- 정적 선형해석 결과만으로 사람 탑승 허용중량이나 안전 인증을 선언하지 않는다.
- 3D 출력품은 먼저 무부하 조립, 지그 고정 정적시험, 무인 저속시험 순서로 검증한다.
- 사람이 탑승하는 최종 클램프는 AL6061-T6 제작품을 기준으로 한다.
- 실제 허용하중은 클램프뿐 아니라 휠/축/베어링/프로파일/T너트/볼트/프레임과 제동 성능 중 가장 낮은 한계가 결정한다.

## 11. 남긴 일

*미해결 목록(2026-09-15 기준)*: M6 스프링너트 인발 실측, 타이 360 vs 390(클램프 깊이 30 + X 오프셋 25) 결정 후 FEA 재실행, 셸 휠아치 4곳과 스커트 지상고 49\~55 mm, FEA 타이 노드 1,080개 선택 버그 확인, 결과 폴더 이름에 LOW_SIDE/TIE 반영, `CLAUDE_HANDOFF.md` §5.0 의 397.4 갱신, build-log 에 08-12 이후 기록, 큰 셸 4종의 출력(24조각, 406시간) 대 판재 결정, 다이얼 게이지로 바퀴 바깥 밀림 예측 0.73 → 0.03 mm 실측.

## 12. 교훈

1. **간섭 0 + assert 통과 + 솔리드 valid 는 "맞다"도 "안전하다"도 아니다.** 떠 있는 빔·사라진 스커트·두 조각 크래들·부러진 팔 — 전부 그 상태에서 나왔다. 연결성, 움직임, 그림, 하중 경로, 조립 가능성을 따로 본다.
2. **CAD 의 `add()` 는 위치만 정하지 결합을 정하지 않는다.** "떠 있음"이 9번 반복됐고 6번은 사용자가 잡았다. 하중 경로를 부품 단위로 짚어 부재(不在)를 찾는다.
3. **가정을 실측으로 착각하지 않는다.** 남의 STEP 은 0.1 mm 로 스캔하고 인치로 환산하고 격자 단면을 찍는다. 각각 십 분이 안 걸리는데 축 너트·볼트 굵기·D컷 길이가 거기서 갈렸다. 그래도 STEP 에 없는 것(배선 출구, 볼트 길이 15 mm)은 실물이 알려 준다.
4. **실물 시험 한 번이 문서 검증보다 값어치가 크다.** 문서상 완벽했던 27.3 mm 카운터보어가 15 mm 볼트 앞에서 무너졌고, 93 % 로 계산되던 플랜지가 툭 쳐서 부러졌다. 출력품은 조립·치수 확인용이고 탑승은 알루미늄 이후다.
5. **하중 경로를 하나 빠뜨리면 그 배수는 통째로 무의미하다.** "여유 7배"는 횡력만 본 값이었고 실물은 수직 편심 하중에서 부러졌다. 케이스(탑승), 단면(판 외팔보), 오프셋(55 mm), 볼트 모델(전단 vs 인장, 개수), 조인트 무름, 볼트 유격, 재료 E — 08-12 와 08-21 에 각각 세 번씩 빠뜨렸다. 검사기를 만든 뒤에도 손으로 3개만 집었다.
6. **병목은 옮겨 다닌다.** 클램프를 알루미늄으로 바꾸면 6배가 아니라 너트 한계로 2\~3배, 타이를 달면 클램프 몸체가 병목이라 타이를 12 % 더 뻣뻣하게 해도 변위는 1.2 % 차이. 재료(AL/PLA)와 목적함수(강도/휘어짐)에 따라 순위가 뒤집히므로 표에 전제를 붙인다.
7. **FEA 는 수렴하는 값만 쓴다.** 강체 고정 구멍 벽의 최대 von Mises 는 메쉬를 조일수록 오른다. 형상을 바꾸면 경계조건 코드를, 조건을 바꾸면 결과 폴더 이름을 같이 본다. 인용할 값은 문서에 조건과 함께.
8. **손계산과 FEA 가 한 자릿수 이상 다르면 손계산을 의심한다.** 113배 vs 7.2배, report 2.5 MPa vs FEA 45 MPa. 단면 성질은 형상에서 뽑고 해석해와 교차검증한다(평행축 정리를 두 번 빠뜨렸다).
9. **값을 직접 쓰지 말고 역산하게 만든다.** 절대값·눈대중 상수가 10번 넘게 다른 치수 변경에 딸려 깨졌다. 발주 숫자는 라운드 수로 고정하고 공차를 흡수할 자리(탭 깊이)를 따로 둔다. 라벨·문서도 같은 상수를 참조하지 않으면 M8x403 처럼 어긋난다.
10. **검증 코드도 코드다.** 결과가 너무 규칙적이거나(4개가 같은 부피) 전부 참이면(인치 판정 7/7) 검사기부터 연다. 렌더가 이상하면 모델이 아니라 그림이 틀린 경우도 있다(접지면 원판, Pos ±210).
11. **소스는 Edit/Write 로만 고친다.** 히어독·치환은 13번 깨졌고, CRLF·백슬래시 이스케이프는 문법 경고도 없이 파일명과 주석을 바꿨다. 세 번 어긋나면 통째로 다시 쓴다.
12. **뷰어는 브라우저 먼저, 스크립트 나중.** 생사는 `show()` 성공 여부로 판정하고, 보조 스크립트는 `NOSHOW` 로 부작용을 끊는다. "시크릿창에서는 되는가"가 서버/클라이언트를 가르는 가장 빠른 실험이었다.
13. **산출물이 아니라 산출하는 코드를 남기고, 기록은 뒤에 붙인다.** 스크래치 스크립트 20여 개와 build-log 8막분이 사라지거나 비어 있었다. 파일명에 판(`_cnc`/`_print`)과 조건을 박고, git 에는 소스·문서·발주 확정 산출물만 넣는다.
14. **사용자의 짧은 질문이 가장 싼 검증이었다.** "진짜야?", "떠 있는 거 아니야?", "왜 필요해?", "같은 걸 보고 있는 거 맞나?" — 근거 없이 튼튼한 쪽을 고르거나 Claude 의 전제를 끼워 넣은 곳은 되물음 한 번에 무너졌다. 확신 없는 진단은 그렇게 표시하고, 틀리면 정정을 남긴다.
15. **"안 된다"는 결론은 조건을 바꿔 다시 본다.** 390 프로파일은 그대로는 안 됐지만 클램프 깊이를 30 으로 바꾸면 되는 문제였다. 반대로 "된다"는 결론(플랜지 36배)은 유격 하나로 7배 악화가 됐다 — 중간은 없다.
