chungddong/NUBI/docs/worklog/topics/vehicle-2026-09-15-numbers.md

# 차체 설계 핵심 숫자 (2026-09-15 기준)

> 영역: 차체 · 작성: 2026-09-15 · 원본: 차체 설계 일지 `synth_numbers.html` (2026-10-13 Markdown으로 옮김)

07-27 첫 프레임부터 09-10 BOM 까지 일지 21편에 흩어진 숫자 가운데, **지금 저장소에서 다시 계산해도 같은 값**만 카드로 모았다. 값마다 출처 파일을 적었고, 당시 값과 지금 값이 다르면 둘 다 적었다. "당시" 는 그 값이 기록된 날(KST)이고, "현재" 는 2026-09-15 저장소(`models/hoverboard_mount/parameters.py`, `low_clamp.py`, `models/swerve_base.py`, `docs/bom.md`, FEA `summary.txt`)에서 확인한 값이다. 확실하지 않은 것은 그렇게 적었다.

읽는 순서는 차량 → 프레임 → 바퀴 → 클램프 → FEA → 액슬 타이 → 너트 인발 → BOM 이다. 하중 경로 순서와 같다.

---

## 0. 설계 하중 — 모든 카드가 공유하는 전제

| 항목 | 값 | 근거 | 출처 |
| --- | --- | --- | --- |
| 설계 코너 하중 `DESIGN_W` | **800 N / 바퀴** | 한쪽 코너에 사람이 올라선 경우. 08-21 프레임 보요소 해석에서 70 kg 이 구석에 서면 그 바퀴에 865 N 이 걸려 검증됐다 | parameters.py, tools/frame/frame_fea.py (entry 14b) |
| 타이어 접지점 편심 | **53.7 mm** (코드) / **55 mm** (FEA 입력) | 클램프 중심 y=−53.7 (D컷 평면 한가운데) 대 타이어 중심면 y=0 | low_clamp.py `CLAMP_CY`, run_clamp_fea.py |
| 젖힘 모멘트 | **43.0 N·m** (800 × 53.7) / FEA 44 N·m (800 × 55) | 어떤 브라켓이든 생긴다. 기하학적 하한은 50.8 mm(타이어 반폭 27.5 + 클램프 반두께 23.3)라 5% 밖에 못 줄인다 | CLAUDE_HANDOFF.md §5.0, entry 14a |
| 구동 반력 토크 `DRIVE_TORQUE` | 29 N·m | 350 W 급 허브모터 스톨 추정. 타이어 마찰 한계는 약 13.9 N·m 라 스톨에서는 타이어가 먼저 미끄러진다 | parameters.py, entry 09 |
| 바퀴 + 클램프 무게 `WHEEL_MASS_N` | 30 N | 프레임을 들어 올릴 때 밑면 볼트 2개가 인장으로 받는 값 | parameters.py |
| 허용중량 환산식 (잠정) | **`gross_mass_kg = 4 × F_corner / (9.81 × K_dynamic × K_imbalance)`** — F_corner 800 N, `K_dynamic=2.0`, `K_imbalance=1.3` 에서 **약 125 kg** | 800 N 은 시험으로 확정한 허용하중이 아니라 "해석을 수행한 코너 하중" 이므로 이 환산값도 잠정 설계 목표일 뿐이다. 실제 적재량은 여기서 차량 자체중량을 빼고, 바퀴·베어링·프로파일·T너트·배터리·제동 성능 중 가장 낮은 한계를 적용한다. CLAUDE_HANDOFF.md §7 의 환산: 600 N = 약 61.2 kgf 이지만 한 바퀴에 걸리는 힘이지 차량 총질량이 아니다 / 차량 약 40 kg + 사람 70 kg 이면 총 정적 중량 약 1,079 N / 사람이 한 축 가까이 앉고 좌우 편중·프레임 비틀림·탑승 충격이 겹치면 한쪽 클램프에 400\~650 N, 순간적으로 800 N 이상 (§7 의 차량 40 kg 은 아래 07-30 공차 중량 89 kg 과 다른 가정이다) | FEA.md §8, CLAUDE_HANDOFF.md §7 |
| 차량 공차 중량 | 약 89 kg (07-30 계산, 스워브 + 적재함 v1 기준) | 스키드 전환·6.5인치·적재함 축소 뒤에는 **다시 계산하지 않았다**. 지금 차량의 무게는 저장소에 없다 | entry 05, entry 08a "남긴 일" |
| 재료 참고 항복 | AL6061-T6 276 MPa / PETG 45 MPa (FEA 카드) · 50 MPa (안전율 계산) / 6063-T5 프로파일 170 MPa | PETG 두 값이 문서에 공존한다. 안전율 1.1 은 50 기준, 한계하중 795 N 은 45 기준 | FEA.md §4, run_clamp_fea.py, entry 14a |

---

## 1. 차량 치수

차량은 `models/swerve_base.py` 하나에 두 구성이 산다. 기본값(DRIVE=skid, 휠 마운트 ㄷ자)과, Design-D 하부 클램프를 얹은 `MOUNT=low` 구성이다. BOM 은 후자 + 적재함(PAYLOAD=cargo) 기준이다.

41_skid_drawing_sheet

| 항목 | 기본 베이스 (DRIVE=skid, ㄷ자 마운트) | Design-D 전체 버전 (MOUNT=low + cargo, BOM 기준) | 출처 |
| --- | --- | --- | --- |
| 전장 × 전폭 × 전고 | **873 × 712 × 518 mm** | **873 × 612 × 606 mm** (셸 610→510 으로 좁힘 SHELL_Y=255, 적재함 포함) | build-log.md 31절 B / docs/bom.md 머리 |
| 차체만 | 810 × 610 × 383 — 돌출 범퍼 앞뒤 +24 / 안테나 뒤 +39 / 핸들 좌우 +51 | — | build-log.md 31절 B |
| 축간 / 윤거 | **420 / 520** (T/L 1.24) | 420 / 520 (출력문). 단 hoverboard_mount 통합 장면의 휠 중심은 Y=±263.7 라 타이어 중심면 기준 527.4 — 7.4 mm 차이가 어느 쪽이 실차인지 확실하지 않다 | swerve_base.py `SKID_WHEELBASE`, CLAUDE_HANDOFF.md §3, vehicle_integration.py `WHEEL_Y` |
| 지상고 | 차체 바닥 z 170.7 (바퀴 158.7 + 여유 12) / 스커트 저부 **126** (120 mm 폭 @ z=125.7) | 차체 바닥 z 93.92 / 레일 중심 108.92 / 클램프 밑면 **55.35** (hoverboard_mount 패키지 계산은 54.9). 바퀴가 레일 윗면보다 34.8 mm 솟아 휠아치 4곳이 아직 없다 | build-log.md 31절 B / entry 12, 16 |
| 전장 베이 | 700 × 390 × 140 (바닥 z=204) | 700 × 390 × 140 (바닥 z=127) | build-log.md 31절 B / entry 16 |
| 데크 | 810 × 610 @ z=380, 100 mm 격자 M6 | 810 × 510 @ z=303 | 같음 |
| 외장셸 | 810 × 610 R60, 벽 3 mm, 앞뒤 2분할, 플랜지 45 × 6t M6 12개 | 같은 규칙, 폭 510 | build-log.md 31절 B, swerve_base.py |
| 적재함 | — | 높이 280, 유로 컨테이너 400 × 300 × 220 한 개, 적재 26 L, 뚜껑 529 × 349 × 58 (1,594 cm³), 격벽 x=124.5 역산, 잠금 x=−372 y=±147 | swerve_base.py `CARGO_*` (entry 11 v4) |
| 2026-09 이전 값 | 07-27 첫 프레임 700 × 670 × 200 → 07-27 밤 770 × 696 × 335 → 07-28 0.90 축소 700 × 632 × 335 (축간 400 / 윤거 564, 지금 `mobility_base.py` 값) → 스워브 873 × 712 × 595 (Ø210) → 544 (Ø158.7, 축간 520) → 08-01 스키드 873 × 712 × 518. 적재함 v1 (높이 360) 을 얹으면 683, Design-D 로 내리면 606 | entry 01a, 02a, 07, 08a, 12 |  |

build-log 31절의 "최종 사양 B" 는 ㄷ자 마운트 시절 값이다. Design-D 로 바뀐 뒤의 사양은 build-log 에 없고 `docs/bom.md` 머리 세 줄이 전부다.

---

## 2. 프레임 — 3030 프로파일

| 항목 | 현재 (docs/bom.md, 09-10) | 당시 (build-log 32절 A, 08-07\~08-10) | 출처 |
| --- | --- | --- | --- |
| 외곽 | 760 × 450 (하부·상부 폭 모두 450) | 760 × 450 (상부 크로스 500 = 폭 560) | CLAUDE_HANDOFF.md §3, swerve_base.py `BASE_L, BASE_W` |
| 절단 목록 | **760 × 4 / 390 × 8 / 143 × 6 = 18본** (390 = 하부 크로스 3 + 상부 크로스 3 + 축 보강 크로스 2) | 760 × 4 / 500 × 3 / 390 × 5 / 143 × 6 = 18본 | docs/bom.md, CLAUDE_HANDOFF.md §3 / build-log.md 31절 B |
| 실 길이 / 중량 | **7.02 m / 7.28 kg** | 7.35 m / 7.62 kg | docs/bom.md (entry 16) / build-log.md 31절 B |
| 과금 / 가격 | **76단위 (100 mm 올림) = 72,200원**, 버림 160 + 80 + 342 mm | 79단위 (7.90 m) = 75,050원, 버림 552 mm (7%) | docs/bom.md / build-log.md 32절 A |
| 단가 [확인] | **950원 / 100 mm** (08-05 장바구니 사진으로 확인, 그 전엔 900원) · 다이캐스팅 브라켓 3025 **360원** · M6×15 둥근머리 렌치볼트 **70원** · 스프링너트 306 **180원** | models/tslot.py `UNIT_PRICE`, docs/bom.md 가정 1 |  |
| 철물 수량 | 브라켓 28 (joints() 자동 검출) 10,080원 / M6×15 **68** (브라켓 56 + 셸 플랜지 12) 4,760원 / 스프링너트 **68** 12,240원 → 프레임 카테고리 **99,280원** | 브라켓 28 / M6×15 84 (휠마운트 16 포함) / 너트 84 → 철물 31,080원 | docs/bom.md / build-log.md 32절 A |
| 단면 모델 | tslot.py 단면적 **384.10 mm²** (모델 1.10 kg/m, 실물 약 1.0 — 내부 리브 단순화로 10\~15% 과대). hoverboard_mount 참조 단면은 406 mm². 벽 2.4 / 슬롯 입구 8.2 / T홈 16.4\~16.5 / 보스 11.0\~11.6 / 중심 보어 6.8 / 모서리 R1.5 | models/tslot.py PROFILES[30], parameters.py EXTRUSION_PRESETS (두 파일의 방·보스 값이 0.1\~0.6 mm 다르다) |  |
| 슬롯 립 | 두께 2.4 mm, 내밀림 4.1 mm, 6063-T5 항복 170 MPa — 인발 파괴는 너트가 아니라 이 립이 벌어지는 것이다 | entry 14b, 15 |  |
| 프레임 보요소 해석 (70 kg 탑승, 3030 E=69,000) | 중앙 0.078 mm / 바퀴 267\~275 N / 11.8 MPa (안전율 14.4) · **한쪽 구석 0.379 mm / 22\~865 N / 37.0 MPa (4.6)** · 뒤축 위 0.161 mm / 1\~534 N / 26.6 MPa (6.4). 타이 유무는 프레임 처짐에 거의 무관(0.081 vs 0.078). T슬롯 코너 조인트는 강체로 봤다 | tools/frame/frame_fea.py (entry 14b, 2026-09-15 재실행 동일) |  |

65_frame_load_cases

연습용 2020 프레임(`models/tslot_frame.py`, 400 × 300 × 400, 4.08 m, 약 2.07 kg)과 구 스키드 `mobility_base.py`(3030 18본 6.48 m / 6.72 kg, 과금 7.20 m)는 07-27\~28 값 그대로 남아 있지만 현재 차량이 아니다.

---

## 3. 바퀴 — 호버보드 6.5인치 허브모터 (실물 STEP 0.1 mm 스캔)

> 애초에 보드 축은 너트를 끼울수 있게 되어있는 형태는 아닌데 말이야 (08-02)

60_hub_motor_real

| 항목 | 실측 값 | 태그 / 비고 | 출처 |
| --- | --- | --- | --- |
| 타이어 외경 × 폭 | **Ø158.7 (158.74) × 55**, 트레드 폭 38.8 | [실측]. "6.5인치" 공칭 165 가 아니다 | parameters.py `WHEEL_DIAMETER, WHEEL_WIDTH`, entry 07 |
| STEP 전체 | 111 × 158.74 × 158.74 mm, 솔리드 1개, 958 cm³ | refmodel/Motor, BLDC, Hoverboard Wheel, 6.5in.stp | entry 08a |
| 모터 몸통 | Ø150 × 폭 45 | [TODO] — 참조 외형에만 쓰고 클램프 위치에는 안 쓴다 | parameters.py, README.md |
| 축 | **Ø16, D컷 1면, 평면\~반대편 13.0** (평면 높이 축중심 +5.0) | [실측]. 양면 D컷 아님 | parameters.py `AXLE_*` |
| D컷 평면 구간 | 타이어 중심면 기준 **y −32.3 \~ −75.1 (42.8 mm)** | 3 mm 스캔은 −48\~−3 (45 mm) 라 했고 0.1 mm 스캔이 1.5 + 0.7 mm 를 잘라냈다 | parameters.py `AXLE_FLAT_Y0, AXLE_FLAT_LENGTH`, entry 08a |
| 축 시작 / 축 끝 | −27.0 / **−78.6**, 끝 1 mm 모따기 | "Ø14 나사 3 mm" 로 읽었던 것은 모따기였다. **나사부 없음**, 원형 구간 3.5 mm | parameters.py `AXLE_HAS_THREAD = False`, entry 09 |
| 케이블 | 축 중심 보어 Ø10 에서 그대로 나온다 | 잴 항목 아님. 통과 여유 3 mm | parameters.py |
| 축 높이 (지면 기준) | 79.35 | = 158.7 / 2 | swerve_base.py `AXLE_Z` |
| 기존 호버보드 상부 클램프 | **42.72 × 39.22 × 12.57**, 코너 R2.54, 15.1 cm³, **채널 깊이 5.07 = D컷 평면 높이** | 4개 보유, 상부 절반으로 그대로 쓴다 | parameters.py `OEM_W, OEM_H, OEM_T, OEM_CH_D` |
| 상부 클램프 볼트 구멍 | 장공 8.128 × 16.25, 중심 (±15.1, ±11.87) | 8.128 = 0.3200" 라운드값이라 **실측이 아니다**. 그래서 M8 이 아니라 M6 + 와셔(여유 2.13) | parameters.py `OEM_BOLT, OEM_BOLT_D`, entry 10b |
| 모터 전기 사양 | 36 V, 250\~350 W, 3상 BLDC 15극쌍, 홀센서 | e-pm.kr 6.5인치 55,000원 (BOM 은 [추정] 보유 4개). 실제로는 호버보드 2대를 10만원에 샀다 | entry 02b, 08b, docs/bom.md |
| 당시 예상 (07-28) | 8인치 Ø215, 축 Ø12 양면 D컷, 폭 65\~70 | 전부 빗나갔다. 실측 전 수치로 판을 그리지 않은 것이 맞았다 | entry 02b |

---

## 4. 클램프 Design D — 하부 클램프 (parameters.py / low_clamp.py, 09-15 실행)

> 양 옆 기둥같은 것은 툭하니까 부러지더라고 … 우리가 가진 m6 나사가 20mm 가 아니라 15mm 이더라고 (08-21 00:30)

구조는 "새 하부 클램프 + 기존 상부 클램프 + 3030 레일 밑면 볼트 2개" 다. 옆 플랜지는 08-21 실물(PETG)에서 부러져 뺐다. 아래 표의 현재 값은 2026-09-15 에 코드를 돌려 확인한 것이다.

| 항목 | 현재 | 당시 (다른 경우) | 출처 |
| --- | --- | --- | --- |
| 외형 (폭 × 깊이 × 높이) | **92.72 × 46.60 × 38.90 mm** | 08-15 Design D 첫 판 80.7 × 46.6 × 63.9 → 통짜 92.7 × 46.6 × 63.9 (플랜지 포함) → 08-21 플랜지 제거 38.9 | parameters.py `LOW_W, LOW_D, LOW_STACK`; entry 13, 14a |
| 부피 / 질량 | **116.3 cm³** (코드) · STEP 117.2 cm³ (08-21 판) / AL 2.7 g/cm³ 환산 **314\~316 g**, PLA 100% 인필 **144 g** | 플랜지 있던 형상 137.0 cm³ (STEP) · 143 cm³ / 387 g (08-15 통짜) | entry 14a, 15, docs/bom.md |
| 블록 높이 `LOW_H` / 다리 폭 `LOW_POST_W` | 24 / 24 | 다리 18 은 가늘어 보여 24 로 (08-15). 텅(TONGUE=1) 켜면 40 | parameters.py |
| 다리 사이 통로 / 다리 중심 | 44.72 (= 기존 클램프 42.72 + 2) / x = ±34.36 | — | parameters.py `LOW_CLAMP_GAP, LOW_POST_X` |
| 레일 홈 / 축 시트 | 30.6 (30 + 0.3 × 2) / Ø16.2 (반경 여유 0.10) | — | parameters.py `LOW_RAIL_FIT, SADDLE_SEAT_FIT` |
| 핀치갭 / 클램프 윗면\~레일 밑면 | 0.4 / 2.0 | 핀치갭이 0.07 보다 작으면 상부 클램프가 축이 아니라 하부 블록에 앉는다 | parameters.py `SADDLE_PINCH, LOW_RAIL_CLR` |
| 부품 밑면 \~ 레일 밑면 | 38.9 (= 24.4 + 14.5) | — | parameters.py `LOW_STACK` |
| 레일 체결 볼트 | **M6 × 15 둥근머리 렌치볼트 × 2** [실측] + 스프링너트 306 × 2 (밑면만) | 플랜지 시절 밑면 M6×45 × 2 + 옆면 M6×20 × 4 = 6개 → 08-21 밑면 M6×20 × 2 로 → 실물이 15 mm | parameters.py `LOW_BOLT_LEN`, docs/bom.md |
| 카운터보어 | **Ø16 × 32.3** (= 38.9 + 립 2.4 + 물림 6 − 볼트 15, 볼트 길이에서 역산), 머리 위 살 6.6 | 27.3 (M6×20 전용 손값, 여유 0) — 15 mm 볼트로는 스프링너트에 안 닿았다 | parameters.py `LOW_CBORE, LOW_HEAD_FLOOR`, low_clamp.py `rail_bolt_len()` |
| 상하 클램프 체결 | M6 탭 × 4 (x ±15.1, y ±11.87) | — | parameters.py `OEM_BOLT` |
| 지상고 (클램프 밑면) | **54.9** (79.35 − 24.4) | 차량 장면(`wheel_mount.mount_low`)은 55.35 | low_clamp.py `LOW_BOT`, entry 16 |
| 타이 탭 | profile 모드: 브래킷 M6 탭 x=±22, z=−6 / −19, 깊이 12 · rod 모드: M8 탭 x=±24.3, z=−18.0, 깊이 15 (벽 3.3) | M8 탭 깊이 12 (08-21) → 15 (봉 400 고정 뒤) | parameters.py `TIE_BRK_*, TIE_X, TIE_Z, TIE_TAP_DEPTH` |
| 옆 플랜지 (LOW_SIDE, 기본 꺼짐) | 두께 8, 옆면 M6×20 × 4. PETG 굽힘 42 MPa = 한계의 93% / AL 15% | 켜면 옆면 전단 716 N (9%) 로 인발 문제가 사라지지만 PETG 에서 툭 쳐서 부러졌다 | parameters.py `LOW_SIDE, LOW_FLANGE_T, LOW_SIDE_BOLT_LEN`, entry 14b |
| 출력 STL | 92.72 × 46.60 × 38.90, 4,332 삼각형, 최저면 z=0. 4개 출력, 3.2 h / 개 | — | output/stl/design_d_lower_clamp_print.stl, docs/bom.md |
| CNC 견적 (참고) | JLC 6061 4개 \$228 (개당 \$57), MJF 나일론 \$285 — 단 ㄷ자 203 cm³ 시절 견적 | — | entry 10a, build-log.md 32절 A |

`low_clamp.report()` 손계산 사용률 (800 N, 09-15 실행). 통짜 보로 본 값이라 구멍 주변 국부 응력은 못 본다 — 국부 응력은 아래 FEA 카드다.

| 경로 | 값 | 한계 | 사용률 |
| --- | --- | --- | --- |
| 다리 ↔ 레일 지압 (누르는 방향, 지배 하중) | 0.8 MPa | 60 | 1.3% (랜드 10.9 × 2 × 다리 2 = 1,046 mm²) |
| 타이 M8 인장 (× 2) | 483.5 N | 14,054 | 3.4% (모멘트의 73%) |
| 레일 밑면 볼트 인발 | **384.5 N** | 1,500 | **25.6%** (타이 없으면 1,432 N / 95.5%) |
| 들어올릴 때 볼트 인장 | 15 N | 1,500 | 1.0% |
| 다리 굽힘 / 블록 굽힘 / 축 시트 면압 | 2.5 / 4.8 / 1.1 MPa | 240 / 240 / 120 | 1.0 / 2.0 / 0.9% |
| 상부 클램프 볼트 전단 (29 N·m / 4개 / 반경 19.2) | 377.6 N | 8,000 | 4.7% |

주의: `report()` 의 타이 행은 `TIE_KIND` 가 `profile` 이어도 M8 봉 강성으로 계산한다(`tie_force()` 가 봉 전용). 3030 타이의 분담률 손계산은 저장소에 없다.

---

## 5. FEA — 하부 클램프 단품 (STEP → Gmsh C3D10 → CalculiX 2.23)

기준 조건은 **800 N · 편심 55 mm · 상향(노면이 바퀴를 밀어 올림) · 3 mm 메쉬 · 바닥 볼트 구멍 2개 벽 강체 고정** 이다. 최대 von Mises 는 구멍 벽 모서리(z=+14.50, 반경 3.30 mm) 특이점이라 메쉬를 조일수록 오르므로(4 → 3 mm 에서 +13.5%) 인용하지 않고, 구멍에서 3 mm 밖의 **구조응력**(`tools/fea/structural_stress.py`)과 변위만 쓴다.

| 케이스 (Design-D 현재 형상, 38.9 mm) | 요소 | 최대 (특이점) | 구조응력 | 최대변위 | 타이 반력 Fy | 어디에 남아 있나 |
| --- | --- | --- | --- | --- | --- | --- |
| AL6061-T6 · 타이 없음 · 4 mm | 18,581 | 132.2 MPa | 45.1 MPa | 0.0577 mm | — | 문서만 (FEA.md §4, CLAUDE.md) |
| **AL6061-T6 · 타이 없음 · 3 mm (기준)** | 35,739 | 150.1 | **45.3 MPa** | **0.0582 mm** | — | 문서만. 반력 합 −800.001151 N |
| PETG 근사 (E 2,100) · 타이 없음 · 3 mm | 35,739 | 144.4 | 45.6 | 1.9067 | — | 문서만. 축 시트 바깥 밀림 +0.672 mm |
| AL · M8×2 타이 · 4 mm | 18,581 | 90.3 | 30.1 | 0.0372 | 553 N | output/fea/clamp_800N_h4mm_e55mm_up/summary.txt (현재 그대로) |
| AL · M8×2 타이 · 3 mm | — | 100.0 | **30.3** | **0.0371** | 557 N | 문서만 (entry 14b) |
| PETG · M8×2 타이 · 3 mm | — | 27.3 | 17.8 | 0.2659 | 557 N | 문서만. 바깥 밀림 −0.0235 mm |
| PETG · 3030×360 타이 · 3 mm | 40,536 | 26.5 | 17.8 | 0.2627 | 1,268 N | output/fea/clamp_800N_h3mm_petg_e55mm_up/summary.txt (현재). 바깥 밀림 −0.0244 |
| AL · 옆 플랜지 복원(LOW_SIDE=1, 구멍 6개) + 타이 · 3 mm | 48,391 | 18.0 | — | 0.0076 | 61 N (타이가 논다) | output/fea/clamp_800N_h3mm_e55mm_up/summary.txt (현재). 타이 노드 1,080개는 선택 버그(정상 10개) |

| 안전율 (구조응력 기준) | 타이 없음 | M8×2 타이 | 출처 |
| --- | --- | --- | --- |
| AL6061-T6 (항복 276) | **6.1** | **9.1** | FEA.md §4, entry 14b |
| PETG 등방성 근사 (50) | **1.1** — 800 N 에서 재료 한계, 변위 1.91 mm | 1.49 | 같음. 출력품에는 사람을 태우지 않는다 |

결과 폴더는 조건이 바뀌면 같은 이름으로 덮인다. 그래서 **기준값 45.3 / 0.0582 는 지금 어느 `summary.txt` 에도 없고** CLAUDE.md · FEA.md §4 · CLAUDE_HANDOFF.md §7 에만 있다. `clamp_800N_h3mm_e55mm_up` 폴더의 현재 내용(18.0 MPa / 0.0076 mm)은 플랜지 복원 실행이다.

| 비교·이력 케이스 | 조건 | 최대 응력 | 최대변위 | 출처 |
| --- | --- | --- | --- | --- |
| 플랜지 있던 63.9 mm 형상 (구멍 6개 고정) | AL, 800 N 편심 55 상향, 3 mm | 17.677 MPa | 0.007293 mm → 플랜지 제거로 변위 **8.0배** | FEA.md §4, CLAUDE.md |
| 같은 옛 형상, 편심 0 · 하향 | AL, 3 mm 46,928 요소 / 4 mm 24,128 | 4.036 / 3.613 MPa | 0.001400 / 0.001390 mm | output/fea/clamp_800N_h3mm, \_h4mm (현재 그대로) |
| 구형 긴 ㄷ자 `legacy_u` (거싯 있음, 70 × 40 × 176.35, 202.8 cm³) | AL, 편심 0 하향, 3 mm 58,158 요소 | 15.816 MPa | 0.009374 mm (Design-D 대비 응력 3.92× / 변위 6.70×) | output/fea/legacy_u_800N_h3mm, comparison_800N.md |
| **실물 파손 재현** `legacy_u_nogusset` (열린 면 차량 안쪽) | PETG, 800 N 편심 55 상향, 3 mm / 4 mm | 44.373 / 45.917 MPa (PETG 45 의 99%) | 2.979 / 2.967 mm, 최대 바깥방향 2.819 mm, 아래 볼트열(z=170.3)부터 휨 | output/fea/legacy_u_nogusset_800N_h3mm_petg_e55mm_up, legacy_failure_reproduction.md |
| 축 시트 바깥(+Y) 밀림 평균 | 구형 PETG / 현재형 PETG / 현재형 AL (타이 없음) | +2.16 / +0.67 (3.2배 적음) / +0.02 mm (103배 적음) | entry 14a (VTU 직접 추출) |  |

재료 카드: AL6061-T6 E 68,900 MPa, ν 0.33 / PETG E 2,100, ν 0.38 (등방성 근사, PLA 카드는 없음). 반력 합은 모든 케이스에서 입력 800 N 과 1.2e-3 N 이내다. 모델에 없는 것: 볼트 프리로드·접촉·T너트 변형·충격·피로·적층 방향. 결과만으로 허용하중이나 안전을 단정하지 않는다.

---

## 6. 액슬 타이 — 좌우 클램프를 잇는 순수 인장 부재

> 휘어짐을 최우선으로 해결해야한단말이야 (08-21 02:47) / 397.4mm 는 애매한것 같은데? (08-21 07:57) / 390 사이즈라니까 왜 360이야? (08-27 02:42)

63_why_tipping_moment

좌우 클램프는 젖힘 모멘트로 아랫부분이 서로 반대로 벌어진다. 둘을 이으면 그 부재는 순수 인장만 받는다. 코드에는 두 종류가 있고 기본값은 `TIE_KIND="profile"` 이다. 인수인계 문서 §5.0 은 아직 M8 봉 기준이라 서로 다르다.

| 항목 | M8 전산볼트 (rod) | 3030 프로파일 (profile, 기본값) | 출처 |
| --- | --- | --- | --- |
| 클램프 안쪽면 사이 간격 | **373.4 mm** (= 2 × (210 − 46.6 / 2)). 프레임 폭 450 과 클램프 깊이 46.6 에서 나오는 고정값 | low_clamp.py `TIE_GAP` |  |
| 부재 | Ø8 × **400 mm × 2** (1 m 봉 2개에서 4개, 자투리 200 × 2). 유도값 397.4 는 절단 지시로 못 써서 폐기 | 3030 × **360 mm × 1 / 축** (여분 390 에서 30 절단), z=−9.4 (밑면 −24.4 = 클램프 밑면, 지상고 유지) | parameters.py `TIE_ROD_LEN, TIE_PROF_LEN, TIE_PROF_Z` |
| 물림 / 탭 | 탭 깊이 15, 한쪽 물림 13.3 (허용 8 \~ 14, ±2 mm 절단 오차 흡수). 탭 x=±24.3 z=−18.0, 양쪽 벽 3.3 (M10 은 2.5) | 코너 브래킷 L자 6t, 축당 4개, 클램프 탭 M6 × 2단 (x=±22, z=−6 / −19, 깊이 12) + 슬롯 볼트 1. 프로파일 끝 ±180 ↔ 클램프 면 ±186.7 사이 6.7 mm 를 브래킷이 메운다 | parameters.py, low_clamp.py `tie_brackets()` |
| 축강성 EA / 지레 / 회전강성 | 15.1e6 N / 32.5 mm / **7.96e7 N·mm/rad** | 28.0e6 / 23.9 / **8.89e7 (+12%)** | entry 15 (08-27 계산) |
| 손계산 분담 (강철 E 206,000) | 모멘트 **73%** / 봉당 483.5 N / 레일볼트 384.5 N (25.6%). 08-21 알루미늄 E 로 잘못 계산했을 때 47% / 311 N / 759 N (51%) | 손계산 없음 | low_clamp.py `tie_force()`, CLAUDE_HANDOFF.md §5.0 (구값) |
| 봉 인장 응력 | M8 19.3 MPa (8.8급 안전율 33) · M6 35.1 (18) · M10 12.2 (53) | 3030 은 706 N 인장에 100배 과잉 | entry 14b |
| FEA 타이 반력 Fy | AL 553 / 557 N (4 / 3 mm), PETG 557 N | PETG 1,268 N (반력 2.3배인데 변위는 1.2% 차이 — 병목이 클램프 몸체로 넘어갔다) | summary.txt (카드 5) |
| 휨 개선 (PETG, 800 N) | 축 시트 바깥 밀림 +0.672 → −0.0235 / −0.0244 mm (**28배**), 전체 변위 1.907 → 0.266 / 0.263 mm (7.2배). PLA 스케일 예측 −0.014 mm | entry 14b, 15 |  |
| 비용 | M8 1 m 봉 2개 약 1만원 | 프로파일 0원(재활용) + M6×20 16개 1,440 + 드롭인 T너트 8개 2,800 = **4,240원** + 브래킷 PLA 8개 1,544원 | docs/bom.md (entry 16) |
| 접은 안 | 평철 20 × 6 (분담 64%, 인장 706 N, 레일볼트 516 N = 34% — 성능 최고지만 구매 어려움) · 390 그대로 (16.6 mm 길고 30 × 30 끝면 얹을 자리 없음) · 기존 축 크로스 (레일끼리 잇는 부재라 무관) · 바퀴 안쪽 이동 (5%) | CLAUDE_HANDOFF.md §5.0 |  |
| 미결 | 클램프 깊이 46.6 → 30 으로 줄이면 간격 390 이 되어 여분 390 을 안 자르고 쓴다(타이 X 오프셋 25 필요). 08-27 02:45 에 물은 채 끝났고 `LOW_D` 는 아직 46.6 | entry 15 |  |

docs/bom.md 는 "3030 L360 × 2 + PLA 브래킷 8 + 드롭인 T너트 8" 로, parameters.py 는 `TIE_PROF_LEN = 360` 으로, CLAUDE_HANDOFF.md §5.0 은 "Ø8 × 397.4, 탭 12" 로 적혀 있다. 코드 기본값이 profile 이라는 것까지는 확실하고, 실차에 어느 쪽을 달았는지는 저장소에 없다.

---

## 7. 너트 인발 — 이 프로젝트에서 유일하게 안 잰 설계 변수

| 항목 | 값 | 비고 | 출처 |
| --- | --- | --- | --- |
| 설계에 쓰는 보수 하한 `TNUT_PULLOUT` | **M6 1,500 N** / M8 4,000 N | 볼트 굵기에서 유도. M8 값 4,000 을 3030(M6) 에 쓰다가 사용률을 36% 로 잘못 봤던 적이 있다(실제 95.5%) | parameters.py |
| 립 굽힘 모델 추정 (3030 립 2.4t, 6063-T5 170 MPa) | 경제형 스프링너트(물림 10) **933 N** / 표준(14) 1,632 / 드롭인 T너트(16) **2,271** / 슬라이드 T너트(20) 3,264 / 일체형 텅 40 mm 6,528 N | 인발 파괴는 너트가 아니라 슬롯 립이 벌어지는 것. 순서는 확실, 절대값은 추정. docs/bom.md 의 933 / 2,271 이 이 값이다 | entry 14b, 15, docs/bom.md |
| 조인트 축강성 (립 + 너트 직렬) | 23,430 / 61,363 / 98,415 / 129,061 N/mm | 박판 스프링너트는 자기가 먼저 휘어 립 강성의 1/3 만 쓴다 | entry 14b |
| 레일 밑면 볼트 인발 (800 N) | 타이 없음 **1,432 N = 95.5%** → M8 타이 (보수, FEA 강체 조인트) 759 N 51% / (실제 추정) 264 N 18% → 현재 `report()` 384.5 N 25.6% | 759 는 알루미늄 E 로 계산한 08-21 값, 384.5 는 강철 E 로 고친 값 | CLAUDE_HANDOFF.md §5.0 / low_clamp.py |
| 스프링너트 예압 → 마찰 (플랜지 전단 경로) | 경제형 560 → 112 N / 드롭인 1,363 → 273 / 슬라이드 1,958 → 392 N | 옆 플랜지 볼트 전단 716 N 은 어느 너트로도 미끄러진다 → 통과공 유격 0.6 mm 가 그대로 휨 (다월핀 아니면 의미 없음) | entry 14b (정정 2) |
| 경로별 한계 하중 (800 N 기준 환산) | PETG 본체 795 N · 레일볼트 인발 1,500 → 838 N / 3,000 → 1,676 / 4,000 → 2,235 · AL 본체 4,874 N · 상부 클램프 볼트 전단 16,949 / 블록 굽힘 40,056 / 지압 62,784 N | 알루미늄으로 가면 클램프는 6.1배 강해지지만 병목이 너트로 옮겨가 1.05 \~ 2.8배로 깎인다 (타이 없음 기준) | entry 14a |
| 실측 | **없음** | 08-15, 08-21, 09-15 세 번 "실측 권장" 으로 남겼다. 스프링너트 두께(2 mm대 vs 5 mm대)도 안 쟀다 | README.md 표 12번, CLAUDE_HANDOFF.md §1 |

---

## 8. BOM — 전체 버전 (docs/bom.md, 09-10, tools/bom/bom.py 가 형상에서 뽑음)

| 구분 | 금액 | 비고 |
| --- | --- | --- |
| 보유 (프레임·모터 4·기존 클램프 4·철물·배터리) | 471,840원 | 실물 상태 기준 판정 |
| 출력 (필라멘트 값만) | 563,256원 | 실패분·서포트·전기 미포함, 실무는 +30\~50% |
| 구매 | 941,382원 | 단가 대부분 [추정] |
| **전부 신품 합계** | **1,976,478원** | — |
| **지금 추가로 드는 돈 (출력 + 구매)** | **1,504,638원** | 판재 전환 시 1,212,211원 |

| 카테고리 | 금액 | 큰 항목 |
| --- | --- | --- |
| 1. 프레임 | 99,280원 | 프로파일 72,200 + 브라켓 10,080 + 볼트 4,760 + 너트 12,240 (전부 [확인] 단가) |
| 2. 판재 | 51,342원 | PC/ABS 3t 0.67 + 0.40 m² |
| 3. 구동부 | 242,760원 | 허브모터 4 × 55,000 [추정] + Design-D 4개 14,416 + 타이 4,240 + 브래킷 1,544 + 볼트·너트 |
| 4. 외장·차체 | 171,105원 | 외장셸 2개 82,962 (2,178 cm³, 60.5 h) |
| 5. 전자·제어 | 495,000원 | RPi5 130,000 · 드라이버 2 90,000 · 배터리 150,000 (보유) |
| 6. 센서·표시 | 382,000원 | RGBD 180,000 · 소형 카메라 6 90,000 |
| 7. 적재함 | 534,991원 | 적재함 셸 197,316 (5,179 cm³, 143.9 h) |

| 병목 항목 | 값 | 출처 |
| --- | --- | --- |
| 출력물 총량 / 시간 | **14,600 cm³ / 약 406 시간** (0.4 노즐 · 0.2 층 · 유효 토출 10 mm³/s). 프린터 1대로 17일 | docs/bom.md |
| 시간 상위 5 | 적재함 셸 144 h · 외장셸 60 h · 장비베이 지붕 60 h · 뚜껑 44 h · 바구니크래들 21 h | docs/bom.md |
| 베드 초과 (Ender-3 V3 SE 220 × 220 × 250) | **14건**: 적재함 셸 810 × 510 × 269 → 24조각, 외장셸 × 2 510 × 404 × 254 → 각 12, 장비베이 지붕 810 × 510 × 40 → 12, 뚜껑 529 × 349 × 58 → 6, 배터리브라켓·범퍼 × 2·슬라이드채널 × 3·장비마운트 2종·바구니크래들 | docs/bom.md |
| 큰 셸 4종 판재 전환 시 | 출력 423,193 → 판재 130,766원 (**−292,427원**), 출력 309 h (**76%**) 절감. 재단·굽힘 공수와 이음 철물은 미포함 | docs/bom.md |
| 타이만 지금 사면 | 4,240원 (M6×20 16개 + 드롭인 T너트 8개). 클램프 4 + 브래킷 8 출력분 약 15,960원 / 약 14 h | entry 16 (bom.md 상세 행에서 재합산) |

견적 이력(구성이 달라 직접 비교 금지): 07-28 "베이스만" 31.7\~66만원 → build-log 32절 A 현행 스키드 베이스만 **482,000 \~ 992,000원** (필라멘트·판재 학교 장비 0원 가정) / 스워브 887,000 \~ 2,483,000원 → 09-10 적재함·필라멘트 포함 1,976,478원. 실주문 단가 4개(프로파일·브라켓·볼트·너트) 말고는 전부 시장가 눈대중이라 배로 틀릴 수 있다고 bom.md 스스로 적고 있다.

---

## 9. 문서끼리 어긋나 있는 숫자 (09-15 확인)

- **액슬 타이**: parameters.py `TIE_KIND="profile"` 360 mm / docs/bom.md 3030 L360 + PLA 브래킷 / CLAUDE_HANDOFF.md §5.0 M8 × 397.4 탭 12 / parameters.py `TIE_ROD_LEN` 400 탭 15. 문서 §5.0 은 08-21 07:57 이후 갱신되지 않았다.
- **레일볼트 인발 (타이 적용)**: 인수인계 759 N 51% (알루미늄 E) vs 코드 384.5 N 25.6% (강철 E). 코드가 맞다.
- **FEA 기준값**: CLAUDE.md 의 45.3 MPa / 0.0582 mm 는 `clamp_800N_h3mm_e55mm_up/summary.txt`(18.0 / 0.0076, 플랜지 복원 실행)와 맞지 않는다. 결과 폴더 이름이 LOW_SIDE / TIE 를 담지 않기 때문이다.
- **철물 수량**: build-log 32절 A M6×15 84 / 너트 84 (ㄷ자 마운트 16 포함) vs bom.md 68 / 68 + 하부 클램프 8 / 8. 현재 형상은 bom.md 쪽이다.
- **윤거**: swerve_base 520 (휠 중심 ±260) vs hoverboard_mount 통합 장면 ±263.7 (527.4). 실차가 어느 쪽인지 확실하지 않다.
- **PETG 항복**: 45 (FEA 카드·한계 하중 795 N) vs 50 (안전율 1.1).
- **스프링너트 인발**: parameters.py 1,500 (보수 하한) vs bom.md 933 (립 굽힘 모델 추정). 둘 다 실측이 아니다.
- **3030 단면**: tslot.py 384.10 mm² (방 16.5 / 보스 11.0) vs parameters.py 프리셋 406 mm² (방 16.4 / 보스 11.6). 어느 쪽도 실물 슬롯 실측이 아니다.
- **build-log.md**(28막 + 29\~32절)는 08-09 까지다. 실물 파손(08-12)·Design-D(08-15)·플랜지 제거·타이(08-21)·BOM(09-10)은 build-log 에 없고 CLAUDE_HANDOFF.md / FEA.md / bom.md 에만 있다.

---

## 교훈 — 숫자를 모으면서 확인된 것

- 손으로 박은 치수는 반드시 깨진다. 카운터보어 27.3 은 M6×20 전용 값이었고, 볼트가 15 mm 인 순간 조립이 안 됐다. 지금 32.3 은 볼트 길이에서 역산하고 어서트가 지킨다.
- 유도값(397.4)은 발주 숫자가 될 수 없다. 400 으로 고정하고 공차를 흡수할 자리(탭 깊이 15)를 따로 뒀다.
- 재료 상수 하나(E 68,900 vs 206,000)가 타이 분담률 표 전체를 바꿨다(47% → 73%). 표에는 어떤 E 를 썼는지 같이 적어야 한다.
- FEA 최대응력은 인용하지 않는다. 강체 고정한 구멍 벽 모서리는 메쉬를 조일수록 오른다(132 → 150). 수렴하는 구조응력(45.1 → 45.3)과 변위만 설계값이다.
- 결과 폴더는 조건이 바뀌면 덮인다. 기준값은 폴더가 아니라 문서에 조건과 함께 적어야 남는다 — 45.3 / 0.0582 가 지금 문서에만 있는 이유다.
- 병목은 옮겨 다닌다. 클램프를 알루미늄으로 바꾸면 6.1배가 아니라 너트 인발 때문에 1.05\~2.8배다. 타이를 달면 병목이 클램프 몸체로 넘어가 타이를 더 뻣뻣하게 해도(반력 2.3배) 변위는 1.2% 밖에 안 바뀐다.
- 견적을 내 보니 돈보다 출력 시간(406 h)과 베드(24조각)가 먼저 걸렸다. 부피를 형상에서 집계하지 않았으면 안 보였을 숫자다.
- 유일하게 안 잰 변수(스프링너트 인발)가 하필 허용하중을 2배 넘게 좌우한다. 세 번 "실측 권장" 으로만 남았다.
