chungddong/NUBI/docs/worklog/topics/vehicle-2026-09-15-timeline.md

# 차체 설계 흐름 정리 (2026-07 ~ 09)

> 영역: 차체 · 작성: 2026-09-15 · 원본: 차체 설계 일지 `synth_timeline.html` (2026-10-13 Markdown으로 옮김)

설계 기록 전체를 한 장으로 줄인 것이다. 시각은 KST, 수치는 각 일지에서 옮겼다.

## 1. 무엇을 만들려 했나

실내·실외 주행 시험, 배달로봇 흉내, 적재함이나 로봇팔을 얹는 실험을 한 대로 다 하는 **다목적 테스트 베드**다. 사용자는 첫날 4륜 스키드 스티어, 중형 700×500, 8인치 바퀴를 골랐고, 이 성격이 뒤의 모든 판단 기준이 됐다.

> 기반이 되는 베이스 모빌리티 시스템이 필요해서 하는거야

결과물은 build123d 코드로 그린 파라메트릭 모델과 거기서 뽑은 절단표·도면·STEP/STL·FEA·BOM 이다. 51일 동안 구동계를 세 번, 휠 마운트를 다섯 번, 적재함을 네 번 다시 그렸고 실물이 한 번 부러졌다. 현재는 6.5인치 호버보드 허브모터 4개를 Design-D 하부 클램프로 3030 프레임(760×450, 축간 420 / 윤거 520)에 매단 4륜 스키드다.

19_v7_iso

47_skid_view_iso

## 2. 날짜별 타임라인

| 날짜 (KST) | 주제 | 결과 한 줄 | 일지 |
| --- | --- | --- | --- |
| 07-27 18:11\~19:56 | T슬롯 단면, 프레임 v1, 2층 베이, 라운드 커버 | 3030 프레임 700×500. 15 mm 떠 있던 빔을 연결성 검사로 잡음. | [07-27 (월) 18:11\~19:56 KST — 프로파일 단면에서 측면 커버까지](../2026-07.md#2026-07-27-월--차체-프로파일-단면에서-측면-커버까지) |
| 07-27 20:04\~21:24 | 비상정지·포트 도어, 얼굴, 환기·배선·배터리 | 105쌍 간섭 0, 770×696×335. 뷰어 UI 깨짐은 브라우저 캐시. | [07-27 (월) 20:04\~21:24 KST — 커버 기능 요소: 후면 패널·얼굴·환기·배선·배터리 브라켓](../2026-07.md#2026-07-27-월--차체-커버-기능-요소-후면-패널얼굴환기배선배터리-브라켓) |
| 07-27 21:25\~23:43 | 허브모터 배제 → PVC 바퀴, 모터 계산·탐색 | μ 0.8→0.5 로 필요 출력 100→30 W. 축간 500→400, 0.90 축소(630×450). | [07-27 (월) 21:25\~23:43 KST — 허브모터 배제와 구동계 재검토](../2026-07.md#2026-07-27-월--차체-허브모터-배제와-구동계-재검토) |
| 07-27 23:46 \~ 07-28 02:03 | 모터 후보 전멸, **호버보드 결정**, build-log 시작 | 사용자 한마디로 구동계 확정. `docs/build-log.md` 첫 작성, 렌더 21장 저장. | [07-27 (월) 23:46 \~ 07-28 (화) 02:03 KST — 모터 후보 검토와 호버보드 허브모터 전환](../2026-07.md#2026-07-27-월--차체-모터-후보-검토와-호버보드-허브모터-전환) |
| 07-28 17:25\~23:37 | 스워브 변형 `swerve_base.py`, 킹핀·벨트·트레일링 암 | 차체를 바퀴 위로, 축간 520. "떠 있는 거 아니야?"가 결함 3개를 잡음. | [07-28 (화) 17:25\~23:37 KST — 스워브 전환: 킹핀·벨트·서스펜션](../2026-07.md#2026-07-28-화--차체-스워브-전환-킹핀벨트서스펜션) |
| 07-28 23:41 \~ 07-29 12:02 | `--\__/--` 스커트, Xtion 실물, 셸 플랜지, 스트로크 검사 | 트래블 25 mm 가 실제 3\~6 mm → 역산식, 전고 460. 소형 카메라 6, 삼면도. | [07-28 (화) 23:41 \~ 07-29 (수) 12:02 KST — 외장 --\\\_\_/--, 실물 Xtion, 그리고 움직이지 않던 서스펜션](../2026-07.md#2026-07-28-화--차체-외장---__---실물-xtion-그리고-움직이지-않던-서스펜션) |
| 07-29 16:26 \~ 07-30 02:44 | 중공 킹핀·하드스톱, 적재함 1\~3차, 손잡이, 첫 중량 | 슬라이드 방향을 두 번 반대로. "50 kg대"가 89 kg. `payload-interface.md`. | [07-29 (수) 16:26 \~ 07-30 (목) 02:44 KST — 배선 길을 뚫고, 적재함을 세 번 고치고, 무게를 처음 셌다](../2026-07.md#2026-07-29-수--차체-배선-길을-뚫고-적재함을-세-번-고치고-무게를-처음-셌다) |
| 07-30 07:42 \~ 07-31 11:07 | 센서 타워·팔·계측 모듈, 5종 검증, 문서 교정 | 모듈×베이스 0건, 내부 결함 5개. 낡은 값 9개 교정. | [07-30 (목) 07:42 \~ 07-31 (금) 11:07 KST — 모듈 3종을 더 얹고, 검사기를 의심하고, 도면을 다시 뽑다](../2026-07.md#2026-07-30-목--차체-모듈-3종을-더-얹고-검사기를-의심하고-도면을-다시-뽑다) |
| 07-31 11:20 \~ 08-01 01:11 | 아웃리거·확장 레일, **6.5인치 실물 STEP** | Ø210 은 PVC 잔재. 실측 Ø158.7×55, 축 Ø16 D컷 13. | [07-31 (금) 11:20 \~ 08-01 (토) 01:11 KST — 아웃리거·확장레일을 얹었다 걷어내고, 실물 6.5인치 바퀴로 다시 앉혔다](../2026-07.md#2026-07-31-금--차체-아웃리거확장레일을-얹었다-걷어내고-실물-65인치-바퀴로-다시-앉혔다) |
| 08-01 01:15\~13:27 | **스워브 포기**, 판재 클램프, 단륜 지그 | 4륜 고정 스키드, 축간 420(T/L 1.24), 전고 518. 0.1 mm 스캔으로 D컷 −46.5\~−3.7. | [08-01 (토) 01:15\~13:27 KST — 스워브를 접고 고정 브라켓·단륜 지그로](../2026-08.md#2026-08-01-토--차체-스워브를-접고-고정-브라켓단륜-지그로) |
| 08-01 13:29\~18:13 | 지그 축소, 100 mm 과금, 프린트 스탠드, 축 언더컷 | 지그 164→26 L, 390×7본. 닫힌 보어는 조립 불가. | [08-01 (토) 13:29\~18:13 KST — 시험 지그 축소와 허브모터 축 언더컷](../2026-08.md#2026-08-01-토--차체-시험-지그-축소와-허브모터-축-언더컷) |
| 08-01 20:41 \~ 08-05 16:44 | **축에 나사 없음**, U자+캡, 조인트 브라켓 30개, 3030 휠포스트 | 너트 폐기, 핀치 갭 1.0. 단가 950원/100 mm, 프로파일 83단위 78,850원. | [08-01 (토) 20:41 \~ 08-05 (수) 16:44 KST — 축 나사부 부재 확인과 휠브라켓의 3030 프로파일 전환](../2026-08.md#2026-08-01-토--차체-축-나사부-부재-확인과-휠브라켓의-3030-프로파일-전환) |
| 08-07 01:07\~03:44 | ㄷ자 휠마운트, 제작법 비교 | 70×40×151.4, 190 cm³. JLC CNC \$228 \< MJF \$285, 결국 학교 프린트. | [08-07 (금) 01:07\~03:44 KST — ㄷ자 휠마운트를 세우고 제작법을 고르다](../2026-08.md#2026-08-07-금--차체-ㄷ자-휠마운트를-세우고-제작법을-고르다) |
| 08-07 03:45\~14:34 | CNC/PRINT 분리, 클램프 볼트 M6, `drawings.py` 재작성, PLA 강도 | Ø8.128 은 0.32" 라운드값. 주행 응력 6.5 MPa — 탑승은 안 봄. | [08-07 (금) 03:45\~14:34 KST — 프린트판 분리, 프레임 이식, 도면 스크립트 복원](../2026-08.md#2026-08-07-금--차체-프린트판-분리-프레임-이식-도면-스크립트-복원) |
| 08-10 00:00 \~ 08-11 16:44 | build-log 21\~28막, **적재함 v2\~v4** | 높이 360→280, 유로 컨테이너 400×300, 적재 170→26 L. | [08-10 (월) 00:00 \~ 08-11 (화) 16:46 KST — 기록 공백을 채우고, 적재함을 기성 바구니 기준으로 다시 짰다](../2026-08.md#2026-08-10-월--차체-기록-공백을-채우고-적재함을-기성-바구니-기준으로-다시-짰다) |
| 08-12 20:32 \~ 08-13 01:09 | **실물 파손**, 손계산 오류, 거싯, 하단 클램프 안 | 800 N 에서 팔 119 %. 거싯 18 %. M6×15 물림 0.6 mm 발견. `mount_low` 91 cm³. | [08-12 (수) 20:32 \~ 08-13 (목) 01:09 KST — 휠 브라켓 파손 원인 분석과 하단 클램프 대안](../2026-08.md#2026-08-12-수--차체-휠-브라켓-파손-원인-분석과-하단-클램프-대안) |
| 08-14 11:18 \~ 08-15 13:42 | `hoverboard_mount`: A/B → C → **D** → 통짜 | 참조 3030 단면에 슬롯 없는 면. Design D 92.7×46.6, 다리 24. | [08-14 (금) 11:18 \~ 08-15 (토) 13:42 KST — 브라켓을 네 번 다시 그렸다: A/B → C → D → 통짜 D](../2026-08.md#2026-08-14-금--차체-브라켓을-네-번-다시-그렸다-ab--c--d--통짜-d) |
| 08-15 \~ 08-20 | 세션 밖 — GPT/Codex | 상·하부 폭 450 통일(크로스 390 ×8). STEP→Gmsh→CalculiX 파이프라인, 첫 기준 4.036 MPa. 구형 파손 재현 44.373 MPa / 2.979 mm. | [08-15 (토) 15:59 \~ 08-19 (수) 23:31 KST — 세션 밖(GPT/Codex): 프레임 폭 450 통일·FEA 파이프라인·구형 브라켓 파손 재현](../2026-08.md#2026-08-15-토--차체-세션-밖gptcodex-프레임-폭-450-통일fea-파이프라인구형-브라켓-파손-재현) |
| 08-21 00:17\~01:41 | 인수인계 검증, 옆 플랜지 파손·볼트 15 mm, FEA 재실행 | `LOW_SIDE=False`, 38.9 mm. 기준 45.3 MPa / 0.0582 mm(AL), PETG 1.907 mm. | [08-21 (금) 00:17\~01:41 KST — 인수인계 검증, 실물 파손 반영, 플랜지 없는 FEA, 젖힘 모멘트 시각화](../2026-08.md#2026-08-21-금--차체-인수인계-검증-실물-파손-반영-플랜지-없는-fea-젖힘-모멘트-시각화) |
| 08-21 01:43\~03:31 | **액슬 타이**, T너트, 휘어짐 기준 3회 정정, 프레임 해석 | 볼트 인발 1,432→759 N. PETG 변위 1.907→0.266 mm. 구석 탑승 865 N. | [08-21 (금) 01:43\~03:31 KST — 액슬 타이 보강과 휘어짐 기준 순위 정정](../2026-08.md#2026-08-21-금--차체-액슬-타이-보강과-휘어짐-기준-순위-정정) |
| 08-21 07:57 \~ 08-27 02:45 | 봉 400 고정, git 커밋, 재료 검토, T텅, **여분 3030 타이** | 커밋 `14fb653` 28.5 MB. `TIE_KIND=profile` 3030×360. M8 봉과 1.2 % 차이. | [08-21 (금) 07:57 \~ 08-27 (목) 02:45 KST — 봉 길이 400 고정, git 초기 커밋, 재료 검토, T텅, 여분 3030 을 타이로](../2026-08.md#2026-08-21-금--차체-봉-길이-400-고정-git-초기-커밋-재료-검토-t텅-여분-3030-을-타이로) |
| 09-10 10:43 \~ 09-15 19:08 | 전체 차량 뷰어, 형상에서 BOM, Trilium 조사 | 873×612×606. 신품 1,976,478원, 추가 1,504,638원. 출력 406 h, 베드 초과 14건. | [09-10 (목) 10:43 \~ 09-15 (화) 19:08 KST — 전체 차량 뷰어 탑재와 형상 기반 BOM 산출 (+ 09-15 일지화 착수)](../2026-09.md#2026-09-10-목--차체-전체-차량-뷰어-탑재와-형상-기반-bom-산출--09-15-일지화-착수) |

## 3. 큰 방향 전환

1. **허브모터 → PVC 바퀴 + 데드액슬 → 호버보드 인휠 허브모터 (07-27 → 07-28 01:03).** 정품 4개 112만원 대 호버보드 2대 24만원. 8인치를 예상했으나 실제 확보한 것은 6.5인치였다.
2. **4륜 스키드 → 스워브 + 서스펜션 → 다시 4륜 고정 스키드 (07-28 → 08-01).** 코너당 12종 부품·제어축 8, 스프링 13 N/mm 는 근거 없는 자리표시자였다. 코드는 `DRIVE=swerve` 로 남았다.
3. **바퀴 Ø210 가정 → 실물 STEP Ø158.7 (07-31).** PVC 스펙이 주석만 바뀐 채 살아남아 파생 치수 전부를 끌고 갔다.
4. **휠 마운트: 8t 판재 → 3030 휠포스트 → ㄷ자 프린트 → 파손 → Design-D 하부 클램프 (08-01 → 08-15).** 판재 가공 4\~20만원이 프로파일 한 토막 3,800원이 됐다가, 91.35 mm 캔틸레버 ㄷ자가 부러진 뒤 프레임을 축 위로 77 mm 내렸다.
5. **적재함 170 L 프린트 셸 → 유로 컨테이너 400×300, 26 L (08-10).** 배달로봇은 27\~50 L 로 수렴했고 이 설계는 4배였다. 바구니는 설계하지 않고 KLT 를 꽂는다.
6. **프레임 상부 폭을 하부와 같은 450 으로 통일 (08-16 → 08-17, 세션 밖 GPT/Codex).** `swerve_base` 기본값 `TOP_RAIL_Y=265` 면 상부 크로스가 500 이었는데 210 으로 낮춰 390 이 됐다. 390 크로스 8개, 기존 500 ×3 은 잘라 재사용. 길이 760 과 높이는 유지.
7. **손계산 → FEA, 강도 → 휘어짐 기준 (08-12 → 08-21).** "여유 7배"는 횡력 한 케이스뿐이었다. 목적함수가 바뀌자 보강 순위가 한 밤에 세 번 뒤집혔다.
8. **액슬 타이: 평철 → M8 전산볼트 → 여분 3030 (08-21 → 08-27).** 좌우 클램프가 반대로 젖히므로 이으면 순수 인장이다. 성능은 비슷했고 마지막 이유는 "남는 390 을 쓰자"였다.

60_hub_motor_real

63_why_tipping_moment

## 4. 지금 상태 (2026-09-15)

**차량.** `models/swerve_base.py`, 기본 `DRIVE=skid`. 허브모터 축 Ø16 D컷 1면, 나사 없음. `MOUNT=low` 전체 버전은 873 × 612 × 606, 지상고 55.35 이며 바퀴가 레일 윗면보다 34.8 mm 솟아 셸 휠아치 4곳이 아직 필요하다.

**Design-D 하부 클램프** (`models/hoverboard_mount/`). 각기둥에서 통로·레일 홈·축 시트만 파낸 통짜 92.7×46.6×38.9 mm, 116.3 cm³(AL 314 g / PLA 144 g). 기존 상부 클램프(채널 5.07 = D컷 평면 높이)와 M6×4 로 맞물리고 레일 밑면 M6×15 ×2 + 스프링너트로 매단다. 카운터보어 Ø16×32.3 은 볼트 길이 15 에서 역산. 옆 플랜지는 실물에서 부러져 기본 꺼짐. 설계 하중 800 N/바퀴, 편심 53.7 mm, 43 N·m.

**FEA** (STEP → Gmsh → CalculiX). 기준 800 N · 편심 55 · 상향 · 3 mm 에서 **구조응력 45.3 MPa / 0.0582 mm**(AL6061-T6 안전율 6.1), PETG 45.6 MPa / 1.907 mm 로 재료 한계. 타이를 넣으면 AL 0.0371, PETG 0.266(M8) / 0.2627 mm(3030). 구멍 벽 최대 von Mises 는 특이점이라 인용하지 않는다. 파손 재현 44.373 MPa / 2.979 mm. 프레임 보요소 해석은 구석 탑승 0.379 mm, 37 MPa.

65_frame_load_cases

**액슬 타이.** 기본 `TIE_KIND="profile"` — 여분 390 mm 3030 을 360 으로 잘라 PLA 코너 브래킷 8개로 클램프 안쪽면에 문다. M8×400 봉은 `rod` 옵션. 타이 분담 73 %, 레일 볼트 인발 1,432 → 385 N. 390 그대로 쓰는 안(클램프 깊이 30)은 미결, `CLAUDE_HANDOFF.md` §5.0 은 아직 봉 397.4 다. 유일하게 안 잰 값은 스프링너트 인발(보수 하한 1,500 N).

**BOM** (`tools/bom/bom.py` → `docs/bom.md`). 수량·부피·절단은 형상에서, 단가만 손으로(실주문 확인은 프로파일 950원/100 mm 등 4개). 보유 471,840 / 출력 563,256 / 구매 941,382원, 신품 1,976,478원, 추가 지출 1,504,638원. 출력 14,600 cm³ · 406 h, 베드 초과 14건(적재함 셸 24조각). 셸 4종을 판재로 바꾸면 −292,427원 · −309 h.

**저장소·문서.** git 은 08-21 커밋 `14fb653` 하나, 원격 없음. 09-10 의 BOM·통합 스크립트는 미커밋. `docs/build-log.md`(28막 + 29\~32절, 1,630줄)는 08-09 까지이고, 그 뒤(적재함 재설계·파손·Design D·FEA·타이)는 `CLAUDE_HANDOFF.md`·`FEA.md` 와 이 일지에만 있다.

## 교훈

- Claude 세션 안의 방향 전환 7개 중 5개는 사용자의 한 줄에서 나왔다 — "인휠모터 아닌가", "원래 구조는 어때", "프로파일로 대체할까", "휘어짐이 문제", "남는 390 을 쓰자".
- 간섭 0·어서트 통과는 안전도 조립 가능도 아니다. 떠 있던 빔, 안 움직이던 서스펜션, 닫힌 보어, 물림 0.6 mm, 슬롯 없는 참조 단면은 다른 검사(연결성·스윕·렌더·실물)로만 보였다.
- 가정을 실측으로 착각한 값이 가장 비쌌다. Ø210, 양면 D컷, 나사부, 장공 8.128, 볼트 20 mm — 실물 STEP 과 캘리퍼가 매번 뒤집었다.
- 산출물이 아니라 산출하는 코드를 남긴다. 스크래치패드의 도면 스크립트는 사라졌다. 유도값(397.4)을 발주 숫자로 쓰지 않는다.
- 재료를 바꾸면 병목이 옮겨간다. 클램프 6배는 너트 2\~3배로 깎였고, 타이를 단 뒤에는 타이를 키워도 변위가 1.2 % 만 움직였다.
