chungddong/NUBI/hardware/vehicle/models/hoverboard_mount/output/fea/legacy_failure_reproduction.md

# 구형 긴 ㄷ자 브라켓 실물 휨 재현

## 실물 설치 조건

- 파손 뒤 추가된 삼각 거싯 제거
- 상단 ㄷ자의 열린 면은 차량 내부, 웹은 바퀴 바깥쪽
- 상단 위·아래 M6 볼트 4개 모두 체결
- 타이어 접지점은 축/체결 중심보다 바깥쪽으로 약 55 mm
- 프레임 고정 기준 노면 반력 800 N 위 방향
- 등가 편심 모멘트: `800 × 0.055 = 44 N·m`
- PETG 등방성 근사: E=2,100 MPa, ν=0.38, 참고 항복 45 MPa

해석 STEP:
`output/step/legacy_u_bracket_no_gussets_open_inboard.step`

## 메쉬 수렴

| 목표 메쉬 | 요소 | 최대 von Mises | 최대변위 |
|---:|---:|---:|---:|
| 4 mm | 27,903 | 45.917 MPa | 2.967 mm |
| 3 mm | 55,892 | 44.373 MPa | 2.979 mm |

메쉬 변경에 따른 최대응력 차이는 약 3.4%, 변위 차이는 약 0.4%다.

## 변형 형태

3 mm 결과의 최대응력은 `[x,y,z] ≈ [15.4,-53.3,170.3] mm`, 즉 상단 ㄷ자의
아래 볼트열/아래팔 부근이다. 최대변위는 축 하단 바깥 모서리에서 2.979 mm이고,
그중 바깥방향 성분은 2.819 mm다.

| Z 구간 | 긴 다리 바깥방향 변위 중앙값 |
|---:|---:|
| 180~212 mm | 약 0.005 mm |
| 160~180 mm | 약 0.03 mm |
| 140~160 mm | 0.241 mm |
| 120~140 mm | 0.645 mm |
| 100~120 mm | 1.123 mm |
| 80~100 mm | 1.693 mm |
| 60~80 mm | 2.389 mm |

이는 “상단부는 붙어 있고 아래 볼트가 있는 부분부터 휘기 시작해 바퀴로 내려갈수록
바깥쪽 휨이 커졌다”는 실물 관찰과 일치한다.

## 현재 Design-D와 실제 노면하중 조건 비교

현재 Design-D에는 같은 800 N 위 방향과 55 mm 편심을 적용하고 실제 예정 재료인
AL6061-T6를 사용했다.

| 항목 | 구형 무거싯 PETG | 현재 Design-D AL6061 |
|---|---:|---:|
| 최대응력 | 44.373 MPa | 17.677 MPa |
| 참고 항복 대비 | 98.6% / 45 MPa | 6.4% / 276 MPa |
| 최대변위 | 2.979 mm | 0.007293 mm |
| 체결점 | 상단 위·아래 4개 | 바닥 2 + 측면 4개 |

재료가 다르므로 변위비는 순수 형상비가 아니다. 그러나 같은 힘-모멘트에서 구형의
응력도 현재형보다 약 2.51배 크다. 구형은 긴 다리가 외팔보로 작동하고 아래 볼트열
부근에 곡률이 집중된다. 현재형은 축-레일 거리가 짧고 6개 체결점으로 반력을 나눈다.

## 한계

PETG는 등방성으로 근사했다. 실제 FDM 부품은 출력 방향, 벽 수, 인필, 온도와
크리프에 따라 강성이 크게 달라진다. 볼트 프리로드·구멍 압궤·프로파일/T너트 변형도
아직 없다. 따라서 44.373 MPa가 실제 파손값이라는 뜻은 아니지만, 관찰된 변형 위치와
방향 및 항복에 가까운 하중 수준을 재현한 진단 모델로 사용할 수 있다.
