chungddong/NUBI/hardware/vehicle/models/hoverboard_mount/output/drawing/low_clamp_drawing.pdf

## 하부 클램프 LOW CLAMP — 호버보드 허브모터 휠 마운트 (Design D)

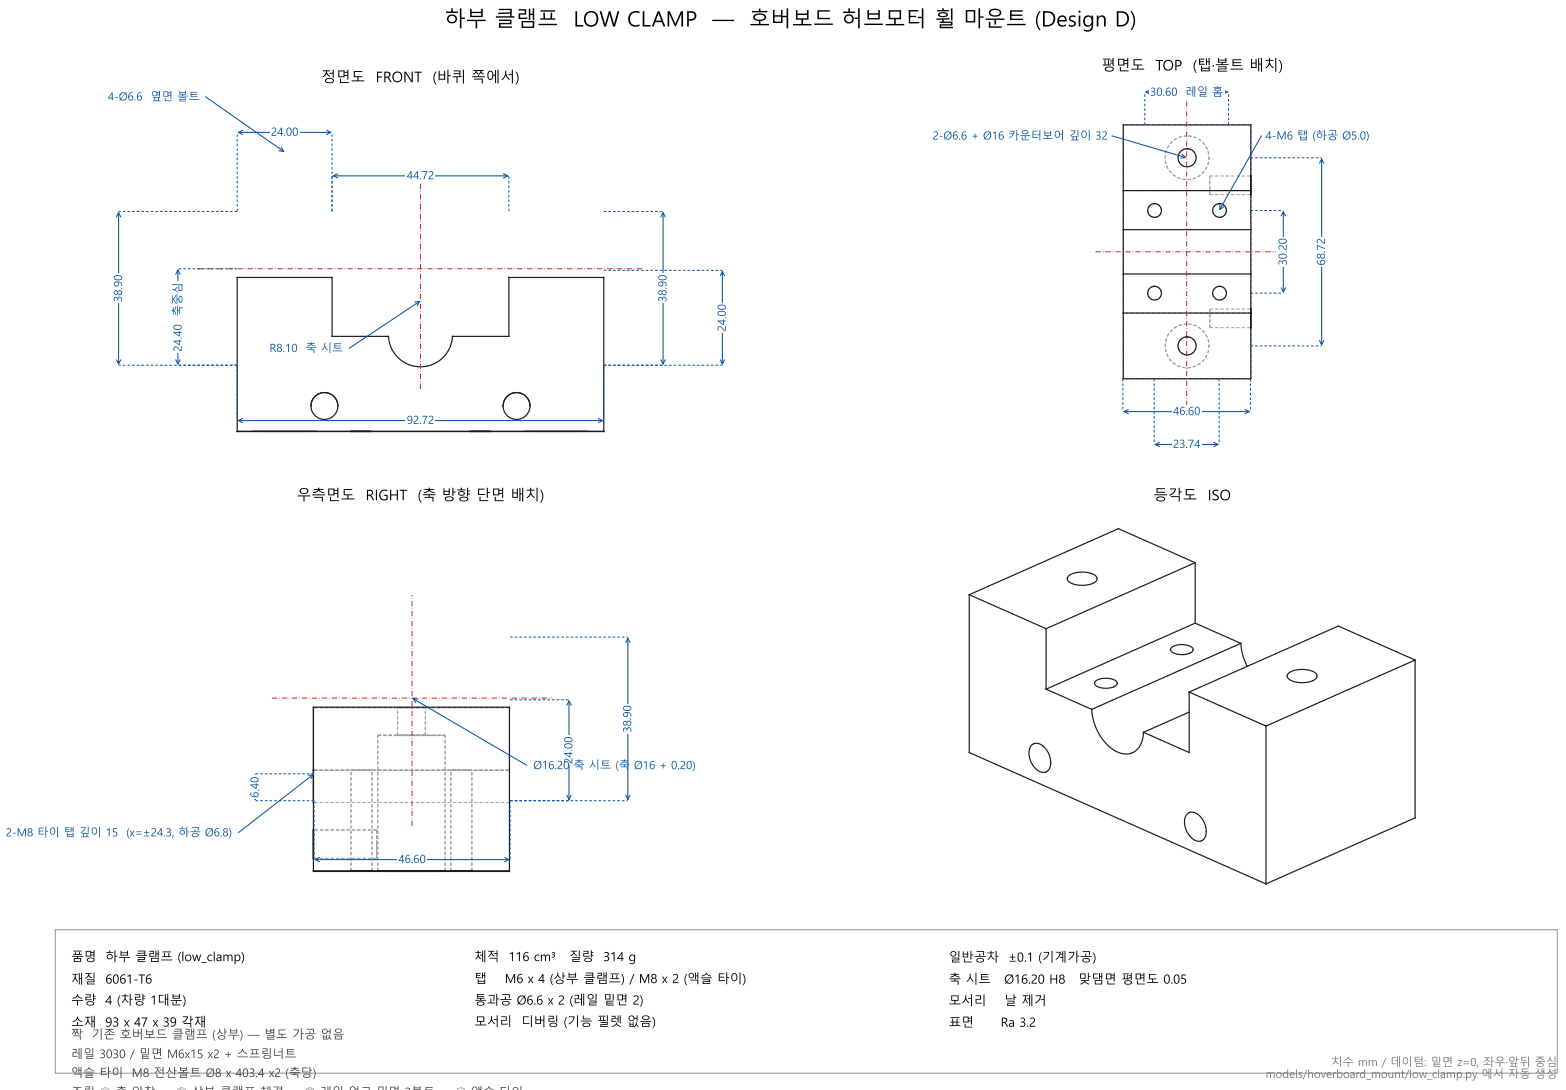
[picture p420: page 1]
24.40 축중심; 2-Ø6.6 + Ø16 카운터보어 깊이 32; 우측면도 RIGHT (축 방향 단면 배치); 등각도 ISO; M6 x 4 (상부 클램프) / M8 x 2 (액슬 타이); 모서리

평면도 TOP (탭·볼트 배치)

정면도 FRONT (바퀴 쪽에서)

품명 하부 클램프 (low_clamp)
짝 기존 호버보드 클램프 (상부) — 별도 가공 없음
레일 3030 / 밑면 M6x15 x2 + 스프링너트
액슬 타이 M8 전산볼트 Ø8 x 403.4 x2 (축당)
조립 ① 축 안착 → ② 상부 클램프 체결 → ③ 레일 얹고 밑면 2볼트 → ④ 액슬 타이

체적 116 cm³ 질량 314 g
통과공 Ø6.6 x 2 (레일 밑면 2)
모서리 디버링 (기능 필렛 없음)

일반공차 ±0.1 (기계가공)
축 시트 Ø16.20 H8 맞댐면 평면도 0.05

치수 mm / 데이텀: 밑면 z=0, 좌우·앞뒤 중심

models/hoverboard_mount/low_clamp.py 에서 자동 생성
