chungddong/NUBI/(commit log)

2026-08-08 feat:문서기록 및 도구추가
    DEBUGGING.md 227줄 삽질 기록 + 도구별 맹점
    README.md 306줄 배선·프로토콜·도구·안전·4륜 계획
    src/main.cpp 콘솔 + 진단 6종 + 안전장치 4중
    tools/ 5개 GUI, 스윕, 계산기, 회귀테스트, LED
2026-08-20 초기 커밋 — 호버보드 휠 마운트 + 모빌리티 베이스
    Design-D 하부 클램프를 중심으로 한 파라메트릭 CAD, 구조해석, 문서 일체.
    주요 구성
    - models/hoverboard_mount/ Design D 클램프 (parameters.py 가 치수 원본)
    - tools/fea/ Gmsh → CalculiX 솔리드 해석 (클램프 단품)
    - tools/frame/ 보요소 해석 (차량 프레임 전체)
    - tools/figures/ 설명 그림 생성기
    - docs/ 빌드로그, 도면, 인터랙티브 설명 페이지
    현재 설계 상태
    - 3030 프로파일, 옆 플랜지 없음(PLA 에서 부러져 제거), M6x15 밑면 볼트 2개
    - 액슬 타이 M8 전산볼트 x2/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
    [3030_extrusion_reference.step, 3030_profile.dxf, 4080_extrusion_reference.step, adapter_plate.step, adapter_plate.stl, assembly_A.step, assembly_B.step, axle_clamp_lower.step]
2026-10-13 저장소 정리 — README · .gitignore · requirements, 로그 추적 해제
    - README.md: 저장소 지도 (차량 프로젝트가 어디에 있나, 그 밖의 프로젝트, 빠진 것과 다시 만드는 법)
    - .gitignore: 차량 버전 산출물 (scene.npz · STEP, v28_wiring.step 만 예외), 로그 전체, 개인 설정,
    manuel_dm 시뮬 메시 제외. refmodel/ 은 차량에 필요한 호버보드 휠 모터 STEP 하나만 담게 바꿈
    - requirements.txt: 기록 도구 · 배선 라우터 · 도면에 쓰는 numpy · scipy · matplotlib · pillow · vtk · ezdxf
    - ocp-viewer-*.log 추적 해제 (실행마다 바뀌는 로그)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
2026-10-13 호버보드 마운트 · 구조해석 갱신 — Design D 클램프 변형, H 조립 · 프레임 해석
    - models/hoverboard_mount: 하부 클램프 혀 · 선반 · 옆판 · 타이 변형, 바닥판 (floor_plate · DXF · 도면),
    클램프 장면, 제작용 STEP · STL 갱신, FEA 케이스 결과 (summary · metrics · 응력 그림 — 중간 파일은 제외)
    - tools/fea: 구조응력 · 보강 비교 · H 조립 해석 · 시트 벌어짐, tools/frame: H 크로스 프레임 해석
    - docs: 재설계 전 BOM · 바닥판 재단 규격, 프레임 비교 그림
    [bom.csv, design_d_lower_clamp_print.stl, design_d_lower_clamp_print_tongue.stl, design_d_lower_clamp_print_tongue_cableL.stl, design_d_lower_clamp_print_tongue_cableR.stl, floor_plate.dxf, floor_plate.step, floor_plate_min.dxf]
2026-10-13 차량 재설계 v00 ~ v29 — 버전 기록 · 결정 기록 · 부품 조사
    - models/vehicle/vNN_*: 버전마다 동결 코드 + 이미지 (전체 · 변화) + README (사람 구역 + record.py 자동 구역)
    + BOM · DXF · scene.json (수치 · 검증). v01 프레임 → 바닥판 → 실물 부품 → 외관 → 카메라 · 비상정지 →
    전원 · 구동 (분리형 보드 4) → 포트 · 팬 → 전조등 → 상부 프레임 · 눈썹 안테나 → 덮개 → 모듈 레일 →
    센서 모듈 → v28 내부 배선 (검증 완료) → v29 바닥 배선 정리 (진행 중 — 검증 실패 남음)
    - record.py: 짓기 · 검증 · STEP · 뷰어 · 메시 캐시 · 이미지 ·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
    [bom.csv, floor_plate.dxf, shell_front.dxf, shell_lid.dxf, shell_lid_l.dxf, shell_lid_r.dxf, shell_rear.dxf, shell_side_l.dxf]
2026-10-13 차량 웹 시뮬레이터 — 주행 · 센서 · 전원 · 사각지대 · 전복 · 비상정지 · 자율주행 · 복도
    - models/vehicle/sim: web_export.py (버전 메시 캐시 → 웹 데이터), three.js 앱 (스키드 스티어, 지형 자세),
    센서 (뎁스 카메라 · 라이다 · 전조등 · 표시등), 전원 추정 (D-04 식), 사각지대 지도, 전복 · 무게중심,
    비상정지 방식 4 비교, 점유 격자 + A* + 간이 DWA 자율주행, 복도 환경 (import_hallway.py 로 다른 프로젝트에서 복사)
    - 웹 데이터 · 복도 맵은 .gitignore (web_export.py · import_hallway.py 가 다시 만든다). 결과 기록은 DECISIONS D-18 · D-19
    Co-Authored-B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
2026-10-13 feat: 탱크 구동 모드, 데드밴드, NVS 설정 추가
    - 구동 모드 v 0|1: 보드 믹싱(기본) / 탱크(링크 A=왼쪽, B=오른쪽, ESP32가 믹싱)
    - 링크 B 반전 i 0|1, 데드밴드 b <n>(기본 200): 0이 아닌 명령을 [deadband, max]로 재매핑
    - 세 설정을 NVS(Preferences)에 저장, 웹 페이지 설정 UI와 /api/cfg 추가
    - 탱크 모드는 두 링크가 모두 살아 있어야 구동, CUT 이유를 웹에 표시
    - 시리얼 리포트 끝에 실제 전송값 out A B 추가
    - README에 Drive modes 절과 새 명령 반영
    작업은 2026-09-17~09-22, 보드에는 그때 이미 플래시됨(빌드 806,889 B 동일).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
2026-10-13 docs: 날짜별 작업 일지(WORKLOG)와 이슈 목록(ISSUES) 정리
    - WORKLOG.md: 2026-08-08 ~ 10-13 작업을 날짜별 항목으로 정리
    (날짜 색인, 항목마다 날짜 근거, 커밋, 관련 이슈 표기)
    - ISSUES.md: 현장 발견(N1~N4), 하드웨어·빌드물(H1~H3), 코드 리뷰(R1~R12, U1~U11)와 우선순위
    - 2026-10-13 확인: 메인보드 커스텀 bin이 임시 폴더 정리로 소실됨(H1)
    - README: 문서 안내에 ISSUES.md 추가
2026-10-13 docs: 누비 통합 저장소 구조와 문서 뼈대
    폴더 구조(docs, hardware, firmware, software, sim, tools, data, experiments)와
    폴더별 README, 시스템 개요, 작업 기록, ADR 템플릿, gitignore/gitattributes.
2026-10-13 firmware: wheel-controller 통합 후 정리
    - 추적되던 tools/__pycache__/*.pyc 제거 (ISSUES R12 일부)
    - requirements.txt 추가, README에 venv 생성 절차 (ISSUES U10 일부)
    - README 머리말과 WORKLOG에 통합 안내. 이후 일지는 docs/worklog/에 씀
    - 저장소 문서의 링크를 GitHub에서 저장소 안 경로로 바꾸고 이전 상태 갱신
2026-10-13 작업일지 · 보조 도구 — 모빌리티 베이스 일지 (2026-07 ~ 09), BOM 집계
    - docs/journal: 작업일지 HTML (날짜순 일지 · 결정 · 배운 것 · 숫자 · 다음 할 일)
    - tools/bom: BOM 집계
2026-10-13 차량 전용 저장소로 분리 — README · CLAUDE.md · SETUP · .gitignore · 실행 설정
    D:\build123d 작업 저장소에서 차량 부분 (models/vehicle · hoverboard_mount · 초기 스크립트 · FEA · 문서 · 작업일지 ·
    휠 모터 STEP) 만 커밋 기록째로 떼어 왔다 (2026-10-13).
    - README.md: 차량 저장소 지도 · 지금 상태 · 빠진 것과 다시 만드는 법
    - CLAUDE.md: 차량 작업 규칙 (버전 폴더 · record.py · 결정 기록 · 국내 구매처 · 대조군) + FEA 안내
    - SETUP.md: 이 저장소 기준 설치 · 사용법 (기록 · 웹 시뮬)
    - .gitignore: 다른 프로젝트 항목 정리, .claude/launch.json 은 vehicle-sim 만, requ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
2026-10-13 hardware: 차체 설계 작업 공간을 받을 자리 정리
    - 빈 자리였던 hardware/mechanical, hardware/bom 제거 (HoverboardVehicle이 대신함)
    - DXF는 CRLF 그대로 두도록 .gitattributes에 -text
2026-10-13 docs: 차체 설계 통합 후 저장소 문서 정리
    - system-overview에 차체 설계 결정(D-01~D-21) 반영: 컴퓨터 · 센서 · 전원 · 비상정지 구성,
    차체 설계가 ESP32에 요구하지만 펌웨어에 없는 기능, D-03과 바퀴 제어기 실측의 어긋남
    - 결정 기록 범위 나눔: 차체는 DECISIONS.md(D-NN), 여러 계층은 docs/decisions
    - README에 프로젝트 흐름(2026-07-27~), 현재 상태, 구조 갱신
    - 이전 일지 위치(설계 일지 2026-07~, 바퀴 제어기 WORKLOG) 정리
    - hardware/vehicle README · SETUP에 통합 안내, 루트 .claude/launch.json에 vehicle-sim
    - tipping_moment.py는 CR CR LF가 섞여 있어 바이트를 그대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
2026-10-13 docs: 일지와 기록을 docs/worklog 한 곳에 같은 양식의 Markdown으로
    - 차체 설계 일지(HTML 22편 + 정리 6편)를 Markdown으로 변환. 본문 문장은 그대로 두고
    틀만 바꿈 (사용자 질문 인용, 표, 이미지, 일지 간 링크 포함)
    - 바퀴 제어기 WORKLOG.md(10항목)와 10월 일지를 같은 양식으로 합쳐 월별 파일
    2026-07 ~ 2026-10 (36항목)으로. 10-04 · 10-05 차체 재설계는 버전 표에서 엮음
    - build-log.md, DEBUGGING.md, WORKLOG 부록은 docs/worklog/topics/로
    - 양식(제목 · 인용 줄 · 본문 칸)과 전체 연표를 docs/worklog/README.md에
    - 옮긴 원본 삭제, 참조 링크 갱신, 겹치던 docs/trou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
2026-10-13 docs: 공개용 README 정리
    - 대표 이미지, 특징, 현재 상태, 시스템 구성, 시작하기(차체 · 시뮬레이터 · 펌웨어),
    문서 안내, 출처와 라이선스 절 추가
    - 로컬 경로가 들어간 통합 계획 표는 빼고 작업 일지로 넘김
    - 비공개 원래 저장소로 가는 링크를 이름만 남기고 뺌
    - 10-13 일지에 공개 준비와 공개 전 확인할 것 기록
2026-10-13 chore: 공개 전 정리 — Wi-Fi 비밀번호 분리, 개인 정보 · 외부 자료 제외
    - 바퀴 제어기 Wi-Fi 이름 · 비밀번호를 git에 올리지 않는 include/wifi_config.h로
    (예시 파일만 커밋, 없으면 #error, 8자 미만이면 static_assert)
    - 로컬 사용자 경로를 Path.home() / $env:USERPROFILE로, 시뮬레이터 복도의 학교 이름을
    "실제 건물"로
    - 재배포 조건을 모르는 외부 자료를 추적에서 뺌 (파일은 로컬에 남기고 .gitignore):
    휠 모터 STEP, 그 형상이 들어간 v28_wiring.step, SPG 카탈로그 표 그림.
    refmodel/README.md에 필요한 파일 안내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
    [main.cpp]
2026-10-13 docs: 공개 전 체크리스트
    라이선스(헤더 직접 작성 → MIT), 새 Wi-Fi 비밀번호로 플래시, 이력 정리
    (git-filter-repo 명령과 검증 방법, 2026-10-13 시험 결과), 올리는 순서.
    지울 문자열 목록은 git에서 제외한 로컬 파일에 둔다.
2026-10-13 firmware: ESP32 바퀴 모드와 네 바퀴 시험, 메인보드 펌웨어는 저장소 밖으로
    다른 세션 작업(2026-10-13):
    - ESP32 바퀴 모드: 보드 · 탱크 모드를 없애고 바퀴별 믹싱을 ESP32에서. N1 수정
    (비출력 바이트 무시, 넘친 줄 폐기, |s| · |t| < 50 → 0), 웹 페이지 갱신
    - 시험 GUI tools/wheelbench.py, ADR 0001(바퀴 보드 짝과 믹싱), 일지 · ISSUES ·
    system-overview 갱신. 바퀴 띄운 네 바퀴 시험 통과
    이 세션:
    - MIT 공개 방침에 따라 메인보드 펌웨어(GPL-3.0 업스트림을 고친 것)와 빌드 · 굽기
    기록을 저장소에서 뺌. firmware/hoverboard-mainboard/ 통째로 .gitignore, 공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
    [main.cpp]
2026-10-13 firmware: 프레임 코드를 직접 작성하고 MIT 라이선스로
    - include/hover_protocol.h: 바퀴 제어기 ↔ 메인보드 UART 프레임(명령 9 B, 텔레메트리
    22 B, CRC16-XMODEM)을 README의 프레임 표만 보고 새로 작성. 크기 · 필드 위치 ·
    CRC 검사값(0x31C3)을 컴파일 때 확인
    - GPL-3.0 업스트림 예제에서 복사했던 hoverserial.h · util.h를 저장소에서 뺌
    (로컬 사본은 firmware/hoverboard-mainboard/local/upstream-examples/)
    - LICENSE(MIT) 추가, README의 라이선스와 출처 절 갱신
    - 누비와 관계없는 그림 32장(ball_robot · gring · ib · sphex) 제거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
2026-10-13 docs: 이력 정리 후 커밋 해시 갱신, 공개 전 체크리스트와 일지
    - git filter-repo로 외부 자료(휠 모터 STEP, v28_wiring.step, SPG 그림), GPL 파일과
    코드(hoverserial.h · util.h, 메인보드 패치), 관계없는 그림 32장, 개인 정보(사용자
    경로, 학교 이름, 옛 Wi-Fi 비밀번호)를 이력 전체에서 지운 뒤, 문서에 적힌 커밋 해시
    32곳을 새 해시로 고침
    - 공개 전 체크리스트를 끝낸 것 / 올리기 전에 할 것으로 다시 씀
    - ISSUES H6(새 프레임 코드 실기 확인), AGENTS 규칙(GPL · 출처 불명 파일 금지),
    10-13 일지 항목 추가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
2026-10-13 docs: 공개 전 README 최종 점검
    - 루트 README: 현재 상태(바퀴별 믹싱, 네 바퀴 시험), 시스템 구성, 시작하기
    (wheelbench, Wi-Fi 설정 안내), 문서 표(ADR), 흐름(10-13), 라이선스 절 순서 정리
    - 이전 편집에서 경로의 \v · \r이 제어 문자로 바뀐 줄 복구
    - 원래부터 tools\fea의 \f가 폼피드로 들어가 있던 FEA 문서 3곳 복구
    - firmware README: 바퀴 제어기 상태(프레임 코드 교체 후 실기 확인 전, H6), 모터 4개
2026-10-13 sim: 시뮬레이터 다시 띄우기 — v28 메시, 복도 맵 새 경로, 천장 층
    "차량 시뮬레이터" 세션 작업(2026-10-13 18:05 ~):
    - import_hallway.py: 복도 원본 경로를 F:\Develop\hallway-3d로, 원본에 textures/가
    없으면 건너뜀
    - 복도 천장 · 천장에 단 것을 별도 레이어로: 내 화면에서는 숨기고(천장 보기
    체크박스), 차 앞 카메라 화면 · 광선 투사에는 넣음
    - 깊이 점: 차 높이 + 15 cm 위는 장애물 · 바닥으로 치지 않음
    - 시뮬레이터 README, 차체 README, 10월 일지 항목과 연표
2026-10-13 docs: Jetson 유선 직결 일지 — 이더넷 고정 IP 192.168.127.2
    PC와 Jetson(mokpo) 직결에 DHCP가 없어 Jetson 유선이 주소를 못 받던 것을
    USB 장치 모드로 들어가 고정 IP로 바꾼 기록.
2026-10-13 sim: 시뮬레이터에서 GPT · Claude가 차를 모는 에이전트
    - agent.py(GPT, 표준 라이브러리만) · agent_claude.py(Anthropic SDK) · web/agent.js:
    앞 카메라 사진 + 깊이 화살표(VLMnav 방식)를 보내고 받은 행동으로 주행
    - 운전에 복도 지도와 추정 위치를 함께 넘김, 사람 끄기 고침
    - serve.py에 에이전트 API, 센서 · 코스 · 복도 환경 갱신, 시뮬레이터 README
    - API 키는 환경변수나 agent.local.json(*.local.*로 git 제외), 운전 기록
    agent_logs/는 .gitignore. requirements에 anthropic
2026-10-13 exp: 실차 GPT 운전 준비(vlm-drive), SfM 재위치 실험, 10-13 일지
    - experiments/2026-10-13_vlm-drive: Jetson + ESP32 + Xtion으로 시뮬레이터 에이전트를
    실차에 붙이는 코드(바퀴 링크, 깊이, 오도메트리, 복도 지도, 가짜 장치 자가 시험,
    Jetson 복사 스크립트). PC 가짜 장치 시험까지
    - experiments/2026-10-13_sfm-relocalization: 복도 SfM 지도로 카메라 위치 다시 찾기 (미완)
    - 10월 일지: 시뮬레이터 GPT · Claude 운전, 지도 · 추정 위치, 실차 GPT 운전 준비 항목
2026-10-14 exp: Jetson 실기 점검 — Xtion · HP60C · 바퀴 점검판, 10-14 일지
    - xtion: 정합은 시작 전, 미러링은 소프트웨어로 뒤집기, 백그라운드 읽기 · 열기 시간 제한
    - xtion_no_audio.sh: gdm 오디오가 Xtion 마이크를 붙잡아 장치가 안 열리던 문제 (udev authorized=0)
    - hp60c.py: Nuwa-HP60C UVC 복합 프레임 직접 해독, 깊이를 컬러 시점에 맞춤, 기본 180° 돌림
    - bench.py · bench_ctl.sh: 바퀴 점검 웹 패널 (띄운 채 짧은 시험, STOP, 끊김 정지)
    - 바퀴 방향 실측으로 odo_sign [-1, 1], 가짜 ESP32 부호도 맞춤
    - SIGTERM · SIGHUP 에도 바퀴를 세우고 끝냄
    - Xtion · HP60C 비교 사진, 실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
2026-10-14 exp: 카메라로 위치 찾기 — SfM Jetson 이식, 녹화 · 다시 돌려 보기, 시뮬레이터 연결, 게임패드, 마커 첫 시험, 10-14 일지
    - sfm-relocalization: colmap_lite (pycolmap 없이 지도 읽기 · OpenCV SIFT · PnP), relocalize numpy 이식, localizer (근처 지도만),
    locate_run, Jetson leave-out 결과 (같은 방향일 때만 잘 됨)
    - vlm-drive: record · review · check_run (녹화 · 미리보기 · 점검), pose_fusion · vision_fix (drive.py --pose vis),
    replay · replay_sim (첫 주행 다시 돌려 보기), sim_bridge (drive.py --sim), pad_confirm · drive_ctl (게임패드 승인),
    pad.py (무선 게임패드 조종 · A 버튼 녹화, 다른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
    [per_query_jetson_cv.csv, per_query_jetson_db.csv]
